badinkajink/hand/src/morphohand/driver/reskin5x/README.md

# reskin5x

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

## Layout

- `firmware/reskin5x_stream/reskin5x_stream.ino`: the port of `external/eFlesh/arduino/5X_eflesh_stream/5X_eflesh_stream.ino`.
  The STEMMA QT connector is the board's `Wire1` (SDA1 GPIO41, SCL1 GPIO40), `Serial` is the TinyUSB CDC port, and the
  register settings are those below; the header comment lists every change.
- `firmware/reskin5x_mux_stream/reskin5x_mux_stream.ino`: several boards behind an I2C mux on the STEMMA QT port, one
  record of 80 bytes a board plus `\r\n` per sweep (section on three boards).
- `host/reskin5x_mux.py`: splits that stream into one 82-byte stream a board, each on a pseudo-terminal linked at
  `/tmp/reskin5x_mux/ch<channel>` that `host/wrench_viewer.py --port` reads, and logs all boards; `host/reskin5x_mux_check.py`
  gives a log's record rate, each chip's noise and the boards' separation, `host/reskin5x_mux_rest.py` each board's rest
  over time (split into a uniform field and the rest of the change), and `host/reskin5x_mux_soak.py` the viewer's frames
  replayed over fingers left at rest.
- `firmware/bench_three_board_sweep/`, `firmware/bench_conversion_period/`: timing sketches behind the numbers in the
  sections on rates and on three boards; they print `STAT`, `CONV` and `NACK` lines. Build and upload one with
  `RESKIN5X_SKETCH=<name> host/flash.sh`, and put `reskin5x_stream` back afterwards.
- `host/flash.sh`: compile and upload.
- `host/reskin5x_check.py`: per-chip field, noise, drift and temperature, the record rate, and the fraction of the range in
  use, from a few seconds of stream; `--out` writes the records as text.
- `host/reskin5x_plot.py`: live plot of each chip's change from a baseline (|ΔB| of all chips, then ΔBx, ΔBy, ΔBz per
  chip, µT, last 10 s); key `b` takes a new baseline.
- `scripts/reskin5x_pad_fit.py`: the magnets' polarities, position and strength fitted to a capture of the board with a
  pad on, and the sensing model's force resolution for the fit.

## Setup

    git submodule update --init external/eFlesh
    git -C external/eFlesh submodule update --init arduino/arduino-MLX90393

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

## Flashing

    src/morphohand/driver/reskin5x/host/flash.sh            # upload to the first /dev/ttyACM*
    src/morphohand/driver/reskin5x/host/flash.sh build      # compile only

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

## Checking the stream

    ~/miniconda3/bin/python src/morphohand/driver/reskin5x/host/reskin5x_check.py --seconds 5

Noise is the standard deviation of each axis inside 0.5 s windows, averaged over the windows; drift is the largest range
of the 0.5 s means. Measured on 2026-10-20 at the workstation, board at rest and no magnet near it: 375 records/s; noise
1.54 to 1.76 µT on x and y and 2.32 to 2.59 µT on z; drift 0.8 to 1.7 µT; |B| 41 to 82 µT, Earth's field plus the chips'
offsets, which changes as the board turns; 28 to 31 °C. The noise model of `scripts/mlx90393_model.py` gives 1.20 and
1.84 µT at this setting, so the measured noise is 1.4 times the model's; a force resolution computed with the model scales
by the same factor (concept b's pad: 0.028 N at the contact point, about 0.039 N with the measured noise). A drift of tens
of µT means the board turned or a magnet moved near it during the capture: one capture taken while the board was handled
gave 40 µT on every chip.

## Sample rate on one board

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

## Three boards on one QT Py

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

    ~/miniconda3/bin/python src/morphohand/driver/reskin5x/host/reskin5x_mux.py &
    ~/miniconda3/bin/python src/morphohand/driver/reskin5x/host/wrench_viewer.py --port /tmp/reskin5x_mux/ch0 --http 8790
    ~/miniconda3/bin/python src/morphohand/driver/reskin5x/host/reskin5x_mux_check.py logs/<date>-three_finger_mux/<start>-mux.bin

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

Since 2026-10-26 one viewer shows every board on the mux, with no splitter: each board gets a row of the page with its
pad and its readout, and its own stream log and calibrations named after it. `--board-gp` adds the GP from the board's
change to the contact point and force, pooled over ID 1's and ID 2's UR5 holds (`scripts/ur5_tip_calibration_board_gp.py`,
3,813 presses and slides of cb1t, cb1r and cb2t; the fit equals `ur5_tip_calibration_predict.GP`'s to 3e-13 on a
300-hold subset). Each panel's menu, and key g for every board, picks the estimate shown. No UR5 hold pressed harder
than 5.1 N, and beyond the holds the GP returns to their mean, a 1.06 N press; on the owner's presses of 2026-10-26 it
read 1.1 to 1.3 N where the physical model read 4 to 25 N. Its estimate is therefore weighted by w, one minus its
posterior variance, against the physical model's: w was 0.8 to 0.98 between 1 and 4 N and 0 to 0.07 above 5 N. The
contact line gives w, and the table gives the force's direction in the tip frame and its angle from the inward normal.

    ~/miniconda3/bin/python src/morphohand/driver/reskin5x/host/wrench_viewer.py --mux /dev/serial/by-id/<board>-if00 \
        --names "ID 1" "ID 2" --calib <ID 1 calib_rest.json> <ID 2 calib_rest.json> --correction <cb1t folder> <cb2t folder> \
        --board-gp docs/experiments/20261022-ur5_tip_calibration/data/20261026-board_gp_id1_id2.npz

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

    RESKIN5X_FQBN=esp32:esp32:sparkfun_esp32c6_thing_plus RESKIN5X_SKETCH=reskin5x_mux_stream \
        src/morphohand/driver/reskin5x/host/flash.sh /dev/serial/by-id/usb-Espressif_USB_JTAG_serial_debug_unit_<MAC>-if00

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

## Pad on the board

    ~/miniconda3/bin/python src/morphohand/driver/reskin5x/host/reskin5x_plot.py
    ~/miniconda3/bin/python src/morphohand/driver/reskin5x/host/reskin5x_check.py --out pad.csv   # pad at rest
    ~/miniconda3/bin/python scripts/reskin5x_pad_fit.py pad.csv

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

## Visualizer

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

## Contact estimation viewer

    ~/miniconda3/bin/python src/morphohand/driver/reskin5x/host/wrench_viewer.py   # then open http://localhost:8790

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

The chips run without their on-chip temperature compensation, and each one's sensitivity falls by 0.65 to 0.70 % per C of
its die temperature: the board warms by about 1 C in the minutes after it is plugged in, which moves the rest reading by
70 uT, about 2 N on the face. The viewer divides every reading by its chip's gain at the chip's temperature (coefficients
in `docs/experiments/20261020-fingertip_contact_estimation/data/20261021-thermal_gain.json`, fitted on a night at rest by
`scripts/fingertip_contact_estimation_study.py thermal`), adds a 2 uT noise floor to the estimator's noise and shows a
contact only above 0.25 N, and takes a new baseline once the reading has been as still as at rest for 3 s, which also
takes in a press held that still. The page has sliders for the threshold and the floor and a switch for the re-zero (key
z); `--floor`, `--min-force`, `--auto-zero 0` and `--no-thermal` set them at the start. When the board is unplugged the
viewer waits for it, opens it again (on its `/dev/serial/by-id` name, which stays the same when the board comes back as
another ttyACM) and calibrates again 2 s later, since the pad may have been changed meanwhile; nothing else needs to run
first.

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

    ~/miniconda3/bin/python src/morphohand/driver/reskin5x/host/pad_shift_check.py <recording>.csv
    ~/miniconda3/bin/python src/morphohand/driver/reskin5x/host/pad_shift_check.py <stream>.bin --t0 120 --t1 180

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

## Calibration session on the UR5

`host/ur5_tip_calibration.py` runs the calibration on the lab's UR5 (CB3, RTDE at 192.168.0.4) against the OptoForce
HEX-E (its Ethernet DAQ at 192.168.0.5, UDP port 49152, polled at 500 Hz): homing on the indenter's key in freedrive, a
gravity sweep, touch-offs on the mount's column and on the pad, a registration fit, pivot presses, then calibration
presses, slides, rolls and twists from a plan written on the workstation
(`scripts/ur5_tip_calibration_plan.py` -> `docs/experiments/20261022-ur5_tip_calibration/plan/20261022-plan_sphere.json`).
The robot's computer runs it from a clone of the repository: the runbook
`docs/experiments/20261022-ur5_tip_calibration/README.md` and its setup check `scripts/ur5_tip_calibration_lab_setup.sh`
(git-lfs files, a venv with numpy, scipy, pyserial and ur_rtde, old copies of magpie_control's F/T reader, the robot,
the DAQ and the board, three simulated stages) cover it. The program stops the DAQ and empties its socket before it
starts, and empties it again before each polled request, so a late answer cannot pass for a newer one.

    python ur5_tip_calibration.py --plan 20261022-plan_sphere.json --stages preflight      # streams, payload
    python ur5_tip_calibration.py --plan 20261022-plan_sphere.json --dry 15                 # the session 15 mm off
    python ur5_tip_calibration.py --plan 20261022-plan_sphere.json --name sphere1           # the session
    ... --resume logs/<date>-tip_calibration/<session>                                      # after an interruption
    .venv/bin/python src/morphohand/driver/reskin5x/host/ur5_tip_calibration.py --plan <plan> --sim   # the simulator

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

## Register settings

GAIN_SEL 1, RES 1 on all three axes, OSR 0, DIG_FILT 5 and HALLCONF 0xC: one count is 1.20 µT on x and y and 1.94 µT on z,
the range is 38.4 mT (the rule of `scripts/v2_tip_fe_checks.py`: 4.8 mT at GAIN_SEL 7 and RES 0, scaled by the count),
and one conversion of T, X, Y and Z takes 7.0 to 7.1 ms. The range covers the five-magnet concept-b pad B00, whose
largest field component at a chip is 27.5 mT (`docs/experiments/20261019-v2_tip_fe_checks/sensing.json`, case b_v2);
concept a's tip, at 11.4 mT, takes GAIN_SEL 2 and RES 0. To change the settings, edit the constants at the top of the
sketch, run `flash.sh`, and pass the new range to the check's `--range-mT`. The firmware converts counts to µT with the
settings it wrote, so the host reads µT at any setting.

## Record format and chip order

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
