badinkajink/hand/docs/handoff/20261029-hom_design_landscapes.md

Status: active, window hand-d3 (not armed); hand-14's part done 09:00 on 10-30, handed back to hand-d3 by the owner at 12:0x on 10-30
Task (owner, 2026-10-29 ~22:30, deputizing hand-14 after hand-d3): HOM-sim and high-throughput morphology sampling. Questions: (1) gradients to guide exploration "a la value gradients for robot design" (arXiv 2606.00702) without RL; (2) MPC in HOM's object-contact action space instead of joint space (cf. arXiv 2601.10930), gradient-based or sampled, on MuJoCo-Warp, and its speed; (3) the Pareto front and neighbourhoods of good layouts per task, how they move as the object's size changes, whether that differs between tasks, high-potential neighbourhoods, and transfer. Owner, 23:0x: "control is really grasp synthesis + in hand manipulation, conditioned on morphology ... we should not be relying on our old keyframe"; synthesize different grasps per morphology; poke in small increments; simple parameters (palm width/height, finger spacing) before t-SNE; build on Yang et al. (IEEE TEVC 2026, memory reference_yang_hand_evolution_2026.md); "scoring hands by sample efficiency is not a bad idea"; "narrow feasible regions ... the whole name of the game"; inspect grasp keyframes from several angles for troublesome results. Owner, 23:2x: "you're using the wrong fingertips"; sphere-pack the new half-ellipsoid tips; remove the cap over the top edge (trimmed). Document in the two 10-29 pages (the design page records how the approach changed); a code-walkthrough subpage linked from the HOM page. Keep the code lean; no meta commentary in pages. Owner, 12:0x on 10-30, to hand-d3: (1) run the 15-min GPU re-anchor test; (2) not ready for a bench test; (3) the queued studies are approved: twelve object-pose draws on the cylinder tasks, the 2 mm local refinement around the 20 best twist layouts, Yang et al.'s EA as a baseline, the MPC at a 2 ms physics step. Standing advice: anchor every debug on visual inspection of the decisive snapshots.
Read first: docs/handoff/20261029-hom_gpu_handover.md; docs/experiments/20261029-foundational_pose_review/20261029-foundational_pose_hand_design.html (sections 6-10); scripts/hom_gpu.py, scripts/fp_sr2_toy.py (V4B block, grasp_set, grid2d, poses), scripts/build_cad_v2_finger.py, scripts/hom_landscape.py; memory project_hom_fp_review_2026_10_29.md.
State (10-31 20:40, hand-d3): every stage of logs/20261030-hom_ff/gpu_queue3.sh done without refusals (D 17:18, C 20:26; no job of this task runs). Trends page docs/experiments/20261029-foundational_pose_review/20261030-hom_layout_trends.html has the size trends (36 of 38 sizes agree on the CPU), the EA's reliability, the finger-clearance cost on the GPU, the re-solved grids with the measured reason for the higher reach (scripts/hom_toy_reach_check.py), the Sobol rerun (rows/sizes_v4bff: interaction 40-43 % of variance, noise <= 8 %, smallest-largest Spearman 0.17-0.33, press -0.03) and the table study (table-clear grids and searches, CPU table checks). Design page Section 9 and the design overview point to it. hom_ea dedupe fixed after D; hom_landscape has --sobol sobol8kff and sobol-rerun. Commits e6310c7a5 .. 94d2a823f and the Sobol commit after 20:40.
Next:
1. Owner's go 10-31 ~21:00 ("sure, run the last study"), done 21:26 (logs/20261030-hom_ff/table_study2.sh): the 25 mm pinch grid with no penetration of the table (grid2dgn) and with the squeezed pose (grid2dgs); no finger touches the table any more, held 12 and 15 of 20 with the table (9 before), 19 and 20 on the post; the remaining drops happen in the turn (4.8 s) and are not explained. Trends page Section 7 and its future work carry it; hom_table_check.py has trace (with the table removed at the lift, as in the check) and film with any grids.
2. Open (needs the owner): why table-clear pin-push grasps still drop in the turn; re-solving the tripod grids with no penetration; publishing both pages on the personal login; the pin-push peak's CPU/GPU disagreement.
Claimed: scripts/hom_ea.py, logs/20261030-hom_ff/, scripts/hom_films.py, scripts/hom_grasp_overlap.py, scripts/hom_top_cpu_check.py, scripts/hom_reanchor_check.py, scripts/fp_sr2_toy.py, scripts/hom_gpu.py, scripts/hom_landscape.py, scripts/build_cad_v2_finger.py, scripts/hom_mpc_gpu.py, scripts/hom_code_page.py, scripts/fp_review_page.py, scripts/fp_review_figures.py, scripts/hom_review_page.py, the two 10-29 page folders, assets/mjcf/experimental/20261030-cad_v2, logs/20261029-hom_sizes/.
Waiting on owner: publishing on the personal login.
Do not: edit src/morphohand/control/hom.py without a test; start multi-hour work beyond Next 1-3 without the owner's go; touch hardware, corvus or the CB1; publish artifacts; run mesh-heavy probes outside resguard or without NUMPY_MADVISE_HUGEPAGE=0 (three watchdog kills on 10-29 23:26-23:35).
