badinkajink/hand/docs/handoff/20261014-tip_codesign.md

Status: done
Task (owner, 2026-10-14 17:45): "super interesting to see how the sphere packed contact model deteriorates across geometry. can you actually explore this? we can use whatever geometry we want, and now you have experience with the real fingertip geometry. maybe you can actually design a good process to optimize a fingertip geometry as well as material (print settings), contact model, and task? ... designing and producing a few candidate fingertip geometries (and material/print settings, updated contact model, evaluations on a dexterous manipulation task), you can churn at now." Owner's interest is utilitarian (throughput and robust control of the SR2 hand); no studies that separate the pads from Newton hydroelastic.
Read first: docs/notes/20261014-tip_codesign_plan.md (the design: deterioration study, co-design loop, run plan; written by step 1); scripts/fingertip_geometry.py (the block: 17.0 x 14.8 x 22.0 mm, box rounded by a sphere of r 2.7 mm, pads E a/h with h 8.5 mm); scripts/reorient_backends.py replace_tips; scripts/tpu_tip_rig.py (bed tasks T1, T2, T5 on TPU tips, Drake compliant block); scripts/hydroelastic_arm_integral.py; scripts/tpu_tip_fem.py, tpu_tip_print_plan.py, eflesh_build.py; scripts/pad_usability_backends.py (D1-D8 replay wrapper, U2); docs/experiments/20261014-pad_usability/agree/findings_U2.json; pages 20261006-fingertip_backends (fingertip co-design for task and simulability) and 20261009-tpu_tip_fem; memory project_tpu_tip_fem_2026_10_10.md, project_tip_deformation_budget_2026_10_13.md.
State (2026-10-15 02:30, autopilot on personal): every ledger step done. Page docs/experiments/20261014-tip_codesign/20261014-sphere_pad_accuracy_and_fingertip_codesign.html, artifact https://claude.ai/artifact/4QPCGbgvaEQoswYCytJ1kJ, INDEX row, linked from the printed-fingertip and contact overviews (both republished). Findings: pads within 2 % of the law's twist onset for fillets >= 1.5 mm, 7-14 % high on sharper; sliding torque grows with spin rate (1.25x the law at 1 rad/s on r 2.7 mm) through MuJoCo's elliptic cone and no builder fix keeps the hand's turns; none of the three finalists beats the as-built tip on fresh placements ((3,6) +0.053, 90 % interval -0.043 to +0.090); builder v2 raises Drake agreement on 3 of 4 stage-3 tips. Waiting on owner: (1) FE of tcd_rs2_re1_p0.2 at 95A 20 % and tcd_rs3_re6_p0.2 at 95A 10 % needs more than this job's 6 GB per process (two runs paged and were stopped at the cap): approve a larger memory budget for one FE run at a time, or accept the scaled recipe estimate on the page; (2) whether builder v2 (local h, per-pad K) becomes the default pad builder for CAD-envelope tips; (3) contact deck 23 may be stale: scripts/contact_overview_page.py lists 8 commits since DECK_CHECKED (one adds this study's sentence); DECK_CHECKED was left unchanged.
Workflow journal: /home/humanoid/.claude/projects/-home-humanoid-Programs-hand/88ae0ebc-1769-4d06-9a8c-bed92903087d/subagents/workflows/wf_38c62930-64f/journal.jsonl
<!-- ap:steps: rendered by ~/.claude/autopilot/ap from its ledger; change it with `ap step`, not by hand -->
Steps, in order (the ledger; `ap step done <job> <id> "result"` marks one, `ap step add <job> "text"` adds one):
- [x] 1. If docs/notes/20261014-tip_codesign_plan.md is missing, write it from the journal (critique:codesign's revise… Done 10-14 19:17: Plan file committed by window 88ae0ebc (bcc3041a); its revised run plan is now ledger steps 12-25 in order; steps 2-6 stay open as umbrellas (direction 26) because only the owner drops them
- [x] 2. Tip geometry and pad builder for any convex tip: scripts/tip_codesign_geometry.py (parametric shape, STL, pad… Done 10-14 20:05: Done by steps 14 (tip_codesign_law.py: Drake field, Winkler, local h, pads; checks 2.554 mm and N45 0.373/0.364/0.393 N) and 15 (tip_codesign_geometry.py, per-pad builder, tests)
- [x] 3. Deterioration sweep on the bed (T1 pull, T2 twist, T5 brake, approach) over the family: pads against the law … Done 10-14 20:43: Done by steps 14 (sweep A, 322 rows, rate-effect mechanism and fix grid) and 16 (sweep B, builder tests, hand check); summaries in deterioration/summary.json, handfix_summary.json, handv2_summary.json
- [x] 4. Co-design screening and finalists: material proxy from print settings, calibrated pads per candidate, the tas… Done 10-15 02:25: Done by steps 17 (stage 1), 18 (stage 2, finalists), 19 (stage 3: no finalist beats the as-built tip), 22 (pinned iCEM) and 27 (builder v2)
- [x] 5. Finalists as printable files: STL and print settings (PrusaSlicer project or print sheet with tpu_tip_print_p… Done 10-15 02:25: Done by step 21: print files (STL, 3MF, print sheet, slice audit) and pad scenes of the four stage-3 tips; recipes from step 20
- [x] 6. Result page: scripts/tip_codesign_page.py and template (newest builder as the base, retro_style, texsvg, film… Done 10-15 02:25: Done by step 25: result page published and linked
- [x] 12. Plan step 1, pre-flight and wrappers: quote resguard status and nvidia-smi; create logs/20261014-tip_codesign… Done 10-14 19:36: Wrappers committed (tip_codesign_bed.py, tip_codesign_rig.py); D7 s0 reproduces U2 (replay 44.8 deg held, HOM 9.3, Drake 47.3); RSS replay 133-138 MB, HOM 160 MB, bed 147 MB, Drake replay 423 MB
- [x] 13. Plan step 2, hand tolerance tau: servo plant kp0.72_kv0_fr0.18_fl0_dp0.0144, tpu2.7 pads; mu {0.8,0.9,0.95,1.… Done 10-14 19:44: Floor: any friction change >= 0.1 % flips 10.1 % of 84 non-bistable runs; tau (floor + 5 points) 3.65 % relative friction (plan's 5 % rule gives 0.04 %, inside the floor); median |dturn| 0.12/0.47/0.73/1.91 deg at 0.1/5/10/20 %; E 5/20 MPa change 17/26 runs (screening variable); mu 0.8 leaves D3 s0-2 and D8 s1 unturned; tolerance/summary.json
- [x] 14. Plan step 3, deterioration sweep A on the flat family tpu<r>, r {0,0.5,1,1.5,2,2.7,3,4,6,7.4} mm, 1 mm pads, … Done 10-14 19:56: Sweep A (322 rows, deterioration/summary.json): onset/law 0.98-1.02 for r>=1.5, 1.07-1.14 for r<=1; spin/law at 1 rad/s 1.73 (r0) 1.25 (r2.7) 1.14 (r6) 0.98 (sphere), Drake 0.97-1.12; N45 pads/Drake(0.5 ms) 0.52-0.64 for r<=3, ~1 for r>=6; mechanism = elliptic-cone slip term (87 % of sliding normal force at 1 rad/s); fix pf0.1:ir1000 cuts the excess (1.09 at r2.7) but fails the hand (HOM 3/24 vs 21/24 within 5 deg of Drake), so no builder fix; MPC swings at 5 rad/s see 1.9x the quasi-static torsion (Drake 1.6x)
- [x] 15. Plan step 4, geometry and builder v2: scripts/tip_codesign_geometry.py (numpy/scipy, trimesh lazy): CAD envel… Done 10-14 20:05: Geometry module, builder v2 (h fixed/local, K median/each), tcd dispatcher for bed/hand/scale, 6 tests pass; as-built tcd_rs3_re3 matches the CAD outer palmar half to 1.2 um p99 (the CAD insert is a shell over the mount, so no volume test); 1172 pads, a 0.50-1.69 mm2
- [x] 16. Plan step 5, deterioration sweep B and builder fixes: members as-built, as-built as-printed at 0.2 mm, r_side… Done 10-14 20:43: Sweep B (5 tcd members) and builder tests in deterioration/summary.json: no builder option moves every member toward the law (1 mm pads -3..+2 % at 1 N on smooth members; local h, per-pad K < 1 %; crowns -6..-7 % at any spacing; n* not reached, error set by lattice phase); hand check on tcd_rs3_re3_p0.2: builder v2 19/24 vs v1 16/24 replays within 3 deg of Drake (D3 s2, s4 turn with v2), 4/40 replays differ (the floor); v1 kept for screening
- [x] 17. Plan steps 6-7, candidate grid and stage 1 screen: r_side {1,2,3,4.5,6,7.4} x r_end {1,3,6,10.5} mm on the as… Done 10-15 00:46: Stage 1 complete with fixed pads (screen/summary_stage1.json, 26 tips, every fidelity row present): J1 at mu 0.7 ranks as-built printed 0.428, (2,6) 0.364, (7.4,6) 0.343, (7.4,10.5) 0.335, (3,6) 0.333, (1,10.5) 0.328, (4.5,1) 0.301, (2,1) 0.288; tpu2.7 0.261 (11th), design surface 0.241; pads' onset/law 0.95-1.06 at 1 N on all 24 printed candidates; printability in step 21
- [x] 18. Plan step 8, stage 2 robustness on the 8: servo plant at mu 1.0/0.7/0.5, kp0.5 and fr0.12 at mu 0.7 (HOM kp_m… Done 10-15 00:46: Stage 2 redo (screen/summary_stage2.json): J2 (1,10.5) 0.206 (Drake 10/24, fails), (3,6) 0.195 (16/24), as-built 0.188 (16/24), (2,6) 0.156 (15/24), tpu2.7 0.154 (16/24), (4.5,1) 0.132 (13/24), (2,1) 0.127 (11/24), (7.4,10.5) 0.124 (18/24, cost 0.48), (7.4,6) 0.088 (12/24); gate needs 14. Finalists: (1) tcd_rs3_re6_p0.2, (2) tcd_rs7.4_re10.5_p0.2 (cost 0.48 of the as-built), (3) tcd_rs2_re1_p0.2 (three-finger share 0.12 at mu 0.5), (4) baseline tcd_rs3_re3_p0.2
- [x] 19. Plan step 9, stage 3 confirmation on fresh seeds: HOM D1-D8 seeds 5-9 and scale cells seeds 3-5 at mu 0.7, 0.… Done 10-15 00:54: Stage 3 (final/summary_stage3.json; cell seeds 3-5, HOM seeds 5-9, 4 conditions): J3 as-built 0.250; (3,6) 0.303, paired dJ3 +0.053 with 90 % interval [-0.043, +0.090] (10,000 resamples within cells and hands), so it does not beat the as-built tip at the 90 % level; (7.4,10.5) 0.169, dJ3 -0.081 [-0.120, -0.033]; (2,1) 0.172, dJ3 -0.078 [-0.122, -0.018]. Three-finger hold at mu 0.5: 33/33 for the as-built tip, (3,6) and (7.4,10.5); 31/33 for (2,1). No flat-family geometry improves on the as-built tip
- [x] 20. Plan step 10, FE alone (taskset -c 4-7, --mem 6G, no other job of this session running): tpu_tip_magnet.run i… Done 10-15 02:19: FE (final/fe.jsonl; whole-tip model, magnet 4.76 mm at 5 mm): (3,6) 95A 20 % E* 15.4 MPa, 11.7 um/N (fails the 12 um/N sensing rule) -> 95A 10 % (scaled estimate about 20 um/N); (7.4,10.5) 95A 20 % E* 19.4 MPa, 12.9 um/N -> 95A 20 %; as-built 95A 20 % 12.18 um/N (2026-10-09 CAD-insert FE) -> 95A 20 %; (2,1) not computed (needs more than 6 GB, ledger 32)
- [x] 21. Plan step 11, print files per finalist under docs/experiments/20261014-tip_codesign/print/<key>/: face-up STL… Done 10-15 02:19: Print files for the four stage-3 tips at 95A 20 % gyroid and (3,6) at 95A 10 % (print/<design>/: face-up STL with the pocket, PrusaSlicer 3MF with the M601 pause, print sheet JSON): all watertight, 21.41 x 14.8 x 17.0 mm, slicer pause at 12.4 mm, one island per layer (two in some layers of (3,6) at 10 %); pad scenes (D6 servo bench, CAD hand) in assets/mjcf/experimental/20261014-tip_codesign/<tip>/; tip_codesign_rig.py rlscene for the RL queue
- [x] 22. Pinned iCEM on cylinder:16:0.625 and cylinder:25:0.125, seed 0, best finalist against the as-built baseline: … Done 10-15 02:19: Pinned iCEM (final/icem/turn.jsonl, seed 0, mu 1.0, servo plant, 6 threads on cores 5-10): as-built tip 43.0 deg on cylinder 16 and 64.6 deg on cylinder 25; tcd_rs3_re6_p0.2 39.3 and 57.4 deg; every run held with three fingers loaded at the end; 0.40-0.41 GB, about 9 min per tip
- [x] 23. Plan step 12, films on the CPU through Mesa EGL (640 x 480 panels, tile_stream crf 20, labels at least 13 px … Done 10-15 02:19: Films (media/): bed spin at 1 N and 1 rad/s on r 1, as-built design, as-built printed, r 6 with pads coloured by f/(K pen) (bed_spin_tile.mp4); HOM on cylinder:16:0.625 seed 3 for the four stage-3 tips (hom_cylinder_16_0.625_s3_tile.mp4); D7 seed 0 replay (replay_D7_s0_tile.mp4); posters read at 828 px, labels 14-15 px
- [x] 24. Plan step 13, verification: scripts/tip_codesign_verify.py recomputes tau, the validity map, the fix deltas, … Done 10-15 02:20: scripts/tip_codesign_verify.py scenes numbers passes (verify.json): every cached pad scene of the study's tcd tips within 5e-8 m of the fixed pad builder; 73/73 headline numbers recomputed from rows by separate code (deterioration ratios, rate, J1 of 26 tips and the top 8, J2 and Drake agreement of 9, J3 of 4, bootstrap bounds within 0.012 with an independent seed); pytest tests/test_tip_codesign.py 6 passed; resguard events 21:18-02:00 all handled (ledger 28, 32); rows committed (LFS)
- [x] 25. Result page: scripts/tip_codesign_page.py and template from the newest builder (retro_style, texsvg, films in… Done 10-15 02:25: Page docs/experiments/20261014-tip_codesign/20261014-sphere_pad_accuracy_and_fingertip_codesign.html (builder scripts/tip_codesign_page.py, 50 formulas, 7 figures and 3 films inlined, figure check: none flagged) published as https://claude.ai/artifact/4QPCGbgvaEQoswYCytJ1kJ; INDEX row; linked from docs/overviews/printed_fingertips.html (overview_fingertip_text.py, republished v2) and docs/overviews/contact_model.html (one sentence and an index row, republished v16; contact_model_assessment is done); pushed c9c94d2b
- [x] 27. Builder v2 (local h, per-pad K) on the finalists: replays D1-D8 seeds 0-4 and HOM seeds 0-2 at mu 1.0 with --… Done 10-15 00:54: Builder v2 (local h, per-pad K) against v1 on the four finalists (final/summary_builders.json): replays within 3 deg of Drake 19 vs 16 (as-built), 18 vs 16 (3,6), 22 vs 18 (7.4,10.5), 11 vs 11 (2,1); HOM held 21/21, 20/19, 22/20, 20/19 of 24; 4-9 of 40 replays move > 3 deg between builders. v2 is the proposed builder for CAD-envelope tips: it raises Drake agreement on 3 of 4 tips and lowers it on none, at the same pad count
- [x] 28. Relaunch the jobs the watchdog killed 21:18-22:27 (stage-1 fidelity of tcd_rs6_re6, rs6_re10.5, rs7.4_re6, rs… Done 10-14 23:53: Relaunched 23:00-23:52: the 4 fidelity sets and 22 Drake replays completed under the chunk fix (c8735228; a fixed law job peaks at 0.34-0.73 GB, the old code 1.56 GB); no watchdog event since 22:27
- [x] 29. Degenerate hull facets (found 23:40): qhull's triangulation of the terraced hulls leaves facets with |cross| … Done 10-15 00:01: Facet fix 0a4850dc: the 125 law rows recomputed (no NaN; approach 44-135 um at 1 N), the 50 T2 rows rerun (MuJoCo pads onset/law 0.95-1.06; drake_tcd_rs6_re6_p0.2 via meps1e-06), quasi-static pads/law at 1 N 0.89-1.04 (approach) and 0.95-1.04 (arm); sweep B law rows reproduce; old rows in screen/fidelity/{law,T2}_superseded.jsonl. The same defect displaced pads (step 31).
- [x] 30. Drake failed 23 of 24 stage-2 replays of tcd_rs6_re6_p0.2 ('Cannot instantiate plane from normal n_F ... magn… Done 10-14 23:53: tcd_rs6_re6_p0.2's 24 Drake replays rerun with --mesh-eps 1e-6 (tag E1e+07_dp1, 3,911 vertices, <= 0.93 um from the full hull): all complete; pads within 3 deg of Drake on 7/24, so it fails the agreement gate (needs 14) and finalist slot (2) stays empty
- [x] 31. Redo the hand runs of the 20 candidates whose pads the degenerate facets displaced (found 23:58): TipShape._c… Done 10-15 00:46: Redo done 00:00-00:46: 20 candidates' stage-1 rows rerun with fixed pads (worker_v3, no kills), stage 2 rerun for the new top 8 + tpu2.7 (99 jobs, Drake replays for new tips with --mesh-eps 1e-6); old rows in *_superseded.jsonl and screen/superseded/ (superseded_pads_20261015.json); verify scenes: every cached pad scene within 5e-8 m of the fixed builder
- [x] 32. FE OOM kill 01:27 (resguard event): the four-tip FE process (tcd_rs3_re6, rs7.4_re10.5, rs2_re1, rs3_re3, w95… Done 10-15 02:19: FE relaunched one tip per process at --mem 6G (chain5): both runs (tcd_rs2_re1 w95_20, tcd_rs3_re6 w95_10) paged at the cap and the watchdog killed them (01:52, 01:58; PSI full 25.7/15.2 at 13.8 GB available). These as-printed models need more than the job's 6 GB. Recipe of (3,6) taken as 95A 10 % from its 95A 20 % travel (11.7 um/N) times the CAD insert's 10/20 % ratio (1.72): about 20 um/N; (2,1) has no FE row. Both runs are a Future-work item on the page (one tip per process with more memory)
Standing directions (for every step):
- Compute shared with hand-20261014-contact_model_assessment (colorado): this job uses cores 4-11 (taskset) and at most 6 GB resident; that job uses cores 12-19 and at most 7 GB; cores 0-3 stay with the desktop. Before any job longer than a minute quote ~/.claude/bin/resguard.sh status and launch through resguard.sh run --mem <measured RSS x1.3>. GPU: one Warp process at a time across both jobs; check nvidia-smi --query-compute-apps=pid,used_memory --format=csv first; every Warp process gets WARP_CACHE_PATH=$(mktemp -d).
- Owner directions: films of every result, checked at displayed size ('make sure to keep the visuals, figures really beautiful'); result pages are HTML built from rows, never markdown results; the 1 mm sphere pads on the TPU block are the default fingertip and the comparison baseline; 'holds' is banned as a container verb; verify each headline number from the rows with a separate script before writing it.
- Window 88ae0ebc may still be running the design workflow when this job starts: if docs/notes/20261014-tip_codesign_plan.md does not exist yet and the journal shows agents still 'started' without a result, work on step 2 (geometry and pad builder) first and return to step 1 when the plan file appears or the journal is complete.
- Window 88ae0ebc, 19:08: step 1's plan file is written and committed (bcc3041a): docs/notes/20261014-tip_codesign_plan.md, the critic's revised run plan first. Finish step 1 by turning that revised run plan into ledger steps (ap step add, in its order) and dropping steps 2-6 they replace; follow the revised plan, not the designer's original.
- Priority finding of the geometry reader (plan file, map geometry_pads_reference): the block's long sliding arm (4.55 against Drake's 3.59 mm at 1 N) is dynamic, not geometric. The same pad lattice integrated quasi-statically gives 3.58 mm; the pads' arm grows with spin rate (3.90, 4.24, 4.55, 7.02 mm at 0.1, 0.3, 1, 3 rad/s) and with the pad time constant (4.40 mm at t_c 0.01 s, 6.79 mm at 0.04 s), not with impratio, and sphere normal forces exceed K times penetration up to 87 times at the ends of the contact line, where the spinning line sweeps over the lattice. Test this first in the deterioration sweep: spin-rate sweep at the rates the planners reach (up to about 5 rad/s, pinch-and-swing peaks of 308 deg/s), solref damping ratio and t_c, sphere-tip control (axisymmetric patch, no sweep), and a builder fix if one exists; state what it means for MPC turns that rely on torsion.
- Autopilot, 19:20: ap refuses to drop steps 2-6 (owner window's steps), so they stay open as umbrellas of the revised plan and are marked done when the steps that cover them are done: 2 when 14 (law module) and 15 (geometry, builder v2) are done; 3 when 14 and 16 are done; 4 when 17, 18, 19 and 22 are done; 5 when 21 is done; 6 when 25 is done. Work 12-25 in id order; do not start the generic text of 2-6 separately.
<!-- /ap:steps -->
Claimed: scripts/tip_codesign_*.py, tests/test_tip_codesign.py, docs/experiments/20261014-tip_codesign/, logs/20261014-tip_codesign/, assets/mjcf/experimental/20261014-tip_codesign/, docs/notes/20261014-tip_codesign_plan.md.
Waiting on owner: none.
Incident (19:51:51): my unguarded femtip trimesh contains() on 670k points exhausted memory; the watchdog killed hand-20261014-contact_model_assessment's icem_pin run (cores 15,16,19). Logged as a step in that job's ledger. Second incident (20:14): an unguarded occupancy test on the as-printed hull (673k points x 4.5k facets, 24 GB) paged the box; the watchdog killed probe/handv2.sh and resguard refused the stage-1 launches, so the workers drained the queue; relaunched at 20:17 (queue rebuilt from row counts). inside() now works in 4096-point chunks. Rule for this job: every probe on more than 1e5 points is size-estimated and runs through resguard.sh run --mem 3G.
Do not: edit files claimed by hand-20261014-contact_model_assessment (the contact overview builder and page, docs/experiments/20261014-pad_usability/, scripts/pad_usability_*.py) or shared harnesses (wrap and import them); run a grid longer than 3 h without the owner; touch the bench; force-push.
