badinkajink/hand/docs/notes/20261014-tip_codesign_plan.md

# Fingertip geometry, material and contact-model co-design: plan (2026-10-14)

Written from window 88ae0ebc's design workflow wf_38c62930-64f (three readers, a designer, a critic). The critic's revised run plan comes first and is the plan to follow; the designer's text and the readers' maps follow as reference. Owner's request (2026-10-14 17:45): explore how the sphere-pad model deteriorates across fingertip geometry, design a process that co-optimises geometry, material (print settings), contact model and task, and produce a few candidate fingertips with print settings, an updated contact model and evaluations on a dexterous manipulation task.

## Revised run plan (critic)

Budget: about 6 h on cores 4-11. Core 4 is kept for interactive work and code. Batches are single-core processes on cores 5-11, at most 6 GB resident in total. Total compute is about 9 core-hours. Rows are fsynced one line per case. There is no Newton anywhere. Every job longer than a minute launches as `~/.claude/bin/resguard.sh run --mem <1.3×RSS> --cpu 100 -- taskset -c <core> ...`, with resguard status quoted at launch.

Interpreters: PY=logs/20261001-hom_contact/venv/bin/python (MuJoCo 3.6.0 and pydrake, no trimesh) for the rig. VENV=.venv/bin/python (MuJoCo and trimesh, no pydrake) for geometry tests. FEM=~/miniconda3/envs/femtip/bin/python (trimesh, manifold3d, sksparse, no MuJoCo) for FE and print files.

1. Pre-flight (0:00-0:15). Quote resguard status (18:55 reading: 18.0 GB available, PSI 0.00/0.00, load 4.66/20, gate open) and `nvidia-smi --query-compute-apps=pid,process_name,used_memory --format=csv`. List the autopilot's processes with `pgrep -af '[p]ad_usability|[h]and_object_scale|[r]l_train'`; it holds cores 12-19 and pad_usability files. Create logs/20261014-tip_codesign/{scenes,meshes,scale} and docs/experiments/20261014-tip_codesign/{tolerance,deterioration,screen,final,print,media}.
   Write scripts/tip_codesign_bed.py, about 40 lines. It imports pad_usability_bed (the x0 patch, :42-52), sets tpu_tip_rig.MESH_DIR to logs/20261014-tip_codesign/meshes, registers tpu_models(radii=...), and sets contact_bed_twist.C_LAW per case so the law onset falls at 1.0 s (restored in a finally block; the 3 s cap is at :162).
   Write scripts/tip_codesign_rig.py `replay` as a first cut. It sets PUB.SCN to logs/20261014-tip_codesign/scenes and wraps PUB.cmd_run, with E passed through functools.partial over RB.replace_tips.
   Check: D7 seed 0, tpu2.7 pads, servo plant reproduces turn_end_deg 44.82 deg and held_end True from agree/servo_mujoco.jsonl.
   Measure RSS with /usr/bin/time -v for one replay (1.46 s), one HOM run (0.96 s), one Drake replay (13.9 s) and one bed case. Batch size n = min(7, floor(6 GB / (1.3 × RSS))).

2. Hand tolerance (launch 0:15 on cores 10-11, about 15 min wall).
   Plant kp0.72_kv0_fr0.18_fl0_dp0.0144, tip tpu2.7 pads. Conditions: μ {0.8, 0.9, 0.95, 1.0, 1.05, 1.1, 1.2} at E 10 MPa, and E {5, 20} MPa at μ 1.0.
   Runs: replays D1-D8 seeds 0-7 (64) and HOM seeds 0-2 with --set kp_model=0.72 (24) per condition. That is 9 × 88 = 792 runs at about 1.3 s, about 17 core-min plus scene builds of 0.9-1.4 s per hand and condition.
   Score: an outcome change against μ 1.0 and E 10 MPa is a held flip or |Δturn| > 3 deg, counted on the 84 non-bistable runs. D3 seeds 0-2 and D8 seed 1 are reported separately.
   Decision: τ is the relative friction change, interpolated, at which 5 % of non-bistable runs change. It gates steps 4, 6 and 7. If D3 and D8 seed 1 turn toward Drake's 40-44 deg at μ 0.8 (0.8 ≈ 3.59/4.55, Drake's sliding arm over the pads'), the U2 misses are attributed to the pads' excess torsion; otherwise they stay open. If E 5 or 20 MPa changes 4 runs or fewer, recipe E* is not a screening variable.

3. Deterioration sweep A, flat family on existing code (launch 0:20 on cores 5-9, about 25 min wall).
   Members: tpu<r> with r ∈ {0, 0.5, 1, 1.5, 2, 2.7, 3, 4, 6, 7.4} mm, 1 mm pads, rs 0.75 mm, E 10 MPa, μ 1. Sphere-tip rows are reused from 20261005-contact_bed and 20261006-fingertip_backends.
   MuJoCo cases: static at 0.5/1/3 N; T2 at 1 and 3 N; spin at 1 N and ω {0.03, 0.3, 1, 3} rad/s (the 0.03 rad/s case is 40 s simulated, about 3 s wall); T5 at 1 ms. About 1 core-min per member.
   Drake cases: static, T2 and spin at 1 rad/s, all at 1 N, plus T5 at 1 and 0.5 ms. T5 at 0.25 ms on r 2.7 and r 6 only, on core 11. One r 3.0 static at a 0.1 mm hull, timed first. About 2-3 core-min per member.
   Law tier: scripts/tip_codesign_law.py promoted from scratch block_law2.py and brake_law.py (fields drake, winkler, local and quasi-static pads; ψ 0-90 deg in 15 deg steps; N {0.5, 1, 3, 5} N; N10/N45/N80). Seconds per member. Check: it reproduces 2.554 mm at ψ 0 and 1 N on r 2.7 and N45 0.373/0.364/0.393 N.
   Rows go to deterioration/{law,static,T2,T5,spin}.jsonl.
   Decision: the validity map, plotted over r/rs and the slip number at 1 rad/s, gives the pads-to-law ratio of static arm, approach and sliding arm per member. Members whose static error exceeds τ need finer pads (step 6, M1) or a flag. If the 0.03 rad/s arm is more than 5 % off the quasi-static pads, part of the sliding error is geometric.

4. Geometry and builder v2 (0:15-2:00, written on core 4 while steps 2-3 run).
   scripts/tip_codesign_geometry.py uses numpy and scipy only, with trimesh imported lazily.
   Shapes: the CAD envelope 17.0 × 14.8 × 21.41 mm with the apex fixed. Parameters are r_side and r_end, with convex creases where they differ, sampled per patch. Members: as-built (r 3.0, spherical corners, square back and mount edges); as_printed(layer), the convex hull of per-layer top outlines sliced at mid-layer; and the smooth crown cap (elliptic paraboloid) for two deterioration members. Each shape has a key, writes its OBJs atomically under logs/20261014-tip_codesign/meshes/<key>/ and provides the insert-frame inside(x, y, z) and surface_x(y, z). 'tpu<r>' keys route to fingertip_geometry.
   Builder: pad_spheres(shape, s, rs, E, h='fixed'|'local', K='median'|'each', curv) with curv off within one spacing of a crease.
   Dispatcher in tip_codesign_rig.py: replace_tips for tcd keys with per-pad d0_i = 1 − 1/(t_c² K_i Λ) and a ValueError below 0.05. It places the shape from the hand's G.CENTRE/G.HALF read at call time and trims the capsule to the shape's top. It replaces HT.scenes (hom_turn3.py:66-70) and points S.SCENES at scale/<key>_mu<μ>/ (the cell cache path at hand_object_scale_sim.py:309 has no tip). It adds `hom`, `scale` and `rlscene` subcommands.
   Tests in tests/test_tip_codesign.py (PYTEST_DISABLE_PLUGIN_AUTOLOAD=1):
   - as-built within 0.05 mm (symmetric Hausdorff) and 0.5 % (volume) of assets/cad_v1/fingertip.stl, in .venv;
   - c_V matches the analytic centroid to 0.01 mm;
   - the tpu2.7 key through the dispatcher reproduces U2 D7 seed 0;
   - every touching pad realises its K_i within 1 % (pad_contact_rig.realised_stiffness, :46);
   - two keys built in parallel never share a mesh path.
   Commit.

5. Deterioration sweep B and the builder fixes (2:00-2:40, cores 5-10).
   Members: as-built, as-built as-printed at 0.2 mm, r_side 5 with r_end 1, crown 15 mm, sphere cap 10.55 mm. Same tasks as step 3, about 15 core-min with Drake.
   Quasi-static fix tests on all 15 members (seconds each):
   - M1, spacing s {0.5, 0.75, 1, 1.5} mm with rs = 0.75 s;
   - M3, local h;
   - M6, per-pad K;
   - C, the curvature factor;
   - M4, strip ripple at 0.5-4.3 N.
   Bed static and T2 with the adopted fixes on as-built, as-printed, r 1 and r 6.
   Decision: adopt a fix if it moves every region toward the law by more than its cost; A and B cost nothing per step, C costs nothing, s changes the pad count. n* is the smallest number of loaded pads per side at which the static error falls below τ. Each candidate takes the largest s with n_patch ≥ n* at 1 N.
   Hand check on the as-built as-printed member: builder v2 against v2 with h fixed, K median and curv off. Replays D1-D8 seeds 0-4 and HOM seeds 0-2 at μ 1.0, plus 24 Drake replays at seeds 0-2 (5.6 core-min). v2 is used from here if it loses at most two placements within 3 deg of Drake. It becomes the proposed default only after step 8.

6. Candidate set (2:40-2:50).
   Grid over the flat family: r_side ∈ {1, 2, 3, 4.5, 6, 7.4} mm × r_end ∈ {1, 3, 6, 10.5} mm, 24 shapes. Every candidate is evaluated on its as-printed surface (face up, 0.2 mm layers). The legacy tpu2.7 and the as-built design surface are added as references, 26 in all.
   Fixed for all: the magnet pocket 5 mm under the apex (tpu_tip_design.pocket) with the pause before layer 62 at 12.4 mm, two 0.45 mm walls, four 0.2 mm skins, gyroid infill. Printability (one island per layer, at least 2 mm of TPU around the pocket) is checked once on the two extremes with eflesh_build.slice_check.

7. Stage 1 screen (2:50-3:30, about 5 core-min per candidate, 130 core-min on six processes).
   Per candidate, servo plant at μ 0.7:
   - (a) fidelity: law and quasi-static pads, MuJoCo static, T2 at 1 N, spin at 1 rad/s and T5; Drake static and T2;
   - (b) scale cells through `scale` with SCALE_HAND=cad_v1: --cells diag --only cylinder:25:0.125 cylinder:16:0.625 cylinder:10:0.75 cylinder:16:-0.375 --what hold,turn --seeds 0 1 2 --set kp_model=0.72 post_off=1, with S.MU 0.7. That is about 100 turns at 0.55 s and 33 holds at 3 s;
   - (c) HOM on D1-D8, seeds 0-2.
   Score J1: per cell, the grasp with the best held turn on seed 0, scored on seeds 1-2. J1 averages this over the four cells together with the mean held turn of the 24 D1-D8 runs, each divided by 90 deg. Reported alongside: three-finger hold fraction, hold-test median load, onset arm, N45 with its pads-to-Drake ratio, pad count, µs per step and the terrace width.
   Falsifier for PC1: J1 monotone in r_side.
   Decision: the 8 highest J1 go to stage 2, always including the as-built tip.

8. Stage 2 robustness (3:30-4:05, about 15 core-min per candidate, 120 core-min).
   Conditions: μ 1.0, 0.7 and 0.5 on the servo plant; at μ 0.7 also kp0.5_kv0_fr0.18_fl0_dp0.0144 and kp0.72_kv0_fr0.12_fl0_dp0.0144, with HOM kp_model 0.72.
   Runs:
   - HOM D1-D8 seeds 0-4 per condition (200 runs);
   - scale-cell HOM seeds 0-2 at the four conditions stage 1 lacks (about 400 runs);
   - the hold test at μ 0.5;
   - replays at μ 1.0, seeds 0-2, paired with 24 Drake replays (gate: at most two placements worse within 3 deg than the as-built tip).
   E* 7 and 14 MPa are added only if step 2 found E sensitive.
   Score J2: the minimum over the five conditions of the stage-1 composite.
   Finalists:
   - (1) the highest J2 that passes the gate;
   - (2) the highest J2 at no more than 0.8 of the as-built µs per step;
   - (3) the highest three-finger hold fraction at μ 0.5;
   - (4) the as-built tip as baseline.
   Where (1)-(3) coincide, take the next candidate at least 1 mm away in r_side or r_end.

9. Stage 3 confirmation on fresh seeds (4:05-4:30, about 10 core-min per tip, 40 core-min).
   Runs: HOM D1-D8 seeds 5-9 and scale cells seeds 3-5, at μ 0.7 and 0.5 and the two servo conditions.
   Decision: a finalist beats the baseline if the paired J2 difference over stage-3 placements only has a bootstrap 90 % interval above zero (10,000 resamples within hands and cells), and its three-finger hold at μ 0.5 is lower by at most two runs. Otherwise the page states that no flat-family geometry improves on the as-built tip, and gives the intervals.

10. FE, alone (4:30-4:50, taskset -c 4-7, --mem 6G, no other job running).
    tpu_tip_magnet.run in femtip, with TD.inside_body and TD.surface_x replaced by each finalist's insert-frame functions. The apex stays at TD.X_FACE 8.5 mm and the contact at TD.Z_C, so tpu_tip_magnet.gaps (:100-110) holds; ψ is 0 only. Recipe w95_20 with magnet d4.76x1.59@5, 232-239 s per tip, three finalists in about 12 min.
    Recipe E* is read from the whole-tip FE rows (95A 20 % 14.6 MPa, 95A 10 % 7.2 MPa, 85A 30 % 6.9 MPa, 85A 50 % 16.5 MPa). The recipe per finalist is chosen by the sensing rule: force noise × magnet travel ≈ 1.2 µm, with noise at most 0.1 N, so travel at least 12 µm/N.

11. Print files (4:30-4:55, femtip, seconds each), under docs/experiments/20261014-tip_codesign/print/<key>/:
    - the face-up STL (bounds 21.41 × 14.8 × 17.0 mm, watertight, pocket as an inner shell);
    - a 3MF from eflesh_build.write_3mf with gyroid part settings (perimeters 2, the recipe's fill density, 4 top and 4 bottom layers) on extruder 2 with the v17 template and the M601 pause at 12.4 mm;
    - eflesh_build.slice_check (flatpak PrusaSlicer 2.9.2), confirming the pause before layer 62, one island per layer, supported share and print time;
    - the tpu_tip_design.print_sheet with recipe and E*;
    - pad scenes under assets/mjcf/experimental/20261014-tip_codesign/<key>/ (the CAD screwdriver scene through build_cad_v1_finger.write_scene with the dispatcher, and the D6 servo bench scene);
    - the `tip_codesign_rig.py rlscene` command for the owner's RL queue.

12. Films (4:55-5:25), CPU through Mesa EGL (`__EGL_VENDOR_LIBRARY_FILENAMES=/usr/share/glvnd/egl_vendor.d/50_mesa.json MUJOCO_GL=egl LP_NUM_THREADS=1`), 640 × 480 panels, tile_stream at crf 20, label text at least 13 px.
    - (a) bed spin at 1 N and 1 rad/s on r 1, as-built, as-built as-printed and r 6, with pads coloured by force over K × penetration;
    - (d) HOM on cylinder:16:0.625 of the CAD hand, finalists and baseline, 2 × 2;
    - (e) D7 seed 0 servo replay, 2 × 2.
    Read every poster at its displayed size.

13. Verification and hand-off (5:25-6:00).
    scripts/tip_codesign_verify.py recomputes τ, the validity map, the fix deltas, J1, J2, the stage-3 intervals and the FE and slice checks from the rows. It rebuilds each row's scene from its key and compares pad count, d0 range, envelope, μ and plant; a mismatch voids the row.
    Run the pytest file. Check ~/.claude/resguard_events.jsonl for kills of this session's jobs and rerun any killed case. Commit code per step and rows (LFS) at milestones.
    Update docs/handoff/20261014-tip_codesign.md and add with ap step add:
    - the result page docs/experiments/20261014-tip_codesign/20261014-sphere_pad_accuracy_and_fingertip_codesign.html, built from the newest builder with retro_style, texsvg and inlined films;
    - its page_figure_check run;
    - the INDEX.md row;
    - publishing on personal;
    - pinned iCEM on two cells for the best finalist against the baseline (four runs of about 262 s on 6 threads).

Cut order if the session falls behind: films (a) and (d) to the autopilot, then stage 3 to μ 0.7 only, then stage 2 to 6 candidates, then the r_end ∈ {6, 10.5} columns of the grid. Steps 2, 3, the step-5 hand check, the step-11 print files and film (e) stay.

Future work:
- Bench twist of the printed as-built tip and the best finalist at 0.1 and 1 rad/s, and a pull test. An arm near 4.6 mm on the print confirms the terrace-and-wall reading; near 3.0 mm refutes it.
- Side-on printing for crowned tips.
- Zero-shot evaluation of the six servo-plant policies on the best finalist (contact_feedback_replay.py with the rlscene scene).
- The wall-band pad fit from the FE pressure maps.

## Critic's verdict

The design will not run as written. It overruns in three places, so I would restructure it rather than patch it. First, the code is the critical path. Steps 3-5 put a patch sampler with curvatures, hull/STL/pocket, as_printed, FE hooks, two law modules, builder v2, a replace_tips dispatcher, bed rig subclasses, a spin driver, BedFilm, a scale wrapper and three test files into 0:20-2:15. Meanwhile the deterioration sweep on flat tips needs none of that code: tpu_tip_rig already builds any tpu<r> (tpu_models(radii=...), scripts/tpu_tip_rig.py:302) and block_law2.py already takes r. Second, the crown branch cannot be built. Face-up 0.2 mm layers flatten every crown into a top terrace 2·sqrt(0.2R) mm wide (2.9 mm at R 10.55, 4.9 mm at R 30). eflesh_build.write_3mf (scripts/eflesh_build.py:153-186) writes only the custom-gcode file and no layer-height ranges, so the 0.1 mm rescue route does not exist. The terraced-pad fallback also has no Drake reference, and about 3/4 of the Sobol points would land in that branch. Third, step 12 runs FE (3.7-5 GB, 4 cores) beside six single-core jobs and a 6-thread, about 3 GB iCEM, all inside cores 4-11 and 6 GB.

The references are computable as described. The Drake field E(1−gauge) about the hull's volume centroid can be integrated for any convex hull. The Winkler and local laws need only surface samples. The scratch brake_law.py reruns in under 1 s and reproduces the stated N45 values (0.373/0.364/0.393 N on r 2.7, 0.806/0.796/0.792 N on r 6, 0.243/0.243/0.222 N on r 0). Two parts of the statistics are flawed: the finalist interval pools the stage-2 placements that were used for selection, and J1 takes the best of about 33 grasps per cell. The τ step has two friction levels, and the four bistable placements (D3 seeds 0-2, D8 seed 1; 4 of 64 replays, 6 %) cross its 5 % threshold on their own.

Printing also matters more than the plan allows. Face up at 0.2 mm, the printed palmar contact is a flat terrace whose first step (0.2 mm) is deeper than the 3 N approach (113 µm). The fillet radius therefore reaches the contact only through the terrace width, sqrt(0.2r − 0.01) mm per side (0.77 mm at r 3.0). The edge is close to the sharp-box regime where the pads deteriorate most (spin ratio 1.71 on r 0, edge set back 311 µm). The revised plan runs the sweep on existing code from 0:15, makes the as-printed convex surface the screened geometry, takes crowns out of the screen, scores finalists on fresh seeds and puts the FE in a slot of its own. Compute falls from about 17 to about 9 core-hours, inside cores 4-11, 6 GB and 6 h (resguard at 18:55: 18.0 GB available, PSI 0.00/0.00, load 4.66 on 20 cores, gate open).

### Problems found in the design

- [critical] Steps 3-5 (0:20-2:15) and the overall schedule: About 1,500 lines of new code across six modules plus three test files are due by 2:15, and every compute step from 6 onward waits on them. The deterioration sweep is the part the owner asked for, and its flat members need no new geometry: tpu_tip_rig builds any 'tpu<r>' through tpu_models(radii=...) (scripts/tpu_tip_rig.py:302-313), and pad_usability_bed.py:42-52 patches the missing x0 on import. Step 3 also asks for a legacy mode that reproduces fingertip_geometry.pad_spheres to 1e-9 m, which means reimplementing its round() cell counts and Fibonacci corners (scripts/fingertip_geometry.py:45-151) just to pass a test. Fix: Launch the flat-member sweep at 0:15 through a 40-line wrapper over tpu_tip_rig and pad_usability_bed. It redirects MESH_DIR (tpu_tip_rig.py:38 otherwise writes into assets/mjcf/experimental/20261006-tpu_tip) and scales contact_bed_twist.C_LAW per shape. Promote block_law2.py, which already takes r, as the law module. Route legacy 'tpu<r>' keys to the original fingertip_geometry instead of reproducing them. Write TipShape only for the as-built, as-printed and unequal-radius members.
- [critical] Steps 3 and 9, crown variables and the 0.1 mm layer route: Two problems. Step 3 builds crowns as 'cylinders through the apex'. Two orthogonal cylinders intersect in a Steinmetz cap with creases along the diagonals, and the ψ 45 deg contact line runs along one of those creases. It is also not the spherical crown that steps 6 and 9 assume. Separately, the plan's own terrace formula 2·sqrt(2R·0.1 mm) flattens every crown face up, including the sphere cap (2.9 mm at R 10.55), to a terrace wider than its 1 N patch. The 0.1 mm rescue needs layer-height ranges in the 3MF, but write_3mf (eflesh_build.py:153-186) writes only Metadata/Prusa_Slicer_custom_gcode_per_print_z.xml. That leaves the terraced-pad path, which has no Drake reference. With 1/R sampled uniformly over [0, 1/15], about three quarters of Sobol points have a crown of 30 mm or more on at least one axis. Fix: Take crowns out of the screen. Keep the sphere cap (10.55 mm) and a 15 mm crown as deterioration members only, built as a smooth elliptic-paraboloid or torus cap, never as intersecting cylinders. Screen the flat family over (r_side, r_end), which prints face up. State in Future work that crowns need side-on printing (palmar face as perimeters, 'layers along' recipe 11.1 MPa at 95A 20 %) and a re-designed vertical pocket.
- [critical] Step 12 resources: In 4:25-5:15 the plan runs FE on cores 4-7 (3.7-5 GB measured, 4.4 GB in tip_runs_surf.jsonl), confirmation on six processes and iCEM with --nthread 6 on cores 5-10 (the planner example uses resguard --mem 3G), all at once. That exceeds the 6 GB cap and oversubscribes cores 5-7. resguard --cpu does not cap cores (memory note project_resguard_cpu_cap_ineffective.md). Fix: Run the FE alone, after the confirmation batch drains, on taskset -c 4-7 with --mem 6G. Move iCEM to the autopilot's queue or to Future work. It is first in the plan's own cut order, and at 262 s on 6 threads per run (scale_turn_cad_v1/planners/turn.jsonl median 297 s) it does not fit beside anything.
- [major] Steps 9-12, print realisation: Face up at 0.2 mm, PrusaSlicer slices at mid-layer, so the top layer covers the region within 0.1 mm of the apex. The next step down is 0.2 mm, deeper than the 113 µm approach at 3 N. The printed contact is therefore a terrace with bead-rounded (about 0.1 mm) edges, and the fillet radius enters only through the terrace half-width increment sqrt(0.2r − 0.01) mm (0.77 at r 3.0, 1.21 at r 7.4). The printed tip then sits near the r 0 regime, where the pads err most (1 rad/s spin ratio 1.71, edge set back 311 µm, no sphere touching a 45 deg plane until 60 µm). The G-code FE arm of 4.50-4.78 mm, against 3.0 mm homogenized (20261013-eflesh_printability/fem.jsonl), fits this. The plan treats print deviation as a correction applied to a few candidates. Fix: Define as_printed(layer) as the convex hull of the per-layer top outlines (slice at mid-layer, placed at the layer top). It is convex, so Drake's Convex path still applies, and pads sample it like any other shape. Add the as-built as-printed member to the deterioration sweep and evaluate every screened candidate on its as-printed surface. The design-surface as-built tip stays as a reference.
- [major] Step 12 decision: The bootstrap interval pools stage-2 placements, and those placements chose the finalists. Selecting on the same noise biases the paired difference upward. The scale-study best-grasp turn range has a 75th percentile of 34-35 deg over three placements (hom_postoff_servo/turn.jsonl). Fix: Compute the interval on stage-3 seeds only (HOM D1-D8 seeds 5-9, scale cells seeds 3-5). Use stage 2 for selection only.
- [major] Step 10, score J1: 'The best grasp's held turn' is a maximum over about 33 grasps per cell. Its mean over three placements carries a winner's-curse bias that grows with how noisy a candidate is, which favours tips with erratic turns. Fix: Per candidate and cell, pick the grasp on seed 0 and score its held turn on seeds 1-2. Alternatively, score the mean of the top three grasps ranked on seed 0.
- [major] Step 2, tolerance τ: Two friction levels (±10 %) cannot give 'the smallest change that alters 5 % of runs'. μ also scales translational friction, so τ measures friction tolerance and not pinch-torsion tolerance. The bistable placements D3 seeds 0-2 and D8 seed 1 flip under almost any change: in U2, pads end at −2.0 deg on D3 seed 0 where Drake turns 43.2 deg (servo_mujoco.jsonl, servo_drake.jsonl). They are 4 of 64 replays (6.3 %), so they cross the 5 % threshold by themselves. Fix: Use μ ∈ {0.8, 0.9, 0.95, 1.05, 1.1, 1.2} plus μ 1.0 at seeds 5-7, where U2 has no rows. Count changes on non-bistable placements and report the four bistable ones separately. The μ 0.8 level also tests the rate hypothesis for free, because 0.8 ≈ 3.59/4.55 is the ratio of Drake's sliding arm to the pads'. If D3 and D8 seed 1 turn at μ 0.8, the pads' excess torsion is enough to explain the U2 misses.
- [major] Step 7 M5, pinch spin rate from traces: No row stores the tool's angular velocity relative to each fingertip about the pinch normal. Replay rows keep trace_coarse (t, turn, z, force, pad count), and the HOM loop writes the same five fields (pad_usability_backends.py:271-273). A --traces flag means copying RB.run_mujoco (reorient_backends.py:373-461) and hom_turn3.rollout. The knob sweep on r 3.0 (relaxation, damping ratio, impratio) repeats probes already run on r 2.7, where tr 0.01/0.02/0.04 s gave 4.40/4.55/6.79 mm and impratio 10-10,000 gave 4.545-4.555 mm. Fix: Cut the knob sweep and the trace instrumentation. Settle the D3/D8 question with the μ 0.8 counterfactual from step 2. Read the hand's spin rate only from the bed-equivalent Π on the validity map.
- [major] Interpreters for steps 1, 3, 5 and 13: No interpreter has everything. logs/20261001-hom_contact/venv has MuJoCo 3.6.0 and pydrake but no trimesh, skimage or sksparse. .venv has MuJoCo 3.6.0 and trimesh but no pydrake. femtip has trimesh, manifold3d and sksparse but no MuJoCo. The geometry module is imported by the rig (hom venv), by the tests (.venv) and by the FE and print scripts (femtip). Fix: Keep tip_codesign_geometry.py to numpy and scipy (scipy.spatial.ConvexHull, as fingertip_geometry.hull_mesh does at :156-161). Import trimesh lazily, only in the STL, pocket and Hausdorff functions. Run the rig in the hom venv, the Hausdorff test in .venv, and the print and FE steps in femtip.
- [major] Steps 11-12, open-loop replays: Stage 2 runs replays at five conditions (200 per candidate) and stage 3 adds seeds 5-9 and j0916 placements. The plan itself says open-loop counts rank nothing, because the plans were exported against the legacy box (reorient_backends.py:9). That is about 47 core-min in stage 2 alone (12 × 160 × 1.46 s). Fix: Keep replays only at μ 1.0, seeds 0-2, paired with the 24 Drake replays for the agreement gate. Drop the replay conditions, the j0916 placements and the 64-placement GPU replays.
- [major] Step 3, unequal radii: The construction is a ball of radius min(r_side, r_end) plus excess fillet cylinders. Where r_side ≠ r_end it leaves convex creases at the corners, so 'corners blend smoothly' is not what it produces, and patch normals and curvatures are discontinuous there. The as-built member (equal 3.0 mm radii) is unaffected: the CAD STL's facet sag is 0.7 µm (adjacent-facet angle 2.50 deg at r 3.0), so the 0.05 mm Hausdorff test against assets/cad_v1/fingertip.stl (4,822 mm³, watertight) is feasible. Fix: State the crease and sample each side of it as its own patch. Turn off the curv factor within one pad spacing of a crease. Keep the Hausdorff and volume tests for the as-built member only.
- [minor] Steps 5 and 13, frame and dispatcher: D1-D8 are real_v1 hands with a 22.0 mm block (G.CENTRE (+2.05, 0, +0.45) mm). The CAD envelope is 21.41 mm. replace_tips trims the distal capsule with G.CENTRE/G.HALF (reorient_backends.py:249-253), and build_cad_v1_finger.cad_tip_geometry and hand_object_scale_sim.cad_tip_block overwrite those globals (build_cad_v1_finger.py:637-646, hand_object_scale_sim.py:158-159). make_pad_morphology_run's CLI cannot install a dispatcher, and HT.scenes hard-codes 'tpu2.7' (hom_turn3.py:66-70), so setting HT.SCENES alone does not change the tip. Fix: The shape module reads no globals. The dispatcher reads the hand's G.CENTRE/G.HALF at call time and places the shape by apex and contact point. It replaces the HT.scenes function, not only HT.SCENES. Add a 'rlscene' subcommand to tip_codesign_rig.py that installs the dispatcher and calls make_pad_morphology_run.build (make_pad_morphology_run.py:47).
- [minor] Step 8, material proxy: The insert fit times the magnet factor overpredicts the whole tip: 97.7 × 0.2^1.193 × 1.15 = 16.5 MPa, against 14.6 MPa from FE for 95A 20 % with the 5 mm magnet (magnet_runs.jsonl). The four-magnet factor does not apply, because the plan uses one magnet. The wall-band fit enters a pad model only after finalists have been evaluated, so it cannot change their ranking. Fix: Take E* directly from the four whole-tip FE recipes (14.6, 7.2, 6.9, 16.5 MPa) and use the proxy only between them. Cut the four-magnet factor and the wall-band fit; the wall-band fit goes to Future work.
- [minor] Step 5, bed twist ramp: C_LAW is a module global used for both the ramp rate and the row's rbar_law_mm (contact_bed_twist.py:47, 141-143). The 3 s cap is a literal at :162. Scaling C_LAW in a process that runs several shapes carries one shape's value into the next shape's rows. Fix: Set and record C_LAW per case inside the wrapper, and restore it in a finally block.
- [minor] Steps 6 and 7, items that decide nothing for control: Several parts are contact science with no hand decision attached: P5 and the T1 creep runs on every member (creep decides nothing, M7 says so), P6 Drake hull convergence on four members, the M2 side result on the legacy sphere pads ('change nothing'), and spin at five rates and three loads. A 0.1 mm hull has about 25 times the facets of the 0.5 mm hull (584 vertices and 1,164 tetrahedra at 0.5 mm), and its Drake cost has never been measured. Fix: Keep spin at 1 N and ω {0.03, 0.3, 1, 3} rad/s, T5 at 1 ms, and Drake T5 at 0.25 ms on r 2.7 and r 6 only. Time one 0.1 mm-hull static run on r 3.0 before scheduling more. Cut T1, P5, P6 beyond r 3.0, and the M2 side note.

### Cuts

- Crown variables in the Sobol screen and the 0.1 mm layer-range route: write_3mf has no layer ranges and face-up layers flatten every crown. Crowns stay as two deterioration members (sphere cap 10.55 mm, crown 15 mm).
- The terraced-height-field pad path with no Drake reference, replaced by the convex hull of the per-layer top outlines.
- Legacy-mode reimplementation of fingertip_geometry.pad_spheres to 1e-9 m: legacy keys route to the original module.
- T1 creep on every member, P5 and M7. Creep decides nothing for control.
- P6 Drake hull convergence on four members: only r 3.0 static at a 0.1 mm hull, timed first, plus T5 at 0.25 ms on r 2.7 and r 6.
- M5 knob sweep on r 3.0 (relaxation, damping ratio, impratio); the r 2.7 probes already measured these.
- Trace instrumentation of replays and HOM for the pinch spin rate, replaced by the μ 0.8 counterfactual in step 2.
- M2 side result on the legacy sphere pads ((R − rs)/R against its square).
- Spin at 0.5 and 3 N, and spin at 5 rad/s.
- Open-loop replays at the friction and servo conditions in stages 2 and 3, the j0916 placements and the 64-placement GPU replays.
- E* 7 and 14 MPa stage-2 conditions, unless step 2 shows E 5 or 20 MPa changing more than 4 runs.
- Pinned iCEM in this session; it goes to the autopilot queue with --hom-rows from the finalist's own HOM rows.
- Wall-band pad fit from FE pressure maps; it goes to Future work.
- Four-magnet E* factor.
- Films (b) brake, (c) finalists turning alone and (f) iCEM.
- Sobol sampling and the step-9 refinement factorial, replaced by a 6 × 4 grid over (r_side, r_end) on the flat family.

## Design (designer)

Plan for the sphere-pad deterioration study and the fingertip co-design (2026-10-14, designer pass)

The session runs for about 6 h on cores 4-11 with at most 6 GB resident, in three parts. Steps 1-7 measure how far the 1 mm sphere pads depart from their references across 21 convex fingertips, from the sharp box through the as-built CAD tip to the 10.55 mm sphere, and choose the pad-builder changes the hand needs. Steps 8-12 screen up to 40 printable tips on closed-loop turns and holds of the CAD hand and the bench hands D1-D8, under friction 0.5-1.0 and two servo limits, and confirm three finalists against the as-built tip. Steps 13-15 write the finalists' print projects, pad scenes and films, check every headline number, and pass the result page to the autopilot.

Three scratch probes run for this plan set the centre of the study. The scripts are in /tmp/claude-1001/-home-humanoid-Programs-hand/88ae0ebc-1769-4d06-9a8c-bed92903087d/scratchpad/: probe/kin_spin_cone.py, probe2/kin_spin_zeta.py and probe2/brake_law.py. On the 2.7 mm block at 1 N, the pads' sliding arm is 3.71 mm at 0.03 rad/s and 4.55 mm at 1 rad/s. The same pads integrated quasi-statically give 3.58 mm, and Drake's field law gives 3.64 mm. Three knobs leave the 1 rad/s excess in place: pad damping ratio 0.5 at the same d0 gives 4.41 mm, impratio 1 gives 4.46 mm and relaxation 0.01 s gives 4.40 mm. A pyramidal cone gives 3.13 mm, but its friction set is anisotropic, and at impratio 100 it puts the pad stiffness 100 times off. On this block the sliding-arm error is therefore a rate effect of MuJoCo's soft contact. It is separate from the static errors (foundation depth, area shares, fillet inset, scallop), which the builder can remove at no cost per step. The quasi-static brake law puts the 45 deg brake force on this block at 0.373 N (Drake field), 0.364 N (Winkler) and 0.393 N (quasi-static pads). The bed gives 0.338 N for the pads and 0.45-0.53 N for Drake, whose value still moves with the step size.

Terms. Approach: the tool's displacement into the tip along the pinch axis at pinch force N, in µm. Contact-line angle ψ: the angle between the tool axis and the tip's width direction (the PIP axis). The bench grasp starts at ψ = 0, and a turn about the pinch axis changes ψ. Onset arm: the torque about the pinch axis at which a pinched tool starts to spin under a ramped torque, divided by 2μN, in mm (bed task T2). Sliding arm: the mean torque that drives the tool to spin at rate ω, divided by 2μN; the quasi-static arm is its limit as ω goes to 0. N45: the pinch force at which a tool released horizontal, CG 15 mm from the pinch, passes 45 deg while the pinch falls from 6 to 0.2 N over 4 s (T5). Creep: steady sliding speed at half the slip force, in µm/s (T1). Law integral: the pressure p = Eδ/h integrated over the overlap of the rigid tool and the tip surface, with δ the local overlap. In the Winkler law, h is fixed at 8.5 mm, as in the current builder. In the local law, h_i = n·(x − c_V), the normal distance from the hull's volume centroid c_V, which equals Drake's field to first order. The drake field is E(1 − gauge) on the hull facets about c_V. Quasi-static pads: the builder's spheres and springs K_i summed over the same overlap, without a simulator. n_patch: loaded pads per side. ρ90: the 90th-percentile distance of the loaded pads from the pinch axis. Slip number Π = ω ρ90 t_c / δ, with t_c the pads' time constant (0.01 s). Scallop: the depth by which the sphere envelope sits below a plane tangent to a fillet between two arc rows, (r − rs)(1 − cos(Δθ/2)); it is 37.5 µm at r 2.7. Held turn: the tool's turn at the end of a run if at least two fingers press it with at least its weight, otherwise 0. Three-finger hold: all three fingers press with at least the tool's weight at the end. E*: the pad modulus that fits the finite-element approach of a printed tip at 0.5, 1 and 3 N. Servo plant: kp0.72_kv0_fr0.18_fl0_dp0.0144. τ: the hand's tolerance from step 2.

1. Pre-flight and the replay wrapper (0:00-0:20). Quote `~/.claude/bin/resguard.sh status` and `nvidia-smi --query-compute-apps=pid,process_name,used_memory --format=csv`, and list the autopilot's processes with `pgrep -af '[p]ad_usability|[h]and_object_scale|[r]l_train'`. Create logs/20261014-tip_codesign/{scenes,scale,fe} and docs/experiments/20261014-tip_codesign/{tolerance,deterioration,screen,final,print,media}.
   - Write the first part of scripts/tip_codesign_rig.py, with subcommands `replay` and `hom`. They import pad_usability_backends (PUB) and hom_turn3 (HT) without editing them.
   - Set PUB.SCN and HT.SCENES to logs/20261014-tip_codesign/scenes; U2's scene folder belongs to the autopilot.
   - Flags: --tip, --E (a functools.partial over reorient_backends.replace_tips, as PUB.build does for pads2), --mu, --plants, --seeds, --jitter, --out, --traces.
   - `hom` copies PUB.cmd_hom's 40-line loop with the requested tip in HT.scenes and in the row, and resumes by (hand, tip, plant, μ, E, seed).
   - Interpreter: PY=logs/20261001-hom_contact/venv/bin/python (MuJoCo 3.6, Drake 1.57).
   - Check: D7 seed 0 on the servo plant with tpu2.7 pads reproduces turn_end_deg and held_end of its row in docs/experiments/20261014-pad_usability/agree/servo_mujoco.jsonl.
   - Measure the RSS of one replay, one HOM run and one Drake replay with /usr/bin/time -v. Batch size is floor(6 GB / (1.3 RSS)), at most seven single-core processes on cores 5-11, with core 4 kept for interactive probes. Commit.

2. Hand tolerance to friction-torque errors (launch 0:20, about 6 min wall on cores 10-11, split by hand). This step sets the accuracy the hand needs, so pad errors are judged against outcomes and not against an arbitrary percentage.
   - Tip tpu2.7 pads, servo plant. Conditions: μ 0.9, 1.0 and 1.1, plus E 5 and 20 MPa at μ 1.0 (twist arm 2.66 against 2.39 mm at 1 N, contact_feedback page).
   - Runs: replays of D1-D8 seeds 0-7 (64) and HOM seeds 0-2 with --set kp_model=0.72 (24), so 5 × 88 = 440 runs at about 1.3 s each.
   - Command, for example: `resguard.sh run --mem <1.3 RSS> --cpu 100 -- taskset -c 10 $PY scripts/tip_codesign_rig.py replay --hands D1 D2 D3 D4 --tip tpu2.7 --model pads --plants kp0.72_kv0_fr0.18_fl0_dp0.0144 --mu 0.9 1.0 1.1 --seeds 0 1 2 3 4 5 6 7 --out docs/experiments/20261014-tip_codesign/tolerance/replay.jsonl`, then --E 5e6 2e7 at μ 1.0; `hom` the same with seeds 0-2.
   - Score: runs whose outcome changes against μ 1.0 and E 10 MPa (a held flip, or |Δturn| > 3 deg).
   - Prediction: μ ±10 % changes 5-12 of 88 runs; E 5 or 20 MPa changes at most 4.
   - Decision: τ is the smallest change of friction torque that alters at least 5 % of runs; 10 % if the prediction holds. A pad error below τ justifies no builder change and no rejection, and τ is the fidelity gate of steps 7, 10 and 11.
   - If E changes more than 4 runs, E* becomes a screening perturbation; step 11 already runs both ends of the recipe band.

3. Fingertip family (0:20-1:05): scripts/tip_codesign_geometry.py.
   - Envelope: the CAD insert, 17.0 mm deep, 14.8 mm wide, 21.41 mm long. The apex is 10.55 mm from the finger axis and the end face 10.55 mm beyond the contact point. Back and mount faces are flat with square edges, as in assets/cad_v1/fingertip.stl.
   - Free parameters: r_side (the two palmar long edges), r_end (the palmar end edge and the side-end edges), and crown radii Rx across and Rz along the palmar face (∞ for flat).
   - Construction: the Minkowski sum of a convex core and a ball of radius min(r_side, r_end), clipped by the back and mount planes. The excess radius is cut into the core as fillet cylinders and the crowns as cylinders through the apex. Corners blend smoothly, and the as-built member has the CAD's spherical 3.0 mm corners.
   - Sampling: the surface is a union of patches of known type (planes, crowns, fillet cylinders, corner pieces). Each patch is sampled in its own parameters at spacing s, with arc rows on curved patches, and each sample has its exact normal, area share and principal curvatures.
   - Other outputs:
     - hull OBJ at 0.5, 0.2 or 0.1 mm, named by a shape key such as tcd_rs3.0_re3.0_cxinf_czinf and written through a temporary file;
     - c_V;
     - insert-frame inside(x, y, z) and surface_x(y, z) for the FE hooks;
     - the face-up STL with the tpu_tip_design.pocket magnet pocket;
     - as_printed(layer), used in step 9.
   - It reads no fingertip_geometry globals, which build_cad_v1_finger and hand_object_scale_sim overwrite at import.
   - Tests in tests/test_tip_codesign.py (`PYTEST_DISABLE_PLUGIN_AUTOLOAD=1 .venv/bin/python -m pytest`):
     - a legacy mode (22.0 mm, every edge at 2.7 mm) reproduces fingertip_geometry.pad_spheres(0.0027, 0.001, 0.00075) to 1e-9 m, 1,059 pads;
     - the as-built member (r_side = r_end = 3.0 mm, flat) lies within 0.05 mm of the CAD STL (symmetric Hausdorff, in build_cad_v1_finger.cad_tip_geometry's frame) and within 0.5 % of its 4,822 mm³;
     - the hull's c_V equals the analytic centroid to 0.01 mm.
   - Cost under 2 s per shape. Commit.

4. Law integrals (1:05-1:30): scripts/tip_codesign_law.py, a repository version of the scratch block_law2.py generalised to TipShape.
   - Fields: winkler, local, drake and pads (quasi-static).
   - Tool: the bed's R 12.5 mm cylinder, turned by ψ about the pinch axis.
   - Outputs per field, at N ∈ {0.5, 1, 3, 5} N and ψ ∈ {0, 15, ..., 90} deg: approach, all-slip arm about the pinch axis, patch area, ρ90 and n_patch.
   - Plane presses on the palmar, side and end faces and on fillets at 30, 45 and 60 deg, for δ 5-120 µm.
   - The quasi-static brake curve N(φ) = m g d cos φ / (2μ arm(N, ψ = φ)), with m 24.5 g, d 15 mm and μ 1, solved as a fixed point for N10, N45 and N80.
   - About 10 s per shape for all fields.
   - Check: within 0.5 % of block_law2 on the legacy block. There the drake-field arm is 2.554 mm at ψ 0 and 1 N, and the ψ 23-69 deg means are 3.58/3.64/3.78 mm (drake field) and 3.51/3.58/3.84 mm (pads) at 0.5/1/3 N. It also matches this plan's N45 values: 0.373/0.364/0.393 N on r 2.7, 0.806/0.796/0.792 N on r 6 and 0.243/0.243/0.222 N on r 0 (drake field/Winkler/pads).

5. Pad builder and plumbing (1:30-2:15).
   - Builder, in tip_codesign_geometry.py: pad_spheres(shape, s, rs, E, h='fixed'|'local', K='median'|'each', curv=False|True, scallop=None|ε, offset=(0, 0)) gives centres inset by rs, normals, areas and K_i = E a_i / h_i.
     - curv multiplies K_i by sqrt((1 − rs κ1)(1 − rs κ2));
     - scallop refines arc rows until the scallop is below ε;
     - offset shifts the face grid.
   - Scene builder, in tip_codesign_rig.py: replace_tips(root, tip, model, MU, out_dir, **builder) for tcd_* keys. It is a copy of reorient_backends.replace_tips that gives each pad its own solimp d0_i = 1 − 1/(t_c² K_i Λ), with Λ the body_invweight0 of tip plus tool and a ValueError below 0.05. It writes the shape's OBJs by key, trims the distal capsule to the shape's top, and returns meshes keyed by palmar sign for DrakeBench. install() points RB.replace_tips at it for tcd_* keys and leaves other keys to the original.
   - Bed: TipMjRig and TipDrakeRig, subclasses of tpu_tip_rig's rigs with x0 = 10.55 mm + R_TOOL.
     - Specs mj:spheres:s1:rs0.75:ir100:tr0.02:tcd=<key> and drake:hydro:E1e7:r1:rt0.01:tcd=<key>, registered in contact_bed_common.MODELS and contact_bed_pull.MODELS.
     - The T2 ramp is scaled per shape through contact_bed_twist.C_LAW so the law's onset falls at 1.0 s. This removes the 3 s cap that left the sharp box with no onset.
     - A spin driver (repository version of kin_spin3.py) takes a list of ω and records the arm, per-sphere force over K × penetration against radius, n_patch and ρ90.
     - A BedFilm subclass draws the shape's hull and pads. hom_contact_rig.FilmRig cannot parse a tpu or tcd spec.
   - Scale-study wrapper: sets SCALE_HAND=cad_v1 before importing hand_object_scale_sim (S); points S.GEN and S.SCENES at logs/20261014-tip_codesign/scale/<key>_mu<μ>_<plant>/, since the cell-scene cache path has no tip in it; sets S.MU; calls S.cmd_run with RB.replace_tips mapped to the candidate whatever tip the caller names. The `replay` and `hom` subcommands accept tcd keys.
   - Tests:
     - the legacy member (h fixed, K median) reproduces the U2 D7 seed 0 row, and the 1 N onset arm of 2.525 mm in tip_T2.jsonl within 1 %;
     - in a per-pad-d0 scene every touching pad realises its K_i within 1 % (method of pad_contact_rig.realised_stiffness);
     - two processes building different keys never read each other's meshes.
   - Commit.

6. Deterioration sweep (launch 2:15, about 20 min wall on cores 5-10, Drake convergence on core 11, about 100 core-min).
   - Family, 21 members, all with 1 mm pads, E 10 MPa and μ 1:
     - flat tips with r_side = r_end = r ∈ {0, 0.5, 0.75, 1.0, 1.5, 2.0, 2.7, 3.0, 4.0, 5.0, 6.0, 7.4} mm, where 7.4 mm is the half-width (a full round across);
     - on r 3.0, spherical crowns with R ∈ {60, 30, 15, 10.55} mm and crowns across only with R ∈ {30, 15} mm;
     - the legacy tpu2.7 block, which ties the sweep to the 10-06 rows;
     - the real_v1 sphere tip (bed models mj_pads1 and drake_hydro, law from hydroelastic_arm_integral.py).
   - MuJoCo bed per member: static at 0.5/1/3/5 N; T2 at 1 and 3 N; spin at ω ∈ {0.03, 0.1, 0.3, 1, 3} rad/s at 1 N and {0.03, 1} at 0.5 and 3 N; T5 at 1 ms; T1 at 1 N. About 1.5 min per member; the 0.03 rad/s spin is 40 s of simulated time.
   - Drake bed per member: static and T2 at 1 N, spin at 0.3 and 1 rad/s, T5 at 1 and 0.5 ms; 1-2 min.
   - Convergence on r 0.5, 3.0, 6.0 and crown 15: Drake T5 at 0.25 ms, and hulls at 0.2 and 0.1 mm for static and plane presses.
   - Rows: docs/experiments/20261014-tip_codesign/deterioration/{law,static,T1,T2,T5,spin,drake_conv}.jsonl, one fsynced line per case.
   - Predictions:
     - P1, static: quasi-static pads stay within 5 % of the Winkler law in approach at 1-5 N, and within 3 % in arm at every ψ, for r ≥ 2 mm. They are 10-30 % off for r ≤ 1 mm, where the side spheres clamp, the edge row doubles and the edge sits 311 µm back. They are up to 15 % off in approach at 0.5 N on flat faces (M4).
     - P2, law choice: Winkler and drake field differ by at most 2 % in onset arm at ψ ≤ 45 deg, and by 3-8 % at ψ ≥ 75 deg, where the line reaches the end face (h 11.0 against 8.5 mm).
     - P3, rate: on every member the 0.03 rad/s arm lies within 5 % of its quasi-static pads (3.6 % measured on r 2.7). The excess over that value collapses onto one curve of Π within ±0.05. Spin arm over the law at 1 rad/s and 1 N in existing rows: 1.01-1.04 (sphere), 1.14 (r 6), 1.25 (r 2.7), 1.71 (r 0).
     - P4, brake: N45 = m g d cos 45° / (2μ arm(N45, ω45)) within 10 %, with ω45 the swing rate at 45 deg read from each T5 trace and the arm taken from the same simulator's spin rows. For Drake this is tested once its N45 changes less than 3 % from 0.5 to 0.25 ms.
     - P5, creep: creep × n_patch is constant within ±25 % over the family (the soft-friction law).
     - P6, Drake against its own field: static arm and plane presses within 3 % of the drake-field integral at 0.1 mm hulls. At 0.5 mm, the 45 deg fillet press on r 2.7 at 60 µm is about 30 % low because of the 13 µm chord sag.
   - Falsifiers and decisions:
     - A member with r ≥ 2 mm outside P1 by more than τ makes the step-7 fixes mandatory before screening.
     - P3 failing (members more than 0.1 apart at equal Π, or a slow-spin arm more than 5 % off) means part of the sliding error is geometric, and the fillet fixes are retested on sliding.
     - P4 failing for Drake while P6 holds means Drake's brake has a step effect its spin test lacks; the brake is then judged on the pads against the law.
   - Output: the validity map. A geometry is usable for control studies with 1 mm pads where its static errors and its predicted sliding excess at the task's pinch spin rate (M5) stay below τ. The map is drawn on r/rs against Π at 1 rad/s, and decides which screening candidates need finer pads or a flag.

7. Mechanism tests, builder fixes and the hand check (2:35-3:00). Quasi-static parts take seconds; bed parts about 30 core-min. Members are r 1.0, 3.0, 6.0 and crown 15 unless stated.
   - M1, sampling against patch size.
     - Test: s ∈ {0.5, 0.75, 1, 1.5, 2} mm with rs = 0.75 s, against the law at 0.5-5 N.
     - Prediction: errors fall below τ above a threshold n* of 6-12 loaded pads per side. The 2 mm pads (about 5 at 1 N on the block) fail, consistent with their 12 of 24 placements on the servo plant.
     - Decision: each candidate takes the largest s with n_patch ≥ n* at 1 N. This means fewer pads on large-patch tips; cost in µs per step comes from the replay rows.
   - M2, inset on curved patches.
     - Test: plane presses on fillets r ∈ {1, 1.5, 2, 2.7, 3, 4, 6} at 30, 45 and 60 deg.
     - Prediction: first contact is delayed by the scallop. Beyond twice the scallop, the pads exceed the local law by sqrt(r/(r − rs)) on fillets (1.18 at r 2.7, 1.41 at r 1.5, 1.07 at r 6) and by r/(r − rs) on spherical corners. The inset centres stand proud of oblique planes by rs(1 − cos θ).
     - Fix C, the curv factor: brings the ratios within ±5 %. For r ≤ 1 mm the factor exceeds 2, so test spheres of radius r/2 on those fillets as well.
     - Fix D, scallop ≤ 10 µm: 8 arc rows instead of 4 at r 2.7, about +12 % pads on the as-built tip.
     - Decision: adopt C if it meets the prediction. Adopt D only where the working contact reaches a curved patch whose scallop exceeds a third of the 1 N approach.
     - Side result: the same derivation gives (R − rs)/R = 0.929 for the real_v1 sphere under a flat. hom_contact_rig.mj_xml uses ((R − rs)/R)² = 0.863, so those legacy sphere pads should be about 7 % soft in approach. Record it; change nothing.
   - M3, foundation depth (fix A, local h_i).
     - Prediction: the plane-press ratios against Drake change from 0.97/1.03 to about 1.0 (palmar), from 0.92/0.96 to 1.06/1.10 (side) and from 1.25/1.37 to 0.97/1.06 (end) at 20/60 µm. This is today's ratios times 8.5/7.4 and 8.5/11.0. The remaining side excess is the fillet inset at the face's edges and falls with C.
     - Decision: adopt A, which costs nothing, if every region moves toward Drake's field.
   - M4, strip patch.
     - Test: tool offset along the finger 0-1 mm in 0.1 mm steps, ψ 0-90 deg in 5 deg steps, at 0.5, 1 and 3 N, with grid offsets 0 and half a spacing.
     - Prediction: the approach varies by at least 20 % at 0.5 N and at most 6 % at 3 N; two or three rows fall inside the 2.3 mm strip at 1 N. The onset arm varies by at most 3 % at ψ 0 and up to 8 % at oblique ψ.
     - Decision: 0.75 mm pads on the palmar face if the arm ripple at the servo plant's 4.3 N per finger exceeds τ.
   - M5, rate effect.
     - Test: the step-6 spin rows, plus on r 3.0 relaxation 0.01/0.02/0.04 s, damping ratio 0.5/1 at equal d0, and impratio 10/100.
     - Prediction, from this plan's probes: no knob removes more than a fifth of the 1 rad/s excess, so no builder fix is adopted.
     - Follow-up: read the pinch spin rate of each hand task from traces, as the relative angular velocity of the tool about each pinch normal. Sources: replays with --traces on D3 seeds 0-2 and D8 seed 1, HOM on D1-D8, and iCEM swings from the 10-14 planner rows. Convert each rate into a predicted excess with the step-6 curve.
     - Decision: if D3's pinch spins at a Π whose excess exceeds τ, the U2 no-turn misses on D3 and D8 are assigned to the rate effect; otherwise they stay open.
   - M6, per-pad K (fix B).
     - Prediction: changes of 1-2 % at r 2.7-3 and up to 6 % at r ≤ 1 and r ≥ 6, where area shares span 0.88-1.42 mm².
     - Decision: adopt; it costs nothing.
   - M7, creep: the P5 check only. Creep decides nothing for control: RL numerics raise it tenfold, and closed-loop policies keep 1,531 of 1,536 rollouts across tip models.
   - Hand check. The passing fixes, expected A, B and C, form builder v2.
     - Runs on the as-built member: U2's set with builder v2 and with the current builder, i.e. replays D1-D8 seeds 0-4 and HOM seeds 0-2 on the servo plant at μ 1.0. Plus 24 Drake replays of the as-built member at seeds 0-2, about 6 core-min of Drake. U2's Drake rows are for tpu2.7.
     - Prediction: within-3 deg agreement with Drake stays at 16 ± 2 of 24, and HOM at 21 ± 2 of 24 within 5 deg. Static fixes do not reach the bistable D3 and D8 placements.
     - Decision: builder v2 is used in steps 9-12 if it loses at most two placements. It is proposed to the owner as the default only after step 12.
   - Commit.

8. Material model (written 2:35-2:55 beside step 7): scripts/tip_codesign_material.py.
   - Screening proxy, from the FE rows for layers across and gyroid 10-40 %: E* = 97.7 MPa × ρ^1.193 × (E_s / 30 MPa)^1.41, with E_s 30 MPa (95A) or 12 MPa (85A). Multiply by 1.15 for one 4.76 × 1.59 mm magnet 5 mm deep, and by 1.12 again for four.
   - The as-printed band is 0.5-1.0 × E*: the 95A 20 % tip solved from its G-code gives 7.3 MPa against 14.6 MPa homogenized.
   - Recipes with the magnet: 95A 20 % 14.6 MPa, 95A 10 % 7.2 MPa, 85A 30 % 6.9 MPa, 85A 50 % 16.5 MPa.
   - FE for finalists: tpu_tip_magnet.run in ~/miniconda3/envs/femtip, with tpu_tip_design.inside_body and surface_x replaced by the shape's insert-frame functions. Recipe w95_20 plus the finalist's recipe, magnet d4.76x1.59@5. Keep per-node pressure, position and area from T.force_controlled for the wall-band fit.
   - FE compute: one model per process (two in one process reached 11 GB). Measure RSS on the first run; expect 3.7-5 GB, so FE runs beside at most one other job. About 235 s per tip on cores 4-7.
   - Predictions:
     - finalists' FE E* within ±25 % of the proxy;
     - on flat members, the FE arm is 7-23 % longer than the local law, because the two 0.45 mm walls under the face edges take 46-66 % of the edge load. On crowned members the top layers' perimeter rings lie inside the contact, and the FE decides the sign;
     - magnet travel 12-30 µm/N, with force noise of about 1.2 µm divided by the travel.
   - Decisions:
     - The recipe is chosen per finalist by sensing (five-chip force noise at most 0.1 N, so travel at least 12 µm/N) and printability. This holds provided step 11 shows that the E* band changes fewer outcomes than τ allows.
     - A wall band w(d) = 1 + a exp(−d/ℓ) on K_i, with d the in-plane distance to the nearest top-layer outline, is fitted to the FE arm and edge share at 1 and 3 N. It enters the finalist's pad model if it moves the arm by more than τ.

9. Design space, print realisation and the candidate set (2:55-3:10).
   - Variables: r_side ∈ [0.75, 7.4] mm, r_end ∈ [0.75, 10.5] mm, and crown curvatures 1/Rx and 1/Rz ∈ [0, 1/15] mm⁻¹.
   - Fixed: the envelope and apex of step 3. The DIP link mount, the CAD finger's tip frame (build_cad_v1_finger checks the bounding box to 1e-5 m) and the deployed plans' grip depth therefore do not change.
   - Magnet: one N52 4.76 × 1.59 mm magnet in a 90 % press-fit pocket 5 mm under the apex at the contact point. The pause of tpu_tip_design.print_sheet stays before layer 62 at 12.4 mm, because the apex stays 17.0 mm above the back face.
   - Print settings: face up on the back face, two 0.45 mm walls, four 0.2 mm skins, gyroid.
   - Every member of this convex family prints as one island per layer without supports, and keeps at least 2 mm of TPU around the pocket. These are checked once, not screened.
   - The binding constraint is the layer grid. PrusaSlicer slices at mid-layer, so the printed top terrace covers the region where the design surface lies within half a layer of the apex. TipShape.as_printed(layer) returns that terraced surface, and the law on it against the design surface gives the print deviation of approach and onset arm at 1 N.
   - Prediction: the as-built tip prints a 10.34 mm top terrace against its 8.8 mm design flat (0.77 mm into each 3.0 mm fillet), and its 1 N onset arm rises by 5-10 %. A crown of radius R prints as a flat terrace 2 sqrt(2R × 0.1 mm) wide: 4.9 mm at R 30, 6.9 mm at R 60. That is wider than the design patch at 1 N (3.6 mm along the tool at R 30), so crowns of 30 mm or more do not survive 0.2 mm layers.
   - Decision: a candidate whose print deviation exceeds τ takes one of two routes. It is printed with 0.1 mm layers on its top 2 mm, as a layer-height range in the 3MF, if that brings the deviation under τ. Otherwise it is evaluated on its as-printed surface, with pads on the terraced height field and no Drake reference, since Drake's convex hull removes the steps.
   - Candidates:
     - 24 Sobol points (scipy.stats.qmc.Sobol, seed 0) over the four variables;
     - 8 anchors: as-built, legacy tpu2.7, r 1.0 flat, r 6.0 flat, full round across (7.4/3.0), sphere cap (Rx = Rz = 10.55 on r 3.0), crown 30/30 on r 3.0, and a narrow long flat (r_side 5.0, r_end 1.0);
     - after stage 1, up to 8 refinements: a two-level factorial, ±25 % in the two most influential variables around the best stage-1 region.
     - At most 40 candidates.

10. Stage-1 screen (3:10-3:45, about 6 core-min per candidate, 240 core-min on seven single-core processes). Per candidate, with builder v2, the M1 spacing, E 10 MPa, the servo plant and μ 0.7:
    - (a) Fidelity, about 2 min. Law and quasi-static pads. MuJoCo bed static, T2 at 1 N, spin at 0.3 and 1 rad/s, T5 at 1 ms. Drake static, T2 and T5.
    - (b) HOM on the CAD hand's four planner cells, through the step-5 wrapper: `--cells diag --only cylinder:25:0.125 cylinder:16:0.625 cylinder:10:0.75 cylinder:16:-0.375 --what hold,turn --seeds 0 1 2 --plant kp0.72_kv0_fr0.18_fl0_dp0.0144 --set kp_model=0.72 post_off=1`. About 100 turns of 0.55 s and 33 hold tests of 3 s.
    - (c) HOM on D1-D8 seeds 0-2, 24 runs of about 1 s.
    - Score J1: the mean of two parts, each divided by 90 deg. The first is the mean over the four cells of the best grasp's held turn (mean over three placements, a drop counting 0). The second is the mean held turn over the 24 D1-D8 runs.
    - Reported alongside: three-finger hold fraction, the hold test's median disturbance load, onset arm, N45 and its pads/Drake ratio, pads per tip, µs per step, and print deviation.
    - Gate: a candidate whose static fidelity misses τ continues only with finer pads (M1) and a flag.
    - Prediction PC1: J1 peaks at an interior r_side of 3-6 mm. At small r, pinch torsion resists the turn about the pinch axis; at large r, it no longer resists the tool's gravity torque. Falsifier: J1 monotone over 0.75-7.4 mm.
    - Prediction PC2: crowns with R ≤ 30 mm lower the three-finger hold fraction by at least 3 of 36 runs against the as-built tip, because their arm falls to about 1 mm. Falsifier: no loss, so torsion is not what keeps the tool at μ 0.7.
    - Decision: the 12 highest J1 among passing candidates go to stage 2, always including the as-built tip.

11. Stage 2, perturbations and fidelity (3:45-4:25, about 22 core-min per candidate, 265 core-min).
    - Conditions:
      - servo plant at μ 1.0, 0.7 and 0.5;
      - at μ 0.7, kp 0.5 (kp0.5_kv0_fr0.18_fl0_dp0.0144) and a 0.12 N m torque limit (kp0.72_kv0_fr0.12_fl0_dp0.0144), with HOM keeping kp_model 0.72;
      - at μ 0.7, E* at 7 and 14 MPa.
    - Runs per candidate:
      - replays and HOM on D1-D8 seeds 0-4 per condition (400);
      - scale-cell HOM, seeds 0-2, at the four conditions stage 1 lacks (400);
      - the hold test at μ 0.5;
      - 24 Drake replays (D1-D8 seeds 0-2) at μ 1.0.
    - Score J2: the minimum of the stage-1 composite over the five friction and servo conditions.
    - Reported: open-loop held count per condition, which ranks nothing because it favours tips like the legacy box the plans were exported against; within-3 deg agreement with Drake (gate: at most two placements worse than the as-built tip); outcome changes between E* 7 and 14 MPa.
    - Prediction PC3: E* 7 against 14 MPa changes at most 2 of 64 HOM outcomes per candidate. Falsifier: more, and the recipe is then chosen on J2.
    - Prediction PC4: only candidates with r ≥ 5 mm reach 0.8 of the as-built tip's µs per replay step.
    - Finalists:
      - (1) the highest J2 that passes the gates;
      - (2) the highest J2 at no more than 0.8 of the as-built step cost;
      - (3) the highest three-finger hold fraction at μ 0.5;
      - (4) the as-built tip as baseline.
      - Where (1)-(3) coincide, take the next distinct candidate: at least 1 mm apart in r_side or r_end, or another crown class.

12. Finalist confirmation (4:25-5:15).
    - Per finalist and baseline:
      - replays and HOM on D1-D8 seeds 5-9 at the five conditions;
      - scale cells, seeds 3-5, at μ 0.7 and 0.5;
      - replays with j0916 placements (sd 4 mm);
      - 24 Drake replays at μ 0.7.
      - About 80 core-min for four tips, 14 min on six processes.
    - FE of the three new finalists: step 8, about 14 min serial on cores 4-7.
    - Pinned iCEM on cylinder:16:0.625 and cylinder:25:0.125, seed 0, nominal plant, for the best finalist and the baseline. Four runs of about 262 s with --nthread 6 on taskset -c 5-10, with --hom-rows taken from each tip's own stage-2 HOM rows; about 18 min.
    - Optional, only when no Warp process runs: 64-placement GPU replays through reorient_backends_gpu.run_batch with the dispatcher installed, 15-33 s per hand.
    - Decision: a finalist beats the baseline where the paired difference of J2 over the pooled stage-2 and stage-3 placements has a bootstrap 90 % interval above zero (10,000 resamples of placements within hands and cells), and its three-finger hold at μ 0.5 is lower by at most two runs. Otherwise the page states that no geometry in the family improves on the as-built tip on these tasks, and gives the intervals.

13. Print files and pad models (4:45-5:10, seconds per finalist): scripts/tip_codesign_print.py in femtip. Per finalist, under docs/experiments/20261014-tip_codesign/print/<key>/:
    - the face-up STL: bounds 21.41 × 14.8 × 17.0 mm, watertight, with the pocket as an inner shell;
    - a PrusaSlicer 3MF from eflesh_build.write_3mf with the owner's v17 template (~/wxie_workspace/fingers/merged_finger_v17.3mf). FLEX on extruder 2; part settings perimeters 2, fill_density per recipe, fill_pattern gyroid, 4 top and 4 bottom layers. It includes the M601 pause, and the 0.1 mm layer range where step 9 asks for it;
    - eflesh_build.slice_check (flatpak PrusaSlicer 2.9.2) confirms the pause before layer 62 at 12.4 mm and one island per layer, and reports supported share and print time;
    - the print sheet from tpu_tip_design.print_sheet, with recipe, E* (proxy and FE) and the pad parameters;
    - pad scenes under assets/mjcf/experimental/20261014-tip_codesign/<key>/: the CAD hand's screwdriver scene (build_cad_v1_finger.write_scene with the dispatcher mapping its tpu2.7 call to the finalist) and the D6 servo bench scene;
    - the make_pad_morphology_run.py command through the dispatcher, for the owner's RL queue.

14. Films (4:50-5:25), rendered on the CPU through Mesa EGL as hand_object_scale_films.py does, so they never wait for the GPU: `__EGL_VENDOR_LIBRARY_FILENAMES=/usr/share/glvnd/egl_vendor.d/50_mesa.json MUJOCO_GL=egl LP_NUM_THREADS=1`. Script: scripts/tip_codesign_film.py. Panels 640 × 480, tiled with reorient_backends_films.tile_stream at crf 20, with label bars as pad_usability_backends.label_bar (type at least 13 px at the displayed tile width). Films:
    - (a) bed spin at 1 N: r 1.0, 3.0, 6.0 and crown 15 at 1 rad/s, and r 3.0 at 0.03 rad/s as a time-lapse. Pads are coloured by force over K × penetration, white at 1 and red at 10 or more; the label gives the arm against the law;
    - (b) brake, pads and Drake on r 3.0 and r 6.0;
    - (c) each finalist and the baseline turning once about the long axis, with pads;
    - (d) HOM on cylinder:16:0.625 of the CAD hand, finalists and baseline, 2 × 2, pads touching the object in red;
    - (e) D7 seed 0 servo replay, 2 × 2;
    - (f) iCEM, best finalist against baseline, if it ran.
    - Read every poster at its displayed size before committing.

15. Verification and hand-off (5:25-6:00).
    - scripts/tip_codesign_verify.py recomputes every headline number from the rows: τ, the deterioration table, the P3 collapse residual, the fixes' error changes, J1, J2 and the intervals, and the FE and slice checks.
    - It also rebuilds each row's scene from its key and compares pad count, d0 range, envelope, μ and plant gains; a mismatch voids the row.
    - Run the pytest file. Check ~/.claude/resguard_events.jsonl for kills of this session's jobs and rerun any killed case.
    - Commit code at the end of each step and rows (LFS) at milestones.
    - Update the State line of docs/handoff/20261014-tip_codesign.md and add, with ap step add: the result page (scripts/tip_codesign_page.py and its template from the newest builder, with retro_style, texsvg for every formula and films inlined) as docs/experiments/20261014-tip_codesign/20261014-sphere_pad_accuracy_and_fingertip_codesign.html, its page_figure_check run, the INDEX.md row and publishing on personal; and whatever was cut from steps 12-14.

Compute rules. Every job longer than a minute is quoted with resguard status and launched as `resguard.sh run --mem <1.3 RSS> --cpu 100 -- taskset -c <core> ...`; --cpu does not cap cores, so taskset does. Use single-core processes, at most seven at a time and 6 GB in total. FE runs beside at most one other job. Rows are fsynced. There is no Newton anywhere. Total compute is about 17 core-hours. If the session falls behind, cut in this order: iCEM, the GPU replays, the j0916 placements and extra seeds of stage 3, the refinements of step 9, the crown-across members, and stage 2 down to 8 candidates. Step 2, the flat members of step 6, the hand check of step 7, the finalists' print files and films (d) and (e) stay.

Left out, because they do not change a decision about the hand:
- a superellipsoid family, since fillet plus crown already spans sphere to box and is what the printer can make;
- non-convex lattice tips, which print soundly only at 8 mm cells and have no Drake reference;
- the shake and rolling bed tasks, since no hand task rolls the object and the hold test covers the torques;
- per-candidate RL training, at hours of GPU per tip; the zero-shot test of the six servo-plant policies on the best finalist goes to Future work;
- creep mechanisms beyond the soft-friction check.

Future work for the owner: a bench twist of the printed finalist at 0.1 and 1 rad/s decides whether the pads' rate effect is an artefact, since the law and the FE are rate-free. A pull test fixes μ, which every task here varies over 0.5-1.0.

For the reply to the owner. The condim-4 reading is right, and on the block the larger problem is the contact-line angle. The pads' arm barely depends on load (2.527 F^0.070 mm). It grows with the angle from 2.55 mm at ψ 10 deg to 3.42 mm at 45 deg and 4.16 mm at 80 deg (law integral, at the brake's loads), and it spans 0.8-4 mm across tips. A fixed 2.8 mm coefficient reached 1 of 24 placements within 3 deg of Drake on the servo plant. In code, tpu<r> is the 17.0 × 14.8 × 22.0 mm block with every edge rounded at r (a box plus a sphere). The printed CAD insert is 21.41 mm long, with r 3.0 on the palmar and side-end edges, spherical corners and square back and mount edges; step 3 makes it the baseline.

## Reader maps

### geometry_pads_reference

The pad builder covers one shape family. scripts/fingertip_geometry.py samples the Minkowski sum of a box (17.0 x 14.8 x 22.0 mm, or 21.41 mm on cad_v1) and a sphere of radius r. It puts 0.75 mm spheres on a 1 mm grid with their centres inset by rs (clamped into the box shrunk by rs), leaves out the back face and the mount side, and gives each sphere K = E a / h with h = 8.5 mm everywhere. reorient_backends.replace_tips then gives every pad of a finger the median K (1,199.8 N/m at r 2.7) through one solimp d0 = 1 - 1/(tc^2 K Lambda).

Drake's reference for the same block is a compliant Convex. A pydrake 1.57 probe shows its volume mesh is a fan of 1,164 tetrahedra from the hull's volume centroid, with pressure E(1 - gauge). That equals E delta/8.5 mm on the palmar face, E delta/7.4 mm on the side faces, E delta/11.0 mm on the end face and about E delta/10.1 mm on 45 deg fillet facets. No repository code integrates this field for the block. A scratch integral (2 s per radius) reproduces Drake's bed onset arms within 3 % and its 1 rad/s spin arms within 8 % at r 0, 2.7 and 6 mm.

Geometry costs the pads accuracy in four measurable ways:
1. The fixed h makes the pads 25-37 % stiffer than Drake on the end face and 4-8 % softer on the side faces.
2. On fillets the sphere envelope is scalloped by (r - rs)(1 - cos(dtheta/2)): 37.5 um at r 2.7 and 20 um at r 6, against approaches of 35-113 um at 0.5-3 N. A plane at 45 deg on the 2.7 mm fillet touches no sphere until 37.5 um.
3. At a sharp edge the clamped side spheres double the edge row (+7.5 % static arm) and set the edge back by 311 um.
4. The median K ignores area shares of 0.94-1.11 mm^2.

None of these explains the bed's sliding-arm excess on the 2.7 mm block (4.55 against Drake's 3.59 mm at 1 N): the same pad lattice, integrated quasi-statically, gives 3.58 mm. A traced spin shows the excess grows with spin rate:
- The pad arm is 3.90, 4.24, 4.55 and 7.02 mm at 0.1, 0.3, 1 and 3 rad/s; Drake gives 3.50, 3.59 and 4.14 mm at 0.3, 1 and 3 rad/s.
- The normal force stays at 1.000 N and the tool neither drifts (at most 0.05 mm) nor tilts.
- Each sphere's normal force exceeds K x penetration by 3x near the spin axis and up to 87x at the ends of the contact line.
- The pad relaxation time changes it (4.40 mm at 0.01 s, 6.79 mm at 0.04 s); impratio from 10 to 10,000 does not.

The brake gap has a different cause. Drake's own 45 deg force is not converged in time step (0.452, 0.497 and 0.527 N at 2, 1 and 0.5 ms), and the pads' value does not change with relaxation time.

Finite elements disagree with every pressure law in a further way: approach errors of 20-28 %, a twist arm 3.5-23 % short and a coupling length of 2.9 mm. The CAD insert has 3.0 mm fillets and spherical corners, not the 2.7 mm of the default model.

A new shape end to end needs:
- a TipShape module (samples with curvature, hull and STL, insert-frame inside and surface functions for FE, volume centroid, a key);
- a pad builder with per-sphere h and K;
- a law integral with a tool-rotation angle;
- a shape key in the tpu_tip_rig specs and in replace_tips;
- an FE geometry hook.
Drake's Convex path works unchanged for any convex hull.

Entry points:

- Block geometry, pad sampler, hull and mesh files (one shape family: box Minkowski-sum sphere of radius r): /home/humanoid/Programs/hand/scripts/fingertip_geometry.py :: surface_samples(r, s, sign=1.0) -> (P, N, A) [l.62]; pad_mask(n, sign) [l.131]; pad_spheres(r, s, rs, sign=1.0, E=1e7) -> (centres, normals, areas, K) [l.138, K = E/FOUNDATION*a at l.150, clamp l.146-149]; hull_mesh(r, sign=1.0, res=0.0005) -> (V, F) [l.154]; mesh_paths(out_dir, r) -> {+1: obj, -1: obj} [l.190] (runtime: < 1 s for all radii on one core (scratch probe pad_counts.py)) Module globals DEPTH/WIDTH/LENGTH/CENTRE/HALF/FOUNDATION (l.34-42) are overwritten in-process by build_cad_v1_finger.cad_tip_geometry (l.629-648) and hand_object_scale_sim.cad_tip_block (l.152). Mesh files are keyed by r only.
- Fingertip replacement in real_v1 scenes (pads or one mesh) with load-time d0 calibration: /home/humanoid/Programs/hand/scripts/reorient_backends.py :: replace_tips(root, tip, model, MU, out_dir, tool=OBJ, s=0.001, rs=0.00075, tr=0.02, E=1e7, region=None, tool_only=False) -> (meshes, meta) [l.215]; build_scene(hand, tip, model, plant, numerics, ir, mu, out_dir, pad_s) [l.143]; DrakeBench(scene, meta, rt=0.01, E=1e7) [l.466, Convex at l.548] (runtime: scene build seconds; MuJoCo hand replay ~106 us per step, Drake ~2,082 us per step (plan note l.195)) tip_r() parses only 'tpu<r>' (l.89). Median K per finger (l.269); one d0 = 1 - 1/(tc^2 K diag) for all of that finger's pads (l.283-297); ValueError if d0 < 0.05. The distal capsule is trimmed to the block top using G.CENTRE/G.HALF (l.249-253).
- RL scene with the TPU tip (pads or mesh), modulus and friction flags: /home/humanoid/Programs/hand/scripts/make_pad_morphology_run.py :: build(src_xml, out_xml, tip, model, spacing, rs, region, mu=None, tool_only=True, E=RB.E_TPU) [l.47]; CLI: --src RUN --out RUN --tip tpu2.7 --model pads --E <Pa> --mu <mu> --region all|front (runtime: seconds) Pins compiled inertials before the tips change (the mass trap). front_region keeps the pads on the palmar half (l.37).
- CAD-faithful finger and hand (1,016 pads per tip): /home/humanoid/Programs/hand/scripts/build_cad_v1_finger.py :: cad_tip_geometry(A) [l.629] sets G to 17.0 x 14.8 x 21.41 mm and checks the CAD bounding box within 1e-5 m; write_scene(A, collision, out_dir, inert) [l.658] calls RB.replace_tips(root, 'tpu2.7', 'pads', PAD_MU, out_dir, tool=RB.OBJ) [l.700] (runtime: ) Hard-codes r 2.7 on a CAD part (assets/cad_v1/fingertip.stl) whose fillets are 3.0 mm. hand_object_scale_sim.cad_tip_block() [l.152] repeats the global override.
- Two-pad bed rig with the TPU block (MuJoCo pads or mesh; Drake compliant convex): /home/humanoid/Programs/hand/scripts/tpu_tip_rig.py :: parse(spec) [l.43]; tpu_xml(sp, d_cg, gravity, kinematic, pad_stiff) [l.77]; TpuMjRig [l.125, d0 l.133-141]; TpuDrakeRig [l.171, Convex l.200]; patch_of(rig) [l.245]; tpu_models(radii=(6.0, 2.7, 0.0)) [l.302]; static(models, Ns, dt_ms, out) [l.316]; bed(models, tasks, Ns, dts, out_dir) [l.352]; CLI: $PY scripts/tpu_tip_rig.py bed --tasks T1 T2 T5 --dt 1 5 (runtime: MuJoCo pads 1-2 s per case (wall_s_tip); Drake 0.4-11 s per case; pads 29-116 us and Drake 196-1,867 us per 1 ms step depending on r) Every rig build writes OBJ files into assets/mjcf/experimental/20261006-tpu_tip (MESH_DIR l.38) through G.mesh_paths. Parallel shape sweeps need separate keys or paths. Spec syntax: mj:spheres:s1:rs0.75:ir100:tr0.02:tpu<r>, drake:hydro:E1e7:r1:rt0.01:tpu<r>.
- Base rig and experiments (spin, brake), sphere-tip pad builder: /home/humanoid/Programs/hand/scripts/hom_contact_rig.py :: exp_torsion(spec, N, omega=1.0, T_spin=1.2) [l.586; torque averaged for t > 0.4 s, l.604]; exp_brake(spec, d_cg, N0, N1, T_hold, T_ramp, T_end) [l.631]; mj_xml [l.193; sphere-pad K with ((R-rs)/R)^2 at l.218]; DrakeRig [l.412]; make_rig [l.572] (runtime: spin case ~1 s (pads), ~1.4 s (Drake) on one core) The bed's 'sliding arm' is this driven spin at 1 rad/s, so the tool line turns 23-69 deg on the block during the averaging window.
- Bed model registry and tasks: /home/humanoid/Programs/hand/scripts/contact_bed_common.py :: MODELS dict [l.32]; new_rig(spec, dt) [l.93]; contact_bed_twist.run_case(name, N, dt, film); contact_bed_brake.run_case(model, dt_ms, film) [contact_bed_brake.py l.75]; contact_bed_pull.run_case(chain_spec, N, dt) (runtime: ) tpu_tip_rig.bed registers the TPU models into MODELS with setdefault.
- Pressure-law integral for the sphere tip (Drake field) on the cylinder and the square bar: /home/humanoid/Programs/hand/scripts/hydroelastic_arm_integral.py :: _forces(P, nrm, D, dA) [l.19]; patch(delta, n=1500) [l.40]; bar_patch(delta, a, n, full) [l.55]; solve(N, fn=patch) [l.81]; bar_law(N) [l.87] (runtime: seconds) Sphere only (p = E(1 - rho/R)). The sliding kinematics (slip velocity projected on each tangent plane, torque about the pinch axis) are the template for a general convex tip.
- Pads' Winkler law on the 2.7 mm block, and production-pad law checks: /home/humanoid/Programs/hand/scripts/pad_contact_rig.py :: continuum(approach, E) -> (N, torque per mu) [l.159]; continuum_approach(F, E) [l.168]; Rig(out, mass_scale, impratio, stale_scale, E) [l.57]; measure(out) [l.203] -> docs/experiments/20261013-contact_feedback/pad_laws.json (runtime: seconds) p = E/8.5 mm x radial overlap with the cylinder on 0.1 mm samples of tpu2.7. Torque is the static all-slip torque about the palmar normal. This is the pads' own law, not Drake's field.
- FE of the CAD insert (CPU, graded hex grid, CHOLMOD face compliance): /home/humanoid/Programs/hand/scripts/tpu_tip_fem_tip.py :: run_recipe(name, recipe, grid_name='coarse', forces=(0.25..4.0), out, data_dir) [l.573]; build(recipe, grid_name) [l.432]; classify(build, h_aux=0.05, stl=TIP_STL) [l.100]; TipModel.face_nodes [l.242]; gap0(model, nodes, indenter) [l.322]; law_force(nodes_A, g0, delta, E, h_f=8.5) [l.567]; resolved_voxels(recipe, h, shift, out, stl) [l.657] (runtime: 217,323 DOF; assembly 2.4-9.2 s, factor 8.9-14.7 s, 377-428 s per recipe for 15 load rows plus 3 tangential cycles (tip_runs_surf.jsonl); 3.7-4.4 GB, 4 cores) Geometry is read from TIP_STL = ~/Downloads/fingertip (3).stl (l.40); the repo copy is assets/cad_v1/fingertip.stl. Gaps assume the face top at X_FACE = 8.5 mm and the cylinder axis along y (psi = 0). Indenters: cyl, plate, sphere<R>.
- FE of the whole printed tip with magnet (analytic geometry hook): /home/humanoid/Programs/hand/scripts/tpu_tip_magnet.py :: run(name, recipe, magnet, depth, forces) [l.151]; build(recipe, magnet, depth) [l.86]; classes(...) [l.50] via tpu_tip_design.occupancy(h) [tpu_tip_design.py l.100] -> inside_body(x,y,z) [l.57]; gaps(model, nodes) via tpu_tip_design.surface_x(y,z) [l.47] (runtime: ~10 min per print (FE page Table 8); one process per run (11 GB seen with two models)) Shortest route for a parametric FE shape: replace TD.inside_body and TD.surface_x with the new shape's insert-frame functions. tpu_tip_design.py l.38 uses R_SIDE 2.7 and R_END 3.0 with square side-end edges.
- Resolved-voxel FE on the GPU and nonlinear check: /home/humanoid/Programs/hand/scripts/tpu_tip_fem_gpu.py :: .venv/bin/python scripts/tpu_tip_fem_gpu.py VOXELS.npz --indenter cyl --delta 0.02 0.05 0.1 --out rows.jsonl [--surface]; GpuTip(occ, origin, h, E, nu) [l.36]; gap0(X, indenter, z_c, y_c) [l.111] (runtime: 138 rows at 0.1 mm: 2.78-14.78 M DOF, solve median 84 s (21-298 s) per approach, 0.54-3.38 GB GPU (gpu_runs.jsonl)) Voxels come from tpu_tip_fem_tip.resolved_voxels(..., stl=) or tpu_tip_design.occupancy. Neo-Hookean in tpu_tip_fem_gpu_nl.py takes 38-48 min per approach.
- FE-to-pad calibration tables and print calibration: /home/humanoid/Programs/hand/scripts/tpu_tip_fem_analysis.py :: law_f(A, g0, delta) [l.37]; law_delta(A, g0, F, E) [l.41]; stiffness_map_law(name) [l.284]; edge_share(name, F) [l.320]; tpu_tip_calibrate.py fit --tip --indent --pull (runtime: seconds) EDGE_Y comment (l.317) says the face is 9.4 mm flat; the STL face is 8.8 mm.
- Scratch prototypes from this session (not in the repo): /tmp/claude-1001/-home-humanoid-Programs-hand/88ae0ebc-1769-4d06-9a8c-bed92903087d/scratchpad/probe/ :: block_law2.py <r_mm...> (Drake field E(1-gauge) on the hull facets about CENTRE, the Winkler h 8.5 law and the discrete pads, psi = 0/23/46/69 deg); drake_field.py and drake_centroid.py (Drake volume mesh and half-space pressures); kin_spin3.py <N> <omega> [spec] (per-sphere force over K x penetration in the driven spin); plane_press.py (region-wise plane indentation); brake_tr.py, brake_drake_dt.py (runtime: 1.8-8.2 s each on one core (taskset -c 4)) MESH_DIR is redirected to the scratchpad, so nothing is written into assets/. block_law2.py is the template for a repository law-integral module.

Facts:

- The modelled block is 17.0 mm deep, 14.8 mm wide and 22.0 mm long (21.41 mm on cad_v1), with its palmar face 10.55 mm from the finger axis, CENTRE (+2.05, 0, +0.45) mm and FOUNDATION = DEPTH/2 = 8.5 mm. It is the Minkowski sum of a box and a sphere of radius r, so every edge, including the back and mount edges, carries the same r. [scripts/fingertip_geometry.py:5-22, 34-42, 62-128]
- The sampler puts face samples at cell centres of round(L/s) cells per axis, places edges on round(pi r/(2s)) arc rows times an axial grid, and fills corners with round(pi r^2/(2s^2)) Fibonacci directions per octant, each sample carrying its true-surface area share. Pads skip samples with sign*n_x <= -0.5 (back) and n_z >= 0.5 (mount side). Centres are p - rs*n clamped into the box shrunk by rs, and K = E/8.5 mm x a for every surface point. [scripts/fingertip_geometry.py:45-151]
- Pad counts at s 1 mm and rs 0.75 mm, length 22.0 mm: 1,333 (r 0), 1,194 (1.5), 1,059 (2.7), 1,122 (3.0), 959 (4.0), 796 (6.0), 690 (7.4). At length 21.41 mm: 1,016 (r 2.7) and 1,077 (r 3.0). Area shares span 0.88-1.42 mm^2 (0.94-1.11 at r 2.7) and median K 1,176-1,230 N/m. The count is not monotone in r because of grid rounding. [scratch probe/pad_counts.py calling fingertip_geometry.pad_spheres]
- Only the median K is realised. replace_tips sets one solimp 'd0 d0 0.001 0.5 2' and solref (tr/2, 1) per finger with d0 = 1 - 1/(tc^2 K Lambda), where Lambda is body_invweight0(tip) + body_invweight0(tool), and raises ValueError below d0 0.05. On the bed rig Lambda = 90.74/kg gives d0 0.9082 at r 2.7 and 0.9063 at r 0 and 6. On the hand thumb Lambda = 77.34/kg gives d0 0.8922, and every touching pad measures 1,199.8 N/m at 0.5-3 N. [scripts/reorient_backends.py:265-297; docs/experiments/20261006-fingertip_backends/tip_static.jsonl (info); docs/experiments/20261013-contact_feedback/pad_laws.json]
- The sphere-tip pad builder scales K by ((R-rs)/R)^2 to account for the centres lying on the inner sphere (126 spheres on a 35 deg cap). The block builder applies no curvature correction on fillets or corners. [scripts/hom_contact_rig.py:208-219; scripts/fingertip_geometry.py:150]
- Drake models the block as a compliant Convex built from the hull of 0.5 mm samples (8 corners at r 0); the resolution hint has no effect for Convex. In pydrake 1.57 the r 2.7 volume mesh has 584 hull vertices plus one interior vertex at (2.05, 0, 0.45) mm and 1,164 tetrahedra. On an asymmetric hull the interior vertex is the volume centroid (6.8, 5.0, 4.375) mm, not the vertex mean (5.33, 5.0, 6.0) or the area-weighted surface centroid (7.57, 5.0, 4.10). The field is p = E(1 - max_k n_k.(x - c_V)/d_k). [scripts/tpu_tip_rig.py:195-200; scripts/reorient_backends.py:527-550; scratch probe/drake_field.py, drake_centroid.py]
- Half-space cuts of Drake's r 2.7 block measured 58,823.5 and 235,294.1 Pa at 50 and 200 um into the palmar face (exactly E delta/8.5 mm), 135,135 Pa at 100 um into a side face (E delta/7.4 mm) and 90,909 Pa into the end face (E delta/11.0 mm). A 45 deg palmar/side fillet cut peaked at 40.8 kPa at 50 um, against E delta/10.1 mm = 49.4 kPa; the hull's 13 um chord sag accounts for the rest. Drake's field is therefore radial depth about the volume centroid, not distance to the boundary over the inradius. [scratch probe/drake_field.py]
- Pressing a plane onto each region, the pads/Drake force ratio at 20/60 um was 0.97/1.03 on the palmar face, 0.92/0.96 on a side face and 1.25/1.37 on the end face. On a 45 deg r 2.7 fillet no sphere touches at 20 um and the ratio is 1.59 at 60 um. On an r 6 fillet it is 2.17/1.07. At a 45 deg sharp edge (r 0) no sphere touches up to 60 um, while Drake gives 0.076 N. [scratch probe/plane_press.py]
- The pad envelope dips between arc rows by (r - rs)(1 - cos(dtheta/2)): 37.5 um at r 2.7, 27.7 um at r 3.0 and 20.0 um at r 6. A sharp edge is set back by rs(sqrt2 - 1) = 311 um. Drake's 0.5 mm hull sags 13 um at r 2.7 and 5 um at r 6. The law-integral approach of the r 2.7 block is 35/55/113 um at 0.5/1/3 N. [derived from scripts/fingertip_geometry.py:97,107 sampling; scratch probe/block_law2.py]
- Three pressure-law integrals exist in code, none for Drake's convex field or a turned tool. hydroelastic_arm_integral is sphere-only (E(1 - rho/R), sliding friction projected on the tangent plane, about the pinch axis). pad_contact_rig.continuum is the pads' Winkler law (E/8.5 mm x radial overlap) on 0.1 mm samples of the r 2.7 block, with static torque about the palmar normal. The FE law_f and law_force apply the Winkler law on FE face nodes with overlap along x. [scripts/hydroelastic_arm_integral.py:19-89; scripts/pad_contact_rig.py:156-173; scripts/tpu_tip_fem_analysis.py:37-49; scripts/tpu_tip_fem_tip.py:567-570]
- The scratch Drake-field integral on r 2.7 gives an arm of 2.554 mm at psi = 0 and 1 N, against Drake's bed onset 2.496 mm, and 2.694 against 2.618 mm at 3 N. Its mean over psi 23/46/69 deg is 3.58/3.64/3.78 mm at 0.5/1/3 N, against Drake's bed spin arm of 3.44/3.59/3.84 mm. At r 6 and 1 N it gives 1.85 against 1.97 mm; at r 0, 5.11 against 5.18 mm. The discrete pads integrated quasi-statically give 3.51/3.58/3.84 mm on r 2.7, against the MuJoCo bed's 5.72/4.55/4.54 mm. [scratch probe/block_law2.py; docs/experiments/20261006-fingertip_backends/tip_T2.jsonl]
- The pads' spin arm on r 2.7 at 1 N is 3.90/4.24/4.55/7.02/6.90 mm at 0.1/0.3/1/3/5 rad/s; Drake's is 3.50/3.59/4.14/5.84 mm at 0.3/1/3/5 rad/s. At 1 rad/s the pad normal force is 1.000 N per side, tool drift is at most 0.05 mm, axis tilt is 0.000 deg and 12.1 pads per side are loaded. Per-sphere normal force over K x penetration is 3.3 (rho < 1 mm), 11.0 (3-4 mm), 30.9 (5-7 mm) and 86.7 (7-12 mm), and falls to 1.02-1.72 at 0.1 rad/s. Relaxation time 0.01/0.02/0.04 s gives 4.40/4.55/6.79 mm; impratio 10/100/10,000 gives 4.545/4.553/4.555 mm. The 10.55 mm sphere gives 0.963 mm with ratios 1.09-1.40, and r 6 gives 2.111 mm. [scratch probe/kin_spin.py, kin_spin2.py, kin_spin3.py, kin_drake.py on tpu_tip_rig specs]
- Drake's brake on r 2.7 reaches 45 deg at 0.452/0.497/0.527 N with steps of 2/1/0.5 ms, while its 10 deg force holds at 0.594-0.599 N. The pads reach 45 deg at 0.336/0.330/0.333 N with tr 0.02/0.01/0.0075 s (10 deg at 0.555/0.604/0.614 N). The recorded 0.338 against 0.500 N compares against an unconverged Drake step. [scratch probe/brake_tr.py, brake_drake_dt.py; docs/experiments/20261006-fingertip_backends/tip_T5.jsonl]
- Bed rows by geometry (pads/Drake at 1 ms). Onset arm at 1 and 3 N: r 6 1.273/1.257 and 1.459/1.519 mm; r 2.7 2.525/2.496 and 2.736/2.618 mm; sphere 0.924/0.987 and 1.193/1.275 mm. Spin arm at 0.5/1/3 N: r 6 1.79/2.11/2.28 against 1.79/1.97/2.30 mm; r 0 9.57/8.76/7.21 against 5.51/5.18/5.04 mm. Patch area at 0.5 N: r 6 15.0/10.6, r 2.7 18.4/18.8, r 0 17.0/23.8 mm^2. Translational creep at 1 N: r 6 14/0.3, r 2.7 10.8/1.2, r 0 8.4/1.7 um/s. Brake end angle: r 6 77.3/83.1, r 2.7 69.1/73.3, r 0 51.3/71.8 deg. [docs/experiments/20261006-fingertip_backends/tip_static.jsonl, tip_T1.jsonl, tip_T2.jsonl, tip_T5.jsonl; page 20261006-fingertip_contact_backends Tables 2-3]
- Bed cost per 1 ms step: pads 29-51 us (r 6), 45-75 us (r 2.7) and 70-116 us (r 0); Drake 914-1,867, 415-741 and 196-286 us. [docs/experiments/20261006-fingertip_backends/tip_T1.jsonl, tip_T2.jsonl, tip_T5.jsonl (us_per_step_median)]
- On the hand, pads and Drake reach the same held outcome on 94 % (r 6) and 92 % (r 2.7) of 72 paired seeds on the working plant, against 42 % for one mesh. On the servo plant the pads come within 3 deg of Drake on 16 of 24 placements. The misses are no-turn outcomes on D3 seeds 0-2 and D8 seed 1 (Drake turns 40-44 deg), overturns of 5.4-7.5 deg on D5 and -3.8 deg on D6 seed 1. [page 20261006-fingertip_contact_backends Table 6; docs/experiments/20261014-pad_usability/agree/findings_U2.json]
- Against FE, the best single pad modulus misses the approach by 20-28 % over 0.5-3 N (FE force exponent 1.06-1.16 against the law's 1.5), and the pads' twist arm is 3.5-23.1 % short. The FE puts 46 % of the load on the face edges against 23 % for the law (20 % gyroid). The g20_across FE arm is 2.89/2.93/3.12 mm at 0.5/1/3 N, with a 2.89 mm surface coupling length. [page 20261009-printed_tpu_fingertip_finite_elements Tables 5-6; docs/experiments/20261009-tpu_tip_fem/summary.json]
- Both CPU FE runs (graded grid, 217,323 DOF) are logged in tip_runs_surf.jsonl: assembly 2.4-9.2 s, CHOLMOD factor 8.9-14.7 s, 377-428 s per recipe. The GPU rows (gpu_runs.jsonl) number 138 at 0.1 mm voxels: 2.78-14.78 M DOF, solve median 84 s (21-298 s) per approach, 0.54-3.38 GB. [docs/experiments/20261009-tpu_tip_fem/tip_runs_surf.jsonl, gpu_runs.jsonl]
- The CAD insert (assets/cad_v1/fingertip.stl, identical to ~/Downloads/fingertip (3).stl; 6,524 faces, 4,822 mm^3) is rounded with r 3.0 mm on the palmar long edges, the palmar end edge and the side-end edges. Its corners are spherical (2,485 vertices at 3.0000 mm from (5.5, 4.4, 18.41) mm), the back and mount edges are square, and the flat palmar face is 8.8 x 18.41 mm. The default tpu2.7 (9.4 mm flat), cad_v1 (hard-coded 'tpu2.7') and tpu_tip_design (R_SIDE 2.7, R_END 3.0, square side-end edges) all differ from it. [scratch trimesh checks; scripts/build_cad_v1_finger.py:700; scripts/tpu_tip_design.py:38]
- The FE geometry hooks are fixed. The insert FE reads TIP_STL from ~/Downloads, and the whole-tip FE takes tpu_tip_design.occupancy/inside_body/surface_x. Both gap functions assume the face top at X_FACE = 8.5 mm and the cylinder axis along y (psi = 0). [scripts/tpu_tip_fem_tip.py:40, 100, 322-339; scripts/tpu_tip_magnet.py:50-112; scripts/tpu_tip_fem_gpu.py:111]
- On the 20 mm square-bar edge, the 1 mm pads give 2.02/1.55/1.04 times the law's force at the law's approach (0.5/1/3 N), against 0.97-0.99 for Drake. Each sphere near the edge takes its full area share. [page 20261007-newton_hydroelastic_friction_reduction_edge (text l.106); scripts/contact_bed_edge.py]
- Production pads against their Winkler law: approach +13.6/-1.4/-4.9/-4.2 % and torque -6.1/-2.5/-0.8/+1.1 % at 0.5/1/2/3 N, with 29-33 touching pads. [docs/experiments/20261013-contact_feedback/pad_laws.json]
- The pinch-and-swing MPC on cad_v1 swings the cylinder at a median peak of 306 deg/s (5.3 rad/s), a rate at which the pads' spin arm on r 2.7 is about 1.9 times their quasi-static arm. [page 20261014-scale_turn_cad_v1 (text l.65); scratch probe/kin_spin3.py]

Gaps:

- No repository code integrates Drake's convex field E(1 - gauge about the volume centroid) for the block, or any law with the tool turned by psi. The bed's 1 rad/s 'sliding arm' mixes the rotating contact line with the pads' rate effect.
- The mechanism of the pads' rate effect is unconfirmed. The probes show sliding spheres carrying 3-87 times K x penetration, independent of impratio and growing with tr; the MuJoCo elliptic-cone soft-contact term is the hypothesis, not checked against MuJoCo's source. Its hand-level consequences are untested: the U2 D3/D8 no-turn misses and pinch-and-swing at 306 deg/s.
- Drake as a reference on fillets: the 0.5 mm hull sags 13 um at r 2.7, a third of the 35 um approach at 0.5 N, and the brake's 45 deg force is not converged at 1 ms. Hull resolution and step convergence were never run on the block.
- The geometry of record is inconsistent. The CAD insert has r 3.0 mm with spherical corners, the default and cad_v1 use r 2.7, and tpu_tip_design uses 2.7/3.0 with square side-end edges. Lengths are 22.0 mm (real_v1) and 21.41 mm (CAD). The printed radius is still unmeasured (backends page Future work).
- The pad builder supports only the uniform-r Minkowski block. It has no per-sphere h (Drake's 7.4/8.5/11 mm by face), no per-sphere K (the median is used), no curvature correction on fillets, and no spacing control against scallop depth. Mesh files are keyed by r, and geometry lives in process-global module constants.
- FE covers only the CAD insert and the print-plan whole tip, at psi = 0 with a flat face top. There is no FE twist with a turned line and no bench measurement of any print (approach, mu, twist).
- The Winkler pads cannot represent the FE's coupled foundation (2.9 mm coupling length, force exponent 1.07 against 1.5). No experiment has measured whether that matters for a hand task.
- Shapes other than the block (crown, sphere cap, superellipsoid, cylinder) have no sampler, no STL writer within the 17.0 x 14.8 x 21.41 mm envelope and no Drake or FE path. Non-convex tips would need a Drake compliant Mesh (.vtk tetrahedra), which nothing builds.

Recommendations: Build the geometry loop as a cheap reference ladder, and run the expensive tiers only on finalists.

1. Fix the geometry of record first. Model the insert as built: r 3.0 mm on the palmar long, palmar end and side-end edges, spherical corners, 21.41 mm long, 1,077 pads. Otherwise confirm the printed radius with a gauge and print what the model says. Keep tpu2.7 only to reproduce old rows.

2. Write scripts/tip_shapes.py with a TipShape that has a key and parameters: per-edge fillet radii, crown radius across and along the face, sphere-cap radius, superellipse exponents, inside the 17.0 x 14.8 x 21.41 mm envelope. Methods: support(n), gauge(x), sdf(x), samples(s) -> (P, N, A, curvatures), hull(res), volume_centroid(), stl(), insert_inside(x, y, z), insert_surface_x(y, z). fingertip_geometry.surface_samples remains the uniform-r special case. Key mesh paths by shape key and write them through a temporary file, as pad_usability_backends does, so parallel builds do not race.

3. Write a second pad builder, pad_spheres(shape, s, rs, E, h='drake'|'fixed', curvature=True, max_scallop=1e-5):
- per-sphere h_i = n_i.(p_i - c_V), which follows Drake's field;
- curvature-corrected areas;
- arc spacing chosen per edge so the scallop stays under 10 um (about 0.5 mm on 2.7-3 mm fillets);
- one solimp d0_i per pad geom in replace_tips.
Report pads per tip and us per step, since cost scales with pads near the tool.

4. Law tier, seconds per design: move scratch/probe/block_law2.py into the repository as law_patch(shape, tool, delta, psi, field) and law_solve(shape, tool, N, psi, field). Record approach, the arm at psi 0 and 45 deg, patch area, and the plane press on the palmar, side and end faces and the 45 deg fillet. Drake's field needs no Drake run.

5. Pad tier, seconds per case: run the quasi-static discrete pads against the law, then MuJoCo bed T1/T2/T5 through tpu_tip_rig with a shape key. Run the spin at 0.1 and 1 rad/s so the geometric arm and the rate effect are reported separately.

6. Drake tier, 5-20 s per case: Convex(shape.hull(res 0.1-0.2 mm)) at 1 and 0.5 ms, on fillet presses and the brake.

7. FE tier, 3-5 finalists per print recipe: build through the tpu_tip_magnet path with the shape's insert functions (about 7 min per print on 4 cores) and one GPU voxel run (about 84 s per approach). Fit E* and record approach error, arm error and edge share.

8. Task tier, 3 finalists: servo-plant D1-D8 replays with pads and Drake paired (pad_usability_agree.py), pinned iCEM on cad_v1, and the D6 RL run via make_pad_morphology_run --E --mu. Score held fraction, turn, pad-Drake agreement and pads x us.

First candidates: r 3.0 (as built), r 4.5 and r 6 (796 pads, 29-51 us, spin arm +7 % over Drake, scallop 20 um, but half the onset arm, so the brake swings at 0.95 N against 0.34 N), a 20-40 mm crown across the face and a 10.55 mm sphere cap. Materials: 95A 20 %, 85A 50 % and 85A 30 % gyroid, with E* 13.0/14.4/6.3 MPa for the insert and 14.6/16.5/6.9 MPa for whole tips with a magnet.

Falsifiable next measurements:
(a) Spin arm at 0.03-3 rad/s with tr 0.0075/0.01/0.02 s on r 2.7, 3.0 and 6. The excess over the law should vanish below 0.1 rad/s; if it stays above 5 % at 0.03 rad/s, a geometric cause remains.
(b) 45 deg plane press with 0.5 mm pads on r 2.7. First contact should fall from 37.5 um to about 11 um.
(c) D3 servo-plant replays (seeds 0-2) with tr 0.01 s. If the no-turn misses take Drake's outcome, the U2 misses are the rate effect.
(d) Drake hull at res 0.1 mm on the fillet press. Force should rise toward the Winkler law scaled by 8.5/10.1.
(e) Drake brake at 0.25 ms. If the 45 deg force passes 0.55 N, report the pads' brake gap against the converged value.

### material_print

Print settings reach the simulation through one number, the pads' modulus E*. The finite-element (FE) scripts model four print choices: the TPU grade as an isotropic solid modulus E_s (30 MPa for 95A, 12 MPa for 85A; 95A datasheets span 26-67 MPa), gyroid density (5-50 %), build direction, and the magnet pocket. Walls (2 x 0.45 mm), skins (4 x 0.2 mm), layer height (0.2 mm) and bead width (0.45 mm) are module constants. The fastest proxy is the FE table: the insert's E* is 6.6, 13.0, 22.9 and 34.8 MPa at 10-40 % 95A gyroid, which fits E* = 98 MPa x infill^1.19, and inside the 0.5-3 N fit window E* scales as E_s^1.4. Full FE costs 4 min per tip on four CPU cores (homogenized core), 1-3 min per approach on the RTX 4070 Ti SUPER (0.1 mm voxels), and 9-20 min per tip solved from its G-code.

E* is a golden-section fit of the Winkler law p = E x overlap / 8.5 mm to the FE approach under the 12.5 mm shaft at 0.5, 1 and 3 N. One modulus misses the approach by 20-28 % because the FE force grows as approach^1.06-1.16 and the law's as approach^1.5; the modulus fitted at each force falls from 25.7 MPa at 0.25 N to 7.7 MPa at 4 N. The walls carry 46-66 % of the load on the face's edges against 23-30 % for the law, which shortens the pads' twist arm by 7-23 %, and the tip's shear compliance (24 and 53 um/N) is absent. The FE is uncertain by a factor of two: from its G-code the 95A 20 % magnet tip has E* 7.3 MPa and a 4.6 mm twist arm at 1 N, homogenized 14.6 MPa and 3.0 mm. An effective depth h adds no freedom, since h enters only as E/h. The stored FE data support two better calibrations, neither coded: a per-pad stiffness map that stiffens pads over the walls, and stiff pads on a normal series spring of the FE contact stiffness (15-45 N/mm). The calibration tools scale E* linearly with the bench E_s; a refit gives E_s^1.4, so a print half as stiff as modelled receives an E* 28 % too high.

The SR2 block prints face up without supports as one island per layer (21 min, 3.2 g); the press-fit pocket pauses before layer 62 at 12.4 mm. eFlesh lattices print soundly only at 8 mm cells on the 0.4 mm nozzle. Five-chip force noise is about 1.2 um over the magnet's travel per newton: a softer tip senses finer and sinks deeper.

Printable output exists for the SR2 block (STL, JSON sheet) and for eFlesh lattices of any closed shape (PrusaSlicer 3MF with the pause, 9-12 s); no tool writes a gyroid project with the pause, and the print/ STLs lie in the FE frame. Friction is unmeasured (scenes use 1.0), the servo is 79-278 times softer than the contact, and TPU damping is not modelled.

Entry points:

- Homogenize one periodic infill cell (gyroid as a slicer prints it, ideal sheet gyroid, eFlesh pattern-0646 cell) to its 6x6 elasticity tensor per unit E_s: /home/humanoid/Programs/hand/scripts/tpu_tip_fem_cells.py:131-188 (constants :33, slicer_cell :70-81); solver /home/humanoid/Programs/hand/scripts/tpu_tip_fem_core.py:208-263 :: ~/miniconda3/envs/femtip/bin/python scripts/tpu_tip_fem_cells.py slicer --rho 0.2 0.3 --h 0.1 --solver amg --out <rows.jsonl> (runtime: 1.4-148 s per cell on CPU, AMG-CG, 18k-873k DOF (docs/experiments/20261009-tpu_tip_fem/cells.jsonl t_* fields); about 1 GB per 200k DOF, 4 cores (FE page Table 8)) Bead 0.45 mm, layer 0.2 mm, line spacing 0.407 mm and DensityAdjust 2.44 are module constants, so wall/skin/nozzle/layer changes need code edits. Needs skimage and pyamg, which only the femtip env has. Default --solver is cholmod (:181); the stored rows used AMG.
- Insert FE with homogenized gyroid core, walls and skins: approach, twist arm, per-force Winkler-law modulus, tangential cycles, nodal pressure maps: /home/humanoid/Programs/hand/scripts/tpu_tip_fem_tip.py:573-634 (RECIPES :637-652, materials :417-429, law_force :567-570, classify :100-142) :: ~/miniconda3/envs/femtip/bin/python scripts/tpu_tip_fem_tip.py run --grid coarse --recipes g20_across s85_50_across --surface --out <rows.jsonl> --data <dir> (runtime: 353-428 s per recipe (217k DOF, CHOLMOD, 15 loads + 3 tangential cycles), 3.7-4.4 GB, 4 cores (tip_runs_surf.jsonl t_total_s; FE page Table 8)) Geometry is ~/Downloads/fingertip (3).stl (TIP_STL :40), outside the repo. WALL 2 x 0.45 mm, 4 skin layers fixed (:44). Writes E_law_fit_MPa per force (:596) and per-node p, X, A, g0, delta to <data>/<recipe>.npz.
- Whole printed tip (no mount slot) with an NdFeB magnet: best single pad modulus E*, magnet travel/rotation under normal and shear load, face shear compliance: /home/humanoid/Programs/hand/scripts/tpu_tip_magnet.py:151-211 (best_modulus :127-148, RECIPES :42-47) :: ~/miniconda3/envs/femtip/bin/python scripts/tpu_tip_magnet.py run --recipes w95_20 --magnets none d4.76x1.59@5 (runtime: 232-239 s per tip on CPU, 358k DOF (factor 19-22 s, compliance 204-208 s; magnet_runs.jsonl)) Docstring (:14) says .venv, which has no sksparse; run in femtip, one model per process (two models in one process reached 11 GB per memory note project_tpu_tip_fem_2026_10_10). Geometry from tpu_tip_design constants only.
- Resolved voxels of a printed tip (walls, skins, slicer gyroid beads) from the insert STL or any closed mesh in the insert frame: /home/humanoid/Programs/hand/scripts/tpu_tip_fem_tip.py:657-710, CLI :713-741 :: ~/miniconda3/envs/femtip/bin/python scripts/tpu_tip_fem_tip.py voxels --stl <closed mesh> --rho 0.2 --build x --h 0.1 --name <n> --outdir <dir> (runtime: not logged) --stl added 2026-10-14; needs skimage (femtip). Downstream contact assumes the palmar face at x = 8.5 mm and contact at z = 10.86 mm.
- Matrix-free GPU contact solve on voxels (hex8 incompatible modes, Jacobi PCG, active set), displacement controlled: /home/humanoid/Programs/hand/scripts/tpu_tip_fem_gpu.py:36-99 (GpuTip), :141-170 (contact), CLI :185-241 :: .venv/bin/python scripts/tpu_tip_fem_gpu.py <voxels.npz> --indenter cyl --delta 0.02 0.04 0.08 0.16 --out <rows.jsonl> (runtime: 61-160 s per approach for 5.9-8.1 M DOF gyroid tips at 1.3-1.7 GB GPU; solid 14.8 M DOF 48-215 s at 3.4 GB (gpu_runs.jsonl), RTX 4070 Ti SUPER) X_FACE, Z_C, R_TOOL constants (:31-33); --surface reads the insert's surface_x_h0.1.npz only (:124).
- As-printed tip from its PrusaSlicer G-code: beads rasterized at 0.025 mm, 0.1 mm voxels, GPU solve, E*, twist arm, magnet travel and field noise: /home/humanoid/Programs/hand/scripts/eflesh_tip_fem.py:119-207 (TIPS :41-51, PART :38, MAG :52, voxels :71-96, surface_gaps :99-106) :: .venv/bin/python scripts/eflesh_tip_fem.py --tips gyroid20 eflesh_top (runtime: 541-1224 s per tip at 4-7 approaches, 100-300 s and 16k-70k CG iterations per approach, 1.0-1.8 GB GPU (docs/experiments/20261013-eflesh_printability/fem.jsonl)) Pattern-agnostic solver, but TIPS paths, the SR2 part box, the analytic SR2 face and the 4.76 mm magnet at 5 mm are hard-coded; the magnet cavity is filled with TPU (bonded). Normal load only.
- Large-deformation (compressible Neo-Hookean) check with contact: /home/humanoid/Programs/hand/scripts/tpu_tip_fem_gpu_nl.py :: .venv/bin/python scripts/tpu_tip_fem_gpu_nl.py tip assets/fem/20261009-tpu_tip/voxels/g05x_s0.npz --indenter cyl --delta 0.1 0.2 0.29 (runtime: 38-48 min per approach, about 6 GB GPU, 5.9 M DOF (FE page Table 8; gpu_nl_runs.jsonl)) Needs --f64 on slender struts; the eFlesh lattice at 1.0 mm did not converge (about 7 GPU hours lost, memory note).
- SR2 whole-tip STL with a press-fit magnet pocket, and the print sheet with the pause layer: /home/humanoid/Programs/hand/scripts/tpu_tip_design.py:141-163 (mesh), :115-138 (print_sheet), :63-87 (recess, pocket), CLI :180-194 :: .venv/bin/python scripts/tpu_tip_design.py stl --magnet d4.76x1.59 --depth 5 --out <file>.stl ; .venv/bin/python scripts/tpu_tip_design.py sheet --magnet d4.76x1.59 --depth 5 (runtime: under 1 s) Geometry constants :36-44 (17 x 14.8 x 21.41 mm, fillets 2.7 side / 3.0 end); STL is in the FE frame (palmar +x, mount face at z = 0), not print orientation. Docstring example at :25 (--magnet 4.76 1.59) fails the argparse choices at :183.
- All plan print files: STLs for 5 geometries + four-magnet tip, JSON sheets with slicer settings and model E*, README: /home/humanoid/Programs/hand/scripts/tpu_tip_print_plan.py:117-206 :: .venv/bin/python scripts/tpu_tip_print_plan.py stl (runtime: seconds) Writes docs/experiments/20261009-tpu_tip_fem/print/; reads magnet_runs.jsonl and 20261013-magnet_layouts/fem.jsonl; slicer settings are text only; POCKET_DATE '20261013' hard-coded (:102).
- eFlesh lattice part from any closed shape to a sliced PrusaSlicer 3MF with magnet pouches and an M601 pause, plus a printability audit: /home/humanoid/Programs/hand/scripts/eflesh_build.py:210-304 (pouch :115-133, write_3mf :153-186, slice_check :189-207) :: ~/miniconda3/envs/femtip/bin/python scripts/eflesh_build.py --shape sr2tip --cell 8 --E 0.0035 --magnet 4.76,1.59,c,c,5 --base 1.6 --name <name> (runtime: 8.6-11.6 s including the stitch tool (5-7 s) and the PrusaSlicer slice (build/*.json)) Input: an STL/OBJ in print orientation or sr2tip; always builds a lattice with perimeters 2, fill 0 % (:285-286). Needs ~/wxie_workspace/eFlesh stitch_cells_cli, the template ~/wxie_workspace/fingers/merged_finger_v17.3mf and flatpak PrusaSlicer 2.9.2. Output names prefixed 20261013- (:288, :303). The four build/ 3MFs predate the press-fit pouch.
- Gyroid tip G-code (one-off shell, no tool): /home/humanoid/Programs/hand/logs/20261013-eflesh_slice/slice_gyroid.sh :: flatpak run --command=prusa-slicer com.prusa3d.PrusaSlicer --load v17.ini --perimeters 2 --fill-density 20% --fill-pattern gyroid --top-solid-layers 4 --bottom-solid-layers 4 --no-support-material --no-wipe-tower --center 180,180 --export-gcode -o <tip>.gcode <face-up>.stl (runtime: seconds) No M601 in the output (grep count 0); input STL must be rotated face up first (tip_gyroid_d5.stl, bounds 21.41 x 14.8 x 17.0 mm, sliced before the press-fit pockets).
- G-code audit: islands, retractions, supported area, islands under half supported, print time: /home/humanoid/Programs/hand/scripts/gcode_audit.py:25-93; /home/humanoid/Programs/hand/scripts/eflesh_printability.py:73-102 :: ~/miniconda3/envs/femtip/bin/python scripts/eflesh_printability.py audit --only tip_gyroid20 (runtime: not logged) FILES list hard-coded (:38-50); geometric support only (no cooling, stringing or bond strength).
- Bench calibration of a print to E_s, E*, friction and twist arm, and the scene command: /home/humanoid/Programs/hand/scripts/tpu_tip_calibrate.py:65-108 :: .venv/bin/python scripts/tpu_tip_calibrate.py fit --tip w95_20 --magnet d4.76x1.59@5 --indent 0.5:<um> 1:<um> 3:<um> --pull <N>:<F> --twist <N>:<Nmm> --save (runtime: under 1 s) E_s from the approach ratio (:84), E* scaled linearly with E_s (:94), mu = F/2N (:97), arm = T/(2 mu N) (:101); only the 4 recipes of magnet_runs.jsonl.
- Pad scene at a fitted modulus and friction: /home/humanoid/Programs/hand/scripts/make_pad_morphology_run.py:85-95; /home/humanoid/Programs/hand/scripts/reorient_backends.py:215-300; /home/humanoid/Programs/hand/scripts/fingertip_geometry.py:138-151 :: uv run --extra rl python scripts/make_pad_morphology_run.py --src results/phase1/real_v1/20261011-sv1_u0308_b050_servo_tip --out results/phase1/real_v1/<run>_tpu2.7pads1_E<x> --model pads --E <Pa> --mu <mu> (runtime: seconds) K_s = E/h A_s with h = 8.5 mm, but one median K per finger and a constant solimp; geometry limited to the rounded block with fixed dims and variable fillet r. No scene in results/phase1/real_v1 uses a fitted E yet.
- Magnet layouts and readout bounds on the five-chip board: /home/humanoid/Programs/hand/scripts/tpu_tip_magnet_layouts.py; /home/humanoid/Programs/hand/scripts/tpu_tip_magnet_sensing.py; /home/humanoid/Programs/hand/scripts/mlx90393_model.py; field model /home/humanoid/Programs/hand/scripts/tpu_tip_print_plan.py:56-80 :: ~/miniconda3/envs/femtip/bin/python scripts/tpu_tip_magnet_layouts.py run --layout four_d4.76x1.59_d5 (runtime: 117-121 s per layout, 259k DOF (docs/experiments/20261013-magnet_layouts/fem.jsonl)) Point dipole + datasheet noise (141 Hz, GAIN_SEL 7); Cramer-Rao bounds with contact position and Earth's field unknown.
- In-page calculator (print plan, field, calibration; STL and sheet download): /home/humanoid/Programs/hand/scripts/tpu_tip_widget.py:84-525 (JS; fitBench :195-211, tipTriangles :245-279), check :603-641 :: ~/miniconda3/envs/femtip/bin/python scripts/tpu_tip_widget.py check (runtime: headless Chrome, under 2 min timeout) Lookup of the 20 magnet_runs rows with depth interpolation and a linear E_s slider (:205-206); downloads work only from the local HTML file.

Facts:

- scripts/tpu_tip_fem.py does not exist; the FE is split over tpu_tip_fem_core.py (element, assembly, homogenization), tpu_tip_fem_cells.py (cells), tpu_tip_fem_tip.py (insert, grids, recipes, voxels), tpu_tip_fem_gpu.py and tpu_tip_fem_gpu_nl.py (GPU linear and Neo-Hookean), tpu_tip_fem_analysis.py (tables). [ls /home/humanoid/Programs/hand/scripts (2026-10-14)]
- Modelled print parameters: TPU grade only as isotropic E_s (30 MPa 95A, 12 MPa 85A NinjaFlex ASTM D638, nu 0.45 assumed); gyroid density via a slicer-style cell (bead 0.45 mm, layer 0.2 mm, line spacing 0.407 mm, DensityAdjust 2.44); build direction x (layers across load) or z (along); walls fixed at 2 x 0.45 mm and skins at 4 x 0.2 mm. Layer height and nozzle are not stiffness parameters; the widget's layer-height selector changes only the pocket and pause. [scripts/tpu_tip_fem_cells.py:33-43; scripts/tpu_tip_fem_tip.py:44, 417-429, 637-652; scripts/tpu_tip_magnet.py:42-47; scripts/tpu_tip_widget.py:542]
- 95A datasheets give 26 (NinjaTek Cheetah), 33.6 (Polymaker PolyFlex) and 67 MPa (UltiMaker), a factor of 2.6; the model takes 30 MPa. The print settings of the owner's current tips are not recorded. [FE page Terms and Limitations, docs/experiments/20261009-tpu_tip_fem/20261009-printed_tpu_fingertip_finite_elements.html]
- Cell-level power laws over 11-42 % solid (0.1 mm voxels): printed gyroid E_x/E_s = 0.43 rho^1.41 in the layer plane, E_z/E_s = 0.60 rho^1.29 along the build direction; ideal sheet gyroid 0.50 rho^1.25. 20 % infill prints 21.3 % solid with E_x 0.039 E_s and E_z 0.076 E_s; printed solid fraction is 4-12 % above the requested density. [docs/experiments/20261009-tpu_tip_fem/cells.jsonl, fit as in scripts/tpu_tip_fem_page.py:316-326; FE page Table 4]
- Insert E* (homogenized core, layers across, surface gaps): 95A 10/20/30/40 % = 6.6/13.0/22.9/34.8 MPa, 95A solid 159.5; 85A 30 % 6.3, 50 % 14.4, solid 47.5; resolved 95A 5 % 3.4. Layers along: 95A 20 % 11.1, 85A 30 % 5.5, 85A 50 % 13.0. Contact stiffness at 1 N 14.7-45.1 N/mm for the gyroid inserts. [docs/experiments/20261009-tpu_tip_fem/tip_runs_surf.jsonl; FE page Tables 5 and 6]
- Derived fit (this report): insert E* = 97.7 MPa x infill^1.193 for 95A layers across at 10-40 %. Between grades at equal infill E* scales as E_s^1.41 (85A/95A at 30 %: 6.3/22.9) and E_s^1.32 for solid (47.5/159.5), because the law modulus fitted at fixed forces scales as E_s^(1.5/n) with n the FE force exponent. Predicted 85A 30 %: 6.4 MPa (FE 6.3); 85A 50 %: 11.9 (FE 14.4, outside the fit range). [fit on tip_runs_surf.jsonl rows and FE page Table 5]
- Whole tips (no mount slot) E*: 95A 20 % 12.7 MPa without magnet, 14.6 with a 4.76 x 1.59 mm magnet 5 mm deep; 85A 50 % 16.5; 85A 30 % 6.9; 95A 10 % 7.2. Magnet at 1.5/3/5 mm raises the 95A 20 % E* by 99/31/15 %. Four 4.76 mm magnets: 18.5 vs 16.5 MPa on the coarser layout grid (+12 %). [docs/experiments/20261009-tpu_tip_fem/magnet_runs.jsonl; docs/experiments/20261013-magnet_layouts/fem.jsonl; readout page Table 5]
- As-printed 95A 20 % tip from its G-code: 63 um at 1 N (33/63/170 um at 0.5/1/3 N), E* 7.34 MPa (approach error 24 %), magnet 27.1 um/N, twist arm 4.50/4.60/4.78 mm at 0.5/1/3 N. The homogenized whole tip with NdFeB magnet: 41.4 um, E* 14.57, 12.2 um/N, arm 3.01/3.04/3.20 mm. The as-printed run fills the magnet cavity with TPU. The as-printed arm appears on no page. [docs/experiments/20261013-eflesh_printability/fem.jsonl (tip gyroid20); magnet_runs.jsonl (w95_20, d4.76x1.59, 5.0); scripts/eflesh_tip_fem.py:84-92]
- Twist arm of the same 95A 20 % tip across FE representations: 2.93 mm at 1 N with STL-surface gaps vs 3.27 mm with grid gaps (insert); 3.62 mm at 1 N on the layout grid; 3.35 mm at 3 N for the resolved whole tip film; 4.60 mm at 1 N from G-code. The stored pressure maps data/<recipe>.npz come from the grid-gap run (approach 41.4 um at 1 N). [tip_runs.jsonl and tip_runs_surf.jsonl (g20_across cyl 1 N); 20261013-magnet_layouts/fem.jsonl (layout none); FE page section 'Twist arm and the load on the walls'; data/g20_across.npz timestamp 2026-10-09 15:19]
- E* fit: golden-section search on ln E over 0.3-300 MPa minimizing the RMS log error of the law's approach against the FE approach at 0.5, 1 and 3 N under the R 12.5 mm cylinder at z_c 10.86 mm; the law p = E x overlap / h_f (h_f 8.5 mm) is integrated on the FE face nodes with tributary areas and analytic-surface gaps. Worst approach error 20-28 % for every print loaded to 3 N. [scripts/tpu_tip_magnet.py:127-148, 186-189; scripts/tpu_tip_fem_tip.py:291-302, 567-570; FE page Table 5]
- FE force exponents 1.06-1.16 against the law's 1.5 under a cylinder; contact width exponents 0.39-0.64 against 1/3. The per-force law modulus of the 95A 20 % insert is 25.7/18.8/13.7/10.2/8.65/7.74 MPa at 0.25/0.5/1/2/3/4 N (about F^-0.43). [tip_runs_surf.jsonl E_law_fit_MPa (written at scripts/tpu_tip_fem_tip.py:596); FE page Table 5]
- Edge loading: 46 % (20 %), 58 % (10 %) and 25 % (solid) of the insert's force lies on the outer 0.9 mm of the flat face and the fillets vs 23 % for the law; on the whole tip 53 % (20 %) and 66 % (5 %) on the outer 1.2 mm vs 30 %. The pads' arm at 3 N is 7-23 % shorter than the FE arm; 85A 50 % is closest (-3.5 % insert, -7 % whole tip). The pads reach the insert's arm only at 2.5 MPa. [FE page sections 'Twist arm and the load on the walls', Tables 1 and 6]
- Pads in scenes: K_s = E/h A_s with h = FOUNDATION = 8.5 mm, so h enters only through E/h; replace_tips gives all pads of a finger the median K and a constant impedance (solimp d0 d0 0.001 0.5 2, solref 0.01 s, dampratio 1); default E_TPU 10 MPa; the rig measures 1,199.8 N/m per pad at every load. [scripts/fingertip_geometry.py:42, 138-151; scripts/reorient_backends.py:74-75, 265-297; 20261013-contact_parameter_sensitivity page Table 1]
- The 1 mm pads follow the continuous law within +13.6 % in approach at 0.5 N and -1.4 to -4.9 % at 1-3 N, and within 6 % in twist limit; this adds to the law-vs-FE error. [20261013-contact_parameter_sensitivity page Table 1]
- Normal compliance of the 95A 20 % whole tip (no magnet) under a Gaussian patch of sigma 0.6 mm is 87-90 um/N at the sampled load points (memory: 87-95 over 15 points), against 38.5 um/N under the shaft at 1 N: load spreads over millimetres of core, which no local per-pad law reproduces for both indenters. [docs/experiments/20261013-magnet_layouts/fem.jsonl (layout none, patches); memory project_tip_deformation_budget_2026_10_13.md]
- Tangential compliance at the contact (1 N contact sticking): 95A 20 % with magnet 23.8 um/N along the finger, 53.3 across; 85A 30 % 48/104 um/N. The pads' fingertip is rigid tangentially. [magnet_runs.jsonl shear_z_face_um_per_N, shear_y_face_um_per_N; FE page Table 3]
- Existing compliance add-ons: the sprung skin mounts pads on a 2 g body with two tangential slides and a hinge about the normal (no normal slide), costs 1.15x CPU and 1.3x GPU per step; a Pasternak lattice prototype (normal slides coupled by tendons) cost 14x per GPU world-step, gave effective mu 0.51 and onset arm 0.29 of the law, and was unstable at a 2 mm coupling length at 1 ms, so it was dropped. [scripts/native_compliance_page.py:320-321, 393-399; 20261012-sprung_skin_presliding page summary; 20261007-native_presliding_compliance page]
- MuJoCo 3.6.0 compiles solimp with dmin > dmax (checked with a one-sphere model), so a penetration-dependent per-pad stiffness is expressible; a per-pad softening law fitted to the cylinder (p ~ u^0.57 to give F ~ approach^1.07) would misfit the flat-plate case, where both FE and law are near linear. [this report's compile check in .venv; derivation from the line-contact Winkler integral]
- Calibration scaling: tpu_tip_calibrate.py estimates E_s = E0 x approach_FE(F)/approach_measured and sets E* = E_best x E_s/E0; the widget does the same. Refitting the law to the FE curve scaled by k = E_s/E0 gives E* = 0.78x the linear value at k = 0.5 and 1.33x at k = 2 (within 2.5 % of k^1.4 E_best); the approach-ratio estimate of k = 0.5 reads 0.52-0.54. [scripts/tpu_tip_calibrate.py:84, 94; scripts/tpu_tip_widget.py:205-206; reimplementation of tpu_tip_magnet.best_modulus on data/g20_across.npz with tip_runs_surf.jsonl approaches]
- FE cost on the workstation (RTX 4070 Ti SUPER, 20 cores): cell 1.5-148 s CPU; insert homogenized 217k DOF about 6-7 min per recipe (15 loads, 3 cycles), 3.7-4.4 GB, 4 cores; whole tip 358k DOF 232-239 s; resolved 0.1 mm voxels 5-8 M DOF 60-160 s per approach, 1.3-1.7 GB GPU; G-code 541-1224 s per tip; Neo-Hookean 38-48 min per approach, 6 GB GPU; a 0.05 mm resolved tip (~18 M elements, ~25 GB) needs a larger GPU. [FE page Table 8; cells.jsonl; tip_runs_surf.jsonl; magnet_runs.jsonl; gpu_runs.jsonl; 20261013-eflesh_printability/fem.jsonl]
- Environments: ~/miniconda3/envs/femtip has sksparse (CHOLMOD), pyamg, skimage, trimesh and manifold3d but no torch or mujoco; .venv has torch, mujoco and trimesh but no sksparse, pyamg, skimage or manifold3d. CPU FE, voxel generation and eflesh_build run in femtip; GPU FE in .venv. [import check of both interpreters, 2026-10-14]
- Model checks: solid insert under a 40 mm sphere 21.90 um vs Hertz 21.50 (+1.9 %); resolved vs homogenized 20 % tip -2.7 %; plate stiffness depends on discretization (680/845 N/mm hex vs 561-574 tetrahedra), so the fit uses the cylinder; Neo-Hookean force -6 % at 200 um and -11 % at 350 um on the 5 % tip; the plan tips stay under 130 um at 3 N. [FE page Table 7 and Limitations]
- Other modelled effects on stiffness: orientation (layers along vs across) softens the 20 % tip by 12-13 %, 7 % at 50 %, 0 % at 10 %; gyroid position under the contact changes the approach 1.7 % at 20 % and 7 % at 5 % (5 % tip arm 2.92-4.03 mm); the 20 % gyroid period is 5.2 mm, 21 mm at 5 %. [FE page Table 6 and text; tpu_tip_fem_cells.slicer_period :41-43]
- Print plan geometry: whole block 17 x 14.8 x 21.41 mm, fillets r 2.7 mm (side) and 3.0 mm (end), back square, printed back face on the bed, palmar face up, 2 walls of 0.45 mm, 4 top and 4 bottom layers, gyroid, no supports. Press-fit pocket for the 4.76 x 1.59 mm N52 magnet at 5 mm: 4.284 mm diameter (90 %), 9 layers from 10.4 to 12.2 mm print height, 0.21 mm of air above the magnet, pause before layer 62 at 12.4 mm; magnet top 5.01 mm deep as printed. [scripts/tpu_tip_design.py:36-44, 63-87, 115-138; output of 'tpu_tip_design.py sheet --magnet d4.76x1.59 --depth 5'; docs/experiments/20261009-tpu_tip_fem/print/README.md]
- The print/ STLs are in the FE frame (bounds x -8.5..8.5, y -7.4..7.4, z 0..21.41 mm: mount face at z = 0); loaded as is they would print layers along the load with the pause height wrong. The G-code solved as printed came from a rotated copy, logs/20261013-eflesh_slice/tip_gyroid_d5.stl (bounds 21.41 x 14.8 x 17.0 mm). [trimesh bounds of docs/experiments/20261009-tpu_tip_fem/print/20261013-sr2_tip_d4p76x1p59_depth5.stl and logs/20261013-eflesh_slice/tip_gyroid_d5.stl]
- Slicer profile behind the as-printed solve: Prusa XL 5T IS 0.4 nozzle, 0.20mm STRUCTURAL, Generic FLEX @XL at 230 C, bed 50 C, extrusion multiplier 1.08, max volumetric speed 2 mm3/s, fan 30 %, filament retraction 2.5 mm, Arachne perimeters with 85 % minimum bead width (0.34 mm), infill overlap 15 %; 3.16 g of filament at 20 %, 2.65 g at 10 %; no M601 in the file. [logs/20261013-eflesh_slice/tip_gyroid20_d5.gcode header; logs/20261013-eflesh_slice/slice_gyroid.sh]
- Printability: the gyroid tip prints 1 island per layer with 2 (20 %) or 3 (10 %) retractions, 80/83 % supported area, 1.2 % of islands under half supported, 21/19 min. The owner's v17 eFlesh finger: 60 islands and 49 retractions per layer, 5.2 %, 3.0 h. eFlesh cube islands under half supported: 3.3/27.5/70.8 % at 8/6/4 mm cells on the 0.4 mm nozzle; 3.2/17.2 % at 6/4 mm with a 0.25 mm nozzle and 0.1 mm layers (2.0-2.1 h per cube vs 45-51 min). TPU through a 0.25 mm nozzle is untested. [eFlesh page Table 2 (docs/experiments/20261013-eflesh_printability/audit.jsonl)]
- Minimum features: Arachne prints 0.34 mm at the least on the 0.4 mm nozzle; eFlesh's notebook calls struts under 0.4 mm unprintable. eFlesh struts at E 0.0035 are 0.125/0.086/0.112/0.150 x cell (1.0/0.68/0.89/1.2 mm at 8 mm cells, 0.34 mm minimum at 4 mm cells). Four 4.76 mm pockets on the 6 mm grid leave 1.7 mm of TPU between pockets, less than two 2-perimeter walls (1.8 mm). [docs/experiments/20261013-eflesh_printability/strut_map.json; eFlesh page Terms; readout page 'One magnet or four']
- The four eFlesh 3MFs in build/ use the earlier clearance cavity (10.36-12.05 mm, radius 2.53 mm) with the pause at 12.2 mm (layer 61), so their lip prints onto the magnet, the failure the owner reported; eflesh_build.py now cuts 90 % press-fit pouches with air above the magnet. [docs/experiments/20261013-eflesh_printability/build/*.json; scripts/eflesh_build.py:115-133; eFlesh page 'One-command build']
- Sensing rule (derived): five-chip force noise x magnet travel is about 1.2 um (gyroid as printed 0.044 N x 27.1 um/N; earlier model 0.098 x 12.2; 95A 10 % 0.057 x 21; open eFlesh 0.005 x 250), about 1.6 um for U1 alone; chips against the back face, magnet 5 mm deep, Earth's field fitted. [readout page Table 3, docs/experiments/20261013-magnet_layouts/20261013-mlx90393_fingertip_readout.html]
- Sensing constraints: sensing spot 0.42 mm under the package top; the v17 plate's 2.5 mm of TPU (gap 2.92 mm) doubles noise (0.044 to 0.090 N); field at U1 4.16 mT with the magnet 5 mm deep vs the 4.8 mT guaranteed at GAIN_SEL 7, so deeper or more magnets need a lower gain without datasheet noise (four magnets: 10.6 mT, GAIN_SEL 3, 0.14-0.16 N over 15 points); gyroid disturbances as printed: drift 0.47 N per 10 C, facing magnet 5.16 N (2.01 N with a gradient fit); eFlesh firmware setting gives one count = 0.13 N on the gyroid tip. [readout page Tables 1-4 and text; memory project_mlx_readout_2026_10_13.md]
- Depth trade on the 95A 20 % tip: magnet at 1.5/3/5 mm gives E* +99/+31/+15 % and force noise 0.23/0.21/0.16 N (one chip 1 mm behind) or 0.14/0.12/0.098 N (five-chip board, earlier model). [FE page Table 2; readout page Table 2]
- Friction: scenes use mu 1.0 on the pads (the pads' contact priority makes the tool's 2.4 unused); replays of 177 bench runs fit friction near 1 better than 2.4 by about 1 degree of joint error; closed-loop policies keep 376/384 rollouts at mu x0.5 against 292/384 replayed open loop; the trainer randomizes friction x0.55-1.15; no pull test of a print exists. [20261013-contact_parameter_sensitivity page; 20261006-servo_refit_hom_turn_pad_cost page (text line 76 of the extract); scripts/tpu_tip_calibrate.py:97]
- Stiffness for control: at kp 0.72 N m/rad the fingertip is a 250 N/m spring along its palmar normal; the pad contact's tangent stiffness at 1 N is 19.7-69.4 kN/m for E 5-20 MPa (79-278x), and the twist arm at 1 N moves from 2.66 to 2.39 mm; open-loop replays on other tip models keep 1,527/1,536 rollouts against 1,531 closed loop. [20261013-contact_parameter_sensitivity page Table 4 and section 'Closed-loop and open-loop transfer']
- Damping: TPU rate dependence is not modelled (FE gap table, closing measurement 'indent at two speeds, hold 10 s'); the pads' damping is MuJoCo's solref time constant 0.01 s with dampratio 1, which with impratio sets the creep (0.075 mm/s at impratio 10, 1 N, half the slip force). [scripts/tpu_tip_print_plan.py:587; scripts/reorient_backends.py:285, 296; 20261013-contact_parameter_sensitivity page Table 2]
- Stale memory values: project_eflesh_printability_2026_10_13.md gives force noise 0.146/0.015/0.017/0.044/0.149 N (before the 2026-10-13 noise correction), the eFlesh page now 0.073/0.008/0.009/0.022/0.075 N; project_tpu_tip_fem_2026_10_10.md gives 0.32/0.38/0.20/0.19 N and a pause at 12.2 mm (layer 61), the FE page now 0.16/0.19/0.10/0.09 N and 12.4 mm (layer 62). [memory files vs eFlesh page Table 3 and FE page Table 1]

Gaps:

- No printed tip has been measured: E_s, friction, rate dependence and damping are datasheet values or guesses, and the owner's filament brand/grade and the print settings of the current tips are not recorded.
- The FE spread is unresolved: E* 7.3 MPa (G-code) vs 14.6 MPa (homogenized) for the 95A 20 % magnet tip, and a twist arm of 2.9-4.8 mm at 1-3 N across surface representations; only the bench indentation and twist tests decide. The G-code arm (4.5-4.8 mm) is on no page.
- Wall count, skin layers, layer height, nozzle size, extrusion multiplier, temperature and infill patterns other than gyroid are not swept in any stiffness model; they are module constants (tpu_tip_fem_cells.py:33, tpu_tip_fem_tip.py:44). Only the G-code route could take another pattern.
- Every FE, print and pad tool assumes the SR2 block: tpu_tip_design.py constants (:36-44), fingertip_geometry.py dims (:34-42), eflesh_tip_fem.py PART/MAG/surface_gaps (:38, :52, :99-106), tpu_tip_fem_gpu.py X_FACE/Z_C/SURFACE (:31-33, :124), tpu_tip_fem_tip.surface_x reading the insert STL (:313). A new geometry needs these generalized; pads for an arbitrary mesh do not exist.
- No tool writes a gyroid-tip PrusaSlicer project or G-code with the M601 pause; eflesh_build.py writes only lattice parts. The print/ STLs are in the FE frame, not print orientation.
- The calibration tools scale E* linearly with E_s (tpu_tip_calibrate.py:94, tpu_tip_widget.py:206); a refit scales as E_s^1.4, a 22-33 % error for a factor-2 change. The approach-ratio E_s estimate is 4-7 % biased.
- No per-pad stiffness map, normal series spring, or operating-force E* selection is implemented; the stored pressure maps (data/<recipe>.npz) are from grid-gap runs whose arm is 0.3 mm longer than the surface-gap runs.
- The as-printed model joins beads as one solid (an upper bound on stiffness), treats the magnet as TPU, and solves normal load only; interlayer bond, top-skin sag over sparse gyroid, stringing and cooling are not modelled; 0.25 mm nozzle TPU printing is untested.
- MLX90393 noise below GAIN_SEL 7 is not in the datasheet; magnets deeper than 5 mm need the layout grid refined below x = 1 mm.
- Large deformation was solved only for the 5 % tip; the eFlesh Neo-Hookean solve did not converge.
- Documentation mismatches: tpu_tip_design.py:25 example fails argparse (:183); tpu_tip_magnet.py:14 names .venv, which lacks sksparse; eflesh_build.py hard-codes the 20261013- prefix (:288, :303) and tpu_tip_print_plan.py POCKET_DATE (:102); two memory notes carry pre-correction noise values and the old pause layer.
- The eFlesh 3MFs in docs/experiments/20261013-eflesh_printability/build/ predate the press-fit pouch and print a lip onto the magnet.

Recommendations: A process for co-optimizing tip geometry, print settings and the pad model, using what exists: (1) Make the shape a parameter. Generalize tpu_tip_design.mesh/print_sheet (constants at scripts/tpu_tip_design.py:36-44) to depth, width, length, fillet radii and face crown; export the STL rotated face up (back face on the bed); write a PrusaSlicer 3MF with walls, skins, gyroid density and the M601 pause by reusing eflesh_build.write_3mf and slice_check (scripts/eflesh_build.py:153-207) with the part's own settings in place of the lattice settings at :285-286; audit islands and support with eflesh_printability.audit. Each candidate then costs about 10 s to slice and check. (2) Screen stiffness with the table fit E* = 98 MPa x infill^1.19 x (E_s / 30 MPa)^1.4 (10-40 %, layers across) and confirm finalists with the G-code solve (scripts/eflesh_tip_fem.py, 9-20 min per tip on the GPU) after generalizing PART, MAG, the contact point and surface_gaps; the homogenized CPU whole-tip run (4 min in femtip) is the cheaper check for a new density or grade. (3) Before trusting either FE, print the 95A 20 % magnet tip and run scripts/tpu_tip_calibrate.py fit with indentation at 0.5/1/3 N, a pull and a twist: an approach near 63 um at 1 N selects the G-code model, near 41 um the homogenized one; an arm near 4.6 mm confirms the wall rails, near 2.5-2.6 mm says the pads need no edge correction; a force exponent near 1.5 would falsify the line-contact result. (4) Fix the calibration scaling at tpu_tip_calibrate.py:84/94 and tpu_tip_widget.py:205-206: estimate E_s from the force ratio at the measured approach and refit E* with tpu_tip_magnet.best_modulus on the FE curve scaled by E_s/E0 (or multiply by (E_s/E0)^(1.5/n)); store A and g0 with the whole-tip rows so the refit is possible. (5) Upgrade the pads in order of cost: take E* at the task's per-pad force from the E_law_fit rows; then set d0 per pad in reorient_backends.replace_tips (:269, :289-297) from a stiffness map with a wall band fitted to the surface-gap FE pressure maps, and test the twist arm on bed task T2 at 1 and 3 N against the FE; add a normal series spring (k_n 15-45 N/mm) only if a task depends on the approach error. (6) For sensing, choose the magnet travel per newton from the force-resolution target (five-chip noise about 1.2 um / travel), keep E* above 1 MPa (the pads fail bed task T1 below it), the magnet top 5 mm deep, the field at the chips under 4.8 mT, and the board against the back face. (7) For control, measure friction first (the closed loop degrades at mu x0.5 and the trainer randomizes only x0.55-1.15), then E_s, then rate dependence by indenting at two speeds with a 10 s hold. Small fixes before printing: rebuild the eFlesh 3MFs with the press-fit pouches, correct the tpu_tip_design.py:25 example, and state the face-up rotation of the print/ STLs in the sheets.

### tasks_eval

Seven CPU harnesses can score a fingertip candidate. Two of them take a tip key today: the bed (scripts/tpu_tip_rig.py) and the open-loop replay of the deployed plans D1-D8 (scripts/pad_usability_backends.py over scripts/reorient_backends.py). Both accept only the single-fillet block 'tpu<r>'. The other harnesses hardcode 'tpu2.7' (hom_turn3.scenes, hand_object_scale_sim.cell_scenes, the hom and film commands of pad_usability_backends) or use the 10.55 mm sphere (hom_hand_brake, hom_chain, contact_bed_roll).

Costs with 1 mm pads on one core, taken from rows:
- a bed case: 0.5-2.1 s (Drake 0.1-10.7 s)
- a 10.28 s plan replay: 1.46 s at 75 µs per step on the servo plant (Drake 13.8 s)
- a HOM turn on D1-D8: 0.96 s
- a HOM turn on a scale-study cell: 0.51-0.57 s
- a hold test with 12 load ramps: 2.9-3.1 s
- a pinned-iCEM run: 207-262 s on six threads, which is 21-26 core-minutes

Scene builds cost 0.9-1.4 s per hand (measured here).

Fingertip geometry has changed outcomes in two harnesses.
- On the bed, the static friction arm at 0.5 N is 0.79, 1.12, 2.42 and 4.00 mm for the sphere, the 6 mm fillet, the 2.7 mm fillet and the sharp box. The brake passes 45° at 1.23, 0.95, 0.34 and 0.20 N. Drake gives onset arms within 6.5 % of the pads.
- In the open-loop replay (kp 0.5 plant, μ 2.4), the sphere keeps the tool in 7 of 72 runs (Drake 12) and the blocks in 56-59 (Drake 56-61). Changing the fillet from 6 to 2.7 mm changes 11 of 72 held outcomes in each simulator, but the two simulators agree on only 7 of the 15 changed pairs, and the turn changes correlate at 0.50. Fine geometry effects in the replay are therefore about as large as the disagreement between contact models.

HOM, the scale-study tasks and iCEM have run only on the 2.7 mm block. RL policies on the servo plant keep the tool in 1,527-1,531 of 1,536 rollouts across box, mesh, pad and skin tips. Halving friction or servo gain drops their open-loop replays to 292 and 198 of 384.

The pads' agreement with Drake gets worse as the fillets get sharper, but only in sliding. The pads/Drake ratio of the sliding (kinetic) friction arm is 0.96-0.98 on the sphere, 0.99-1.07 at 6 mm, 1.18-1.67 at 2.7 mm and 1.43-1.74 on the sharp box. The brake force at 45° follows the same trend: −2 %, −32 % and −41 % against Drake. Two features of the builder fit this:
- every pad of a finger gets the median spring;
- at r 2.7 mm, pads on the fillets are 1.38 times (edges) and 1.92 times (corners) denser per unit of tool area.

A screening suite costs about 15 core-minutes per candidate:
- bed static, twist, pull and brake with pads and Drake;
- 200 replays at nominal settings, μ 0.7 and 0.5, kp 0.5 and a 0.12 N m torque limit;
- Drake replays at seed 0;
- 48 HOM runs on D1-D8;
- HOM and the hold test on the four planner cells.

Pinned iCEM with a friction error in the plant only, the brake at two steps, and 24 Drake replays go to the finalists.

Missing code:
- a parametric tip generator with hash-keyed meshes and a dispatcher
- tip plumbing in hom_turn3 and the scale-study cell scenes
- the bed's x0 and twist-ramp fixes
- block-tip brake and rolling rigs
- CPU hooks for tool mass and for planner-side servo gain

Entry points:

- Bed static signature: patch area and static friction arm per pad at set pinch forces, pads and Drake: scripts/tpu_tip_rig.py (static 316-349; models from tpu_models 302-313) :: PY=logs/20261001-hom_contact/venv/bin/python; taskset -c 4 $PY scripts/tpu_tip_rig.py static --models mj_tpu2p7_pads1 drake_tpu2p7 --N 0.5 1 3 --dt 1 --out <dir>/tip_static.jsonl (runtime: 0.5 s per force with pads, 0.1-1.3 s Drake (docs/experiments/20261006-fingertip_backends/tip_static.jsonl)) Only radii 6, 2.7 and 0 are registered (tpu_models default); a new radius needs tpu_models(radii=...). The default --out writes into the 10-06 rows. TpuMjRig/TpuDrakeRig never set x0, which hom_contact_rig.pad_x (405-406) needs; importing scripts/pad_usability_bed.py patches it (lines 42-52).
- Bed tasks on the block: T1 pull (mu_eff, creep), T2 twist (onset arm, kinetic arm at 1 rad/s, creep), T5 brake (N at 45/80 deg, end angle, slip): scripts/pad_usability_bed.py -> tpu_tip_rig.bed (352-396) -> contact_bed_pull.py, contact_bed_twist.py, contact_bed_brake.py :: taskset -c 4 $PY scripts/pad_usability_bed.py --models mj_tpu2p7_pads1 drake_tpu2p7 --tasks T1 T2 T5 --N 0.5 1 3 --dt 1 5 --ref-dt --out-dir <dir>   (new tips: register mj_<key>_pads1 / drake_<key> in contact_bed_common.MODELS and contact_bed_pull.MODELS as pad_usability_bed.register (61) does, then call tpu_tip_rig.bed) (runtime: pads: T1 1.1-1.9 s, T2 1.4-2.1 s, T5 0.6-1.3 s per case; Drake: T1 0.2-10.7 s, T2 0.4-10.5 s, T5 1.1-8.5 s (tip_T1/T2/T5.jsonl)) Deterministic: one run per (force, step). The brake needs 1 and 5 ms (rf2.7 ends 69.1 vs 77.6 deg). T2 ramps at tau_law(N) for at most 3 s (contact_bed_twist.py:162), so arms above 2.51/2.99/3.93 mm at 0.5/1/3 N never reach onset. tpu_tip_rig.bed sends any task other than T1/T2/T4 to the brake (373-381); T3 rolling is not wired.
- Open-loop replay of the deployed plans D1-D8 (0.8 s grip, the plan, 1.5 s hold, 4 s more): turn, held, pad force: scripts/pad_usability_backends.py run (169-234) over reorient_backends.run_mujoco (373-461) / run_drake (652-678) :: taskset -c 4 $PY scripts/pad_usability_backends.py run --hands D1 D2 D3 D4 D5 D6 D7 D8 --tips tpu2.7 --models pads --plants kp0.72_kv0_fr0.18_fl0_dp0.0144 --mu 1.0 --seeds 0 1 2 3 4 --out <rows>   (Drake: --sim drake --seeds 0) (runtime: pads 1.46 s per run, 75 us per 1 ms step (agree/servo_mujoco.jsonl, 40 rows); Drake 13.8 s, 1,115 us (agree/servo_drake.jsonl)) Seeds are tool placements (RB.jitter j2: sd 2 mm and 2 deg; --jitter j0916: sd 4 mm). The plants, mu and seeds lists are crossed. Plans were exported against the legacy box (reorient_backends.py:9). The file is claimed by the contact-assessment autopilot: call it, do not edit it.
- HOM closed-loop turn (relative contact-velocity control with governor) on D1-D8: scripts/hom_turn3.py (rollout 318-407) via scripts/pad_usability_backends.py hom (239-288) :: taskset -c 4 $PY scripts/pad_usability_backends.py hom --hands D1 D2 D3 D4 D5 D6 D7 D8 --sims mujoco --seeds 0 1 2 --plant kp0.72_kv0_fr0.18_fl0_dp0.0144 --mu 1.0 --set kp_model=0.72 --out <rows> (runtime: 0.96 s per run total, 0.84 s in the control loop (agree/hom_servo.jsonl, 24 rows); Drake 11.1 s) The tip is fixed to tpu2.7 in hom_turn3.scenes (68-69) and in the row (pad_usability_backends.py:271). The controller's Mirror needs the candidate's convex mesh as {f}_tipgeom (hom_turn3.py:104-123). The governor freezes the turn when a pad falls under 0.6 N or the turn lags 6 deg (367-376).
- Scale-study cylinder cells: HOM turn without the post, and the hold test (12 force and torque ramps to 20 N): scripts/hand_object_scale_sim.py run (691-783; hold_rollout 416-511, turn_rollout 558-642) :: SCALE_HAND=cad_v1 taskset -c 4 .venv/bin/python scripts/hand_object_scale_sim.py run --cells diag --only cylinder:25:0.125 cylinder:16:0.625 cylinder:10:0.75 cylinder:16:-0.375 --what hold,turn --seeds 0 1 2 --plant kp0.72_kv0_fr0.18_fl0_dp0.0144 --set kp_model=0.72 post_off=1 --out-dir <dir> (runtime: turn 0.51-0.57 s per run; 90-99 runs and 40-54 s of control loop on the four planner cells; hold test 2.9-3.1 s per grasp (hold.jsonl)) The tip is fixed to tpu2.7 (line 350), and the cell-scene cache path has no tip in it (309), so a new tip silently reuses old scenes. cad_tip_block (152-160) mutates the fingertip_geometry globals at import. MU, MASS and F_GRIP are constants (61-65). The hold test runs seed 0 only. The default --out-dir writes into the study's folder.
- Pinned iCEM (sampling MPC, three-pad cost) and HOM on the four planner cells; friction error in the plant only: scripts/hand_object_scale_planners.py run (136-205) -> hand_object_scale_mpc.mpc_turn (283-371) :: SCALE_HAND=cad_v1 ~/.claude/bin/resguard.sh run --mem 3G --cpu 700 -- taskset -c 4-9 .venv/bin/python scripts/hand_object_scale_planners.py run --configs hom icem_pin --cells cylinder:25:0.125 cylinder:16:0.625 cylinder:10:0.75 cylinder:16:-0.375 --seeds 0 1 --nthread 6 --hom-rows <candidate HOM rows> --out <dir>/turn.jsonl [--variant mu0.7 --plant-set mu=0.7] (runtime: icem_pin median 207 s (real_v1) / 262 s (CAD) per run on 6 threads, i.e. 21-26 core-minutes; 241 s over the 39-cell landscape; icem_gpu 668 s; HOM 0.7-0.8 s) With w_contact > 0 the planner model is recompiled from the XML (sensor_model 93-115), so --plant-set changes only the plant. Only 'mu' is parsed (line 172); other keys are ignored silently. The plant is fixed to SERVO (150). The default --hom-rows picks grasps from the tpu2.7 rows.
- GPU replay batch with 64 placements per hand: scripts/reorient_backends_gpu.py :: WARP_CACHE_PATH=$(mktemp -d) uv run --extra rl --extra gpu python scripts/reorient_backends_gpu.py --hands D1 D2 D3 D4 D5 D6 D7 D8 --tips tpu2.7 --models pads --plants kp0.72_kv0_fr0.18_fl0_dp0.0144 --mu 1.0 --worlds 64 --out <rows> (runtime: 15-33 s per 64-world batch per hand, 17.5-28.4 us per world-step (docs/experiments/20261006-fingertip_backends/reorient_gpu.jsonl)) CPU and GPU agree on 99 % of held outcomes, with a median turn difference of 0.2 deg (10-06 page, Table 6). Defaults: plant 'fast', mu 'scene' (2.4), and --out into the 10-06 rows.
- RL scene with a candidate tip; servo-plant policies evaluated closed loop and open loop under friction, tool mass, servo gain and torque limit: scripts/make_pad_morphology_run.py (--tip 80, --model 81, --E 85, --mu 87); scripts/contact_feedback_replay.py -> scripts/rl_contact_eval.py Evaluator.perturb (327-350) :: uv run --extra rl python scripts/make_pad_morphology_run.py --src <run> --out <run_tip> --tip tpu<r> --model pads --E <Pa> --mu <mu>; MUJOCO_GL=egl WARP_CACHE_PATH=$(mktemp -d) uv run --extra rl --extra gpu python scripts/contact_feedback_replay.py --perturb friction=0.5 friction=0.7 kp=0.36 fr=0.12 mass=2 (runtime: GPU; 64 rollouts of 5 s per condition) contact_feedback_replay's SCENES tuple lists four fixed tip scenes. The mass perturbation scales body_mass and inertia without set_const, so the pad stiffness stays as built.
- Pinch brake on the hand: thumb-index pinch, pad force lowered from 4 to 0.5 N over 4 s: scripts/hom_hand_brake.py (exp_brake 424-501) :: $PY scripts/hom_hand_brake.py brake --spec mj:spheres:s1:rs0.75:tr0.02 --d 15 --rows <rows> (runtime: 0.7-1.2 s with sphere-cap pads, 13-14 s Drake (docs/experiments/20261001-hom_hand_brake/hand_brake.jsonl)) Sphere tip only (mj_scene 207-293, caps 232-254). Its IK targets the sphere centre at R_TOOL + R_TIP - squeeze (184). hom_chain.chain_scene (129) is sphere-only as well.
- Pad-law regression and continuum reference for a tip surface: tests/test_pad_contact_laws.py with scripts/pad_contact_rig.py (FILLET 41, continuum 159-166) :: PYTEST_DISABLE_PLUGIN_AUTOLOAD=1 .venv/bin/python -m pytest tests/test_pad_contact_laws.py -q (runtime: seconds) FILLET is fixed at 2.7 mm. continuum integrates the Winkler law over G.surface_samples, so it applies to any surface a generator returns.
- Print recipe to pad modulus and friction (bench calibration) and the printable block: scripts/tpu_tip_calibrate.py (fit 80, CLI 113-121); scripts/tpu_tip_design.py (R_SIDE, R_END line 38) :: .venv/bin/python scripts/tpu_tip_calibrate.py fit --tip w95_20 --magnet d4.76x1.59@5 --indent 0.5:<um> 1:<um> 3:<um> --pull <N>:<F>; .venv/bin/python scripts/tpu_tip_design.py stl --magnet 4.76 1.59 --depth 3.0 --out <stl> (runtime: seconds (homogenized FE of a new tip: about 10 min per print on 4 cores)) Recipes are the FE tips. The printable block rounds only the palmar long edges (2.7 mm) and the palmar end edge (3.0 mm).

Facts:

- In code, 'tpu<r>' means the 17.0 x 14.8 x 22.0 mm block with every edge rounded at one radius r (Minkowski sum of a box and a sphere). The pads cover every face except the back and the mount top: 1,059 pads per tip at r 2.7 mm, 796 at 6 mm, 1,333 on the sharp box. The printable block (tpu_tip_design.py) rounds only the palmar long edges (2.7 mm) and the palmar end edge (3.0 mm), keeps the other edges square, and is 21.41 mm long. [scripts/fingertip_geometry.py:5-23, 34-42, 131-151; scripts/tpu_tip_design.py:12-14, 38; 20261006 page Table 2]
- The tip key is parsed by RB.tip_r, which reads only the fillet radius (line 89-90). Meshes are written as tpu_tip_r<r>_{pos,neg}.obj, keyed by r alone (G.tag 186-187, mesh_paths 190-196). Every scene build rewrites these files, which is why pad_usability_backends replaced write_obj with an atomic write (64-74). [scripts/reorient_backends.py:89-90, 227-231; scripts/fingertip_geometry.py:186-196; scripts/pad_usability_backends.py:64-74]
- replace_tips gives every pad of a finger the median spring E a_s / h through one d0 per finger (median 1,200 N/m, pads ranging 1,110-1,303). Every pad uses one foundation depth h = DEPTH/2 = 8.5 mm. There is no curvature correction, so at r 2.7 mm pads on fillets are 1.38 times (edges) and 1.92 times (corners) denser per unit of tool area. [scripts/reorient_backends.py:265-297; scripts/fingertip_geometry.py:42, 150; docs/notes/20261014-contact_model_assessment_plan.md:451]
- Pad contacts with static geoms are 8.9-19.7 times too stiff, because d0 is solved for the tip and the tool only. Tool-only pads (padsT) avoid this. In the D1-D8 replays padsT and all-pairs pads give bit-identical trajectories in all 80 runs and cost the same (75.0 vs 74.7 us per step). [docs/notes/20261014-contact_model_assessment_plan.md:224; docs/experiments/20261014-pad_usability/agree/findings_U2.json]
- Bed static arm at 0.5 N, pads / Drake: sphere 0.79/0.82, rf6 1.12/1.12, rf2.7 2.42/2.45, sharp box 4.00/3.70 mm. Patch area at 0.5 N: 8.0/7.1, 15.0/10.6, 18.4/18.8, 17.0/23.8 mm2. Bed step cost with pads: 29 (rf6), 51 (rf2.7) and 91 us (box). [docs/experiments/20261006-fingertip_backends/tip_static.jsonl; 20261006-fingertip_contact_backends.html Table 2]
- Twist-onset arm at 1 N, pads / Drake: sphere 0.924/0.987, rf6 1.273/1.257, rf2.7 2.525/2.496 mm. At 3 N: 1.193/1.275, 1.459/1.519, 2.736/2.618 mm. The pads stay within 6.5 % of Drake on all three shapes. mu_eff is 1.003-1.008 on every tip, so geometry does not move slip onset. [docs/experiments/20261006-fingertip_backends/tip_T2.jsonl, tip_T1.jsonl; docs/experiments/20261005-contact_bed/twist_slip.jsonl]
- Kinetic (sliding at 1 rad/s) arm, pads/Drake ratio: sphere 0.96-0.98, rf6 0.99-1.07, rf2.7 1.18-1.67 (5.72/3.44 mm at 0.5 N, 4.55/3.59 at 1 N), sharp box 1.43-1.74. The sliding-arm error grows as the fillet radius shrinks; the onset arm does not show this. [tip_T2.jsonl rbar_kin_mm (computed here); docs/experiments/20261005-contact_bed/twist_slip.jsonl]
- Brake (bed T5, d 15 mm, pad force 6 -> 0.2 N over 4 s), N at 45 deg, pads / Drake: sphere 1.234/1.204, rf6 0.946/0.968, rf2.7 0.338/0.500, box 0.200/0.338 N, i.e. errors of -2, -32 and -41 % on the blocks. End angle at 1 ms: 88.3/87.3, 77.3/83.1, 69.1/73.3, 51.3/71.8 deg. rf2.7 is step-sensitive: pads end at 69.1 vs 77.6 deg and slide 2.4 vs 8.0 mm at 1 vs 5 ms. [docs/experiments/20261006-fingertip_backends/tip_T5.jsonl; 20261006 page Table 3]
- The rf6 brake stalls at 77-83 deg because the contact line turns from across the 2.8 mm flat to along the 10 mm flat as the tool swings, which lengthens the arm. The friction arm therefore depends on the angle of the contact line. [20261006-fingertip_contact_backends.html, section 'The printed TPU fingertip']
- Pre-slip creep at 1 N, pads / Drake: sphere 31/0.20, rf6 14/0.25, rf2.7 10.8/1.2, box 8.4/1.7 um/s (155, 56, 9 and 5 times). At impratio 10 (RL numerics) the pad creep rises 9.9 times and the onset arm rises 7.1 % (1 N) and 4.5 % (3 N). [tip_T1.jsonl; 20261006 page Table 3; findings_U2.json]
- The twist task ramps the torque at tau_law(N) = 2 mu N c N^0.25 for at most 3 s, so the largest measurable arm is 2.51, 2.99 and 3.93 mm at 0.5, 1 and 3 N. rf2.7 at 0.5 N and the sharp box at every force have spun=False and no onset. [scripts/contact_bed_twist.py:47, 60-61, 162; tip_T2.jsonl]
- tpu_tip_rig's rigs never set x0, which hom_contact_rig.pad_x uses; pad_usability_bed.py patches it before construction. tool_touch gives x0 = R_PAD + R_TOOL with R_PAD 10.55 mm, which is correct only because the block's palmar face is 10.55 mm from the tip origin. [scripts/tpu_tip_rig.py:125-158, 171-242; scripts/hom_contact_rig.py:65, 109-112, 405-406; scripts/pad_usability_bed.py:42-52]
- Replay of the deployed plans on the kp 0.5 plant at mu 2.4: the sphere keeps the tool in 7/72 runs in MuJoCo (single geom) and 12/72 in Drake. rf6 pads keep it in 59/72 (Drake 61); rf2.7 pads in 56/72 (Drake 56). D7 holds 9/9 with rf6 and 3/9 with rf2.7 in both simulators. On D1 the turn is +21 vs +36 deg with pads and +19 vs +37 deg in Drake. [docs/experiments/20261006-fingertip_backends/reorient_mujoco.jsonl, reorient_drake_*.jsonl; 20261006 page Table 4]
- Changing the fillet from 6 to 2.7 mm changes 11 of 72 (hand, seed) held outcomes with MuJoCo pads and 11 in Drake; the two agree on 7 of the 15 changed pairs. On the 49 pairs held in all four conditions, the turn changes correlate at 0.50 (median |change| 3.9 deg pads, 3.3 deg Drake). With single-mesh point contact the fillet effect agrees with Drake on 0 of 28 changes. [computed here from reorient_mujoco.jsonl and reorient_drake_D1D2D3/D4D5D6/D7D8.jsonl (plant fast, mu scene, impratio 100)]
- Lowering mu from 2.4 to 1.0 drops rf6 pads from 59 to 36 of 72 held. On the servo plant (kp 0.72 N m/rad, 0.18 N m) at mu 1.0, the 1 mm pads keep the tool in 40/40 runs and end within 3 deg of Drake on 16/24 placements. 2 mm pads reach 12/24, condim 4 at 2.8 mm 1/24, point contact 1/24 and multiccd 1/24. Single-contact models drop the tool in 11-26 of 40 runs. [reorient_mujoco.jsonl; docs/experiments/20261014-pad_usability/agree/findings_U2.json]
- With pads on the servo plant, the per-hand turn sd over seeds 0-4 is 0.7-4.9 deg (median 2.0). With 2 mm pads it reaches 52 deg (D6) and 13.9-14.6 deg (D1, D2), and with condim 4 up to 41 deg. D3 (seeds 0-2) and D8 seed 1 are turn-or-no-turn placements: the pads end within 4 deg of the grip where Drake turns 40-44 deg, and 3 of these 4 still stall at 0.5 ms. [computed here from docs/experiments/20261014-pad_usability/agree/servo_mujoco.jsonl; findings_U2.json]
- HOM on D1-D8 (servo plant, pads) agrees with Drake within 5 deg and in the kept outcome on 21 of 24 runs. Held turns end at 9-40 deg because the governor freezes at 13-48 deg. The turn spread over 3 seeds is under 2 deg on D1, D5 and D7, with held flips on D2 and D4. [docs/experiments/20261014-pad_usability/agree/hom_servo.jsonl; findings_U2.json]
- Scale-study HOM without the post, at each cell's best grasp: the turn range over 3 placements has a median of 10.1 deg (real_v1) and 4.5 deg (CAD hand), and a 75th percentile of 34-35 deg. Over all grasps, 21-27 % have a range above 20 deg. On the 4 planner cells HOM runs 90-99 times (all grasps x 3 placements) for 40-54 s of control loop. [computed here from docs/experiments/20261013-scale_turn_controllers/hom_postoff_servo/turn.jsonl, docs/experiments/20261014-scale_turn_cad_v1/hom_postoff_servo/turn.jsonl, docs/experiments/20261011-bench_plan/servo_plant/turn.jsonl]
- The hold test barely registers the contact model. On the 1 N m plant, pads and block point contact agree on 110 of 110 held outcomes, and their disturbance loads differ by a median ratio of 0.96-1.08 across the 12 force and torque ramps. The paired HOM turns agree on 280 of 330 held outcomes, with a median turn difference of 1.3 deg. [computed here from docs/experiments/20261008-hand_object_scale/hold.jsonl and turn.jsonl]
- Pinned iCEM on the four planner cells: median held turn 65 deg on real_v1 and 45 deg on the CAD hand, 8/8 runs ending on three pads. Placements 0 and 1 differ by 3, 5, 17 and 0 deg per cell (real_v1) and 4, 0, 12 and 0 deg (CAD). Wall time per run is 207 s and 262 s on 6 threads; GPU iCEM takes 668 s per run. The change of finger model (real_v1 to CAD) moved the median from 65 to 45 deg. [docs/experiments/20261013-scale_turn_controllers/planners/turn.jsonl; docs/experiments/20261014-scale_turn_cad_v1/planners/turn.jsonl; 20261014-scale_turn_cad_v1 page Tables 4, 5, 7]
- The planners' --plant-set parses only 'mu' (line 172) and ignores other keys without warning. The plant spec is fixed to SERVO (line 150). With the three-pad cost the planner model is recompiled from the scene XML (sensor_model), so it keeps mu 1.0 while the plant is perturbed. The mu 0.7 variant listed as future work has never been run. [scripts/hand_object_scale_planners.py:142, 150, 170-173, 186-187; scripts/hand_object_scale_mpc.py:93-115, 128-131; planners/turn.jsonl variants]
- RL policies on the servo plant, evaluated on box, TPU mesh, 1 mm pads and sprung skin tips: closed loop keeps the tool in 1,531 of 1,536 rollouts and open-loop replay in 1,527, with held cosine within 0.054. With friction x0.5: 376 vs 292 of 384 (closed vs open loop). At half servo gain: 352 vs 198. At a 0.12 N m torque limit: 369 vs 220. Friction x1.3 and tool mass x0.8/1.2/2 leave at least 383 of 384 in both modes. [docs/experiments/20261013-contact_feedback/20261013-contact_parameter_sensitivity.html (summary and results paragraphs)]
- On the servo plant the fingertip is a ~250 N/m spring, 79-278 times softer than the pad contact. Between pad moduli of 5 and 20 MPa the twist arm at 1 N on rf2.7 changes only from 2.66 to 2.39 mm. [20261013-contact_parameter_sensitivity.html (modulus section, Table 4)]
- Print recipes map to pad moduli of 6.9-16.5 MPa (magnet tips) and 12.7 MPa (95A 20 % without magnet). Fitted to the FE, the pads miss the approach by 20-28 % and the 3 N twist arm by -3.5 % (85A 50 %) to -19.1 % (95A 10 %), because the walls carry 26-61 % of the edge load. The pads fail the T1 pull at 1 MPa; the bed covers 2.5-77 MPa. Homogenized FE of one tip takes about 10 min on 4 cores. [docs/experiments/20261009-tpu_tip_fem/20261009-printed_tpu_fingertip_finite_elements.html Tables 1, 6, 8]
- Measured here on one core (taskset -c 4, scratchpad output): G.pad_spheres takes 0.002-0.003 s and the convex hull 0.12-0.23 s. RB.build_scene for D7 takes 1.40 s (rf2.7 pads, including the plant subprocess) and 0.86 s (rf6 pads), with a further 0.95 s and 0.56 s to compile 3,193 and 2,404 geoms. The point-contact scene builds in 0.11-0.27 s. [/tmp/claude-1001/-home-humanoid-Programs-hand/88ae0ebc-1769-4d06-9a8c-bed92903087d/scratchpad/time_build.py]
- CPU cost of a 1 ms step in the replay: pads 75, pads2 24, multiccd 29, point contact 11 and condim 4 5.3 us (servo plant); Drake 1,115 us. In the scale-study grip: pads 105-147 us (85 contacts, 255 rows) against point contact 13-16 us. One 64-plan replanning takes 0.48 s on 12 threads with pads and 0.05 s with point contact. [findings_U2.json; docs/experiments/20261014-pad_usability/cost/report_U1.json; 20261013-scale_turn_hom_mpc page Table 7]
- The scale-study grasp candidates come from closed-form kinematics with a 10.55 mm sphere pad (K.R). grip_poses then moves each touching pose along the normal until the tip mesh {f}_tipgeom just touches the object (mj_geomDistance), so the grip is corrected per tip only along the normal. [scripts/hand_object_scale_kin.py:55; scripts/hand_object_scale_sim.py:263-296]
- Tool mass has no CPU perturbation hook: the bench-scene tool is 24.5 g, and the scale study fixes MASS = 0.025 kg. Pads built for one tool mass and used with another are off by -61/+65 % in stiffness, because d0 is solved from body_invweight0 of the tip and the tool. Editing body_mass at run time without set_const keeps the built stiffness, as rl_contact_eval.perturb does. [scripts/hand_object_scale_sim.py:61-65; scripts/rl_contact_eval.py:327-350; 20261013-contact_parameter_sensitivity.html; scripts/pad_contact_rig.py:5-12]
- Placement jitter: RB.jitter 'j2' gives no shift at seed 0, then sd 2 mm in x/y and 2 deg in yaw from default_rng(1000 + seed); 'j0916' gives sd 4 mm in x/y and no yaw. HOM, the scale study and the planners all call RB.jitter(seed) in its default mode. The hold test runs seed 0 only, with no jitter. [scripts/reorient_backends.py:76, 322-335; scripts/hom_turn3.py:164-172; scripts/hand_object_scale_sim.py:732, 436]
- Servo gain, torque limit, damping and joint friction enter the replay, HOM and scale harnesses through the plant spec 'kp<v>_kv<v>_fr<v>_fl<v>_dp<v>'. A new scene is generated per spec by apply_measured_plant.py and cached under <out_dir>/plants. hand_object_scale_sim fixes friction at MU = 1.0, with no CLI flag. [scripts/reorient_backends.py:108-140; scripts/apply_measured_plant.py:73-83; scripts/hand_object_scale_sim.py:61, 176-186]
- Rolling is the bed's task 3 and runs only on the sphere rig: MjRollRig wraps hom_contact_rig.mj_xml, and tpu_tip_rig does not wire T3. No hand-level task rolls the object, and the hold test's torques about the cylinder axis do not respond to the contact model. [scripts/contact_bed_roll.py:1-45, 152-171; scripts/tpu_tip_rig.py:373-381]
- DrakeBench registers the tip as a compliant Convex built from the 'pt' scene's mesh, at E 10 MPa and relaxation 0.01 s, so the Drake reference covers only convex tips. Its pressure field rises from the hull surface to the centroid, while the pads use one h = 8.5 mm everywhere. [scripts/reorient_backends.py:466-593 (Convex 547-549, E 472, props 527-536); scripts/fingertip_geometry.py:17-23, 42]
- The contact-assessment autopilot claims scripts/pad_usability_*.py and docs/experiments/20261014-pad_usability/. The hand-off assigns this window's fingertip co-design study cores 4-11 and at most 6 GB, and the autopilot cores 12-19. [docs/handoff/20261014-contact_model_assessment.md (Claimed line, standing directions)]

Gaps:

- No harness except the bed and the open-loop replay has run with any tip other than the 2.7 mm block: HOM on D1-D8, the scale-study HOM and hold test, pinned iCEM, and RL training. Their sensitivity to tip geometry is unmeasured.
- The fillet effects available (6 vs 2.7 mm, sphere, sharp box) come from the kp 0.5 / mu 2.4 replay plant of 10-06, not the servo plant of U2. No servo-plant replay exists for rf6 or any other tip.
- Which model the printed tip follows in sliding is unknown: the FE gives onset arms only at 3 N and no kinetic arm, and no printed tip has been measured on the bench (mu, twist, brake).
- The cause of the pads' growing kinetic-arm excess on flat faces with small fillets (1.18-1.74 times Drake) is not isolated. Candidates are uniform median springs plus denser fillet pads, against Drake's centroid-based field. Only the bed rows document it.
- The deployed plans were exported against the legacy box. How much a tip that moves the palmar face (reach, crown) changes the replay through the plan mismatch, rather than through contact, is untested.
- I did not run tpu_tip_rig static/bed with the current hom_contact_rig (READ-ONLY), so I have not confirmed whether static() works without the x0 patch. pad_usability_bed.py's docstring says the bed tasks fail without it.
- Cost of building scale-study cell scenes per new tip (pads + pt per cell, 0.7 MB each) and of grip_poses per candidate is not in any row; only bench-scene builds were timed here (0.9-1.4 s plus 0.6-1.0 s compile).
- That pinch torsion (mu N rbar) resists HOM's pivot about the pinch axis, and so sets the governor freeze, is inferred from the controller and the brake; no run varies rbar under HOM.
- The pinned-iCEM landscape covers placement 0 only on 39 cells, and no planner run has a friction or servo mismatch, so iCEM's robustness spread per tip is unknown.
- There are no T4 shake rows for any block tip. A thin-object pick (coin, card, washer) was proposed on the 10-06 page but never built.

Recommendations: Screen each candidate in one-core processes on cores 4-11 (at most 6 GB in total; measure RSS once with /usr/bin/time -v before batching). The suite below costs about 15 core-minutes per candidate.

(1) Build and representability, about 1.5 core-min.
- Record pad count, median spring and per-finger d0 (replace_tips raises below 0.05).
- Record the density factor r/(r-rs) on curved regions.
- Run pad_contact_rig.continuum against the pads' approach and twist limit at 0.5/1/3 N, with the tolerances of tests/test_pad_contact_laws.py.
- Run bed static (0.5/1/3 N), T1 (1/3 N), T2 (0.5/1/3 N, with the ramp length scaled to the static arm) and T5 (1 and 5 ms), with pads and Drake.
- Score: onset arm, static arm, patch area, N at 45 deg and end angle.
- Representability penalty: the pads/Drake ratios of kinetic arm and brake force. This is the measure of how the pads deteriorate across geometry. It is a property of the model, not a design goal.

(2) Hand replay, about 7 core-min.
- D1-D8, seeds 0-4, on the servo plant at mu 1.0, 0.7 and 0.5; at kp 0.5; and at torque limit 0.12 N m (200 runs, issued as separate commands because the CLI crosses its lists).
- Drake at seed 0 on the 8 hands.
- Use held count and per-hand turn. Report D3 and D8 seed 1 separately (bistable).
- Treat fine geometry effects here as noise-limited (model agreement 0.50).

(3) Closed loop, about 4 core-min.
- HOM on D1-D8, seeds 0-2, at mu 1.0 and 0.7 (48 runs).
- HOM plus the hold test on the four planner cells of the CAD hand (SCALE_HAND=cad_v1, post_off=1, kp_model=0.72; about 100 + 33 runs).

Ranking: use the worst case over the friction and servo conditions of held fraction and three-pad turn, minus the representability penalty and a cost term (pad count, which sets us per step). Leave creep and the shake out of the score: creep is a MuJoCo soft-friction effect at 5-155 times Drake.

Do not screen with 2 mm pads or condim 4. On the servo plant they reach 12/24 and 1/24 placements within 3 deg of Drake, and the 2 mm pads show per-hand sd up to 52 deg.

Confirm 3-4 finalists with:
- Pinned iCEM on the four planner cells, seeds 0-1, nominal and mu 0.7 in the plant only. That is 16 runs x 262 s on 6 threads, about 70 min wall per finalist and 4-5 h in all, so ask the owner first. Pass --hom-rows from the finalist's own HOM rows.
- The bed brake at 1 and 5 ms, plus a sweep of the station distance.
- 24 Drake replays.
- A robustness grid: mu 0.5/0.6/0.7, kp 0.5/0.94, torque limit 0.12/0.24, j0916 placements, tool mass x0.8/1.2/2 (needs a new hook).
- 64-seed GPU replays (reorient_backends_gpu.py).
- An RL policy check with contact_feedback_replay.py --perturb on make_pad_morphology_run.py scenes.
- Homogenized FE per print (about 10 min on 4 cores) to fix E* and the arm error.
- Bench twist and pull tests through tpu_tip_calibrate.py.

Write first, in new files that wrap and do not edit the files the autopilot claims:
- (a) A tip-family generator: separate side and end fillets (the printed tip is 2.7/3.0 mm with square back edges; the sim rounds every edge), flat width and length, crown radius across and along, optional nail. It returns surface samples with areas and normals, per-pad depth h and a convex hull, with a spec hash in the mesh file names. It must not depend on the fingertip_geometry globals that cad_tip_block mutates.
- (b) A dispatcher wrapping RB.tip_r / replace_tips for spec keys, with per-pad stiffness from each pad's own area as an option.
- (c) A tip argument in hom_turn3.scenes and hand_object_scale_sim.cell_scenes, with the tip added to the cache path.
- (d) Bed fixes: x0 = reach + R_TOOL, and the twist ramp's t_max taken from the static arm.
- (e) CPU hooks for tool mass (body_mass and inertia without set_const), for plant-only kp/fr in the planners, and a planner that rejects unknown --plant-set keys.
- (f) A block-tip roll rig built from contact_bed_roll and tpu_xml. Face curvature should matter most in rolling, and no harness measures it.
- (g) A parametrized FILLET in pad_contact_rig, with the pad-law tests run on every family member.

Material: treat print settings as (E*, mu). E moves the twist arm about 10 % over 5-20 MPa, and pads represent E down to about 2.5 MPa. Choose the recipe for magnet sensing and for agreement between pads and FE (85A 50 %: arm error -3.5 %), and randomize mu over 0.5-1.0 in the loop.

Design lever (an inference from the bed and the controllers): the friction torque about the pinch axis is mu N rbar, and N is servo-limited. The arm rbar and its dependence on contact-line angle are therefore the geometric levers. A flat that is narrow across and long along brakes the swing as the tool nears vertical, as the rf6 stall at 77-83 deg shows.
