badinkajink/hand/docs/experiments/20261018-dip_link_board_mount/spec.md

# DIP link with a clamped five-chip magnetometer board: design specification

2026-10-18. Generated by `scripts/dip_link_spec.py` from `spec.json` (every number with its source). Model values unless marked as measured; nothing here is designed or printed yet.

The new DIP link puts the five chips' package tops on the printed tip's back face, removing the 3.0 mm plate between them; the readout model then resolves 0.173 N at the contact point with four magnets and 0.062 N with five (85A, 30 % gyroid), against 0.354 and 0.143 N now. One micrometre of board motion toward the magnets reads as 0.160 N, so the board is clamped by screw preload and located by rigid features, independent of the tip. At this placement J1 overlaps the MCP link by 1.45 mm within the PIP range and only a tab of 4.9 mm or less keeps 0.5 mm clearance, so the tab is cut and the cable soldered, or the board is flipped. The board's four holes lie 0.6 mm inside the tip's side planes, which shapes every clamp.

## Terms and frames

- F: finger frame of the index finger at zero joint angles (scripts/build_cad_v1_finger.py), mm: x along the yaw axis toward the dorsal side, y along the PIP axis, z up; the straight finger hangs along -z.
- PIP angle: q in degrees, positive in flexion (the tip moves toward -x); range -18 to 92° (model).
- Touch placement: the board with its chips' package tops on the tip's back face.
- Gap: distance from the tip's back face to the chips' sensing plane, 0.42 mm under the package top, mm; negative inside the tip.
- Force resolution: Cramér-Rao bound (one standard deviation, N) of the normal force at the contact point from one 141 Hz sample of the five chips, with the contact position and a uniform background field unknown (scripts/tpu_tip_magnet_sensing.py).
- False force: normal force or shear (N) that the readout's estimator (normal and shear force, contact position and background field unknown) reads when the board moves 1 µm relative to the magnets, along x (toward them), y or z.
- Keep-out: the volume that the MCP link and the PIP servo sweep in the DIP link's frame over the PIP range.
- Clearance: least signed distance (mm) from the swept parts' surface to a part fixed to the DIP link; negative values overlap, by that depth.
- Design loads: 10 N normal and 5 N tangential at the contact point, and a 1 N pull on the cable.
- Board frame: (u, v) of the ReSkin 5X files, U1 at the origin; on the finger u = y_F, v = -(z_F + 78.16), U1 over the contact point, U2 toward the tip's end, the tab toward the PIP joint; at the touch placement the FR-4's component face is at x_F 7.35.
- Placements: plate (now), touch, recessed and flipped, defined under the force-resolution table.

## Requirements

| ID | Topic | Requirement | Threshold |
|---|---|---|---|
| R1 | Board distance | The chips' package tops lie against the printed tip's back face with no rigid layer between the TPU and the five chips (the touch placement: sensing plane 0.42 ± 0.10 mm behind the back face). | sensing plane at most 0.52 mm behind the back face |
| R2 | Tip support | The tip's back face rests on a rigid flat surface over its area outside the component windows, and its mount face on a rigid face, as the finite elements assumed (back and mount faces fixed). Around the chips a rigid shim at the chip-top height (0.80-1.00 mm, nominal 0.90) or the FR-4 itself (recessed placement) supports the back face; windows clear each part by 0.2 mm. | back face supported everywhere but the windows (55 mm², 17 % of the block's 317 mm²); support flat to 0.05 mm |
| R3 | Board retention | The board is clamped normal to its plane between rigid parts by screw preload and located in its plane by rigid features (pins in two of its 2.40 mm holes, or pocket walls) with at most 0.05 mm clearance. Its position depends on neither the tip nor TPU friction. No clamp force bears on U1-U5, C1-C5, R1-R2 or J1. | play and slip of the board relative to the DIP link below 1 µm under the design loads (elastic motion is calibrated with the tip); 1 µm of board motion toward the magnets reads as 0.160 N of normal force and 1 µm across as 0.041 N of shear (four-magnet 30 % block, touch placement; 0.271 and 0.070 N at 50 %) |
| R4 | Tip retention | The tip is retained in all three axes by rigid features of the DIP link, keeps its back face against the chips or shim, and comes off without unclamping the board. No retention feature or fastener comes within 2.0 mm of a magnet pocket or through the palmar half of the tip. | tip-to-board position repeatable to 0.1 mm across remounts (the zero-load field is re-read after each mount); no slip under the design loads |
| R5 | Contact geometry | The outer surface of each printed tip is unchanged (block, capsule r 8.5 mm, half-ellipsoids 7.4 x 8.5 x 16/32 and 11/22 mm): all share the flat back face at x_F 6.45 and the mount face at z_F -67.30. Over the tip's length nothing protrudes beyond the tip's outer surface palmar of its back plane (retention features may enter pockets or grooves of the tip, R4), and nothing is wider than the board (|y_F| ≤ 10.0 mm) except a rim that covers the board's edge, at most 0.5 mm per side. | assembly width over the tip's length at most 21.0 mm; the board's FR-4 edge not exposed |
| R6 | Joint interface | The clevis arms of fingertip_mount_DIP_link.stl are kept as they are: the horn-side arm (y_F -23.25..-17.05: the 2.0 mm slot for the 1.6 mm horn, the 6.4 mm hub recess, the 2.3 mm centre hole, the four 1.6 mm horn-arm holes at z_F -58.05, -61.05, -63.55, -66.05) and the slotted arm (y_F 13.40..17.40, the 5.2 mm slotted bore on the PIP axis). Everything between them is redesigned. | arms identical to the STL within 0.01 mm |
| R7 | Clearance over the joint range | Over PIP -18 to 92° every new part (bridge, board, tab or cable exit, clamp, fasteners, strain relief) stays clear of the MCP link and the PIP servo; the yaw link, MCP servo and carriage stay 24 mm or more away (readiness sweep). | 0.5 mm for rigid parts, 1.0 mm for the cable, by dip_link_geometry.points_clearance_exact |
| R8 | Connector and cable | At the touch placement J1 (2.9 mm tall on the component side) overlaps the MCP link by 1.45 mm within the PIP range and the whole 9 mm tab by 0.80 mm; a tab of 4.9 mm keeps 0.5 mm. So the tab is cut to that length and four wires (VDD, GND, SDA, SCL) are soldered to it, or the board is flipped. The cable is anchored to the DIP link next to the board so no cable force reaches the board, crosses the PIP joint where its length change over the range is small or taken up by a loop, and ends in an inline connector on the MCP link side, so the board comes off with its pigtail. | tab at most 4.9 mm at the touch placement; cable length change over the range within its loop: r x 1.92 rad at a crossing r mm from the PIP axis (9.6 mm at r 5) |
| R9 | Assembly and replacement | The tip and the board are each replaceable with hand tools without removing the DIP link from the finger; the board's location survives a tip exchange; the thumb uses the same part (the same finger turned 180° about the vertical). | tip exchange without touching the board's screws |
| R10 | Magnetics | No ferromagnetic fastener within 15 mm of a chip: brass, nylon or titanium screws, brass inserts; austenitic stainless (A2/A4) can be weakly magnetic after cold forming. A magnetized or magnetizable part next to the chips adds a field that depends on the magnets' field and on its own history; the readout model has only the tip's magnets and a uniform background field. The board comes no closer to the PIP servo than now. | no ferromagnetic part within 15 mm of a chip; board to PIP servo at least 6.3 mm over the range |
| R11 | Printability | Rigid parts in PLA or PETG on the Prusa XL with 0.4 mm nozzles; walls 0.9 mm or more; the board seat and clamp faces flat without supports; solid infill in the clamp. TPU 85A features may be co-printed. | board seat flat to 0.05 mm |
| R12 | Mass | The new DIP link with clamp and fasteners weighs at most 2 g more than the current DIP link (4.92 g) with the board (0.64 g). | at most 7.6 g without the tip |

## Board distance and force resolution

Force resolution at the contact point (N) by magnet count and gyroid infill, and the static field at U1 (mT), per placement; magnet motions from the readiness study's finite elements of the 85A block.

| Placement | Gap (mm) | Four, 30 % | Five, 30 % | Four, 50 % | Five, 50 % | Field at U1, four / five 30 % (mT) | GAIN_SEL, four / five 30 % |
|---|---|---|---|---|---|---|---|
| Plate | 3.42 | 0.354 | 0.143 | 0.601 | 0.294 | 3.2 / 4.3 | 7 / 7 |
| Touch | 0.42 | 0.173 | 0.062 | 0.287 | 0.123 | 5.5 / 7.7 | 6 / 5 |
| Recessed | -0.48 | 0.134 | 0.048 | 0.223 | 0.094 | 6.5 / 9.3 | 5 / 4 |
| Flipped | 1.08 | 0.205 | 0.075 | 0.341 | 0.149 | 4.9 / 6.7 | 6 / 5 |

- Plate: the readiness scenes: the board on the dorsal face of the DIP link's 3.0 mm plate, chips toward the plate.
- Touch: chip tops against the tip's back face, the FR-4 behind them.
- Recessed: the FR-4's component face on the tip's back face, the chips and capacitors in 1.0 mm pockets of the TPU.
- Flipped: the FR-4's bare face on the tip's back face, the chips and J1 facing away from the tip.

Below GAIN_SEL 7 the datasheet gives no noise, so those resolutions are lower bounds. The readout's estimator (normal and shear force, contact position and background field unknown) reads one micrometre of rigid board motion relative to the magnets as 0.160 N of normal force along x (toward the magnets), 0.041 N of shear along y and 0.130 N of shear along z (four magnets, 30 %, touch); the magnets move 13.2 µm per newton of normal load.

## Clearance over the PIP range

Least clearance (mm) of boxes fixed to the DIP link from the MCP link and the PIP servo, PIP -18 to 92°, negative where they overlap; exact to 0.2 mm. The readiness sweep gave the plate board 6.33 mm and the 9, 6 and 3 mm tabs -0.79, 0.63 and 3.48 mm; this method gives 6.33, -0.80, 0.63 and 3.48.

| Part | Plate | Touch | Recessed | Flipped |
|---|---|---|---|---|
| Board with its parts | +6.27 (MCP link, PIP -18°) | +7.20 (MCP link, PIP -18°) | +7.47 (PIP servo, PIP -18°) | +7.16 (PIP servo, PIP -18°) |
| Tab 3 mm | +3.42 (PIP servo, PIP -18°) | +2.23 (MCP link, PIP 25.5°) | +1.87 (MCP link, PIP 15°) | +2.27 (MCP link, PIP 72°) |
| Tab 4.9 mm (J1's signal pads kept) | - | +0.53 (MCP link, PIP 29°) | +0.13 (MCP link, PIP 6°) | +0.58 (MCP link, PIP 7.5°) |
| Tab 6 mm | +0.56 (PIP servo, PIP -18°) | -0.31 (MCP link, PIP 15°) | -0.64 (MCP link, PIP 82.5°) | -0.27 (MCP link, PIP 8°) |
| Tab 9 mm (whole) | -0.80 (PIP servo, PIP -16.5°) | -0.80 (MCP link, PIP 19°) | -0.80 (MCP link, PIP 71°) | -0.80 (MCP link, PIP 68°) |
| J1, 2.9 mm tall | - | -1.45 (MCP link, PIP 35°) | -1.45 (MCP link, PIP 25°) | -1.17 (MCP link, PIP 82°) |

A dorsal backing plate behind the FR-4 at the touch placement (x_F from 7.95 mm, |y| ≤ 10.5 mm, over the board's length): 2 mm thick +6.58 (MCP link, PIP -18°), 3 mm thick +6.27 (MCP link, PIP -18°), 4 mm thick +5.96 (MCP link, PIP -18°), 6 mm thick +5.34 (MCP link, PIP -18°), 8 mm thick +4.72 (MCP link, PIP -18°). The same plate 2 mm thick extended toward the PIP joint: to z -66 mm +3.79 (MCP link, PIP 34°), to z -64 mm +2.07 (MCP link, PIP 11°), to z -62 mm +0.43 (MCP link, PIP 74°), to z -60 mm -0.86 (PIP servo, PIP -18°), to z -58 mm -1.00 (MCP link, PIP 28°).

The swept volume is stored in `docs/experiments/20261018-dip_link_board_mount/keepout_pip.npz` (0.25 mm cells); `dip_link_geometry.keepout().query(points)` gives a candidate's signed distance to it within 0.3 mm and `points_clearance_exact` the exact value. The parent parts span y_F -24.05..17.4 mm (MCP link) and -19.05..9.4 mm (PIP servo), so a cable outside the slotted arm (y_F > 17.4 mm) crosses the joint clear of them.

Side view of the keep-out

Figure 1: the side view at y = 0 with the volume the MCP link and the PIP servo sweep over PIP -18 to 92° within |y| ≤ 10.5 mm (light grey) and the same parts at PIP 0° (dark grey), the printed block tip, the current DIP link's section, the four magnets, the board at the touch placement with its 9 mm tab and J1, and the board on the current plate.

## The board

ReSkin 5X from `https://github.com/raunaqbhirangi/reskin_sensor/tree/main/circuits` (5X_ReSkin.Zip, read as data; copy in `logs/20261018-dip_link/reskin_download`, untracked). FR-4 0.6 mm; outline u -10.00..10.00 mm, v -10.10..10.05 mm, tab u -5.00..5.00 mm, v -19.10..-10.10 mm. Four plated 2.40 mm holes at (u, v) (-8.00, -8.10), (+8.00, -8.10), (+8.00, +7.90), (-8.00, +7.90) mm. U1 at the origin, U2-U5 7.00 mm away in a plus (U5 at v +0.05); every part on the component side: the five MLX90393 (3 x 3 mm, 0.80-1.00 mm tall, sensing spot 0.42 ± 0.10 mm under the top), C1-C5 0402 (0.5 mm), R1-R2 0402 at v -11.40 (0.35 mm), C6-C9 unpopulated pads at u -3.56, v -8.7..-12.0, and J1, a JST SH side-entry header (body u -2.95..3.05, v -18.09..-13.14 mm, about 2.9 mm tall, signal pads at v -13.70, mating face toward the tab's end). The bare side is flat. The holes' inner edges reach |u| 6.80 mm, inside the tip's 7.40 mm half-width; U3 and U5 reach |u| 8.50 mm, beyond it.

The board with the tip's back face

Figure 2: the board's component side in its own frame (u = y_F, v toward the tip's end) with the tip's back face (tan), the four magnets (green circles), the chips (blue), the capacitors and resistors (grey; C6-C9 unpopulated, outlined), J1 (orange) and an M2 head of 3.8 mm at each hole (orange, dashed).

## The printed tips and magnets

| Tip | Magnets, top under the apex | Magnet x_F (mm) | TPU behind the magnets (mm) | Back-face area (mm²) | Field at U1, touch (mT) | Mass with magnets (g) |
|---|---|---|---|---|---|---|
| Block | 4 x 3 x 2 mm, 5 mm | -5.55..-3.55 | 10.00 | 317 | 5.5 | 3.73 |
| Block | 5 x 3 x 2 mm, 5 mm | -5.55..-3.55 | 10.00 | 317 | 7.7 | 3.88 |
| Capsule r 8.5 mm | 4 x 3 x 2 mm, 5 mm | -5.55..-3.55 | 10.00 | 298 | 5.5 | 3.41 |
| Half-ellipsoid 7.4 x 8.5 x 16/32 mm | 4 x 3 x 2 mm, 5.5 mm | -5.05..-3.05 | 9.50 | 301 | 6.1 | 3.41 |
| Half-ellipsoid 7.4 x 8.5 x 11/22 mm | 4 x 3 x 2 mm, 7 mm | -3.55..-1.55 | 8.00 | 280 | 8.0 | 3.18 |

Four magnets sit at y_F ±3.0 mm and z_F -74.66 and -81.66 mm, the fifth at the contact point (z_F -78.16). Every tip is printed whole: no tongue pocket, lip groove or screw hole, so its attachment is part of this design. The current DIP link's tongue (x_F -7.35..-4.75, to z_F -72.1) would run into the proximal magnet pockets (z_F -73.16 and below).

## Joint ranges, loads, fasteners and printer

- PIP range: model -18..92°; driver calibration finger 0 -18..86.72°; finger 1 -2.93..92°; finger 2 -16.11..77.05°.
- Design loads: 10 N normal and 5 N tangential at the contact point, 1 N on the cable. HOM cells on the CAD hand reach 0.18 N m at a joint (summary.json cells, peak_tau_Nm), 6.8 N at the 26.61 mm from the PIP axis to the contact point; the D6 policies grip the screwdriver with 11.6-18.2 N in total (summary.json policies, grip_N).
- Fastener holes in the CAD: 1.60 mm, the four horn-arm screw holes of the DIP link (y -20.15, z -58.05..-66.05); 1.80 mm, servo-tab pilot holes, M2 thread-forming (carriage, yaw link, MCP link); 2.30 mm, the horn's centre screw (DIP link, y -22.45); 2.40 mm, M2 clearance (carriage rail block); 3.30 mm, M3 clearance: the DIP plate's screw into the CAD insert; 5.20 mm, the slotted bore for the 5 mm shaft. The board's holes take M2 (0.20 mm radial clearance) or M1.6 (0.40 mm); R10 sets the materials. Catalogue sizes: M2 cheese head 3.8 x 1.3 mm, M1.6 cheese head 3.0 x 1.0 mm, M2 nut 4.0 mm across flats x 1.6 mm, M2 x 3 brass insert 3.6 mm outside in a 3.2 mm hole.
- Printer: Original Prusa XL 5T (five toolheads, 0.4 mm nozzles, 360 x 360 x 360 mm); PLA or PETG for rigid parts; TPU 85A and PLA or PETG can share one print (five tools); links as built: PLA at 15 % infill (owner, 2026-10-13).
- Mass: DIP link 4.92 g, board 0.64 g.

## Candidate clamps

- Sandwich through the board's holes, screws from the component side: Dorsal backing plate (part of the DIP link) with brass inserts; the board on it located by two printed pins; a 0.9 mm shim frame over the component side with windows; M1.6 or low-head M2 screws through the shim and the board's holes into the inserts. The heads (3.0-3.8 mm) sit at |y| 6.1-9.9 mm and overlap the tip's 14.8 mm width by 0.9-1.3 mm: the tip needs four notches at its back edges, or narrower heads. For: preload on all four corners; board and shim stay when the tip comes off. Against: tip notches; screw heads beside the tip.
- Sandwich with screws from the dorsal side into the frame: Screws through the backing plate and the board into bosses of a component-side frame beside the tip; the bosses (3.2-5.6 mm) overlap the tip's width by 1.0-2.2 mm. For: heads on the dorsal side. Against: bosses beside the tip widen the contact footprint or need tip notches.
- Edge clamp without the holes: The board slides into a pocket of the backing plate; lips over its outer 1.4 mm (|u| 8.6-10.0 mm, clear of U3 and U5, which reach |u| 8.5 mm) and a screwed bar across the proximal margin preload it. For: no screws near the chips. Against: lips add 0.8-1.0 mm per side; preload depends on the lip's stiffness.
- Rigid frame co-printed with the tip: A PLA or PETG frame printed with the 85A tip at its back edges and mount face; the board is sandwiched between this frame and the DIP link's backing plate, located there by pins. For: one set of screws locates tip and board. Against: the board's clamp opens at each tip exchange; TPU-PLA interface strength unmeasured.

## Owner decisions

- Tab: cut the connector tab and solder four wires to it, or keep J1 and flip the board (chips away from the tip: sensing plane 1.08 mm, four-magnet 30 % resolution 0.205 N against 0.173 N at the touch placement).
- Recessed chips: pockets in the TPU's back face for the chips and capacitors put the sensing plane 0.48 mm inside the back face (four-magnet 30 % resolution 0.134 N; static field at U1 6.53 mT, GAIN_SEL 5); the tip's outer surface stays, its back face changes.
- Tip notches: whether the tip's back edges may be notched for screw heads or bosses beside the board's holes.
- Thinner TPU behind the magnets (moving the board into the tip's volume) changes the tip's stiffness and needs new finite elements; this specification keeps the tips' 17.0 mm depth.
- Fasteners: the screws, inserts and nuts in stock (M1.6, M2; brass, nylon or titanium).

## Pending measurements

- Board thickness and part heights on the owner's board (FR-4 0.6 mm nominal; chips 0.80-1.00 mm; J1 about 2.9 mm).
- Flatness of a printed 85A tip's back face (printed on the bed) and its mount face.
- The cable: wire gauge and outer diameter, and where it leaves the MCP link.
- The PIP servo's own cable route (not in the CAD).
- The field of the PIP servo's motor at the chips over the PIP range (bench: five chips read with the tip unloaded while the PIP joint moves through its range).
- Retention and creep of the board clamp: zero-load field before and after 50 presses at 3 N and after 1 h at 5 N.
