badinkajink/hand/docs/experiments/20261104-cad_v3_hand/analysis/current/spec.md

# Current simulator hand model and the specification of the simplified cad_v3 model

Task "current" of the cad_v3 workflow, 2026-11-04. Analysis only: files were written in this folder and nowhere else.
The scratch scripts and their outputs sit beside this file:

- `probe_scenes.py` compiles the current scenes and writes `probe_scenes.json`;
- `yaw_centres.py` computes the CAD fingers' joint axes from `parts.json` and writes `yaw_centres.json`;
- `bbox_views.py` plots the CAD parts' bounding boxes in `bbox_views.png`.

A mesh render was not made: the resource gate stayed closed on swap (15.5 GB in use against its 15 GB limit).
`render_A.py` renders the hand's meshes in four views and is ready to run under `resguard.sh run --mem 3G`.

## Summary

A drop-in cad_v3 keeps the cad_v2 scene's 21 bodies, 25 joints, 15 actuators and 31-entry qpos vector as they are.
The shared generator indexes that vector by position. About 40 active scripts match names on a finger prefix, and five
of the HOM and clearance scripts assign a geom to a finger that way. Every new part therefore goes on `palm_pose` as
static geometry, named without a finger prefix.

The CAD fixes two numbers that the current models guessed. The yaw-centre plane, the origin of the palm frame P, lies
103.9 mm below the UR5 flange face; the UR5e arm scene used 100 mm. The lowest gantry surface near the palm centre is
24.4 mm above that plane; cad_v2's `palm_plate` underside is at 23.5 mm. The plate's 170 x 180 mm footprint covers 29 %
of the 337 x 312 mm footprint of the real gantries and plates.

The flange-to-palm transform needs one parameter that no current model has: the clocking k of the UR5 adaptor, one of
four positions 90 deg apart. The arm scene fixed it by assumption.

## Terms and frames

- **A**: the frame of the owner's assembly "hand v3 (anthro config)", mm. z_A points up toward the robot. The base
  plate occupies z_A 0..3, the robot mount 3..28, the gantries -54..0.
- **P**: the palm frame of the simulator and of the hand driver ({P} in `manta_hand/kinematics.py` and `plan.py`).
  The origin lies on the plane of the three yaw-axis centres, x_P points from the thumb to the pair, y_P from the
  middle finger to the index, z_P up; the fingers hang along -z_P.
- **E (tool0)**: the UR5 tool flange frame, origin on the flange face, z_E out of the flange toward the tool. In the
  lab's URDF (`~/Programs/rh56_controller/magpie_force_control/src/ur_description/ur5.urdf`), tool0 equals
  `wrist_3_link`: the chain wrist_3 -> flange -> tool0 composes to the identity (computed here from its rpy values).
- **qpos**: MuJoCo's generalised position vector; **nq** its length. A free joint takes 7 entries (position, wxyz
  quaternion), a slide or hinge one.
- **Morph slides**: the passive slide joints `<f>_x` and `<f>_y` that place finger f's mount in P.
- **Bridge**: the moving cross-beam of a finger's gantry. It spans the gantry along y_A and rides on the frame's x-axis
  leadscrew. The y-axis stepper, leadscrew and rail are mounted on it, and the finger's carriage rides along it.
- **Static geom**: a geom on `palm_pose` itself, which moves only with the palm.

## The current model and how it is built

The model in use is `assets/mjcf/experimental/20261030-cad_v2/scene_screwdriver_medium.xml`
(`scripts/build_cad_v2_finger.py`). It is cad_v1's scene (`scripts/build_cad_v1_finger.py`, `write_scene`) with the
v4b fingertip's DIP link, cassette and trimmed cap in `<f>_pip_frame`. cad_v1's scene is real_v1's
(`assets/mjcf/real_v1/scenes/scene_screwdriver_medium.xml`, `scripts/build_real_v1_scenes.py`) with the finger bodies
replaced. The palm, the object, the floor, the actuators and the keyframes come unchanged from real_v1. The tips have
no geoms in the file; `reorient_backends.replace_tips(..., "tcd_ell7.4x8.5x11x22", ...)` adds the pads at use.

Measured on the compiled models (`probe_scenes.json`):

| model | nq | nv | nu | nbody | ngeom | contact excludes | keyframes |
|---|---|---|---|---|---|---|---|
| `real_v1/real_hand.xml` (hand only) | 18 | 18 | 9 | 20 | 14 | 21 | open |
| `real_v1/scenes/scene_screwdriver_medium.xml` | 31 | 30 | 15 | 21 | 15 | 21 | open_ik, open |
| `20261030-cad_v2/scene_screwdriver_medium.xml` | 31 | 30 | 15 | 21 | 1371 | 39 | open |

The CAD hand v3's fingers have cad_v2's kinematics. From the 10.2 mm bearing bores in `parts.json`, the yaw-to-MCP
distance is 20.750 mm and the MCP-to-PIP distance 30.800 mm on all three fingers. cad_v1's `assembly.json` gives the
same two values. The yaw bore axes are tilted 0.93 deg out of the horizontal (z-component 0.0162). The same 0.925 deg
rotation was measured in cad_v1's carriage STL and removed there as an export artefact.

## Names and qpos layout that other code reads

Bodies: `palm_pose` (a direct child of the world body), `<f>_mount`, `<f>_yaw_frame`, `<f>_mcp_frame`,
`<f>_len_frame`, `<f>_pip_frame`, `<f>_tip` for f in thumb, index, middle; the object body `screwdriver_medium`
(`reorient_backends.OBJ`; every replaced object keeps this name); `post` in HOM scenes.

Joints: `palm_px`, `palm_py`, `palm_pz` (slides), `palm_rx`, `palm_ry`, `palm_rz` (hinges); per finger `<f>_x`, `<f>_y`,
`<f>_yaw`, `<f>_mcp`, `<f>_len`, `<f>_pip`. The `<f>_len` slide is a zero-travel shim: its range "0 0" compiles as
unlimited (`jnt_limited` false), and it exists only for the generator's index layout.

Actuators: `a_palm_px` .. `a_palm_rz` (class `pose`: kp 4000, kv 100) and `a_<f>_yaw`, `a_<f>_mcp`, `a_<f>_pip` (class
`ctrl`). `scripts/apply_measured_plant.py` rewrites the plant through the `ctrl` default class.

Geoms: `palm_plate`, which must stay the first geom child of `palm_pose` (`real_v1_d1_continuation.palm_plate` asserts
this); `floor`; `<f>_tipgeom` and `<f>_pad<i>` (added by `replace_tips`); the CAD spheres `<f>_<part>_s<i>` and visuals
`<f>_<part>_visual`.

Sites: `workspace_thumb`, `workspace_index`, `workspace_middle` (visual); the RL builder adds `palm_pose_site`, the arm
scene `palm_site`. Default classes: `pose`, `morph`, `ctrl`, `cad_visual` (group 2), `cad_collision` (group 3),
`cad_pad` (group 4). Keyframes: `open` and `open_ik` (the grasp, written per design). The generator copies the `open`
key's first 13 values and its finger angles into every baked design. Without an `open` key of at least 31 values it
writes the baseline hand's default angles.

Name conventions read by code:

- A geom belongs to finger f when its body name, or an ancestor's, starts with f. `hom_tasks.Plant`, `hom_gpu`,
  `hand_object_scale_sim.hold_rollout`, `hand_object_scale_kin.cmd_verify` and `real_v1_trajectory_clearance.finger_geoms`
  use this. A grep of `scripts/` and `src/` finds about 40 active files that call `startswith` on a finger name.
- `hom_gpu` treats a geom whose name contains `_pad` as a fingertip pad, and a geom matching
  `_(dip_link|cassette|cap)_s\d+$` with radius under 2 mm as a fine tip sphere.

The qpos layout of the scene with morph slides (nq 31):

| qpos | entries |
|---|---|
| 0-6 | object free joint (position 0-2, quaternion 3-6) |
| 7-12 | palm_px, palm_py, palm_pz, palm_rx, palm_ry, palm_rz |
| 13-18 | thumb_x, thumb_y, thumb_yaw, thumb_mcp, thumb_len, thumb_pip |
| 19-24 | index_x, index_y, index_yaw, index_mcp, index_len, index_pip |
| 25-30 | middle_x, middle_y, middle_yaw, middle_mcp, middle_len, middle_pip |

The generator (`morphohand.tools.morphology_xml`) bakes a design by adding (x, y) to `<f>_mount`'s pos and len to
`<f>_len_frame`'s pos. It then removes the nine morph joints and keeps qpos indices 2, 3, 5, 8, 9, 11, 14, 15, 17 of the
18-entry finger block. A rigid scene has nq 22 (13 + 9); `rl/reference_trajectory.py` slices it as 0:7, 7:13, 13:22.
A hand-only file has nq 18. The scene test is the presence of a joint named `palm_px`. Any added joint shifts these
indices or leaves keyframes the wrong length, and MuJoCo then refuses to load the generated file.

## The palm body and the palm plate

`palm_pose` sits at (0, 0, 62.5) mm in the world with gravcomp 1. Its only geom, `palm_plate`, is a 170 x 180 x 3 mm box
(x_P by y_P) centred at z_P +25 mm. Its underside is at 23.5 mm and its top at 26.5 mm. Its mass, 0.0918 kg, comes from
the default density of 1000 kg/m^3. The palm subtree weighs 0.354 kg in cad_v2 and 0.222 kg in real_v1. The `open`
key of cad_v2 adds 20.05 mm to palm_pz: 10 mm from real_v1's key and the 10.05 mm `palm_raise_m` for the longer CAD
finger. At that key the palm origin is 82.55 mm above the floor.

The plate is used in the following places:

1. It stands for the palm underside in contact with the object and the floor. The floor plane collides with it, so a
   lowered or tilted palm meets the table there.
2. `hand_object_scale_kin.PLATE_BOTTOM` = 23.5 mm is the analytic plate. A grasp is feasible only with at least 1 mm
   of object-to-plate clearance; `workspace` keeps the object's top below it; `verify` checks the analytic clearance
   against `mj_geomDistance` to the geom named `palm_plate`.
3. The RL bracing reward reads the contact sensor `palm_cube_contact`, which matches every geom on `palm_pose`
   (`rl/env_build.py`). `rl_contact_eval.py` counts palm contacts the same way.
4. `real_v1_d1_continuation.py` and `real_v1_diffmjx_gate.py` switch the first palm geom's collisions off, since MJX 3.6
   has no cylinder-box test, and assert that the held state has no plate contacts.
5. The workspace sites are drawn on its top face (z_P 28 mm).

Contact excludes: `palm_pose` is excluded against `<f>_yaw_frame`, `<f>_mcp_frame`, `<f>_len_frame`, `<f>_pip_frame`
and `<f>_tip` (15 pairs from real_v1) and against `<f>_mount` (3 pairs added by cad_v1). Every geom placed on
`palm_pose` is therefore invisible to the fingers. The CAD carriage stands inside the gantry by construction: its
collision spheres in cad_v2 reach z_P 68.2 mm, and the v3 carriage part reaches 65.0 mm.

## The morph slides and the driver's {P}

The sim's mount positions, converted from metres to millimetres, are {P} coordinates: thumb (-50, 0), index (50, 55),
middle (50, -55). `tests/test_manta_frame_map.py` pins `REAL_V1_MOUNTS` equal to `kinematics.FINGER_GEOMETRY`. Each
slide's zero is the centre of that finger's travel.

| sim joint | range (mm) | driver local axis | firmware axis | mechanism in the CAD |
|---|---|---|---|---|
| `<f>_x` | +-30, all three | q_Fx | J1, J3, J5 (firmware "y") | carriage along the bridge, along y_A |
| `<f>_y` | +-55 thumb, +-30 pair | q_Fy | J0, J2, J4 (firmware "x") | bridge along the frame, along x_A |

Firmware positions follow `_TRANSFORM`. For the thumb, J0 = 55 + local y and J1 = 30 + local x. For the index,
J2 = 30 - local y and J3 = 30 - local x. For the middle finger, J4 = 30 + local y and J5 = 30 - local x. Each axis
travels its nominal range from its homed hard stop: 110 mm on J0, 60 mm on J1-J5.

The CAD is consistent with this assignment. The thumb's frame is 160 mm long along x_A, its leadscrew 150 mm, and its
110 mm axis is J0. Each finger's yaw centre lies on its bridge's y-leadscrew axis in x_A, within 0.1 mm (bounding-box centres).

## P in the CAD frame A

Measured from `parts.json`:

- The three yaw centres lie at z_A = -75.9 mm, so z_P = z_A + 75.9 mm.
- The yaw axes run along y_A; the sim's yaw axis is x_P. The thumb (finger v3 <3>, mirrored yaw axis) sits at
  y_A 159.6 mm, the pair at 80.1 and 83.1 mm. Hence x_P = -y_A.
- The design is symmetric about x_A = -111.0 mm. The thumb frame's centre lies there, as does the midpoint of the pair
  frames (-55 and -167), the centres of the base plate and robot mount, and the adaptor's bolt circle. If the travel
  centres share that symmetry, y_P = 0 at x_A = -111.0.

Inferred: with both frames right-handed and z up, y_P = +x_A. P is then A turned by -90 deg about z_A, and the index is
the finger on gantry <1> (x_A -110..0, finger v3 <2>). This needs the owner's confirmation; see the open questions.

Not yet known: the x_P origin, which is the travel centre of the carriages along y_A. The CAD's anthro configuration is
a compact layout (thumb to pair 78 mm, index to middle 77 mm), so its finger positions are not the travel centres. The
frames meet at y_A = 120.2 mm, and the robot mount is centred at y_A 121.4 mm.

The gantry levels in P, from the bridges' downward planar faces and the part bounding boxes:

| surface | z_A (mm) | z_P (mm) |
|---|---|---|
| y-stepper and bridge end, outer end of each bridge | -54.0 | 21.9 |
| bridge bosses at both ends of the y-leadscrew, 86.8 mm apart; the inner ones 8.7-8.8 mm from y_A 120.2 | -51.5 | 24.4 |
| y-leadscrew underside | -46.8 | 29.1 |
| bridge main underside | -28.5 | 47.4 |
| gantry frame underside | -22.0 | 53.9 |
| base plate underside (frame top) | 0.0 | 75.9 |
| robot mount top, adaptor flange face | 28.0 | 103.9 |

The flange axis passes through (-111.0, 116.0) mm in A. That is 4.2 mm from the frames' meeting line and 5.45 mm from
the plates' centre, toward the pair.

## Code that breaks when the palm body gains geoms or bodies

- `morphohand.tools.morphology_xml` and `scripts/generate_morphology_xml.py`: any new joint breaks the 13 + 18 layout.
  A new body that must follow a design is not moved; only `<f>_mount` and `<f>_len_frame` are.
- `hom_gpu.mocap_model`: `palm_pose` must stay a direct child of the world body, or it raises. Per-world layouts write
  `body_pos` of `<f>_mount` alone, so geometry outside `<f>_mount` does not follow the layout.
- `hand_object_scale_sim.cad_fingers` copies only the `<f>_mount` subtrees from the CAD scene into a palm built by
  `build_real_v1_scenes`. New `palm_pose` geoms would be dropped from every HOM scene unless it copies them.
- `hand_object_scale_kin`: `PLATE_BOTTOM` is a constant, and `cmd_verify` measures to the geom named `palm_plate`. A new
  palm geom that hangs below the plate is missing from the analytic feasibility test.
- `real_v1_trajectory_clearance.finger_geoms` walks up to a body whose name starts with a finger name. Gantry frames
  placed in `<f>_mount` would enter its 5 mm finger-to-finger gate: the two pair frames stand 2 mm apart at the nominal
  mounts.
- `hom_tasks`, `hom_gpu`, `hand_object_scale_sim`: geoms under `<f>_` bodies count as finger links in the
  object-clearance checks and in the finger force sums.
- `rl/env_build.py`, `rl_contact_eval.py`, `real_v1_turn_probe.py`: every geom on `palm_pose` counts as palm or plate
  contact, and the bracing reward changes meaning with it.
- `real_v1_d1_continuation.py`, `real_v1_diffmjx_gate.py`: only the first palm geom is switched off for MJX. A new box
  would meet the cylinder tool in a cylinder-box pair that MJX 3.6 lacks.
- `hom_chain.py` (gravity feed-forward) and `real_v1_bench_study.py` (payload) read the palm subtree mass. Mass added to
  `palm_pose` changes both. The pose actuators (kp 4000 N/m, kv 100 N s/m, armature 0.01 kg) move the palm subtree,
  0.354 kg in cad_v2. Their damping ratio is 1.31 there and falls to 0.68 with 1 kg more.
- Six tests `HAND == "cad_v2"` (in `hand_object_scale_kin`, `hand_object_scale_sim`, `hom_tasks`, `hom_gpu`,
  `fp_sr2_toy`) select the v4b tip and its scene paths. Two tests `HAND in ("cad_v1", "cad_v2")` select the CAD finger.
  A new value `cad_v3` misses all eight, and the value check of `hand_object_scale_kin` rejects it.
  `fingertip_shape_rerun_rig.py` (active hand-off) stops unless `SCALE_HAND=cad_v2` and stays as it is.
- `hand_object_scale_kin.morph_vector` hard-codes the nominal mounts (0.100 m thumb-to-pair, 0.055 m half-spacing).

Unaffected: code that reads only the pose of `palm_pose` (`fit_real_v1_pose.py`, `reorient_backends._palm_and_start`,
the RL observation and reward terms), as long as the palm frame stays where it is.
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
