badinkajink/hand/src/morphohand/driver/manta/docs/pinout.md

# Manta M8P V2.0 pin mapping used by this firmware

This project uses **TMC5160 drivers over a shared bit-banged SPI bus**.

STEP/DIR/EN pin assignments below are unchanged from BTT's official V2.0
pin mapping / Klipper config for this board (cross-checked via
`bigtreetech/Manta-M8P` GitHub docs and DeepWiki pin reference) -- only the
per-axis chip-select pin and the shared SPI bus are this project's own
addition. Verify against your own board silkscreen/schematic if anything
here seems off.

## Motor driver slots (M1-M8 -> joint index 0-7)
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
