badinkajink/hand/webpaper/src/assets/reorient_comparison.png

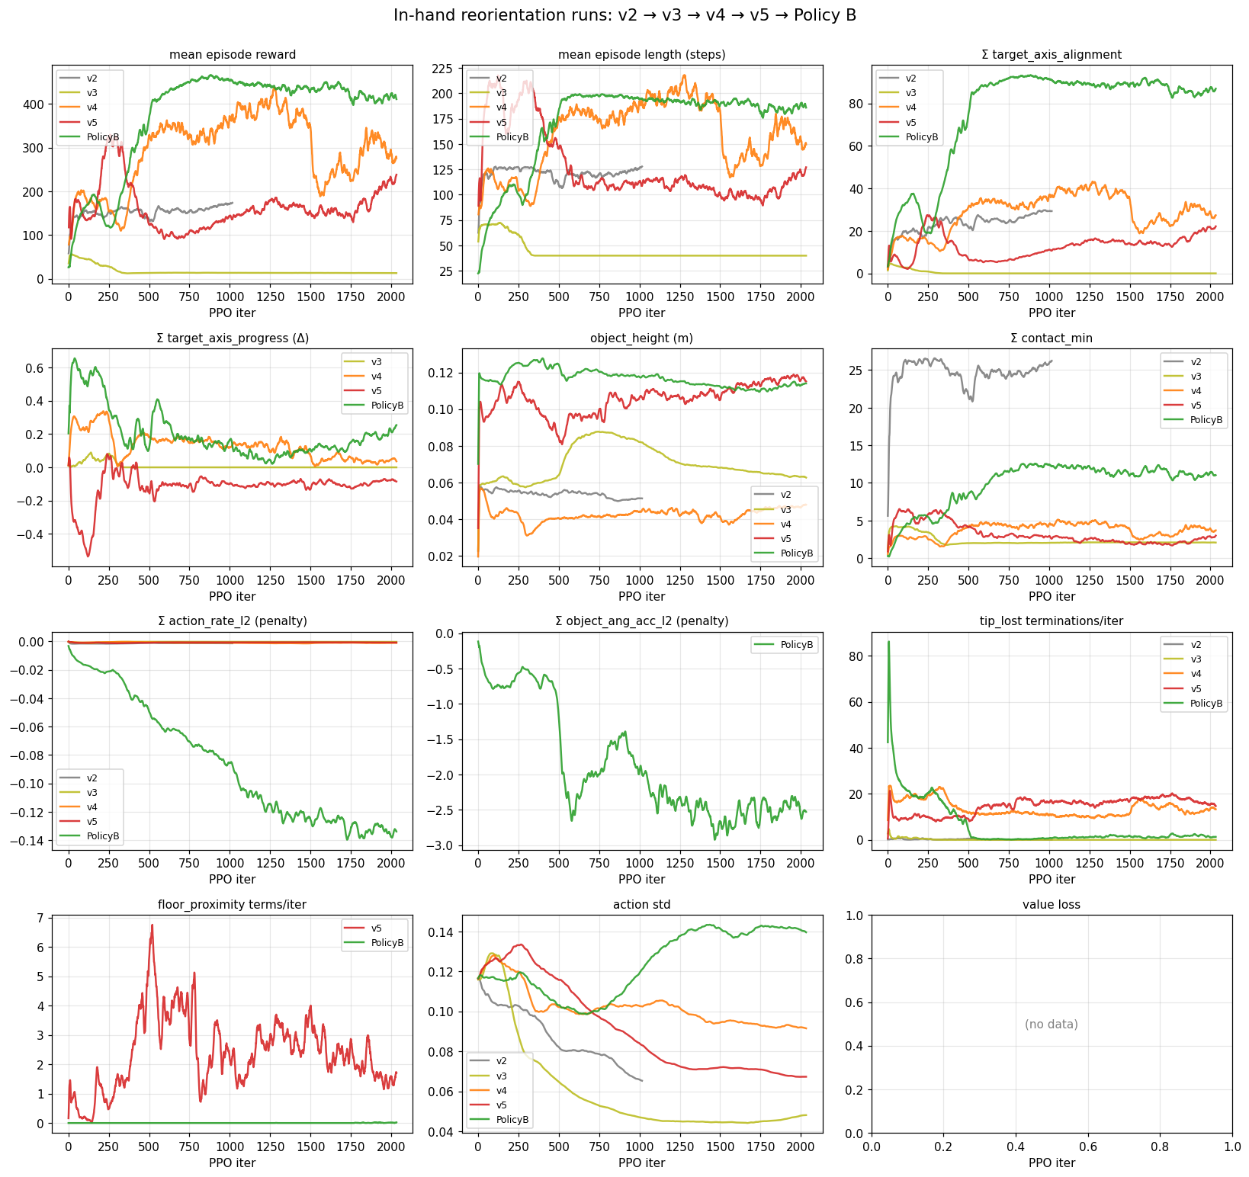
webpaper/src/assets/reorient_comparison.png
