badinkajink/hand/webpaper/src/assets/reorient_comparison_v2.png

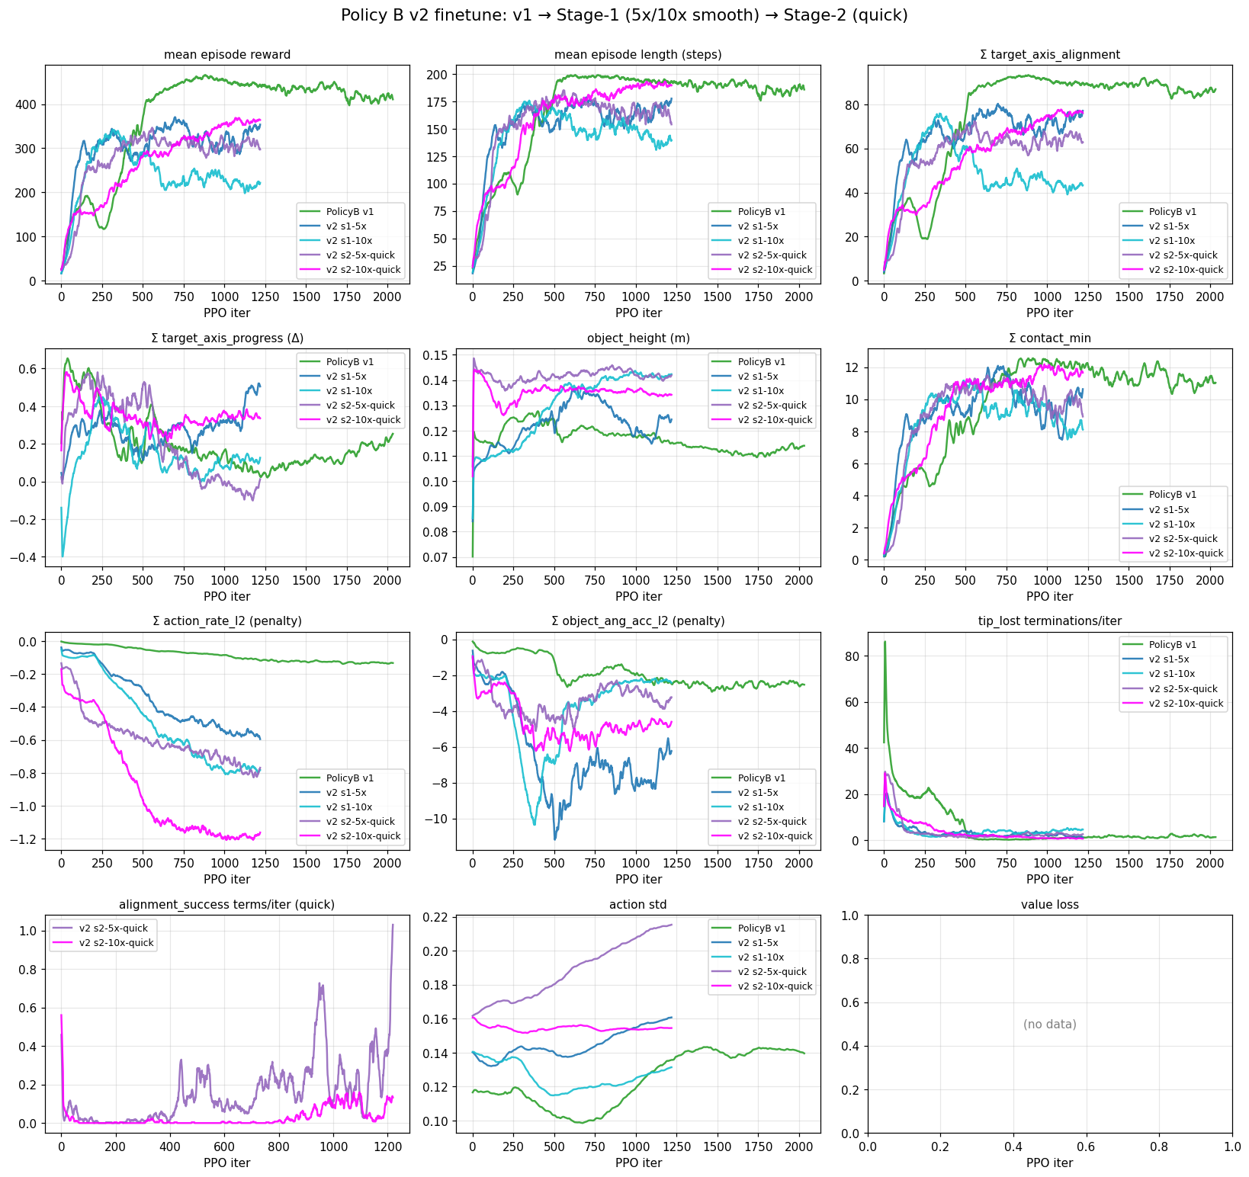
webpaper/src/assets/reorient_comparison_v2.png
