badinkajink/hand/webpaper/src/assets/scores.png

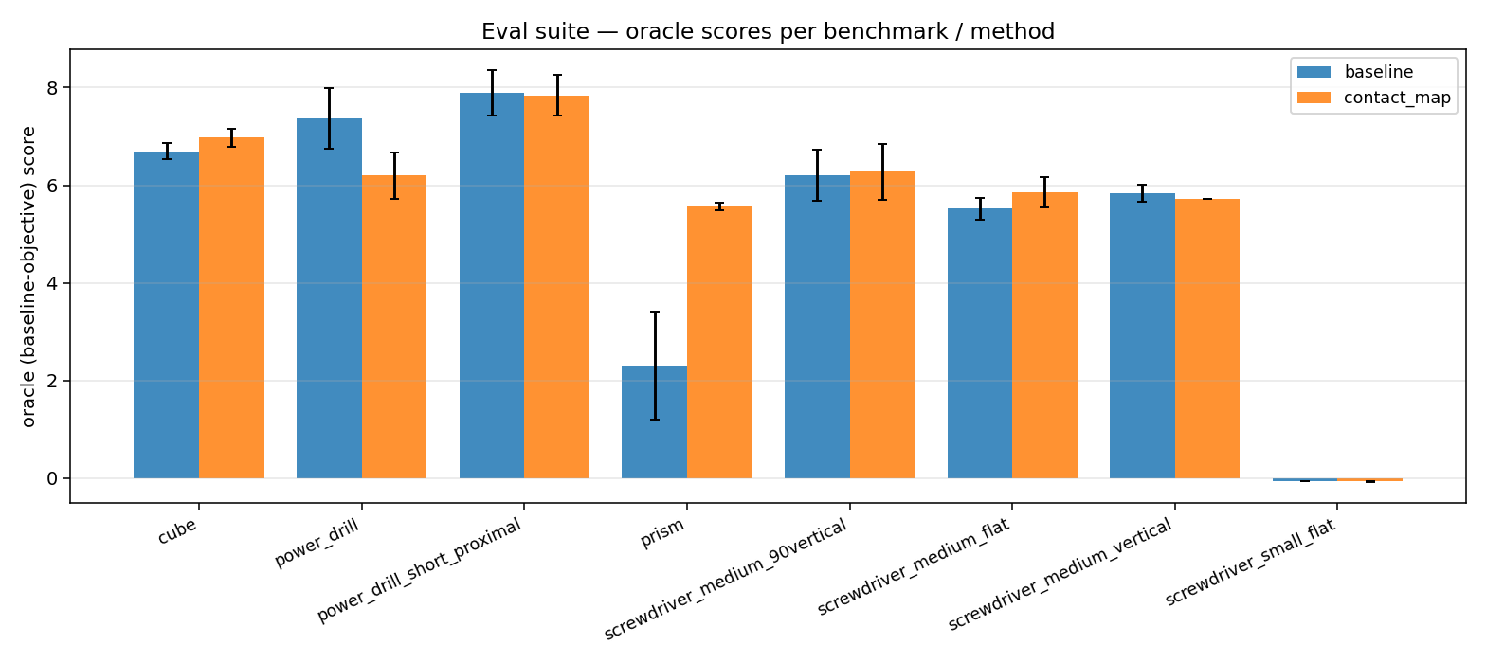
webpaper/src/assets/scores.png
