badinkajink/hand/webpaper/src/assets/variance_reduction_bands.png

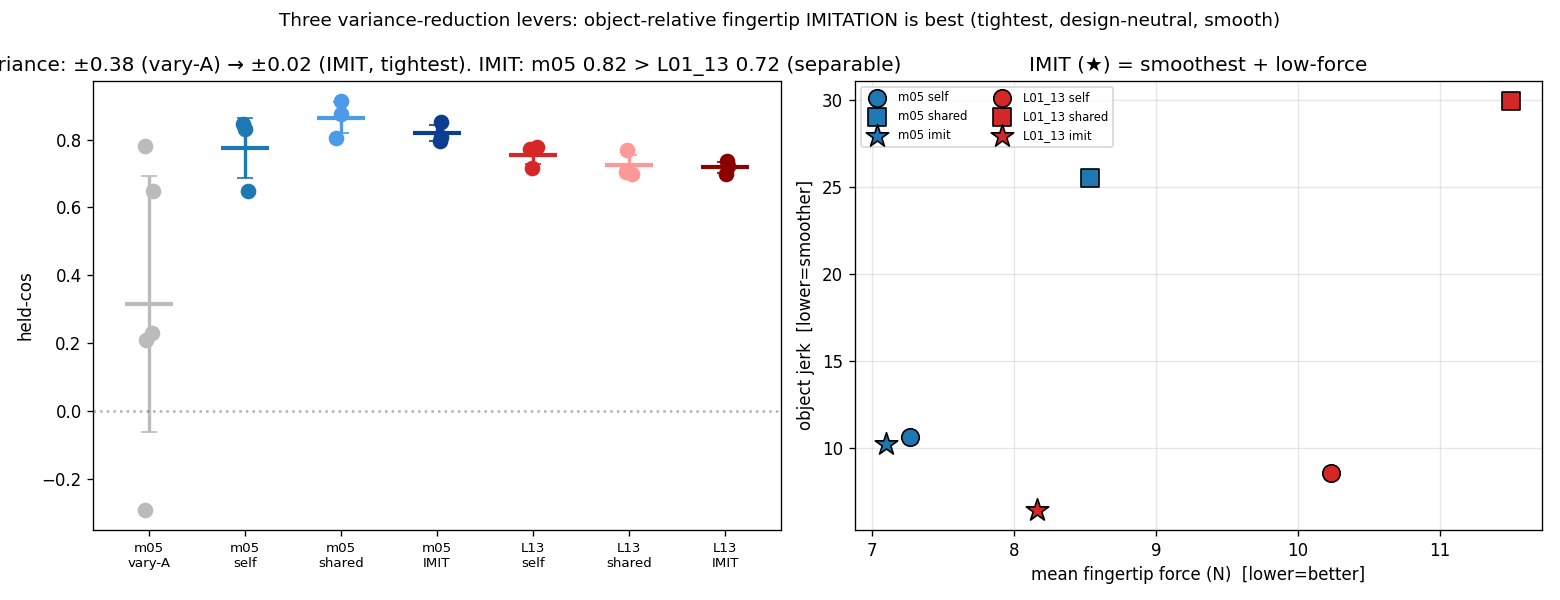
webpaper/src/assets/variance_reduction_bands.png
