badinkajink/hand/assets/mjcf/experimental/20261014-tip_codesign/tcd_rs2_re1_p0.2/cad_v1/meshes/tcd_rs2_re1_p0.2/tcd_rs2_re1_p0.2_neg.obj

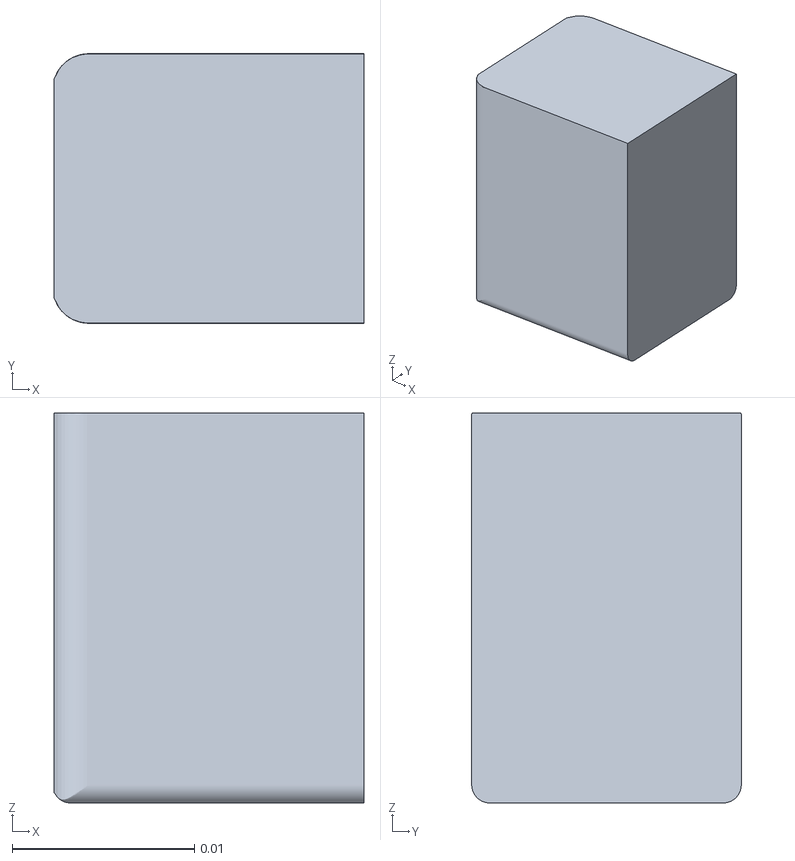
[picture p5: CAD file, 2026-10-15]
assets/mjcf/experimental/20261014-tip_codesign/tcd_rs2_re1_p0.2/cad_v1/meshes/tcd_rs2_re1_p0.2/tcd_rs2_re1_p0.2_neg.obj
0.017 x 0.0148 x 0.0214
