badinkajink/hand/assets/mjcf/experimental/20261014-tip_codesign/tcd_rs3_re6_p0.2/cad_v1/meshes/mcp_link.stl

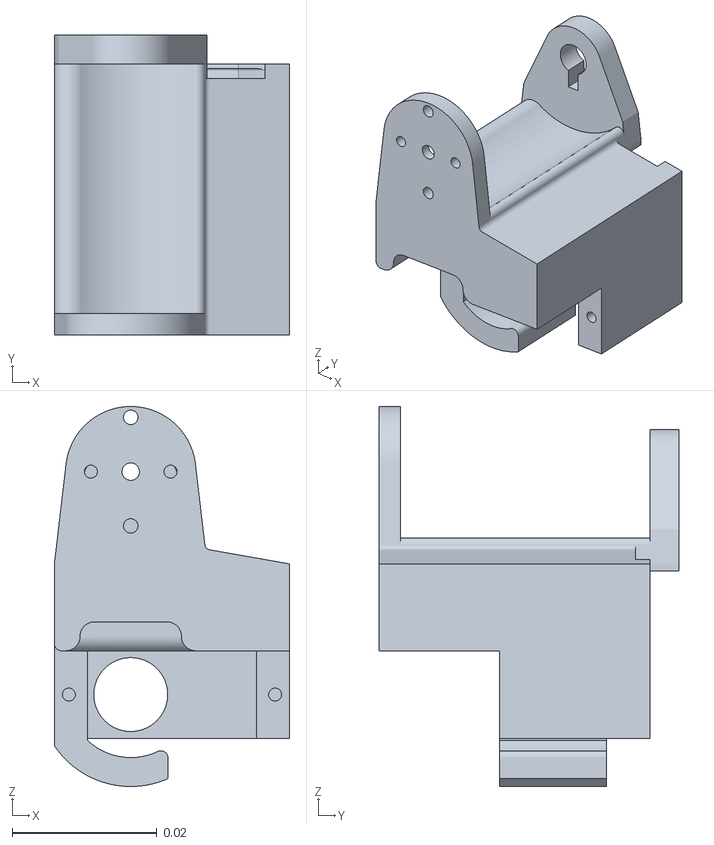
[picture p6: CAD file, 2026-10-15]
assets/mjcf/experimental/20261014-tip_codesign/tcd_rs3_re6_p0.2/cad_v1/meshes/mcp_link.stl
0.0325 x 0.0415 x 0.0525
