badinkajink/hand/assets/mjcf/experimental/20261014-tip_codesign/tcd_rs7.4_re10.5_p0.2/cad_v1/meshes/servo_yaw.stl

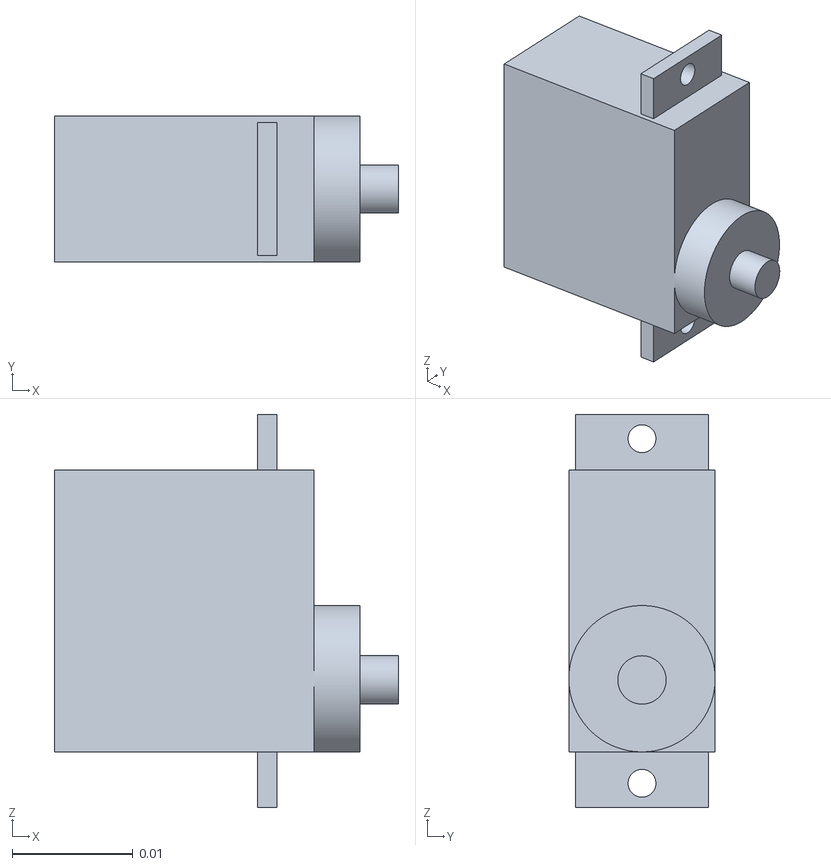
[picture p8: CAD file, 2026-10-15]
assets/mjcf/experimental/20261014-tip_codesign/tcd_rs7.4_re10.5_p0.2/cad_v1/meshes/servo_yaw.stl
0.0284 x 0.0121 x 0.0325
