badinkajink/hand/assets/mjcf/experimental/20261016-sim2real_fingertip_readiness/block4_g30/cad_v1/meshes/dip_link.stl

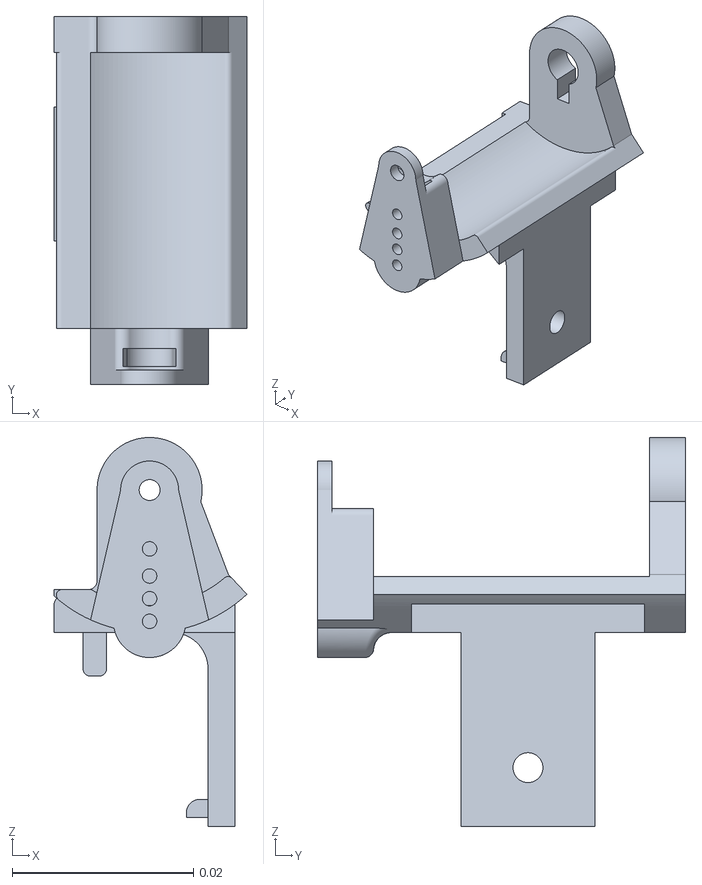
[picture p10: CAD file, 2026-10-17]
assets/mjcf/experimental/20261016-sim2real_fingertip_readiness/block4_g30/cad_v1/meshes/dip_link.stl
0.0213 x 0.0406 x 0.043
