badinkajink/hand/assets/mjcf/experimental/20261016-sim2real_fingertip_readiness/block5_g30/cad_v1/meshes/carriage.stl

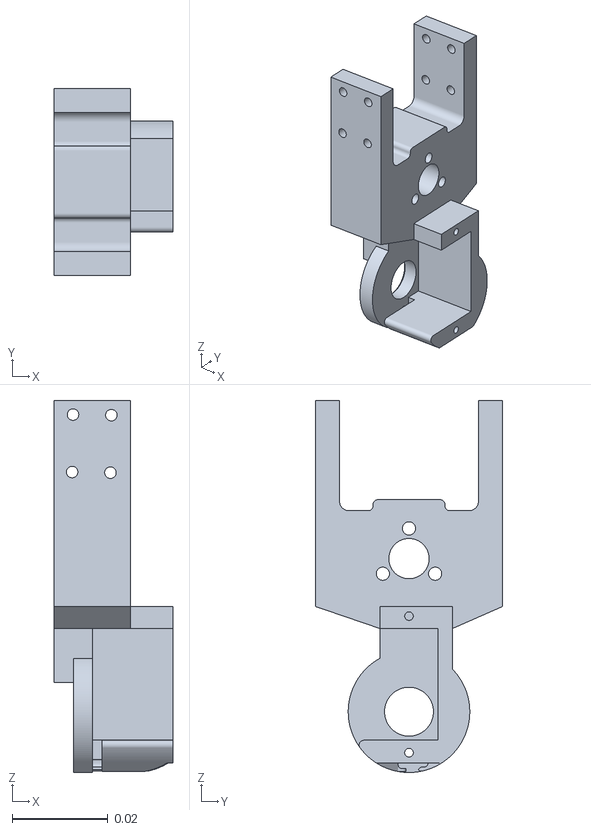
[picture p11: CAD file, 2026-10-17]
assets/mjcf/experimental/20261016-sim2real_fingertip_readiness/block5_g30/cad_v1/meshes/carriage.stl
0.0248 x 0.039 x 0.0776
