badinkajink/hand/assets/mjcf/experimental/20261016-sim2real_fingertip_readiness/block_e10/cad_v1/meshes/yaw_link.stl

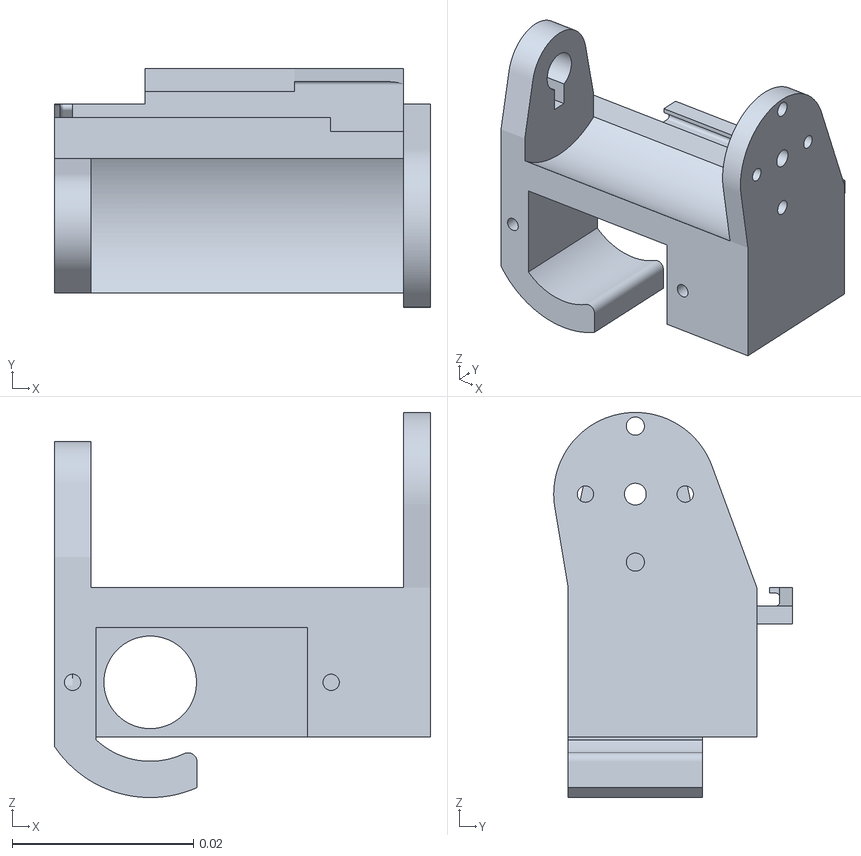
[picture p12: CAD file, 2026-10-17]
assets/mjcf/experimental/20261016-sim2real_fingertip_readiness/block_e10/cad_v1/meshes/yaw_link.stl
0.0414 x 0.0263 x 0.0424
