badinkajink/hand/assets/mjcf/experimental/20261016-sim2real_fingertip_readiness/ell11_g30/cad_v1/meshes/tcd_ell7.4x8.5x11x22_u0.1/tcd_ell7.4x8.5x11x22_u0.1_r0.25_pos.obj

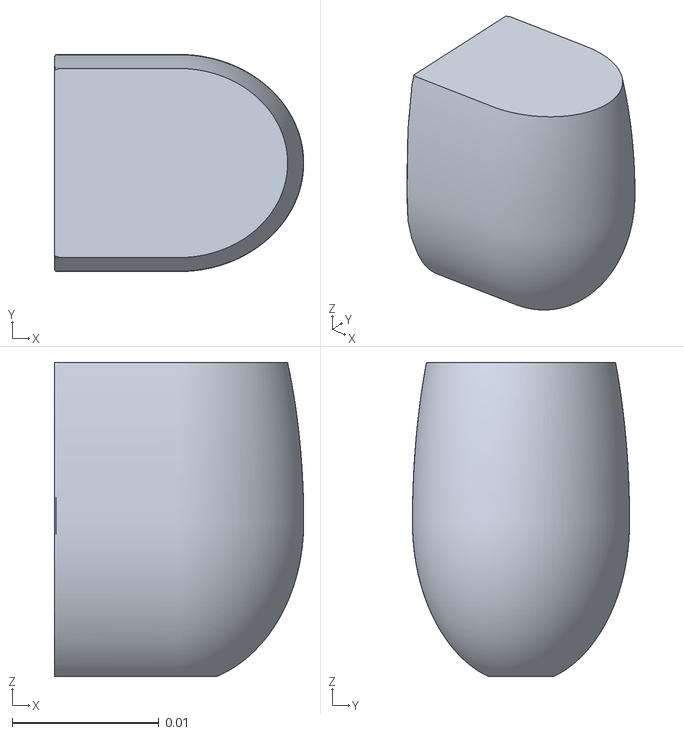
[picture p13: CAD file, 2026-10-17]
assets/mjcf/experimental/20261016-sim2real_fingertip_readiness/ell11_g30/cad_v1/meshes/tcd_ell7.4x8.5x11x22_u0.1/tcd_ell7.4x8.5x11x22_u0.1_r0.25_pos.obj
0.017 x 0.0148 x 0.0214
