badinkajink/hand/assets/mjcf/experimental/20261019-v2_finger/block5_g30_v2a/cad_v1/meshes/dip_link.stl

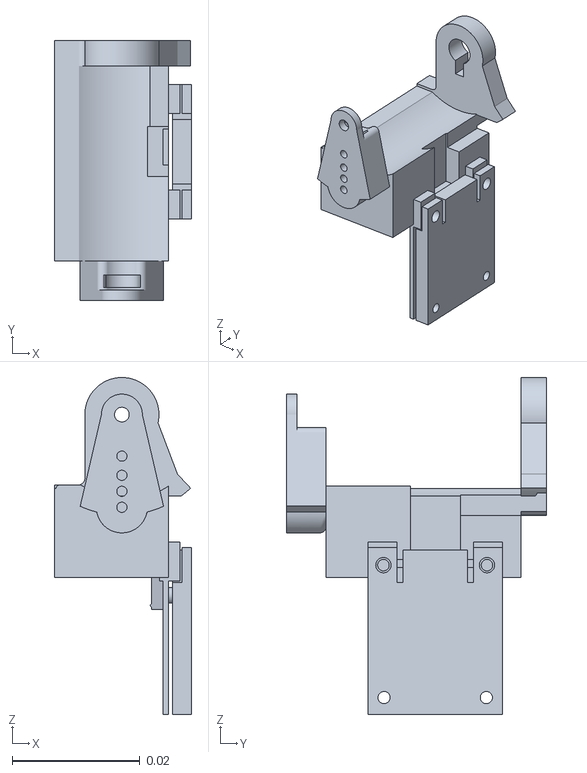
[picture p14: CAD file, 2026-10-20]
assets/mjcf/experimental/20261019-v2_finger/block5_g30_v2a/cad_v1/meshes/dip_link.stl
0.0214 x 0.0406 x 0.0527
