badinkajink/hand/assets/mjcf/experimental/20261019-v2_finger/ell11_g30_v2a/cad_v1/meshes/tip.stl

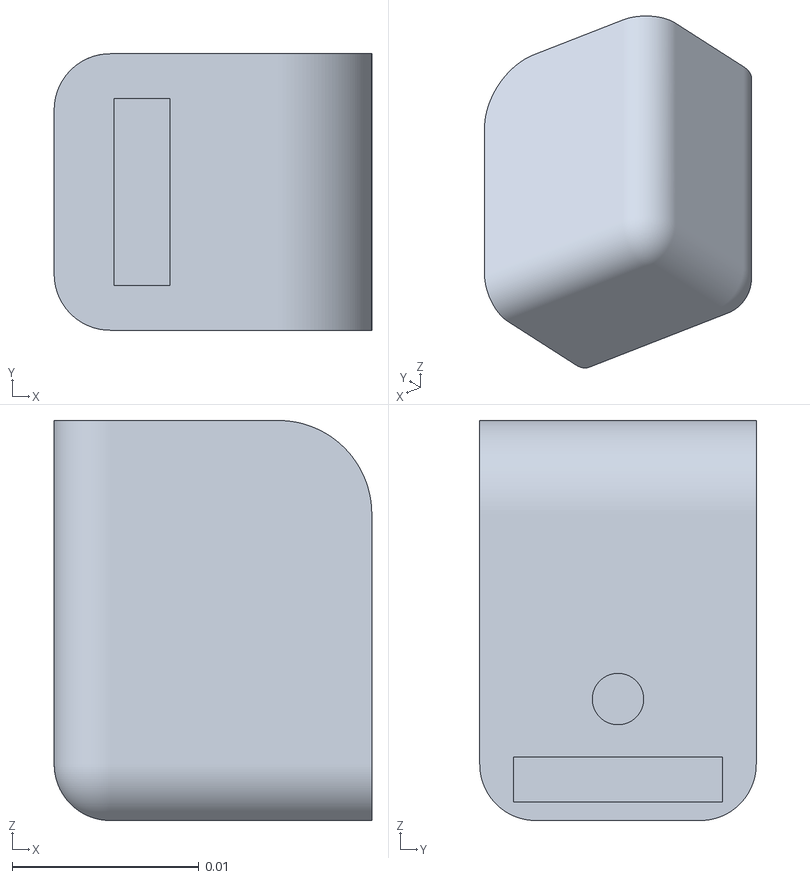
[picture p15: CAD file, 2026-10-20]
assets/mjcf/experimental/20261019-v2_finger/ell11_g30_v2a/cad_v1/meshes/tip.stl
0.017 x 0.0148 x 0.0214
