badinkajink/hand/assets/mjcf/experimental/20261030-cad_v2/meshes/v4b_cap.stl

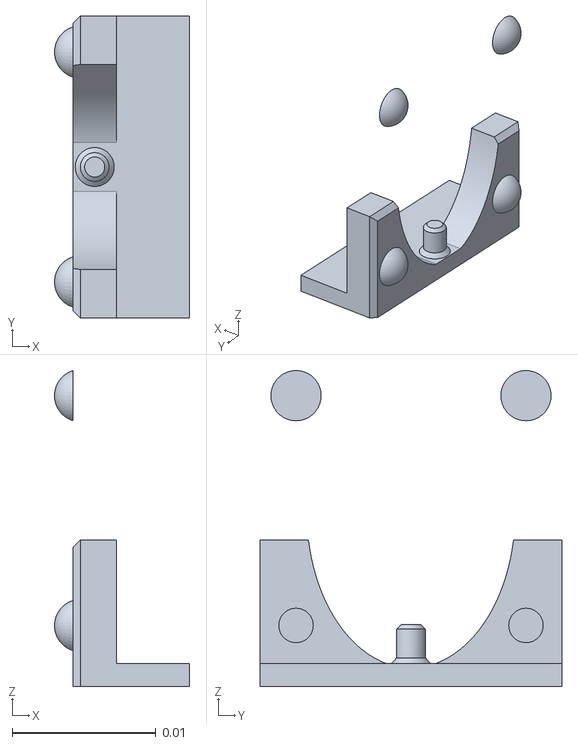
[picture p16: CAD file, 2026-10-30]
assets/mjcf/experimental/20261030-cad_v2/meshes/v4b_cap.stl
0.0094 x 0.021 x 0.022
