badinkajink/hand/docs/experiments/20261019-dip_link_fit_prints/stl/C30_board_carrier_chip30.stl

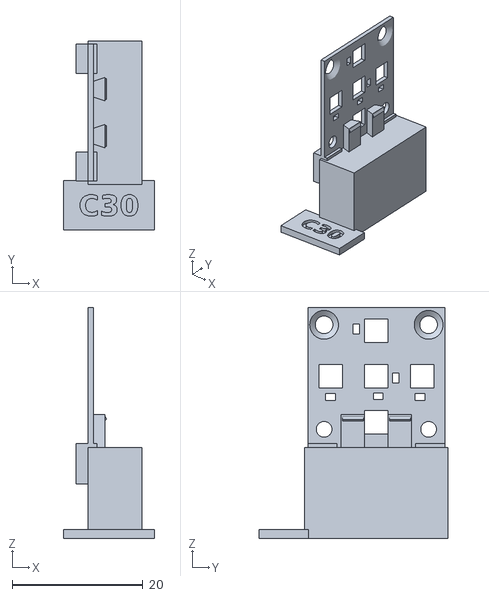
[picture p17: CAD file, 2026-10-19]
docs/experiments/20261019-dip_link_fit_prints/stl/C30_board_carrier_chip30.stl
14.0 x 29.0 x 35.4
