badinkajink/hand/docs/experiments/20261019-dip_link_fit_prints_b/stl/S55_seat_pocket55.stl

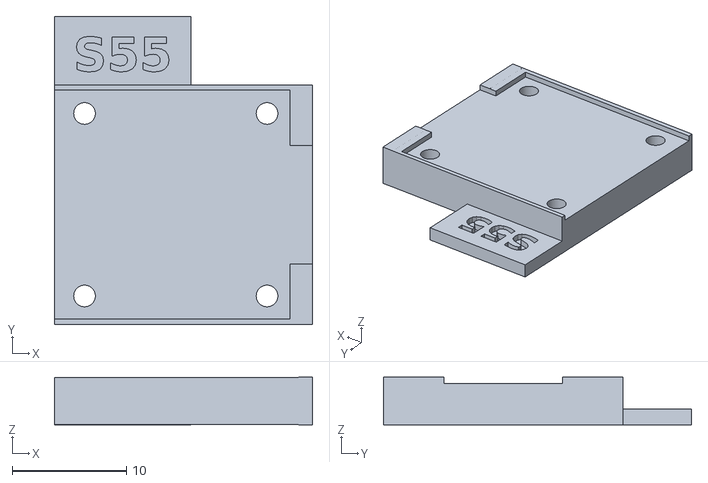
[picture p18: CAD file, 2026-10-20]
docs/experiments/20261019-dip_link_fit_prints_b/stl/S55_seat_pocket55.stl
22.7 x 27.0 x 4.17
