badinkajink/hand/docs/experiments/20261020-ur5_calibration_mount_v2/print/U1_ur5_adapter_v2.stl.stl

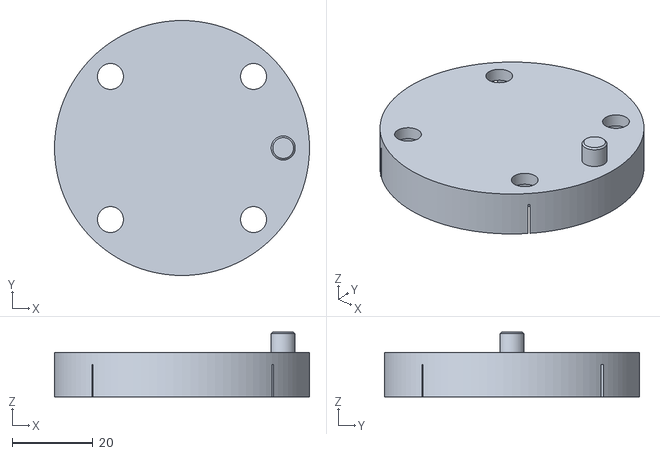
[picture p19: CAD file, 2026-10-22]
docs/experiments/20261020-ur5_calibration_mount_v2/print/U1_ur5_adapter_v2.stl.stl
63.0 x 63.0 x 16.0
