badinkajink/hand/assets/mjcf/experimental/20261030-cad_v2/meshes/v4b_cassette.stl

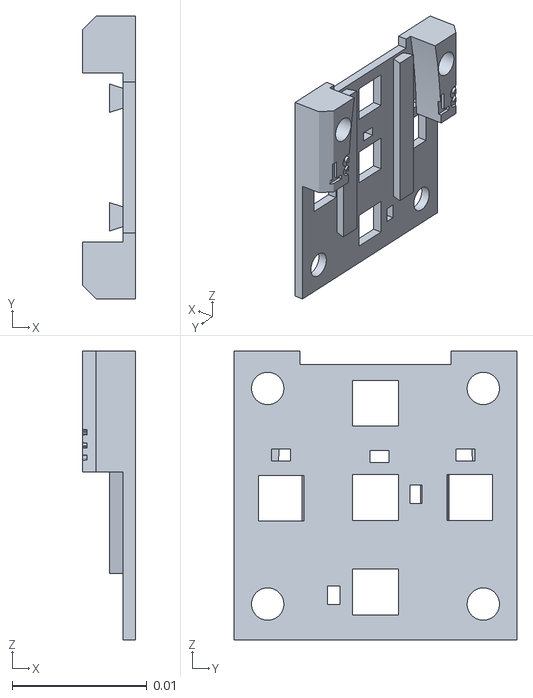
[picture p20: CAD file, 2026-10-30]
assets/mjcf/experimental/20261030-cad_v2/meshes/v4b_cassette.stl
0.0039 x 0.021 x 0.0214
