badinkajink/hand/docs/experiments/20261019-dip_link_fit_prints_b/stl/N_neck_carrier.stl

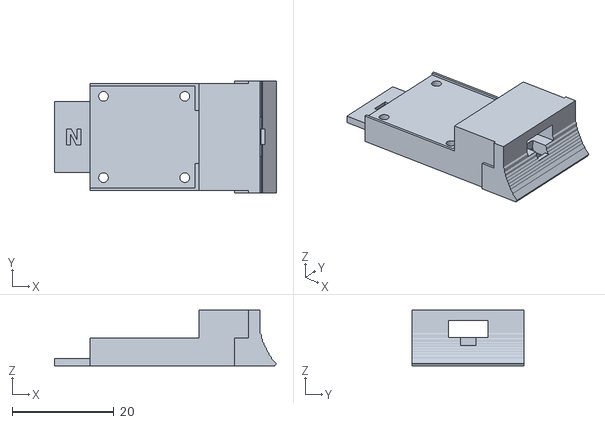
[picture p21: CAD file, 2026-10-20]
docs/experiments/20261019-dip_link_fit_prints_b/stl/N_neck_carrier.stl
43.7 x 22.0 x 10.9
