badinkajink/hand/docs/experiments/20261020-ur5_calibration_mount_v2/print/U3_ur5_clamp_plate.stl.stl

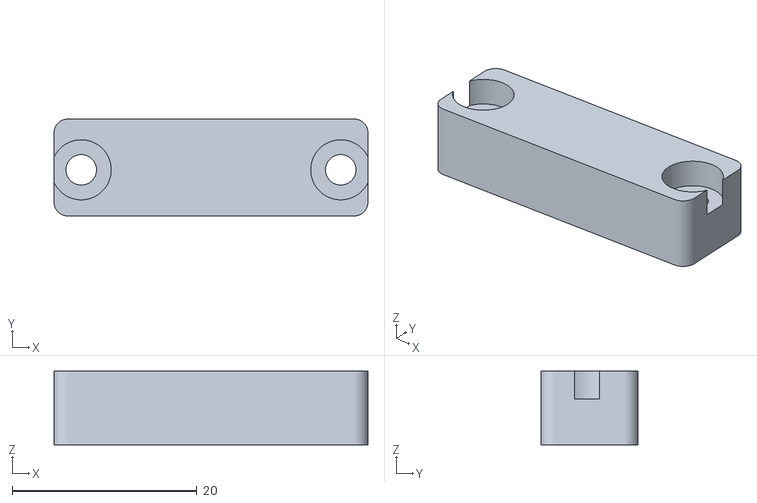
[picture p22: CAD file, 2026-10-22]
docs/experiments/20261020-ur5_calibration_mount_v2/print/U3_ur5_clamp_plate.stl.stl
34.0 x 10.5 x 8.00
