badinkajink/hand/docs/experiments/20261019-dip_link_fit_prints_b/stl/S35_seat_pocket35.stl

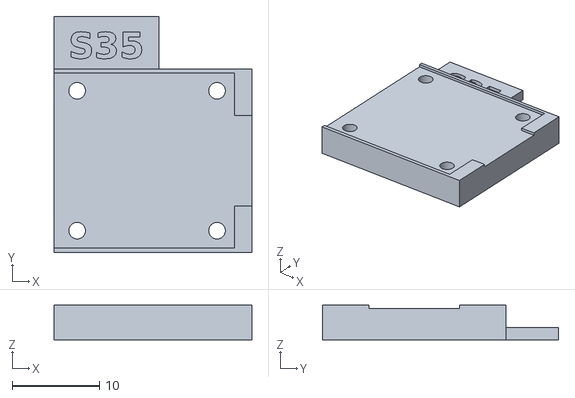
[picture p23: CAD file, 2026-10-20]
docs/experiments/20261019-dip_link_fit_prints_b/stl/S35_seat_pocket35.stl
22.7 x 27.0 x 3.97
