badinkajink/hand/docs/experiments/20261019-dip_link_fit_prints/stl/F05_channel_flank05_85a.stl

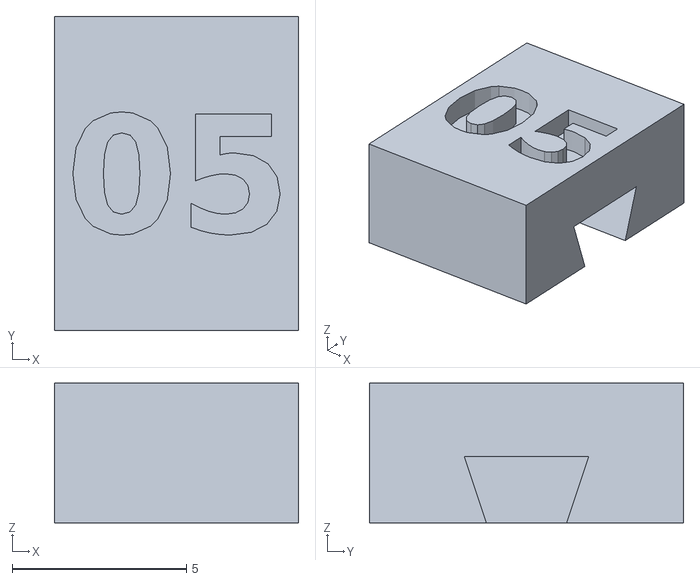
[picture p24: CAD file, 2026-10-19]
docs/experiments/20261019-dip_link_fit_prints/stl/F05_channel_flank05_85a.stl
7.00 x 9.00 x 4.00
