badinkajink/hand/docs/experiments/20261019-dip_link_fit_prints_b/stl/S45_seat_pocket45.stl

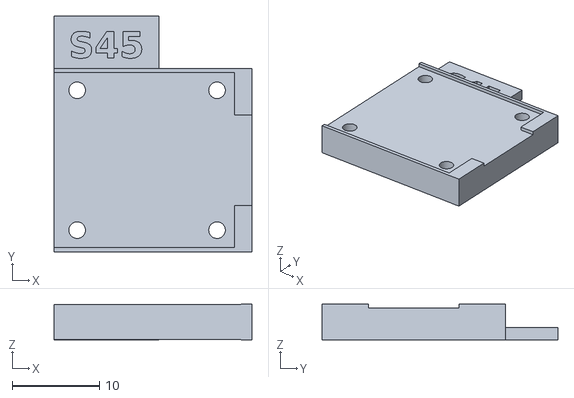
[picture p25: CAD file, 2026-10-20]
docs/experiments/20261019-dip_link_fit_prints_b/stl/S45_seat_pocket45.stl
22.7 x 27.0 x 4.07
