badinkajink/hand/docs/experiments/20261019-dip_link_fit_prints_b/stl/W_cable_grooves_28_30_34.stl

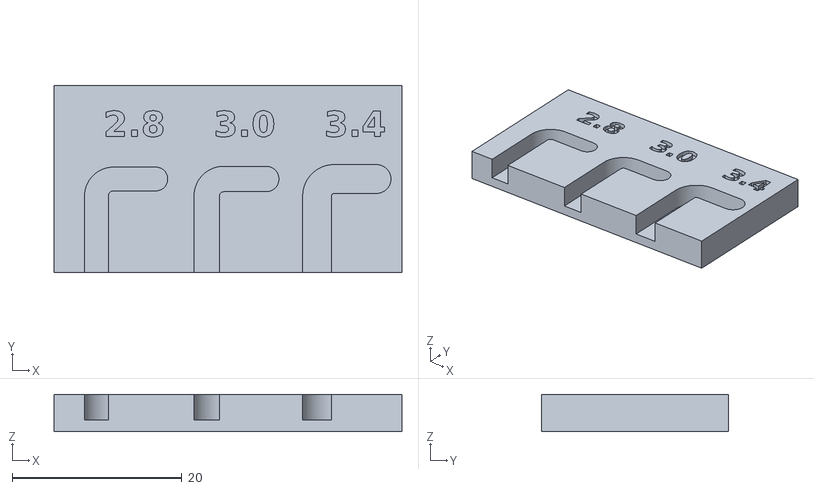
[picture p26: CAD file, 2026-10-19]
docs/experiments/20261019-dip_link_fit_prints_b/stl/W_cable_grooves_28_30_34.stl
41.0 x 22.0 x 4.40
