badinkajink/hand/docs/experiments/20261019-dip_link_fit_prints_b/stl/G20_groove_flank20_85a.stl

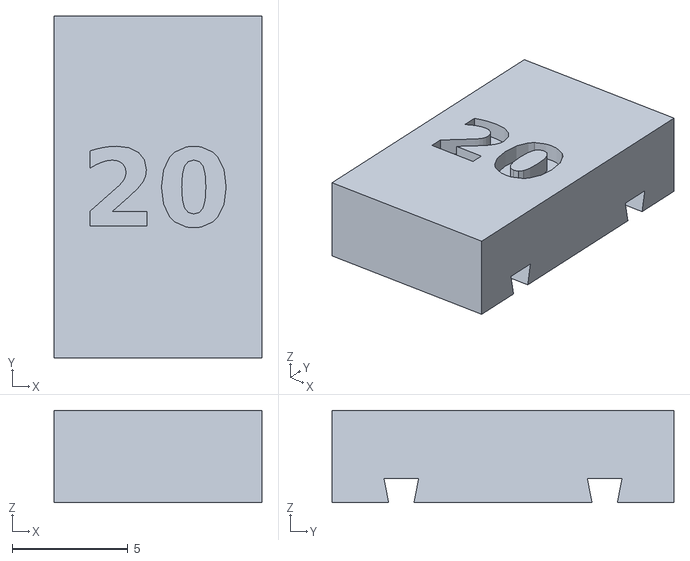
[picture p27: CAD file, 2026-10-19]
docs/experiments/20261019-dip_link_fit_prints_b/stl/G20_groove_flank20_85a.stl
9.00 x 14.8 x 4.00
