badinkajink/hand/docs/experiments/20261019-dip_link_fit_prints_b/stl/R_rail_strip.stl

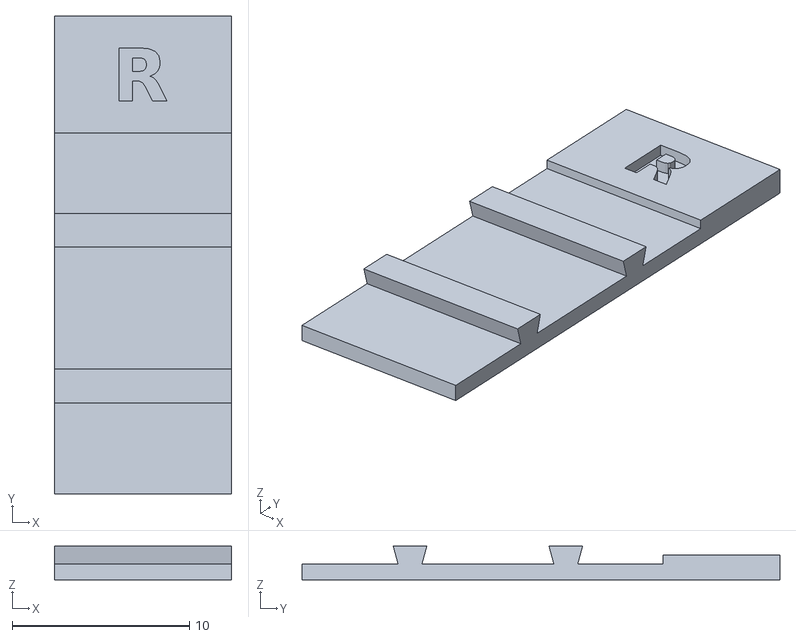
[picture p28: CAD file, 2026-10-19]
docs/experiments/20261019-dip_link_fit_prints_b/stl/R_rail_strip.stl
10.0 x 27.0 x 1.90
