badinkajink/hand/docs/experiments/20261019-dip_link_fit_prints/stl/K45_key_detent45.stl

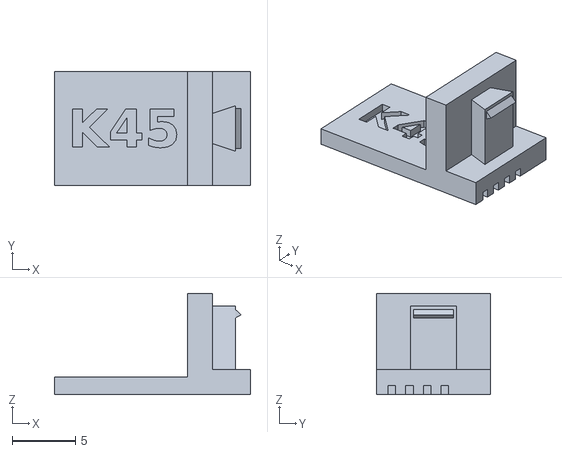
[picture p29: CAD file, 2026-10-19]
docs/experiments/20261019-dip_link_fit_prints/stl/K45_key_detent45.stl
15.5 x 9.00 x 8.00
