badinkajink/hand/docs/experiments/20261019-dip_link_fit_prints_b/stl/V_cover.stl

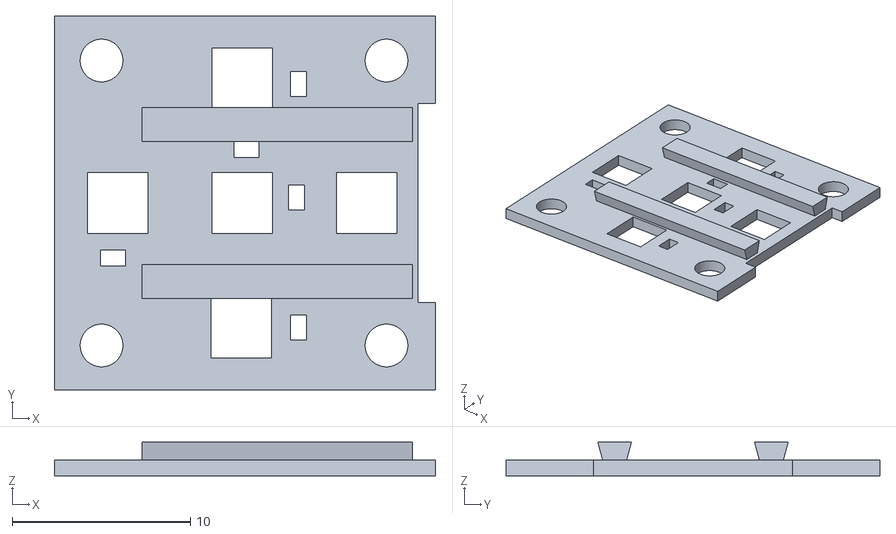
[picture p30: CAD file, 2026-10-19]
docs/experiments/20261019-dip_link_fit_prints_b/stl/V_cover.stl
21.4 x 21.0 x 1.90
