badinkajink/hand/docs/experiments/20261019-dip_link_fit_prints/stl/P_pin_coupon_225_240.stl

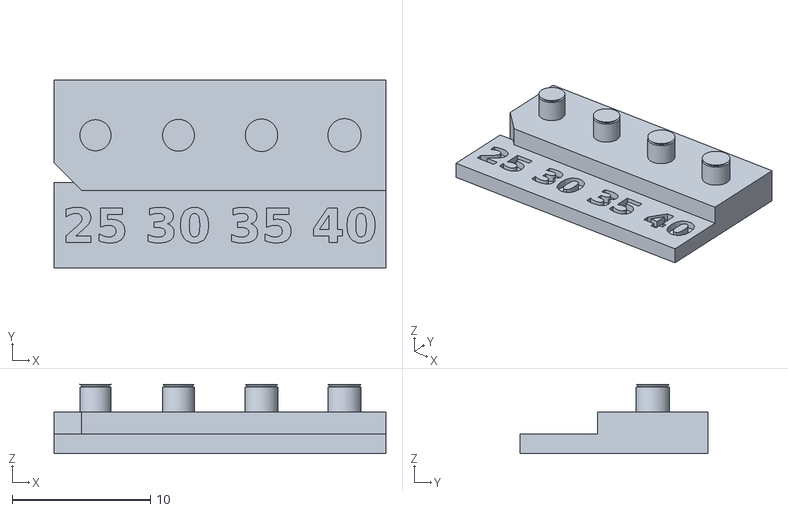
[picture p31: CAD file, 2026-10-19]
docs/experiments/20261019-dip_link_fit_prints/stl/P_pin_coupon_225_240.stl
24.0 x 13.6 x 5.00
