badinkajink/hand/docs/experiments/20261019-dip_link_fit_prints/stl/CP_clamp_plate.stl

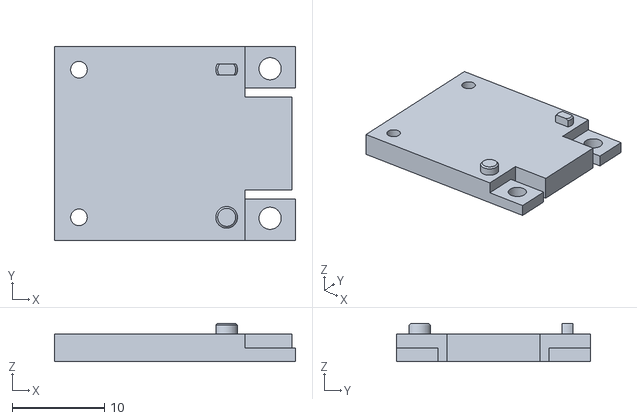
[picture p32: CAD file, 2026-10-19]
docs/experiments/20261019-dip_link_fit_prints/stl/CP_clamp_plate.stl
26.1 x 21.0 x 4.15
