badinkajink/hand/(list of files, cad)

Other CAD files:
assets/cad_v3/step/robot_mount.step
assets/mjcf/experimental/20261013-cad_v1/meshes/tpu_tip_r2p7_pos.obj
assets/mjcf/experimental/20261016-sim2real_fingertip_readiness/block4w1_g30/cad_v1/meshes/servo_pip.stl
assets/mjcf/experimental/20261016-sim2real_fingertip_readiness/block4w1_g30/cad_v1/meshes/tcd_rs3_re3_p0.2/tcd_rs3_re3_p0.2_neg.obj
assets/mjcf/experimental/20261016-sim2real_fingertip_readiness/block4w1_g50/cad_v1/meshes/servo_mcp.stl
assets/mjcf/experimental/20261016-sim2real_fingertip_readiness/block5_g30/cad_v1/meshes/tcd_rs3_re3_p0.2/tcd_rs3_re3_p0.2_pos.obj
assets/mjcf/experimental/20261016-sim2real_fingertip_readiness/cap_g30/cad_v1/meshes/tcd_cap8.5_u0.1/tcd_cap8.5_u0.1_r0.25_neg.obj
assets/mjcf/experimental/20261016-sim2real_fingertip_readiness/ell11_g50/cad_v1/meshes/tcd_ell7.4x8.5x11x22_u0.1/tcd_ell7.4x8.5x11x22_u0.1_r0.25_neg.obj
assets/mjcf/experimental/20261016-sim2real_fingertip_readiness/ell16_g30/cad_v1/meshes/tcd_ell7.4x8.5x16x32_u0.1/tcd_ell7.4x8.5x16x32_u0.1_r0.25_neg.obj
assets/mjcf/experimental/20261016-sim2real_fingertip_readiness/ell16_g50/cad_v1/meshes/tcd_ell7.4x8.5x16x32_u0.1/tcd_ell7.4x8.5x16x32_u0.1_r0.25_pos.obj
assets/mjcf/experimental/20261104-cad_v3/meshes/d435i/d435i_4.obj
assets/mjcf/experimental/20261104-cad_v3/meshes/tcd_ell7.4x8.5x11x22/tcd_ell7.4x8.5x11x22_r0.25_neg.obj
assets/mjcf/experimental/20261104-cad_v3/meshes/ur5/visual/wrist3_1.obj
assets/mjcf/experimental/20261104-cad_v3/meshes/v3_tag.obj
docs/experiments/20261019-dip_link_fit_prints/siraya/siraya_tpu85a_hf_p1s_0p4_20260728.3mf
assets/cad_v3/step/gantry_v3.step
assets/mjcf/experimental/20261013-cad_v1/meshes/servo_mcp.stl
assets/mjcf/experimental/20261014-tip_codesign/tcd_rs2_re1_p0.2/cad_v1/meshes/tcd_rs2_re1_p0.2/tcd_rs2_re1_p0.2_pos.obj
assets/mjcf/experimental/20261014-tip_codesign/tcd_rs3_re6_p0.2/cad_v1/meshes/tcd_rs3_re6_p0.2/tcd_rs3_re6_p0.2_pos.obj
assets/mjcf/experimental/20261014-tip_codesign/tcd_rs7.4_re10.5_p0.2/cad_v1/meshes/tcd_rs7.4_re10.5_p0.2/tcd_rs7.4_re10.5_p0.2_neg.obj
assets/mjcf/experimental/20261016-sim2real_fingertip_readiness/cap_g30/cad_v1/meshes/tcd_cap8.5_u0.1/tcd_cap8.5_u0.1_r0.25_pos.obj
assets/mjcf/experimental/20261104-cad_v3/meshes/d435i/d435i_8.obj
assets/mjcf/experimental/20261104-cad_v3/meshes/tcd_ell7.4x8.5x11x22/tcd_ell7.4x8.5x11x22_r0.25_pos.obj
assets/mjcf/experimental/20261104-cad_v3/meshes/ur5/visual/wrist2_1.obj
assets/mjcf/experimental/20261104-cad_v3/meshes/v3_mount_index_brass.stl
docs/experiments/20261019-dip_link_fit_prints/siraya/siraya_tpu85a_hf_a1mini_0p4_20250724.3mf
docs/experiments/20261019-dip_link_fit_prints/stl/C15_board_carrier_chip15.stl
assets/cad_v3/step/base_plate.step
assets/mjcf/experimental/20261013-cad_v1/meshes/mcp_link.stl
assets/mjcf/experimental/20261104-cad_v3/meshes/ur5/visual/upperarm_1.obj
assets/mjcf/experimental/20261104-cad_v3/meshes/v3_bridge_middle_alu.stl
docs/experiments/20261019-dip_link_fit_prints/stl/C20_board_carrier_chip20.stl
assets/cad_v3/step/gantry_v3_thumb.step
assets/mjcf/experimental/20261013-cad_v1/meshes/servo_pip.stl
assets/mjcf/experimental/20261104-cad_v3/meshes/ur5/visual/wrist1_2.obj
assets/mjcf/experimental/20261104-cad_v3/meshes/v3_bridge_middle_steel.stl
assets/cad_v3/step/hand_v3_anthro_config.step
assets/mjcf/experimental/20261013-cad_v1/meshes/tip.stl
assets/mjcf/experimental/20261104-cad_v3/meshes/ur5/visual/shoulder_2.obj
assets/mjcf/experimental/20261104-cad_v3/meshes/v3_mount_thumb_brass.stl
assets/cad_v3/step/ur5_adaptor.step
assets/mjcf/experimental/20261013-cad_v1/meshes/carriage.stl
assets/mjcf/experimental/20261104-cad_v3/meshes/ur5/visual/wrist3_0.obj
assets/mjcf/experimental/20261104-cad_v3/meshes/v3_palm_adaptor.stl
docs/experiments/20261019-dip_link_fit_prints/stl/F30_channel_flank30_85a.stl
assets/mjcf/experimental/20261013-cad_v1/meshes/servo_yaw.stl
assets/mjcf/experimental/20261104-cad_v3/meshes/ur5/visual/forearm_2.obj
assets/mjcf/experimental/20261104-cad_v3/meshes/v3_palm_plate.stl
docs/experiments/20261019-dip_link_fit_prints/stl/F00_channel_flank00_85a.stl
assets/mjcf/experimental/20261013-cad_v1/meshes/dip_link.stl
assets/mjcf/experimental/20261104-cad_v3/meshes/ur5/visual/wrist2_0.obj
assets/mjcf/experimental/20261104-cad_v3/meshes/v3_palm_steel.stl
docs/experiments/20261019-dip_link_fit_prints_b/stl/G00_groove_flank00_85a.stl
assets/mjcf/experimental/20261013-cad_v1/meshes/tpu_tip_r2p7_neg.obj
assets/mjcf/experimental/20261104-cad_v3/meshes/ur5/visual/shoulder_0.obj
assets/mjcf/experimental/20261104-cad_v3/meshes/v3_bridge_middle_stepper.stl
docs/experiments/20261019-dip_link_fit_prints/stl/K35_key_detent35.stl
docs/experiments/20261019-dip_link_fit_prints_b/stl/G05_groove_flank05_85a.stl
assets/mjcf/experimental/20261013-cad_v1/meshes/yaw_link.stl
assets/mjcf/experimental/20261104-cad_v3/meshes/ur5/visual/upperarm_2.obj
assets/mjcf/experimental/20261104-cad_v3/meshes/v3_bridge_index_print.stl
docs/experiments/20261019-dip_link_fit_prints/stl/K15_key_detent15.stl
assets/mjcf/experimental/20261104-cad_v3/meshes/ur5/visual/wrist1_1.obj
assets/mjcf/experimental/20261104-cad_v3/meshes/v3_mount_middle_brass.stl
docs/experiments/20261019-dip_link_fit_prints/stl/K25_key_detent25.stl
docs/experiments/20261019-dip_link_fit_prints_b/stl/G10_groove_flank10_85a.stl
assets/mjcf/experimental/20261104-cad_v3/meshes/ur5/visual/wrist1_0.obj
assets/mjcf/experimental/20261104-cad_v3/meshes/v3_bridge_index_stepper.stl
docs/experiments/20261019-dip_link_fit_prints_b/stl/G15_groove_flank15_85a.stl
assets/mjcf/experimental/20261104-cad_v3/meshes/ur5/visual/base_1.obj
assets/mjcf/experimental/20261104-cad_v3/meshes/v3_bridge_index_brass.stl
docs/experiments/20261019-dip_link_fit_prints/stl/F10_channel_flank10_85a.stl
assets/mjcf/experimental/20261104-cad_v3/meshes/ur5/visual/upperarm_3.obj
assets/mjcf/experimental/20261104-cad_v3/meshes/v3_bridge_middle_brass.stl
docs/experiments/20261019-dip_link_fit_prints/stl/F20_channel_flank20_85a.stl
assets/mjcf/experimental/20261104-cad_v3/meshes/ur5/visual/forearm_1.obj
assets/mjcf/experimental/20261104-cad_v3/meshes/v3_mount_middle_steel.stl
assets/mjcf/experimental/20261104-cad_v3/meshes/ur5/visual/wrist2_2.obj
assets/mjcf/experimental/20261104-cad_v3/meshes/v3_bridge_middle_print.stl
docs/experiments/20261019-dip_link_fit_prints/stl/W_cable_grooves_22_24_26.stl
assets/mjcf/experimental/20261104-cad_v3/meshes/ur5/visual/forearm_0.obj
assets/mjcf/experimental/20261104-cad_v3/meshes/v3_bridge_thumb_stepper.stl
docs/experiments/20261019-dip_link_fit_prints/stl/F15_channel_flank15_85a.stl
assets/mjcf/experimental/20261104-cad_v3/meshes/ur5/visual/upperarm_0.obj
assets/mjcf/experimental/20261104-cad_v3/meshes/v3_mount_index_steel.stl
docs/experiments/20261019-dip_link_fit_prints/stl/F40_channel_flank40_85a.stl
assets/mjcf/experimental/20261104-cad_v3/meshes/ur5/visual/base_0.obj
assets/mjcf/experimental/20261104-cad_v3/meshes/v3_bridge_thumb_print.stl
assets/mjcf/experimental/20261104-cad_v3/meshes/ur5/visual/shoulder_1.obj
assets/mjcf/experimental/20261104-cad_v3/meshes/v3_palm_stepper.stl
assets/mjcf/experimental/20261104-cad_v3/meshes/v3_bridge_index_alu.stl
assets/mjcf/experimental/20261104-cad_v3/meshes/v3_palm_alu.stl
assets/mjcf/experimental/20261104-cad_v3/meshes/v3_bridge_thumb_brass.stl
assets/mjcf/experimental/20261104-cad_v3/meshes/v3_palm_print.stl
assets/mjcf/experimental/20261104-cad_v3/meshes/v3_bridge_thumb_steel.stl
assets/mjcf/experimental/20261104-cad_v3/meshes/v3_palm_sensor.stl
assets/mjcf/experimental/20261104-cad_v3/meshes/v3_bridge_index_steel.stl
assets/mjcf/experimental/20261104-cad_v3/meshes/v3_mount_thumb_steel.stl
assets/mjcf/experimental/20261104-cad_v3/meshes/v3_bridge_thumb_alu.stl
assets/mjcf/experimental/20261104-cad_v3/meshes/v3_palm_mount.stl
assets/cad_v1/carriage.stl
assets/cad_v1/feetech scs0009.stl
assets/cad_v1/fingertip_and_DIP_link.stl
assets/cad_v1/mcp_mount_YAW-link.stl
assets/cad_v1/pip_mount_MCP_link.stl
assets/cad_v2/ati_mini40_45/hook_cross.step
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
