badinkajink/hand/docs/handoff/20261018-print_procedure.md

Status: done
Task (owner, 2026-10-18 09:15): "on the william colorado seat or the personal, we can work on setting up instructions for the physical print, which we can tweak as needed as we find out more"; "please push everything. you can also publish pages as needed". The owner comes to the office in a few hours to test the press fits ("hopefully everything else is ready to print. i still want to try the quarter ellipsoid / capsule prints").
Read first: docs/experiments/20261016-sim2real_fingertip_readiness/print/README.md, its template_changes.json and the per-project sheets (*.json); scripts/sim2real_fingertip_prints.py; docs/experiments/20261016-metric_magnet_prints/print/README.md (the 95A set); docs/experiments/20261016-sim2real_fingertip_readiness/20261016-cad_hand_fingertip_deployment_readiness.html (bench procedure, sensing, seat sizes); docs/experiments/20261015-curved_tips/20261015-capsule_and_ellipsoid_fingertips.html; docs/experiments/INDEX.md; CLAUDE.md "Result pages" and "Films"; ~/.claude/CLAUDE.md Writing; memory project_metric_magnet_prints_2026_10_16.md, reference_prusaslicer_arcs_flatpak.md, project_mlx_readout_2026_10_13.md.
State (2026-10-18 09:58, autopilot personal): steps 1-3 done. Curved-tips page: https://claude.ai/artifact/BtW5dLwyChxGWv6z867yvT (INDEX row; fingertip and contact overviews republished with the link). Print procedure: docs/experiments/20261018-fingertip_print_procedure/20261018-siraya85a_fingertip_print_procedure.html at https://claude.ai/artifact/Y4BcrFQBhkG4tpzgDcuAw8 (INDEX row 2026-10-18), builder scripts/fingertip_print_procedure_page.py (+ .template.html), renders and seat-wall check scripts/fingertip_print_procedure_figures.py (cut|walls|render). The owner fills records/seat_coupon.csv and records/prints.csv; rebuilding the page shows them. Seat-wall check (seat_walls.json): every tip passes the 1.8 mm rule at 2.8 mm; at 2.9 mm the five-magnet block (1.71 mm between pockets) and the 11/22 half-ellipsoid (1.76 mm to the surface) fail, and sim2real_fingertip_prints.py build stops at them. Not done (outside this job's claim): docs/index.html and docs/pages.html still list the curved-tips page as unpublished and do not list the procedure page (the window's builder); the fingertip overview's PAGES (scripts/overview_fingertip_text.py) does not list the procedure page.
State (2026-10-18 09:25, armed by window 88ae0ebc on personal): all 85A projects are sliced and checked (print/README.md); the seat coupons take about 8 min each. The window runs a separate workflow in this repository (Drake and pad calibration to the finite elements, a DIP-link redesign for the magnetometer board, a file-explorer layout for docs/pages.html); it writes only its own folders and scripts/docs_home_page.py.
<!-- ap:steps: rendered by ~/.claude/autopilot/ap from its ledger; change it with `ap step`, not by hand -->
Steps, in order (the ledger; `ap step done <job> <id> "result"` marks one, `ap step add <job> "text"` adds one):
- [x] 1. Publish docs/experiments/20261015-curved_tips/20261015-capsule_and_ellipsoid_fingertips.html as a new claude.… Done 10-18 09:32: Curved-tips page published from personal at https://claude.ai/artifact/BtW5dLwyChxGWv6z867yvT (live copy = local file verbatim; 8 figures, 2 films decode, no errors); URL in artifact_url.txt and INDEX row 25; fingertip overview (XMCDZm1LyCpdrZuLufM37T, v4) and contact overview (4w96Kt4J3tunu1xuz4XbdN, v19) rebuilt with the link only and republished
- [x] 2. Write the physical print procedure as a dated HTML page, docs/experiments/20261018-fingertip_print_procedure/… Done 10-18 09:50: Page docs/experiments/20261018-fingertip_print_procedure/20261018-siraya85a_fingertip_print_procedure.html (1.07 MB, 34 figures, 14 prints in the owner's order) built by scripts/fingertip_print_procedure_page.py + .template.html from the 85A sheets, README, template_changes.json and bench/procedure.json; renders by scripts/fingertip_print_procedure_figures.py; record CSVs in records/; seat-wall check: every tip passes the 1.8 mm rule at 2.8 mm, the five-magnet block (1.71 mm) and the 11/22 half-ellipsoid (1.76 mm) fail at 2.9 mm
- [x] 3. Publish the procedure page as a new artifact from this login, add its INDEX row (2026-10-18, local path, URL)… Done 10-18 09:52: Published docs/experiments/20261018-fingertip_print_procedure/20261018-siraya85a_fingertip_print_procedure.html at https://claude.ai/artifact/Y4BcrFQBhkG4tpzgDcuAw8 (live copy = local file); artifact_url.txt and INDEX row 2026-10-18; commits b1bc7d36..eddcac6a pushed
Standing directions (for every step):
- Compute: this job uses cores 2-3 (taskset -c 2,3) and at most 2 GB per process through ~/.claude/bin/resguard.sh run; the window's workflow runs beside it on cores 4-18. Check resguard.sh status before each render and ~/.claude/resguard_events.jsonl at each step.
<!-- /ap:steps -->
Claimed: docs/experiments/20261015-curved_tips/artifact_url.txt; the artifact column of INDEX row 25 and the new procedure row in docs/experiments/INDEX.md; docs/experiments/20261018-fingertip_print_procedure/; scripts/fingertip_print_procedure_page.py and its template; the fingertip and contact overview rebuilds of step 1 (the curved-tips link only).
Waiting on owner: none. The seat-test result comes from the owner later; the page says where to record it.
Do not: change the print projects, sheets or STLs (a rebuild needs the owner's seat result); start a printer; touch the workflow's paths (docs/experiments/20261018-fe_contact_calibration/, docs/experiments/20261018-dip_link_board_mount/, scripts/docs_home_page.py, docs/pages.html, docs/index.html); pull, rebase or stash in this shared working tree (commit with explicit paths; `git push origin main`); force-push.
