badinkajink/hand/docs/handoff/20261016-metric_magnet_prints.md

Status: done
Task (owner, 2026-10-16 13:06): "we already have 3x2 magnets. can you add to the queue generation jobs for fingertips to print for that profile? we can add more magnets too, maybe 5 (matching the 5 magnetometers?). if we can reduce the number of walls around the press-fit pocket we can try that too ... move up that job ... send some prints off as soon as possible."
Read first: docs/experiments/20261009-tpu_tip_fem/print/README.md and scripts/tpu_tip_print_plan.py (block print recipe and pocket pause); scripts/tpu_tip_design.py (block geometry and print_sheet); scripts/curved_tips_print.py and docs/experiments/20261015-curved_tips/20261015-capsule_and_ellipsoid_fingertips.html (curved finalists and upright prints); scripts/tpu_tip_magnet_layouts.py and docs/experiments/20261013-magnet_layouts/20261013-mlx90393_fingertip_readout.html (3 x 2 mm four-magnet model); scripts/mlx90393_model.py (five chip positions); CLAUDE.md and ~/.claude/CLAUDE.md (compute safety).
State (2026-10-16 14:05, autopilot 2973225c on colorado): READY TO SEND (commit 1255852d), all in docs/experiments/20261016-metric_magnet_prints/print/ with README.md (pauses, magnet orientation, risks):
  20261016-pocket_fit_coupon_d3x2_seats2p7_2p8_2p9_w95_20.3mf (12 min, print first: 2.7/2.8/2.9 mm seats)
  20261016-block_four_d3x2_depth5_seat2p7_w95_20.3mf (22.6 min, pause 12.4 mm)
  20261016-tcd_ell7p4x8p5x16x32_four_d3x2_depth5p5_seat2p7_w95_20.3mf, 20261016-tcd_cap8p5_four_d3x2_depth5_seat2p7_w95_20.3mf, 20261016-tcd_ell7p4x8p5x11x22_four_d3x2_depth7_seat2p7_w95_20.3mf (about 37 min, pauses 9.3 and 16.3 mm)
  Depth = shallowest 0.5 mm step leaving 1.8 mm TPU around every complete pocket (at 5 mm the ellipsoids' distal slot tops leave 1.72/1.13 mm). Slice checks pass (pockets empty, solid floors, bridge after each pause, one island per layer). Builder: scripts/metric_magnet_prints.py build|coupon|readme|fe|sense.
State (2026-10-16 14:30, final): all four steps done. Step 3: five-magnet block print/20261016-block_five_d3x2_depth5_seat2p7_w95_20.3mf (1.91 mm between pockets, 7.7 mT, GAIN_SEL 5, one pause, 23.1 min); FE + Cramer-Rao (fem.jsonl, sensing.json): 0.097 N at the contact point vs 0.33 N for four, E* 17.9 vs 16.7 MPa; no curved five-magnet print (0.99 mm between slots, three pauses; checks/). Step 4: one-wall block print/20261016-block_four_d3x2_depth5_seat2p7_pocketwalls1_w95_20.3mf (perimeters-1 modifier on the pocket layers; one loop per pocket, two at the outer surface; E* 16.40 vs 16.70 MPa) and a one-wall seat coupon. README sections for both. Commits 1255852d, d4d66f0b, 3e537716 and the closing commit. Waiting on owner: printing; the coupon decides the seat (rerun build --seat 2.8/2.9 if needed).
State (2026-10-16 13:06): the owner has 3 x 2 mm magnets. The existing four-pocket STL uses 4.76 x 1.59 mm discs, so it cannot be sent for these magnets. The modeled 3 x 2 mm array has pocket centres 6 mm across and 7 mm along the 14.8 mm-wide block; a 90 % press-fit pocket is 2.7 mm across, leaving 3.3 mm between adjacent pockets. The previous study's predicted median force noise over 15 positions is 0.34 N for 3 x 2 mm against 0.15 N for four 4.76 x 1.59 mm magnets; these are model results for the block. The five sensor chips are at the centre and 7 mm on the two axes; a 3 mm magnet centred 7 mm across exceeds the fingertip's 7.4 mm half-width, so exact chip-aligned magnet pockets cannot fit. Four-magnet print files come first.
<!-- ap:steps: rendered by ~/.claude/autopilot/ap from its ledger; change it with `ap step`, not by hand -->
Steps, in order (the ledger; `ap step done <job> <id> "result"` marks one, `ap step add <job> "text"` adds one):
- [x] 1. Generate four-pocket variants for the as-built block and the three 2026-10-15 curved finalists (tcd_ell7.4x8.… Done 10-16 13:45: Four-pocket 3 x 2 mm prints for the block and the three curved finalists (print/20261016-*_four_d3x2_*); depth = shallowest 0.5 mm step leaving 1.8 mm TPU around every complete pocket: block 5, capsule 5, ell 16/32 5.5, ell 11/22 7 mm (at 5 mm the ellipsoids' distal slot tops leave 1.72/1.13 mm); watertight, 1 outer + 4 void shells; commit 1255852d
- [x] 2. Slice the four-pocket files in PrusaSlicer and inspect the G-code: watertight body and four internal voids, s… Done 10-16 13:45: Sliced in PrusaSlicer 2.9.2 and checked per pocket with an arc-aware parser: pockets empty, solid floors, bridge-only first layer right after each M601, one island per layer, 87-93 % supported; block 22.6 min (pause 12.4 mm), curved 36.8-37.3 min (pauses 9.3, 16.3 mm); seat coupon 2.7/2.8/2.9 mm (12 min); README with material, layers, orientation, pauses, risks; ready-to-send paths in State
- [x] 3. Make a five-magnet candidate with the four 3 x 2 mm corner positions plus one at the centre, or another layou… Done 10-16 13:56: Five-magnet block print/20261016-block_five_d3x2_depth5_seat2p7* (centres (+-3, 7.36), (0, 10.86), (+-3, 14.36) mm; 1.91 mm between pockets, 3.05 mm wall, 7.7 mT on a chip, GAIN_SEL 5; one pause 12.4 mm, 23.1 min). FE + Cramer-Rao (fem.jsonl, sensing.json): E* 17.9 vs 16.7 MPa, noise at the contact point 0.097 vs 0.33 N, median over 15 points 0.17 vs 0.34 N. Upright curved tips: 0.99 mm between slots, three pauses, no print (checks/). Commit 3e537716
- [x] 4. Produce a one-wall pocket variant for the four-magnet print while keeping the outer-tip wall count from the r… Done 10-16 13:56: One-wall block print/20261016-block_four_d3x2_depth5_seat2p7_pocketwalls1* via a perimeters-1 modifier (section inset 0.407 mm on the 11 pocket layers): G-code shows one loop per pocket, two at the outer surface (0.20/0.63 mm vs 0.23/0.63), bridges and pause unchanged, 22.0 min; FE E* 16.40 vs 16.70 MPa, noise 0.30 vs 0.33 N; one-wall seat coupon for the retention test; two-wall print kept
<!-- /ap:steps -->
Claimed: scripts/metric_magnet_prints.py (new, or a similarly named dedicated builder), docs/experiments/20261016-metric_magnet_prints/, and this note's State outside the ap:steps block. Leave the older print assets and their published result pages unchanged.
Waiting on owner: none. Print files are for the owner to send; no bench measurement is required before producing them.
Do not: send jobs to a printer, order magnets, publish an artifact, overwrite old STL or result pages, launch an uncapped mesh or voxel probe, or run a multi-hour grid. Use resguard.sh status and resguard.sh run for every mesh operation and long slice or solve, with measured memory and CPU limits.
