badinkajink/hand/docs/experiments/20261022-ur5_tip_calibration/plan/20261023-plan_rod_lab_build.txt

reachable surface points: 72 of 812 (face 49/104, edge 23/197, flank 0/427, tip 0/80)
only got 1256/1275 samples!
only got 1248/1275 samples!
joint-6 travel by stage, deg (plan order -> by joint 6): gravity 1163 -> 576, pad 802 -> 91, pivot 0 -> 0, grid 549 -> 269, shear 6 -> 6, roll 6 -> 6, final 0 -> 0, final_gravity 449 -> 331
105 actions ({'gravity': 11, 'mount': 0, 'pad': 22, 'pivot': 5, 'grid': 57, 'shear': 3, 'roll': 2, 'twist': 0, 'final': 1, 'final_gravity': 4}), 36 dropped, 0 travel paths short of clearance -> docs/experiments/20261022-ur5_tip_calibration/plan/20261023-plan_rod_lab.json (0.4 MB, 48 s)
  dropped {'id': 'grav-08', 'twist': 0.0, 'why': {'reason': 'joint 5 outside the wrist window', 'q_deg': [45.3, -81.1, 105.4, -151.5, -62.6, 0.9], 'pose': 0}}
  dropped {'id': 'grav-10', 'twist': 0.0, 'why': {'reason': 'joint 5 outside the wrist window', 'q_deg': [54.1, -66.8, 67.8, -91.0, -90.0, 180.3], 'pose': 0}}
  dropped {'id': 'grav-11', 'twist': 0.0, 'why': {'reason': 'no IK', 'pose': 0}}
  dropped {'id': 'mount-0', 'twist': 0.0, 'why': {'clear': {'robot': 30.4, 'mount': -6.18, 'finger': 25.94, 'pad': 32.31, 'hex_e': -4.58}, 'self': {'hex_e': 34.8, 'port': 48.6, 'tool': 69.8}, 'q_deg': [45.2, -66.2, 104.2, -38.0, 49.2, 2.2], 'pose': 0}}
  dropped {'id': 'mount-1', 'twist': -30.0, 'why': {'clear': {'robot': 27.39, 'mount': -7.17, 'finger': 23.26, 'pad': 29.58, 'hex_e': -5.57}, 'self': {'hex_e': 34.8, 'port': 48.6, 'tool': 69.8}, 'q_deg': [55.3, -67.5, 106.2, -38.7, 89.4, 2.1], 'pose': 0}}
  dropped {'id': 'mount-2', 'twist': -30.0, 'why': {'clear': {'robot': 35.36, 'mount': -6.98, 'finger': 22.5, 'pad': 25.53, 'hex_e': 0.89}, 'self': {'hex_e': 34.8, 'port': 48.6, 'tool': 69.8}, 'q_deg': [55.3, -68.4, 107.5, -39.2, 89.4, 2.1], 'pose': 0}}
  dropped {'id': 'mount-3', 'twist': 0.0, 'why': {'clear': {'robot': 40.74, 'mount': 1.39, 'finger': 23.09, 'pad': 25.6, 'hex_e': 5.94}, 'self': {'hex_e': 34.8, 'port': 48.6, 'tool': 69.8}, 'q_deg': [42.4, -66.0, 103.8, -37.9, 46.5, 2.2], 'pose': 0}}
  dropped {'id': 'mount-4', 'twist': 0.0, 'why': {'clear': {'robot': 46.7, 'mount': 1.39, 'finger': 22.54, 'pad': 22.72, 'hex_e': 11.68}, 'self': {'hex_e': 34.8, 'port': 48.6, 'tool': 69.8}, 'q_deg': [41.9, -66.5, 104.7, -38.2, 46.0, 2.2], 'pose': 0}}
  dropped {'id': 'mount-5', 'twist': 0.0, 'why': {'clear': {'robot': 46.41, 'mount': -4.99, 'finger': 22.61, 'pad': 22.72, 'hex_e': 11.42}, 'self': {'hex_e': 34.8, 'port': 48.6, 'tool': 69.8}, 'q_deg': [43.0, -67.2, 105.8, -38.6, 47.0, 2.2], 'pose': 0}}
  dropped {'id': 'pivot-5', 'twist': 15.0, 'why': {'reason': 'wrist within 30 deg of its singularity', 'q_deg': [36.5, -68.5, 100.6, -33.3, 25.5, -1.3], 'pose': 0}}
  dropped {'id': 'pivot-6', 'twist': 30.0, 'why': {'reason': 'wrist within 30 deg of its singularity', 'q_deg': [34.7, -63.2, 92.6, -32.7, 8.7, 1.0], 'pose': 0}}
  dropped {'id': 'pivot-7', 'twist': 45.0, 'why': {'reason': 'wrist within 30 deg of its singularity', 'q_deg': [34.5, -55.0, 79.4, -19.8, -6.4, -6.8], 'pose': 0}}
47.76 s wall, 149320 kB
