badinkajink/hand/docs/experiments/20260916-tip_gait/deploy/rv05_manual_a110_build.txt

design         rv05_manual
object         medium
scene          /home/humanoid/Programs/hand/assets/mjcf/experimental/20260829-deploy_envelope/scene_tp0d0110p0d0000p0d0000_in0d0150n0d0300p0d0000_mn0d0015p0d0200p0d0000__medium__bench100py-35__flat15w21T.xml

FINGER MOUNTS (palm frame, mm) -- set the three gantry blocks to these
  finger          x        y
  thumb       -39.0      0.0
  index        35.0     25.0
  middle       48.5    -35.0

GRASP the plan assumes
  straddle (each pair pad, from the tool's mid-length)    32.0 mm
  thumb slid along the tool                               20.0 mm
  grip depth below the mounting plane                     66.5 mm
  squeeze (pads driven inside the surface)                10.0 mm

TURN
  pivot height   axis_k 0.050  (that many x the half-straddle above the pads)
  commanded turn -110 deg about the pinch axis
  over           1.1 s
  re-squeeze     0.0 mm at the top
  palm           FIXED; tool starts at 100 mm on a support at y -35 mm
