badinkajink/hand/docs/experiments/20260829-real_v1_deploy/deploy/sv1_w0116_b100_build.txt

design         sv1_w0116
object         medium
scene          /home/humanoid/Programs/hand/assets/mjcf/experimental/20260829-deploy_envelope/scene_tp0d0114p0d0098p0d0000_in0d0132p0d0068p0d0000_mn0d0108n0d0025p0d0000__medium__bench100py-35__flat15w21T.xml

FINGER MOUNTS (palm frame, mm) -- set the three gantry blocks to these
  finger          x        y
  thumb       -38.6      9.8
  index        36.8     61.8
  middle       39.2    -57.5

GRASP the plan assumes
  straddle (each pair pad, from the tool's mid-length)    40.0 mm
  thumb slid along the tool                               10.0 mm
  grip depth below the mounting plane                     64.5 mm
  squeeze (pads driven inside the surface)                10.0 mm

TURN
  pivot height   axis_k 0.550  (that many x the half-straddle above the pads)
  commanded turn -70 deg about the pinch axis
  over           1.1 s
  re-squeeze     0.0 mm at the top
  palm           FIXED; tool starts at 100 mm on a support at y -35 mm
