badinkajink/hand/docs/experiments/20260829-real_v1_deploy/deploy/sv1_u0100_b100_build.txt

design         sv1_u0100
object         medium
scene          /home/humanoid/Programs/hand/assets/mjcf/experimental/20260829-deploy_envelope/scene_tp0d0096p0d0458p0d0000_in0d0129n0d0234p0d0000_mn0d0131p0d0264p0d0000__medium__bench100py-35__flat15w21T.xml

FINGER MOUNTS (palm frame, mm) -- set the three gantry blocks to these
  finger          x        y
  thumb       -40.4     45.8
  index        37.1     31.6
  middle       36.9    -28.6

GRASP the plan assumes
  straddle (each pair pad, from the tool's mid-length)    40.0 mm
  thumb slid along the tool                               10.0 mm
  grip depth below the mounting plane                     63.0 mm
  squeeze (pads driven inside the surface)                10.0 mm

TURN
  pivot height   axis_k 0.150  (that many x the half-straddle above the pads)
  commanded turn -60 deg about the pinch axis
  over           1.1 s
  re-squeeze     0.0 mm at the top
  palm           FIXED; tool starts at 100 mm on a support at y -35 mm
