badinkajink/hand/docs/experiments/20260902-residual-bench/deploy/rv05_manual_b85_poses.txt

The trajectory is four set-points and three ramps; the CSV is only that, sampled.

  joint         open/grip  end of turn  re-squeeze
  thumb_yaw          5.77         1.01         nan
  thumb_mcp         30.01        27.78         nan
  thumb_pip          0.00         0.01         nan
  index_yaw         10.02        -6.47         nan
  index_mcp         22.92        14.28         nan
  index_pip          0.02         0.01         nan
  middle_yaw        -7.20        32.68         nan
  middle_mcp        35.85        22.49         nan
  middle_pip         0.00        48.70         nan

  ramp 1  close to the grip pose            0.5 s
  ramp 2  settle, palm held still         0.8 s
  ramp 3  grip pose -> end of turn         1.1 s
  ramp 4  end of turn -> re-squeeze        0.0 s
