badinkajink/hand/docs/experiments/20261022-ur5_tip_calibration/lab/20261104-rod13_ft_tail/printout-131223-tipcal-pts16.txt

resumed logs/20261103-tip_calibration/214753-rod13_seed: 278 actions done, 20 touches
speed slider 0.30 (the plan's 0.30)
== preflight
preflight: HEX-E 100 Hz (asked 100 Hz, filter 3), board 138 records/s, robot 124 Hz
  held boards on /dev/serial/by-id/usb-Adafruit_QT_Py_ESP32-S3__4MB_Flash_2MB_PSRAM__b4:3a:45:b0:d9:94-if00: mux channel 0 138 records/s, mux channel 2 138 records/s, mux channel 3 138 records/s
  HEX-E noise (1 sigma) N, N m: [0.0412 0.0491 0.2386 0.0027 0.0042 0.0011]
  HEX-E reads: 0 timed out, 0 late datagrams dropped (0 and 0 on a clean link)
  payload set: 0.403 kg at [0.0, -0.5, 34.3] mm from the flange
== grid
  probe-ref-t00 (1/6): to 3.00 N
  probe-flank-581-r0 (2/6): to 2.00 N
  probe-flank-486-r0 (3/6): to 2.00 N
  probe-tip-513-r90 (4/6): to 2.00 N
  probe-flank-499-r0 (5/6): to 2.00 N
  probe-ref-tfinal (6/6): to 3.00 N
HEX-E: 26567 samples, 0 timed out, 0 late datagrams dropped, 2 gaps over 0.5 s; 0.6 s, Fz -0.1 N; 0.7 s, Fz +0.4 N
session in logs/20261103-tip_calibration/214753-rod13_seed
exit 0 at 13:16:53
