badinkajink/hand/docs/experiments/20261022-ur5_tip_calibration/lab/20261103-202017-rod32/printout-052835-tipcal-rod38.txt

resumed logs/20261103-tip_calibration/202017-rod32_seed: 98 actions done, 20 touches
speed slider 0.30 (the plan's 0.30)
== preflight
preflight: HEX-E 100 Hz (asked 100 Hz, filter 3), board 138 records/s, robot 124 Hz
  held boards on /dev/serial/by-id/usb-Adafruit_QT_Py_ESP32-S3__4MB_Flash_2MB_PSRAM__b4:3a:45:b0:d9:94-if00: mux channel 0 138 records/s, mux channel 2 138 records/s, mux channel 3 138 records/s
  HEX-E noise (1 sigma) N, N m: [0.0351 0.0209 0.2133 0.0031 0.0038 0.0011]
  HEX-E reads: 0 timed out, 0 late datagrams dropped (0 and 0 on a clean link)
  payload set: 0.403 kg at [0.0, -0.5, 34.3] mm from the flange
== grid
  probe-ref-x0 (1/105): to 3.00 N
  probe-face-776-r90-roll-1.5N (3/105): to 1.50 N
  probe-face-731-r90-roll-1.5N (5/105): to 1.50 N
  probe-face-785-r90-roll-1.5N (7/105): to 1.50 N
  probe-face-756-r90-roll-1.5N (9/105): to 1.50 N
  probe-flank-563-o35-a0-r90 (10/105): to 2.00 N
  probe-edge-675-o20-a0-r90 (11/105): to 3.00 N
  probe-edge-675-o20-a180-r90 (12/105): to 3.00 N
  probe-edge-675-o35-a0-r90 (13/105): to 3.00 N
  probe-edge-675-o35-a180-r90 (14/105): to 3.00 N
  probe-face-756-o20-a0-r90 (15/105): to 3.00 N
  probe-face-756-o20-a180-r90 (16/105): to 3.00 N
  probe-face-756-o35-a0-r90 (17/105): to 3.00 N
  probe-face-756-o35-a180-r90 (18/105): to 3.00 N
  probe-flank-563-o20-a0-r90 (19/105): to 2.00 N
  probe-edge-615-o20-a0-r90 (20/105): to 3.00 N
  probe-edge-615-o20-a180-r90 (21/105): to 3.00 N
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
  probe-face-731-o35-a270-r90 (104/105): to 3.00 N
  probe-ref-x1 (105/105): to 3.00 N
HEX-E: 314725 samples, 0 timed out, 0 late datagrams dropped, 2 gaps over 0.5 s; 0.7 s, Fz -0.2 N; 0.7 s, Fz -0.1 N
session in logs/20261103-tip_calibration/202017-rod32_seed
exit 0 at 06:21:09
