badinkajink/hand/docs/experiments/20261022-ur5_tip_calibration/lab/20261103-172647-rod21/printout-180110-tipcal-rod21.txt

resumed logs/20261103-tip_calibration/172647-rod21_seed: 25 actions done, 20 touches
speed slider 0.30 (the plan's 0.30)
== preflight
preflight: HEX-E 100 Hz (asked 100 Hz, filter 3), board 138 records/s, robot 124 Hz
  held boards on /dev/serial/by-id/usb-Adafruit_QT_Py_ESP32-S3__4MB_Flash_2MB_PSRAM__b4:3a:45:b0:d9:94-if00: mux channel 0 138 records/s, mux channel 2 138 records/s, mux channel 3 138 records/s
  HEX-E noise (1 sigma) N, N m: [0.0482 0.0255 0.2213 0.0031 0.0037 0.0011]
  HEX-E reads: 0 timed out, 0 late datagrams dropped (0 and 0 on a clean link)
  payload set: 0.403 kg at [0.0, -0.5, 34.3] mm from the flange
== grid
  sweep-edge-638-r0: ABORT no HEX-E sample for 100 ms
  sweep-edge-569-r0: ABORT no HEX-E sample for 100 ms
  sweep-edge-630-r0: ABORT no HEX-E sample for 100 ms
HEX-E: 1746 samples, 13 timed out, 0 late datagrams dropped, 2 gaps over 0.5 s; 0.7 s, Fz +0.3 N; 0.7 s, Fz +0.1 N
session in logs/20261103-tip_calibration/172647-rod21_seed
three aborts in a row: stopping the session (--resume continues it)
exit 1 at 18:01:33
