badinkajink/hand/docs/experiments/20261022-ur5_tip_calibration/lab/20261103-172647-rod21/printout-185212-tipcal-rod21r2.txt

resumed logs/20261103-tip_calibration/172647-rod21_seed: 25 actions done, 20 touches
speed slider 0.30 (the plan's 0.30)
== preflight
preflight: HEX-E 100 Hz (asked 100 Hz, filter 3), board 138 records/s, robot 124 Hz
  held boards on /dev/serial/by-id/usb-Adafruit_QT_Py_ESP32-S3__4MB_Flash_2MB_PSRAM__b4:3a:45:b0:d9:94-if00: mux channel 0 138 records/s, mux channel 2 138 records/s, mux channel 3 138 records/s
  HEX-E noise (1 sigma) N, N m: [0.0339 0.0247 0.2384 0.0029 0.0038 0.0009]
  HEX-E reads: 0 timed out, 0 late datagrams dropped (0 and 0 on a clean link)
  payload set: 0.403 kg at [0.0, -0.5, 34.3] mm from the flange
== grid
  sweep-edge-638-r0: 0.5 N's offsets stop at r 0.06 az 90: the push across the pad 0.57 N at 0.02 N along its normal, over 1.2 x the push along + 0.5 N
  sweep-edge-638-r0 (4/85): to 8.00 N
  sweep-edge-569-r0 (5/85): to 8.00 N
  sweep-edge-630-r0: 2 N's slides stop at az 270: the push across the pad 1.49 N at 0.80 N along its normal, over 1.2 x the push along + 0.5 N
  sweep-edge-630-r0 (6/85): to 8.00 N
  sweep-face-713-r0 (7/85): to 8.00 N
  sweep-edge-618-r0 (8/85): to 8.00 N

interrupted: stopping the robot
HEX-E: 128089 samples, 0 timed out, 0 late datagrams dropped, 2 gaps over 0.5 s; 1.1 s, Fz +0.2 N; 0.7 s, Fz +0.6 N
session in logs/20261103-tip_calibration/172647-rod21_seed
exit 0 at 19:13:38
