badinkajink/hand/docs/experiments/20261022-ur5_tip_calibration/lab/20261103-172647-rod21/printout-191501-tipcal-rod21.txt

resumed logs/20261103-tip_calibration/172647-rod21_seed: 30 actions done, 20 touches
speed slider 0.30 (the plan's 0.30)
== preflight
preflight: HEX-E 100 Hz (asked 100 Hz, filter 3), board 138 records/s, robot 124 Hz
  held boards on /dev/serial/by-id/usb-Adafruit_QT_Py_ESP32-S3__4MB_Flash_2MB_PSRAM__b4:3a:45:b0:d9:94-if00: mux channel 0 138 records/s, mux channel 2 138 records/s, mux channel 3 138 records/s
  HEX-E noise (1 sigma) N, N m: [0.0341 0.0071 0.2239 0.0028 0.0036 0.001 ]
  HEX-E reads: 0 timed out, 0 late datagrams dropped (0 and 0 on a clean link)
  payload set: 0.403 kg at [0.0, -0.5, 34.3] mm from the flange
== grid
  sweep-face-697-r0 (6/32): to 8.00 N
  sweep-edge-666-r90 (7/32): to 8.00 N
  sweep-edge-675-r90 (8/32): to 8.00 N
  sweep-edge-729-r0 (9/32): to 8.00 N
  sweep-face-692-r90 (10/32): to 8.00 N
  sweep-face-768-r90 (11/32): to 8.00 N
  sweep-face-717-r0 (12/32): to 8.00 N
  sweep-edge-615-r90 (13/32): to 8.00 N
  sweep-face-790-r0: 0.5 N's offsets stop at r 0.06 az 90: the push across the pad 0.82 N at 0.13 N along its normal, over 1.2 x the push along + 0.5 N
  sweep-face-790-r0 (14/32): to 8.00 N
  sweep-face-781-r0 (15/32): to 8.00 N
  sweep-face-690-r0 (16/32): to 8.00 N
  sweep-edge-610-r0 (17/32): to 8.00 N
  sweep-face-759-r0 (18/32): to 8.00 N
  sweep-edge-615-r0 (19/32): to 8.00 N
  sweep-edge-675-r0 (20/32): to 8.00 N
  sweep-edge-668-r90: 0.5 N's offsets stop at r 0.06 az 180: the push across the pad 0.51 N at -0.01 N along its normal, over 1.2 x the push along + 0.5 N
  sweep-edge-668-r90: 1 N's offsets stop at r 0.084 az 180: the push across the pad 1.07 N at 0.41 N along its normal, over 1.2 x the push along + 0.5 N
  sweep-edge-668-r90 (21/32): to 8.00 N
  sweep-face-690-r90 (22/32): to 8.00 N
  sweep-edge-630-r90: 0.5 N's offsets stop at r 0.06 az 0: the push across the pad 0.65 N at 0.11 N along its normal, over 1.2 x the push along + 0.5 N
  sweep-edge-630-r90 (23/32): to 8.00 N
  sweep-face-776-r90 (24/32): to 8.00 N
  sweep-face-717-r90 (25/32): to 8.00 N
  sweep-edge-634-r90: 0.5 N's offsets stop at r 0.06 az 90: the push across the pad 0.73 N at 0.16 N along its normal, over 1.2 x the push along + 0.5 N
  sweep-edge-634-r90 (26/32): to 8.00 N
  sweep-face-721-r90 (27/32): to 8.00 N
  sweep-edge-639-r90 (28/32): to 8.00 N
  sweep-edge-638-r90 (29/32): to 8.00 N
  sweep-edge-729-r90 (30/32): to 8.00 N
  sweep-edge-573-r90: 0.5 N's offsets stop at r 0.06 az 180: the push across the pad 0.69 N at 0.15 N along its normal, over 1.2 x the push along + 0.5 N
  sweep-edge-573-r90: 4 N's slides stop at az 0: the push across the pad 1.90 N at 0.92 N along its normal, over 1.2 x the push along + 0.5 N
  sweep-edge-573-r90 (31/32): to 2.00 N
  probe-ref-a1 (32/32): to 3.00 N
HEX-E: 390162 samples, 0 timed out, 0 late datagrams dropped, 2 gaps over 0.5 s; 1.1 s, Fz +0.5 N; 0.7 s, Fz +0.0 N
session in logs/20261103-tip_calibration/172647-rod21_seed
exit 0 at 20:20:11
