badinkajink/hand/docs/experiments/20261022-ur5_tip_calibration/lab/20261103-214753-rod13/printout-214753-tipcal-rod13.txt

resumed logs/20261103-tip_calibration/214753-rod13_seed: 1 actions done, 0 touches
speed slider 0.30 (the plan's 0.30)
== preflight
preflight: HEX-E 100 Hz (asked 100 Hz, filter 3), board 138 records/s, robot 124 Hz
  held boards on /dev/serial/by-id/usb-Adafruit_QT_Py_ESP32-S3__4MB_Flash_2MB_PSRAM__b4:3a:45:b0:d9:94-if00: mux channel 0 138 records/s, mux channel 2 138 records/s, mux channel 3 138 records/s
  HEX-E noise (1 sigma) N, N m: [0.0394 0.0477 0.2236 0.003  0.0038 0.001 ]
  HEX-E reads: 0 timed out, 0 late datagrams dropped (0 and 0 on a clean link)
  payload set: 0.403 kg at [0.0, -0.5, 34.3] mm from the flange
== pad
  pad-ref-00: onset +0.810 mm from the expected (power 1.75, fit 229.4 mN)
  pad-edge-666-r90: onset +1.339 mm from the expected (power 1.00, fit 223.7 mN)
  pad-face-692-r90: onset +1.121 mm from the expected (power 1.00, fit 235.6 mN)
  pad-face-756-r90: onset +1.023 mm from the expected (power 2.00, fit 236.0 mN)
  pad-face-708-r90: onset +1.035 mm from the expected (power 1.00, fit 229.5 mN)
  pad-edge-610-r90: onset +1.212 mm from the expected (power 2.00, fit 234.3 mN)
  pad-edge-628-r90: onset +1.201 mm from the expected (power 1.00, fit 231.8 mN)
  pad-face-759-r90: onset +1.099 mm from the expected (power 1.25, fit 221.8 mN)
  pad-edge-630-r90: onset +0.996 mm from the expected (power 1.00, fit 188.8 mN)
  pad-face-776-r90: onset +0.959 mm from the expected (power 1.50, fit 234.0 mN)
  pad-face-717-r90: onset +0.783 mm from the expected (power 1.50, fit 236.9 mN)
  pad-edge-634-r90: onset +0.869 mm from the expected (power 1.25, fit 194.1 mN)
  pad-edge-638-r90: onset +0.473 mm from the expected (power 1.75, fit 251.5 mN)
  pad-face-731-r90: onset +0.130 mm from the expected (power 1.25, fit 226.8 mN)
  pad-face-721-r90: onset +0.491 mm from the expected (power 1.75, fit 227.2 mN)
  pad-edge-642-r90: onset +0.051 mm from the expected (power 1.25, fit 234.8 mN)
  pad-edge-639-r90: onset +0.045 mm from the expected (power 1.25, fit 211.2 mN)
  pad-face-733-r90: onset +0.156 mm from the expected (power 1.00, fit 209.9 mN)
  pad-edge-729-r90: onset +0.156 mm from the expected (power 2.00, fit 236.3 mN)
  pad-ref-final: onset +0.803 mm from the expected (power 2.00, fit 228.4 mN)
== register
register (probe, rod): pad touches 0.056 mm rms (20); the pad 0.992 mm, 1.318 deg from the seed; the rod's axis moved 1.119 mm across itself, c_M at [ -0.884   0.    106.815] in M (sd [0.111 0.    0.138] mm), turned -2.90 deg about z_M and -0.25 deg across (sd [3.63 1.84])
== grid
  probe-ref-00 (1/34): to 3.00 N
  sweep-edge-634-r0 (2/34): to 8.00 N
  sweep-edge-573-r0: 0.5 N's offsets stop at r 0.06 az 90: the push across the pad 0.69 N at -0.01 N along its normal, over 1.2 x the push along + 0.5 N
  sweep-edge-573-r0 (3/34): to 8.00 N
  sweep-edge-638-r0 (4/34): to 8.00 N
  sweep-edge-630-r0 (5/34): to 8.00 N
  sweep-edge-668-r0 (6/34): to 8.00 N
  sweep-edge-615-r90: 0.5 N's offsets stop at r 0.06 az 0: the push across the pad 0.57 N at -0.08 N along its normal, over 1.2 x the push along + 0.5 N
  sweep-edge-615-r90 (7/34): to 8.00 N
  sweep-edge-675-r90 (8/34): to 8.00 N
  sweep-face-692-r90 (9/34): to 8.00 N
  sweep-face-756-r90 (10/34): to 8.00 N
  sweep-edge-729-r0: 0.5 N's offsets stop at r 0.06 az 90: the push across the pad 0.71 N at 0.10 N along its normal, over 1.2 x the push along + 0.5 N
  sweep-edge-729-r0 (11/34): to 8.00 N
  sweep-face-708-r90 (12/34): to 8.00 N
  sweep-edge-610-r90 (13/34): to 8.00 N
  sweep-face-735-r0: 0.5 N's offsets stop at r 0.06 az 0: the push across the pad 1.04 N at 0.37 N along its normal, over 1.2 x the push along + 0.5 N
  sweep-face-735-r0 (14/34): to 8.00 N
  sweep-edge-618-r90 (15/34): to 4.00 N
  sweep-face-790-r0: 0.5 N's offsets stop at r 0.06 az 90: the push across the pad 0.53 N at -0.11 N along its normal, over 1.2 x the push along + 0.5 N
  sweep-face-790-r0 (16/34): to 8.00 N
  sweep-face-733-r0: 0.5 N's offsets stop at r 0.06 az 90: the push across the pad 0.85 N at 0.03 N along its normal, over 1.2 x the push along + 0.5 N
  sweep-face-733-r0 (17/34): to 8.00 N
  sweep-face-731-r0 (18/34): to 8.00 N
  sweep-edge-628-r90 (19/34): to 8.00 N
  sweep-face-759-r0 (20/34): to 8.00 N
  sweep-edge-675-r0 (21/34): to 8.00 N
  sweep-edge-610-r0 (22/34): to 8.00 N
  sweep-edge-615-r0 (23/34): to 8.00 N
  sweep-face-697-r90: 0.5 N's offsets stop at r 0.06 az 90: the push across the pad 0.59 N at 0.02 N along its normal, over 1.2 x the push along + 0.5 N
  sweep-face-697-r90 (24/34): to 8.00 N
  sweep-face-781-r90 (25/34): to 8.00 N
  sweep-flank-563-r0 (26/34): to 8.00 N
  sweep-face-713-r90 (27/34): to 8.00 N
  sweep-face-785-r90 (28/34): to 8.00 N
  sweep-face-731-r90 (29/34): to 8.00 N
  sweep-face-721-r90 (30/34): to 8.00 N
  sweep-edge-639-r90 (31/34): to 8.00 N
  sweep-edge-729-r90 (32/34): to 8.00 N
  sweep-edge-642-r0 (33/34): to 8.00 N
  probe-ref-a1 (34/34): to 3.00 N
HEX-E: 606523 samples, 0 timed out, 0 late datagrams dropped, 2 gaps over 0.5 s; 0.8 s, Fz -0.4 N; 0.7 s, Fz +0.1 N
session in logs/20261103-tip_calibration/214753-rod13_seed
exit 0 at 23:29:10
