badinkajink/hand/docs/experiments/20261022-ur5_tip_calibration/lab/20261103-144808-s2sph2/printout.txt

speed slider 0.30 (the plan's 0.30)
== preflight
preflight: HEX-E 100 Hz (asked 100 Hz, filter 3), board 138 records/s, robot 124 Hz
  held boards on /dev/serial/by-id/usb-Adafruit_QT_Py_ESP32-S3__4MB_Flash_2MB_PSRAM__b4:3a:45:b0:d9:94-if00: mux channel 0 138 records/s, mux channel 2 138 records/s, mux channel 3 138 records/s
  HEX-E noise (1 sigma) N, N m: [0.041  0.0465 0.2438 0.0029 0.0039 0.001 ]
  HEX-E reads: 0 timed out, 0 late datagrams dropped (0 and 0 on a clean link)
  payload set: 0.403 kg at [0.0, -0.5, 34.3] mm from the flange
== homing
homing: from the recorded seating docs/experiments/20261022-ur5_tip_calibration/lab/poses.jsonl:strip_key1_seated_4 (no freedrive, nothing moves)
homing: the fixture's frame from docs/experiments/20261030-inverted_rig_seat_block/data/20261102-strip_frame_pads.json, 4.15 mm and 4.49 deg from the seating's own
homing: 1 seatings within 0.000 mm, 0.000 deg of their mean
  indenter at (-201.4, -419.8, 36.6) mm, yaw -92.2 deg, tilt 0.00 deg; the plan has (-201, -420, 37) mm, yaw -92 deg
== pad
  pad-ref-00: onset -0.543 mm from the expected (power 1.75, fit 243.2 mN)
  pad-tip-454: onset -0.336 mm from the expected (power 1.50, fit 143.2 mN)
  pad-flank-433: onset -0.063 mm from the expected (power 2.00, fit 160.7 mN)
  pad-flank-387-o35-a90: onset +0.207 mm from the expected (power 1.25, fit 40.7 mN)
  pad-flank-549-o20-a0: onset -0.372 mm from the expected (power 1.25, fit 144.4 mN)
  pad-flank-563-o35-a180: onset -0.447 mm from the expected (power 1.00, fit 123.3 mN)
  pad-edge-576: onset -0.300 mm from the expected (power 1.00, fit 148.0 mN)
  pad-edge-628: onset -0.536 mm from the expected (power 2.00, fit 229.2 mN)
  pad-edge-639-o35-a0: onset -0.352 mm from the expected (power 1.00, fit 189.0 mN)
  pad-edge-639-o35-a90: onset -0.475 mm from the expected (power 1.50, fit 250.4 mN)
  pad-edge-666: onset -0.684 mm from the expected (power 1.75, fit 183.9 mN)
  pad-face-731-o35-a270: onset -0.593 mm from the expected (power 1.00, fit 121.6 mN)
  pad-face-756-o35-a90: onset -0.931 mm from the expected (power 2.00, fit 143.8 mN)
  pad-flank-535-o20-a270: onset -0.088 mm from the expected (power 2.00, fit 75.0 mN)
  pad-flank-535: onset -0.050 mm from the expected (power 1.00, fit 160.5 mN)
  pad-flank-535-o20-a90: onset -0.035 mm from the expected (power 1.00, fit 212.9 mN)
  pad-flank-535-o20-a0: onset -0.121 mm from the expected (power 1.75, fit 146.8 mN)
  pad-tip-460-o35-a270: onset -0.208 mm from the expected (power 1.25, fit 35.6 mN)
  pad-tip-344: onset +0.378 mm from the expected (power 1.00, fit 128.3 mN)
== register
register (probe): pad touches 0.053 mm rms (19); the seat's pad stands 1.497 mm, 1.378 deg from its CAD (the turn about z_P -0.553 deg, sd 0.478); the sphere's centre 1.124 mm, at [ -0.454  -0.442 117.072] in M (sd [0.114 0.095 0.055] mm)
== grid
  probe-ref-00 (1/269): to 3.00 N
  probe-tip-454 (2/269): to 2.00 N
  probe-tip-342 (3/269): to 2.00 N
  probe-tip-342-o20-a0 (4/269): to 2.00 N
  probe-tip-342-o20-a180 (5/269): to 2.00 N
  probe-tip-342-o20-a90 (6/269): to 2.00 N
  probe-tip-342-o35-a180 (7/269): to 2.00 N
  probe-tip-342-o35-a0 (8/269): to 2.00 N
  probe-tip-342-o35-a90 (9/269): to 2.00 N
  probe-flank-430-o20-a0 (10/269): to 2.00 N
  probe-flank-445 (11/269): to 2.00 N
  probe-flank-430 (12/269): to 2.00 N
  probe-flank-430-o20-a270 (13/269): to 2.00 N
  probe-flank-430-o35-a270 (14/269): to 2.00 N
  probe-flank-430-o20-a90 (15/269): to 2.00 N
  probe-flank-430-o20-a180 (16/269): to 2.00 N
  probe-flank-430-o35-a0 (17/269): to 2.00 N
  probe-flank-430-o35-a180 (18/269): to 2.00 N
  probe-flank-430-o35-a90 (19/269): to 2.00 N
  probe-flank-544 (20/269): to 2.00 N
  probe-flank-387 (21/269): to 2.00 N
  probe-flank-387-o20-a0 (22/269): to 2.00 N
  probe-flank-387-o20-a270 (23/269): to 2.00 N
  probe-flank-387-o35-a270 (24/269): to 2.00 N
  probe-flank-387-o20-a90 (25/269): to 2.00 N
  probe-flank-387-o20-a180 (26/269): to 2.00 N
  probe-ref-01 (27/269): to 3.00 N
  probe-flank-387-o35-a180 (28/269): to 2.00 N
  probe-flank-387-o35-a0 (29/269): to 2.00 N
  probe-flank-433 (30/269): to 2.00 N
  probe-flank-436 (31/269): to 2.00 N
  probe-flank-438 (32/269): to 2.00 N
  probe-flank-438-o20-a270 (33/269): to 2.00 N
  probe-flank-440 (34/269): to 2.00 N
  probe-flank-387-o35-a90 (35/269): to 2.00 N
  probe-flank-438-o20-a0 (36/269): to 2.00 N
  probe-flank-438-o20-a90 (37/269): to 2.00 N
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
  probe-tip-458 (268/269): to 2.00 N
  probe-ref-final (269/269): to 3.00 N
HEX-E: 497626 samples, 0 timed out, 0 late datagrams dropped, 2 gaps over 0.5 s; 0.8 s, Fz +0.5 N; 0.7 s, Fz +0.3 N
session in /home/will/workspace/hand/logs/20261103-tip_calibration/144808-s2sph2
exit 0 at 16:11:13
