badinkajink/hand/docs/experiments/20261022-ur5_tip_calibration/lab/20261103-122020-s1sph2b/printout.txt

speed slider 0.30 (the plan's 0.30)
== preflight
preflight: HEX-E 100 Hz (asked 100 Hz, filter 3), board 136 records/s, robot 124 Hz
  held boards on /dev/serial/by-id/usb-Adafruit_QT_Py_ESP32-S3__4MB_Flash_2MB_PSRAM__b4:3a:45:b0:d9:94-if00: mux channel 0 136 records/s, mux channel 2 136 records/s, mux channel 3 136 records/s
  HEX-E noise (1 sigma) N, N m: [0.045  0.0196 0.2426 0.0029 0.0039 0.0011]
  HEX-E reads: 0 timed out, 0 late datagrams dropped (0 and 0 on a clean link)
  payload set: 0.403 kg at [0.0, -0.5, 34.3] mm from the flange
== homing
homing: from the recorded seating docs/experiments/20261022-ur5_tip_calibration/lab/poses.jsonl:strip_key1_seated_4 (no freedrive, nothing moves)
homing: the fixture's frame from docs/experiments/20261030-inverted_rig_seat_block/data/20261102-strip_frame_pads.json, 4.15 mm and 4.49 deg from the seating's own
homing: 1 seatings within 0.000 mm, 0.000 deg of their mean
  indenter at (-201.4, -419.8, 36.6) mm, yaw -92.2 deg, tilt 0.00 deg; the plan has (-201, -420, 37) mm, yaw -92 deg
== pad
  pad-ref-00: onset -0.588 mm from the expected (power 1.25, fit 242.8 mN)
  pad-flank-430-o35-a270: onset -0.412 mm from the expected (power 1.75, fit 242.8 mN)
  pad-flank-387-o20-a270: onset +0.162 mm from the expected (power 1.25, fit 216.7 mN)
  pad-flank-549-o35-a0: onset -0.682 mm from the expected (power 1.00, fit 111.2 mN)
  pad-flank-563-o35-a180: onset -0.724 mm from the expected (power 1.00, fit 125.9 mN)
  pad-edge-628: onset -0.824 mm from the expected (power 1.25, fit 211.6 mN)
  pad-edge-639-o35-a0: onset -0.870 mm from the expected (power 2.00, fit 191.0 mN)
  pad-edge-639-o35-a90: onset -0.915 mm from the expected (power 1.75, fit 232.2 mN)
  pad-edge-651: onset -0.279 mm from the expected (power 1.25, fit 177.0 mN)
  pad-edge-666: onset -0.656 mm from the expected (power 1.00, fit 181.0 mN)
  pad-face-717-o35-a90: onset -0.860 mm from the expected (power 1.00, fit 187.6 mN)
  pad-face-731-o35-a180: onset -0.830 mm from the expected (power 1.75, fit 183.2 mN)
  pad-face-731-o35-a270: onset -0.720 mm from the expected (power 1.25, fit 119.3 mN)
  pad-flank-535: onset +0.008 mm from the expected (power 2.00, fit 164.2 mN)
  pad-flank-535-o20-a90: onset +0.081 mm from the expected (power 1.25, fit 211.8 mN)
  pad-flank-535-o20-a180: onset +0.103 mm from the expected (power 1.00, fit 150.5 mN)
  pad-tip-460-o35-a0: onset -0.113 mm from the expected (power 1.25, fit 44.8 mN)
  pad-tip-460-o35-a270: onset -0.109 mm from the expected (power 1.25, fit 46.0 mN)
  pad-tip-458: onset -0.247 mm from the expected (power 1.25, fit 139.2 mN)
== register
register (probe): pad touches 0.060 mm rms (19); the seat's pad stands 1.806 mm, 1.960 deg from its CAD (the turn about z_P -0.122 deg, sd 0.480); the sphere's centre 0.801 mm, at [-1.50000e-01  3.40000e-02  1.17214e+02] in M (sd [0.168 0.193 0.101] mm)
== grid
  probe-ref-00 (1/260): to 3.00 N
  probe-tip-454 (2/260): to 2.00 N
  probe-flank-445 (3/260): to 2.00 N
  probe-flank-430 (4/260): to 2.00 N
  probe-flank-430-o20-a270 (5/260): to 2.00 N
  probe-flank-430-o35-a270 (6/260): to 2.00 N
  probe-flank-430-o20-a0 (7/260): to 2.00 N
  probe-flank-430-o20-a90 (8/260): to 2.00 N
  probe-flank-430-o20-a180 (9/260): to 2.00 N
  probe-flank-430-o35-a0 (10/260): to 1.00 N
  probe-flank-430-o35-a180 (11/260): to 2.00 N
  probe-flank-430-o35-a90 (12/260): to 2.00 N
  probe-flank-544 (13/260): to 2.00 N
  probe-flank-387-o20-a270 (14/260): to 2.00 N
  probe-flank-387 (15/260): to 2.00 N
  probe-flank-387-o20-a0 (16/260): to 2.00 N
  probe-flank-387-o20-a180 (17/260): to 2.00 N
  probe-flank-387-o35-a270 (18/260): to 2.00 N
  probe-flank-387-o20-a90 (19/260): to 2.00 N
  probe-flank-387-o35-a0 (20/260): to 2.00 N
  probe-flank-387-o35-a180 (21/260): to 1.00 N
  probe-flank-436 (22/260): to 2.00 N
  probe-flank-438 (23/260): to 2.00 N
  probe-flank-438-o20-a270 (24/260): to 2.00 N
  probe-flank-440 (25/260): to 2.00 N
  probe-flank-387-o35-a90 (26/260): to 1.00 N
  probe-ref-01 (27/260): to 3.00 N
  probe-flank-433 (28/260): to 2.00 N
  probe-flank-438-o20-a0 (29/260): to 2.00 N
  probe-flank-438-o20-a90 (30/260): to 2.00 N
  probe-flank-438-o20-a180 (31/260): to 2.00 N
  probe-flank-438-o35-a270 (32/260): to 1.00 N
  probe-flank-449 (33/260): to 2.00 N
  probe-flank-449-o20-a180 (34/260): to 2.00 N
  probe-flank-449-o20-a270 (35/260): to 2.00 N
  probe-flank-438-o35-a0 (36/260): to 1.00 N
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
  probe-tip-458 (259/260): to 2.00 N
  probe-ref-final (260/260): to 3.00 N
HEX-E: 884840 samples, 0 timed out, 0 late datagrams dropped, 2 gaps over 0.5 s; 1.0 s, Fz -0.5 N; 0.7 s, Fz -0.5 N
session in /home/will/workspace/hand/logs/20261103-tip_calibration/122020-s1sph2b
exit 0 at 14:48:02
