badinkajink/hand/docs/experiments/20261022-ur5_tip_calibration/lab/20261102-182710-s2v5/printout_fast2_1007_stopped.txt

resumed /home/will/workspace/hand/logs/20261102-tip_calibration/182710-s2v5: 595 actions done, 20 touches
speed slider 0.30 (the plan's 0.30)
== preflight
preflight: HEX-E 100 Hz (asked 100 Hz, filter 3), board 138 records/s, robot 124 Hz
  held boards on /dev/serial/by-id/usb-Adafruit_QT_Py_ESP32-S3__4MB_Flash_2MB_PSRAM__b4:3a:45:b0:d9:94-if00: mux channel 0 138 records/s, mux channel 2 138 records/s, mux channel 3 138 records/s
  HEX-E noise (1 sigma) N, N m: [0.0401 0.0255 0.2456 0.0028 0.004  0.0011]
  HEX-E reads: 0 timed out, 0 late datagrams dropped (0 and 0 on a clean link)
  payload set: 0.403 kg at [0.0, -0.5, 34.3] mm from the flange
== grid
  probe-ref-00-v060 (1/264): to 3.00 N
  probe-flank-476-v060 (2/264): to 2.00 N
  probe-flank-426-v060 (4/264): to 2.00 N
  probe-flank-430-o20-a0-v060 (6/264): to 2.00 N
  probe-flank-430-o20-a90-v060 (7/264): to 2.00 N
  probe-flank-430-o20-a180-v060 (8/264): to 2.00 N
  probe-flank-430-o20-a270-v060 (9/264): to 2.00 N
  probe-flank-430-o35-a0-v060 (10/264): to 2.00 N
  probe-flank-430-o35-a90-v060 (11/264): to 2.00 N
  probe-flank-430-o35-a180-v060 (12/264): to 2.00 N
  probe-flank-430-o35-a270-v060 (13/264): to 2.00 N
  probe-flank-433-v060 (14/264): to 2.00 N
  probe-flank-436-v060 (15/264): to 2.00 N
  probe-flank-438-v060 (16/264): to 2.00 N
  probe-flank-438-o20-a0-v060 (17/264): to 2.00 N
  probe-flank-438-o20-a90-v060 (18/264): to 2.00 N
  probe-flank-438-o20-a180-v060 (19/264): to 2.00 N
  probe-flank-438-o20-a270-v060 (20/264): to 2.00 N
  probe-flank-438-o35-a0-v060 (21/264): to 2.00 N
  probe-flank-438-o35-a90-v060 (22/264): to 2.00 N
  probe-flank-438-o35-a180-v060 (23/264): to 2.00 N
  probe-flank-438-o35-a270-v060 (24/264): to 2.00 N
  probe-flank-440-v060 (25/264): to 2.00 N

interrupted: stopping the robot
HEX-E: 52036 samples, 0 timed out, 0 late datagrams dropped, 2 gaps over 0.5 s; 1.2 s, Fz +0.6 N; 0.7 s, Fz +0.0 N
session in /home/will/workspace/hand/logs/20261102-tip_calibration/182710-s2v5
exit 0 at 10:16:43
