badinkajink/hand/docs/experiments/20261022-ur5_tip_calibration/lab/20261102-220337-s3v4/printout_fast3_0831.txt

resumed /home/will/workspace/hand/logs/20261102-tip_calibration/220337-s3v4: 597 actions done, 20 touches
speed slider 0.30 (the plan's 0.30)
== preflight
preflight: HEX-E 100 Hz (asked 100 Hz, filter 3), board 138 records/s, robot 124 Hz
  held boards on /dev/serial/by-id/usb-Adafruit_QT_Py_ESP32-S3__4MB_Flash_2MB_PSRAM__b4:3a:45:b0:d9:94-if00: mux channel 0 138 records/s, mux channel 2 138 records/s, mux channel 3 138 records/s
  HEX-E noise (1 sigma) N, N m: [0.0421 0.0122 0.2483 0.003  0.004  0.0011]
  HEX-E reads: 0 timed out, 0 late datagrams dropped (0 and 0 on a clean link)
  payload set: 0.403 kg at [0.0, -0.5, 34.3] mm from the flange
== grid
  probe-ref-00-v060 (1/263): to 3.00 N
  probe-flank-426-v060 (3/263): to 2.00 N
  probe-flank-430-o20-a0-v060 (5/263): to 2.00 N
  probe-flank-430-o20-a90-v060 (6/263): to 2.00 N
  probe-flank-430-o20-a180-v060 (7/263): to 2.00 N
  probe-flank-430-o20-a270-v060 (8/263): to 2.00 N
  probe-flank-430-o35-a0-v060 (9/263): to 2.00 N
  probe-flank-430-o35-a90-v060 (10/263): to 2.00 N
  probe-flank-430-o35-a180-v060 (11/263): to 2.00 N
  probe-flank-430-o35-a270-v060 (12/263): to 2.00 N
  probe-flank-433-v060 (13/263): to 2.00 N
  probe-flank-436-v060 (14/263): to 2.00 N
  probe-flank-438-v060 (15/263): to 2.00 N
  probe-flank-438-o20-a0-v060 (16/263): to 2.00 N
  probe-flank-438-o20-a90-v060 (17/263): to 2.00 N
  probe-flank-438-o20-a180-v060 (18/263): to 2.00 N
  probe-flank-438-o20-a270-v060 (19/263): to 2.00 N
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
  probe-face-756-o35-a0-v060 (233/263): to 3.00 N
  probe-face-756-o35-a90-v060 (234/263): to 3.00 N
  probe-face-756-o35-a180-v060 (235/263): to 3.00 N
  probe-face-756-o35-a270-v060 (236/263): to 3.00 N
  probe-face-768-v060 (238/263): to 3.00 N
  probe-face-776-v060 (239/263): to 3.00 N
  probe-face-776-o20-a0-v060 (240/263): to 3.00 N
  probe-face-776-o20-a90-v060 (241/263): to 3.00 N
  probe-face-776-o20-a180-v060 (242/263): to 3.00 N
  probe-face-776-o20-a270-v060 (243/263): to 3.00 N
  probe-face-776-o35-a0-v060 (244/263): to 3.00 N
  probe-face-776-o35-a90-v060 (245/263): to 3.00 N
  probe-face-776-o35-a180-v060 (246/263): to 3.00 N
  probe-ref-10-v060 (247/263): to 3.00 N
  probe-face-776-o35-a270-v060 (248/263): to 3.00 N
  probe-face-781-v060 (249/263): to 3.00 N
  probe-face-785-v060 (250/263): to 3.00 N
  probe-face-790-o20-a0-v060 (252/263): to 3.00 N
  probe-face-790-o20-a90-v060 (253/263): to 3.00 N
  probe-face-790-o20-a180-v060 (254/263): to 3.00 N
  probe-face-790-o20-a270-v060 (255/263): to 3.00 N
  probe-face-790-o35-a0-v060 (256/263): to 3.00 N
  probe-face-790-o35-a90-v060 (257/263): to 3.00 N
  probe-face-790-o35-a180-v060 (258/263): to 3.00 N
  probe-face-790-o35-a270-v060 (259/263): to 3.00 N
  probe-flank-593-o20-a180-v060 (260/263): to 2.00 N
  probe-flank-593-o35-a0-v060 (261/263): to 1.00 N
  probe-ref-final-v060 (263/263): to 3.00 N
HEX-E: 579399 samples, 0 timed out, 0 late datagrams dropped, 2 gaps over 0.5 s; 1.1 s, Fz +0.4 N; 0.7 s, Fz -0.1 N
session in /home/will/workspace/hand/logs/20261102-tip_calibration/220337-s3v4
exit 0 at 10:07:55
