badinkajink/hand/docs/experiments/20261022-ur5_tip_calibration/lab/20261102-182710-s2v5/printout_night2_0441.txt

resumed /home/will/workspace/hand/logs/20261102-tip_calibration/182710-s2v5: 364 actions done, 20 touches
speed slider 0.30 (the plan's 0.30)
== preflight
preflight: HEX-E 100 Hz (asked 100 Hz, filter 3), board 138 records/s, robot 124 Hz
  held boards on /dev/serial/by-id/usb-Adafruit_QT_Py_ESP32-S3__4MB_Flash_2MB_PSRAM__b4:3a:45:b0:d9:94-if00: mux channel 0 138 records/s, mux channel 2 138 records/s, mux channel 3 138 records/s
  HEX-E noise (1 sigma) N, N m: [0.0353 0.03   0.2334 0.0028 0.0036 0.0011]
  HEX-E reads: 0 timed out, 0 late datagrams dropped (0 and 0 on a clean link)
  payload set: 0.403 kg at [0.0, -0.5, 34.3] mm from the flange
== grid
  probe-ref-00-n (1/231): to 3.00 N
  probe-flank-476-o30-a225-n (2/231): to 2.00 N
  probe-flank-476-o10-a45-n (3/231): to 2.00 N
  probe-flank-476-o30-a45-n (4/231): to 2.00 N
  probe-flank-413-o10-a45-n (5/231): to 2.00 N
  probe-flank-413-o10-a225-n (6/231): to 2.00 N
  probe-flank-413-o20-a45-n (7/231): to 2.00 N
  probe-flank-413-o20-a225-n (8/231): to 2.00 N
  probe-flank-413-o30-a45-n (9/231): to 1.00 N
  probe-flank-413-o30-a225-n (10/231): to 2.00 N
  probe-flank-426-o10-a90-n (11/231): to 2.00 N
  probe-flank-426-o10-a270-n (12/231): to 2.00 N
  probe-flank-426-o20-a90-n (13/231): to 2.00 N
  probe-flank-426-o20-a270-n (14/231): to 2.00 N
  probe-flank-426-o30-a90-n (15/231): to 1.00 N
  probe-flank-426-o30-a270-n (16/231): to 2.00 N
  probe-flank-430-o10-a135-n (17/231): to 2.00 N
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
  probe-flank-595-o20-a225-n (226/231): to 2.00 N
  probe-flank-593-o20-a180-n (227/231): to 2.00 N
  probe-flank-476-o20-a225-n (228/231): to 2.00 N
  probe-flank-593-o30-a0-n (229/231): to 2.00 N
  probe-flank-478-o10-a90-n (230/231): to 2.00 N
  probe-ref-final-n (231/231): to 3.00 N
HEX-E: 687390 samples, 0 timed out, 0 late datagrams dropped, 2 gaps over 0.5 s; 0.8 s, Fz -0.3 N; 0.7 s, Fz +0.1 N
session in /home/will/workspace/hand/logs/20261102-tip_calibration/182710-s2v5
exit 0 at 06:36:22
