badinkajink/hand/docs/experiments/20261022-ur5_tip_calibration/lab/20261102-145010-s1v6b/printout_speed1_0226.txt

resumed logs/20261102-tip_calibration/145010-s1v6b: 316 actions done, 20 touches
speed slider 0.30 (the plan's 0.30)
== preflight
preflight: HEX-E 100 Hz (asked 100 Hz, filter 3), board 138 records/s, robot 124 Hz
  held boards on /dev/serial/by-id/usb-Adafruit_QT_Py_ESP32-S3__4MB_Flash_2MB_PSRAM__b4:3a:45:b0:d9:94-if00: mux channel 0 138 records/s, mux channel 2 138 records/s, mux channel 3 138 records/s
  HEX-E noise (1 sigma) N, N m: [0.0355 0.0256 0.2517 0.0031 0.0039 0.001 ]
  HEX-E reads: 0 timed out, 0 late datagrams dropped (0 and 0 on a clean link)
  payload set: 0.403 kg at [0.0, -0.5, 34.3] mm from the flange
== grid
  probe-ref-v005 (1/48): to 3.00 N
  probe-ref-v015 (2/48): to 3.00 N
  probe-ref-v060 (3/48): to 3.00 N
  probe-ref-v120 (4/48): to 3.00 N
  probe-face-690-v015 (5/48): to 3.00 N
  probe-face-690-v060 (6/48): to 3.00 N
  probe-face-690-v120 (7/48): to 3.00 N
  probe-face-690-v005 (8/48): to 3.00 N
  probe-face-717-v060 (9/48): to 3.00 N
  probe-face-717-v120 (10/48): to 3.00 N
  probe-face-717-v005 (11/48): to 3.00 N
  probe-face-717-v015 (12/48): to 3.00 N
  probe-face-759-v120 (13/48): to 3.00 N
  probe-face-759-v005 (14/48): to 3.00 N
  probe-face-759-v015 (15/48): to 3.00 N
  probe-face-759-v060 (16/48): to 3.00 N
  probe-face-790-v005 (17/48): to 3.00 N
  probe-face-790-v015 (18/48): to 3.00 N
  probe-face-790-v060 (19/48): to 3.00 N
  probe-face-790-v120 (20/48): to 3.00 N
  probe-flank-413-v015 (21/48): to 2.00 N
  probe-flank-413-v060 (22/48): to 2.00 N
  probe-flank-413-v120 (23/48): to 2.00 N
  probe-flank-413-v005 (24/48): to 2.00 N
  probe-flank-595-v060 (25/48): to 2.00 N
  probe-flank-595-v120 (26/48): to 2.00 N
  probe-flank-595-v005 (27/48): to 2.00 N
  probe-flank-595-v015 (28/48): to 2.00 N
  probe-flank-430-v120 (29/48): to 2.00 N
  probe-flank-430-v005 (30/48): to 2.00 N
  probe-flank-430-v015 (31/48): to 2.00 N
  probe-flank-430-v060 (32/48): to 2.00 N
  probe-flank-563-v005 (33/48): to 2.00 N
  probe-flank-563-v015 (34/48): to 2.00 N
  probe-flank-563-v060 (35/48): to 2.00 N
  probe-flank-563-v120 (36/48): to 2.00 N
  probe-edge-565-v015 (37/48): to 3.00 N
  probe-edge-565-v060 (38/48): to 3.00 N
  probe-edge-565-v120 (39/48): to 3.00 N
  probe-edge-565-v005 (40/48): to 3.00 N
  probe-edge-634-v060 (41/48): to 3.00 N
  probe-edge-634-v120 (42/48): to 3.00 N
  probe-edge-634-v005 (43/48): to 3.00 N
  probe-edge-634-v015 (44/48): to 3.00 N
  probe-edge-729-v120 (45/48): to 3.00 N
  probe-edge-729-v005 (46/48): to 3.00 N
  probe-edge-729-v015 (47/48): to 3.00 N
  probe-edge-729-v060 (48/48): to 3.00 N
HEX-E: 125868 samples, 0 timed out, 0 late datagrams dropped, 2 gaps over 0.5 s; 0.6 s, Fz +0.9 N; 0.7 s, Fz -0.6 N
session in logs/20261102-tip_calibration/145010-s1v6b
exit 0 at 02:47:50
