badinkajink/hand/docs/experiments/20261022-ur5_tip_calibration/lab/20261102-182710-s2v5/printout.txt

speed slider 0.30 (the plan's 0.30)
== preflight
preflight: HEX-E 100 Hz (asked 100 Hz, filter 3), board 138 records/s, robot 124 Hz
  held boards on /dev/serial/by-id/usb-Adafruit_QT_Py_ESP32-S3__4MB_Flash_2MB_PSRAM__b4:3a:45:b0:d9:94-if00: mux channel 0 138 records/s, mux channel 2 138 records/s, mux channel 3 138 records/s
  HEX-E noise (1 sigma) N, N m: [0.0352 0.046  0.2323 0.0029 0.0042 0.001 ]
  HEX-E reads: 0 timed out, 0 late datagrams dropped (0 and 0 on a clean link)
  payload set: 0.403 kg at [0.0, -0.5, 34.3] mm from the flange
== homing
homing: from the recorded seating docs/experiments/20261022-ur5_tip_calibration/lab/poses.jsonl:strip_key1_seated_4 (no freedrive, nothing moves)
homing: the fixture's frame from docs/experiments/20261022-ur5_tip_calibration/lab/20261102-strip_frame_two_keys.json, 3.94 mm and 3.67 deg from the seating's own
homing: 1 seatings within 0.000 mm, 0.000 deg of their mean
  indenter at (-201.4, -417.3, 40.3) mm, yaw -92.2 deg, tilt 0.00 deg; the plan has (-201, -417, 40) mm, yaw -92 deg
== pad
  pad-ref-00: onset -0.959 mm from the expected (power 2.00, fit 240.6 mN)
  pad-flank-445: onset +0.118 mm from the expected (power 1.25, fit 93.3 mN)
  pad-flank-449-o35-a180: onset -0.355 mm from the expected (power 1.00, fit 92.2 mN)
  pad-flank-449-o35-a270: onset -0.362 mm from the expected (power 1.00, fit 207.1 mN)
  pad-tip-454: onset +0.145 mm from the expected (power 1.25, fit 103.2 mN)
  pad-tip-458: onset +0.022 mm from the expected (power 1.00, fit 123.3 mN)
  pad-tip-460-o35-a180: onset -0.062 mm from the expected (power 1.00, fit 162.9 mN)
  pad-flank-462: onset -0.206 mm from the expected (power 1.00, fit 106.1 mN)
  pad-flank-549-o35-a180: onset -0.410 mm from the expected (power 2.00, fit 124.7 mN)
  pad-edge-628: onset -1.134 mm from the expected (power 1.00, fit 214.6 mN)
  pad-edge-639-o35-a0: onset -1.522 mm from the expected (power 1.25, fit 197.5 mN)
  pad-edge-639-o35-a90: onset -1.686 mm from the expected (power 1.75, fit 253.4 mN)
  pad-edge-666: onset -0.486 mm from the expected (power 1.50, fit 185.2 mN)
  pad-face-717-o35-a90: onset -1.764 mm from the expected (power 1.75, fit 202.3 mN)
  pad-edge-729: onset -0.796 mm from the expected (power 2.00, fit 207.0 mN)
  pad-face-731-o20-a270: onset -0.918 mm from the expected (power 1.25, fit 176.1 mN)
  pad-face-731-o35-a180: onset -0.959 mm from the expected (power 1.00, fit 182.7 mN)
  pad-face-731-o35-a270: onset -0.977 mm from the expected (power 1.00, fit 120.5 mN)
  pad-face-756-o35-a90: onset -0.784 mm from the expected (power 1.75, fit 144.6 mN)
  pad-face-776-o35-a90: onset -0.996 mm from the expected (power 1.25, fit 187.8 mN)
== register
register (probe): pad touches 0.051 mm rms (20); the seat's pad stands 1.211 mm, 3.496 deg from its CAD (the turn about z_P -0.738 deg, sd 0.466); the sphere's centre 0.412 mm, at [8.300e-02 5.100e-02 1.154e+02] in M (sd [0.255 0.255 0.257] mm)
== grid
  probe-ref-00 (1/294): to 3.00 N
  probe-flank-476 (2/294): to 2.00 N
  probe-flank-413 (3/294): to 2.00 N
  probe-flank-426 (4/294): to 2.00 N
  probe-flank-430 (5/294): to 2.00 N
  probe-flank-430-o20-a0 (6/294): to 2.00 N
  probe-flank-430-o20-a90 (7/294): to 2.00 N
  probe-flank-430-o20-a180 (8/294): to 2.00 N
  probe-flank-430-o20-a270 (9/294): to 2.00 N
  probe-flank-430-o35-a0 (10/294): to 2.00 N
  probe-flank-430-o35-a90 (11/294): to 2.00 N
  probe-flank-430-o35-a180 (12/294): to 2.00 N
  probe-flank-430-o35-a270 (13/294): to 2.00 N
  probe-flank-433 (14/294): to 2.00 N
  probe-flank-436 (15/294): to 2.00 N
  probe-flank-438 (16/294): to 2.00 N
  probe-flank-438-o20-a0 (17/294): to 2.00 N
  probe-flank-438-o20-a90 (18/294): to 2.00 N
  probe-flank-438-o20-a180 (19/294): to 2.00 N
  probe-flank-438-o20-a270 (20/294): to 2.00 N
  probe-flank-438-o35-a0 (21/294): to 2.00 N
  probe-flank-438-o35-a90 (22/294): to 2.00 N
  probe-flank-438-o35-a180 (23/294): to 2.00 N
  probe-flank-438-o35-a270 (24/294): to 2.00 N
  probe-flank-440 (25/294): to 2.00 N
  probe-flank-445 (26/294): to 2.00 N
  probe-ref-01 (27/294): to 3.00 N
  probe-flank-449 (28/294): to 2.00 N
  probe-flank-449-o20-a0 (29/294): to 2.00 N
  probe-flank-449-o20-a90 (30/294): to 2.00 N
  probe-flank-449-o20-a180 (31/294): to 2.00 N
  probe-flank-449-o20-a270 (32/294): to 2.00 N
  probe-flank-449-o35-a0 (33/294): to 2.00 N
  probe-flank-449-o35-a90 (34/294): to 2.00 N
  probe-flank-449-o35-a180 (35/294): to 2.00 N
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
  probe-face-776-o35-a270 (269/294): to 3.00 N
  probe-face-781 (270/294): to 3.00 N
  probe-face-785 (271/294): to 3.00 N
  probe-face-785-t-15 (272/294): to 3.00 N
  probe-face-785-t-15-1N (273/294): to 1.00 N
  probe-face-785-t+15 (274/294): to 3.00 N
  probe-face-785-t+15-1N (275/294): to 1.00 N
  probe-ref-10 (276/294): to 3.00 N
  probe-face-790 (277/294): to 3.00 N
  probe-face-790-o20-a0 (278/294): to 3.00 N
  probe-face-790-o20-a90 (279/294): to 3.00 N
  probe-face-790-o20-a180 (280/294): to 3.00 N
  probe-face-790-o20-a270 (281/294): to 3.00 N
  probe-face-790-o35-a0 (282/294): to 3.00 N
  probe-face-790-o35-a90 (283/294): to 3.00 N
  probe-face-790-o35-a180 (284/294): to 3.00 N
  probe-face-790-o35-a270 (285/294): to 3.00 N
  probe-flank-593 (286/294): to 2.00 N
  probe-flank-593-o20-a90 (287/294): to 2.00 N
  probe-flank-593-o35-a90 (288/294): to 1.00 N
  probe-flank-595 (289/294): to 2.00 N
  probe-flank-593-o20-a180 (290/294): to 2.00 N
  probe-flank-593-o35-a0 (291/294): to 2.00 N
  probe-flank-593-o35-a270 (292/294): to 2.00 N
  probe-flank-593-o20-a270 (293/294): to 2.00 N
  probe-ref-final (294/294): to 3.00 N
HEX-E: 1296427 samples, 0 timed out, 0 late datagrams dropped, 2 gaps over 0.5 s; 0.9 s, Fz +0.3 N; 0.6 s, Fz +0.3 N
session in /home/will/workspace/hand/logs/20261102-tip_calibration/182710-s2v5
exit 0 at 22:03:30
