badinkajink/hand/docs/experiments/20261022-ur5_tip_calibration/lab/20261102-145010-s1v6b/printout.txt

speed slider 0.30 (the plan's 0.30)
== preflight
preflight: HEX-E 100 Hz (asked 100 Hz, filter 3), board 138 records/s, robot 124 Hz
  held boards on /dev/serial/by-id/usb-Adafruit_QT_Py_ESP32-S3__4MB_Flash_2MB_PSRAM__b4:3a:45:b0:d9:94-if00: mux channel 0 138 records/s, mux channel 2 138 records/s, mux channel 3 138 records/s
  HEX-E noise (1 sigma) N, N m: [0.0471 0.0452 0.2336 0.0024 0.0038 0.001 ]
  HEX-E reads: 0 timed out, 0 late datagrams dropped (0 and 0 on a clean link)
  payload set: 0.403 kg at [0.0, -0.5, 34.3] mm from the flange
== homing
homing: from the recorded seating docs/experiments/20261022-ur5_tip_calibration/lab/poses.jsonl:strip_key1_seated_4 (no freedrive, nothing moves)
homing: the fixture's frame from docs/experiments/20261022-ur5_tip_calibration/lab/20261102-strip_frame_two_keys.json, 3.94 mm and 3.67 deg from the seating's own
homing: 1 seatings within 0.000 mm, 0.000 deg of their mean
  indenter at (-201.4, -417.3, 40.3) mm, yaw -92.2 deg, tilt 0.00 deg; the plan has (-201, -417, 40) mm, yaw -92 deg
== pad
  pad-ref-00: onset -1.379 mm from the expected (power 1.00, fit 235.0 mN)
  pad-flank-445: onset -0.135 mm from the expected (power 1.00, fit 99.8 mN)
  pad-flank-449-o35-a180: onset -0.646 mm from the expected (power 1.25, fit 80.6 mN)
  pad-flank-449-o35-a270: onset -0.688 mm from the expected (power 1.00, fit 205.8 mN)
  pad-tip-454: onset -0.121 mm from the expected (power 1.00, fit 113.9 mN)
  pad-tip-458: onset -0.209 mm from the expected (power 1.00, fit 131.7 mN)
  pad-tip-460-o35-a180: onset -0.208 mm from the expected (power 1.00, fit 170.5 mN)
  pad-flank-462: onset -0.255 mm from the expected (power 1.50, fit 99.4 mN)
  pad-flank-549-o35-a180: onset -0.705 mm from the expected (power 1.00, fit 118.1 mN)
  pad-edge-628: onset -1.684 mm from the expected (power 1.00, fit 210.4 mN)
  pad-edge-639-o35-a0: onset -2.196 mm from the expected (power 1.25, fit 185.5 mN)
  pad-edge-639-o35-a90: onset -2.279 mm from the expected (power 1.25, fit 214.2 mN)
  pad-edge-666: onset -0.887 mm from the expected (power 1.25, fit 189.5 mN)
  pad-face-717-o35-a90: onset -2.481 mm from the expected (power 1.00, fit 227.9 mN)
  pad-edge-729: onset -1.236 mm from the expected (power 1.50, fit 219.4 mN)
  pad-face-731-o20-a270: onset -1.466 mm from the expected (power 1.75, fit 165.7 mN)
  pad-face-731-o35-a180: onset -1.574 mm from the expected (power 1.00, fit 175.9 mN)
  pad-face-731-o35-a270: onset -1.600 mm from the expected (power 1.75, fit 114.7 mN)
  pad-face-756-o35-a90: onset -1.440 mm from the expected (power 2.00, fit 137.1 mN)
  pad-face-776-o35-a90: onset -1.664 mm from the expected (power 1.75, fit 182.0 mN)
== register
register (probe): pad touches 0.055 mm rms (20); the seat's pad stands 1.678 mm, 4.119 deg from its CAD (the turn about z_P -0.261 deg, sd 0.473); the sphere's centre 0.579 mm, at [-1.40000e-02 -1.30000e-02  1.15579e+02] in M (sd [0.256 0.255 0.257] mm)
== grid
  probe-ref-00 (1/294): to 3.00 N
  probe-flank-593-o35-a90 (2/294): to 1.00 N
  probe-flank-413 (3/294): to 2.00 N
  probe-flank-426 (4/294): to 2.00 N
  probe-flank-430 (5/294): to 2.00 N
  probe-flank-430-o20-a0 (6/294): to 2.00 N
  probe-flank-430-o20-a90 (7/294): to 2.00 N
  probe-flank-430-o20-a180 (8/294): to 2.00 N
  probe-flank-430-o20-a270 (9/294): to 2.00 N
  probe-flank-430-o35-a0 (10/294): to 2.00 N
  probe-flank-430-o35-a90 (11/294): to 2.00 N
  probe-flank-430-o35-a180 (12/294): to 2.00 N
  probe-flank-430-o35-a270 (13/294): to 2.00 N
  probe-flank-433 (14/294): to 2.00 N
  probe-flank-436 (15/294): to 2.00 N
  probe-flank-438 (16/294): to 2.00 N
  probe-flank-438-o20-a0 (17/294): to 2.00 N
  probe-flank-438-o20-a90 (18/294): to 2.00 N
  probe-flank-438-o20-a180 (19/294): to 2.00 N
  probe-flank-438-o20-a270 (20/294): to 2.00 N
  probe-flank-438-o35-a0 (21/294): to 2.00 N
  probe-flank-438-o35-a90 (22/294): to 2.00 N
  probe-flank-438-o35-a180 (23/294): to 2.00 N
  probe-flank-438-o35-a270 (24/294): to 2.00 N
  probe-flank-440 (25/294): to 2.00 N
  probe-flank-445 (26/294): to 2.00 N
  probe-ref-01 (27/294): to 3.00 N
  probe-flank-449 (28/294): to 2.00 N
  probe-flank-449-o20-a0 (29/294): to 2.00 N
  probe-flank-449-o20-a90 (30/294): to 2.00 N
  probe-flank-449-o20-a180 (31/294): to 2.00 N
  probe-flank-449-o20-a270 (32/294): to 2.00 N
  probe-flank-449-o35-a0 (33/294): to 2.00 N
  probe-flank-449-o35-a90 (34/294): to 2.00 N
  probe-flank-449-o35-a180 (35/294): to 2.00 N
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
  probe-face-776-o35-a0 (268/294): to 2.00 N
  probe-face-776-o35-a90 (269/294): to 3.00 N
  probe-face-776-o35-a180 (270/294): to 3.00 N
  probe-face-776-o35-a270 (271/294): to 3.00 N
  probe-face-781 (272/294): to 3.00 N
  probe-face-785 (273/294): to 3.00 N
  probe-ref-10 (274/294): to 3.00 N
  probe-face-785-t-15 (275/294): to 3.00 N
  probe-face-785-t-15-1N (276/294): to 1.00 N
  probe-face-785-t+15 (277/294): to 3.00 N
  probe-face-785-t+15-1N (278/294): to 1.00 N
  probe-face-790 (279/294): to 3.00 N
  probe-face-790-o20-a0 (280/294): to 3.00 N
  probe-face-790-o20-a90 (281/294): to 3.00 N
  probe-face-790-o20-a180 (282/294): to 3.00 N
  probe-face-790-o20-a270 (283/294): to 3.00 N
  probe-face-790-o35-a0 (284/294): to 3.00 N
  probe-face-790-o35-a90 (285/294): to 3.00 N
  probe-face-790-o35-a180 (286/294): to 3.00 N
  probe-face-790-o35-a270 (287/294): to 3.00 N
  probe-flank-476 (288/294): to 2.00 N
  probe-flank-593-o20-a90 (289/294): to 2.00 N
  probe-flank-593-o20-a270 (290/294): to 2.00 N
  probe-flank-593 (291/294): to 2.00 N
  probe-flank-593-o35-a180 (292/294): to 1.00 N
  probe-flank-593-o20-a0 (293/294): to 2.00 N
  probe-ref-final (294/294): to 3.00 N
HEX-E: 1300309 samples, 0 timed out, 0 late datagrams dropped, 2 gaps over 0.5 s; 0.6 s, Fz -0.3 N; 0.6 s, Fz +0.1 N
session in /home/will/workspace/hand/logs/20261102-tip_calibration/145010-s1v6b
exit 0 at 18:27:09
