badinkajink/hand/docs/experiments/20261022-ur5_tip_calibration/lab/20261029-230820-rodv3id3/printout.txt

resumed logs/20261029-tip_calibration/230820-rodv3id3: 0 actions done, 0 touches
speed slider 0.30 (the plan's 0.30)
== preflight
preflight: HEX-E 100 Hz (asked 100 Hz, filter 3), board 336 records/s, robot 124 Hz
  HEX-E noise (1 sigma) N, N m: [0.0453 0.0487 0.2261 0.0029 0.0038 0.0011]
  HEX-E reads: 0 timed out, 0 late datagrams dropped (0 and 0 on a clean link)
  payload set: 0.403 kg at [0.0, -0.5, 34.3] mm from the flange
== pad
  pad-edge-05: onset +0.767 mm from the expected (power 2.00, fit 75.2 mN)
  pad-edge-03: onset +0.674 mm from the expected (power 2.00, fit 108.0 mN)
  pad-edge-07: onset +0.762 mm from the expected (power 2.00, fit 77.1 mN)
  pad-face-02: onset +0.735 mm from the expected (power 2.00, fit 53.7 mN)
  pad-edge-00: onset +0.658 mm from the expected (power 2.00, fit 49.1 mN)
  pad-face-07: onset +0.786 mm from the expected (power 1.00, fit 82.1 mN)
  pad-face-09: onset +0.692 mm from the expected (power 1.00, fit 50.0 mN)
  pad-face-11: onset +0.649 mm from the expected (power 2.00, fit 48.4 mN)
  pad-face-01: onset +0.700 mm from the expected (power 1.75, fit 97.3 mN)
  pad-face-05: onset +0.613 mm from the expected (power 1.25, fit 44.7 mN)
  pad-face-06: onset +0.702 mm from the expected (power 1.50, fit 58.3 mN)
  pad-face-00: onset +0.648 mm from the expected (power 1.50, fit 29.5 mN)
  pad-edge-02: onset +0.695 mm from the expected (power 1.00, fit 95.1 mN)
  pad-edge-08: onset +0.622 mm from the expected (power 2.00, fit 67.9 mN)
  pad-edge-09: onset +0.618 mm from the expected (power 1.00, fit 82.2 mN)
  pad-face-08: onset +0.596 mm from the expected (power 2.00, fit 56.6 mN)
  pad-face-10: onset +0.599 mm from the expected (power 1.25, fit 29.6 mN)
  pad-face-03: onset +0.634 mm from the expected (power 1.00, fit 30.1 mN)
  pad-edge-04: onset +0.700 mm from the expected (power 1.25, fit 55.9 mN)
  pad-face-04: onset +0.597 mm from the expected (power 1.00, fit 40.3 mN)
  pad-edge-06: onset +0.576 mm from the expected (power 1.50, fit 30.1 mN)
== pivot
== register
register: pad touches 0.037 mm rms (21), face nan mm (0); TCP moved 0.199 mm, 0.571 deg; sphere centre moved 0.590 mm
  TCP of the pad frame on the flange (for the pendant): 0.00035, -0.00310, 0.11816, -0.04477, -0.02309, -1.59667  (m, rotation vector)
HEX-E: 139361 samples, 0 timed out, 0 late datagrams dropped, 2 gaps over 0.5 s; 0.8 s, Fz +0.0 N; 0.7 s, Fz -0.2 N
session in logs/20261029-tip_calibration/230820-rodv3id3
exit 0 at 23:31:41
resumed logs/20261029-tip_calibration/230820-rodv3id3: 27 actions done, 21 touches
speed slider 0.30 (the plan's 0.30)
== preflight
preflight: HEX-E 100 Hz (asked 100 Hz, filter 3), board 339 records/s, robot 124 Hz
  HEX-E noise (1 sigma) N, N m: [0.0433 0.0271 0.2235 0.0028 0.0034 0.0011]
  HEX-E reads: 0 timed out, 0 late datagrams dropped (0 and 0 on a clean link)
  payload set: 0.403 kg at [0.0, -0.5, 34.3] mm from the flange
== grid
  rod-ref-a (1/69): to 2.00 N
  rod-grid-044 (2/69): to 6.00 N
  rod-grid-047 (3/69): to 6.00 N
  rod-grid-045 (4/69): to 6.00 N
  rod-grid-046 (5/69): to 6.00 N
  rod-grid-043 (6/69): to 6.00 N
  rod-grid-051 (7/69): to 6.00 N
  rod-grid-042 (8/69): to 6.00 N
  rod-grid-041 (9/69): to 6.00 N
  rod-grid-036 (10/69): to 6.00 N
  rod-grid-037 (11/69): to 6.00 N
  rod-grid-033 (12/69): to 6.00 N
  rod-grid-038 (13/69): to 6.00 N
  rod-grid-034 (14/69): to 6.00 N
  rod-grid-032 (15/69): to 6.00 N
  rod-grid-031 (16/69): to 6.00 N
  rod-grid-030 (17/69): to 4.50 N
  rod-more-630 (18/69): to 3.00 N
  rod-more-637 (19/69): to 3.00 N
  rod-more-626 (20/69): to 3.00 N
  rod-more-743 (21/69): to 4.50 N
  rod-more-632 (22/69): to 2.00 N
  rod-more-636 (23/69): to 3.00 N
  rod-more-672 (24/69): to 2.00 N
  rod-grid-021 (25/69): to 8.00 N
  rod-grid-019 (26/69): to 8.00 N
  rod-grid-018 (27/69): to 8.00 N
  rod-grid-022 (28/69): to 8.00 N
  rod-grid-020 (29/69): to 8.00 N
  rod-grid-016 (30/69): to 8.00 N
  rod-grid-023 (31/69): to 6.50 N
  rod-grid-017 (32/69): to 8.00 N
  rod-grid-015 (33/69): to 8.00 N
  rod-grid-014 (34/69): to 8.00 N
  rod-grid-027 (35/69): to 8.00 N
  rod-grid-026 (36/69): to 8.00 N
  rod-grid-028 (37/69): to 8.00 N
  rod-grid-013 (38/69): to 8.00 N
  rod-grid-000 (39/69): to 8.00 N
  rod-grid-001 (40/69): to 8.00 N
  rod-grid-002 (41/69): to 8.00 N
  rod-grid-012 (42/69): to 8.00 N
  rod-grid-003 (43/69): to 8.00 N
  rod-grid-011 (44/69): to 8.00 N
  rod-grid-007 (45/69): to 8.00 N
  rod-grid-004 (46/69): to 8.00 N
  rod-grid-008 (47/69): to 6.50 N
  rod-grid-010 (48/69): to 8.00 N
  rod-grid-009 (49/69): to 6.50 N
  rod-grid-006 (50/69): to 5.00 N
  rod-grid-029 (51/69): to 3.50 N
  rod-more-761 (52/69): to 2.00 N
  rod-more-809 (53/69): to 5.00 N
  rod-more-811 (54/69): to 3.50 N
  rod-more-686 (55/69): to 2.00 N
  rod-more-780 (56/69): to 2.00 N
  rod-more-758 (57/69): to 3.50 N
  rod-more-803 (58/69): to 2.00 N
  rod-more-760 (59/69): to 2.00 N
  rod-more-792 (60/69): to 3.50 N
  rod-more-779 (61/69): to 8.00 N
  rod-ref-b (62/69): to 2.00 N
  rod-ref-c (63/69): to 2.00 N
  rod-grid-039 (64/69): to 6.00 N
  rod-more-634 (65/69): to 2.00 N
  rod-grid-049 (66/69): to 6.00 N
  rod-grid-048 (67/69): to 6.00 N
  rod-grid-035 (68/69): to 6.00 N
  rod-more-606 (69/69): to 4.50 N
== shear
  rod-slide-027-1N (1/24): to 1.00 N
  rod-slide-027-2N (2/24): to 2.00 N
  rod-slide-027-4N (3/24): to 4.00 N
  rod-slide-003-1N (4/24): to 1.00 N
  rod-slide-003-2N (5/24): to 2.00 N
  rod-slide-003-4N (6/24): to 4.00 N
  rod-slide-015-1N (7/24): to 1.00 N
  rod-slide-015-2N (8/24): to 2.00 N
  rod-slide-015-4N (9/24): to 4.00 N
  rod-slide-029-1N (10/24): to 1.00 N
  rod-slide-029-2N (11/24): to 2.00 N
  rod-slide-029-4N (12/24): to 4.00 N
  rod-slide-006-1N (13/24): to 1.00 N
  rod-slide-006-2N (14/24): to 2.00 N
  rod-slide-006-4N (15/24): to 4.00 N
  rod-slide-018-1N (16/24): to 1.00 N
  rod-slide-018-2N (17/24): to 2.00 N
  rod-slide-018-4N (18/24): to 4.00 N
  rod-slide-011-1N (19/24): to 1.00 N
  rod-slide-011-2N (20/24): to 2.00 N
  rod-slide-011-4N (21/24): to 4.00 N
  rod-slide-023-1N (22/24): to 1.00 N
  rod-slide-023-2N (23/24): to 2.00 N
  rod-slide-023-4N (24/24): to 4.00 N
== roll
  rod-roll-0-1.5N (1/4): to 1.50 N
  rod-roll-0-4N (2/4): to 4.00 N
  rod-roll-3-1.5N (3/4): to 1.50 N
  rod-roll-3-4N (4/4): to 4.00 N
== twist
  rod-twist-019-2.5N (1/2): to 2.50 N
  rod-twist-019-5N (2/2): to 5.00 N
== final
  rod-final-ref (1/1): to 2.00 N
HEX-E: 529491 samples, 0 timed out, 0 late datagrams dropped, 1 gaps over 0.5 s; 0.7 s, Fz +0.3 N
session in logs/20261029-tip_calibration/230820-rodv3id3
exit 0 at 14:49:02
