badinkajink/hand/docs/experiments/20261022-ur5_tip_calibration/lab/20261029-153034-tallv3id3/printout.txt

speed slider 0.30 (the plan's 0.30)
== preflight
preflight: HEX-E 100 Hz (asked 100 Hz, filter 3), board 340 records/s, robot 124 Hz
  HEX-E noise (1 sigma) N, N m: [0.0383 0.0171 0.2377 0.0029 0.0039 0.0009]
  HEX-E reads: 0 timed out, 0 late datagrams dropped (0 and 0 on a clean link)
  payload set: 0.403 kg at [0.0, -0.5, 34.3] mm from the flange
== homing
homing: from the recorded seating docs/experiments/20261022-ur5_tip_calibration/lab/poses.jsonl:tall_indenter_seated (no freedrive, nothing moves)
homing: 1 seatings within 0.000 mm, 0.000 deg of their mean
  indenter at (-33.3, -699.2, 72.4) mm, yaw -93.4 deg, tilt 1.83 deg; the plan has (-35, -699, 73) mm, yaw -94 deg
== pad
  pad-flank-04: onset +0.285 mm from the expected (power 1.00, fit 52.6 mN)
  pad-flank-00: onset +0.144 mm from the expected (power 1.75, fit 40.4 mN)
  pad-edge-09: onset +0.045 mm from the expected (power 2.00, fit 61.0 mN)
  pad-edge-03: onset +0.244 mm from the expected (power 1.00, fit 47.8 mN)
  pad-edge-05: onset -0.253 mm from the expected (power 2.00, fit 118.8 mN)
  pad-edge-08: onset +0.170 mm from the expected (power 1.25, fit 46.2 mN)
  pad-edge-00: onset +0.314 mm from the expected (power 1.75, fit 36.3 mN)
  pad-face-11: onset +0.341 mm from the expected (power 1.50, fit 33.3 mN)
  pad-face-06: onset +0.425 mm from the expected (power 1.50, fit 53.3 mN)
  pad-face-03: onset +0.217 mm from the expected (power 1.75, fit 45.3 mN)
  pad-face-05: onset +0.574 mm from the expected (power 1.00, fit 58.5 mN)
  pad-face-08: onset +0.494 mm from the expected (power 1.25, fit 32.4 mN)
  pad-face-00: onset +0.721 mm from the expected (power 1.00, fit 49.2 mN)
  pad-edge-06: onset +0.651 mm from the expected (power 2.00, fit 108.5 mN)
  pad-face-02: onset +0.580 mm from the expected (power 1.75, fit 92.2 mN)
  pad-face-10: onset +0.806 mm from the expected (power 1.25, fit 52.7 mN)
  pad-face-09: onset +0.738 mm from the expected (power 1.00, fit 59.7 mN)
  pad-face-07: onset +1.144 mm from the expected (power 1.25, fit 28.9 mN)
  pad-edge-02: onset +1.288 mm from the expected (power 1.00, fit 128.9 mN)
== register
register: pad touches 0.055 mm rms (19), face nan mm (0); TCP moved 1.531 mm, 2.911 deg; sphere centre moved 1.142 mm
  TCP of the pad frame on the flange (for the pendant): 0.00064, -0.00296, 0.11850, -0.05042, -0.02039, -1.59390  (m, rotation vector)
HEX-E: 103927 samples, 0 timed out, 0 late datagrams dropped, 2 gaps over 0.5 s; 0.8 s, Fz +0.2 N; 0.7 s, Fz +0.1 N
session in /home/will/workspace/hand/logs/20261029-tip_calibration/153034-tallv3id3
exit 0 at 15:48:00
resumed logs/20261029-tip_calibration/153034-tallv3id3: 21 actions done, 19 touches
speed slider 0.30 (the plan's 0.30)
== preflight
preflight: HEX-E 100 Hz (asked 100 Hz, filter 3), board 340 records/s, robot 124 Hz
  HEX-E noise (1 sigma) N, N m: [0.048  0.0468 0.2236 0.0031 0.0038 0.0011]
  HEX-E reads: 0 timed out, 0 late datagrams dropped (0 and 0 on a clean link)
  payload set: 0.403 kg at [0.0, -0.5, 34.3] mm from the flange
== grid
  tall-ref-a (1/56): to 2.00 N
  tall-shared-728 (2/56): to 5.00 N
  tall-shared-730 (3/56): to 5.00 N
  tall-shared-719 (4/56): to 5.00 N
  tall-shared-581 (5/56): to 3.00 N
  tall-shared-576 (6/56): to 3.00 N
  tall-shared-640 (7/56): to 3.00 N
  tall-flank-482 (8/56): to 2.00 N
  tall-flank-525 (9/56): to 2.00 N
  tall-flank-526 (10/56): to 2.00 N
  tall-flank-543 (11/56): to 2.00 N
  tall-flank-590 (12/56): to 2.00 N
  tall-flank-589 (13/56): to 2.00 N
  tall-flank-591 (14/56): to 2.00 N
  tall-flank-531 (15/56): to 2.00 N
  tall-flank-580 (16/56): to 2.00 N
  tall-flank-532 (17/56): to 2.00 N
  tall-flank-582 (18/56): to 2.00 N
  tall-flank-583 (19/56): to 2.00 N
  tall-flank-585 (20/56): to 2.00 N
  tall-edge-754 (21/56): to 3.00 N
  tall-edge-643 (22/56): to 3.00 N
  tall-edge-644 (23/56): to 3.00 N
  tall-edge-637 (24/56): to 3.00 N
  tall-edge-645 (25/56): to 3.00 N
  tall-face-732 (26/56): to 5.00 N
  tall-edge-647 (27/56): to 3.00 N
  tall-face-738 (28/56): to 5.00 N
  tall-edge-740 (29/56): to 3.00 N
  tall-edge-718 (30/56): to 3.00 N
  tall-face-725 (31/56): to 5.00 N
  tall-face-792 (32/56): to 5.00 N
  tall-face-785 (33/56): to 5.00 N
  tall-face-716 (34/56): to 5.00 N
  tall-face-774 (35/56): to 5.00 N
  tall-face-772 (36/56): to 5.00 N
  tall-face-708 (37/56): to 5.00 N
  tall-face-766 (38/56): to 5.00 N
  tall-face-764 (39/56): to 5.00 N
  tall-face-710 (40/56): to 5.00 N
  tall-face-770 (41/56): to 5.00 N
  tall-edge-696 (42/56): to 3.00 N
  tall-face-702 (43/56): to 5.00 N
  tall-face-690 (44/56): to 5.00 N
  tall-edge-627 (45/56): to 3.00 N
  tall-edge-694 (46/56): to 3.00 N
  tall-edge-626: ABORT no HEX-E sample for 100 ms
  tall-edge-668: ABORT no HEX-E sample for 100 ms
  tall-edge-670: ABORT no HEX-E sample for 100 ms
HEX-E: 206752 samples, 158 timed out, 0 late datagrams dropped, 2 gaps over 0.5 s; 0.7 s, Fz +0.2 N; 0.7 s, Fz +0.4 N
session in logs/20261029-tip_calibration/153034-tallv3id3
three aborts in a row: stopping the session (--resume continues it)
exit 1 at 00:08:00
resumed logs/20261029-tip_calibration/153034-tallv3id3: 67 actions done, 19 touches
speed slider 0.30 (the plan's 0.30)
== preflight
preflight: HEX-E 100 Hz (asked 100 Hz, filter 3), board 338 records/s, robot 124 Hz
  HEX-E noise (1 sigma) N, N m: [0.0313 0.038  0.2596 0.0032 0.0039 0.001 ]
  HEX-E reads: 0 timed out, 0 late datagrams dropped (0 and 0 on a clean link)
  payload set: 0.403 kg at [0.0, -0.5, 34.3] mm from the flange
== grid
  tall-edge-626: ABORT no HEX-E sample for 100 ms
  tall-edge-668: ABORT no HEX-E sample for 100 ms
  tall-edge-670: ABORT no HEX-E sample for 100 ms
HEX-E: 4116 samples, 115 timed out, 0 late datagrams dropped, 2 gaps over 0.5 s; 0.7 s, Fz +0.2 N; 1.8 s, Fz +0.3 N
session in logs/20261029-tip_calibration/153034-tallv3id3
three aborts in a row: stopping the session (--resume continues it)
exit 1 at 11:03:04
resumed logs/20261029-tip_calibration/153034-tallv3id3: 67 actions done, 19 touches
speed slider 0.30 (the plan's 0.30)
== preflight
preflight: HEX-E 100 Hz (asked 100 Hz, filter 3), board 339 records/s, robot 124 Hz
  HEX-E noise (1 sigma) N, N m: [0.0374 0.0342 0.2554 0.0032 0.0039 0.001 ]
  HEX-E reads: 0 timed out, 0 late datagrams dropped (0 and 0 on a clean link)
  payload set: 0.403 kg at [0.0, -0.5, 34.3] mm from the flange
== grid
  tall-edge-625 (47/56): to 3.00 N
  tall-edge-622 (48/56): to 3.00 N
  tall-edge-610 (49/56): to 3.00 N
  tall-edge-604 (50/56): to 3.00 N
  tall-edge-626 (51/56): to 3.00 N
  tall-edge-668 (52/56): to 3.00 N
  tall-edge-670 (53/56): to 3.00 N
  tall-edge-666 (54/56): to 3.00 N
  tall-ref-b (55/56): to 2.00 N
  tall-ref-c (56/56): to 2.00 N
== shear
  tall-slide-flank-580-1N (1/40): to 1.00 N
  tall-slide-flank-589-1N (2/40): to 1.00 N
  tall-slide-flank-591-1N (3/40): to 1.00 N
  tall-slide-flank-531-1N (4/40): to 1.00 N
  tall-slide-flank-532-1N (5/40): to 1.00 N
  tall-slide-flank-583-1N (6/40): to 1.00 N
  tall-slide-flank-582-1N (7/40): to 1.00 N
  tall-slide-edge-644-1N (8/40): to 1.00 N
  tall-slide-edge-645-1N (9/40): to 1.00 N
  tall-slide-edge-647-1N (10/40): to 1.00 N
  tall-slide-edge-643-1N (11/40): to 1.00 N
  tall-slide-edge-754-1N (12/40): to 1.00 N
  tall-slide-face-732-1N (13/40): to 1.00 N
  tall-slide-edge-718-1N (14/40): to 1.00 N
  tall-slide-edge-637-1N (15/40): to 1.00 N
  tall-slide-face-785-1N (16/40): to 1.00 N
  tall-slide-face-792-1N (17/40): to 1.00 N
  tall-slide-face-738-1N (18/40): to 1.00 N
  tall-slide-edge-740-1N (19/40): to 1.00 N
  tall-slide-face-725-1N (20/40): to 1.00 N
  tall-slide-face-716-1N (21/40): to 1.00 N
  tall-slide-face-708-1N (22/40): to 1.00 N
  tall-slide-face-710-1N (23/40): to 1.00 N
  tall-slide-face-766-1N (24/40): to 1.00 N
  tall-slide-face-764-1N (25/40): to 1.00 N
  tall-slide-face-774-1N (26/40): to 1.00 N
  tall-slide-face-772-1N (27/40): to 1.00 N
  tall-slide-edge-696-1N (28/40): to 1.00 N
  tall-slide-edge-627-1N (29/40): to 1.00 N
  tall-slide-edge-626-1N (30/40): to 1.00 N
  tall-slide-edge-668-1N (31/40): to 1.00 N
  tall-slide-face-770-1N (32/40): to 1.00 N
  tall-slide-face-690-1N (33/40): to 1.00 N
  tall-slide-face-702-1N (34/40): to 1.00 N
  tall-slide-edge-694-1N (35/40): to 1.00 N
  tall-slide-edge-622-1N (36/40): to 1.00 N
  tall-slide-edge-625-1N (37/40): to 1.00 N
  tall-slide-edge-610-1N (38/40): to 1.00 N
  tall-slide-edge-666-1N (39/40): to 1.00 N
  tall-slide-edge-670-1N (40/40): to 1.00 N
== twist
  tall-twist-face-684-2.5N-20deg (1/4): to 2.50 N
  tall-twist-face-690-2.5N-20deg (2/4): to 2.50 N
  tall-twist-edge-610-2.5N-20deg (3/4): to 2.50 N
  tall-twist-edge-605-2.5N-20deg (4/4): to 2.50 N
== final
  tall-final-ref (1/1): to 2.00 N
HEX-E: 745632 samples, 0 timed out, 0 late datagrams dropped, 1 gaps over 0.5 s; 0.7 s, Fz -0.2 N
session in logs/20261029-tip_calibration/153034-tallv3id3
exit 0 at 13:19:51
