badinkajink/hand/docs/experiments/20261022-ur5_tip_calibration/lab/20261028-102701-rodv3id1/printout_morning6_1347.txt

resumed logs/20261028-tip_calibration/102701-rodv3id1: 122 actions done, 21 touches
speed slider 0.30 (the plan's 0.30)
== preflight
preflight: HEX-E 100 Hz (asked 100 Hz, filter 3), board 340 records/s, robot 124 Hz
  HEX-E noise (1 sigma) N, N m: [0.0367 0.0474 0.2364 0.003  0.0038 0.001 ]
  HEX-E reads: 0 timed out, 0 late datagrams dropped (0 and 0 on a clean link)
  payload set: 0.403 kg at [0.0, -0.5, 34.3] mm from the flange
== grid
  rod-grid-039 (1/6): to 6.00 N
  rod-more-634 (2/6): to 2.00 N
  rod-grid-049 (3/6): to 6.00 N
  rod-grid-048 (4/6): to 6.00 N
  rod-grid-035 (5/6): to 6.00 N
  rod-more-606 (6/6): to 4.50 N
HEX-E: 33138 samples, 0 timed out, 0 late datagrams dropped, 1 gaps over 0.5 s; 0.7 s, Fz +0.2 N
session in logs/20261028-tip_calibration/102701-rodv3id1
exit 0 at 13:52:47
