badinkajink/hand/docs/experiments/20261022-ur5_tip_calibration/lab/20261028-114908-tallv3id1/printout.txt

speed slider 0.30 (the plan's 0.30)
== preflight
preflight: HEX-E 100 Hz (asked 100 Hz, filter 3), board 340 records/s, robot 124 Hz
  HEX-E noise (1 sigma) N, N m: [0.0465 0.0271 0.223  0.0028 0.0041 0.0011]
  HEX-E reads: 0 timed out, 0 late datagrams dropped (0 and 0 on a clean link)
  payload set: 0.403 kg at [0.0, -0.5, 34.3] mm from the flange
== homing
homing: from the recorded seating docs/experiments/20261022-ur5_tip_calibration/lab/poses.jsonl:tall_indenter_seated (no freedrive, nothing moves)
homing: 1 seatings within 0.000 mm, 0.000 deg of their mean
  indenter at (-33.3, -699.2, 72.4) mm, yaw -93.4 deg, tilt 1.83 deg; the plan has (-35, -699, 73) mm, yaw -94 deg
== pad
  pad-flank-04: onset +0.015 mm from the expected (power 1.50, fit 50.4 mN)
  pad-flank-00: onset -0.083 mm from the expected (power 1.50, fit 42.5 mN)
  pad-edge-09: onset -0.232 mm from the expected (power 2.00, fit 57.3 mN)
  pad-edge-03: onset -0.053 mm from the expected (power 1.25, fit 49.0 mN)
  pad-edge-05: onset -0.405 mm from the expected (power 1.25, fit 116.2 mN)
  pad-edge-08: onset -0.148 mm from the expected (power 1.00, fit 37.3 mN)
  pad-edge-00: onset +0.010 mm from the expected (power 1.25, fit 32.9 mN)
  pad-face-11: onset +0.055 mm from the expected (power 1.00, fit 30.9 mN)
  pad-face-06: onset +0.098 mm from the expected (power 1.50, fit 50.0 mN)
  pad-face-03: onset -0.079 mm from the expected (power 1.50, fit 56.3 mN)
  pad-face-05: onset +0.323 mm from the expected (power 1.00, fit 72.9 mN)
  pad-face-08: onset +0.146 mm from the expected (power 1.00, fit 51.6 mN)
  pad-face-00: onset +0.371 mm from the expected (power 1.00, fit 26.3 mN)
  pad-edge-06: onset +0.348 mm from the expected (power 1.00, fit 110.9 mN)
  pad-face-02: onset +0.263 mm from the expected (power 1.00, fit 92.6 mN)
  pad-face-10: onset +0.534 mm from the expected (power 1.00, fit 46.6 mN)
  pad-face-09: onset +0.338 mm from the expected (power 1.00, fit 61.4 mN)
  pad-face-07: onset +0.783 mm from the expected (power 1.50, fit 37.3 mN)
  pad-edge-02: onset +0.964 mm from the expected (power 1.25, fit 124.5 mN)
== register
register: pad touches 0.045 mm rms (19), face nan mm (0); TCP moved 1.461 mm, 3.070 deg; sphere centre moved 0.908 mm
  TCP of the pad frame on the flange (for the pendant): 0.00056, -0.00301, 0.11840, -0.05059, -0.02350, -1.58892  (m, rotation vector)
HEX-E: 194294 samples, 0 timed out, 0 late datagrams dropped, 1 gaps over 0.5 s; 0.7 s, Fz +0.2 N
session in /home/will/workspace/hand/logs/20261028-tip_calibration/114908-tallv3id1
exit 0 at 12:21:39
