badinkajink/hand/docs/experiments/20261022-ur5_tip_calibration/lab/20261027-225213-spherev3id1/printout.txt

speed slider 0.30 (the plan's 0.30)
== preflight
preflight: HEX-E 100 Hz (asked 100 Hz, filter 3), board 340 records/s, robot 124 Hz
  HEX-E noise (1 sigma) N, N m: [0.0484 0.0458 0.1944 0.0032 0.0036 0.001 ]
  HEX-E reads: 0 timed out, 0 late datagrams dropped (0 and 0 on a clean link)
  payload set: 0.403 kg at [0.0, -0.5, 34.3] mm from the flange
== homing
homing: from the recorded seating docs/experiments/20261022-ur5_tip_calibration/lab/poses.jsonl:left_indenter_seated (no freedrive, nothing moves)
homing: 1 seatings within 0.000 mm, 0.000 deg of their mean
  indenter at (-139.0, -595.6, 71.1) mm, yaw -92.3 deg, tilt 0.71 deg; the plan has (-138, -596, 71) mm, yaw -92 deg
== pad
  pad-flank-05: onset -0.180 mm from the expected (power 1.50, fit 82.6 mN)
  pad-edge-06: onset -0.224 mm from the expected (power 1.75, fit 67.0 mN)
  pad-edge-03: onset -0.560 mm from the expected (power 2.00, fit 135.7 mN)
  pad-edge-09: onset -0.274 mm from the expected (power 1.00, fit 79.9 mN)
  pad-edge-00: onset -0.127 mm from the expected (power 1.25, fit 48.2 mN)
  pad-face-03: onset -0.221 mm from the expected (power 2.00, fit 59.4 mN)
  pad-face-09: onset -0.098 mm from the expected (power 1.25, fit 46.8 mN)
  pad-face-07: onset -0.177 mm from the expected (power 1.75, fit 48.4 mN)
  pad-face-08: onset -0.303 mm from the expected (power 1.75, fit 83.2 mN)
  pad-edge-05: onset -0.047 mm from the expected (power 1.00, fit 112.1 mN)
  pad-face-01: onset -0.078 mm from the expected (power 1.25, fit 92.7 mN)
  pad-face-00: onset +0.009 mm from the expected (power 1.75, fit 27.1 mN)
  pad-face-06: onset +0.048 mm from the expected (power 2.00, fit 55.3 mN)
  pad-face-11: onset +0.230 mm from the expected (power 1.00, fit 31.5 mN)
  pad-face-10: onset +0.321 mm from the expected (power 1.25, fit 45.7 mN)
  pad-edge-04: onset +0.436 mm from the expected (power 1.50, fit 48.6 mN)
  pad-edge-08: onset +0.759 mm from the expected (power 1.00, fit 72.0 mN)
  pad-flank-07: onset +0.819 mm from the expected (power 1.00, fit 77.0 mN)
== register
register: pad touches 0.049 mm rms (18), face nan mm (0); TCP moved 1.425 mm, 1.181 deg; sphere centre moved 0.958 mm
  TCP of the pad frame on the flange (for the pendant): 0.00034, -0.00309, 0.11838, -0.02292, 0.00002, -1.60652  (m, rotation vector)
HEX-E: 118970 samples, 0 timed out, 0 late datagrams dropped, 1 gaps over 0.5 s; 0.7 s, Fz -0.4 N
session in /home/will/workspace/hand/logs/20261027-tip_calibration/225213-spherev3id1
exit 0 at 23:12:09
