badinkajink/hand/docs/experiments/20261022-ur5_tip_calibration/lab/20261027-212131-holdmapv3id1/printout_resume_2224.txt

resumed logs/20261027-tip_calibration/212131-holdmapv3id1: 96 actions done, 5 touches
speed slider 0.30 (the plan's 0.30)
== preflight
preflight: HEX-E 100 Hz (asked 100 Hz, filter 3), board 341 records/s, robot 124 Hz
  held boards on /dev/serial/by-id/usb-Adafruit_QT_Py_ESP32-S3__4MB_Flash_2MB_PSRAM__b4:3a:45:b0:d9:94-if00: mux channel 0 206 records/s, mux channel 3 206 records/s
  HEX-E noise (1 sigma) N, N m: [0.0343 0.0492 0.241  0.003  0.0037 0.001 ]
  HEX-E reads: 0 timed out, 0 late datagrams dropped (0 and 0 on a clean link)
  payload set: 0.403 kg at [0.0, -0.5, 34.3] mm from the flange
== hover
  hov-fm-W10-x+3 (66/90): held 2 s, |F| at most 0.38 N
HEX-E: 3939 samples, 0 timed out, 0 late datagrams dropped, 2 gaps over 0.5 s; 1.0 s, Fz -0.2 N; 0.7 s, Fz -0.1 N
session in logs/20261027-tip_calibration/212131-holdmapv3id1
exit 0 at 22:25:17
