badinkajink/hand/docs/experiments/20261022-ur5_tip_calibration/lab/20261027-212131-holdmapv3id1/printout.txt

resumed logs/20261027-tip_calibration/212131-holdmapv3id1: 0 actions done, 0 touches
speed slider 0.30 (the plan's 0.30)
== preflight
preflight: HEX-E 100 Hz (asked 100 Hz, filter 3), board 340 records/s, robot 124 Hz
  held boards on /dev/serial/by-id/usb-Adafruit_QT_Py_ESP32-S3__4MB_Flash_2MB_PSRAM__b4:3a:45:b0:d9:94-if00: mux channel 0 206 records/s, mux channel 3 206 records/s
  HEX-E noise (1 sigma) N, N m: [0.0347 0.0479 0.2396 0.0029 0.0041 0.0011]
  HEX-E reads: 0 timed out, 0 late datagrams dropped (0 and 0 on a clean link)
  payload set: 0.403 kg at [0.0, -0.5, 34.3] mm from the flange
== homing
homing: from the recorded seating docs/experiments/20261022-ur5_tip_calibration/lab/poses.jsonl:holder_seated_5 (no freedrive, nothing moves)
homing: 1 seatings within 0.000 mm, 0.000 deg of their mean
== pad
  hold-touch-a: onset +0.215 mm from the expected (power 1.25, fit 32.9 mN)
  hold-touch-b-x+0-y+3: onset +0.465 mm from the expected (power 1.25, fit 30.3 mN)
  hold-touch-c-x+0-y-3: onset +0.615 mm from the expected (power 1.50, fit 31.9 mN)
  hold-touch-d-x+3-y+0: onset +0.391 mm from the expected (power 1.00, fit 29.8 mN)
  hold-touch-e-x-3-y+0: onset +0.153 mm from the expected (power 1.00, fit 29.0 mN)
== hover
  hov-f-W1-x+3 (1/4): held 2 s, |F| at most 0.24 N
  hov-f-W0.5-t+10 (2/4): held 2 s, |F| at most 0.31 N
  hov-f-W0.5-t-20 (3/4): held 2 s, |F| at most 0.33 N
  hov-fm-W15-t+10 (4/4): held 6 s, |F| at most 0.30 N
HEX-E: 54579 samples, 0 timed out, 0 late datagrams dropped, 2 gaps over 0.5 s; 0.7 s, Fz +0.5 N; 0.7 s, Fz +0.0 N
session in logs/20261027-tip_calibration/212131-holdmapv3id1
exit 0 at 21:30:43
