badinkajink/hand/docs/experiments/20261022-ur5_tip_calibration/lab/20261027-200536-holdv3id1/printout.txt

resumed logs/20261027-tip_calibration/200536-holdv3id1: 0 actions done, 0 touches
speed slider 0.30 (the plan's 0.30)
== preflight
preflight: HEX-E 100 Hz (asked 100 Hz, filter 3), board 342 records/s, robot 124 Hz
  held boards on /dev/serial/by-id/usb-Adafruit_QT_Py_ESP32-S3__4MB_Flash_2MB_PSRAM__b4:3a:45:b0:d9:94-if00: mux channel 0 206 records/s, mux channel 3 206 records/s
  HEX-E noise (1 sigma) N, N m: [0.0478 0.0469 0.2335 0.0028 0.0038 0.001 ]
  HEX-E reads: 0 timed out, 0 late datagrams dropped (0 and 0 on a clean link)
  payload set: 0.403 kg at [0.0, -0.5, 34.3] mm from the flange
== homing
homing: from the recorded seating docs/experiments/20261022-ur5_tip_calibration/lab/poses.jsonl:holder_seated_5 (no freedrive, nothing moves)
homing: 1 seatings within 0.000 mm, 0.000 deg of their mean
== pad
  hold-touch-a: ABORT no contact onset in the approach
  hold-touch-b: ABORT no contact onset in the approach
  hold-touch-c: ABORT no contact onset in the approach
HEX-E: 26269 samples, 0 timed out, 0 late datagrams dropped, 2 gaps over 0.5 s; 1.1 s, Fz -0.5 N; 0.7 s, Fz +0.3 N
session in logs/20261027-tip_calibration/200536-holdv3id1
three aborts in a row: stopping the session (--resume continues it)
exit 1 at 20:10:05
