badinkajink/hand/docs/experiments/20261022-ur5_tip_calibration/lab/20261026-192158-v2id1/printout_resume_0923.txt

resumed logs/20261026-tip_calibration/192158-v2id1: 354 actions done, 34 touches
speed slider 0.30 (the plan's 0.30)
== preflight
preflight: HEX-E 100 Hz (asked 100 Hz, filter 3), board 340 records/s, robot 124 Hz
  HEX-E noise (1 sigma) N, N m: [0.046  0.0498 0.2349 0.0026 0.0036 0.0011]
  HEX-E reads: 0 timed out, 0 late datagrams dropped (0 and 0 on a clean link)
  payload set: 0.403 kg at [0.0, -0.5, 34.3] mm from the flange
== grid
  dense-613-t+10 (1/19): to 3.00 N
  dense-614-t+10 (2/19): to 3.00 N
  dense-615-t+10 (3/19): to 3.00 N
  grid-048 (4/19): to 3.00 N
  fast-grid-048 (5/19): to 3.00 N
  grid-044 (6/19): to 3.00 N
  fast-grid-044 (7/19): to 3.00 N
  grid-057 (8/19): to 2.00 N
  fast-grid-057 (9/19): to 2.00 N
  fast-grid-058 (10/19): to 2.00 N
  grid-058 (11/19): to 2.00 N
  fast-grid-046 (12/19): to 3.00 N
  grid-046 (13/19): to 3.00 N
  fast-grid-045 (14/19): to 3.00 N
  grid-045 (15/19): to 3.00 N
  dense-554-t+15 (16/19): to 2.00 N
  fast-grid-059 (17/19): to 2.00 N
  grid-059 (18/19): to 2.00 N
  dense-555-t+15 (19/19): to 2.00 N
== shear
  slide-dense-611-t+5-1N (1/6): to 1.00 N
  slide-dense-613-t+10-1N (2/6): to 1.00 N
  slide-dense-614-t+10-1N (3/6): to 1.00 N
  slide-dense-615-t+10-1N (4/6): to 1.00 N
  slide-dense-554-t+15-1N (5/6): to 1.00 N
  slide-dense-555-t+15-1N (6/6): to 1.00 N
HEX-E: 170603 samples, 0 timed out, 0 late datagrams dropped, 1 gaps over 0.5 s; 0.7 s, Fz -0.1 N
session in logs/20261026-tip_calibration/192158-v2id1
exit 0 at 09:51:40
