badinkajink/hand/docs/experiments/20261022-ur5_tip_calibration/lab/20261027-095303-rodv2id1/printout_resume_1036.txt

resumed logs/20261027-tip_calibration/095303-rodv2id1: 28 actions done, 21 touches
speed slider 0.30 (the plan's 0.30)
== preflight
preflight: HEX-E 100 Hz (asked 100 Hz, filter 3), board 338 records/s, robot 124 Hz
  HEX-E noise (1 sigma) N, N m: [0.0354 0.0158 0.2322 0.0031 0.0037 0.001 ]
  HEX-E reads: 0 timed out, 0 late datagrams dropped (0 and 0 on a clean link)
  payload set: 0.403 kg at [0.0, -0.5, 34.3] mm from the flange
== grid
  rod-ref-a (1/93): to 2.00 N
  rod-grid-049 (2/93): to 6.00 N
  rod-grid-048 (3/93): to 6.00 N
  rod-grid-044 (4/93): to 6.00 N
  rod-grid-047 (5/93): to 6.00 N
  rod-grid-045 (6/93): to 6.00 N
  rod-grid-046 (7/93): to 6.00 N
  rod-grid-043 (8/93): to 6.00 N
  rod-grid-051 (9/93): to 6.00 N
  rod-grid-042 (10/93): to 6.00 N
  rod-grid-041 (11/93): to 6.00 N
  rod-grid-036 (12/93): to 6.00 N
  rod-grid-037 (13/93): to 6.00 N
  rod-grid-035 (14/93): to 6.00 N
  rod-grid-033 (15/93): to 6.00 N
  rod-grid-038 (16/93): to 6.00 N
  rod-grid-034 (17/93): to 6.00 N
  rod-grid-032 (18/93): to 6.00 N
  rod-grid-031 (19/93): to 6.00 N
  rod-grid-030 (20/93): to 4.50 N
  rod-grid-039 (21/93): to 6.00 N
  rod-more-634 (22/93): to 2.00 N
  rod-more-606 (23/93): to 4.50 N
  rod-more-630 (24/93): to 3.00 N
  rod-more-637 (25/93): to 3.00 N
  rod-more-626 (26/93): to 3.00 N
  rod-more-743 (27/93): to 4.50 N
  rod-more-632 (28/93): to 2.00 N
  rod-more-636 (29/93): to 3.00 N
  rod-more-672 (30/93): to 2.00 N
  rod-grid-021 (31/93): to 8.00 N
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
  rod-twist-019-5N-tv400 (3/3): to 5.00 N
== final
  rod-final-ref (1/1): to 2.00 N
HEX-E: 564108 samples, 0 timed out, 0 late datagrams dropped, 2 gaps over 0.5 s; 0.8 s, Fz +0.0 N; 0.7 s, Fz +0.7 N
session in logs/20261027-tip_calibration/095303-rodv2id1
exit 0 at 12:10:46
