badinkajink/hand/docs/experiments/20261022-ur5_tip_calibration/lab/20261026-192158-v2id1/printout_resume_0245.txt

resumed logs/20261026-tip_calibration/192158-v2id1: 304 actions done, 31 touches
speed slider 0.30 (the plan's 0.30)
== preflight
preflight: HEX-E 100 Hz (asked 100 Hz, filter 3), board 340 records/s, robot 124 Hz
  HEX-E noise (1 sigma) N, N m: [0.0378 0.0493 0.2374 0.003  0.0039 0.001 ]
  HEX-E reads: 0 timed out, 0 late datagrams dropped (0 and 0 on a clean link)
  payload set: 0.403 kg at [0.0, -0.5, 34.3] mm from the flange
== grid
  hard-ref-a (1/3): to 2.00 N
  hard-ramp-020 (2/3): to 8.00 N
  hard-ref-b (3/3): to 2.00 N
HEX-E: 13381 samples, 0 timed out, 0 late datagrams dropped, 1 gaps over 0.5 s; 0.7 s, Fz +0.2 N
session in logs/20261026-tip_calibration/192158-v2id1
exit 0 at 02:47:26
