badinkajink/hand/docs/experiments/20261022-ur5_tip_calibration/lab/20261026-180938-rod3t/printout.txt

speed slider 0.30 (the plan's 0.30)
== preflight
preflight: HEX-E 100 Hz (asked 100 Hz, filter 3), board 339 records/s, robot 124 Hz
  HEX-E noise (1 sigma) N, N m: [0.0475 0.0156 0.2393 0.0033 0.0039 0.0011]
  HEX-E reads: 0 timed out, 0 late datagrams dropped (0 and 0 on a clean link)
  payload set: 0.403 kg at [0.0, -0.5, 34.3] mm from the flange
== homing
homing: from the recorded seating docs/experiments/20261022-ur5_tip_calibration/lab/poses.jsonl:right_indenter_seated (no freedrive, nothing moves)
homing: 1 seatings within 0.000 mm, 0.000 deg of their mean
  indenter at (-289.0, -584.6, 69.0) mm, yaw -94.1 deg, tilt 1.43 deg; the plan has (-290, -586, 70) mm, yaw -94 deg
== pad
  contact before the slow approach (0.30 N): back to the rest pose, the approach at its slow speed
  pad-edge-05: onset -1.933 mm from the expected (power 2.00, fit 68.6 mN)
  contact before the slow approach (0.33 N): back to the rest pose, the approach at its slow speed
  pad-edge-03: onset -1.952 mm from the expected (power 2.00, fit 101.2 mN)
  contact before the slow approach (0.32 N): back to the rest pose, the approach at its slow speed
  pad-edge-07: onset -1.823 mm from the expected (power 2.00, fit 66.1 mN)
  contact before the slow approach (0.32 N): back to the rest pose, the approach at its slow speed
  pad-face-02: onset -1.761 mm from the expected (power 1.25, fit 49.4 mN)
  contact before the slow approach (0.33 N): back to the rest pose, the approach at its slow speed
  pad-edge-00: onset -1.876 mm from the expected (power 2.00, fit 39.4 mN)
  contact before the slow approach (0.30 N): back to the rest pose, the approach at its slow speed
  pad-face-07: onset -1.663 mm from the expected (power 1.25, fit 78.9 mN)
  contact before the slow approach (0.30 N): back to the rest pose, the approach at its slow speed
  pad-face-09: onset -1.787 mm from the expected (power 2.00, fit 50.1 mN)
  contact before the slow approach (0.37 N): back to the rest pose, the approach at its slow speed
  pad-face-11: onset -1.860 mm from the expected (power 2.00, fit 47.6 mN)
  pad-face-01: onset -1.438 mm from the expected (power 1.25, fit 93.2 mN)
  contact before the slow approach (0.38 N): back to the rest pose, the approach at its slow speed
  pad-face-05: onset -1.814 mm from the expected (power 2.00, fit 47.2 mN)
  pad-face-06: onset -1.479 mm from the expected (power 2.00, fit 54.6 mN)
  pad-face-00: onset -1.504 mm from the expected (power 1.00, fit 48.3 mN)
  pad-edge-02: onset -1.276 mm from the expected (power 2.00, fit 93.0 mN)
  pad-edge-08: onset -1.265 mm from the expected (power 2.00, fit 62.1 mN)
  pad-edge-09: onset -1.093 mm from the expected (power 2.00, fit 74.9 mN)
  pad-face-08: onset -1.201 mm from the expected (power 2.00, fit 44.8 mN)
  pad-face-10: onset -1.389 mm from the expected (power 1.50, fit 44.4 mN)
  pad-face-03: onset -1.336 mm from the expected (power 1.00, fit 45.7 mN)
  pad-edge-04: onset -0.996 mm from the expected (power 1.75, fit 47.9 mN)
  pad-face-04: onset -1.131 mm from the expected (power 1.50, fit 29.8 mN)
  pad-edge-06: onset -0.971 mm from the expected (power 1.25, fit 22.8 mN)
== pivot
== register
register: pad touches 0.051 mm rms (21), face nan mm (0); TCP moved 1.098 mm, 2.750 deg; sphere centre moved 1.460 mm
  TCP of the pad frame on the flange (for the pendant): 0.00088, -0.00251, 0.11779, -0.00961, -0.02043, -1.65184  (m, rotation vector)
HEX-E: 106641 samples, 0 timed out, 0 late datagrams dropped, 1 gaps over 0.5 s; 0.7 s, Fz -0.2 N
session in /home/will/workspace/hand/logs/20261026-tip_calibration/180938-rod3t
exit 0 at 18:27:30
