badinkajink/hand/docs/experiments/20261022-ur5_tip_calibration/lab/20261025-152920-cb2t/printout.txt

== preflight
preflight: HEX-E 100 Hz (asked 100 Hz, filter 3), board 357 records/s, robot 124 Hz
  HEX-E noise (1 sigma) N, N m: [0.0473 0.0436 0.2356 0.0031 0.0037 0.0011]
  HEX-E reads: 0 timed out, 0 late datagrams dropped (0 and 0 on a clean link)
  payload set: 0.403 kg at [0.0, -0.5, 34.3] mm from the flange
== homing
homing: from the recorded seating docs/experiments/20261022-ur5_tip_calibration/lab/poses.jsonl:left_indenter_seated (no freedrive, nothing moves)
homing: 1 seatings within 0.000 mm, 0.000 deg of their mean
  indenter at (-139.0, -595.6, 71.1) mm, yaw -92.3 deg, tilt 0.71 deg; the plan has (-138, -596, 71) mm, yaw -92 deg
== pad
  pad-flank-05: onset -0.391 mm from the expected (power 1.75, fit 82.0 mN)
  pad-edge-06: onset -0.535 mm from the expected (power 2.00, fit 71.2 mN)
  pad-edge-03: onset -0.766 mm from the expected (power 1.00, fit 135.7 mN)
  pad-edge-09: onset -0.571 mm from the expected (power 2.00, fit 83.1 mN)
  pad-edge-00: onset -0.431 mm from the expected (power 1.00, fit 40.2 mN)
  pad-face-03: onset -0.541 mm from the expected (power 1.00, fit 51.2 mN)
  pad-face-09: onset -0.383 mm from the expected (power 1.75, fit 33.1 mN)
  pad-face-07: onset -0.486 mm from the expected (power 1.25, fit 32.8 mN)
  pad-face-08: onset -0.501 mm from the expected (power 1.75, fit 82.9 mN)
  pad-edge-05: onset -0.467 mm from the expected (power 1.00, fit 107.8 mN)
  pad-face-01: onset -0.420 mm from the expected (power 1.00, fit 97.6 mN)
  pad-face-00: onset -0.371 mm from the expected (power 1.25, fit 30.6 mN)
  pad-face-06: onset -0.366 mm from the expected (power 1.25, fit 51.3 mN)
  pad-face-11: onset -0.275 mm from the expected (power 1.75, fit 36.4 mN)
  pad-face-10: onset -0.061 mm from the expected (power 1.25, fit 45.5 mN)
  pad-edge-04: onset +0.052 mm from the expected (power 1.25, fit 46.4 mN)
  pad-edge-08: onset +0.414 mm from the expected (power 2.00, fit 72.8 mN)
  pad-flank-07: onset +0.417 mm from the expected (power 2.00, fit 74.6 mN)
  pad-edge-07: onset +0.487 mm from the expected (power 2.00, fit 43.3 mN)
== register
register: pad touches 0.051 mm rms (19), face nan mm (0); TCP moved 1.428 mm, 1.931 deg; sphere centre moved 0.668 mm
  TCP of the pad frame on the flange (for the pendant): 0.00017, -0.00323, 0.11826, -0.03383, -0.00035, -1.62306  (m, rotation vector)
HEX-E: 113303 samples, 0 timed out, 0 late datagrams dropped, 0 gaps over 0.5 s
session in /home/will/workspace/hand/logs/20261025-tip_calibration/152920-cb2t
exit 0 at 15:48:19
