badinkajink/hand/docs/experiments/20261022-ur5_tip_calibration/lab/20261023-203938-cb1t/printout.txt

== preflight
preflight: HEX-E 100 Hz (asked 100 Hz, filter 3), board 360 records/s, robot 124 Hz
  HEX-E noise (1 sigma) N, N m: [0.0429 0.0071 0.2278 0.003  0.0036 0.0012]
  HEX-E reads: 0 timed out, 0 late datagrams dropped (0 and 0 on a clean link)
  payload set: 0.384 kg at [0.0, -0.5, 32.5] mm from the flange
== homing
homing: from the recorded seating docs/experiments/20261022-ur5_tip_calibration/lab/poses.jsonl:left_indenter_seated (no freedrive, nothing moves)
homing: 1 seatings within 0.000 mm, 0.000 deg of their mean
  indenter at (-139.0, -595.6, 71.1) mm, yaw -92.3 deg, tilt 0.71 deg; the plan has (-138, -596, 71) mm, yaw -92 deg
== pad
  pad-flank-05: onset -0.366 mm from the expected (power 2.00, fit 82.3 mN)
  pad-edge-06: onset -0.411 mm from the expected (power 1.50, fit 66.8 mN)
HEX-E: 28306 samples, 0 timed out, 0 late datagrams dropped, 1 gaps over 0.5 s; 0.6 s, Fz -0.1 N
session in /home/will/workspace/hand/logs/20261023-tip_calibration/203938-cb1t
exit 0 at 20:44:25
