badinkajink/hand/docs/experiments/20261022-ur5_tip_calibration/lab/20261023-203938-cb1t/printout_resume.txt

resumed logs/20261023-tip_calibration/203938-cb1t: 4 actions done, 2 touches
== preflight
preflight: HEX-E 100 Hz (asked 100 Hz, filter 3), board 362 records/s, robot 124 Hz
  HEX-E noise (1 sigma) N, N m: [0.0464 0.0071 0.2282 0.0029 0.0039 0.001 ]
  HEX-E reads: 0 timed out, 0 late datagrams dropped (0 and 0 on a clean link)
  payload set: 0.384 kg at [0.0, -0.5, 32.5] mm from the flange
== homing
== pad
  pad-edge-03: onset -0.723 mm from the expected (power 1.00, fit 128.9 mN)
  pad-edge-09: onset -0.753 mm from the expected (power 1.50, fit 84.1 mN)
  pad-edge-00: onset -0.556 mm from the expected (power 1.25, fit 45.3 mN)
  pad-face-03: onset -0.724 mm from the expected (power 1.75, fit 57.9 mN)
  pad-face-09: onset -0.574 mm from the expected (power 1.25, fit 48.7 mN)
  pad-face-07: onset -0.647 mm from the expected (power 1.75, fit 49.0 mN)
  pad-face-08: onset -0.758 mm from the expected (power 1.75, fit 79.1 mN)
  pad-edge-05: onset -0.493 mm from the expected (power 1.25, fit 108.4 mN)
  pad-face-01: onset -0.572 mm from the expected (power 1.75, fit 94.2 mN)
  pad-face-00: onset -0.563 mm from the expected (power 1.50, fit 46.1 mN)
  pad-face-06: onset -0.471 mm from the expected (power 1.25, fit 53.0 mN)
  pad-face-11: onset -0.405 mm from the expected (power 1.75, fit 29.7 mN)
  pad-face-10: onset -0.293 mm from the expected (power 2.00, fit 47.2 mN)
  pad-edge-04: onset -0.034 mm from the expected (power 1.00, fit 49.2 mN)
  pad-edge-08: onset +0.369 mm from the expected (power 2.00, fit 72.2 mN)
  pad-flank-07: onset +0.475 mm from the expected (power 2.00, fit 74.0 mN)
  pad-edge-07: onset +0.397 mm from the expected (power 2.00, fit 39.1 mN)
== register
register: pad touches 0.052 mm rms (19), face nan mm (0); TCP moved 1.568 mm, 1.318 deg; sphere centre moved 0.951 mm
  TCP of the pad frame on the flange (for the pendant): 0.00008, -0.00350, 0.11808, -0.01930, 0.01184, -1.61918  (m, rotation vector)
HEX-E: 239951 samples, 0 timed out, 0 late datagrams dropped, 1 gaps over 0.5 s; 1.0 s, Fz -0.5 N
session in logs/20261023-tip_calibration/203938-cb1t
exit 0 at 21:26:56
