badinkajink/hand/docs/experiments/20261022-ur5_tip_calibration/lab/20261023-104526-rod1/printout.txt

== preflight
preflight: HEX-E 100 Hz (asked 100 Hz, filter 3), board 356 records/s, robot 124 Hz
  HEX-E noise (1 sigma) N, N m: [0.04   0.0336 0.2287 0.0029 0.0037 0.001 ]
  HEX-E reads: 0 timed out, 0 late datagrams dropped (0 and 0 on a clean link)
  payload set: 0.384 kg at [0.0, -0.5, 32.5] mm from the flange
== homing
homing: from the recorded seating docs/experiments/20261022-ur5_tip_calibration/lab/poses.jsonl:right_indenter_seated (no freedrive, nothing moves)
homing: 1 seatings within 0.000 mm, 0.000 deg of their mean
  indenter at (-289.0, -584.6, 69.0) mm, yaw -94.1 deg, tilt 1.43 deg; the plan has (-290, -586, 70) mm, yaw -94 deg
== pad
  pad-edge-05: onset -1.491 mm from the expected (power 1.00, fit 77.9 mN)
  pad-edge-03: onset -2.008 mm from the expected (power 1.00, fit 105.1 mN)
  pad-edge-07: onset -1.979 mm from the expected (power 1.00, fit 71.4 mN)
  pad-face-02: onset -1.749 mm from the expected (power 1.00, fit 65.0 mN)
  pad-edge-00: onset -1.504 mm from the expected (power 1.00, fit 57.1 mN)
  pad-face-07: onset -1.526 mm from the expected (power 1.00, fit 89.8 mN)
  pad-face-09: onset -1.491 mm from the expected (power 1.00, fit 51.3 mN)
  pad-face-11: onset -1.512 mm from the expected (power 1.00, fit 48.9 mN)
  pad-face-01: onset -2.015 mm from the expected (power 1.00, fit 102.4 mN)
  pad-face-05: onset -1.537 mm from the expected (power 1.00, fit 57.0 mN)
  pad-face-06: onset -1.510 mm from the expected (power 1.00, fit 61.4 mN)
  pad-face-00: onset -1.516 mm from the expected (power 1.00, fit 56.6 mN)
  pad-edge-02: onset -1.559 mm from the expected (power 1.00, fit 106.9 mN)
  pad-edge-08: onset -1.520 mm from the expected (power 1.00, fit 62.6 mN)
  pad-edge-09: onset -1.390 mm from the expected (power 1.00, fit 73.1 mN)
  pad-face-08: onset -1.511 mm from the expected (power 1.00, fit 49.1 mN)
  pad-face-10: onset -1.533 mm from the expected (power 1.00, fit 59.0 mN)
  pad-face-03: onset -1.514 mm from the expected (power 1.00, fit 56.7 mN)
  pad-edge-04: onset -1.426 mm from the expected (power 2.00, fit 50.9 mN)
  pad-face-04: onset -1.536 mm from the expected (power 2.00, fit 41.0 mN)
  pad-edge-06: onset -1.339 mm from the expected (power 1.25, fit 35.4 mN)
  pad-edge-01: onset -1.086 mm from the expected (power 1.25, fit 41.2 mN)
== register
register: pad touches 0.122 mm rms (22), face nan mm (0); TCP moved 1.737 mm, 3.880 deg; sphere centre moved 1.217 mm
  TCP of the pad frame on the flange (for the pendant): -0.00019, -0.00340, 0.11858, -0.03241, 0.00452, -1.66937  (m, rotation vector)
HEX-E: 60509 samples, 0 timed out, 0 late datagrams dropped, 0 gaps over 0.5 s
session in /home/will/workspace/hand/logs/20261023-tip_calibration/104526-rod1
exit 0 at 10:55:37
