badinkajink/hand/docs/experiments/20261022-ur5_tip_calibration/lab/20261022-210852-sphere2/printout.txt

== preflight
preflight: HEX-E 100 Hz (asked 100 Hz, filter 3), board 360 records/s, robot 124 Hz
  HEX-E noise (1 sigma) N, N m: [0.0346 0.0255 0.2405 0.0029 0.0042 0.0011]
  HEX-E reads: 0 timed out, 0 late datagrams dropped (0 and 0 on a clean link)
  payload set: 0.384 kg at [0.0, -0.5, 32.5] mm from the flange
== homing
homing: from the recorded seating docs/experiments/20261022-ur5_tip_calibration/lab/poses.jsonl:left_indenter_seated (no freedrive, nothing moves)
homing: 1 seatings within 0.000 mm, 0.000 deg of their mean
  indenter at (-139.0, -595.6, 71.1) mm, yaw -92.3 deg, tilt 0.71 deg; the plan has (-138, -596, 71) mm, yaw -92 deg
== pad
  pad-flank-01: onset -1.031 mm from the expected (power 2.00, fit 113.2 mN)
  pad-flank-05: onset -0.814 mm from the expected (power 2.00, fit 84.5 mN)
  pad-edge-06: onset -0.938 mm from the expected (power 2.00, fit 70.9 mN)
  pad-edge-03: onset -1.186 mm from the expected (power 1.00, fit 127.7 mN)
  pad-edge-09: onset -0.985 mm from the expected (power 1.50, fit 84.8 mN)
  pad-edge-00: onset -0.907 mm from the expected (power 2.00, fit 47.0 mN)
  pad-face-03: onset -1.065 mm from the expected (power 1.50, fit 57.1 mN)
  pad-face-09: onset -0.818 mm from the expected (power 1.25, fit 41.9 mN)
  pad-face-07: ABORT no HEX-E sample for 100 ms
  pad-face-08: onset -1.029 mm from the expected (power 2.00, fit 84.3 mN)
  pad-face-02: onset -0.839 mm from the expected (power 1.25, fit 36.2 mN)
  pad-edge-05: ABORT no HEX-E sample for 100 ms
  pad-face-01: ABORT no HEX-E sample for 100 ms
  pad-face-00: onset -0.677 mm from the expected (power 2.00, fit 46.8 mN)
  pad-face-06: onset -0.641 mm from the expected (power 1.50, fit 47.3 mN)
  pad-face-11: onset -0.439 mm from the expected (power 1.25, fit 30.0 mN)
  pad-face-04: ABORT no HEX-E sample for 100 ms
  pad-face-10: onset -0.283 mm from the expected (power 1.50, fit 44.7 mN)
  pad-edge-02: onset +0.168 mm from the expected (power 2.00, fit 124.2 mN)
  pad-face-05: onset -0.129 mm from the expected (power 1.75, fit 30.4 mN)
  pad-edge-04: onset -0.097 mm from the expected (power 2.00, fit 48.0 mN)
  pad-flank-02: ABORT no HEX-E sample for 100 ms
  pad-edge-08: onset +0.429 mm from the expected (power 1.25, fit 74.4 mN)
  pad-flank-07: onset +0.510 mm from the expected (power 2.00, fit 73.2 mN)
  pad-edge-07: onset +0.498 mm from the expected (power 2.00, fit 40.6 mN)
  pad-edge-01: ABORT no HEX-E sample for 100 ms
  pad-flank-03: ABORT no HEX-E sample for 100 ms
  pad-flank-00: ABORT no HEX-E sample for 100 ms
HEX-E: 130107 samples, 0 timed out, 0 late datagrams dropped, 0 gaps over 0.5 s
session in /home/will/workspace/hand/logs/20261022-tip_calibration/210852-sphere2
three aborts in a row: stopping the session (--resume continues it)
exit 1 at 21:30:42
