badinkajink/hand/docs/experiments/20261022-ur5_tip_calibration/lab/20261022-205059-tcp2/printout.txt

== preflight
preflight: HEX-E 100 Hz (asked 100 Hz, filter 3), board 361 records/s, robot 124 Hz
  HEX-E noise (1 sigma) N, N m: [0.0369 0.047  0.2211 0.003  0.0035 0.0011]
  HEX-E reads: 0 timed out, 0 late datagrams dropped (0 and 0 on a clean link)
  payload set: 0.384 kg at [0.0, -0.5, 32.5] mm from the flange
== homing
homing: from the recorded seating docs/experiments/20261022-ur5_tip_calibration/lab/poses.jsonl:left_indenter_seated (no freedrive, nothing moves)
homing: 1 seatings within 0.000 mm, 0.000 deg of their mean
  indenter at (-139.0, -595.6, 71.1) mm, yaw -92.3 deg, tilt 0.71 deg; the plan has (-138, -596, 71) mm, yaw -92 deg
== grid
  ref-00 (1/3): to 2.00 N
  grid-052 (2/3): to 2.00 N
  grid-053 (3/3): to 2.00 N
== twist
  twist-0-1.0N: ABORT load 10.0 N, 0.38 N m past the limits

interrupted: stopping the robot
HEX-E: 45465 samples, 0 timed out, 0 late datagrams dropped, 0 gaps over 0.5 s
session in /home/will/workspace/hand/logs/20261022-tip_calibration/205059-tcp2
exit 0 at 20:58:37
