badinkajink/hand/docs/experiments/20261022-ur5_tip_calibration/lab/20261022-192715-first/printout.txt

== preflight
preflight: HEX-E 100 Hz (asked 100 Hz, filter 3), board 360 records/s, robot 124 Hz
  HEX-E noise (1 sigma) N, N m: [0.0442 0.0156 0.2301 0.0029 0.0038 0.0011]
  HEX-E reads: 0 timed out, 0 late datagrams dropped (0 and 0 on a clean link)
  payload set: 0.384 kg at [0.0, -0.5, 32.5] mm from the flange
== homing
homing: from the recorded seating docs/experiments/20261022-ur5_tip_calibration/lab/poses.jsonl:left_indenter_seated (no freedrive, nothing moves)
homing: 1 seatings within 0.000 mm, 0.000 deg of their mean
  indenter at (-139.0, -595.6, 71.1) mm, yaw -92.3 deg, tilt 0.71 deg; the plan has (-138, -596, 71) mm, yaw -92 deg
== gravity
  grav-04: ABORT no HEX-E sample for 100 ms
  grav-05: ABORT no HEX-E sample for 100 ms
  grav-06: ABORT no HEX-E sample for 100 ms
HEX-E: 6085 samples, 1240 timed out, 0 late datagrams dropped
session in /home/will/workspace/hand/logs/20261022-tip_calibration/192715-first
three aborts in a row: stopping the session (--resume continues it)
exit 1 at 19:29:21
