badinkajink/hand/docs/experiments/20261106-sr2_servo_sysid/20261106-sysid_plan_steps.tsv

block | step | family | finger | joint | dir | cmd_deg | dwell_s | speed | clear_home_pose_mm | box_mm_middle_80_-85 | box_mm_middle_25_-37.5 | box_mm_middle_80_-37.5 | box_mm_middle_25_-85
a1 | 0 | a1_thumb_mcp_start | thumb | mcp | start | 5.0 | 1.0 | 80 | 119.7 | 118.3 | 71.5 | 70.9 | 74.3
a1 | 1 | a1_thumb_mcp_up | thumb | mcp | up | 5.0 | 0.45 | 80 | 119.7 | 118.3 | 71.5 | 70.9 | 74.3
a1 | 2 | a1_thumb_mcp_up | thumb | mcp | up | 9.0 | 0.45 | 80 | 119.7 | 118.3 | 71.5 | 70.9 | 72.5
a1 | 3 | a1_thumb_mcp_up | thumb | mcp | up | 13.0 | 0.45 | 80 | 119.7 | 118.3 | 68.7 | 70.9 | 70.4
a1 | 4 | a1_thumb_mcp_up | thumb | mcp | up | 17.0 | 0.45 | 80 | 119.7 | 118.3 | 66.3 | 70.9 | 68.2
a1 | 5 | a1_thumb_mcp_up | thumb | mcp | up | 21.0 | 0.45 | 80 | 119.7 | 118.3 | 64.0 | 70.9 | 66.2
a1 | 6 | a1_thumb_mcp_up | thumb | mcp | up | 25.0 | 0.45 | 80 | 119.7 | 115.0 | 61.8 | 70.9 | 63.3
a1 | 7 | a1_thumb_mcp_up | thumb | mcp | up | 29.0 | 0.45 | 80 | 114.7 | 109.9 | 57.0 | 70.9 | 58.4
a1 | 8 | a1_thumb_mcp_up | thumb | mcp | up | 33.0 | 0.45 | 80 | 109.7 | 104.9 | 51.9 | 70.9 | 53.8
a1 | 9 | a1_thumb_mcp_up | thumb | mcp | up | 37.0 | 0.45 | 80 | 104.7 | 100.1 | 46.7 | 70.9 | 48.8
a1 | 10 | a1_thumb_mcp_up | thumb | mcp | up | 41.0 | 0.45 | 80 | 100.0 | 95.5 | 41.8 | 70.9 | 43.8
a1 | 11 | a1_thumb_mcp_up | thumb | mcp | up | 45.0 | 0.45 | 80 | 95.4 | 90.9 | 37.0 | 70.9 | 38.9
a1 | 12 | a1_thumb_mcp_up | thumb | mcp | up | 49.0 | 0.45 | 80 | 90.9 | 86.6 | 32.2 | 70.9 | 34.3
a1 | 13 | a1_thumb_mcp_up | thumb | mcp | up | 53.0 | 0.45 | 80 | 86.7 | 82.6 | 27.8 | 70.9 | 29.6
a1 | 14 | a1_thumb_mcp_up | thumb | mcp | up | 57.0 | 0.45 | 80 | 83.0 | 79.2 | 23.9 | 70.9 | 25.5
a1 | 15 | a1_thumb_mcp_up | thumb | mcp | up | 61.0 | 0.45 | 80 | 79.7 | 76.2 | 20.6 | 70.9 | 22.0
a1 | 16 | a1_thumb_mcp_down | thumb | mcp | down | 61.0 | 0.45 | 80 | 79.7 | 76.2 | 20.6 | 70.9 | 22.0
a1 | 17 | a1_thumb_mcp_down | thumb | mcp | down | 57.0 | 0.45 | 80 | 83.0 | 75.9 | 20.2 | 70.9 | 21.7
a1 | 18 | a1_thumb_mcp_down | thumb | mcp | down | 53.0 | 0.45 | 80 | 86.7 | 78.8 | 23.5 | 70.9 | 25.0
a1 | 19 | a1_thumb_mcp_down | thumb | mcp | down | 49.0 | 0.45 | 80 | 90.9 | 82.2 | 27.2 | 70.9 | 29.1
a1 | 20 | a1_thumb_mcp_down | thumb | mcp | down | 45.0 | 0.45 | 80 | 95.4 | 86.0 | 31.6 | 70.9 | 33.7
a1 | 21 | a1_thumb_mcp_down | thumb | mcp | down | 41.0 | 0.45 | 80 | 100.0 | 90.3 | 36.4 | 70.9 | 38.4
a1 | 22 | a1_thumb_mcp_down | thumb | mcp | down | 37.0 | 0.45 | 80 | 104.7 | 94.9 | 41.2 | 70.9 | 43.2
a1 | 23 | a1_thumb_mcp_down | thumb | mcp | down | 33.0 | 0.45 | 80 | 109.7 | 99.5 | 46.1 | 70.9 | 48.2
a1 | 24 | a1_thumb_mcp_down | thumb | mcp | down | 29.0 | 0.45 | 80 | 114.7 | 104.3 | 51.2 | 70.9 | 53.1
a1 | 25 | a1_thumb_mcp_down | thumb | mcp | down | 25.0 | 0.45 | 80 | 119.7 | 109.3 | 56.4 | 70.9 | 57.8
a1 | 26 | a1_thumb_mcp_down | thumb | mcp | down | 21.0 | 0.45 | 80 | 119.7 | 114.3 | 61.5 | 70.9 | 62.6
a1 | 27 | a1_thumb_mcp_down | thumb | mcp | down | 17.0 | 0.45 | 80 | 119.7 | 118.3 | 63.7 | 70.9 | 65.9
a1 | 28 | a1_thumb_mcp_down | thumb | mcp | down | 13.0 | 0.45 | 80 | 119.7 | 118.3 | 66.0 | 70.9 | 68.0
a1 | 29 | a1_thumb_mcp_down | thumb | mcp | down | 9.0 | 0.45 | 80 | 119.7 | 118.3 | 68.4 | 70.9 | 70.1
a1 | 30 | a1_thumb_mcp_down | thumb | mcp | down | 5.0 | 0.45 | 80 | 119.7 | 118.3 | 71.5 | 70.9 | 72.2
a1 | 31 | a1_thumb_mcp_park | thumb | mcp | park | 0.0 | 1.0 | 80 | 119.7 | 118.3 | 71.5 | 70.9 | 74.5
a1 | 32 | a1_thumb_pip_start | thumb | pip | start | 5.0 | 1.0 | 80 | 119.7 | 118.3 | 71.5 | 70.9 | 76.0
a1 | 33 | a1_thumb_pip_up | thumb | pip | up | 5.0 | 0.45 | 80 | 119.7 | 118.3 | 71.5 | 70.9 | 76.0
a1 | 34 | a1_thumb_pip_up | thumb | pip | up | 9.0 | 0.45 | 80 | 119.7 | 118.3 | 71.5 | 70.9 | 76.0
a1 | 35 | a1_thumb_pip_up | thumb | pip | up | 13.0 | 0.45 | 80 | 119.7 | 118.3 | 71.5 | 70.9 | 76.0
a1 | 36 | a1_thumb_pip_up | thumb | pip | up | 17.0 | 0.45 | 80 | 119.7 | 118.3 | 71.5 | 70.9 | 76.0
a1 | 37 | a1_thumb_pip_up | thumb | pip | up | 21.0 | 0.45 | 80 | 119.7 | 118.3 | 71.5 | 70.9 | 76.0
a1 | 38 | a1_thumb_pip_up | thumb | pip | up | 25.0 | 0.45 | 80 | 119.7 | 118.3 | 71.5 | 70.9 | 76.0
a1 | 39 | a1_thumb_pip_up | thumb | pip | up | 29.0 | 0.45 | 80 | 119.7 | 118.3 | 71.5 | 70.9 | 73.5
a1 | 40 | a1_thumb_pip_up | thumb | pip | up | 33.0 | 0.45 | 80 | 119.7 | 118.3 | 71.5 | 70.9 | 70.7
a1 | 41 | a1_thumb_pip_up | thumb | pip | up | 37.0 | 0.45 | 80 | 119.7 | 118.3 | 66.2 | 70.9 | 67.9
a1 | 42 | a1_thumb_pip_up | thumb | pip | up | 41.0 | 0.45 | 80 | 119.7 | 116.7 | 63.3 | 70.9 | 65.1
a1 | 43 | a1_thumb_pip_up | thumb | pip | up | 45.0 | 0.45 | 80 | 118.5 | 113.9 | 60.5 | 70.9 | 62.4
a1 | 44 | a1_thumb_pip_up | thumb | pip | up | 49.0 | 0.45 | 80 | 115.7 | 111.2 | 57.6 | 70.9 | 59.7
a1 | 45 | a1_thumb_pip_up | thumb | pip | up | 53.0 | 0.45 | 80 | 113.0 | 108.6 | 54.8 | 70.9 | 56.8
a1 | 46 | a1_thumb_pip_up | thumb | pip | up | 57.0 | 0.45 | 80 | 110.6 | 106.3 | 52.2 | 70.9 | 54.1
a1 | 47 | a1_thumb_pip_up | thumb | pip | up | 61.0 | 0.45 | 80 | 108.3 | 104.1 | 49.7 | 70.9 | 51.6
a1 | 48 | a1_thumb_pip_down | thumb | pip | down | 61.0 | 0.45 | 80 | 108.3 | 104.1 | 49.7 | 70.9 | 51.6
a1 | 49 | a1_thumb_pip_down | thumb | pip | down | 57.0 | 0.45 | 80 | 110.6 | 103.9 | 49.5 | 70.9 | 51.3
a1 | 50 | a1_thumb_pip_down | thumb | pip | down | 53.0 | 0.45 | 80 | 113.0 | 106.0 | 51.9 | 70.9 | 53.8
a1 | 51 | a1_thumb_pip_down | thumb | pip | down | 49.0 | 0.45 | 80 | 115.7 | 108.3 | 54.5 | 70.9 | 56.5
a1 | 52 | a1_thumb_pip_down | thumb | pip | down | 45.0 | 0.45 | 80 | 118.5 | 110.8 | 57.3 | 70.9 | 59.3
a1 | 53 | a1_thumb_pip_down | thumb | pip | down | 41.0 | 0.45 | 80 | 119.7 | 113.5 | 60.2 | 70.9 | 62.1
a1 | 54 | a1_thumb_pip_down | thumb | pip | down | 37.0 | 0.45 | 80 | 119.7 | 116.3 | 63.0 | 70.9 | 64.8
a1 | 55 | a1_thumb_pip_down | thumb | pip | down | 33.0 | 0.45 | 80 | 119.7 | 118.3 | 65.9 | 70.9 | 67.6
a1 | 56 | a1_thumb_pip_down | thumb | pip | down | 29.0 | 0.45 | 80 | 119.7 | 118.3 | 71.5 | 70.9 | 70.3
a1 | 57 | a1_thumb_pip_down | thumb | pip | down | 25.0 | 0.45 | 80 | 119.7 | 118.3 | 71.5 | 70.9 | 73.1
a1 | 58 | a1_thumb_pip_down | thumb | pip | down | 21.0 | 0.45 | 80 | 119.7 | 118.3 | 71.5 | 70.9 | 76.0
a1 | 59 | a1_thumb_pip_down | thumb | pip | down | 17.0 | 0.45 | 80 | 119.7 | 118.3 | 71.5 | 70.9 | 76.0
a1 | 60 | a1_thumb_pip_down | thumb | pip | down | 13.0 | 0.45 | 80 | 119.7 | 118.3 | 71.5 | 70.9 | 76.0
a1 | 61 | a1_thumb_pip_down | thumb | pip | down | 9.0 | 0.45 | 80 | 119.7 | 118.3 | 71.5 | 70.9 | 76.0
a1 | 62 | a1_thumb_pip_down | thumb | pip | down | 5.0 | 0.45 | 80 | 119.7 | 118.3 | 71.5 | 70.9 | 76.0
a1 | 63 | a1_thumb_pip_park | thumb | pip | park | 0.0 | 1.0 | 80 | 119.7 | 118.3 | 71.5 | 70.9 | 76.0
a1 | 64 | a1_index_mcp_start | index | mcp | start | 5.0 | 1.0 | 80 | 119.7 | 118.3 | 71.5 | 70.9 | 76.0
a1 | 65 | a1_index_mcp_up | index | mcp | up | 5.0 | 0.45 | 80 | 119.7 | 118.4 | 71.5 | 71.0 | 76.0
a1 | 66 | a1_index_mcp_up | index | mcp | up | 9.0 | 0.45 | 80 | 119.7 | 118.4 | 71.5 | 71.0 | 76.0
a1 | 67 | a1_index_mcp_up | index | mcp | up | 13.0 | 0.45 | 80 | 119.7 | 118.4 | 71.5 | 71.0 | 76.0
a1 | 68 | a1_index_mcp_up | index | mcp | up | 17.0 | 0.45 | 80 | 119.7 | 118.5 | 71.5 | 71.1 | 76.0
a1 | 69 | a1_index_mcp_up | index | mcp | up | 21.0 | 0.45 | 80 | 119.7 | 118.5 | 71.5 | 71.2 | 76.0
a1 | 70 | a1_index_mcp_up | index | mcp | up | 25.0 | 0.45 | 80 | 119.7 | 118.6 | 71.5 | 71.2 | 76.0
a1 | 71 | a1_index_mcp_up | index | mcp | up | 29.0 | 0.45 | 80 | 119.7 | 118.7 | 71.5 | 71.2 | 76.0
a1 | 72 | a1_index_mcp_up | index | mcp | up | 33.0 | 0.45 | 80 | 119.7 | 118.7 | 71.5 | 71.2 | 76.0
a1 | 73 | a1_index_mcp_up | index | mcp | up | 37.0 | 0.45 | 80 | 119.7 | 118.7 | 71.5 | 71.2 | 76.0
a1 | 74 | a1_index_mcp_up | index | mcp | up | 41.0 | 0.45 | 80 | 119.7 | 118.7 | 71.5 | 71.2 | 76.0
a1 | 75 | a1_index_mcp_up | index | mcp | up | 45.0 | 0.45 | 80 | 119.7 | 118.7 | 71.5 | 71.2 | 76.0
a1 | 76 | a1_index_mcp_up | index | mcp | up | 49.0 | 0.45 | 80 | 119.7 | 118.7 | 71.5 | 71.2 | 76.0
a1 | 77 | a1_index_mcp_down | index | mcp | down | 49.0 | 0.45 | 80 | 119.7 | 118.7 | 71.5 | 71.2 | 76.0
a1 | 78 | a1_index_mcp_down | index | mcp | down | 45.0 | 0.45 | 80 | 119.7 | 118.7 | 71.5 | 71.2 | 76.0
a1 | 79 | a1_index_mcp_down | index | mcp | down | 41.0 | 0.45 | 80 | 119.7 | 118.7 | 71.5 | 71.2 | 76.0
a1 | 80 | a1_index_mcp_down | index | mcp | down | 37.0 | 0.45 | 80 | 119.7 | 118.7 | 71.5 | 71.2 | 76.0
a1 | 81 | a1_index_mcp_down | index | mcp | down | 33.0 | 0.45 | 80 | 119.7 | 118.7 | 71.5 | 71.2 | 76.0
a1 | 82 | a1_index_mcp_down | index | mcp | down | 29.0 | 0.45 | 80 | 119.7 | 118.7 | 71.5 | 71.2 | 76.0
a1 | 83 | a1_index_mcp_down | index | mcp | down | 25.0 | 0.45 | 80 | 119.7 | 118.7 | 71.5 | 71.2 | 76.0
a1 | 84 | a1_index_mcp_down | index | mcp | down | 21.0 | 0.45 | 80 | 119.7 | 118.6 | 71.5 | 71.2 | 76.0
a1 | 85 | a1_index_mcp_down | index | mcp | down | 17.0 | 0.45 | 80 | 119.7 | 118.5 | 71.5 | 71.2 | 76.0
a1 | 86 | a1_index_mcp_down | index | mcp | down | 13.0 | 0.45 | 80 | 119.7 | 118.5 | 71.5 | 71.1 | 76.0
a1 | 87 | a1_index_mcp_down | index | mcp | down | 9.0 | 0.45 | 80 | 119.7 | 118.4 | 71.5 | 71.0 | 76.0
a1 | 88 | a1_index_mcp_down | index | mcp | down | 5.0 | 0.45 | 80 | 119.7 | 118.4 | 71.5 | 71.0 | 76.0
a1 | 89 | a1_index_mcp_park | index | mcp | park | 0.0 | 1.0 | 80 | 119.7 | 118.3 | 71.5 | 70.9 | 76.0
a1 | 90 | a1_index_pip_start | index | pip | start | 5.0 | 1.0 | 80 | 119.7 | 118.3 | 71.5 | 70.9 | 76.0
a1 | 91 | a1_index_pip_up | index | pip | up | 5.0 | 0.45 | 80 | 119.7 | 118.3 | 71.5 | 70.9 | 76.0
a1 | 92 | a1_index_pip_up | index | pip | up | 9.0 | 0.45 | 80 | 119.7 | 118.3 | 71.5 | 70.9 | 76.0
a1 | 93 | a1_index_pip_up | index | pip | up | 13.0 | 0.45 | 80 | 119.7 | 118.3 | 71.5 | 70.9 | 76.0
a1 | 94 | a1_index_pip_up | index | pip | up | 17.0 | 0.45 | 80 | 119.7 | 118.3 | 71.5 | 70.9 | 76.0
a1 | 95 | a1_index_pip_up | index | pip | up | 21.0 | 0.45 | 80 | 119.7 | 118.3 | 71.5 | 70.9 | 76.0
a1 | 96 | a1_index_pip_up | index | pip | up | 25.0 | 0.45 | 80 | 119.7 | 118.3 | 71.5 | 70.9 | 76.0
a1 | 97 | a1_index_pip_up | index | pip | up | 29.0 | 0.45 | 80 | 119.7 | 118.3 | 71.5 | 70.9 | 76.0
a1 | 98 | a1_index_pip_up | index | pip | up | 33.0 | 0.45 | 80 | 119.7 | 118.3 | 71.5 | 70.9 | 76.0
a1 | 99 | a1_index_pip_up | index | pip | up | 37.0 | 0.45 | 80 | 119.7 | 118.3 | 71.5 | 70.9 | 76.0
a1 | 100 | a1_index_pip_up | index | pip | up | 41.0 | 0.45 | 80 | 119.7 | 118.3 | 71.5 | 70.9 | 76.0
a1 | 101 | a1_index_pip_up | index | pip | up | 45.0 | 0.45 | 80 | 119.7 | 118.3 | 71.5 | 70.9 | 76.0
a1 | 102 | a1_index_pip_up | index | pip | up | 49.0 | 0.45 | 80 | 119.7 | 118.3 | 71.5 | 70.9 | 76.0
a1 | 103 | a1_index_pip_up | index | pip | up | 53.0 | 0.45 | 80 | 119.7 | 118.3 | 71.5 | 70.9 | 76.0
a1 | 104 | a1_index_pip_up | index | pip | up | 57.0 | 0.45 | 80 | 119.7 | 118.3 | 71.5 | 70.9 | 76.0
a1 | 105 | a1_index_pip_up | index | pip | up | 61.0 | 0.45 | 80 | 119.7 | 118.3 | 71.5 | 70.9 | 76.0
a1 | 106 | a1_index_pip_down | index | pip | down | 61.0 | 0.45 | 80 | 119.7 | 118.3 | 71.5 | 70.9 | 76.0
a1 | 107 | a1_index_pip_down | index | pip | down | 57.0 | 0.45 | 80 | 119.7 | 118.3 | 71.5 | 70.9 | 76.0
a1 | 108 | a1_index_pip_down | index | pip | down | 53.0 | 0.45 | 80 | 119.7 | 118.3 | 71.5 | 70.9 | 76.0
a1 | 109 | a1_index_pip_down | index | pip | down | 49.0 | 0.45 | 80 | 119.7 | 118.3 | 71.5 | 70.9 | 76.0
a1 | 110 | a1_index_pip_down | index | pip | down | 45.0 | 0.45 | 80 | 119.7 | 118.3 | 71.5 | 70.9 | 76.0
a1 | 111 | a1_index_pip_down | index | pip | down | 41.0 | 0.45 | 80 | 119.7 | 118.3 | 71.5 | 70.9 | 76.0
a1 | 112 | a1_index_pip_down | index | pip | down | 37.0 | 0.45 | 80 | 119.7 | 118.3 | 71.5 | 70.9 | 76.0
a1 | 113 | a1_index_pip_down | index | pip | down | 33.0 | 0.45 | 80 | 119.7 | 118.3 | 71.5 | 70.9 | 76.0
a1 | 114 | a1_index_pip_down | index | pip | down | 29.0 | 0.45 | 80 | 119.7 | 118.3 | 71.5 | 70.9 | 76.0
a1 | 115 | a1_index_pip_down | index | pip | down | 25.0 | 0.45 | 80 | 119.7 | 118.3 | 71.5 | 70.9 | 76.0
a1 | 116 | a1_index_pip_down | index | pip | down | 21.0 | 0.45 | 80 | 119.7 | 118.3 | 71.5 | 70.9 | 76.0
a1 | 117 | a1_index_pip_down | index | pip | down | 17.0 | 0.45 | 80 | 119.7 | 118.3 | 71.5 | 70.9 | 76.0
a1 | 118 | a1_index_pip_down | index | pip | down | 13.0 | 0.45 | 80 | 119.7 | 118.3 | 71.5 | 70.9 | 76.0
a1 | 119 | a1_index_pip_down | index | pip | down | 9.0 | 0.45 | 80 | 119.7 | 118.3 | 71.5 | 70.9 | 76.0
a1 | 120 | a1_index_pip_down | index | pip | down | 5.0 | 0.45 | 80 | 119.7 | 118.3 | 71.5 | 70.9 | 76.0
a1 | 121 | a1_index_pip_park | index | pip | park | 0.0 | 1.0 | 80 | 119.7 | 118.3 | 71.5 | 70.9 | 76.0
a1 | 122 | a1_middle_mcp_start | middle | mcp | start | 5.0 | 1.0 | 80 | 119.7 | 118.3 | 71.5 | 70.8 | 74.3
a1 | 123 | a1_middle_mcp_up | middle | mcp | up | 5.0 | 0.45 | 80 | 119.7 | 118.3 | 71.5 | 70.8 | 74.3
a1 | 124 | a1_middle_mcp_up | middle | mcp | up | 9.0 | 0.45 | 80 | 119.7 | 118.2 | 71.5 | 70.8 | 72.5
a1 | 125 | a1_middle_mcp_up | middle | mcp | up | 13.0 | 0.45 | 80 | 119.7 | 118.2 | 68.7 | 70.8 | 70.4
a1 | 126 | a1_middle_mcp_up | middle | mcp | up | 17.0 | 0.45 | 80 | 119.7 | 118.2 | 66.3 | 70.8 | 68.2
a1 | 127 | a1_middle_mcp_up | middle | mcp | up | 21.0 | 0.45 | 80 | 119.7 | 118.2 | 64.0 | 70.8 | 66.2
a1 | 128 | a1_middle_mcp_up | middle | mcp | up | 25.0 | 0.45 | 80 | 119.7 | 115.0 | 61.8 | 70.7 | 63.3
a1 | 129 | a1_middle_mcp_up | middle | mcp | up | 29.0 | 0.45 | 80 | 114.7 | 109.9 | 57.0 | 70.7 | 58.4
a1 | 130 | a1_middle_mcp_up | middle | mcp | up | 33.0 | 0.45 | 80 | 109.7 | 104.9 | 51.9 | 70.7 | 53.8
a1 | 131 | a1_middle_mcp_up | middle | mcp | up | 37.0 | 0.45 | 80 | 104.7 | 100.1 | 46.7 | 70.7 | 48.8
a1 | 132 | a1_middle_mcp_up | middle | mcp | up | 41.0 | 0.45 | 80 | 100.0 | 95.5 | 41.8 | 70.7 | 43.8
a1 | 133 | a1_middle_mcp_up | middle | mcp | up | 45.0 | 0.45 | 80 | 95.4 | 90.9 | 37.0 | 70.7 | 38.9
a1 | 134 | a1_middle_mcp_up | middle | mcp | up | 49.0 | 0.45 | 80 | 90.9 | 86.6 | 32.2 | 70.7 | 34.3
a1 | 135 | a1_middle_mcp_up | middle | mcp | up | 53.0 | 0.45 | 80 | 86.7 | 82.6 | 27.8 | 70.6 | 29.6
a1 | 136 | a1_middle_mcp_up | middle | mcp | up | 57.0 | 0.45 | 80 | 83.0 | 79.2 | 23.9 | 70.6 | 25.5
a1 | 137 | a1_middle_mcp_up | middle | mcp | up | 61.0 | 0.45 | 80 | 79.7 | 76.2 | 20.6 | 70.6 | 22.0
a1 | 138 | a1_middle_mcp_down | middle | mcp | down | 61.0 | 0.45 | 80 | 79.7 | 76.2 | 20.6 | 70.6 | 22.0
a1 | 139 | a1_middle_mcp_down | middle | mcp | down | 57.0 | 0.45 | 80 | 83.0 | 75.9 | 20.2 | 70.6 | 21.7
a1 | 140 | a1_middle_mcp_down | middle | mcp | down | 53.0 | 0.45 | 80 | 86.7 | 78.8 | 23.5 | 70.6 | 25.0
a1 | 141 | a1_middle_mcp_down | middle | mcp | down | 49.0 | 0.45 | 80 | 90.9 | 82.2 | 27.2 | 70.6 | 29.1
a1 | 142 | a1_middle_mcp_down | middle | mcp | down | 45.0 | 0.45 | 80 | 95.4 | 86.0 | 31.6 | 70.7 | 33.7
a1 | 143 | a1_middle_mcp_down | middle | mcp | down | 41.0 | 0.45 | 80 | 100.0 | 90.3 | 36.4 | 70.7 | 38.4
a1 | 144 | a1_middle_mcp_down | middle | mcp | down | 37.0 | 0.45 | 80 | 104.7 | 94.9 | 41.2 | 70.7 | 43.2
a1 | 145 | a1_middle_mcp_down | middle | mcp | down | 33.0 | 0.45 | 80 | 109.7 | 99.5 | 46.1 | 70.7 | 48.2
a1 | 146 | a1_middle_mcp_down | middle | mcp | down | 29.0 | 0.45 | 80 | 114.7 | 104.3 | 51.2 | 70.7 | 53.1
a1 | 147 | a1_middle_mcp_down | middle | mcp | down | 25.0 | 0.45 | 80 | 119.7 | 109.3 | 56.4 | 70.7 | 57.8
a1 | 148 | a1_middle_mcp_down | middle | mcp | down | 21.0 | 0.45 | 80 | 119.7 | 114.3 | 61.5 | 70.7 | 62.6
a1 | 149 | a1_middle_mcp_down | middle | mcp | down | 17.0 | 0.45 | 80 | 119.7 | 118.2 | 63.7 | 70.8 | 65.9
a1 | 150 | a1_middle_mcp_down | middle | mcp | down | 13.0 | 0.45 | 80 | 119.7 | 118.2 | 66.0 | 70.8 | 68.0
a1 | 151 | a1_middle_mcp_down | middle | mcp | down | 9.0 | 0.45 | 80 | 119.7 | 118.2 | 68.4 | 70.8 | 70.1
a1 | 152 | a1_middle_mcp_down | middle | mcp | down | 5.0 | 0.45 | 80 | 119.7 | 118.2 | 71.5 | 70.8 | 72.2
a1 | 153 | a1_middle_mcp_park | middle | mcp | park | 0.0 | 1.0 | 80 | 119.7 | 118.3 | 71.5 | 70.8 | 74.5
a1 | 154 | a1_middle_pip_start | middle | pip | start | 5.0 | 1.0 | 80 | 119.7 | 118.3 | 71.5 | 70.9 | 76.0
a1 | 155 | a1_middle_pip_up | middle | pip | up | 5.0 | 0.45 | 80 | 119.7 | 118.3 | 71.5 | 70.9 | 76.0
a1 | 156 | a1_middle_pip_up | middle | pip | up | 9.0 | 0.45 | 80 | 119.7 | 118.3 | 71.5 | 70.9 | 76.0
a1 | 157 | a1_middle_pip_up | middle | pip | up | 13.0 | 0.45 | 80 | 119.7 | 118.3 | 71.5 | 70.9 | 76.0
a1 | 158 | a1_middle_pip_up | middle | pip | up | 17.0 | 0.45 | 80 | 119.7 | 118.3 | 71.5 | 70.9 | 76.0
a1 | 159 | a1_middle_pip_up | middle | pip | up | 21.0 | 0.45 | 80 | 119.7 | 118.3 | 71.5 | 70.9 | 76.0
a1 | 160 | a1_middle_pip_up | middle | pip | up | 25.0 | 0.45 | 80 | 119.7 | 118.3 | 71.5 | 70.9 | 76.0
a1 | 161 | a1_middle_pip_up | middle | pip | up | 29.0 | 0.45 | 80 | 119.7 | 118.3 | 71.5 | 70.9 | 73.5
a1 | 162 | a1_middle_pip_up | middle | pip | up | 33.0 | 0.45 | 80 | 119.7 | 118.3 | 71.5 | 70.9 | 70.7
a1 | 163 | a1_middle_pip_up | middle | pip | up | 37.0 | 0.45 | 80 | 119.7 | 118.3 | 66.2 | 70.9 | 67.9
a1 | 164 | a1_middle_pip_up | middle | pip | up | 41.0 | 0.45 | 80 | 119.7 | 116.7 | 63.3 | 70.9 | 65.1
a1 | 165 | a1_middle_pip_up | middle | pip | up | 45.0 | 0.45 | 80 | 118.5 | 113.9 | 60.5 | 70.9 | 62.4
a1 | 166 | a1_middle_pip_up | middle | pip | up | 49.0 | 0.45 | 80 | 115.7 | 111.2 | 57.6 | 70.9 | 59.7
a1 | 167 | a1_middle_pip_up | middle | pip | up | 53.0 | 0.45 | 80 | 113.0 | 108.6 | 54.8 | 70.9 | 56.8
a1 | 168 | a1_middle_pip_up | middle | pip | up | 57.0 | 0.45 | 80 | 110.6 | 106.3 | 52.2 | 70.9 | 54.1
a1 | 169 | a1_middle_pip_up | middle | pip | up | 61.0 | 0.45 | 80 | 108.3 | 104.1 | 49.7 | 70.9 | 51.6
a1 | 170 | a1_middle_pip_down | middle | pip | down | 61.0 | 0.45 | 80 | 108.3 | 104.1 | 49.7 | 70.9 | 51.6
a1 | 171 | a1_middle_pip_down | middle | pip | down | 57.0 | 0.45 | 80 | 110.6 | 103.9 | 49.5 | 70.9 | 51.3
a1 | 172 | a1_middle_pip_down | middle | pip | down | 53.0 | 0.45 | 80 | 113.0 | 106.0 | 51.9 | 70.9 | 53.8
a1 | 173 | a1_middle_pip_down | middle | pip | down | 49.0 | 0.45 | 80 | 115.7 | 108.3 | 54.5 | 70.9 | 56.5
a1 | 174 | a1_middle_pip_down | middle | pip | down | 45.0 | 0.45 | 80 | 118.5 | 110.8 | 57.3 | 70.9 | 59.3
a1 | 175 | a1_middle_pip_down | middle | pip | down | 41.0 | 0.45 | 80 | 119.7 | 113.5 | 60.2 | 70.9 | 62.1
a1 | 176 | a1_middle_pip_down | middle | pip | down | 37.0 | 0.45 | 80 | 119.7 | 116.3 | 63.0 | 70.9 | 64.8
a1 | 177 | a1_middle_pip_down | middle | pip | down | 33.0 | 0.45 | 80 | 119.7 | 118.3 | 65.9 | 70.9 | 67.6
a1 | 178 | a1_middle_pip_down | middle | pip | down | 29.0 | 0.45 | 80 | 119.7 | 118.3 | 71.5 | 70.9 | 70.3
a1 | 179 | a1_middle_pip_down | middle | pip | down | 25.0 | 0.45 | 80 | 119.7 | 118.3 | 71.5 | 70.9 | 73.1
a1 | 180 | a1_middle_pip_down | middle | pip | down | 21.0 | 0.45 | 80 | 119.7 | 118.3 | 71.5 | 70.9 | 76.0
a1 | 181 | a1_middle_pip_down | middle | pip | down | 17.0 | 0.45 | 80 | 119.7 | 118.3 | 71.5 | 70.9 | 76.0
a1 | 182 | a1_middle_pip_down | middle | pip | down | 13.0 | 0.45 | 80 | 119.7 | 118.3 | 71.5 | 70.9 | 76.0
a1 | 183 | a1_middle_pip_down | middle | pip | down | 9.0 | 0.45 | 80 | 119.7 | 118.3 | 71.5 | 70.9 | 76.0
a1 | 184 | a1_middle_pip_down | middle | pip | down | 5.0 | 0.45 | 80 | 119.7 | 118.3 | 71.5 | 70.9 | 76.0
a1 | 185 | a1_middle_pip_park | middle | pip | park | 0.0 | 1.0 | 80 | 119.7 | 118.3 | 71.5 | 70.9 | 76.0
b1 | 0 | b1_thumb_yaw_start | thumb | yaw | start | -36.0 | 1.0 | 80 | 119.7 | 118.3 | 71.5 | 70.9 | 75.0
b1 | 1 | b1_thumb_yaw_up | thumb | yaw | up | -36.0 | 0.45 | 80 | 119.7 | 118.3 | 71.6 | 70.9 | 75.0
b1 | 2 | b1_thumb_yaw_up | thumb | yaw | up | -32.0 | 0.45 | 80 | 119.7 | 118.3 | 71.6 | 70.9 | 75.0
b1 | 3 | b1_thumb_yaw_up | thumb | yaw | up | -28.0 | 0.45 | 80 | 119.7 | 118.3 | 71.6 | 70.9 | 75.0
b1 | 4 | b1_thumb_yaw_up | thumb | yaw | up | -24.0 | 0.45 | 80 | 119.7 | 118.3 | 71.5 | 70.9 | 75.0
b1 | 5 | b1_thumb_yaw_up | thumb | yaw | up | -20.0 | 0.45 | 80 | 119.7 | 118.3 | 71.5 | 70.9 | 75.0
b1 | 6 | b1_thumb_yaw_up | thumb | yaw | up | -16.0 | 0.45 | 80 | 119.7 | 118.3 | 71.5 | 70.9 | 75.0
b1 | 7 | b1_thumb_yaw_up | thumb | yaw | up | -12.0 | 0.45 | 80 | 119.7 | 118.3 | 71.5 | 70.9 | 75.0
b1 | 8 | b1_thumb_yaw_up | thumb | yaw | up | -8.0 | 0.45 | 80 | 119.7 | 118.3 | 71.5 | 70.9 | 75.0
b1 | 9 | b1_thumb_yaw_up | thumb | yaw | up | -4.0 | 0.45 | 80 | 119.7 | 118.3 | 71.5 | 70.9 | 75.2
b1 | 10 | b1_thumb_yaw_up | thumb | yaw | up | 0.0 | 0.45 | 80 | 119.7 | 118.3 | 71.5 | 70.9 | 75.4
b1 | 11 | b1_thumb_yaw_up | thumb | yaw | up | 4.0 | 0.45 | 80 | 119.7 | 118.3 | 71.4 | 70.9 | 75.7
b1 | 12 | b1_thumb_yaw_up | thumb | yaw | up | 8.0 | 0.45 | 80 | 119.7 | 118.3 | 71.4 | 70.9 | 76.1
b1 | 13 | b1_thumb_yaw_up | thumb | yaw | up | 12.0 | 0.45 | 80 | 119.7 | 118.3 | 71.4 | 70.9 | 76.6
b1 | 14 | b1_thumb_yaw_up | thumb | yaw | up | 16.0 | 0.45 | 80 | 119.7 | 118.3 | 71.4 | 70.9 | 77.2
b1 | 15 | b1_thumb_yaw_up | thumb | yaw | up | 20.0 | 0.45 | 80 | 119.7 | 118.3 | 71.4 | 70.9 | 77.7
b1 | 16 | b1_thumb_yaw_up | thumb | yaw | up | 24.0 | 0.45 | 80 | 119.7 | 118.3 | 71.4 | 70.9 | 77.7
b1 | 17 | b1_thumb_yaw_up | thumb | yaw | up | 28.0 | 0.45 | 80 | 119.7 | 118.3 | 71.4 | 70.9 | 77.7
b1 | 18 | b1_thumb_yaw_up | thumb | yaw | up | 32.0 | 0.45 | 80 | 119.7 | 118.3 | 71.4 | 70.9 | 77.6
b1 | 19 | b1_thumb_yaw_up | thumb | yaw | up | 36.0 | 0.45 | 80 | 119.7 | 118.3 | 71.4 | 70.9 | 77.6
b1 | 20 | b1_thumb_yaw_down | thumb | yaw | down | 36.0 | 0.45 | 80 | 119.7 | 118.3 | 71.5 | 70.9 | 77.6
b1 | 21 | b1_thumb_yaw_down | thumb | yaw | down | 32.0 | 0.45 | 80 | 119.7 | 118.3 | 71.5 | 70.9 | 77.6
b1 | 22 | b1_thumb_yaw_down | thumb | yaw | down | 28.0 | 0.45 | 80 | 119.7 | 118.3 | 71.4 | 70.9 | 77.6
b1 | 23 | b1_thumb_yaw_down | thumb | yaw | down | 24.0 | 0.45 | 80 | 119.7 | 118.3 | 71.4 | 70.9 | 77.7
b1 | 24 | b1_thumb_yaw_down | thumb | yaw | down | 20.0 | 0.45 | 80 | 119.7 | 118.3 | 71.4 | 70.9 | 77.7
b1 | 25 | b1_thumb_yaw_down | thumb | yaw | down | 16.0 | 0.45 | 80 | 119.7 | 118.3 | 71.4 | 70.9 | 77.7
b1 | 26 | b1_thumb_yaw_down | thumb | yaw | down | 12.0 | 0.45 | 80 | 119.7 | 118.3 | 71.4 | 70.9 | 77.7
b1 | 27 | b1_thumb_yaw_down | thumb | yaw | down | 8.0 | 0.45 | 80 | 119.7 | 118.3 | 71.4 | 70.9 | 77.0
b1 | 28 | b1_thumb_yaw_down | thumb | yaw | down | 4.0 | 0.45 | 80 | 119.7 | 118.3 | 71.4 | 70.9 | 76.5
b1 | 29 | b1_thumb_yaw_down | thumb | yaw | down | 0.0 | 0.45 | 80 | 119.7 | 118.3 | 71.4 | 70.9 | 76.0
b1 | 30 | b1_thumb_yaw_down | thumb | yaw | down | -4.0 | 0.45 | 80 | 119.7 | 118.3 | 71.4 | 70.9 | 75.6
b1 | 31 | b1_thumb_yaw_down | thumb | yaw | down | -8.0 | 0.45 | 80 | 119.7 | 118.3 | 71.5 | 70.9 | 75.3
b1 | 32 | b1_thumb_yaw_down | thumb | yaw | down | -12.0 | 0.45 | 80 | 119.7 | 118.3 | 71.5 | 70.9 | 75.1
b1 | 33 | b1_thumb_yaw_down | thumb | yaw | down | -16.0 | 0.45 | 80 | 119.7 | 118.3 | 71.5 | 70.9 | 75.0
b1 | 34 | b1_thumb_yaw_down | thumb | yaw | down | -20.0 | 0.45 | 80 | 119.7 | 118.3 | 71.5 | 70.9 | 75.0
b1 | 35 | b1_thumb_yaw_down | thumb | yaw | down | -24.0 | 0.45 | 80 | 119.7 | 118.3 | 71.5 | 70.9 | 75.0
b1 | 36 | b1_thumb_yaw_down | thumb | yaw | down | -28.0 | 0.45 | 80 | 119.7 | 118.3 | 71.5 | 70.9 | 75.0
b1 | 37 | b1_thumb_yaw_down | thumb | yaw | down | -32.0 | 0.45 | 80 | 119.7 | 118.3 | 71.5 | 70.9 | 75.0
b1 | 38 | b1_thumb_yaw_down | thumb | yaw | down | -36.0 | 0.45 | 80 | 119.7 | 118.3 | 71.6 | 70.9 | 75.0
b1 | 39 | b1_thumb_yaw_park | thumb | yaw | park | 0.0 | 1.0 | 80 | 119.7 | 118.3 | 71.5 | 70.9 | 75.0
b1 | 40 | b1_index_yaw_start | index | yaw | start | -36.0 | 1.0 | 80 | 86.1 | 78.6 | 49.3 | 31.5 | 76.0
b1 | 41 | b1_index_yaw_up | index | yaw | up | -36.0 | 0.45 | 80 | 86.1 | 78.6 | 49.3 | 31.5 | 76.0
b1 | 42 | b1_index_yaw_up | index | yaw | up | -32.0 | 0.45 | 80 | 92.0 | 74.8 | 45.6 | 27.4 | 76.0
b1 | 43 | b1_index_yaw_up | index | yaw | up | -28.0 | 0.45 | 80 | 98.2 | 80.0 | 50.6 | 33.0 | 76.0
b1 | 44 | b1_index_yaw_up | index | yaw | up | -24.0 | 0.45 | 80 | 104.0 | 85.7 | 56.0 | 39.2 | 76.0
b1 | 45 | b1_index_yaw_up | index | yaw | up | -20.0 | 0.45 | 80 | 107.7 | 91.8 | 59.4 | 45.8 | 76.0
b1 | 46 | b1_index_yaw_up | index | yaw | up | -16.0 | 0.45 | 80 | 111.8 | 98.3 | 62.0 | 51.7 | 76.0
b1 | 47 | b1_index_yaw_up | index | yaw | up | -12.0 | 0.45 | 80 | 116.0 | 102.7 | 65.0 | 55.2 | 76.0
b1 | 48 | b1_index_yaw_up | index | yaw | up | -8.0 | 0.45 | 80 | 117.6 | 106.5 | 68.4 | 59.0 | 76.0
b1 | 49 | b1_index_yaw_up | index | yaw | up | -4.0 | 0.45 | 80 | 119.3 | 110.5 | 71.5 | 63.0 | 76.0
b1 | 50 | b1_index_yaw_up | index | yaw | up | 0.0 | 0.45 | 80 | 119.7 | 114.8 | 71.5 | 67.3 | 76.0
b1 | 51 | b1_index_yaw_up | index | yaw | up | 4.0 | 0.45 | 80 | 119.7 | 117.0 | 71.5 | 69.6 | 76.0
b1 | 52 | b1_index_yaw_up | index | yaw | up | 8.0 | 0.45 | 80 | 119.7 | 118.7 | 71.5 | 71.3 | 76.0
b1 | 53 | b1_index_yaw_up | index | yaw | up | 12.0 | 0.45 | 80 | 119.7 | 119.7 | 71.5 | 72.5 | 76.0
b1 | 54 | b1_index_yaw_up | index | yaw | up | 16.0 | 0.45 | 80 | 119.7 | 119.7 | 71.5 | 72.5 | 76.0
b1 | 55 | b1_index_yaw_up | index | yaw | up | 20.0 | 0.45 | 80 | 119.7 | 119.7 | 71.5 | 72.5 | 76.0
b1 | 56 | b1_index_yaw_up | index | yaw | up | 24.0 | 0.45 | 80 | 119.7 | 119.7 | 71.5 | 72.5 | 76.0
b1 | 57 | b1_index_yaw_up | index | yaw | up | 28.0 | 0.45 | 80 | 119.7 | 119.7 | 71.5 | 72.5 | 76.0
b1 | 58 | b1_index_yaw_up | index | yaw | up | 32.0 | 0.45 | 80 | 119.7 | 119.7 | 71.5 | 72.5 | 76.0
b1 | 59 | b1_index_yaw_up | index | yaw | up | 36.0 | 0.45 | 80 | 119.7 | 119.7 | 71.5 | 72.5 | 76.0
b1 | 60 | b1_index_yaw_down | index | yaw | down | 36.0 | 0.45 | 80 | 119.7 | 119.7 | 71.5 | 72.5 | 76.0
b1 | 61 | b1_index_yaw_down | index | yaw | down | 32.0 | 0.45 | 80 | 119.7 | 119.7 | 71.5 | 72.5 | 76.0
b1 | 62 | b1_index_yaw_down | index | yaw | down | 28.0 | 0.45 | 80 | 119.7 | 119.7 | 71.5 | 72.5 | 76.0
b1 | 63 | b1_index_yaw_down | index | yaw | down | 24.0 | 0.45 | 80 | 119.7 | 119.7 | 71.5 | 72.5 | 76.0
b1 | 64 | b1_index_yaw_down | index | yaw | down | 20.0 | 0.45 | 80 | 119.7 | 119.7 | 71.5 | 72.5 | 76.0
b1 | 65 | b1_index_yaw_down | index | yaw | down | 16.0 | 0.45 | 80 | 119.7 | 119.7 | 71.5 | 72.5 | 76.0
b1 | 66 | b1_index_yaw_down | index | yaw | down | 12.0 | 0.45 | 80 | 119.7 | 119.7 | 71.5 | 72.5 | 76.0
b1 | 67 | b1_index_yaw_down | index | yaw | down | 8.0 | 0.45 | 80 | 119.7 | 119.7 | 71.5 | 72.5 | 76.0
b1 | 68 | b1_index_yaw_down | index | yaw | down | 4.0 | 0.45 | 80 | 119.7 | 119.7 | 71.5 | 72.5 | 76.0
b1 | 69 | b1_index_yaw_down | index | yaw | down | 0.0 | 0.45 | 80 | 119.7 | 118.3 | 71.5 | 70.9 | 76.0
b1 | 70 | b1_index_yaw_down | index | yaw | down | -4.0 | 0.45 | 80 | 119.3 | 116.6 | 71.5 | 69.3 | 76.0
b1 | 71 | b1_index_yaw_down | index | yaw | down | -8.0 | 0.45 | 80 | 117.6 | 113.7 | 71.5 | 66.2 | 76.0
b1 | 72 | b1_index_yaw_down | index | yaw | down | -12.0 | 0.45 | 80 | 116.0 | 109.5 | 71.1 | 62.0 | 76.0
b1 | 73 | b1_index_yaw_down | index | yaw | down | -16.0 | 0.45 | 80 | 111.8 | 105.5 | 67.5 | 58.1 | 76.0
b1 | 74 | b1_index_yaw_down | index | yaw | down | -20.0 | 0.45 | 80 | 107.7 | 101.8 | 64.2 | 54.3 | 76.0
b1 | 75 | b1_index_yaw_down | index | yaw | down | -24.0 | 0.45 | 80 | 104.0 | 96.6 | 61.3 | 50.9 | 76.0
b1 | 76 | b1_index_yaw_down | index | yaw | down | -28.0 | 0.45 | 80 | 98.2 | 90.3 | 58.8 | 44.1 | 76.0
b1 | 77 | b1_index_yaw_down | index | yaw | down | -32.0 | 0.45 | 80 | 92.0 | 84.2 | 54.6 | 37.6 | 76.0
b1 | 78 | b1_index_yaw_down | index | yaw | down | -36.0 | 0.45 | 80 | 86.1 | 78.6 | 49.3 | 31.5 | 76.0
b1 | 79 | b1_index_yaw_park | index | yaw | park | 0.0 | 1.0 | 80 | 119.7 | 82.8 | 53.2 | 36.0 | 76.0
b1 | 80 | b1_middle_yaw_start | middle | yaw | start | -36.0 | 1.0 | 80 | 119.7 | 119.7 | 71.4 | 72.3 | 76.4
b1 | 81 | b1_middle_yaw_up | middle | yaw | up | -36.0 | 0.45 | 80 | 119.7 | 119.7 | 71.5 | 72.5 | 77.6
b1 | 82 | b1_middle_yaw_up | middle | yaw | up | -32.0 | 0.45 | 80 | 119.7 | 119.7 | 71.5 | 72.5 | 77.6
b1 | 83 | b1_middle_yaw_up | middle | yaw | up | -28.0 | 0.45 | 80 | 119.7 | 119.7 | 71.4 | 72.5 | 77.6
b1 | 84 | b1_middle_yaw_up | middle | yaw | up | -24.0 | 0.45 | 80 | 119.7 | 119.7 | 71.4 | 72.5 | 77.7
b1 | 85 | b1_middle_yaw_up | middle | yaw | up | -20.0 | 0.45 | 80 | 119.7 | 119.7 | 71.4 | 72.5 | 77.7
b1 | 86 | b1_middle_yaw_up | middle | yaw | up | -16.0 | 0.45 | 80 | 119.7 | 119.7 | 71.4 | 72.5 | 77.7
b1 | 87 | b1_middle_yaw_up | middle | yaw | up | -12.0 | 0.45 | 80 | 119.7 | 119.7 | 71.4 | 72.5 | 77.7
b1 | 88 | b1_middle_yaw_up | middle | yaw | up | -8.0 | 0.45 | 80 | 119.7 | 119.7 | 71.4 | 72.5 | 77.0
b1 | 89 | b1_middle_yaw_up | middle | yaw | up | -4.0 | 0.45 | 80 | 119.7 | 119.7 | 71.4 | 72.5 | 76.5
b1 | 90 | b1_middle_yaw_up | middle | yaw | up | 0.0 | 0.45 | 80 | 119.7 | 118.3 | 71.4 | 70.9 | 76.0
b1 | 91 | b1_middle_yaw_up | middle | yaw | up | 4.0 | 0.45 | 80 | 119.2 | 116.2 | 71.4 | 68.8 | 75.6
b1 | 92 | b1_middle_yaw_up | middle | yaw | up | 8.0 | 0.45 | 80 | 117.1 | 113.8 | 71.5 | 66.3 | 75.3
b1 | 93 | b1_middle_yaw_up | middle | yaw | up | 12.0 | 0.45 | 80 | 114.7 | 109.7 | 71.5 | 62.3 | 75.1
b1 | 94 | b1_middle_yaw_up | middle | yaw | up | 16.0 | 0.45 | 80 | 110.2 | 104.2 | 68.5 | 58.4 | 75.0
b1 | 95 | b1_middle_yaw_up | middle | yaw | up | 20.0 | 0.45 | 80 | 105.9 | 97.6 | 65.2 | 51.7 | 75.0
b1 | 96 | b1_middle_yaw_up | middle | yaw | up | 24.0 | 0.45 | 80 | 99.3 | 91.0 | 60.1 | 45.0 | 75.0
b1 | 97 | b1_middle_yaw_up | middle | yaw | up | 28.0 | 0.45 | 80 | 92.8 | 84.7 | 55.0 | 38.5 | 75.0
b1 | 98 | b1_middle_yaw_up | middle | yaw | up | 32.0 | 0.45 | 80 | 86.6 | 78.7 | 50.3 | 31.9 | 75.0
b1 | 99 | b1_middle_yaw_up | middle | yaw | up | 36.0 | 0.45 | 80 | 80.8 | 73.1 | 46.2 | 25.8 | 75.0
b1 | 100 | b1_middle_yaw_down | middle | yaw | down | 36.0 | 0.45 | 80 | 80.8 | 73.1 | 46.2 | 25.8 | 75.0
b1 | 101 | b1_middle_yaw_down | middle | yaw | down | 32.0 | 0.45 | 80 | 86.6 | 69.2 | 43.8 | 21.8 | 75.0
b1 | 102 | b1_middle_yaw_down | middle | yaw | down | 28.0 | 0.45 | 80 | 92.8 | 74.4 | 47.2 | 27.3 | 75.0
b1 | 103 | b1_middle_yaw_down | middle | yaw | down | 24.0 | 0.45 | 80 | 99.3 | 80.1 | 51.4 | 33.5 | 75.0
b1 | 104 | b1_middle_yaw_down | middle | yaw | down | 20.0 | 0.45 | 80 | 105.9 | 86.2 | 56.2 | 40.1 | 75.0
b1 | 105 | b1_middle_yaw_down | middle | yaw | down | 16.0 | 0.45 | 80 | 110.2 | 92.7 | 61.4 | 46.7 | 75.0
b1 | 106 | b1_middle_yaw_down | middle | yaw | down | 12.0 | 0.45 | 80 | 114.7 | 99.2 | 66.0 | 53.4 | 75.0
b1 | 107 | b1_middle_yaw_down | middle | yaw | down | 8.0 | 0.45 | 80 | 117.1 | 105.9 | 69.3 | 59.3 | 75.0
b1 | 108 | b1_middle_yaw_down | middle | yaw | down | 4.0 | 0.45 | 80 | 119.2 | 110.7 | 71.5 | 63.3 | 75.2
b1 | 109 | b1_middle_yaw_down | middle | yaw | down | 0.0 | 0.45 | 80 | 119.7 | 114.8 | 71.5 | 67.3 | 75.4
b1 | 110 | b1_middle_yaw_down | middle | yaw | down | -4.0 | 0.45 | 80 | 119.7 | 116.8 | 71.4 | 69.3 | 75.7
b1 | 111 | b1_middle_yaw_down | middle | yaw | down | -8.0 | 0.45 | 80 | 119.7 | 118.8 | 71.4 | 71.4 | 76.1
b1 | 112 | b1_middle_yaw_down | middle | yaw | down | -12.0 | 0.45 | 80 | 119.7 | 119.7 | 71.4 | 72.5 | 76.6
b1 | 113 | b1_middle_yaw_down | middle | yaw | down | -16.0 | 0.45 | 80 | 119.7 | 119.7 | 71.4 | 72.5 | 77.2
b1 | 114 | b1_middle_yaw_down | middle | yaw | down | -20.0 | 0.45 | 80 | 119.7 | 119.7 | 71.4 | 72.5 | 77.7
b1 | 115 | b1_middle_yaw_down | middle | yaw | down | -24.0 | 0.45 | 80 | 119.7 | 119.7 | 71.4 | 72.5 | 77.7
b1 | 116 | b1_middle_yaw_down | middle | yaw | down | -28.0 | 0.45 | 80 | 119.7 | 119.7 | 71.4 | 72.5 | 77.7
b1 | 117 | b1_middle_yaw_down | middle | yaw | down | -32.0 | 0.45 | 80 | 119.7 | 119.7 | 71.4 | 72.5 | 77.6
b1 | 118 | b1_middle_yaw_down | middle | yaw | down | -36.0 | 0.45 | 80 | 119.7 | 119.7 | 71.4 | 72.5 | 77.6
b1 | 119 | b1_middle_yaw_park | middle | yaw | park | 0.0 | 1.0 | 80 | 119.7 | 118.3 | 71.4 | 70.9 | 76.0
a2 | 0 | a2_thumb_mcp_start | thumb | mcp | start | 5.0 | 1.0 | 80 | 119.7 | 118.3 | 71.5 | 70.9 | 74.3
a2 | 1 | a2_thumb_mcp_up | thumb | mcp | up | 5.0 | 2.0 | 80 | 119.7 | 118.3 | 71.5 | 70.9 | 74.3
a2 | 2 | a2_thumb_mcp_up | thumb | mcp | up | 9.0 | 2.0 | 80 | 119.7 | 118.3 | 71.5 | 70.9 | 72.5
a2 | 3 | a2_thumb_mcp_up | thumb | mcp | up | 13.0 | 2.0 | 80 | 119.7 | 118.3 | 68.7 | 70.9 | 70.4
a2 | 4 | a2_thumb_mcp_up | thumb | mcp | up | 17.0 | 2.0 | 80 | 119.7 | 118.3 | 66.3 | 70.9 | 68.2
a2 | 5 | a2_thumb_mcp_up | thumb | mcp | up | 21.0 | 2.0 | 80 | 119.7 | 118.3 | 64.0 | 70.9 | 66.2
a2 | 6 | a2_thumb_mcp_up | thumb | mcp | up | 25.0 | 2.0 | 80 | 119.7 | 115.0 | 61.8 | 70.9 | 63.3
a2 | 7 | a2_thumb_mcp_up | thumb | mcp | up | 29.0 | 2.0 | 80 | 114.7 | 109.9 | 57.0 | 70.9 | 58.4
a2 | 8 | a2_thumb_mcp_up | thumb | mcp | up | 33.0 | 2.0 | 80 | 109.7 | 104.9 | 51.9 | 70.9 | 53.8
a2 | 9 | a2_thumb_mcp_up | thumb | mcp | up | 37.0 | 2.0 | 80 | 104.7 | 100.1 | 46.7 | 70.9 | 48.8
a2 | 10 | a2_thumb_mcp_up | thumb | mcp | up | 41.0 | 2.0 | 80 | 100.0 | 95.5 | 41.8 | 70.9 | 43.8
a2 | 11 | a2_thumb_mcp_up | thumb | mcp | up | 45.0 | 2.0 | 80 | 95.4 | 90.9 | 37.0 | 70.9 | 38.9
a2 | 12 | a2_thumb_mcp_up | thumb | mcp | up | 49.0 | 2.0 | 80 | 90.9 | 86.6 | 32.2 | 70.9 | 34.3
a2 | 13 | a2_thumb_mcp_up | thumb | mcp | up | 53.0 | 2.0 | 80 | 86.7 | 82.6 | 27.8 | 70.9 | 29.6
a2 | 14 | a2_thumb_mcp_up | thumb | mcp | up | 57.0 | 2.0 | 80 | 83.0 | 79.2 | 23.9 | 70.9 | 25.5
a2 | 15 | a2_thumb_mcp_up | thumb | mcp | up | 61.0 | 2.0 | 80 | 79.7 | 76.2 | 20.6 | 70.9 | 22.0
a2 | 16 | a2_thumb_mcp_down | thumb | mcp | down | 61.0 | 2.0 | 80 | 79.7 | 76.2 | 20.6 | 70.9 | 22.0
a2 | 17 | a2_thumb_mcp_down | thumb | mcp | down | 57.0 | 2.0 | 80 | 83.0 | 75.9 | 20.2 | 70.9 | 21.7
a2 | 18 | a2_thumb_mcp_down | thumb | mcp | down | 53.0 | 2.0 | 80 | 86.7 | 78.8 | 23.5 | 70.9 | 25.0
a2 | 19 | a2_thumb_mcp_down | thumb | mcp | down | 49.0 | 2.0 | 80 | 90.9 | 82.2 | 27.2 | 70.9 | 29.1
a2 | 20 | a2_thumb_mcp_down | thumb | mcp | down | 45.0 | 2.0 | 80 | 95.4 | 86.0 | 31.6 | 70.9 | 33.7
a2 | 21 | a2_thumb_mcp_down | thumb | mcp | down | 41.0 | 2.0 | 80 | 100.0 | 90.3 | 36.4 | 70.9 | 38.4
a2 | 22 | a2_thumb_mcp_down | thumb | mcp | down | 37.0 | 2.0 | 80 | 104.7 | 94.9 | 41.2 | 70.9 | 43.2
a2 | 23 | a2_thumb_mcp_down | thumb | mcp | down | 33.0 | 2.0 | 80 | 109.7 | 99.5 | 46.1 | 70.9 | 48.2
a2 | 24 | a2_thumb_mcp_down | thumb | mcp | down | 29.0 | 2.0 | 80 | 114.7 | 104.3 | 51.2 | 70.9 | 53.1
a2 | 25 | a2_thumb_mcp_down | thumb | mcp | down | 25.0 | 2.0 | 80 | 119.7 | 109.3 | 56.4 | 70.9 | 57.8
a2 | 26 | a2_thumb_mcp_down | thumb | mcp | down | 21.0 | 2.0 | 80 | 119.7 | 114.3 | 61.5 | 70.9 | 62.6
a2 | 27 | a2_thumb_mcp_down | thumb | mcp | down | 17.0 | 2.0 | 80 | 119.7 | 118.3 | 63.7 | 70.9 | 65.9
a2 | 28 | a2_thumb_mcp_down | thumb | mcp | down | 13.0 | 2.0 | 80 | 119.7 | 118.3 | 66.0 | 70.9 | 68.0
a2 | 29 | a2_thumb_mcp_down | thumb | mcp | down | 9.0 | 2.0 | 80 | 119.7 | 118.3 | 68.4 | 70.9 | 70.1
a2 | 30 | a2_thumb_mcp_down | thumb | mcp | down | 5.0 | 2.0 | 80 | 119.7 | 118.3 | 71.5 | 70.9 | 72.2
a2 | 31 | a2_thumb_mcp_park | thumb | mcp | park | 0.0 | 1.0 | 80 | 119.7 | 118.3 | 71.5 | 70.9 | 74.5
a2 | 32 | a2_thumb_pip_start | thumb | pip | start | 5.0 | 1.0 | 80 | 119.7 | 118.3 | 71.5 | 70.9 | 76.0
a2 | 33 | a2_thumb_pip_up | thumb | pip | up | 5.0 | 2.0 | 80 | 119.7 | 118.3 | 71.5 | 70.9 | 76.0
a2 | 34 | a2_thumb_pip_up | thumb | pip | up | 9.0 | 2.0 | 80 | 119.7 | 118.3 | 71.5 | 70.9 | 76.0
a2 | 35 | a2_thumb_pip_up | thumb | pip | up | 13.0 | 2.0 | 80 | 119.7 | 118.3 | 71.5 | 70.9 | 76.0
a2 | 36 | a2_thumb_pip_up | thumb | pip | up | 17.0 | 2.0 | 80 | 119.7 | 118.3 | 71.5 | 70.9 | 76.0
a2 | 37 | a2_thumb_pip_up | thumb | pip | up | 21.0 | 2.0 | 80 | 119.7 | 118.3 | 71.5 | 70.9 | 76.0
a2 | 38 | a2_thumb_pip_up | thumb | pip | up | 25.0 | 2.0 | 80 | 119.7 | 118.3 | 71.5 | 70.9 | 76.0
a2 | 39 | a2_thumb_pip_up | thumb | pip | up | 29.0 | 2.0 | 80 | 119.7 | 118.3 | 71.5 | 70.9 | 73.5
a2 | 40 | a2_thumb_pip_up | thumb | pip | up | 33.0 | 2.0 | 80 | 119.7 | 118.3 | 71.5 | 70.9 | 70.7
a2 | 41 | a2_thumb_pip_up | thumb | pip | up | 37.0 | 2.0 | 80 | 119.7 | 118.3 | 66.2 | 70.9 | 67.9
a2 | 42 | a2_thumb_pip_up | thumb | pip | up | 41.0 | 2.0 | 80 | 119.7 | 116.7 | 63.3 | 70.9 | 65.1
a2 | 43 | a2_thumb_pip_up | thumb | pip | up | 45.0 | 2.0 | 80 | 118.5 | 113.9 | 60.5 | 70.9 | 62.4
a2 | 44 | a2_thumb_pip_up | thumb | pip | up | 49.0 | 2.0 | 80 | 115.7 | 111.2 | 57.6 | 70.9 | 59.7
a2 | 45 | a2_thumb_pip_up | thumb | pip | up | 53.0 | 2.0 | 80 | 113.0 | 108.6 | 54.8 | 70.9 | 56.8
a2 | 46 | a2_thumb_pip_up | thumb | pip | up | 57.0 | 2.0 | 80 | 110.6 | 106.3 | 52.2 | 70.9 | 54.1
a2 | 47 | a2_thumb_pip_up | thumb | pip | up | 61.0 | 2.0 | 80 | 108.3 | 104.1 | 49.7 | 70.9 | 51.6
a2 | 48 | a2_thumb_pip_down | thumb | pip | down | 61.0 | 2.0 | 80 | 108.3 | 104.1 | 49.7 | 70.9 | 51.6
a2 | 49 | a2_thumb_pip_down | thumb | pip | down | 57.0 | 2.0 | 80 | 110.6 | 103.9 | 49.5 | 70.9 | 51.3
a2 | 50 | a2_thumb_pip_down | thumb | pip | down | 53.0 | 2.0 | 80 | 113.0 | 106.0 | 51.9 | 70.9 | 53.8
a2 | 51 | a2_thumb_pip_down | thumb | pip | down | 49.0 | 2.0 | 80 | 115.7 | 108.3 | 54.5 | 70.9 | 56.5
a2 | 52 | a2_thumb_pip_down | thumb | pip | down | 45.0 | 2.0 | 80 | 118.5 | 110.8 | 57.3 | 70.9 | 59.3
a2 | 53 | a2_thumb_pip_down | thumb | pip | down | 41.0 | 2.0 | 80 | 119.7 | 113.5 | 60.2 | 70.9 | 62.1
a2 | 54 | a2_thumb_pip_down | thumb | pip | down | 37.0 | 2.0 | 80 | 119.7 | 116.3 | 63.0 | 70.9 | 64.8
a2 | 55 | a2_thumb_pip_down | thumb | pip | down | 33.0 | 2.0 | 80 | 119.7 | 118.3 | 65.9 | 70.9 | 67.6
a2 | 56 | a2_thumb_pip_down | thumb | pip | down | 29.0 | 2.0 | 80 | 119.7 | 118.3 | 71.5 | 70.9 | 70.3
a2 | 57 | a2_thumb_pip_down | thumb | pip | down | 25.0 | 2.0 | 80 | 119.7 | 118.3 | 71.5 | 70.9 | 73.1
a2 | 58 | a2_thumb_pip_down | thumb | pip | down | 21.0 | 2.0 | 80 | 119.7 | 118.3 | 71.5 | 70.9 | 76.0
a2 | 59 | a2_thumb_pip_down | thumb | pip | down | 17.0 | 2.0 | 80 | 119.7 | 118.3 | 71.5 | 70.9 | 76.0
a2 | 60 | a2_thumb_pip_down | thumb | pip | down | 13.0 | 2.0 | 80 | 119.7 | 118.3 | 71.5 | 70.9 | 76.0
a2 | 61 | a2_thumb_pip_down | thumb | pip | down | 9.0 | 2.0 | 80 | 119.7 | 118.3 | 71.5 | 70.9 | 76.0
a2 | 62 | a2_thumb_pip_down | thumb | pip | down | 5.0 | 2.0 | 80 | 119.7 | 118.3 | 71.5 | 70.9 | 76.0
a2 | 63 | a2_thumb_pip_park | thumb | pip | park | 0.0 | 1.0 | 80 | 119.7 | 118.3 | 71.5 | 70.9 | 76.0
a2 | 64 | a2_index_mcp_start | index | mcp | start | 5.0 | 1.0 | 80 | 119.7 | 118.3 | 71.5 | 70.9 | 76.0
a2 | 65 | a2_index_mcp_up | index | mcp | up | 5.0 | 2.0 | 80 | 119.7 | 118.4 | 71.5 | 71.0 | 76.0
a2 | 66 | a2_index_mcp_up | index | mcp | up | 9.0 | 2.0 | 80 | 119.7 | 118.4 | 71.5 | 71.0 | 76.0
a2 | 67 | a2_index_mcp_up | index | mcp | up | 13.0 | 2.0 | 80 | 119.7 | 118.4 | 71.5 | 71.0 | 76.0
a2 | 68 | a2_index_mcp_up | index | mcp | up | 17.0 | 2.0 | 80 | 119.7 | 118.5 | 71.5 | 71.1 | 76.0
a2 | 69 | a2_index_mcp_up | index | mcp | up | 21.0 | 2.0 | 80 | 119.7 | 118.5 | 71.5 | 71.2 | 76.0
a2 | 70 | a2_index_mcp_up | index | mcp | up | 25.0 | 2.0 | 80 | 119.7 | 118.6 | 71.5 | 71.2 | 76.0
a2 | 71 | a2_index_mcp_up | index | mcp | up | 29.0 | 2.0 | 80 | 119.7 | 118.7 | 71.5 | 71.2 | 76.0
a2 | 72 | a2_index_mcp_up | index | mcp | up | 33.0 | 2.0 | 80 | 119.7 | 118.7 | 71.5 | 71.2 | 76.0
a2 | 73 | a2_index_mcp_up | index | mcp | up | 37.0 | 2.0 | 80 | 119.7 | 118.7 | 71.5 | 71.2 | 76.0
a2 | 74 | a2_index_mcp_up | index | mcp | up | 41.0 | 2.0 | 80 | 119.7 | 118.7 | 71.5 | 71.2 | 76.0
a2 | 75 | a2_index_mcp_up | index | mcp | up | 45.0 | 2.0 | 80 | 119.7 | 118.7 | 71.5 | 71.2 | 76.0
a2 | 76 | a2_index_mcp_up | index | mcp | up | 49.0 | 2.0 | 80 | 119.7 | 118.7 | 71.5 | 71.2 | 76.0
a2 | 77 | a2_index_mcp_down | index | mcp | down | 49.0 | 2.0 | 80 | 119.7 | 118.7 | 71.5 | 71.2 | 76.0
a2 | 78 | a2_index_mcp_down | index | mcp | down | 45.0 | 2.0 | 80 | 119.7 | 118.7 | 71.5 | 71.2 | 76.0
a2 | 79 | a2_index_mcp_down | index | mcp | down | 41.0 | 2.0 | 80 | 119.7 | 118.7 | 71.5 | 71.2 | 76.0
a2 | 80 | a2_index_mcp_down | index | mcp | down | 37.0 | 2.0 | 80 | 119.7 | 118.7 | 71.5 | 71.2 | 76.0
a2 | 81 | a2_index_mcp_down | index | mcp | down | 33.0 | 2.0 | 80 | 119.7 | 118.7 | 71.5 | 71.2 | 76.0
a2 | 82 | a2_index_mcp_down | index | mcp | down | 29.0 | 2.0 | 80 | 119.7 | 118.7 | 71.5 | 71.2 | 76.0
a2 | 83 | a2_index_mcp_down | index | mcp | down | 25.0 | 2.0 | 80 | 119.7 | 118.7 | 71.5 | 71.2 | 76.0
a2 | 84 | a2_index_mcp_down | index | mcp | down | 21.0 | 2.0 | 80 | 119.7 | 118.6 | 71.5 | 71.2 | 76.0
a2 | 85 | a2_index_mcp_down | index | mcp | down | 17.0 | 2.0 | 80 | 119.7 | 118.5 | 71.5 | 71.2 | 76.0
a2 | 86 | a2_index_mcp_down | index | mcp | down | 13.0 | 2.0 | 80 | 119.7 | 118.5 | 71.5 | 71.1 | 76.0
a2 | 87 | a2_index_mcp_down | index | mcp | down | 9.0 | 2.0 | 80 | 119.7 | 118.4 | 71.5 | 71.0 | 76.0
a2 | 88 | a2_index_mcp_down | index | mcp | down | 5.0 | 2.0 | 80 | 119.7 | 118.4 | 71.5 | 71.0 | 76.0
a2 | 89 | a2_index_mcp_park | index | mcp | park | 0.0 | 1.0 | 80 | 119.7 | 118.3 | 71.5 | 70.9 | 76.0
a2 | 90 | a2_index_pip_start | index | pip | start | 5.0 | 1.0 | 80 | 119.7 | 118.3 | 71.5 | 70.9 | 76.0
a2 | 91 | a2_index_pip_up | index | pip | up | 5.0 | 2.0 | 80 | 119.7 | 118.3 | 71.5 | 70.9 | 76.0
a2 | 92 | a2_index_pip_up | index | pip | up | 9.0 | 2.0 | 80 | 119.7 | 118.3 | 71.5 | 70.9 | 76.0
a2 | 93 | a2_index_pip_up | index | pip | up | 13.0 | 2.0 | 80 | 119.7 | 118.3 | 71.5 | 70.9 | 76.0
a2 | 94 | a2_index_pip_up | index | pip | up | 17.0 | 2.0 | 80 | 119.7 | 118.3 | 71.5 | 70.9 | 76.0
a2 | 95 | a2_index_pip_up | index | pip | up | 21.0 | 2.0 | 80 | 119.7 | 118.3 | 71.5 | 70.9 | 76.0
a2 | 96 | a2_index_pip_up | index | pip | up | 25.0 | 2.0 | 80 | 119.7 | 118.3 | 71.5 | 70.9 | 76.0
a2 | 97 | a2_index_pip_up | index | pip | up | 29.0 | 2.0 | 80 | 119.7 | 118.3 | 71.5 | 70.9 | 76.0
a2 | 98 | a2_index_pip_up | index | pip | up | 33.0 | 2.0 | 80 | 119.7 | 118.3 | 71.5 | 70.9 | 76.0
a2 | 99 | a2_index_pip_up | index | pip | up | 37.0 | 2.0 | 80 | 119.7 | 118.3 | 71.5 | 70.9 | 76.0
a2 | 100 | a2_index_pip_up | index | pip | up | 41.0 | 2.0 | 80 | 119.7 | 118.3 | 71.5 | 70.9 | 76.0
a2 | 101 | a2_index_pip_up | index | pip | up | 45.0 | 2.0 | 80 | 119.7 | 118.3 | 71.5 | 70.9 | 76.0
a2 | 102 | a2_index_pip_up | index | pip | up | 49.0 | 2.0 | 80 | 119.7 | 118.3 | 71.5 | 70.9 | 76.0
a2 | 103 | a2_index_pip_up | index | pip | up | 53.0 | 2.0 | 80 | 119.7 | 118.3 | 71.5 | 70.9 | 76.0
a2 | 104 | a2_index_pip_up | index | pip | up | 57.0 | 2.0 | 80 | 119.7 | 118.3 | 71.5 | 70.9 | 76.0
a2 | 105 | a2_index_pip_up | index | pip | up | 61.0 | 2.0 | 80 | 119.7 | 118.3 | 71.5 | 70.9 | 76.0
a2 | 106 | a2_index_pip_down | index | pip | down | 61.0 | 2.0 | 80 | 119.7 | 118.3 | 71.5 | 70.9 | 76.0
a2 | 107 | a2_index_pip_down | index | pip | down | 57.0 | 2.0 | 80 | 119.7 | 118.3 | 71.5 | 70.9 | 76.0
a2 | 108 | a2_index_pip_down | index | pip | down | 53.0 | 2.0 | 80 | 119.7 | 118.3 | 71.5 | 70.9 | 76.0
a2 | 109 | a2_index_pip_down | index | pip | down | 49.0 | 2.0 | 80 | 119.7 | 118.3 | 71.5 | 70.9 | 76.0
a2 | 110 | a2_index_pip_down | index | pip | down | 45.0 | 2.0 | 80 | 119.7 | 118.3 | 71.5 | 70.9 | 76.0
a2 | 111 | a2_index_pip_down | index | pip | down | 41.0 | 2.0 | 80 | 119.7 | 118.3 | 71.5 | 70.9 | 76.0
a2 | 112 | a2_index_pip_down | index | pip | down | 37.0 | 2.0 | 80 | 119.7 | 118.3 | 71.5 | 70.9 | 76.0
a2 | 113 | a2_index_pip_down | index | pip | down | 33.0 | 2.0 | 80 | 119.7 | 118.3 | 71.5 | 70.9 | 76.0
a2 | 114 | a2_index_pip_down | index | pip | down | 29.0 | 2.0 | 80 | 119.7 | 118.3 | 71.5 | 70.9 | 76.0
a2 | 115 | a2_index_pip_down | index | pip | down | 25.0 | 2.0 | 80 | 119.7 | 118.3 | 71.5 | 70.9 | 76.0
a2 | 116 | a2_index_pip_down | index | pip | down | 21.0 | 2.0 | 80 | 119.7 | 118.3 | 71.5 | 70.9 | 76.0
a2 | 117 | a2_index_pip_down | index | pip | down | 17.0 | 2.0 | 80 | 119.7 | 118.3 | 71.5 | 70.9 | 76.0
a2 | 118 | a2_index_pip_down | index | pip | down | 13.0 | 2.0 | 80 | 119.7 | 118.3 | 71.5 | 70.9 | 76.0
a2 | 119 | a2_index_pip_down | index | pip | down | 9.0 | 2.0 | 80 | 119.7 | 118.3 | 71.5 | 70.9 | 76.0
a2 | 120 | a2_index_pip_down | index | pip | down | 5.0 | 2.0 | 80 | 119.7 | 118.3 | 71.5 | 70.9 | 76.0
a2 | 121 | a2_index_pip_park | index | pip | park | 0.0 | 1.0 | 80 | 119.7 | 118.3 | 71.5 | 70.9 | 76.0
a2 | 122 | a2_middle_mcp_start | middle | mcp | start | 5.0 | 1.0 | 80 | 119.7 | 118.3 | 71.5 | 70.8 | 74.3
a2 | 123 | a2_middle_mcp_up | middle | mcp | up | 5.0 | 2.0 | 80 | 119.7 | 118.3 | 71.5 | 70.8 | 74.3
a2 | 124 | a2_middle_mcp_up | middle | mcp | up | 9.0 | 2.0 | 80 | 119.7 | 118.2 | 71.5 | 70.8 | 72.5
a2 | 125 | a2_middle_mcp_up | middle | mcp | up | 13.0 | 2.0 | 80 | 119.7 | 118.2 | 68.7 | 70.8 | 70.4
a2 | 126 | a2_middle_mcp_up | middle | mcp | up | 17.0 | 2.0 | 80 | 119.7 | 118.2 | 66.3 | 70.8 | 68.2
a2 | 127 | a2_middle_mcp_up | middle | mcp | up | 21.0 | 2.0 | 80 | 119.7 | 118.2 | 64.0 | 70.8 | 66.2
a2 | 128 | a2_middle_mcp_up | middle | mcp | up | 25.0 | 2.0 | 80 | 119.7 | 115.0 | 61.8 | 70.7 | 63.3
a2 | 129 | a2_middle_mcp_up | middle | mcp | up | 29.0 | 2.0 | 80 | 114.7 | 109.9 | 57.0 | 70.7 | 58.4
a2 | 130 | a2_middle_mcp_up | middle | mcp | up | 33.0 | 2.0 | 80 | 109.7 | 104.9 | 51.9 | 70.7 | 53.8
a2 | 131 | a2_middle_mcp_up | middle | mcp | up | 37.0 | 2.0 | 80 | 104.7 | 100.1 | 46.7 | 70.7 | 48.8
a2 | 132 | a2_middle_mcp_up | middle | mcp | up | 41.0 | 2.0 | 80 | 100.0 | 95.5 | 41.8 | 70.7 | 43.8
a2 | 133 | a2_middle_mcp_up | middle | mcp | up | 45.0 | 2.0 | 80 | 95.4 | 90.9 | 37.0 | 70.7 | 38.9
a2 | 134 | a2_middle_mcp_up | middle | mcp | up | 49.0 | 2.0 | 80 | 90.9 | 86.6 | 32.2 | 70.7 | 34.3
a2 | 135 | a2_middle_mcp_up | middle | mcp | up | 53.0 | 2.0 | 80 | 86.7 | 82.6 | 27.8 | 70.6 | 29.6
a2 | 136 | a2_middle_mcp_up | middle | mcp | up | 57.0 | 2.0 | 80 | 83.0 | 79.2 | 23.9 | 70.6 | 25.5
a2 | 137 | a2_middle_mcp_up | middle | mcp | up | 61.0 | 2.0 | 80 | 79.7 | 76.2 | 20.6 | 70.6 | 22.0
a2 | 138 | a2_middle_mcp_down | middle | mcp | down | 61.0 | 2.0 | 80 | 79.7 | 76.2 | 20.6 | 70.6 | 22.0
a2 | 139 | a2_middle_mcp_down | middle | mcp | down | 57.0 | 2.0 | 80 | 83.0 | 75.9 | 20.2 | 70.6 | 21.7
a2 | 140 | a2_middle_mcp_down | middle | mcp | down | 53.0 | 2.0 | 80 | 86.7 | 78.8 | 23.5 | 70.6 | 25.0
a2 | 141 | a2_middle_mcp_down | middle | mcp | down | 49.0 | 2.0 | 80 | 90.9 | 82.2 | 27.2 | 70.6 | 29.1
a2 | 142 | a2_middle_mcp_down | middle | mcp | down | 45.0 | 2.0 | 80 | 95.4 | 86.0 | 31.6 | 70.7 | 33.7
a2 | 143 | a2_middle_mcp_down | middle | mcp | down | 41.0 | 2.0 | 80 | 100.0 | 90.3 | 36.4 | 70.7 | 38.4
a2 | 144 | a2_middle_mcp_down | middle | mcp | down | 37.0 | 2.0 | 80 | 104.7 | 94.9 | 41.2 | 70.7 | 43.2
a2 | 145 | a2_middle_mcp_down | middle | mcp | down | 33.0 | 2.0 | 80 | 109.7 | 99.5 | 46.1 | 70.7 | 48.2
a2 | 146 | a2_middle_mcp_down | middle | mcp | down | 29.0 | 2.0 | 80 | 114.7 | 104.3 | 51.2 | 70.7 | 53.1
a2 | 147 | a2_middle_mcp_down | middle | mcp | down | 25.0 | 2.0 | 80 | 119.7 | 109.3 | 56.4 | 70.7 | 57.8
a2 | 148 | a2_middle_mcp_down | middle | mcp | down | 21.0 | 2.0 | 80 | 119.7 | 114.3 | 61.5 | 70.7 | 62.6
a2 | 149 | a2_middle_mcp_down | middle | mcp | down | 17.0 | 2.0 | 80 | 119.7 | 118.2 | 63.7 | 70.8 | 65.9
a2 | 150 | a2_middle_mcp_down | middle | mcp | down | 13.0 | 2.0 | 80 | 119.7 | 118.2 | 66.0 | 70.8 | 68.0
a2 | 151 | a2_middle_mcp_down | middle | mcp | down | 9.0 | 2.0 | 80 | 119.7 | 118.2 | 68.4 | 70.8 | 70.1
a2 | 152 | a2_middle_mcp_down | middle | mcp | down | 5.0 | 2.0 | 80 | 119.7 | 118.2 | 71.5 | 70.8 | 72.2
a2 | 153 | a2_middle_mcp_park | middle | mcp | park | 0.0 | 1.0 | 80 | 119.7 | 118.3 | 71.5 | 70.8 | 74.5
a2 | 154 | a2_middle_pip_start | middle | pip | start | 5.0 | 1.0 | 80 | 119.7 | 118.3 | 71.5 | 70.9 | 76.0
a2 | 155 | a2_middle_pip_up | middle | pip | up | 5.0 | 2.0 | 80 | 119.7 | 118.3 | 71.5 | 70.9 | 76.0
a2 | 156 | a2_middle_pip_up | middle | pip | up | 9.0 | 2.0 | 80 | 119.7 | 118.3 | 71.5 | 70.9 | 76.0
a2 | 157 | a2_middle_pip_up | middle | pip | up | 13.0 | 2.0 | 80 | 119.7 | 118.3 | 71.5 | 70.9 | 76.0
a2 | 158 | a2_middle_pip_up | middle | pip | up | 17.0 | 2.0 | 80 | 119.7 | 118.3 | 71.5 | 70.9 | 76.0
a2 | 159 | a2_middle_pip_up | middle | pip | up | 21.0 | 2.0 | 80 | 119.7 | 118.3 | 71.5 | 70.9 | 76.0
a2 | 160 | a2_middle_pip_up | middle | pip | up | 25.0 | 2.0 | 80 | 119.7 | 118.3 | 71.5 | 70.9 | 76.0
a2 | 161 | a2_middle_pip_up | middle | pip | up | 29.0 | 2.0 | 80 | 119.7 | 118.3 | 71.5 | 70.9 | 73.5
a2 | 162 | a2_middle_pip_up | middle | pip | up | 33.0 | 2.0 | 80 | 119.7 | 118.3 | 71.5 | 70.9 | 70.7
a2 | 163 | a2_middle_pip_up | middle | pip | up | 37.0 | 2.0 | 80 | 119.7 | 118.3 | 66.2 | 70.9 | 67.9
a2 | 164 | a2_middle_pip_up | middle | pip | up | 41.0 | 2.0 | 80 | 119.7 | 116.7 | 63.3 | 70.9 | 65.1
a2 | 165 | a2_middle_pip_up | middle | pip | up | 45.0 | 2.0 | 80 | 118.5 | 113.9 | 60.5 | 70.9 | 62.4
a2 | 166 | a2_middle_pip_up | middle | pip | up | 49.0 | 2.0 | 80 | 115.7 | 111.2 | 57.6 | 70.9 | 59.7
a2 | 167 | a2_middle_pip_up | middle | pip | up | 53.0 | 2.0 | 80 | 113.0 | 108.6 | 54.8 | 70.9 | 56.8
a2 | 168 | a2_middle_pip_up | middle | pip | up | 57.0 | 2.0 | 80 | 110.6 | 106.3 | 52.2 | 70.9 | 54.1
a2 | 169 | a2_middle_pip_up | middle | pip | up | 61.0 | 2.0 | 80 | 108.3 | 104.1 | 49.7 | 70.9 | 51.6
a2 | 170 | a2_middle_pip_down | middle | pip | down | 61.0 | 2.0 | 80 | 108.3 | 104.1 | 49.7 | 70.9 | 51.6
a2 | 171 | a2_middle_pip_down | middle | pip | down | 57.0 | 2.0 | 80 | 110.6 | 103.9 | 49.5 | 70.9 | 51.3
a2 | 172 | a2_middle_pip_down | middle | pip | down | 53.0 | 2.0 | 80 | 113.0 | 106.0 | 51.9 | 70.9 | 53.8
a2 | 173 | a2_middle_pip_down | middle | pip | down | 49.0 | 2.0 | 80 | 115.7 | 108.3 | 54.5 | 70.9 | 56.5
a2 | 174 | a2_middle_pip_down | middle | pip | down | 45.0 | 2.0 | 80 | 118.5 | 110.8 | 57.3 | 70.9 | 59.3
a2 | 175 | a2_middle_pip_down | middle | pip | down | 41.0 | 2.0 | 80 | 119.7 | 113.5 | 60.2 | 70.9 | 62.1
a2 | 176 | a2_middle_pip_down | middle | pip | down | 37.0 | 2.0 | 80 | 119.7 | 116.3 | 63.0 | 70.9 | 64.8
a2 | 177 | a2_middle_pip_down | middle | pip | down | 33.0 | 2.0 | 80 | 119.7 | 118.3 | 65.9 | 70.9 | 67.6
a2 | 178 | a2_middle_pip_down | middle | pip | down | 29.0 | 2.0 | 80 | 119.7 | 118.3 | 71.5 | 70.9 | 70.3
a2 | 179 | a2_middle_pip_down | middle | pip | down | 25.0 | 2.0 | 80 | 119.7 | 118.3 | 71.5 | 70.9 | 73.1
a2 | 180 | a2_middle_pip_down | middle | pip | down | 21.0 | 2.0 | 80 | 119.7 | 118.3 | 71.5 | 70.9 | 76.0
a2 | 181 | a2_middle_pip_down | middle | pip | down | 17.0 | 2.0 | 80 | 119.7 | 118.3 | 71.5 | 70.9 | 76.0
a2 | 182 | a2_middle_pip_down | middle | pip | down | 13.0 | 2.0 | 80 | 119.7 | 118.3 | 71.5 | 70.9 | 76.0
a2 | 183 | a2_middle_pip_down | middle | pip | down | 9.0 | 2.0 | 80 | 119.7 | 118.3 | 71.5 | 70.9 | 76.0
a2 | 184 | a2_middle_pip_down | middle | pip | down | 5.0 | 2.0 | 80 | 119.7 | 118.3 | 71.5 | 70.9 | 76.0
a2 | 185 | a2_middle_pip_park | middle | pip | park | 0.0 | 1.0 | 80 | 119.7 | 118.3 | 71.5 | 70.9 | 76.0
b2 | 0 | b2_thumb_yaw_start | thumb | yaw | start | -36.0 | 1.0 | 80 | 119.7 | 118.3 | 71.5 | 70.9 | 75.0
b2 | 1 | b2_thumb_yaw_up | thumb | yaw | up | -36.0 | 2.0 | 80 | 119.7 | 118.3 | 71.6 | 70.9 | 75.0
b2 | 2 | b2_thumb_yaw_up | thumb | yaw | up | -32.0 | 2.0 | 80 | 119.7 | 118.3 | 71.6 | 70.9 | 75.0
b2 | 3 | b2_thumb_yaw_up | thumb | yaw | up | -28.0 | 2.0 | 80 | 119.7 | 118.3 | 71.6 | 70.9 | 75.0
b2 | 4 | b2_thumb_yaw_up | thumb | yaw | up | -24.0 | 2.0 | 80 | 119.7 | 118.3 | 71.5 | 70.9 | 75.0
b2 | 5 | b2_thumb_yaw_up | thumb | yaw | up | -20.0 | 2.0 | 80 | 119.7 | 118.3 | 71.5 | 70.9 | 75.0
b2 | 6 | b2_thumb_yaw_up | thumb | yaw | up | -16.0 | 2.0 | 80 | 119.7 | 118.3 | 71.5 | 70.9 | 75.0
b2 | 7 | b2_thumb_yaw_up | thumb | yaw | up | -12.0 | 2.0 | 80 | 119.7 | 118.3 | 71.5 | 70.9 | 75.0
b2 | 8 | b2_thumb_yaw_up | thumb | yaw | up | -8.0 | 2.0 | 80 | 119.7 | 118.3 | 71.5 | 70.9 | 75.0
b2 | 9 | b2_thumb_yaw_up | thumb | yaw | up | -4.0 | 2.0 | 80 | 119.7 | 118.3 | 71.5 | 70.9 | 75.2
b2 | 10 | b2_thumb_yaw_up | thumb | yaw | up | 0.0 | 2.0 | 80 | 119.7 | 118.3 | 71.5 | 70.9 | 75.4
b2 | 11 | b2_thumb_yaw_up | thumb | yaw | up | 4.0 | 2.0 | 80 | 119.7 | 118.3 | 71.4 | 70.9 | 75.7
b2 | 12 | b2_thumb_yaw_up | thumb | yaw | up | 8.0 | 2.0 | 80 | 119.7 | 118.3 | 71.4 | 70.9 | 76.1
b2 | 13 | b2_thumb_yaw_up | thumb | yaw | up | 12.0 | 2.0 | 80 | 119.7 | 118.3 | 71.4 | 70.9 | 76.6
b2 | 14 | b2_thumb_yaw_up | thumb | yaw | up | 16.0 | 2.0 | 80 | 119.7 | 118.3 | 71.4 | 70.9 | 77.2
b2 | 15 | b2_thumb_yaw_up | thumb | yaw | up | 20.0 | 2.0 | 80 | 119.7 | 118.3 | 71.4 | 70.9 | 77.7
b2 | 16 | b2_thumb_yaw_up | thumb | yaw | up | 24.0 | 2.0 | 80 | 119.7 | 118.3 | 71.4 | 70.9 | 77.7
b2 | 17 | b2_thumb_yaw_up | thumb | yaw | up | 28.0 | 2.0 | 80 | 119.7 | 118.3 | 71.4 | 70.9 | 77.7
b2 | 18 | b2_thumb_yaw_up | thumb | yaw | up | 32.0 | 2.0 | 80 | 119.7 | 118.3 | 71.4 | 70.9 | 77.6
b2 | 19 | b2_thumb_yaw_up | thumb | yaw | up | 36.0 | 2.0 | 80 | 119.7 | 118.3 | 71.4 | 70.9 | 77.6
b2 | 20 | b2_thumb_yaw_down | thumb | yaw | down | 36.0 | 2.0 | 80 | 119.7 | 118.3 | 71.5 | 70.9 | 77.6
b2 | 21 | b2_thumb_yaw_down | thumb | yaw | down | 32.0 | 2.0 | 80 | 119.7 | 118.3 | 71.5 | 70.9 | 77.6
b2 | 22 | b2_thumb_yaw_down | thumb | yaw | down | 28.0 | 2.0 | 80 | 119.7 | 118.3 | 71.4 | 70.9 | 77.6
b2 | 23 | b2_thumb_yaw_down | thumb | yaw | down | 24.0 | 2.0 | 80 | 119.7 | 118.3 | 71.4 | 70.9 | 77.7
b2 | 24 | b2_thumb_yaw_down | thumb | yaw | down | 20.0 | 2.0 | 80 | 119.7 | 118.3 | 71.4 | 70.9 | 77.7
b2 | 25 | b2_thumb_yaw_down | thumb | yaw | down | 16.0 | 2.0 | 80 | 119.7 | 118.3 | 71.4 | 70.9 | 77.7
b2 | 26 | b2_thumb_yaw_down | thumb | yaw | down | 12.0 | 2.0 | 80 | 119.7 | 118.3 | 71.4 | 70.9 | 77.7
b2 | 27 | b2_thumb_yaw_down | thumb | yaw | down | 8.0 | 2.0 | 80 | 119.7 | 118.3 | 71.4 | 70.9 | 77.0
b2 | 28 | b2_thumb_yaw_down | thumb | yaw | down | 4.0 | 2.0 | 80 | 119.7 | 118.3 | 71.4 | 70.9 | 76.5
b2 | 29 | b2_thumb_yaw_down | thumb | yaw | down | 0.0 | 2.0 | 80 | 119.7 | 118.3 | 71.4 | 70.9 | 76.0
b2 | 30 | b2_thumb_yaw_down | thumb | yaw | down | -4.0 | 2.0 | 80 | 119.7 | 118.3 | 71.4 | 70.9 | 75.6
b2 | 31 | b2_thumb_yaw_down | thumb | yaw | down | -8.0 | 2.0 | 80 | 119.7 | 118.3 | 71.5 | 70.9 | 75.3
b2 | 32 | b2_thumb_yaw_down | thumb | yaw | down | -12.0 | 2.0 | 80 | 119.7 | 118.3 | 71.5 | 70.9 | 75.1
b2 | 33 | b2_thumb_yaw_down | thumb | yaw | down | -16.0 | 2.0 | 80 | 119.7 | 118.3 | 71.5 | 70.9 | 75.0
b2 | 34 | b2_thumb_yaw_down | thumb | yaw | down | -20.0 | 2.0 | 80 | 119.7 | 118.3 | 71.5 | 70.9 | 75.0
b2 | 35 | b2_thumb_yaw_down | thumb | yaw | down | -24.0 | 2.0 | 80 | 119.7 | 118.3 | 71.5 | 70.9 | 75.0
b2 | 36 | b2_thumb_yaw_down | thumb | yaw | down | -28.0 | 2.0 | 80 | 119.7 | 118.3 | 71.5 | 70.9 | 75.0
b2 | 37 | b2_thumb_yaw_down | thumb | yaw | down | -32.0 | 2.0 | 80 | 119.7 | 118.3 | 71.5 | 70.9 | 75.0
b2 | 38 | b2_thumb_yaw_down | thumb | yaw | down | -36.0 | 2.0 | 80 | 119.7 | 118.3 | 71.6 | 70.9 | 75.0
b2 | 39 | b2_thumb_yaw_park | thumb | yaw | park | 0.0 | 1.0 | 80 | 119.7 | 118.3 | 71.5 | 70.9 | 75.0
b2 | 40 | b2_index_yaw_start | index | yaw | start | -36.0 | 1.0 | 80 | 86.1 | 78.6 | 49.3 | 31.5 | 76.0
b2 | 41 | b2_index_yaw_up | index | yaw | up | -36.0 | 2.0 | 80 | 86.1 | 78.6 | 49.3 | 31.5 | 76.0
b2 | 42 | b2_index_yaw_up | index | yaw | up | -32.0 | 2.0 | 80 | 92.0 | 74.8 | 45.6 | 27.4 | 76.0
b2 | 43 | b2_index_yaw_up | index | yaw | up | -28.0 | 2.0 | 80 | 98.2 | 80.0 | 50.6 | 33.0 | 76.0
b2 | 44 | b2_index_yaw_up | index | yaw | up | -24.0 | 2.0 | 80 | 104.0 | 85.7 | 56.0 | 39.2 | 76.0
b2 | 45 | b2_index_yaw_up | index | yaw | up | -20.0 | 2.0 | 80 | 107.7 | 91.8 | 59.4 | 45.8 | 76.0
b2 | 46 | b2_index_yaw_up | index | yaw | up | -16.0 | 2.0 | 80 | 111.8 | 98.3 | 62.0 | 51.7 | 76.0
b2 | 47 | b2_index_yaw_up | index | yaw | up | -12.0 | 2.0 | 80 | 116.0 | 102.7 | 65.0 | 55.2 | 76.0
b2 | 48 | b2_index_yaw_up | index | yaw | up | -8.0 | 2.0 | 80 | 117.6 | 106.5 | 68.4 | 59.0 | 76.0
b2 | 49 | b2_index_yaw_up | index | yaw | up | -4.0 | 2.0 | 80 | 119.3 | 110.5 | 71.5 | 63.0 | 76.0
b2 | 50 | b2_index_yaw_up | index | yaw | up | 0.0 | 2.0 | 80 | 119.7 | 114.8 | 71.5 | 67.3 | 76.0
b2 | 51 | b2_index_yaw_up | index | yaw | up | 4.0 | 2.0 | 80 | 119.7 | 117.0 | 71.5 | 69.6 | 76.0
b2 | 52 | b2_index_yaw_up | index | yaw | up | 8.0 | 2.0 | 80 | 119.7 | 118.7 | 71.5 | 71.3 | 76.0
b2 | 53 | b2_index_yaw_up | index | yaw | up | 12.0 | 2.0 | 80 | 119.7 | 119.7 | 71.5 | 72.5 | 76.0
b2 | 54 | b2_index_yaw_up | index | yaw | up | 16.0 | 2.0 | 80 | 119.7 | 119.7 | 71.5 | 72.5 | 76.0
b2 | 55 | b2_index_yaw_up | index | yaw | up | 20.0 | 2.0 | 80 | 119.7 | 119.7 | 71.5 | 72.5 | 76.0
b2 | 56 | b2_index_yaw_up | index | yaw | up | 24.0 | 2.0 | 80 | 119.7 | 119.7 | 71.5 | 72.5 | 76.0
b2 | 57 | b2_index_yaw_up | index | yaw | up | 28.0 | 2.0 | 80 | 119.7 | 119.7 | 71.5 | 72.5 | 76.0
b2 | 58 | b2_index_yaw_up | index | yaw | up | 32.0 | 2.0 | 80 | 119.7 | 119.7 | 71.5 | 72.5 | 76.0
b2 | 59 | b2_index_yaw_up | index | yaw | up | 36.0 | 2.0 | 80 | 119.7 | 119.7 | 71.5 | 72.5 | 76.0
b2 | 60 | b2_index_yaw_down | index | yaw | down | 36.0 | 2.0 | 80 | 119.7 | 119.7 | 71.5 | 72.5 | 76.0
b2 | 61 | b2_index_yaw_down | index | yaw | down | 32.0 | 2.0 | 80 | 119.7 | 119.7 | 71.5 | 72.5 | 76.0
b2 | 62 | b2_index_yaw_down | index | yaw | down | 28.0 | 2.0 | 80 | 119.7 | 119.7 | 71.5 | 72.5 | 76.0
b2 | 63 | b2_index_yaw_down | index | yaw | down | 24.0 | 2.0 | 80 | 119.7 | 119.7 | 71.5 | 72.5 | 76.0
b2 | 64 | b2_index_yaw_down | index | yaw | down | 20.0 | 2.0 | 80 | 119.7 | 119.7 | 71.5 | 72.5 | 76.0
b2 | 65 | b2_index_yaw_down | index | yaw | down | 16.0 | 2.0 | 80 | 119.7 | 119.7 | 71.5 | 72.5 | 76.0
b2 | 66 | b2_index_yaw_down | index | yaw | down | 12.0 | 2.0 | 80 | 119.7 | 119.7 | 71.5 | 72.5 | 76.0
b2 | 67 | b2_index_yaw_down | index | yaw | down | 8.0 | 2.0 | 80 | 119.7 | 119.7 | 71.5 | 72.5 | 76.0
b2 | 68 | b2_index_yaw_down | index | yaw | down | 4.0 | 2.0 | 80 | 119.7 | 119.7 | 71.5 | 72.5 | 76.0
b2 | 69 | b2_index_yaw_down | index | yaw | down | 0.0 | 2.0 | 80 | 119.7 | 118.3 | 71.5 | 70.9 | 76.0
b2 | 70 | b2_index_yaw_down | index | yaw | down | -4.0 | 2.0 | 80 | 119.3 | 116.6 | 71.5 | 69.3 | 76.0
b2 | 71 | b2_index_yaw_down | index | yaw | down | -8.0 | 2.0 | 80 | 117.6 | 113.7 | 71.5 | 66.2 | 76.0
b2 | 72 | b2_index_yaw_down | index | yaw | down | -12.0 | 2.0 | 80 | 116.0 | 109.5 | 71.1 | 62.0 | 76.0
b2 | 73 | b2_index_yaw_down | index | yaw | down | -16.0 | 2.0 | 80 | 111.8 | 105.5 | 67.5 | 58.1 | 76.0
b2 | 74 | b2_index_yaw_down | index | yaw | down | -20.0 | 2.0 | 80 | 107.7 | 101.8 | 64.2 | 54.3 | 76.0
b2 | 75 | b2_index_yaw_down | index | yaw | down | -24.0 | 2.0 | 80 | 104.0 | 96.6 | 61.3 | 50.9 | 76.0
b2 | 76 | b2_index_yaw_down | index | yaw | down | -28.0 | 2.0 | 80 | 98.2 | 90.3 | 58.8 | 44.1 | 76.0
b2 | 77 | b2_index_yaw_down | index | yaw | down | -32.0 | 2.0 | 80 | 92.0 | 84.2 | 54.6 | 37.6 | 76.0
b2 | 78 | b2_index_yaw_down | index | yaw | down | -36.0 | 2.0 | 80 | 86.1 | 78.6 | 49.3 | 31.5 | 76.0
b2 | 79 | b2_index_yaw_park | index | yaw | park | 0.0 | 1.0 | 80 | 119.7 | 82.8 | 53.2 | 36.0 | 76.0
b2 | 80 | b2_middle_yaw_start | middle | yaw | start | -36.0 | 1.0 | 80 | 119.7 | 119.7 | 71.4 | 72.3 | 76.4
b2 | 81 | b2_middle_yaw_up | middle | yaw | up | -36.0 | 2.0 | 80 | 119.7 | 119.7 | 71.5 | 72.5 | 77.6
b2 | 82 | b2_middle_yaw_up | middle | yaw | up | -32.0 | 2.0 | 80 | 119.7 | 119.7 | 71.5 | 72.5 | 77.6
b2 | 83 | b2_middle_yaw_up | middle | yaw | up | -28.0 | 2.0 | 80 | 119.7 | 119.7 | 71.4 | 72.5 | 77.6
b2 | 84 | b2_middle_yaw_up | middle | yaw | up | -24.0 | 2.0 | 80 | 119.7 | 119.7 | 71.4 | 72.5 | 77.7
b2 | 85 | b2_middle_yaw_up | middle | yaw | up | -20.0 | 2.0 | 80 | 119.7 | 119.7 | 71.4 | 72.5 | 77.7
b2 | 86 | b2_middle_yaw_up | middle | yaw | up | -16.0 | 2.0 | 80 | 119.7 | 119.7 | 71.4 | 72.5 | 77.7
b2 | 87 | b2_middle_yaw_up | middle | yaw | up | -12.0 | 2.0 | 80 | 119.7 | 119.7 | 71.4 | 72.5 | 77.7
b2 | 88 | b2_middle_yaw_up | middle | yaw | up | -8.0 | 2.0 | 80 | 119.7 | 119.7 | 71.4 | 72.5 | 77.0
b2 | 89 | b2_middle_yaw_up | middle | yaw | up | -4.0 | 2.0 | 80 | 119.7 | 119.7 | 71.4 | 72.5 | 76.5
b2 | 90 | b2_middle_yaw_up | middle | yaw | up | 0.0 | 2.0 | 80 | 119.7 | 118.3 | 71.4 | 70.9 | 76.0
b2 | 91 | b2_middle_yaw_up | middle | yaw | up | 4.0 | 2.0 | 80 | 119.2 | 116.2 | 71.4 | 68.8 | 75.6
b2 | 92 | b2_middle_yaw_up | middle | yaw | up | 8.0 | 2.0 | 80 | 117.1 | 113.8 | 71.5 | 66.3 | 75.3
b2 | 93 | b2_middle_yaw_up | middle | yaw | up | 12.0 | 2.0 | 80 | 114.7 | 109.7 | 71.5 | 62.3 | 75.1
b2 | 94 | b2_middle_yaw_up | middle | yaw | up | 16.0 | 2.0 | 80 | 110.2 | 104.2 | 68.5 | 58.4 | 75.0
b2 | 95 | b2_middle_yaw_up | middle | yaw | up | 20.0 | 2.0 | 80 | 105.9 | 97.6 | 65.2 | 51.7 | 75.0
b2 | 96 | b2_middle_yaw_up | middle | yaw | up | 24.0 | 2.0 | 80 | 99.3 | 91.0 | 60.1 | 45.0 | 75.0
b2 | 97 | b2_middle_yaw_up | middle | yaw | up | 28.0 | 2.0 | 80 | 92.8 | 84.7 | 55.0 | 38.5 | 75.0
b2 | 98 | b2_middle_yaw_up | middle | yaw | up | 32.0 | 2.0 | 80 | 86.6 | 78.7 | 50.3 | 31.9 | 75.0
b2 | 99 | b2_middle_yaw_up | middle | yaw | up | 36.0 | 2.0 | 80 | 80.8 | 73.1 | 46.2 | 25.8 | 75.0
b2 | 100 | b2_middle_yaw_down | middle | yaw | down | 36.0 | 2.0 | 80 | 80.8 | 73.1 | 46.2 | 25.8 | 75.0
b2 | 101 | b2_middle_yaw_down | middle | yaw | down | 32.0 | 2.0 | 80 | 86.6 | 69.2 | 43.8 | 21.8 | 75.0
b2 | 102 | b2_middle_yaw_down | middle | yaw | down | 28.0 | 2.0 | 80 | 92.8 | 74.4 | 47.2 | 27.3 | 75.0
b2 | 103 | b2_middle_yaw_down | middle | yaw | down | 24.0 | 2.0 | 80 | 99.3 | 80.1 | 51.4 | 33.5 | 75.0
b2 | 104 | b2_middle_yaw_down | middle | yaw | down | 20.0 | 2.0 | 80 | 105.9 | 86.2 | 56.2 | 40.1 | 75.0
b2 | 105 | b2_middle_yaw_down | middle | yaw | down | 16.0 | 2.0 | 80 | 110.2 | 92.7 | 61.4 | 46.7 | 75.0
b2 | 106 | b2_middle_yaw_down | middle | yaw | down | 12.0 | 2.0 | 80 | 114.7 | 99.2 | 66.0 | 53.4 | 75.0
b2 | 107 | b2_middle_yaw_down | middle | yaw | down | 8.0 | 2.0 | 80 | 117.1 | 105.9 | 69.3 | 59.3 | 75.0
b2 | 108 | b2_middle_yaw_down | middle | yaw | down | 4.0 | 2.0 | 80 | 119.2 | 110.7 | 71.5 | 63.3 | 75.2
b2 | 109 | b2_middle_yaw_down | middle | yaw | down | 0.0 | 2.0 | 80 | 119.7 | 114.8 | 71.5 | 67.3 | 75.4
b2 | 110 | b2_middle_yaw_down | middle | yaw | down | -4.0 | 2.0 | 80 | 119.7 | 116.8 | 71.4 | 69.3 | 75.7
b2 | 111 | b2_middle_yaw_down | middle | yaw | down | -8.0 | 2.0 | 80 | 119.7 | 118.8 | 71.4 | 71.4 | 76.1
b2 | 112 | b2_middle_yaw_down | middle | yaw | down | -12.0 | 2.0 | 80 | 119.7 | 119.7 | 71.4 | 72.5 | 76.6
b2 | 113 | b2_middle_yaw_down | middle | yaw | down | -16.0 | 2.0 | 80 | 119.7 | 119.7 | 71.4 | 72.5 | 77.2
b2 | 114 | b2_middle_yaw_down | middle | yaw | down | -20.0 | 2.0 | 80 | 119.7 | 119.7 | 71.4 | 72.5 | 77.7
b2 | 115 | b2_middle_yaw_down | middle | yaw | down | -24.0 | 2.0 | 80 | 119.7 | 119.7 | 71.4 | 72.5 | 77.7
b2 | 116 | b2_middle_yaw_down | middle | yaw | down | -28.0 | 2.0 | 80 | 119.7 | 119.7 | 71.4 | 72.5 | 77.7
b2 | 117 | b2_middle_yaw_down | middle | yaw | down | -32.0 | 2.0 | 80 | 119.7 | 119.7 | 71.4 | 72.5 | 77.6
b2 | 118 | b2_middle_yaw_down | middle | yaw | down | -36.0 | 2.0 | 80 | 119.7 | 119.7 | 71.4 | 72.5 | 77.6
b2 | 119 | b2_middle_yaw_park | middle | yaw | park | 0.0 | 1.0 | 80 | 119.7 | 118.3 | 71.4 | 70.9 | 76.0
c | 0 | c_thumb_yaw_out | thumb | yaw | out | 20.0 | 10.0 | 80 | 119.7 | 118.3 | 71.4 | 70.9 | 76.4
c | 1 | c_thumb_yaw_in | thumb | yaw | in | 0.0 | 10.0 | 80 | 119.7 | 118.3 | 71.4 | 70.9 | 76.0
c | 2 | c_thumb_yaw_out | thumb | yaw | out | -20.0 | 10.0 | 80 | 119.7 | 118.3 | 71.5 | 70.9 | 75.0
c | 3 | c_thumb_yaw_in | thumb | yaw | in | 0.0 | 10.0 | 80 | 119.7 | 118.3 | 71.5 | 70.9 | 75.0
c | 4 | c_thumb_yaw_out | thumb | yaw | out | 30.0 | 10.0 | 80 | 119.7 | 118.3 | 71.4 | 70.9 | 76.4
c | 5 | c_thumb_yaw_in | thumb | yaw | in | 0.0 | 10.0 | 80 | 119.7 | 118.3 | 71.4 | 70.9 | 76.0
c | 6 | c_thumb_yaw_out | thumb | yaw | out | -30.0 | 10.0 | 80 | 119.7 | 118.3 | 71.5 | 70.9 | 75.0
c | 7 | c_thumb_yaw_in | thumb | yaw | in | 0.0 | 10.0 | 80 | 119.7 | 118.3 | 71.5 | 70.9 | 75.0
c | 8 | c_thumb_yaw_out | thumb | yaw | out | 40.0 | 10.0 | 80 | 119.7 | 118.3 | 71.4 | 70.9 | 77.6
c | 9 | c_thumb_yaw_in | thumb | yaw | in | 0.0 | 10.0 | 80 | 119.7 | 118.3 | 71.4 | 70.9 | 76.0
c | 10 | c_thumb_yaw_out | thumb | yaw | out | -40.0 | 10.0 | 80 | 119.7 | 118.3 | 71.5 | 70.9 | 75.0
c | 11 | c_thumb_yaw_in | thumb | yaw | in | 0.0 | 10.0 | 80 | 119.7 | 118.3 | 71.5 | 70.9 | 75.0
c | 12 | c_index_yaw_out | index | yaw | out | 20.0 | 10.0 | 80 | 119.7 | 119.7 | 71.5 | 72.2 | 76.0
c | 13 | c_index_yaw_in | index | yaw | in | 0.0 | 10.0 | 80 | 119.7 | 118.3 | 71.5 | 70.9 | 76.0
c | 14 | c_index_yaw_out | index | yaw | out | -20.0 | 10.0 | 80 | 107.7 | 101.8 | 64.2 | 54.3 | 76.0
c | 15 | c_index_yaw_in | index | yaw | in | 0.0 | 10.0 | 80 | 119.7 | 104.5 | 66.6 | 57.1 | 76.0
c | 16 | c_index_yaw_out | index | yaw | out | 30.0 | 10.0 | 80 | 119.7 | 119.7 | 71.5 | 72.2 | 76.0
c | 17 | c_index_yaw_in | index | yaw | in | 0.0 | 10.0 | 80 | 119.7 | 118.3 | 71.5 | 70.9 | 76.0
c | 18 | c_index_yaw_out | index | yaw | out | -30.0 | 10.0 | 80 | 95.1 | 87.2 | 57.4 | 40.8 | 76.0
c | 19 | c_index_yaw_in | index | yaw | in | 0.0 | 10.0 | 80 | 119.7 | 91.8 | 59.4 | 45.8 | 76.0
c | 20 | c_index_yaw_out | index | yaw | out | 40.0 | 10.0 | 80 | 119.7 | 119.7 | 71.5 | 72.2 | 76.0
c | 21 | c_index_yaw_in | index | yaw | in | 0.0 | 10.0 | 80 | 119.7 | 118.3 | 71.5 | 70.9 | 76.0
c | 22 | c_index_yaw_out | index | yaw | out | -40.0 | 10.0 | 80 | 80.7 | 73.6 | 44.4 | 26.1 | 76.0
c | 23 | c_index_yaw_in | index | yaw | in | 0.0 | 10.0 | 80 | 119.7 | 77.3 | 48.0 | 30.1 | 76.0
c | 24 | c_middle_yaw_out | middle | yaw | out | 20.0 | 10.0 | 80 | 105.9 | 97.6 | 65.2 | 51.7 | 75.0
c | 25 | c_middle_yaw_in | middle | yaw | in | 0.0 | 10.0 | 80 | 119.7 | 102.5 | 67.6 | 56.8 | 75.0
c | 26 | c_middle_yaw_out | middle | yaw | out | -20.0 | 10.0 | 80 | 119.7 | 119.7 | 71.4 | 72.3 | 76.4
c | 27 | c_middle_yaw_in | middle | yaw | in | 0.0 | 10.0 | 80 | 119.7 | 118.3 | 71.4 | 70.9 | 76.0
c | 28 | c_middle_yaw_out | middle | yaw | out | 30.0 | 10.0 | 80 | 89.7 | 81.6 | 52.6 | 35.2 | 75.0
c | 29 | c_middle_yaw_in | middle | yaw | in | 0.0 | 10.0 | 80 | 119.7 | 86.2 | 56.2 | 40.1 | 75.0
c | 30 | c_middle_yaw_out | middle | yaw | out | -30.0 | 10.0 | 80 | 119.7 | 119.7 | 71.4 | 72.3 | 76.4
c | 31 | c_middle_yaw_in | middle | yaw | in | 0.0 | 10.0 | 80 | 119.7 | 118.3 | 71.4 | 70.9 | 76.0
c | 32 | c_middle_yaw_out | middle | yaw | out | 40.0 | 10.0 | 80 | 75.3 | 68.0 | 43.1 | 20.5 | 75.0
c | 33 | c_middle_yaw_in | middle | yaw | in | 0.0 | 10.0 | 80 | 119.7 | 71.7 | 45.4 | 24.4 | 75.0
c | 34 | c_middle_yaw_out | middle | yaw | out | -40.0 | 10.0 | 80 | 119.7 | 119.7 | 71.4 | 72.3 | 77.6
c | 35 | c_middle_yaw_in | middle | yaw | in | 0.0 | 10.0 | 80 | 119.7 | 118.3 | 71.4 | 70.9 | 76.0
c40 | 0 | c40_thumb_mcp_on | thumb | mcp | on | 40.0 | 3.0 | 80 | 101.2 | 96.6 | 43.0 | 70.9 | 45.1
c40 | 1 | c40_thumb_yaw_out | thumb | yaw | out | 20.0 | 10.0 | 80 | 106.9 | 97.3 | 42.1 | 70.9 | 45.8
c40 | 2 | c40_thumb_yaw_in | thumb | yaw | in | 0.0 | 10.0 | 80 | 101.2 | 96.6 | 42.5 | 70.9 | 45.1
c40 | 3 | c40_thumb_yaw_out | thumb | yaw | out | -20.0 | 10.0 | 80 | 98.2 | 94.2 | 43.3 | 70.9 | 40.4
c40 | 4 | c40_thumb_yaw_in | thumb | yaw | in | 0.0 | 10.0 | 80 | 101.2 | 94.3 | 43.0 | 70.9 | 40.9
c40 | 5 | c40_thumb_yaw_out | thumb | yaw | out | 30.0 | 10.0 | 80 | 111.1 | 97.3 | 42.1 | 70.9 | 45.8
c40 | 6 | c40_thumb_yaw_in | thumb | yaw | in | 0.0 | 10.0 | 80 | 101.2 | 96.6 | 42.4 | 70.9 | 45.1
c40 | 7 | c40_thumb_yaw_out | thumb | yaw | out | -30.0 | 10.0 | 80 | 97.8 | 94.0 | 43.3 | 70.9 | 40.0
c40 | 8 | c40_thumb_yaw_in | thumb | yaw | in | 0.0 | 10.0 | 80 | 101.2 | 94.1 | 43.0 | 70.9 | 40.2
c40 | 9 | c40_thumb_yaw_out | thumb | yaw | out | 40.0 | 10.0 | 80 | 115.4 | 97.3 | 42.1 | 70.9 | 45.8
c40 | 10 | c40_thumb_yaw_in | thumb | yaw | in | 0.0 | 10.0 | 80 | 101.2 | 96.6 | 42.3 | 70.9 | 45.1
c40 | 11 | c40_thumb_yaw_out | thumb | yaw | out | -40.0 | 10.0 | 80 | 97.9 | 94.0 | 43.3 | 70.9 | 40.0
c40 | 12 | c40_thumb_yaw_in | thumb | yaw | in | 0.0 | 10.0 | 80 | 101.2 | 94.0 | 43.0 | 70.9 | 40.2
c40 | 13 | c40_thumb_mcp_off | thumb | mcp | off | 0.0 | 3.0 | 80 | 119.7 | 98.4 | 44.9 | 70.9 | 47.0
c40 | 14 | c40_index_mcp_on | index | mcp | on | 40.0 | 3.0 | 80 | 119.7 | 118.3 | 71.5 | 70.9 | 76.0
c40 | 15 | c40_index_yaw_out | index | yaw | out | 20.0 | 10.0 | 80 | 119.7 | 119.7 | 71.5 | 72.2 | 76.0
c40 | 16 | c40_index_yaw_in | index | yaw | in | 0.0 | 10.0 | 80 | 119.7 | 118.7 | 71.5 | 71.2 | 76.0
c40 | 17 | c40_index_yaw_out | index | yaw | out | -20.0 | 10.0 | 80 | 109.6 | 101.8 | 59.7 | 54.3 | 76.0
c40 | 18 | c40_index_yaw_in | index | yaw | in | 0.0 | 10.0 | 80 | 119.7 | 108.1 | 63.2 | 60.7 | 76.0
c40 | 19 | c40_index_yaw_out | index | yaw | out | 30.0 | 10.0 | 80 | 119.7 | 119.7 | 71.5 | 72.2 | 76.0
c40 | 20 | c40_index_yaw_in | index | yaw | in | 0.0 | 10.0 | 80 | 119.7 | 118.7 | 71.5 | 71.2 | 76.0
c40 | 21 | c40_index_yaw_out | index | yaw | out | -30.0 | 10.0 | 80 | 103.4 | 87.2 | 45.8 | 40.9 | 76.0
c40 | 22 | c40_index_yaw_in | index | yaw | in | 0.0 | 10.0 | 80 | 119.7 | 101.8 | 50.4 | 54.4 | 76.0
c40 | 23 | c40_index_yaw_out | index | yaw | out | 40.0 | 10.0 | 80 | 119.7 | 119.7 | 71.5 | 72.2 | 76.0
c40 | 24 | c40_index_yaw_in | index | yaw | in | 0.0 | 10.0 | 80 | 119.7 | 118.7 | 71.5 | 71.2 | 76.0
c40 | 25 | c40_index_yaw_out | index | yaw | out | -40.0 | 10.0 | 80 | 97.3 | 73.6 | 34.0 | 26.1 | 76.0
c40 | 26 | c40_index_yaw_in | index | yaw | in | 0.0 | 10.0 | 80 | 119.7 | 93.1 | 38.5 | 49.2 | 76.0
c40 | 27 | c40_index_mcp_off | index | mcp | off | 0.0 | 3.0 | 80 | 119.7 | 118.3 | 71.5 | 70.9 | 76.0
c40 | 28 | c40_middle_mcp_on | middle | mcp | on | 40.0 | 3.0 | 80 | 101.2 | 96.6 | 43.0 | 70.7 | 45.1
c40 | 29 | c40_middle_yaw_out | middle | yaw | out | 20.0 | 10.0 | 80 | 98.2 | 94.2 | 43.3 | 51.7 | 40.4
c40 | 30 | c40_middle_yaw_in | middle | yaw | in | 0.0 | 10.0 | 80 | 101.2 | 94.3 | 43.0 | 60.7 | 40.9
c40 | 31 | c40_middle_yaw_out | middle | yaw | out | -20.0 | 10.0 | 80 | 106.9 | 97.3 | 42.1 | 72.1 | 45.8
c40 | 32 | c40_middle_yaw_in | middle | yaw | in | 0.0 | 10.0 | 80 | 101.2 | 96.6 | 42.5 | 70.8 | 45.1
c40 | 33 | c40_middle_yaw_out | middle | yaw | out | 30.0 | 10.0 | 80 | 97.8 | 81.6 | 43.3 | 35.1 | 40.0
c40 | 34 | c40_middle_yaw_in | middle | yaw | in | 0.0 | 10.0 | 80 | 101.2 | 94.1 | 43.0 | 51.2 | 40.2
c40 | 35 | c40_middle_yaw_out | middle | yaw | out | -30.0 | 10.0 | 80 | 111.1 | 97.3 | 42.1 | 72.1 | 45.8
c40 | 36 | c40_middle_yaw_in | middle | yaw | in | 0.0 | 10.0 | 80 | 101.2 | 96.6 | 42.4 | 70.8 | 45.1
c40 | 37 | c40_middle_yaw_out | middle | yaw | out | 40.0 | 10.0 | 80 | 90.9 | 68.0 | 43.3 | 20.4 | 40.0
c40 | 38 | c40_middle_yaw_in | middle | yaw | in | 0.0 | 10.0 | 80 | 101.2 | 87.3 | 43.0 | 42.8 | 40.2
c40 | 39 | c40_middle_yaw_out | middle | yaw | out | -40.0 | 10.0 | 80 | 116.0 | 97.3 | 42.1 | 72.1 | 45.8
c40 | 40 | c40_middle_yaw_in | middle | yaw | in | 0.0 | 10.0 | 80 | 101.2 | 96.6 | 42.3 | 70.8 | 45.1
c40 | 41 | c40_middle_mcp_off | middle | mcp | off | 0.0 | 3.0 | 80 | 119.7 | 98.4 | 44.9 | 70.7 | 47.0
