badinkajink/hand/docs/experiments/20261022-ur5_tip_calibration/lab/20261029-134508-spherev3id3/printout_stage2_1634.txt

resumed logs/20261029-tip_calibration/134508-spherev3id3: 45 actions done, 18 touches
speed slider 0.30 (the plan's 0.30)
== preflight
preflight: HEX-E 100 Hz (asked 100 Hz, filter 3), board 338 records/s, robot 124 Hz
  HEX-E noise (1 sigma) N, N m: [0.0499 0.0122 0.2245 0.0029 0.0038 0.0011]
  HEX-E reads: 0 timed out, 0 late datagrams dropped (0 and 0 on a clean link)
  payload set: 0.403 kg at [0.0, -0.5, 34.3] mm from the flange
== grid
  ref-00 (1/116): to 2.00 N
  grid-032 (2/116): to 3.00 N
  grid-051 (3/116): to 3.00 N
  grid-034 (4/116): to 3.00 N
  grid-031 (5/116): to 3.00 N
  grid-035 (6/116): to 3.00 N
  grid-036 (7/116): to 3.00 N
  grid-030 (8/116): to 3.00 N
  grid-029 (9/116): to 5.00 N
  grid-009 (10/116): to 5.00 N
  grid-013 (11/116): to 5.00 N
  ref-01 (12/116): to 2.00 N
  grid-012 (13/116): to 5.00 N
  grid-008 (14/116): to 5.00 N
  grid-011 (15/116): to 5.00 N
  grid-006 (16/116): to 5.00 N
  grid-010 (17/116): to 5.00 N
  grid-014 (18/116): to 5.00 N
  grid-015 (19/116): to 5.00 N
  grid-026 (20/116): to 5.00 N
  grid-037 (21/116): to 3.00 N
  grid-005 (22/116): to 5.00 N
  grid-020 (23/116): to 5.00 N
  grid-038 (24/116): to 3.00 N
  grid-000 (25/116): to 5.00 N
  grid-004 (26/116): to 5.00 N
  ref-02 (27/116): to 2.00 N
  grid-016 (28/116): to 5.00 N
  grid-019 (29/116): to 5.00 N
  grid-001 (30/116): to 5.00 N
  grid-018 (31/116): to 5.00 N
  grid-003 (32/116): to 5.00 N
  grid-017 (33/116): to 5.00 N
  grid-040 (34/116): to 3.00 N
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
  slide-twin-041-t+5-1N (35/77): to 1.00 N
  slide-twin-041-t+5-2N (36/77): to 2.00 N
  slide-twin-043-t+15-1N (37/77): to 1.00 N
  slide-twin-043-t+15-2N (38/77): to 2.00 N
  slide-twin-047-t+10-1N (39/77): to 1.00 N
  slide-twin-047-t+10-2N (40/77): to 2.00 N
  slide-twin-051-t-20-2N (41/77): to 2.00 N
  slide-twin-063-t+15-1N (42/77): to 1.00 N
  slide-twin-063-t+15-2N (43/77): to 2.00 N
  slide-twin-064-t+15-1N (44/77): to 1.00 N
  slide-twin-064-t+15-2N (45/77): to 2.00 N
  slide-dense-656-t+15-1N (46/77): to 1.00 N
  slide-dense-596-t+15-1N (47/77): to 1.00 N
  slide-dense-699-t+10-1N (48/77): to 1.00 N
  slide-dense-780-t+10-1N (49/77): to 1.00 N
  slide-dense-804-t+10-1N (50/77): to 1.00 N
  slide-dense-664-t+15-1N (51/77): to 1.00 N
  slide-dense-678-t+15-1N (52/77): to 1.00 N
  slide-dense-748-t+10-1N (53/77): to 1.00 N
  slide-dense-750-t+10-1N (54/77): to 1.00 N
  slide-dense-594-t+15-1N (55/77): to 1.00 N
  slide-dense-527-t+15-1N (56/77): to 1.00 N
  slide-dense-633-t+0-1N (57/77): to 1.00 N
  slide-dense-658-t+15-1N (58/77): to 1.00 N
  slide-dense-782-t+15-1N (59/77): to 1.00 N
  slide-dense-721-t+10-1N (60/77): to 1.00 N
  slide-dense-735-t+10-1N (61/77): to 1.00 N
  slide-dense-665-t+15-1N (62/77): to 1.00 N
  slide-dense-793-t+10-1N (63/77): to 1.00 N
  slide-dense-749-t+10-1N (64/77): to 1.00 N
  slide-dense-751-t+15-1N (65/77): to 1.00 N
  slide-dense-736-t+10-1N (66/77): to 1.00 N
  slide-dense-657-t+15-1N (67/77): to 1.00 N
  slide-dense-781-t+10-1N (68/77): to 1.00 N
  slide-dense-655-t+15-1N (69/77): to 1.00 N
  slide-dense-595-t+15-1N (70/77): to 1.00 N
  hard-shear-3-4N (71/77): to 4.00 N
  hard-slide-twin-008-t+10-4N (72/77): to 4.00 N
  hard-slide-twin-014-t+5-4N (73/77): to 4.00 N
  hard-slide-twin-028-t+10-4N (74/77): to 4.00 N
  hard-slide-twin-024-t+5-4N (75/77): to 4.00 N
  hard-slide-twin-006-t+10-4N (76/77): to 4.00 N
  hard-slide-015-4N (77/77): to 4.00 N
== roll
  roll-0 (1/2): to 1.50 N
  roll-3 (2/2): to 1.50 N
== twist
  twist-0-1.0N (1/12): to 1.00 N
  twist-0-2.5N (2/12): to 2.50 N
  twist-2-1.0N (3/12): to 1.00 N
  twist-2-2.5N (4/12): to 2.50 N
  twist-3-1.0N (5/12): to 1.00 N
  twist-3-2.5N (6/12): to 2.50 N
  twist-0-5.0N (7/12): to 5.00 N
  twist-2-5.0N (8/12): to 5.00 N
  twist-3-5.0N (9/12): to 5.00 N
  twist-3-2.5N-20deg (10/12): to 2.50 N
  twist-3-5.0N-20deg (11/12): to 5.00 N
  hard-twist-3-6N-20deg (12/12): to 6.00 N
== final
  final-ref (1/4): to 2.00 N
  final-ref-p3 (2/4): to 2.00 N
  final-ref-p6 (3/4): to 2.00 N
  hard-final-ref (4/4): to 2.00 N
HEX-E: 2354570 samples, 0 timed out, 0 late datagrams dropped, 1 gaps over 0.5 s; 0.7 s, Fz -0.1 N
session in logs/20261029-tip_calibration/134508-spherev3id3
exit 0 at 23:07:05
