badinkajink/hand/docs/experiments/20261022-ur5_tip_calibration/lab/20261028-200508-tallv3id2/printout_stage2_0358.txt

resumed logs/20261028-tip_calibration/200508-tallv3id2: 21 actions done, 19 touches
speed slider 0.30 (the plan's 0.30)
== preflight
preflight: HEX-E 100 Hz (asked 100 Hz, filter 3), board 340 records/s, robot 124 Hz
  HEX-E noise (1 sigma) N, N m: [0.0387 0.0362 0.222  0.0031 0.0036 0.0011]
  HEX-E reads: 0 timed out, 0 late datagrams dropped (0 and 0 on a clean link)
  payload set: 0.403 kg at [0.0, -0.5, 34.3] mm from the flange
== grid
  tall-ref-a (1/56): to 2.00 N
  tall-shared-728 (2/56): to 5.00 N
  tall-shared-730 (3/56): to 5.00 N
  tall-shared-719 (4/56): to 5.00 N
  tall-shared-581 (5/56): to 3.00 N
  tall-shared-576 (6/56): to 3.00 N
  tall-shared-640 (7/56): to 3.00 N
  tall-flank-482 (8/56): to 2.00 N
  tall-flank-525 (9/56): to 2.00 N
  tall-flank-526 (10/56): to 2.00 N
  tall-flank-543 (11/56): to 2.00 N
  tall-flank-590 (12/56): to 2.00 N
  tall-flank-589 (13/56): to 2.00 N
  tall-flank-591 (14/56): to 2.00 N
  tall-flank-531 (15/56): to 2.00 N
  tall-flank-580 (16/56): to 2.00 N
  tall-flank-532 (17/56): to 2.00 N
  tall-flank-582 (18/56): to 2.00 N
  tall-flank-583 (19/56): to 2.00 N
  tall-flank-585 (20/56): to 2.00 N
  tall-edge-754 (21/56): to 3.00 N
  tall-edge-643 (22/56): to 3.00 N
  tall-edge-644 (23/56): to 3.00 N
  tall-edge-637 (24/56): to 3.00 N
  tall-edge-645 (25/56): to 3.00 N
  tall-face-732 (26/56): to 5.00 N
  tall-edge-647 (27/56): to 3.00 N
  tall-face-738 (28/56): to 5.00 N
  tall-edge-740 (29/56): to 3.00 N
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
  tall-twist-edge-610-2.5N-20deg (4/4): to 2.50 N
== final
  tall-final-ref (1/1): to 2.00 N
HEX-E: 995507 samples, 0 timed out, 0 late datagrams dropped, 2 gaps over 0.5 s; 1.2 s, Fz +0.0 N; 0.7 s, Fz +0.1 N
session in logs/20261028-tip_calibration/200508-tallv3id2
exit 0 at 06:44:53
