badinkajink/hand/docs/experiments/20261022-ur5_tip_calibration/lab/20261027-225213-spherev3id1/printout_resume_2314.txt

resumed logs/20261027-tip_calibration/225213-spherev3id1: 20 actions done, 18 touches
speed slider 0.30 (the plan's 0.30)
== preflight
preflight: HEX-E 100 Hz (asked 100 Hz, filter 3), board 340 records/s, robot 124 Hz
  HEX-E noise (1 sigma) N, N m: [0.0384 0.046  0.229  0.003  0.0041 0.001 ]
  HEX-E reads: 0 timed out, 0 late datagrams dropped (0 and 0 on a clean link)
  payload set: 0.403 kg at [0.0, -0.5, 34.3] mm from the flange
== grid
  ref-00 (1/161): to 2.00 N
  grid-032 (2/161): to 3.00 N
  grid-051 (3/161): to 3.00 N
  grid-034 (4/161): to 3.00 N
  grid-031 (5/161): to 3.00 N
  grid-035 (6/161): to 3.00 N
  grid-036 (7/161): to 3.00 N
  grid-030 (8/161): to 3.00 N
  grid-029 (9/161): to 5.00 N
  grid-009 (10/161): to 5.00 N
  grid-013 (11/161): to 5.00 N
  ref-01 (12/161): to 2.00 N
  grid-012 (13/161): to 5.00 N
  grid-008 (14/161): to 5.00 N
  grid-011 (15/161): to 5.00 N
  grid-006 (16/161): to 5.00 N
  grid-010 (17/161): to 5.00 N
  grid-014 (18/161): to 5.00 N
  grid-015 (19/161): to 5.00 N
  grid-026 (20/161): to 5.00 N
  grid-037 (21/161): to 3.00 N
  grid-005 (22/161): to 5.00 N
  grid-020 (23/161): to 5.00 N
  grid-038 (24/161): to 3.00 N
  grid-000 (25/161): to 5.00 N
  grid-004 (26/161): to 5.00 N
  ref-02 (27/161): to 2.00 N
  grid-016 (28/161): to 5.00 N
  grid-019 (29/161): to 5.00 N
  grid-001 (30/161): to 5.00 N
  grid-018 (31/161): to 5.00 N
  grid-003 (32/161): to 5.00 N
  grid-017 (33/161): to 5.00 N
  grid-040 (34/161): to 3.00 N
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
  dense-736-t+10 (132/161): to 3.50 N
  dense-657-t+15 (133/161): to 3.00 N

interrupted: stopping the robot
HEX-E: 484795 samples, 0 timed out, 0 late datagrams dropped, 1 gaps over 0.5 s; 0.7 s, Fz +0.0 N
session in logs/20261027-tip_calibration/225213-spherev3id1
exit 0 at 00:35:24
