badinkajink/hand/docs/experiments/20261022-ur5_tip_calibration/lab/20261026-192158-v2id1/printout_resume_0047.txt

resumed logs/20261026-tip_calibration/192158-v2id1: 242 actions done, 31 touches
speed slider 0.30 (the plan's 0.30)
== preflight
preflight: HEX-E 100 Hz (asked 100 Hz, filter 3), board 340 records/s, robot 124 Hz
  HEX-E noise (1 sigma) N, N m: [0.0353 0.0325 0.2303 0.0032 0.0036 0.001 ]
  HEX-E reads: 0 timed out, 0 late datagrams dropped (0 and 0 on a clean link)
  payload set: 0.403 kg at [0.0, -0.5, 34.3] mm from the flange
== grid
  dense-795-t+15 (1/32): to 3.50 N
  dense-656-t+15 (2/32): to 3.00 N
  dense-419-t+15 (3/32): to 2.00 N
  dense-596-t+15 (4/32): to 2.00 N
  dense-699-t+10 (5/32): to 3.50 N
  dense-780-t+10 (6/32): to 3.50 N
  dense-804-t+10 (7/32): to 3.50 N
  dense-611-t+5 (8/32): to 3.00 N
  dense-664-t+15 (9/32): to 2.00 N
  dense-542-t+15 (10/32): to 2.00 N
  dense-464-t-5 (11/32): to 2.00 N
  dense-678-t+15 (12/32): to 3.00 N
  dense-748-t+10 (13/32): to 3.00 N
  dense-750-t+10 (14/32): to 3.00 N
  dense-594-t+15 (15/32): to 2.00 N
  dense-527-t+15 (16/32): to 2.00 N
  dense-633-t+0 (17/32): to 3.00 N
  dense-658-t+15 (18/32): to 3.00 N
  dense-782-t+15 (19/32): to 3.50 N
  dense-721-t+10 (20/32): to 3.50 N
  dense-735-t+10 (21/32): to 3.50 N
  dense-665-t+15 (22/32): to 2.00 N
  dense-793-t+10 (23/32): to 3.50 N
  dense-749-t+10 (24/32): to 3.00 N
  dense-597-t+10 (25/32): to 2.00 N
  dense-751-t+15 (26/32): to 3.00 N
  dense-736-t+10 (27/32): to 3.50 N
  dense-657-t+15 (28/32): to 3.00 N
  dense-700-t+10 (29/32): to 3.50 N
  dense-781-t+10 (30/32): to 3.50 N
  dense-655-t+15 (31/32): to 3.00 N
  dense-595-t+15 (32/32): to 2.00 N
== shear
  slide-dense-795-t+15-1N (1/27): to 1.00 N
  slide-dense-656-t+15-1N (2/27): to 1.00 N
  slide-dense-596-t+15-1N (3/27): to 1.00 N
  slide-dense-699-t+10-1N (4/27): to 1.00 N
  slide-dense-780-t+10-1N (5/27): to 1.00 N
  slide-dense-804-t+10-1N (6/27): to 1.00 N
  slide-dense-664-t+15-1N (7/27): to 1.00 N
  slide-dense-678-t+15-1N (8/27): to 1.00 N
  slide-dense-748-t+10-1N (9/27): to 1.00 N
  slide-dense-750-t+10-1N (10/27): to 1.00 N
  slide-dense-594-t+15-1N (11/27): to 1.00 N
  slide-dense-527-t+15-1N (12/27): to 1.00 N
  slide-dense-633-t+0-1N (13/27): to 1.00 N
  slide-dense-658-t+15-1N (14/27): to 1.00 N
  slide-dense-782-t+15-1N (15/27): to 1.00 N
  slide-dense-721-t+10-1N (16/27): to 1.00 N
  slide-dense-735-t+10-1N (17/27): to 1.00 N
  slide-dense-665-t+15-1N (18/27): to 1.00 N
  slide-dense-793-t+10-1N (19/27): to 1.00 N
  slide-dense-749-t+10-1N (20/27): to 1.00 N
  slide-dense-751-t+15-1N (21/27): to 1.00 N
  slide-dense-736-t+10-1N (22/27): to 1.00 N
  slide-dense-657-t+15-1N (23/27): to 1.00 N
  slide-dense-700-t+10-1N (24/27): to 1.00 N
  slide-dense-781-t+10-1N (25/27): to 1.00 N
  slide-dense-655-t+15-1N (26/27): to 1.00 N
  slide-dense-595-t+15-1N (27/27): to 1.00 N
== twist
  twist-3-2.5N-20deg (1/2): to 2.50 N
  twist-3-5.0N-20deg (2/2): to 5.00 N
== final
  final-ref-p6 (1/1): to 2.00 N
HEX-E: 699846 samples, 0 timed out, 0 late datagrams dropped, 1 gaps over 0.5 s; 0.7 s, Fz +0.0 N
session in logs/20261026-tip_calibration/192158-v2id1
exit 0 at 02:44:22
