badinkajink/hand/docs/experiments/20261022-ur5_tip_calibration/lab/20261025-152920-cb2t/printout_resume_1840.txt

resumed logs/20261025-tip_calibration/152920-cb2t: 155 actions done, 31 touches
speed slider 0.30 (the plan's 0.30)
== preflight
preflight: HEX-E 100 Hz (asked 100 Hz, filter 3), board 338 records/s, robot 124 Hz
  HEX-E noise (1 sigma) N, N m: [0.0316 0.0171 0.2225 0.0028 0.0036 0.001 ]
  HEX-E reads: 0 timed out, 0 late datagrams dropped (0 and 0 on a clean link)
  payload set: 0.403 kg at [0.0, -0.5, 34.3] mm from the flange
== grid
  fast-grid-053 (1/52): to 2.00 N
  fast-grid-033 (2/52): to 3.00 N
  fast-grid-032 (3/52): to 3.00 N
  fast-grid-051 (4/52): to 3.00 N
  fast-grid-034 (5/52): to 3.00 N
  fast-grid-031 (6/52): to 3.00 N
  fast-grid-035 (7/52): to 3.00 N
  fast-grid-036 (8/52): to 3.00 N
  fast-grid-030 (9/52): to 3.00 N
  fast-grid-029 (10/52): to 5.00 N
  fast-grid-009 (11/52): to 5.00 N
  fast-grid-013 (12/52): to 5.00 N
  fast-grid-012 (13/52): to 5.00 N
  fast-grid-008 (14/52): to 5.00 N
  fast-grid-011 (15/52): to 5.00 N
  fast-grid-006 (16/52): to 5.00 N
  fast-grid-010 (17/52): to 5.00 N
  fast-grid-014 (18/52): to 5.00 N
  fast-grid-015 (19/52): to 5.00 N
  fast-grid-026 (20/52): to 5.00 N
  fast-grid-037 (21/52): to 3.00 N
  fast-grid-005 (22/52): to 5.00 N
  fast-grid-020 (23/52): to 5.00 N
  fast-grid-038 (24/52): to 3.00 N
  fast-grid-000 (25/52): to 5.00 N
  fast-grid-004 (26/52): to 5.00 N
  fast-grid-016 (27/52): to 5.00 N
  fast-grid-019 (28/52): to 5.00 N
  fast-grid-001 (29/52): to 5.00 N
  fast-grid-018 (30/52): to 5.00 N
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
  slide-twin-066-t+10-2N (48/48): to 2.00 N
== final
  final-ref-p5 (1/1): to 2.00 N
HEX-E: 936524 samples, 0 timed out, 0 late datagrams dropped, 1 gaps over 0.5 s; 0.7 s, Fz +0.1 N
session in logs/20261025-tip_calibration/152920-cb2t
exit 0 at 21:16:54
