badinkajink/hand/src/morphohand/driver/manta/host/examples/servo_manual_range.csv

timestamp | servo_id | position_deg
1788018359.480983 | 0 | -41.3086
1788018359.57711 | 0 | -41.3086
1788018359.6730828 | 0 | -41.3086
1788018359.784951 | 0 | -41.3086
1788018359.881216 | 0 | -41.6016
1788018359.9770691 | 0 | -41.3086
1788018360.0730891 | 0 | -41.3086
1788018360.185081 | 0 | -41.3086
1788018360.280975 | 0 | -41.3086
1788018360.3769338 | 0 | -41.3086
1788018360.472975 | 0 | -41.3086
1788018360.584943 | 0 | -41.3086
1788018360.680906 | 0 | -41.3086
1788018360.7769659 | 0 | -41.3086
1788018360.873048 | 0 | -41.3086
1788018360.9850109 | 0 | -41.3086
1788018361.080981 | 0 | -41.3086
1788018361.1768608 | 0 | -41.3086
1788018361.27295 | 0 | -41.3086
1788018361.368814 | 0 | -41.3086
1788018361.480941 | 0 | -41.3086
1788018361.576975 | 0 | -41.3086
1788018361.67279 | 0 | -41.3086
1788018361.784796 | 0 | -41.3086
1788018361.880969 | 0 | -41.3086
1788018361.976982 | 0 | -41.3086
1788018362.0728781 | 0 | -41.3086
1788018362.184788 | 0 | -41.3086
1788018362.2808619 | 0 | -41.3086
1788018362.3769999 | 0 | -41.3086
1788018362.472927 | 0 | -41.3086
1788018362.5688372 | 0 | -41.6016
1788018362.680765 | 0 | -41.8945
1788018362.776741 | 0 | -42.1875
1788018362.873324 | 0 | -42.1875
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
