badinkajink/hand/docs/experiments/20260906-screen_vs_chain/README.md

# Screened plans in the chained task

Page: `20260906-screen_vs_chain.html` (builder `scripts/design/real_v1_screen_chain_page.py`).
Artifact: https://claude.ai/code/artifact/28a84ea8-a8b2-405e-aea6-e6a626baa3b0

Data is in `../20260906-rv05_band/`; see its README for the command behind each file.
