badinkajink/hand/docs/experiments/20260919-hands_tranche/README.md

# Hands tranche 2026-09-19/20 — runbook

Serial, gate-aware queue of reorientation-policy finetunes across the deployed hands on the calibrated
plant. Results prose lives in the page (`20260919-reorient_policies_across_hands.html`, built by
`scripts/rl/hands_tranche_page.py`), never here.

## Run / resume

    nohup setsid python3 scripts/rl/hands_tranche_queue.py --queue docs/experiments/20260919-hands_tranche/queue.json \
        >> logs/20260919-hands_tranche.log 2>&1 &

The driver re-reads `queue.json` before each job (edit flags/status of *pending* jobs while it runs),
waits for `~/.claude/bin/resguard.sh status` to open the gate, trains through `resguard.sh run`, then
evaluates, renders, filmstrips, runs the CPU scene-variant probe and the chain probe, and appends an
fsynced row to `tranche_results.json`. Jobs left "running" by a dead driver go back to pending at
start. After the last job it runs the GPU transfer probes (`<id>_transfer.json`) and exits.

## Files

| file | what |
|---|---|
| `queue.json` | jobs, common flags, notes (design decisions with times) |
| `tranche_results.json` | one row per finished/failed job: eval summary + plausibility numbers |
| `<id>_eval.json`, `<id>_eval.png` | `policy_eval_suite.py`, 64 rollouts, run timing + action clip, plausibility block |
| `<id>_strip.png`, `<id>_trace.csv` | filmstrip and per-step trace of one 960x720 deterministic rollout (video in `videos/`, gitignored) |
| `<id>_transfer_cpu.json` | `policy_transfer_probe.py --cpu`: base, tipmesh, plate0, mu0.6, mu1.5, mass1.3, kp0.25 × 6 jittered CPU rollouts |
| `<id>_chain_pl25.json`, `<id>_chain_pl0.json` | `real_v1_chain_policy.py`: the policy driving the fingers inside the UR5e chain for 5 s, plate at 25 / 0 mm |
| `chain/`, `cpu_check/` | the D6 reference checkpoints under the same probes (2026-09-19 evening) |
| `20260919-tranche_curves.png` | tensorboard curves of every job with a run directory |

Per-job logs: `logs/20260919-hands_tranche-<id>.log` (train), `-<id>_eval.log`, `-<id>_render.log`.

## Decision log

- 19:56 queue armed; gate closed (swap 5.3 GB > 4 GB, idle VS Code pages; the user's own job running).
- 20:15 D6 grip finetune probed in the chain: turns to 0.91, drops at 3.2 s; the 17 N 60M checkpoint holds 3/4.
- 20:30 warm start changed to the 60M (+0.25) checkpoint, grip penalty -2 above 6 N.
- 21:38 all arms blind (user: the 66-dim obs will not transfer); swap gate raised to 8 GB by the user; first job started.
- 21:45 user: the tag pose can be used; blind warm start had not recovered in 22 iterations; both blind starts aborted, all arms sighted; first sighted job 21:52.
- Wake-ups: 00:53, 05:53, 10:53 on 2026-09-20 (session crons 6ccb78cf, b0efd918, 7249e298).

### 2026-09-20 00:53–02:00 (wake-up 1)
- 6 of 16 jobs done (d6_clip, d6_clipsep, d3, d4, d5, d7 clip). No queue edit: the clip-2.0 arm holds 64/64 on
  every hand but D6 (56/64; its CPU replay drops 6/6 at the same friction, a knife-edge draw, and d6_clip_s1/s2 at
  the queue's end measure the band); the separation arm turned (0.92); no hand's clip job dropped in the benchmark,
  so every clipsep job runs (D4 at −3.6 mm and D7 at 1.1 mm of clearance need it).
- Chain probe rebuilt on the user's correction that the UR5e does not sag: the 4.9 mm at the seam was the menagerie
  servo settling (slow pole kp/kv = 5 rad/s), not load; `arm_kp_scale` 10 (0.004 mm), `finger_gravcomp` 0 (the
  finger servos carry the links as in training), the policy shadowed from sim step 0 (`actions` slot). First active
  observation now matches the benchmark within 1° / 1.3 mm / 0.015 (D6). Remaining scene difference: the tip mesh.
- `contact_variant` matched only the template's μ 2.4, so every cal-plant friction row before 02:00 was a copy of
  the base; fixed (pad and tool geoms by role), stale caches deleted, the μ rows of the six done jobs re-run.
- All chain probes and the D6 references (`chain/*_final.json`) re-run under the final configuration.
- Page published: https://claude.ai/artifact/JfKA6nQBPuf13hGKjnU22n (same URL from now on).
- The Read tool's hook timed out for the whole wake-up (host unreachable), so the filmstrips were not looked at
  by eye; the per-step traces (cos, z, three pad forces) were read instead. Look at the strips at wake-up 2.

### 2026-09-20 08:50–09:20 (the two scheduled wake-ups did not fire; done by hand when the user returned)
- Queue finished 08:37 (16/16 trained, GPU perturbation pass done, driver exited). All 16 strips viewed:
  every job lifts and turns the tool in the air; D2 (both arms), D4 clipsep and D7 clipsep end 35–50° from
  vertical and hold there; no dropped-standing artefact anywhere.
- GPU perturbation pass: friction is the sharp axis (μ 0.6 drops D1/D2 64/64 both arms, D6 clip s0 52/64;
  μ 1.5 drops D7 64/64); kp 0.25 removes D7 and D1-clip; the tipmesh scene does not compile under mjlab
  (`mesh geom must have valid meshid`) → CPU-only column.
- GPU vs CPU disagree on 6 of 16 policies (D1 both arms 64/64 vs 0/6; D6 clip s1 64/64 vs 1/6; D5 clipsep
  64/64 vs 2/6; D7 clip 64/64 vs 0/6; D7 clipsep 64/64 vs 3/6). D1's divergence is at step 0: its IK
  "open" keyframe has the pips at 54°/69° with the pads on the tool (GPU 2.7 N, CPU 8.9 N) and the CPU
  replay loses the tool between steps 40 and 58 with the residual not yet active. Their chain column is
  not evidence either way.
- Page republished (version 2, same URL); strips inlined as 1600 px JPEGs (the 25 MB page exceeded the
  16 MB artifact limit).
