badinkajink/hand/docs/experiments/20260920-robust_tranche/README.md

# Robust continuation tranche (2026-09-20)

Driver: `nohup setsid python3 scripts/rl/hands_tranche_queue.py --queue docs/experiments/20260920-robust_tranche/queue.json >> logs/20260920-robust_tranche.log 2>&1 &`
(started 09:23 MDT; 11 jobs, ~38 min each). Same per-job outputs as `20260919-hands_tranche/` plus
`<id>_eval_j3dr.json` (64 rollouts at ±3 mm / ±10° spawn jitter with friction DR).

## What changed against the 2026-09-19 tranche

| item | 2026-09-19 | here | why |
|---|---|---|---|
| tool spawn | one nominal pose | ±3 mm x/y, ±10° yaw | the 09-19 policies hold 44-64/64 under that jitter on the plant they trained on; the 09-20 figures (D7 0/64, D6 clip s1 8/64, D5 26/64, D1 20/64) were measured with the tool on the scene's contact class (re-evaluated 2026-10-11, see the page) |
| tool | 25 mm cylinder | + screw-tip mesh (+1 g) | the chain's and the real tool have it; `make_tipmesh_morphology_run.py` |
| floor | mjlab plane (μ 1, solref 0.02) | the scene's floor (μ 1.8, solref 0.006), `--scene-floor` | the tool lies on it through closure and lift |
| tool contact | MuJoCo defaults (solref 0.02, solimp 0.9–0.95) | the scene's (0.006, 0.97–0.995) | `env_build.make_object_spec_from_frozen` had dropped them since the first mjlab run |
| warm start | D6 60 M checkpoint | each hand/arm's own 09-19 checkpoint | 20 M steps of continuation on the matched plant |

## Decision log
- 09:23 launched; order: D6 clipsep, D3, D5, D1, D6 (clip s2), D4, D7, D2 clip, then D3/D5/D1 clipsep.
- 11:40 page builder `scripts/rl/robust_tranche_page.py` (+ template) written; page published
  https://claude.ai/artifact/NZLr9wdDAWjZC1HM6ed6ed (same URL from now on; videos in web/ as supporting files).
  A watcher (`logs/20260920-robust_page_watch.log`) rebuilds the local page every 10 min while the driver lives
  and once after it exits; republishing the artifact needs a session (Artifact tool, same file path).
- After 3 of 11: D5 jittered 23->57 of 64 and holds the chain (parent dropped); D6 clipsep 60->51, D3 51->50;
  every continued policy ends 30-45 deg short of vertical (cos 0.82-0.83 vs parents 0.92-0.96) -- see the page's
  next-steps item 2 (60 M continuation of one job decides converged-vs-jitter-cost).

- 12:31 r_d4_clip aborted at iteration 9: NaN in the actor observation (tip_lost 29.6/episode before it) on the g12
  tip-mesh scene; `r_d4_clip_s1` appended at the queue's end as a second draw (`--seed` is a dead flag: rl_train_cube.py
  parses it and never applies it; every run is an unseeded draw).
- 12:45 page v2: the training-pipeline section (stages, episode timeline, obs/action, reward, terminations, PPO, lineage,
  decision register measured-vs-inherited, evaluation stack) built from the first finished run's config.yaml.
- 12:55 page v3/v4: the chain's post-turn seams per policy and plate; the D6 clip plate-0 chain film. Finger commands and
  angles recorded through that run (`r_d6_clip_chain_pl0_ctrl_qpos.json`): the gait's commands move 5-27 deg, the fingers
  0.3-9 deg (index pip 59 deg behind), -0.002 turns; `ok` tests stance/grip/cycles, not turns. Plate 0 = the chain
  scenes' original geometry; plate 25 (`plate_variant`, only the plate geom moves) = the built hand = the training scenes.
- 14:20 7 of 12 done. Plate-25 chain films for D6 clip, D5 clip, D6 clipsep (the three that hold the turn): each stages at
  14-27 deg off vertical, the tip (50 mm lever) lands 12-23 mm from the aimed centre against a 6 mm capture radius and
  misses the hole; D6 clip then tips off at the handover grip, D5/D6 sep lean on the post at 47-55 deg. At plate 0 D6 clip
  staged at 8 deg (7 mm) and entered. Next measurement: a staging gate (cos >= 0.99 before the descent). Page v5.
- D7 continued: nominal 37/64 (parent 64), jittered 1->35; its strip shows the tool sliding out during the lift and
  standing on the floor at step 58. D2: nominal 64 at cos 0.65, turns 40-50 deg and holds, as its parent.
- 14:55 The staging gate is not needed: the chain commands the tool pose and derives the palm's, so the set-down is
  written for the tip instead (`probe_real_v1_chain.chain(seat_aim="tip")`, `real_v1_chain_policy.py --seat-aim tip`):
  `_stage` aims the measured apex at the socket, `_descend` takes one aim on the apex, a `seated` phase stands the tool up
  about the seated tip (the `_upright(about_foot)` move). The driver's rows keep `centre`. On the three plate-25 policies
  that hold the turn: apex within 1.5 mm of the socket at 12.9-30.5 deg of lean, seated to 1.5-7.0 deg, all three hold
  through the relay handover and 8 gait cycles (D5 0.4 deg, D6 clip 6.3 deg / 17.4 N, D6 sep 2.9 deg / 16.7 N); `ok`
  at plate 25 for the first time. Turns still 0.00 (the achieved-angle loop is next). Outputs in `seat_aim/`, films
  `seat_aim/videos/*_pl25_tip.mp4` -> `web/*_chain_pl25_tip.mp4`. Page v6.
- 15:50 The achieved-angle loop (09-16's named measurement) is FALSIFIED as specified: `--angle-gain k` (probe regulator
  arm, armed from the press) finds the servos already on the ceiling at the press (D6 thumb 76 deg short, sat 1; the
  policy's frozen residual is 70-79 deg past achieved at `turned` on every hand) and every downstream grip is
  command-referenced (0.3 mm regrip, relay pins, gait-table rebase), so the trim clips at 26 deg, sat 2-3, sp_err
  70-100 deg, +0.02 turns. Re-seeding from the ACHIEVED angles (`_squeeze_cmd(from_achieved=True)`):
  `--regrip-ref achieved --carry-squeeze 10` right after the turn takes D6 clip off the ceiling (5 N), stages at 3.2
  deg, seats at 0.3, and with gain 2 turns +0.071 rev in 8 cycles (2-6 deg/cycle, tilt 0.8) -- the first non-zero
  turn on the calibrated plant -- but the 3-4 N grip loses D5/D6 sep during the levelling. `--press-regrip 10` (at the
  press, seat carrying) keeps all three and the handover then saturates the INDEX 45-102 deg short on every run: the
  relay's ring is 17-27 mm beyond reach (`ring_ik_grip_mm`; the 09-06 'solved' D6 chain carried 20 mm on kp 30).
  `--reindex slide` (the reachable-ring mode) moves the palm 49 mm / 45 deg and pulls the tool out of the seat.
  New flags on real_v1_chain_policy.py: --angle-gain/--angle-rate/--angle-from/--reg-band, --regrip-ref,
  --carry-squeeze, --press-regrip, --reindex, --track-frac; seams carry sp_err_deg/trim_deg beside q_err_deg/sat;
  per_cycle rows in the output. Next: a per-hand reachable ring at the seated palm pose (ring_ik_grip < 2 mm), or a
  gait on the press's own contact set with achieved-referenced commands. Page v6; outputs seat_aim/*.json.
- 21:32 The driver had waited since 15:00 behind the swap gate (8.3 > 8 GB, cold VS Code pages; RAM 15 GB free, PSI 0)
  with r_d5_clipsep trained and unevaluated. Restarted with `RESGUARD_MAX_SWAP_GB=9` (user-authorised) after adding
  resume-at-evaluation to `hands_tranche_queue.py` (a job whose training log ends in `[rl_train_cube] DONE` is not
  retrained). Remaining: r_d5_clipsep eval/chain, r_d1_clipsep, r_d4_clip_s1, then the transfer probes; the page
  watcher (pid 976538) rebuilds every 10 min and commits when the driver exits. The artifact republish (v7) is a
  session action, pending.
- 22:45 Queue finished (driver exited after the transfer probes; watcher committed cae41136). 10 of 12 trained:
  r_d5_clipsep nominal 61/64 held at cos 0.81, jittered 56/64; r_d1_clipsep nominal 64/64 at cos 0.958 +- 0.006 with
  64/64 aligned (the tranche's best turn), jittered 54/64 at 0.81 +- 0.35, chain plate 25 turned cos 0.75 on 3 pads
  (D1 clip lost it); r_d4_clip_s1 NaN in the actor observation at iteration 63 (first draw: iteration 9): two draws,
  same failure on the g12 tip-mesh scene, so it is the D4 pads on the mesh tool, not a stochastic event. Page v7.
