badinkajink/hand/docs/changelog.html

SR² Hand documentation · last page change 2026-11-13

# Revisions of the SR² Hand documentation pages

The 144 pages under docs/ have 1999 revisions in git. 13 pages have one, and the 15 most revised are listed below. Each revision links to its commit and to the page as that commit left it on GitHub. A result page is a Git LFS file, so GitHub shows it as a blob page with a “View raw” link. In a clone, git show COMMIT:PATH | git lfs smudge > /tmp/page.html writes an older version to open in a browser. History before the repository’s rewrite of 2026-10-09 keeps its old commit hashes in hand-archive (https://github.com/badinkajink/hand-archive).

## Recent changes

The 30 newest commits that changed a page, with the pages they changed.

1. 2026-11-13 · Tag-tracking throughput on corvus and the controller link: live two-camera tracker, UDP pose and state/target messages, and their page (lab session on corvus, … · 583f85b0f (https://github.com/badinkajink/hand/commit/583f85b0f9f5bd442d0eac22573106f19c2583ba) Throughput of the two-camera tag tracker on corvus and the controller link, SR2 Hand documentation, Hand, plant and bench, Index of result pages
2. 2026-11-13 · Fingertip overview: the sampling MPC page's sections on measured state and on the pose filter linked by anchor · ce8fd3003 (https://github.com/badinkajink/hand/commit/ce8fd3003e8e761ada2586bbe065d4a0fcd822ff) Printed fingertips and force sensing
3. 2026-11-13 · Calibration page v5: camera 836612071918 moved at about 16:00 and its pose re-solved against the fixed camera (lab session on corvus, 2026-11-13) · 8837c5d37 (https://github.com/badinkajink/hand/commit/8837c5d37801440517d9383a10195b86f71e9769) Lens and arm calibration of the two D435 tracking cameras on the UR5, SR2 Hand documentation, Hand, plant and bench, Index of result pages
4. 2026-11-13 · Objects' Bambu projects: each object's filament written on the object, black on filament 1 and white on 2 (owner, 2026-11-13: "please have the blocks use the … · 4940a1be4 (https://github.com/badinkajink/hand/commit/4940a1be4aafaab45180a37e2a86da8c3807c84f) Tracked objects, tag blocks and calibration board for the SR2 hand on the UR5, Index of result pages
5. 2026-11-13 · Hex block map from both D435s: pose.bundle_adjust_multi, 35 views of the 11-07 test block, and section 6 of the calibration page (lab session on corvus, … · a1e231000 (https://github.com/badinkajink/hand/commit/a1e231000ebbbae6e013d2121c3516ada653fd90) Lens and arm calibration of the two D435 tracking cameras on the UR5, Tracked objects, tag blocks and calibration board for the SR2 hand on the UR5, SR2 Hand documentation, Hand, plant and bench and 1 more
6. 2026-11-13 · Calibration page revised after the owner's notes (lab session on corvus, 2026-11-13 about 14:5x) · 0953ff43f (https://github.com/badinkajink/hand/commit/0953ff43f90d7f791f9283168c02fe0f241b4f31) Lens and arm calibration of the two D435 tracking cameras on the UR5, Index of result pages
7. 2026-11-13 · Tracked cylinder printed without end tags (owner, 2026-11-13: "i sent the print with no cylinder end tag") · 18062efdc (https://github.com/badinkajink/hand/commit/18062efdc0578ca90b8b40f02fd4b84f7551a152) Tracked objects, tag blocks and calibration board for the SR2 hand on the UR5, Index of result pages
8. 2026-11-13 · Tracking plan and tracking-prints page: pointer to the lens and arm calibration of 2026-11-13 · 9adcbdc2e (https://github.com/badinkajink/hand/commit/9adcbdc2e2153f3e8c20d128473c686a9d721254) Tracked objects, tag blocks and calibration board for the SR2 hand on the UR5, SR2 Hand documentation, Index of result pages
9. 2026-11-13 · Lens and arm calibration of the two D435 tracking cameras on the UR5: page, data, film and lab scripts of 2026-11-13 (built on corvus by the lab session, owner … · 90d753ca3 (https://github.com/badinkajink/hand/commit/90d753ca37bce004f1ced2e8b67ec2f710f740db) Lens and arm calibration of the two D435 tracking cameras on the UR5, SR2 Hand documentation, Hand, plant and bench, Index of result pages
10. 2026-11-13 · Fingertip overview: the fingertips as the HOM controller's contact sensor in simulation. With the errors measured on the UR5 in its fingertip model, HOM … · 55493180a (https://github.com/badinkajink/hand/commit/55493180a3bc31ea4eb8fadfdfbfdbab64cda1b3) Printed fingertips and force sensing
11. 2026-11-13 · Tracked cylinder with end tag 23 only and without end tags, as alternatives (owner, 2026-11-13: the end tags "cause a lot of pla usage") · ab5073f0c (https://github.com/badinkajink/hand/commit/ab5073f0c46faa2da6df9d7f0ea49a964421a955) Tracked objects, tag blocks and calibration board for the SR2 hand on the UR5, SR2 Hand documentation, Index of result pages
12. 2026-11-13 · HOM's measured pose through a complementary filter (hom_gpu.POSE_FILTER: prediction from the commanded angular velocity, delayed tracker frames corrected by … · bb8b61b24 (https://github.com/badinkajink/hand/commit/bb8b61b24290b05a6e2443066c21e3a148ba766b) Sampling MPC and HOM on the SR2 sphere twist, SR2 Hand documentation, Morphology and design search, Index of result pages
13. 2026-11-13 · Sampling MPC page: HOM under the sensing variants (tag tracker, fingertip model, calibration errors), HOM's commanded pad force (2 N: J 0.415 against 0.388 at … · 0de23f89b (https://github.com/badinkajink/hand/commit/0de23f89bf23e2997026e333c39690d2a20ecfa3) Sampling MPC and HOM on the SR2 sphere twist, SR2 Hand documentation, Morphology and design search, Index of result pages
14. 2026-11-13 · Docs index: the artifact of the sampling MPC page (https://claude.ai/artifact/3m4bcPKugwFCtX5ZZLtd7f) · c35fc5d84 (https://github.com/badinkajink/hand/commit/c35fc5d8484a103ab0c94e2eb8334dcbc81b02fb) Morphology and design search, Index of result pages
15. 2026-11-13 · Sampling MPC and HOM on the SR2 sphere twist, on the SCS0009 plant: page with HOM, real-time predictive sampling, DIAL annealing, the point-contact planner, … · ef59860cb (https://github.com/badinkajink/hand/commit/ef59860cb53bf8f661a12b16399344487926d526) Sampling MPC and HOM on the SR2 sphere twist, SR2 Hand documentation, Morphology and design search, Index of result pages
16. 2026-11-13 · Paper calibration boards for the owner's 140 x 130 mm back (ChArUco 7 x 7 of 15 mm and checkerboard 9 x 8 of 12 mm, Letter PDF at actual size, 36 of 36 corners … · 9a6322eb6 (https://github.com/badinkajink/hand/commit/9a6322eb65d9feaf4c753287cc64f847d9e07b73) Tracked objects, tag blocks and calibration board for the SR2 hand on the UR5, SR2 Hand documentation, Hand, plant and bench, Index of result pages
17. 2026-11-13 · Page of the tracking prints and the calibration board: renders, joint sections, two MuJoCo viewers and links to every STL and Bambu project; on the mount's … · 5013467be (https://github.com/badinkajink/hand/commit/5013467bec283030c3b1fd3ba636eb4137a69cb8) Tracked objects, tag blocks and calibration board for the SR2 hand on the UR5, SR2 Hand documentation, Hand, plant and bench, Index of result pages
18. 2026-11-12 · Search methods page, Section 12: MAP-Elites, CMA-ME, CMA-ES and Bayesian optimization replayed on the talk's four tracking-score grids (owner, 2026-11-12) · eb98da82e (https://github.com/badinkajink/hand/commit/eb98da82e17f14c4be92c02a7cabe35a383fc74c) Layout search methods for the SR2 hand under HOM control, SR2 Hand documentation, Morphology and design search, Index of result pages
19. 2026-11-12 · Talk v2 full set of 11-11 (16:37, 30 steps rc 0): the size study's rows under the tracking score, the CEM rows of the grasp and HOM together, the shared HOM … · 72a794f90 (https://github.com/badinkajink/hand/commit/72a794f9077f3ee2b0484c5a9eac8813ded9af17) The co-design problem of the SR2 hand talk as one nested formula
20. 2026-11-11 · Fingertip overview: with each tip's own holds in training the MLP ensemble's error is 0.42-0.46 mm on v3 IDs 1-3 and 0.63-0.68 mm on IDs 4-6, the GP's … · 093b2e62a (https://github.com/badinkajink/hand/commit/093b2e62a987b12b202f739a3f787b4da680dda6) Printed fingertips and force sensing
21. 2026-11-11 · Calibration page: the board GP against the MLP ensemble of 64 units on the splits of the two data curves (talk window's ae9366be, owner 11-11) in Section 16, … · 39bcf811b (https://github.com/badinkajink/hand/commit/39bcf811b92a01b90df475bebff0e8a9dd21714c) Calibration of the magnetic fingertip on the UR5 against a six-axis force sensor, Index of result pages
22. 2026-11-11 · Fingertip overview: the sphere-pad implementation page in the section on the fingertip in the simulations (the v4b tip's 1,018 spheres at 122 to 449 N/m at 2.5 … · f8404981c (https://github.com/badinkajink/hand/commit/f8404981c87b108c7f6fa5da2e7476be837b1251) Printed fingertips and force sensing
23. 2026-11-11 · Contact overview: link to the sphere-pad implementation page from the section on sphere pads; rebuilt (script paths now in the topic folders, no number … · c7599611d (https://github.com/badinkajink/hand/commit/c7599611d13beca302243c04661b5cd7785446db) Sphere-packed fingertip contact
24. 2026-11-11 · Sphere-pad implementation page (owner, 11-11): how the spheres of a convex fingertip surface are built, with Algorithm 1, the v4b tip's numbers, the flat press … · 12efa7226 (https://github.com/badinkajink/hand/commit/12efa72265235ec606665f8ec782adcd830ae1c1) Implementation of the sphere-pad contact model on a convex fingertip surface, SR2 Hand documentation, Index of result pages
25. 2026-11-11 · Talk figures in the HOM paper's terms (owner, 11-11): CEM-refined grasp and HOM, Eq. (2) weights, contact forces · 136239972 (https://github.com/badinkajink/hand/commit/1362399725b154bd9ef9570e9fab8a6b46a4b98c) The co-design problem of the SR2 hand talk as one nested formula, SR2 Hand documentation, Morphology and design search, Index of result pages
26. 2026-11-11 · Talk v2: the tuning chart under the tracking score, with HOM tuning alone (owner, 11-11) · b5a8d0025 (https://github.com/badinkajink/hand/commit/b5a8d002554e72ebdfa3eeaf807bcc3e293af081) The co-design problem of the SR2 hand talk as one nested formula, Index of result pages
27. 2026-11-11 · Talk v2: the 16 grasps of hand A and the search panels under the tracking score, the formulation page's v2 section, filmed hands' scores to four decimals · 0d87fb90e (https://github.com/badinkajink/hand/commit/0d87fb90e294fd3e52bdec6849f202e988e45317) The co-design problem of the SR2 hand talk as one nested formula, Index of result pages
28. 2026-11-11 · Talk v2 under way (owner, 11-11 ~01:35: refresh the slides' results on the latest settings): the tracking-score versions of the morphology figures, the … · ff6dc6dcd (https://github.com/badinkajink/hand/commit/ff6dc6dcd939685beed0d6a49d347d96d4370b46) The co-design problem of the SR2 hand talk as one nested formula, Index of result pages
29. 2026-11-11 · Talk media of 11-11: HOM on the abstract SR2 hand of the drawings, and the fidelity slide as two plain charts (owner) · 2d960dc4f (https://github.com/badinkajink/hand/commit/2d960dc4f92dc0eee7417e2cfb608db869ae6541) The co-design problem of the SR2 hand talk as one nested formula, Index of result pages
30. 2026-11-11 · Talk chart of the time per landscape: Newton's SDF hydroelastic contact on one GPU, an estimated 31 minutes (owner, 11-11) · b924a7283 (https://github.com/badinkajink/hand/commit/b924a7283f16151074beecab52c75f99f8a2014c) The co-design problem of the SR2 hand talk as one nested formula, Index of result pages

## Most revised pages

Page | Revisions | First | Last
Index of result pages | 356 | 2026-10-14 | 2026-11-13
Status of the printed-fingertip, contact-model and DIP-link work | 170 | 2026-10-18 | 2026-11-05
SR2 Hand documentation | 162 | 2026-10-09 | 2026-11-13
Printed fingertips and force sensing | 122 | 2026-10-14 | 2026-11-13
Calibration of the magnetic fingertip on the UR5 against a six-axis force sensor | 53 | 2026-10-26 | 2026-11-11
Morphology and design search | 45 | 2026-10-09 | 2026-11-13
Sphere-packed fingertip contact | 45 | 2026-10-09 | 2026-11-11
Magnetic crosstalk between neighbouring fingertips and its removal by the fingers' pose | 26 | 2026-10-27 | 2026-11-05
Foundational-pose hand design, the project's layout sampling, and a Pareto front for the SR2 hand | 24 | 2026-10-29 | 2026-11-10
Performance, consistency and transfer of reorientation policies trained with four fingertip contact models | 23 | 2026-10-08 | 2026-10-22
Program record behind the SR2 Hand workshop paper | 22 | 2026-09-21 | 2026-10-22
Hand, plant and bench | 21 | 2026-10-09 | 2026-11-13
Servo plant refit, hand-object control of the three-finger turn, and the cost of sphere-pad fingertips in RL training | 20 | 2026-10-06 | 2026-11-06
Reorientation policies continued on the plant the chain and the bench use | 19 | 2026-09-20 | 2026-10-22
Stiffness, sphere-pad calibration and embedded magnet of the printed TPU fingertip | 19 | 2026-10-09 | 2026-10-23

## Home page and indices

### SR2 Hand documentation

docs/index.html · 162 revisions, 2026-10-09 to 2026-11-13
Latest: 2026-11-13 · Tag-tracking throughput on corvus and the controller link: live two-camera tracker, UDP pose and state/target messages, and their page (lab session on corvus, …

Revisions, newest first

1. 2026-11-13 · Tag-tracking throughput on corvus and the controller link: live two-camera tracker, UDP pose and state/target messages, and their page (lab session on corvus, … · 583f85b0f (https://github.com/badinkajink/hand/commit/583f85b0f9f5bd442d0eac22573106f19c2583ba) page (https://github.com/badinkajink/hand/blob/583f85b0f9f5bd442d0eac22573106f19c2583ba/docs/index.html)
2. 2026-11-13 · Calibration page v5: camera 836612071918 moved at about 16:00 and its pose re-solved against the fixed camera (lab session on corvus, 2026-11-13) · 8837c5d37 (https://github.com/badinkajink/hand/commit/8837c5d37801440517d9383a10195b86f71e9769) page (https://github.com/badinkajink/hand/blob/8837c5d37801440517d9383a10195b86f71e9769/docs/index.html)
3. 2026-11-13 · Hex block map from both D435s: pose.bundle_adjust_multi, 35 views of the 11-07 test block, and section 6 of the calibration page (lab session on corvus, … · a1e231000 (https://github.com/badinkajink/hand/commit/a1e231000ebbbae6e013d2121c3516ada653fd90) page (https://github.com/badinkajink/hand/blob/a1e231000ebbbae6e013d2121c3516ada653fd90/docs/index.html)
4. 2026-11-13 · Tracking plan and tracking-prints page: pointer to the lens and arm calibration of 2026-11-13 · 9adcbdc2e (https://github.com/badinkajink/hand/commit/9adcbdc2e2153f3e8c20d128473c686a9d721254) page (https://github.com/badinkajink/hand/blob/9adcbdc2e2153f3e8c20d128473c686a9d721254/docs/index.html)
5. 2026-11-13 · Lens and arm calibration of the two D435 tracking cameras on the UR5: page, data, film and lab scripts of 2026-11-13 (built on corvus by the lab session, owner … · 90d753ca3 (https://github.com/badinkajink/hand/commit/90d753ca37bce004f1ced2e8b67ec2f710f740db) page (https://github.com/badinkajink/hand/blob/90d753ca37bce004f1ced2e8b67ec2f710f740db/docs/index.html)
6. 2026-11-13 · Tracked cylinder with end tag 23 only and without end tags, as alternatives (owner, 2026-11-13: the end tags "cause a lot of pla usage") · ab5073f0c (https://github.com/badinkajink/hand/commit/ab5073f0c46faa2da6df9d7f0ea49a964421a955) page (https://github.com/badinkajink/hand/blob/ab5073f0c46faa2da6df9d7f0ea49a964421a955/docs/index.html)
7. 2026-11-13 · HOM's measured pose through a complementary filter (hom_gpu.POSE_FILTER: prediction from the commanded angular velocity, delayed tracker frames corrected by … · bb8b61b24 (https://github.com/badinkajink/hand/commit/bb8b61b24290b05a6e2443066c21e3a148ba766b) page (https://github.com/badinkajink/hand/blob/bb8b61b24290b05a6e2443066c21e3a148ba766b/docs/index.html)
8. 2026-11-13 · Sampling MPC page: HOM under the sensing variants (tag tracker, fingertip model, calibration errors), HOM's commanded pad force (2 N: J 0.415 against 0.388 at … · 0de23f89b (https://github.com/badinkajink/hand/commit/0de23f89bf23e2997026e333c39690d2a20ecfa3) page (https://github.com/badinkajink/hand/blob/0de23f89bf23e2997026e333c39690d2a20ecfa3/docs/index.html)
9. 2026-11-13 · Sampling MPC and HOM on the SR2 sphere twist, on the SCS0009 plant: page with HOM, real-time predictive sampling, DIAL annealing, the point-contact planner, … · ef59860cb (https://github.com/badinkajink/hand/commit/ef59860cb53bf8f661a12b16399344487926d526) page (https://github.com/badinkajink/hand/blob/ef59860cb53bf8f661a12b16399344487926d526/docs/index.html)
10. 2026-11-13 · Paper calibration boards for the owner's 140 x 130 mm back (ChArUco 7 x 7 of 15 mm and checkerboard 9 x 8 of 12 mm, Letter PDF at actual size, 36 of 36 corners … · 9a6322eb6 (https://github.com/badinkajink/hand/commit/9a6322eb65d9feaf4c753287cc64f847d9e07b73) page (https://github.com/badinkajink/hand/blob/9a6322eb65d9feaf4c753287cc64f847d9e07b73/docs/index.html)
11. 2026-11-13 · Page of the tracking prints and the calibration board: renders, joint sections, two MuJoCo viewers and links to every STL and Bambu project; on the mount's … · 5013467be (https://github.com/badinkajink/hand/commit/5013467bec283030c3b1fd3ba636eb4137a69cb8) page (https://github.com/badinkajink/hand/blob/5013467bec283030c3b1fd3ba636eb4137a69cb8/docs/index.html)
12. 2026-11-12 · Search methods page, Section 12: MAP-Elites, CMA-ME, CMA-ES and Bayesian optimization replayed on the talk's four tracking-score grids (owner, 2026-11-12) · eb98da82e (https://github.com/badinkajink/hand/commit/eb98da82e17f14c4be92c02a7cabe35a383fc74c) page (https://github.com/badinkajink/hand/blob/eb98da82e17f14c4be92c02a7cabe35a383fc74c/docs/index.html)
13. 2026-11-11 · Sphere-pad implementation page (owner, 11-11): how the spheres of a convex fingertip surface are built, with Algorithm 1, the v4b tip's numbers, the flat press … · 12efa7226 (https://github.com/badinkajink/hand/commit/12efa72265235ec606665f8ec782adcd830ae1c1) page (https://github.com/badinkajink/hand/blob/12efa72265235ec606665f8ec782adcd830ae1c1/docs/index.html)
14. 2026-11-11 · Talk figures in the HOM paper's terms (owner, 11-11): CEM-refined grasp and HOM, Eq. (2) weights, contact forces · 136239972 (https://github.com/badinkajink/hand/commit/1362399725b154bd9ef9570e9fab8a6b46a4b98c) page (https://github.com/badinkajink/hand/blob/1362399725b154bd9ef9570e9fab8a6b46a4b98c/docs/index.html)
15. 2026-11-10 · Tracking-score page, Section 7: the four default landscapes of the hand-design talk under the tracking score (owner, 11-10 night: "sure, let's rerun the … · f03d7dccc (https://github.com/badinkajink/hand/commit/f03d7dccc09c73265b5a6def37d6c17e71d26c7d) page (https://github.com/badinkajink/hand/blob/f03d7dccc09c73265b5a6def37d6c17e71d26c7d/docs/index.html)
16. 2026-11-10 · Talk formulas: the metric step follows the dynamics, and metrics join the outermost loop (owner, 11-10 evening) · cca3b006d (https://github.com/badinkajink/hand/commit/cca3b006dec189e9b5cf9937ab97d742ddf47cd9) page (https://github.com/badinkajink/hand/blob/cca3b006dec189e9b5cf9937ab97d742ddf47cd9/docs/index.html)
17. 2026-11-10 · Talk formulas: the innermost level of the co-design problem is the dynamics (owner, 11-10 evening) · 18d7c5330 (https://github.com/badinkajink/hand/commit/18d7c533058a77374838dc878245b05519da9d08) page (https://github.com/badinkajink/hand/blob/18d7c533058a77374838dc878245b05519da9d08/docs/index.html)
18. 2026-11-10 · Talk formulas: the co-design build introduces the 6 mount coordinates and the 9 joint commands right after the bi-level step, then the object sizes and the … · f98907013 (https://github.com/badinkajink/hand/commit/f98907013d782f6835b10fe081f67f74b552bd3e) page (https://github.com/badinkajink/hand/blob/f98907013d782f6835b10fe081f67f74b552bd3e/docs/index.html)
19. 2026-11-10 · Search methods page: the EA and the 16-particle swarm live at four object sizes without a stored grid (post-reset step 5) · ff95124f7 (https://github.com/badinkajink/hand/commit/ff95124f7e0785b35fb45a825f6dc26d64525c09) page (https://github.com/badinkajink/hand/blob/ff95124f7e0785b35fb45a825f6dc26d64525c09/docs/index.html)
20. 2026-11-10 · Fingertip viewer page: the viewer replayed on a UR5 rod roll of v3 ID 5, with an FE and field film of the roll · bfaf35e1e (https://github.com/badinkajink/hand/commit/bfaf35e1e11d517a7a4d152448bfc2307e11696b) page (https://github.com/badinkajink/hand/blob/bfaf35e1e11d517a7a4d152448bfc2307e11696b/docs/index.html)
21. 2026-11-10 · Search methods page: the six methods live on the six-coordinate Sobol layouts (post-reset step 4) · 5d8477f06 (https://github.com/badinkajink/hand/commit/5d8477f0630ac5c20066c10635da7a2bacea0447) page (https://github.com/badinkajink/hand/blob/5d8477f0630ac5c20066c10635da7a2bacea0447/docs/index.html)
22. 2026-11-10 · Search methods page builder: a section for the live searches on the six-coordinate Sobol layouts (post-reset step 4), filled from rows/search6d_sv25 when they … · 078d7a99f (https://github.com/badinkajink/hand/commit/078d7a99fd56c59e83c39a29d585243d10974d90) page (https://github.com/badinkajink/hand/blob/078d7a99fd56c59e83c39a29d585243d10974d90/docs/index.html)
23. 2026-11-10 · Stiffness page: the size study's live EA on the measured servo and MuJoCo 4.0 keeps the press's 1.09 mm/mm and the roll's 0.49 against 0.56; the twist's falls … · f933beb09 (https://github.com/badinkajink/hand/commit/f933beb092d85bad7e7e96e7b600611c181e0ffe) page (https://github.com/badinkajink/hand/blob/f933beb092d85bad7e7e96e7b600611c181e0ffe/docs/index.html)
24. 2026-11-10 · HOM landscapes on the measured SCS0009 servo: 0.55 N m/rad and the 0.59 deg dead band reorder the layouts (tracking rho 0.72-0.91 against 0.72 N m/rad, rerun … · 2eb2bfe31 (https://github.com/badinkajink/hand/commit/2eb2bfe3169f5c1a0f6d24d9041a2965876ab972) page (https://github.com/badinkajink/hand/blob/2eb2bfe3169f5c1a0f6d24d9041a2965876ab972/docs/index.html)
25. 2026-11-10 · The SR2 pin-push with an unsensed pusher: contact point within 0.22 mm, force within 0.25 N of 0.45 N (post-reset step 14) · e0c123fe0 (https://github.com/badinkajink/hand/commit/e0c123fe00160b67f6b91a7bb1d7d6e3384aed54) page (https://github.com/badinkajink/hand/blob/e0c123fe00160b67f6b91a7bb1d7d6e3384aed54/docs/index.html)
26. 2026-11-10 · Inverse-dynamics torque control of the SR2 fingers under HOM against the SCS0009 position servos (post-reset step 9) · 6175313c1 (https://github.com/badinkajink/hand/commit/6175313c118935876e1dc2b81028c44c2312a8ac) page (https://github.com/badinkajink/hand/blob/6175313c118935876e1dc2b81028c44c2312a8ac/docs/index.html)
27. 2026-11-10 · Talk formulas as atomic LaTeX images: one idea per image, one canvas per series, a manifest shared by the page and the deck · d3dcdd914 (https://github.com/badinkajink/hand/commit/d3dcdd914b023114e6f9b8f0e64a2e9192188149) page (https://github.com/badinkajink/hand/blob/d3dcdd914b023114e6f9b8f0e64a2e9192188149/docs/index.html)
28. 2026-11-10 · Co-design formulation of the hand-design talk: one nested formula built up over the owner's slides 21-31, and its levels · f81cd63c3 (https://github.com/badinkajink/hand/commit/f81cd63c3f7182ac7a750beb48c2b8a60e212eef) page (https://github.com/badinkajink/hand/blob/f81cd63c3f7182ac7a750beb48c2b8a60e212eef/docs/index.html)
29. 2026-11-09 · Roll films with all three pads on the sphere, filmed from below; ties go to the larger three-pad share (owner, 11-09) · e4837be04 (https://github.com/badinkajink/hand/commit/e4837be04e0b03c6fc5ae30bd2e2516d6c09f1d5) page (https://github.com/badinkajink/hand/blob/e4837be04e0b03c6fc5ae30bd2e2516d6c09f1d5/docs/index.html)
30. 2026-11-09 · Tracking score for the HOM tasks, checked against the owner's verdicts, and films of re-picked layouts (owner, 11-09) · 68bdab8ba (https://github.com/badinkajink/hand/commit/68bdab8bac51b9c360cbadf12ccff670af6b759c) page (https://github.com/badinkajink/hand/blob/68bdab8bac51b9c360cbadf12ccff670af6b759c/docs/index.html)
31. 2026-11-09 · Layout search methods page: the EA of Yang et al., particle swarms, Sobol and the FP paper's RRT on the stored grids; CEM, Pareto fronts and t-SNE from first … · 5f9f3309d (https://github.com/badinkajink/hand/commit/5f9f3309dd8fb5e6f819d777f1079e37af9b0b82) page (https://github.com/badinkajink/hand/blob/5f9f3309dd8fb5e6f819d777f1079e37af9b0b82/docs/index.html)
32. 2026-11-08 · MuJoCo 4.0 against 3.6 for the sphere pads and the simulation components; hom_gpu's staticmethods restored · b3b1afc16 (https://github.com/badinkajink/hand/commit/b3b1afc16c8cfeda27c7885aeff3fbf80ffd897d) page (https://github.com/badinkajink/hand/blob/b3b1afc16c8cfeda27c7885aeff3fbf80ffd897d/docs/index.html)
33. 2026-11-06 · SR2 servo identification page (R36): dead band 0.59 deg, 0.55 N m/rad at the datasheet scale and 5.1 V, yaw friction +-23 to +-27 mN m · 9639ade26 (https://github.com/badinkajink/hand/commit/9639ade263e5d8aba9307b0f38872edd506e4260) page (https://github.com/badinkajink/hand/blob/9639ade263e5d8aba9307b0f38872edd506e4260/docs/index.html)
34. 2026-11-06 · HOM review page: Eq. (1) and the adjoint drawn, the contact filter explained and run on UR5 rolls · 283c6b482 (https://github.com/badinkajink/hand/commit/283c6b48254fda2d76d2e068547a485085afa079) page (https://github.com/badinkajink/hand/blob/283c6b48254fda2d76d2e068547a485085afa079/docs/index.html)
35. 2026-11-05 · SR2 crosstalk page with the HOM layouts: 11 layouts, 2,044 steps; the own-angle GP holds on layouts left out of its fit · 3f300b0a5 (https://github.com/badinkajink/hand/commit/3f300b0a59394aa9a452d79242916a99a63bb138) page (https://github.com/badinkajink/hand/blob/3f300b0a59394aa9a452d79242916a99a63bb138/docs/index.html)
36. 2026-11-05 · Object seating and tracking, steps 1 to 3 in simulation with the owner's changes of 11-05: a flat seat and a 40 mm arm lift keep the HOM cylinder scores, the … · 72fb9da6a (https://github.com/badinkajink/hand/commit/72fb9da6af31a32e95962a396e5a27832cc47f4d) page (https://github.com/badinkajink/hand/blob/72fb9da6af31a32e95962a396e5a27832cc47f4d/docs/index.html)
37. 2026-11-05 · Spearman fix on the plant-transfer rows and three pages, 01:0x on 11-05 (6aa06d6b2) · f15190386 (https://github.com/badinkajink/hand/commit/f15190386c4fe82c77eaca9c8587d87a70f60ade) page (https://github.com/badinkajink/hand/blob/f15190386c4fe82c77eaca9c8587d87a70f60ade/docs/index.html)
38. 2026-11-04 · cad_v3, 22:3x on 11-04: result page, film and clocking. The hand as built is at k = 1; a reading by eye had given k = 2. · 22cecc645 (https://github.com/badinkajink/hand/commit/22cecc6454114d1a59048de40e6694d94ad0d45c) page (https://github.com/badinkajink/hand/blob/22cecc6454114d1a59048de40e6694d94ad0d45c/docs/index.html)
39. 2026-11-04 · Fingertip-shape rerun, 21:2x on 11-04: the result page with the index refresh · 2dae56bc1 (https://github.com/badinkajink/hand/commit/2dae56bc15fe934fabe33d94ff38b89e0806ae75) page (https://github.com/badinkajink/hand/blob/2dae56bc15fe934fabe33d94ff38b89e0806ae75/docs/index.html)
40. 2026-11-04 · Fingertip crosstalk page: Section 4 on the SR2 hand from the coordinator's analysis of the sweep of 11-04 (scripts/sr2_crosstalk_night.py, 9a0e05a5). At the … · 7c47bc89e (https://github.com/badinkajink/hand/commit/7c47bc89ef16d23bff02aebf762f3068750cd566) page (https://github.com/badinkajink/hand/blob/7c47bc89ef16d23bff02aebf762f3068750cd566/docs/index.html)
41. 2026-11-04 · HOM grasp-genome EA, 16:3x on 11-04: Section 8 of the score refine page, the EA over layout and grasp · 6c0d155a3 (https://github.com/badinkajink/hand/commit/6c0d155a33a9007f40465386511e217ba1eace0c) page (https://github.com/badinkajink/hand/blob/6c0d155a33a9007f40465386511e217ba1eace0c/docs/index.html)
42. 2026-11-04 · HOM shared controller, 12:3x on 11-04: Section 7 of the score refine page, one set of forces and modes for all layouts · a7993fbfc (https://github.com/badinkajink/hand/commit/a7993fbfc15090d8e6594d7ee217dba08d4083ee) page (https://github.com/badinkajink/hand/blob/a7993fbfc15090d8e6594d7ee217dba08d4083ee/docs/index.html)
43. 2026-11-04 · HOM worst-case score, 09:3x on 11-04: Section 6 of the score refine page · 351ba39e3 (https://github.com/badinkajink/hand/commit/351ba39e33e9b4221e327aa3f784837968dc1332) page (https://github.com/badinkajink/hand/blob/351ba39e33e9b4221e327aa3f784837968dc1332/docs/index.html)
44. 2026-11-04 · HOM task conflict page, 03:4x on 11-04: one finger layout or several for the four HOM tasks, on performance alone · 85845f03e (https://github.com/badinkajink/hand/commit/85845f03e039ed8cd5d47cb6e50678618e635ea4) page (https://github.com/badinkajink/hand/blob/85845f03e039ed8cd5d47cb6e50678618e635ea4/docs/index.html)
45. 2026-11-04 · HOM score levels page, 02:3x on 11-04: refined grasps, forces and contact modes against the best of 16 grasps · 05f1ca731 (https://github.com/badinkajink/hand/commit/05f1ca7312d48c5f6bcb107fbfa381928c7c6326) page (https://github.com/badinkajink/hand/blob/05f1ca7312d48c5f6bcb107fbfa381928c7c6326/docs/index.html)
46. 2026-11-03 · SR² Hand in place of MorphoHand in the page headers, the home page and CLAUDE.md · cdf91ad3f (https://github.com/badinkajink/hand/commit/cdf91ad3f113923b90cf16fd38c5ca6b1f568477) page (https://github.com/badinkajink/hand/blob/cdf91ad3f113923b90cf16fd38c5ca6b1f568477/docs/index.html)
47. 2026-11-03 · HOM plant and modulus page: SR2 layouts across finger servos, pad moduli and scene friction · f84e2cd1c (https://github.com/badinkajink/hand/commit/f84e2cd1c27e0b635568ac216d31a0b2a46bc105) page (https://github.com/badinkajink/hand/blob/f84e2cd1c27e0b635568ac216d31a0b2a46bc105/docs/index.html)
48. 2026-11-02 · Revisions page of the documentation: every page's commits with links to its older versions on GitHub · 484cc151a (https://github.com/badinkajink/hand/commit/484cc151ad3c941b238a58a96b96fe00445eb97d) page (https://github.com/badinkajink/hand/blob/484cc151ad3c941b238a58a96b96fe00445eb97d/docs/index.html)
49. 2026-10-31 · HOM layouts clear of a table across object sizes: the constraint lowers the twist on spheres under 40 mm and the pin-push at every size, not the roll · 814eefedc (https://github.com/badinkajink/hand/commit/814eefedcc7106885e85639d4cd933f751dec9ed) page (https://github.com/badinkajink/hand/blob/814eefedcc7106885e85639d4cd933f751dec9ed/docs/index.html)
50. 2026-10-31 · HOM layouts from a table: grasps kept clear of the table keep the twist's and the roll's scores; the pin-push drops the cylinder where a finger presses on the … · ef7f91c5a (https://github.com/badinkajink/hand/commit/ef7f91c5adf870cf2002ee27290813cf06a8ef22) page (https://github.com/badinkajink/hand/blob/ef7f91c5adf870cf2002ee27290813cf06a8ef22/docs/index.html)
51. 2026-10-31 · HOM layouts across 19 object sizes: the trends page opens with the size trends, and the CPU checks and films use each search's own best layout · e6310c7a5 (https://github.com/badinkajink/hand/commit/e6310c7a5099c1d68ee6c49396c3006fd9c7d078) page (https://github.com/badinkajink/hand/blob/e6310c7a5099c1d68ee6c49396c3006fd9c7d078/docs/index.html)
52. 2026-10-31 · Contact pages read for a newcomer: the v3 page says why a softer pad needs a longer time constant, what the regulariser is, and which centroid the scenes' … · bbae93013 (https://github.com/badinkajink/hand/commit/bbae93013a5acb1c63aca212ff2c9dc60a4fb690) page (https://github.com/badinkajink/hand/blob/bbae93013a5acb1c63aca212ff2c9dc60a4fb690/docs/index.html)
53. 2026-10-30 · Inverted rig: exact check of the tool against the tip body; deepest presses keep 0.1 mm more on the tool's end · bbe38fc93 (https://github.com/badinkajink/hand/commit/bbe38fc93c26f76d96a65d9c43f2e2dbbb6d5e8a) page (https://github.com/badinkajink/hand/blob/bbe38fc93c26f76d96a65d9c43f2e2dbbb6d5e8a/docs/index.html)
54. 2026-10-30 · Inverted rig: pass 1 checked as the lab's converter writes it, and touch-offs on the tips' side walls (lab, 15:03 on 10-30) · d37468c18 (https://github.com/badinkajink/hand/commit/d37468c18a80289d8d7e5aa1305cf6200940f3b6) page (https://github.com/badinkajink/hand/blob/d37468c18a80289d8d7e5aa1305cf6200940f3b6/docs/index.html)
55. 2026-10-30 · Inverted rig: each probe action's deepest cleared press (deep_clear_mm), the lift labelled, the homing lift checked every 5 mm · 1912b4796 (https://github.com/badinkajink/hand/commit/1912b479669e63a8814e3aeca63bc76121fc4b5c) page (https://github.com/badinkajink/hand/blob/1912b479669e63a8814e3aeca63bc76121fc4b5c/docs/index.html)
56. 2026-10-30 · HOM design study: a third of the v4b sphere grasps overlap the index's and middle's caps at the touch pose, which the GPU evaluator's collision filter hides … · c821a6a07 (https://github.com/badinkajink/hand/commit/c821a6a0789ddbf8e9c75285eb855f0b2425438a) page (https://github.com/badinkajink/hand/blob/c821a6a0789ddbf8e9c75285eb855f0b2425438a/docs/index.html)
57. 2026-10-30 · Inverted rig: the seats on a low strip on one 2x4, the pads 40 mm over it, and the plate at 189 g · ac021c3dd (https://github.com/badinkajink/hand/commit/ac021c3ddeb289ba1ecc543d77894a58fdb67962) page (https://github.com/badinkajink/hand/blob/ac021c3ddeb289ba1ecc543d77894a58fdb67962/docs/index.html)
58. 2026-10-30 · Local refinement, EA baseline and a 2 ms MPC planner on the HOM evaluator. Around each of the 20 best twist layouts, the best of 64 layouts within 2 mm (picked … · 87032eb49 (https://github.com/badinkajink/hand/commit/87032eb493dd523f1136a5d2c06b7d5883004d03) page (https://github.com/badinkajink/hand/blob/87032eb493dd523f1136a5d2c06b7d5883004d03/docs/index.html)
59. 2026-10-30 · Inverted rig: seat block at v2e's place with every wood screw 35 mm or more from the columns, and tools seated on the boss's taper over captive M3 nuts · bb8f63ae9 (https://github.com/badinkajink/hand/commit/bb8f63ae9a5eceee9b1e319fc0bd92a8191207a9) page (https://github.com/badinkajink/hand/blob/bb8f63ae9a5eceee9b1e319fc0bd92a8191207a9/docs/index.html)
60. 2026-10-30 · HOM GPU controller captured as a CUDA graph in hom_gpu.Batch (capture_control, control_period: float masks, closed-form 3x3 solves, six phi-Newton steps, … · 5b82ab1cd (https://github.com/badinkajink/hand/commit/5b82ab1cd654488a26493a0240f8d1b7bed0a17b) page (https://github.com/badinkajink/hand/blob/5b82ab1cd654488a26493a0240f8d1b7bed0a17b/docs/index.html)
61. 2026-10-30 · Design page: the grid's best grasps on fresh seeds 3-5 and moved between layouts. Spheres keep the gain (twist +0.20 vs +0.21 on the picked seeds, roll +0.06 … · 92dd22b06 (https://github.com/badinkajink/hand/commit/92dd22b06d70abb97957310f44c5498c2e1d08bd) page (https://github.com/badinkajink/hand/blob/92dd22b06d70abb97957310f44c5498c2e1d08bd/docs/index.html)
62. 2026-10-30 · Design page: lede and summary on the night's results (grasp per layout and task, object size, narrow peaks) · 186276294 (https://github.com/badinkajink/hand/commit/186276294845008021edc19af5f636b828761215) page (https://github.com/badinkajink/hand/blob/186276294845008021edc19af5f636b828761215/docs/index.html)
63. 2026-10-30 · Design page: layouts across object sizes, spheres (twist and roll on 30-63 mm, 8,192 Sobol layouts, v4b tip) · de8f66057 (https://github.com/badinkajink/hand/commit/de8f66057b52982cbf4ec179d953c5d2799425ea) page (https://github.com/badinkajink/hand/blob/de8f66057b52982cbf4ec179d953c5d2799425ea/docs/index.html)
64. 2026-10-30 · HOM review page: model-predictive control over HOM's commands (first run and its cost) · 31709e69f (https://github.com/badinkajink/hand/commit/31709e69fefc156a5eb3b8894193968b69e4a93a) page (https://github.com/badinkajink/hand/blob/31709e69fefc156a5eb3b8894193968b69e4a93a/docs/index.html)
65. 2026-10-30 · Design page (foundational-pose review): the calibrated v4b fingertip, grasp sets per layout on the 2-D grid, related design studies, and the record of method … · f4463635f (https://github.com/badinkajink/hand/commit/f4463635fe59d299be3fa3aa0f7e5c9c1d051511) page (https://github.com/badinkajink/hand/blob/f4463635fe59d299be3fa3aa0f7e5c9c1d051511/docs/index.html)
66. 2026-10-30 · HOM controller code walkthrough (subpage of the HOM review page): eleven substeps of a 10 ms period on the v4b hand, with a twist and a pin-push · bdd55c247 (https://github.com/badinkajink/hand/commit/bdd55c247dc9958b7f2d72df3422027addcda1d0) page (https://github.com/badinkajink/hand/blob/bdd55c247dc9958b7f2d72df3422027addcda1d0/docs/index.html)
67. 2026-10-29 · Design page: four HOM tasks and sensing errors across 4,680 Sobol layouts on the GPU · c39d07868 (https://github.com/badinkajink/hand/commit/c39d07868ecebf08d0cbb98f0f7afd4bc8b17d17) page (https://github.com/badinkajink/hand/blob/c39d07868ecebf08d0cbb98f0f7afd4bc8b17d17/docs/index.html)
68. 2026-10-29 · Inverted calibration rig ready to print (owner, 10-29 15:2x): tips held pad up, three seats replayed, P1S projects · 84ea1b72d (https://github.com/badinkajink/hand/commit/84ea1b72db0f415bf405f0f3cc74b35e64b967b1) page (https://github.com/badinkajink/hand/blob/84ea1b72db0f415bf405f0f3cc74b35e64b967b1/docs/index.html)
69. 2026-10-29 · HOM on the GPU: batched controller on MuJoCo-Warp, validated against the CPU, and the dynamic landscapes of SR2 layouts · 879c66044 (https://github.com/badinkajink/hand/commit/879c66044ba08bfdf64068f8fe661342ef28d074) page (https://github.com/badinkajink/hand/blob/879c66044ba08bfdf64068f8fe661342ef28d074/docs/index.html)
70. 2026-10-29 · Review pages of the HOM and foundational-pose papers, with fingertip-sensing and layout-sampling toys · 66330a72c (https://github.com/badinkajink/hand/commit/66330a72c9f4a608ac9f6a78e09793b1c8365c97) page (https://github.com/badinkajink/hand/blob/66330a72c9f4a608ac9f6a78e09793b1c8365c97/docs/index.html)
71. 2026-10-29 · Inverted rig: probe on the HEX-E reaches 444 of 808 pad points on a held tip against 286 for the finger on the robot (owner, 13:0x on 10-29) · 33cfe6f3d (https://github.com/badinkajink/hand/commit/33cfe6f3dc662fadadd8df155c6114603fa29f4f) page (https://github.com/badinkajink/hand/blob/33cfe6f3dc662fadadd8df155c6114603fa29f4f/docs/index.html)
72. 2026-10-29 · Inverted rig page (first build): probe and plate v2e STLs, reach on six seat orientations, QUEUE R31 at 14:2x · ef453c6c8 (https://github.com/badinkajink/hand/commit/ef453c6c8dcb5d45a9efddafbf9d2d439c58d230) page (https://github.com/badinkajink/hand/blob/ef453c6c8dcb5d45a9efddafbf9d2d439c58d230/docs/index.html)
73. 2026-10-29 · Physical-model page with v3 ID 2: the model on the three N52 tips' shared sphere actions, and the signal per newton by region · 100ec8dba (https://github.com/badinkajink/hand/commit/100ec8dba6ac11b1b392a6f4fe9cab85a7c47893) page (https://github.com/badinkajink/hand/blob/100ec8dba6ac11b1b392a6f4fe9cab85a7c47893/docs/index.html)
74. 2026-10-29 · Calibration page: what each calibration motion adds on the four-magnet tips (feed line of 10-29 12:45, 9da437e0) · f3980846b (https://github.com/badinkajink/hand/commit/f3980846bd02bb0a626e752f4843214d86e58749) page (https://github.com/badinkajink/hand/blob/f3980846bd02bb0a626e752f4843214d86e58749/docs/index.html)
75. 2026-10-29 · Calibration motions page for the four-magnet tips: what each motion adds on v3 ID 1 and ID 2 (owner, 11:37 on 10-29: plate v2d waits "until we have 100% … · 9da437e01 (https://github.com/badinkajink/hand/commit/9da437e019a2d923ceba43eb82d58cba34c59565) page (https://github.com/badinkajink/hand/blob/9da437e019a2d923ceba43eb82d58cba34c59565/docs/index.html)
76. 2026-10-29 · Calibration page: four magnets against five on the tall indenter and on v3 ID 2 (feed lines of 10-29 10:28 and 10:29): Section 11's tall paragraph and Table 12 … · b37d77273 (https://github.com/badinkajink/hand/commit/b37d772738c0901e847ca5d15d6a7470da618bf5) page (https://github.com/badinkajink/hand/blob/b37d772738c0901e847ca5d15d6a7470da618bf5/docs/index.html)
77. 2026-10-29 · Calibration page: Section 12, v3 ID 2 against v3 ID 1 on the presses both ran (feed lines of 10-29 09:46 and 10:00): Table 14 on the sphere's 116, the rod's 75 … · f0cc0052f (https://github.com/badinkajink/hand/commit/f0cc0052f2f40f7845b196f7eb68647eaf2f72b8) page (https://github.com/badinkajink/hand/blob/f0cc0052f2f40f7845b196f7eb68647eaf2f72b8/docs/index.html)
78. 2026-10-28 · Calibration page: four magnets against five on the rod (feed line of 15:14) · 9c64f6f44 (https://github.com/badinkajink/hand/commit/9c64f6f44abc3446d78f3051ba17ff3e31cc7714) page (https://github.com/badinkajink/hand/blob/9c64f6f44abc3446d78f3051ba17ff3e31cc7714/docs/index.html)
79. 2026-10-28 · Calibration page: torsion on v3 ID 1's 12 twists against v2 ID 1's (feed line of 12:25) · 91bcfc2ed (https://github.com/badinkajink/hand/commit/91bcfc2ed4af383f8e589a8d7162c8d3c22ddc14) page (https://github.com/badinkajink/hand/blob/91bcfc2ed4af383f8e589a8d7162c8d3c22ddc14/docs/index.html)
80. 2026-10-28 · Physical-model page with four magnets (owner, 2026-10-28: "i think we will stick with the 4 magnet config"; the five-magnet figures stay in blocks under "View … · dc0a559a7 (https://github.com/badinkajink/hand/commit/dc0a559a7c457fc993617c7c11d01ab83115cf2e) page (https://github.com/badinkajink/hand/blob/dc0a559a7c457fc993617c7c11d01ab83115cf2e/docs/index.html)
81. 2026-10-28 · Indenter plate page: the full replay of v2d (every sample, travel included): 84 side hovers, 162 tall and 318 of 337 sphere actions clear; no flag names … · b37050ee3 (https://github.com/badinkajink/hand/commit/b37050ee38ebd2097d684f90d59476b1fa63105f) page (https://github.com/badinkajink/hand/blob/b37050ee38ebd2097d684f90d59476b1fa63105f/docs/index.html)
82. 2026-10-28 · Indenter plate layout: the lab's plans replayed on the printed plate and on a proposed layout (page, tool, STL) · 7661b2042 (https://github.com/badinkajink/hand/commit/7661b204280e2dbd8d04774e2edf6e7f3a69af04) page (https://github.com/badinkajink/hand/blob/7661b204280e2dbd8d04774e2edf6e7f3a69af04/docs/index.html)
83. 2026-10-28 · Fingertip crosstalk page: the neighbour's change as a face force against the gap (feed line of 01:28; owner, 01:2x: "at what distances do the effects resolve, … · 45f73937f (https://github.com/badinkajink/hand/commit/45f73937f4b54b4b277b790c3ca92f3992044486) page (https://github.com/badinkajink/hand/blob/45f73937f4b54b4b277b790c3ca92f3992044486/docs/index.html)
84. 2026-10-28 · Calibration page: v2 ID 1 and v3 ID 1 (owner, 10-28: "are the calibration plots and data/results ... up to date for our results from 10-27 and just now with … · 126a2c40c (https://github.com/badinkajink/hand/commit/126a2c40c3e9837d0f25d9691aad320b29688680) page (https://github.com/badinkajink/hand/blob/126a2c40c3e9837d0f25d9691aad320b29688680/docs/index.html)
85. 2026-10-28 · Fingertip crosstalk page: the press signal per newton from stage 2's whole grid (feed line of 00:59) · cacda5fe8 (https://github.com/badinkajink/hand/commit/cacda5fe8ad164725b7140206d197144c918763b) page (https://github.com/badinkajink/hand/blob/cacda5fe8ad164725b7140206d197144c918763b/docs/index.html)
86. 2026-10-28 · Fingertip crosstalk page: v3 ID 1's press signal per newton beside the measured crosstalk (feed line of 00:18) · c4eed5a34 (https://github.com/badinkajink/hand/commit/c4eed5a34ffa1bfc624c26650b37020c8d617ce3) page (https://github.com/badinkajink/hand/blob/c4eed5a34ffa1bfc624c26650b37020c8d617ce3/docs/index.html)
87. 2026-10-27 · Fingertip crosstalk page: the close hovers over the -y held tip join the holder map · dc8b64789 (https://github.com/badinkajink/hand/commit/dc8b647892413a4cca2a2326dbbc24e811ad7ab2) page (https://github.com/badinkajink/hand/blob/dc8b647892413a4cca2a2326dbbc24e811ad7ab2/docs/index.html)
88. 2026-10-27 · Fingertip crosstalk page: the holder map's 89 hovers against the net moments fitted on the touch-offs · 80fcc035b (https://github.com/badinkajink/hand/commit/80fcc035ba7199f63586b90835cefc5671a18299) page (https://github.com/badinkajink/hand/blob/80fcc035ba7199f63586b90835cefc5671a18299/docs/index.html)
89. 2026-10-27 · Status page: the v3 holder map, the crosstalk's net moments and tonight's suite; the owner's morning decisions · 9222c62fd (https://github.com/badinkajink/hand/commit/9222c62fd91291e59bde316ff486b7ebccc4fec2) page (https://github.com/badinkajink/hand/blob/9222c62fd91291e59bde316ff486b7ebccc4fec2/docs/index.html)
90. 2026-10-27 · Calibration page, Figure 1: the UR5 cell rendered in MuJoCo (owner, 10-27), the pad at a face and a flank touch-off · 8a45a8d8f (https://github.com/badinkajink/hand/commit/8a45a8d8f2fc3dc6f8fdfe33291e09f8d1f3d66c) page (https://github.com/badinkajink/hand/blob/8a45a8d8f2fc3dc6f8fdfe33291e09f8d1f3d66c/docs/index.html)
91. 2026-10-27 · Physical-model page with the N52 tip v2 ID 1, and the crosstalk page's future work as in the v3 plan · 89954a114 (https://github.com/badinkajink/hand/commit/89954a114103e865b422ac3a778acda8f51f57e0) page (https://github.com/badinkajink/hand/blob/89954a114103e865b422ac3a778acda8f51f57e0/docs/index.html)
92. 2026-10-27 · Fingertip overview and calibration page with the first-order numbers of 10-27 and the crosstalk (hand-off 20261027, step 5) · fe7c24b46 (https://github.com/badinkajink/hand/commit/fe7c24b461be2b472ff7ee54274e000f1ca9f7b6) page (https://github.com/badinkajink/hand/blob/fe7c24b461be2b472ff7ee54274e000f1ca9f7b6/docs/index.html)
93. 2026-10-27 · Page on magnetic crosstalk between neighbouring fingertips (hand-off 20261027, step 4) · 8e301f80f (https://github.com/badinkajink/hand/commit/8e301f80f8e7e14d990765f4c6c6a1f99d493d3b) page (https://github.com/badinkajink/hand/blob/8e301f80f8e7e14d990765f4c6c6a1f99d493d3b/docs/index.html)
94. 2026-10-27 · Impratio 10 to 300 and noslip under the trainer's numerics, and what the divergence is (hand-off 20261027, steps 1-2) · cb1638a7a (https://github.com/badinkajink/hand/commit/cb1638a7a8918d095bd6bff3a142545008ff3dbc) page (https://github.com/badinkajink/hand/blob/cb1638a7a8918d095bd6bff3a142545008ff3dbc/docs/index.html)
95. 2026-10-27 · Calibration page, Figure 2: the pad's section faces down onto the sphere (owner, 2026-10-27: "the pad seems to be facing up, not down ... the flat back … · 0bc691046 (https://github.com/badinkajink/hand/commit/0bc691046b628fed49e40fc715e5f01a9143029f) page (https://github.com/badinkajink/hand/blob/0bc691046b628fed49e40fc715e5f01a9143029f/docs/index.html)
96. 2026-10-27 · Page on the three v1 fingertips' night at rest: prose from the final numbers of 19:35-04:00 (readout passes, no contact at 2 uT and one frame at 1 uT, the … · a076be822 (https://github.com/badinkajink/hand/commit/a076be8225333ede681d8615eadd19f7b42affbe) page (https://github.com/badinkajink/hand/blob/a076be8225333ede681d8615eadd19f7b42affbe/docs/index.html)
97. 2026-10-26 · Shear page and contact overview at the friction coefficient from the shear's magnitude (hand-off 20261026-shear_friction_impratio, step 5). The skin replays of … · 8d99dd5f3 (https://github.com/badinkajink/hand/commit/8d99dd5f383eb0ed6d2b9e045194ba196817ff59) page (https://github.com/badinkajink/hand/blob/8d99dd5f383eb0ed6d2b9e045194ba196817ff59/docs/index.html)
98. 2026-10-26 · Result page: shear, friction coefficient and impratio of the printed fingertip against the UR5 slides (hand-off 20261026-shear_friction_impratio, step 5, … · 119af3a3a (https://github.com/badinkajink/hand/commit/119af3a3a56cdc7dcddb8010b4aed6f837195df6) page (https://github.com/badinkajink/hand/blob/119af3a3a56cdc7dcddb8010b4aed6f837195df6/docs/index.html)
99. 2026-10-26 · Fingertip calibration page (owner, 2026-10-26: the calibration's motions, geometry, desired sensing result, the protocol formalized, the learning architecture … · 3a982fad1 (https://github.com/badinkajink/hand/commit/3a982fad17a6d26b50fc0f5426f4ecc01e982145) page (https://github.com/badinkajink/hand/blob/3a982fad17a6d26b50fc0f5426f4ecc01e982145/docs/index.html)
100. 2026-10-26 · Fingertip physical model page (owner, 2026-10-26: understand the FEA, the printed tip and the magnetic sensing that make the physical model). One page explains … · 8e425c2b6 (https://github.com/badinkajink/hand/commit/8e425c2b6f8d5f4655a8b0ea15916f24d2150242) page (https://github.com/badinkajink/hand/blob/8e425c2b6f8d5f4655a8b0ea15916f24d2150242/docs/index.html)
101. 2026-10-25 · UR5 calibration: cb1t follows the plan (owner, 10-25: poles named from the board's side) and its magnets are sphere2's; R24 for v1 ID 2 on mount v6 · 88f961d97 (https://github.com/badinkajink/hand/commit/88f961d97865874fab81155b987d20aa20e3c337) page (https://github.com/badinkajink/hand/blob/88f961d97865874fab81155b987d20aa20e3c337/docs/index.html)
102. 2026-10-24 · UR5 calibration (R22): cb1t's poles stated for both readings of the plan, the overview, the status page and QUEUE.md · e6497529a (https://github.com/badinkajink/hand/commit/e6497529a42b4e5c91f845585e22e917c55a039c) page (https://github.com/badinkajink/hand/blob/e6497529a42b4e5c91f845585e22e917c55a039c/docs/index.html)
103. 2026-10-24 · UR5 calibration (R22): cb1t analysed, the first checkerboard fingertip. Of the 32 pole patterns, (+1, -1, -1, -1, +1) fits the field at rest at 0.24 mT: the … · 7f9c3186f (https://github.com/badinkajink/hand/commit/7f9c3186f390239e773e3ffd2e158cbc704f08f0) page (https://github.com/badinkajink/hand/blob/7f9c3186f390239e773e3ffd2e158cbc704f08f0/docs/index.html)
104. 2026-10-23 · ATI calibration (17:52): a base and top for the Mini40 from ATI's drawings, its robot plan and its simulated sessions; the stack script takes --sensor · d3aa72265 (https://github.com/badinkajink/hand/commit/d3aa72265b665e60abdb5bbaf196675254b96bc4) page (https://github.com/badinkajink/hand/blob/d3aa72265b665e60abdb5bbaf196675254b96bc4/docs/index.html)
105. 2026-10-23 · Contact estimator: a test against fields from outside the pad rejects steel touched to the fingertip (viewer toggle, key f) · a710bd23a (https://github.com/badinkajink/hand/commit/a710bd23a40d062c2e47beefb778834f03619b9c) page (https://github.com/badinkajink/hand/blob/a710bd23a40d062c2e47beefb778834f03619b9c/docs/index.html)
106. 2026-10-23 · UR5 calibration (R21 done): last night's predictors hold a day later; results page Section 9 · 0a353b20c (https://github.com/badinkajink/hand/commit/0a353b20cbf360e0d3173b822217c0789114b4f9) page (https://github.com/badinkajink/hand/blob/0a353b20cbf360e0d3173b822217c0789114b4f9/docs/index.html)
107. 2026-10-23 · UR5 calibration (R19): rod run analysed with a joint registration of three sessions; the extra travel splits into at most 0.10 mm/N in series and the rest at … · 84ddf7556 (https://github.com/badinkajink/hand/commit/84ddf7556aec9df722a8ac7c8ecf8a67edaed61f) page (https://github.com/badinkajink/hand/blob/84ddf7556aec9df722a8ac7c8ecf8a67edaed61f/docs/index.html)
108. 2026-10-23 · ATI calibration (13:13): a printed holder for the lab's 100 g weight, and the calibration's error against the hung mass · 555db445a (https://github.com/badinkajink/hand/commit/555db445a188add0e2f33149ad05f187fe2ef195) page (https://github.com/badinkajink/hand/blob/555db445a188add0e2f33149ad05f187fe2ef195/docs/index.html)
109. 2026-10-23 · Second fingertip page (owner, 10-23: "make sure this transfer is documented well"): the UR5 fingertip's calibration applied to the desk's fingertip, whose two … · 30f1d2811 (https://github.com/badinkajink/hand/commit/30f1d2811c5339ac651915846346f8e639b40f22) page (https://github.com/badinkajink/hand/blob/30f1d2811c5339ac651915846346f8e639b40f22/docs/index.html)
110. 2026-10-23 · ATI calibration (owner, 11:05 on 10-23: "design a mount for the ATI for the HEX-E and build up a calibration plan ... the Z-axis is the noisiest axis ... maybe … · 6e1e77025 (https://github.com/badinkajink/hand/commit/6e1e77025f2c5c07a57a5d79d00f089c839cd5f2) page (https://github.com/badinkajink/hand/blob/6e1e77025f2c5c07a57a5d79d00f089c839cd5f2/docs/index.html)
111. 2026-10-23 · UR5 calibration mount v5 (owner, after v4's fork went to the P1S: the lab has the heat-set inserts but no brass set screws or nuts; "a constraining v5 that … · 260d93fc4 (https://github.com/badinkajink/hand/commit/260d93fc433de48a782a86017ee8649ea1dd495e) page (https://github.com/badinkajink/hand/blob/260d93fc433de48a782a86017ee8649ea1dd495e/docs/index.html)
112. 2026-10-23 · ATI Mini45 calibration plan (owner, 10-23: replace the HEX-E with a calibrated ATI; a printed mount on the HEX-E with the current indenter setup): presses … · ba8f47e4a (https://github.com/badinkajink/hand/commit/ba8f47e4ac9a827461e71db2be893d84bade8ae7) page (https://github.com/badinkajink/hand/blob/ba8f47e4ac9a827461e71db2be893d84bade8ae7/docs/index.html)
113. 2026-10-23 · Docs index: the UR5 board drift page under 23 October (d0f7348e), its artifact kept · f850b8db7 (https://github.com/badinkajink/hand/commit/f850b8db761a2fdccbe6493be6904b1917b86b78) page (https://github.com/badinkajink/hand/blob/f850b8db761a2fdccbe6493be6904b1917b86b78/docs/index.html)
114. 2026-10-23 · Docs index with the UR5 board drift page (c521db5a) and its artifact (claude.ai/artifact/JjpJFq6Ez2TNfyjDmMtd3A) in its own INDEX.md row · 84df9b10b (https://github.com/badinkajink/hand/commit/84df9b10b7071bb3aa9c2d4f33ea9f0646f258e4) page (https://github.com/badinkajink/hand/blob/84df9b10b7071bb3aa9c2d4f33ea9f0646f258e4/docs/index.html)
115. 2026-10-23 · UR5 calibration mount v4 (R18, the owner's request through the lab: the DIP link moves in v3's fork): v3 with a stop plate behind the tongue and three brass M3 … · 0c2ea7865 (https://github.com/badinkajink/hand/commit/0c2ea7865ec66d942018676b1a0e295c77f58e92) page (https://github.com/badinkajink/hand/blob/0c2ea7865ec66d942018676b1a0e295c77f58e92/docs/index.html)
116. 2026-10-22 · Docs index with the UR5 lab page (97caa02a), run on the workstation for the lab's clone; the results page now links the lab page · 60481f5bc (https://github.com/badinkajink/hand/commit/60481f5bcec93ce7d3df2051c21191ab490089c8) page (https://github.com/badinkajink/hand/blob/60481f5bcec93ce7d3df2051c21191ab490089c8/docs/index.html)
117. 2026-10-22 · UR5 calibration: grid-061, -065, -066 and -067 left out of the ground truth (0.3 to 0.4 N on the HEX-E off the pad, the lab's finding), results rerun: … · 672642800 (https://github.com/badinkajink/hand/commit/672642800f42b498d532ef80403179f90ed27b9f) page (https://github.com/badinkajink/hand/blob/672642800f42b498d532ef80403179f90ed27b9f/docs/index.html)
118. 2026-10-22 · UR5 calibration results on the whole sphere2 session (451 holds): FE force 5.1 times the measured at the registered positions while the board reads 0.78-0.96 … · d42db5bf1 (https://github.com/badinkajink/hand/commit/d42db5bf1975f5772dff3d5a3e6d3f240a653812) page (https://github.com/badinkajink/hand/blob/d42db5bf1975f5772dff3d5a3e6d3f240a653812/docs/index.html)
119. 2026-10-22 · UR5 calibration results page (scripts/ur5_tip_calibration_results_page.py): pad compliance against the FE model, the board against the HEX-E, the pivot check, … · b34784f64 (https://github.com/badinkajink/hand/commit/b34784f64508c9d0e4bf76947e83a3095f661967) page (https://github.com/badinkajink/hand/blob/b34784f64508c9d0e4bf76947e83a3095f661967/docs/index.html)
120. 2026-10-22 · Plain-language pass of the real_v1 design search page, in its source report_search.src.html and rebuilt (2026-10-22): mean 19.2 to 18.3 words a sentence, over … · 7c0b8c94c (https://github.com/badinkajink/hand/commit/7c0b8c94c62d7f607880bbfa9e066fc35aa1af2a) page (https://github.com/badinkajink/hand/blob/7c0b8c94c62d7f607880bbfa9e066fc35aa1af2a/docs/index.html)
121. 2026-10-22 · Plain-language pass of the control diagnosis and HOM tasks across object sizes pages (2026-10-22): means 22.6 to 20.6 and 26.7 to 25.1 words a sentence; judge … · 8bcc85589 (https://github.com/badinkajink/hand/commit/8bcc855894f867b5144995d421b54c2ea4ba505f) page (https://github.com/badinkajink/hand/blob/8bcc855894f867b5144995d421b54c2ea4ba505f/docs/index.html)
122. 2026-10-22 · Plain-language pass of the DIP link board mount and fit-print (run b) pages (2026-10-22): means 27.8 to 26.5 and 31.2 to 27.1 words a sentence; judge 11 of 14 … · de59c7814 (https://github.com/badinkajink/hand/commit/de59c78144c273f802f74612d50e0b282d400bf5) page (https://github.com/badinkajink/hand/blob/de59c78144c273f802f74612d50e0b282d400bf5/docs/index.html)
123. 2026-10-22 · Documentation home page in plain prose: mean 24.2 to 18.1 words a sentence, over 30 words 29.0 to 9.3 % (plain-language pass of 2026-10-22; gate PASS, judge 9 … · a510f7712 (https://github.com/badinkajink/hand/commit/a510f77125de0430fd9d1f42ee6a86d6cd5da282) page (https://github.com/badinkajink/hand/blob/a510f77125de0430fd9d1f42ee6a86d6cd5da282/docs/index.html)
124. 2026-10-22 · Snug sets 3S and 2S: the 11:30 interference taken out on the B05R pads (owner, 2026-10-22 16:37: 'let's setup a print for both the 2t and 3t settings that … · b7b8327f0 (https://github.com/badinkajink/hand/commit/b7b8327f09099e913d661679c7677fccf6a628e7) page (https://github.com/badinkajink/hand/blob/b7b8327f09099e913d661679c7677fccf6a628e7/docs/index.html)
125. 2026-10-22 · Cover 2T and cap TW15H2: the sweep's 2 mm pair with 3T's tighter rails (owner, 2026-10-22 16:17: 'can you also prepare cassettes + top covers at the lowest … · d6b8577f9 (https://github.com/badinkajink/hand/commit/d6b8577f9b52acd3e71999939bff3a3b62efd75b) page (https://github.com/badinkajink/hand/blob/d6b8577f9b52acd3e71999939bff3a3b62efd75b/docs/index.html)
126. 2026-10-22 · Calibration protocol of the fingertip on the UR5 (CB3) and the OptoForce HEX-E, with a program, a simulator and a simulated session (owner, 2026-10-22: "we're … · a82f79b55 (https://github.com/badinkajink/hand/commit/a82f79b55cb8b5389d7c4e3f41eed840d6cb2cd7) page (https://github.com/badinkajink/hand/blob/a82f79b55cb8b5389d7c4e3f41eed840d6cb2cd7/docs/index.html)
127. 2026-10-22 · Pole pattern of the fingertip's five magnets: all one way against the checkerboard and two others, for sensing and for a neighbouring fingertip's field · f45427bd7 (https://github.com/badinkajink/hand/commit/f45427bd70ace21360df724a2e5d2e1cf4392316) page (https://github.com/badinkajink/hand/blob/f45427bd70ace21360df724a2e5d2e1cf4392316/docs/index.html)
128. 2026-10-22 · UR5e mount v3: brass heat-set inserts for the foot's M3 screws in the adapter (owner, 2026-10-22 12:22: 'let's not go for self-threaded m3 holes there and just … · 48530e4dd (https://github.com/badinkajink/hand/commit/48530e4ddd37a1b84c12148ea5efbbeaf8b7dfd0) page (https://github.com/badinkajink/hand/blob/48530e4ddd37a1b84c12148ea5efbbeaf8b7dfd0/docs/index.html)
129. 2026-10-22 · Chosen 3 mm cover and cap with tighter rails and a smaller pin hole (owner, 2026-10-22 11:30: 'for the new fingers with the hole in the top, we should really … · 2a88d1ad3 (https://github.com/badinkajink/hand/commit/2a88d1ad39a5246e087e2d99d087bd7b1111bc55) page (https://github.com/badinkajink/hand/blob/2a88d1ad39a5246e087e2d99d087bd7b1111bc55/docs/index.html)
130. 2026-10-22 · HOM results page: MPC baseline and pin-push drive force and lever sections, lede and future work · 863fd6a09 (https://github.com/badinkajink/hand/commit/863fd6a096b112ce49a0013a13bebbd075f2c918) page (https://github.com/badinkajink/hand/blob/863fd6a096b112ce49a0013a13bebbd075f2c918/docs/index.html)
131. 2026-10-22 · HOM pages and rows for the demonstrated tasks: friction pin-pusher, press, roll along the thumb, twist · 580b61868 (https://github.com/badinkajink/hand/commit/580b618684302901882c84dda164b69169f38900) page (https://github.com/badinkajink/hand/blob/580b618684302901882c84dda164b69169f38900/docs/index.html)
132. 2026-10-21 · HOM pages: wording (container verbs, an inflated qualifier) · 338fe9b10 (https://github.com/badinkajink/hand/commit/338fe9b10d3f368e114131ed4ecad6f4db9522c3) page (https://github.com/badinkajink/hand/blob/338fe9b10d3f368e114131ed4ecad6f4db9522c3/docs/index.html)
133. 2026-10-21 · HOM pages: the filter's input in object-twist tasks and k_max against the control period; estimator section on the results page (appears with … · 1f4e3ed9f (https://github.com/badinkajink/hand/commit/1f4e3ed9f71d1259ad096f887d48e28e78a31eb4) page (https://github.com/badinkajink/hand/blob/1f4e3ed9f71d1259ad096f887d48e28e78a31eb4/docs/index.html)
134. 2026-10-21 · HOM pages: the length scale of Eq. 2 in the tasks (ell 100 mm and SI lose every cylinder pick), deployment variants table; filter-sweep subcommand · ac45eec46 (https://github.com/badinkajink/hand/commit/ac45eec46b7ca01b54b096c49c954d888252c23a) page (https://github.com/badinkajink/hand/blob/ac45eec46b7ca01b54b096c49c954d888252c23a/docs/index.html)
135. 2026-10-21 · Method page: Exp. A on the library and the units of Eq. 2 (Table 4, film); weights row and future work updated · ccee432c9 (https://github.com/badinkajink/hand/commit/ccee432c939c15d302b8e52456fca19313aa32a2) page (https://github.com/badinkajink/hand/blob/ccee432c939c15d302b8e52456fca19313aa32a2/docs/index.html)
136. 2026-10-21 · Pages: the HOM controller's method and MuJoCo implementation, and four tasks across object sizes (first build) · f43194929 (https://github.com/badinkajink/hand/commit/f43194929a46fc0128385e0868bbbba02cdacbea) page (https://github.com/badinkajink/hand/blob/f43194929a46fc0128385e0868bbbba02cdacbea/docs/index.html)
137. 2026-10-21 · UR5e calibration mount v3 for M6 x 20 screws tightened from above (owner, 2026-10-21 17:54: 'i only have 20mm long m6 screws. so we need to pop everything up a … · 38559592c (https://github.com/badinkajink/hand/commit/38559592ca8808e2055b8ed4b174ca59d9f405fe) page (https://github.com/badinkajink/hand/blob/38559592ca8808e2055b8ed4b174ca59d9f405fe/docs/index.html)
138. 2026-10-21 · DIP link b v4 and a sweep of retaining-wall heights (owner, 2026-10-21 16:20: 'the 0.15mm inset is still perfectly fine ... lower the heights on both the top … · 3d321adfd (https://github.com/badinkajink/hand/commit/3d321adfd7c7d2de9b442ca4214c4967811688f9) page (https://github.com/badinkajink/hand/blob/3d321adfd7c7d2de9b442ca4214c4967811688f9/docs/index.html)
139. 2026-10-21 · Solid-wall covers, raised proximal screws and stronger tip caps for b v3 (owner, 2026-10-21 14:25: the pad still snaps out of cover W00 and a wall's 'bottom … · 66a002acd (https://github.com/badinkajink/hand/commit/66a002acd45e86570aeb027c882697b9e824abb6) page (https://github.com/badinkajink/hand/blob/66a002acd45e86570aeb027c882697b9e824abb6/docs/index.html)
140. 2026-10-21 · Page on spherical and disc N52 magnets in the B00 fingertip pad: a 3 mm sphere resolves 0.0285 N against the disc's 0.0304 N; spheres of 4 mm and more exceed … · 09a42008e (https://github.com/badinkajink/hand/commit/09a42008ecc4cd25a6c7a16fa7e275a16585771e) page (https://github.com/badinkajink/hand/blob/09a42008ecc4cd25a6c7a16fa7e275a16585771e/docs/index.html)
141. 2026-10-21 · Drift of the fingertip board's rest reading: the contact viewer corrects each chip for its temperature, adds a 2 uT noise floor and re-zeros at rest; the … · e010edda3 (https://github.com/badinkajink/hand/commit/e010edda33b5edf1ec4ac478dad1938dc1084c0f) page (https://github.com/badinkajink/hand/blob/e010edda33b5edf1ec4ac478dad1938dc1084c0f/docs/index.html)
142. 2026-10-20 · Tip caps TP and TW for b v3 (owner, 20:36: 'sure we can go with your recommendation'): scripts/dip_b_tip_cap.py builds, on concept b's kernels, an end plate … · 83c38348c (https://github.com/badinkajink/hand/commit/83c38348c8cff1e4dbd2d2b29cd953605dcc5d97) page (https://github.com/badinkajink/hand/blob/83c38348c8cff1e4dbd2d2b29cd953605dcc5d97/docs/index.html)
143. 2026-10-20 · Result pages describe themselves, and every index follows them · 8b0a9a22c (https://github.com/badinkajink/hand/commit/8b0a9a22cd3a6f7e809ef87577a4f23b4baa1f1a) page (https://github.com/badinkajink/hand/blob/8b0a9a22cd3a6f7e809ef87577a4f23b4baa1f1a/docs/index.html)
144. 2026-10-20 · DIP link b v3 and UR5e mount v2 after the first prints: owner chose b; cover walls 3.0 mm along the pad's flanks (approach -0.35 % at 6 N, force resolution … · fa55ce04b (https://github.com/badinkajink/hand/commit/fa55ce04b48b92a22efc94cbed4487b64f41fb4e) page (https://github.com/badinkajink/hand/blob/fa55ce04b48b92a22efc94cbed4487b64f41fb4e/docs/index.html)
145. 2026-10-19 · DIP-link fit tests of 2026-10-19 on one plate per printer, every piece with a printed ID · 16974bfd4 (https://github.com/badinkajink/hand/commit/16974bfd4645d827633d81061eb008c6e66afe36) page (https://github.com/badinkajink/hand/blob/16974bfd4645d827633d81061eb008c6e66afe36/docs/index.html)
146. 2026-10-18 · INDEX rows for the calibration and DIP pages (artifacts pending); home page and page index rebuilt; the fingertip overview links the DIP, calibration, … · 0e6c03add (https://github.com/badinkajink/hand/commit/0e6c03add46db53941f1e9514f764f63879ca128) page (https://github.com/badinkajink/hand/blob/0e6c03add46db53941f1e9514f764f63879ca128/docs/index.html)
147. 2026-10-16 · Fingertip readiness page, INDEX row, overview links and the 13 CAD-hand variant scenes · 3b16e1ca7 (https://github.com/badinkajink/hand/commit/3b16e1ca74b7068f920297298bcf37aa4b55309f) page (https://github.com/badinkajink/hand/blob/3b16e1ca74b7068f920297298bcf37aa4b55309f/docs/index.html)
148. 2026-10-14 · Docs index published as an artifact; design overview and index list the CAD-hand page · a824ccb6a (https://github.com/badinkajink/hand/commit/a824ccb6afd42608f2915e7748a64e81d9edf1b7) page (https://github.com/badinkajink/hand/blob/a824ccb6afd42608f2915e7748a64e81d9edf1b7/docs/index.html)
149. 2026-10-14 · Docs: index of all result pages, printed-fingertip topic overview, overviews rebuilt with the missing pages; FE films of the whole tip queued · da06ee8f7 (https://github.com/badinkajink/hand/commit/da06ee8f7e41a6ed48a82de0fd0e1a73772df0fc) page (https://github.com/badinkajink/hand/blob/da06ee8f7e41a6ed48a82de0fd0e1a73772df0fc/docs/index.html)
150. 2026-10-11 · mkdocs site folded into the HTML docs: docs/overviews/code_and_methods.html (code map, the path of one real_v1 hand from a Sobol sample to a bench plan, grasp … · 5521d1f58 (https://github.com/badinkajink/hand/commit/5521d1f58ee7e0c4ff2c3c724338c37d7e75bb0d) page (https://github.com/badinkajink/hand/blob/5521d1f58ee7e0c4ff2c3c724338c37d7e75bb0d/docs/index.html)
151. 2026-10-10 · Codex contact films (step 13): the 138 films that the four Codex pages reference (articulated transfer 3, contact videos 68, controller timestep 42, task … · 7e61a4cbe (https://github.com/badinkajink/hand/commit/7e61a4cbe2f9a303cfea2e40030204c1d8fb1623) page (https://github.com/badinkajink/hand/blob/7e61a4cbe2f9a303cfea2e40030204c1d8fb1623/docs/index.html)
152. 2026-10-10 · Four page titles set to their INDEX subjects (turn mechanism: 'Reorientation mechanism on the shipped, calibrated and bench plants', subject rewritten without … · c6519db37 (https://github.com/badinkajink/hand/commit/c6519db37b658269581f94e55405a9349e219a68) page (https://github.com/badinkajink/hand/blob/c6519db37b658269581f94e55405a9349e219a68/docs/index.html)
153. 2026-10-09 · Contact overview at its stable name docs/overviews/contact_model.html (owner, 2026-10-09): contact_overview_page.py writes there, its eyebrow links the home … · 42e41ba9f (https://github.com/badinkajink/hand/commit/42e41ba9f7d7a455bcc4ede2ccc3906ece81fa52) page (https://github.com/badinkajink/hand/blob/42e41ba9f7d7a455bcc4ede2ccc3906ece81fa52/docs/index.html)
154. 2026-10-09 · Topic overview docs/overviews/morphology_design.html: the search funnel and bench ranking (8,198 -> 227 -> 8 built, 48 of 77 held, rho_s 0.50), what predicts a … · 86d8fdd3b (https://github.com/badinkajink/hand/commit/86d8fdd3bd2427bbcb3a40d91ed73fbff197b51a) page (https://github.com/badinkajink/hand/blob/86d8fdd3bd2427bbcb3a40d91ed73fbff197b51a/docs/index.html)
155. 2026-10-09 · Topic overview docs/overviews/hand_plant_bench.html: the hand, the servo as a spring with a cutoff, the three simulated servo models and what the bench … · fa882344f (https://github.com/badinkajink/hand/commit/fa882344fd78fd6b9e24962cabe1d59e60a5af93) page (https://github.com/badinkajink/hand/blob/fa882344fd78fd6b9e24962cabe1d59e60a5af93/docs/index.html)
156. 2026-10-09 · Topic overview docs/overviews/grasp_to_gait_chain.html: bench transfer of the open-loop turn (48 of 77, rho_s 0.50), the chain in simulation on a UR5e, the … · f03394351 (https://github.com/badinkajink/hand/commit/f0339435130885d90f6f2e0fd82a854af607cc80) page (https://github.com/badinkajink/hand/blob/f0339435130885d90f6f2e0fd82a854af607cc80/docs/index.html)
157. 2026-10-09 · Topic overview docs/overviews/rl_policies.html: policy structure and training cost, the three servo plants, seed draws and evaluation under jitter, fingertip … · 7e4728fe9 (https://github.com/badinkajink/hand/commit/7e4728fe970e5e726730816b32ad3ed3af4dfac8) page (https://github.com/badinkajink/hand/blob/7e4728fe970e5e726730816b32ad3ed3af4dfac8/docs/index.html)
158. 2026-10-09 · Figure check measures charts in the page's own layout (grids of small charts included); retro_style stacks two-up chart grids (.duo, .pair, .two, .grid2, … · 817d46977 (https://github.com/badinkajink/hand/commit/817d469776605f843011a852683d6dce30451fd8) page (https://github.com/badinkajink/hand/blob/817d469776605f843011a852683d6dce30451fd8/docs/index.html)
159. 2026-10-09 · retro_style: identifier chips (.m), kbd and samp in plain monospace with no background; the template's chip colour rendered them as black boxes in the plain … · 4bce80097 (https://github.com/badinkajink/hand/commit/4bce800970e454f2d3a80bd570d519b1900fa4da) page (https://github.com/badinkajink/hand/blob/4bce800970e454f2d3a80bd570d519b1900fa4da/docs/index.html)
160. 2026-10-09 · Topic overview docs/overviews/reorientation.html (scripts/topic_overview_page.py + overview_mechanisms_text.py): the fixed-contact turn and its extension cost, … · 926d2d7d3 (https://github.com/badinkajink/hand/commit/926d2d7d3d01502899100410a20e84251a106b48) page (https://github.com/badinkajink/hand/blob/926d2d7d3d01502899100410a20e84251a106b48/docs/index.html)
161. 2026-10-09 · retro_style: keep the chart series colours distinct (amber, blue, green, the house template's light values) instead of mapping --s1 and --s2 to link blue, … · e045d91be (https://github.com/badinkajink/hand/commit/e045d91be665495b5242405e01c15b9cf29375a6) page (https://github.com/badinkajink/hand/blob/e045d91be665495b5242405e01c15b9cf29375a6/docs/index.html)
162. 2026-10-09 · Docs home page docs/index.html (scripts/docs_home_page.py): the hand in two sentences, the six topics with their state and key pages, how to fetch the LFS … · 59e7e4fe5 (https://github.com/badinkajink/hand/commit/59e7e4fe532c2ef893ae661c54a1271fe45661a0) page (https://github.com/badinkajink/hand/blob/59e7e4fe532c2ef893ae661c54a1271fe45661a0/docs/index.html)

### Index of result pages

docs/pages.html · 356 revisions, 2026-10-14 to 2026-11-13
Latest: 2026-11-13 · Tag-tracking throughput on corvus and the controller link: live two-camera tracker, UDP pose and state/target messages, and their page (lab session on corvus, …

Revisions, newest first

1. 2026-11-13 · Tag-tracking throughput on corvus and the controller link: live two-camera tracker, UDP pose and state/target messages, and their page (lab session on corvus, … · 583f85b0f (https://github.com/badinkajink/hand/commit/583f85b0f9f5bd442d0eac22573106f19c2583ba) page (https://github.com/badinkajink/hand/blob/583f85b0f9f5bd442d0eac22573106f19c2583ba/docs/pages.html)
2. 2026-11-13 · Calibration page v5: camera 836612071918 moved at about 16:00 and its pose re-solved against the fixed camera (lab session on corvus, 2026-11-13) · 8837c5d37 (https://github.com/badinkajink/hand/commit/8837c5d37801440517d9383a10195b86f71e9769) page (https://github.com/badinkajink/hand/blob/8837c5d37801440517d9383a10195b86f71e9769/docs/pages.html)
3. 2026-11-13 · Objects' Bambu projects: each object's filament written on the object, black on filament 1 and white on 2 (owner, 2026-11-13: "please have the blocks use the … · 4940a1be4 (https://github.com/badinkajink/hand/commit/4940a1be4aafaab45180a37e2a86da8c3807c84f) page (https://github.com/badinkajink/hand/blob/4940a1be4aafaab45180a37e2a86da8c3807c84f/docs/pages.html)
4. 2026-11-13 · Hex block map from both D435s: pose.bundle_adjust_multi, 35 views of the 11-07 test block, and section 6 of the calibration page (lab session on corvus, … · a1e231000 (https://github.com/badinkajink/hand/commit/a1e231000ebbbae6e013d2121c3516ada653fd90) page (https://github.com/badinkajink/hand/blob/a1e231000ebbbae6e013d2121c3516ada653fd90/docs/pages.html)
5. 2026-11-13 · Calibration page revised after the owner's notes (lab session on corvus, 2026-11-13 about 14:5x) · 0953ff43f (https://github.com/badinkajink/hand/commit/0953ff43f90d7f791f9283168c02fe0f241b4f31) page (https://github.com/badinkajink/hand/blob/0953ff43f90d7f791f9283168c02fe0f241b4f31/docs/pages.html)
6. 2026-11-13 · Tracked cylinder printed without end tags (owner, 2026-11-13: "i sent the print with no cylinder end tag") · 18062efdc (https://github.com/badinkajink/hand/commit/18062efdc0578ca90b8b40f02fd4b84f7551a152) page (https://github.com/badinkajink/hand/blob/18062efdc0578ca90b8b40f02fd4b84f7551a152/docs/pages.html)
7. 2026-11-13 · Tracking plan and tracking-prints page: pointer to the lens and arm calibration of 2026-11-13 · 9adcbdc2e (https://github.com/badinkajink/hand/commit/9adcbdc2e2153f3e8c20d128473c686a9d721254) page (https://github.com/badinkajink/hand/blob/9adcbdc2e2153f3e8c20d128473c686a9d721254/docs/pages.html)
8. 2026-11-13 · Lens and arm calibration of the two D435 tracking cameras on the UR5: page, data, film and lab scripts of 2026-11-13 (built on corvus by the lab session, owner … · 90d753ca3 (https://github.com/badinkajink/hand/commit/90d753ca37bce004f1ced2e8b67ec2f710f740db) page (https://github.com/badinkajink/hand/blob/90d753ca37bce004f1ced2e8b67ec2f710f740db/docs/pages.html)
9. 2026-11-13 · Tracked cylinder with end tag 23 only and without end tags, as alternatives (owner, 2026-11-13: the end tags "cause a lot of pla usage") · ab5073f0c (https://github.com/badinkajink/hand/commit/ab5073f0c46faa2da6df9d7f0ea49a964421a955) page (https://github.com/badinkajink/hand/blob/ab5073f0c46faa2da6df9d7f0ea49a964421a955/docs/pages.html)
10. 2026-11-13 · HOM's measured pose through a complementary filter (hom_gpu.POSE_FILTER: prediction from the commanded angular velocity, delayed tracker frames corrected by … · bb8b61b24 (https://github.com/badinkajink/hand/commit/bb8b61b24290b05a6e2443066c21e3a148ba766b) page (https://github.com/badinkajink/hand/blob/bb8b61b24290b05a6e2443066c21e3a148ba766b/docs/pages.html)
11. 2026-11-13 · Sampling MPC page: HOM under the sensing variants (tag tracker, fingertip model, calibration errors), HOM's commanded pad force (2 N: J 0.415 against 0.388 at … · 0de23f89b (https://github.com/badinkajink/hand/commit/0de23f89bf23e2997026e333c39690d2a20ecfa3) page (https://github.com/badinkajink/hand/blob/0de23f89bf23e2997026e333c39690d2a20ecfa3/docs/pages.html)
12. 2026-11-13 · Docs index: the artifact of the sampling MPC page (https://claude.ai/artifact/3m4bcPKugwFCtX5ZZLtd7f) · c35fc5d84 (https://github.com/badinkajink/hand/commit/c35fc5d8484a103ab0c94e2eb8334dcbc81b02fb) page (https://github.com/badinkajink/hand/blob/c35fc5d8484a103ab0c94e2eb8334dcbc81b02fb/docs/pages.html)
13. 2026-11-13 · Sampling MPC and HOM on the SR2 sphere twist, on the SCS0009 plant: page with HOM, real-time predictive sampling, DIAL annealing, the point-contact planner, … · ef59860cb (https://github.com/badinkajink/hand/commit/ef59860cb53bf8f661a12b16399344487926d526) page (https://github.com/badinkajink/hand/blob/ef59860cb53bf8f661a12b16399344487926d526/docs/pages.html)
14. 2026-11-13 · Paper calibration boards for the owner's 140 x 130 mm back (ChArUco 7 x 7 of 15 mm and checkerboard 9 x 8 of 12 mm, Letter PDF at actual size, 36 of 36 corners … · 9a6322eb6 (https://github.com/badinkajink/hand/commit/9a6322eb65d9feaf4c753287cc64f847d9e07b73) page (https://github.com/badinkajink/hand/blob/9a6322eb65d9feaf4c753287cc64f847d9e07b73/docs/pages.html)
15. 2026-11-13 · Page of the tracking prints and the calibration board: renders, joint sections, two MuJoCo viewers and links to every STL and Bambu project; on the mount's … · 5013467be (https://github.com/badinkajink/hand/commit/5013467bec283030c3b1fd3ba636eb4137a69cb8) page (https://github.com/badinkajink/hand/blob/5013467bec283030c3b1fd3ba636eb4137a69cb8/docs/pages.html)
16. 2026-11-12 · Search methods page, Section 12: MAP-Elites, CMA-ME, CMA-ES and Bayesian optimization replayed on the talk's four tracking-score grids (owner, 2026-11-12) · eb98da82e (https://github.com/badinkajink/hand/commit/eb98da82e17f14c4be92c02a7cabe35a383fc74c) page (https://github.com/badinkajink/hand/blob/eb98da82e17f14c4be92c02a7cabe35a383fc74c/docs/pages.html)
17. 2026-11-11 · Calibration page: the board GP against the MLP ensemble of 64 units on the splits of the two data curves (talk window's ae9366be, owner 11-11) in Section 16, … · 39bcf811b (https://github.com/badinkajink/hand/commit/39bcf811b92a01b90df475bebff0e8a9dd21714c) page (https://github.com/badinkajink/hand/blob/39bcf811b92a01b90df475bebff0e8a9dd21714c/docs/pages.html)
18. 2026-11-11 · Sphere-pad implementation page (owner, 11-11): how the spheres of a convex fingertip surface are built, with Algorithm 1, the v4b tip's numbers, the flat press … · 12efa7226 (https://github.com/badinkajink/hand/commit/12efa72265235ec606665f8ec782adcd830ae1c1) page (https://github.com/badinkajink/hand/blob/12efa72265235ec606665f8ec782adcd830ae1c1/docs/pages.html)
19. 2026-11-11 · Talk figures in the HOM paper's terms (owner, 11-11): CEM-refined grasp and HOM, Eq. (2) weights, contact forces · 136239972 (https://github.com/badinkajink/hand/commit/1362399725b154bd9ef9570e9fab8a6b46a4b98c) page (https://github.com/badinkajink/hand/blob/1362399725b154bd9ef9570e9fab8a6b46a4b98c/docs/pages.html)
20. 2026-11-11 · Talk v2: the tuning chart under the tracking score, with HOM tuning alone (owner, 11-11) · b5a8d0025 (https://github.com/badinkajink/hand/commit/b5a8d002554e72ebdfa3eeaf807bcc3e293af081) page (https://github.com/badinkajink/hand/blob/b5a8d002554e72ebdfa3eeaf807bcc3e293af081/docs/pages.html)
21. 2026-11-11 · Talk v2: the 16 grasps of hand A and the search panels under the tracking score, the formulation page's v2 section, filmed hands' scores to four decimals · 0d87fb90e (https://github.com/badinkajink/hand/commit/0d87fb90e294fd3e52bdec6849f202e988e45317) page (https://github.com/badinkajink/hand/blob/0d87fb90e294fd3e52bdec6849f202e988e45317/docs/pages.html)
22. 2026-11-11 · Talk v2 under way (owner, 11-11 ~01:35: refresh the slides' results on the latest settings): the tracking-score versions of the morphology figures, the … · ff6dc6dcd (https://github.com/badinkajink/hand/commit/ff6dc6dcd939685beed0d6a49d347d96d4370b46) page (https://github.com/badinkajink/hand/blob/ff6dc6dcd939685beed0d6a49d347d96d4370b46/docs/pages.html)
23. 2026-11-11 · Talk media of 11-11: HOM on the abstract SR2 hand of the drawings, and the fidelity slide as two plain charts (owner) · 2d960dc4f (https://github.com/badinkajink/hand/commit/2d960dc4f92dc0eee7417e2cfb608db869ae6541) page (https://github.com/badinkajink/hand/blob/2d960dc4f92dc0eee7417e2cfb608db869ae6541/docs/pages.html)
24. 2026-11-11 · Talk chart of the time per landscape: Newton's SDF hydroelastic contact on one GPU, an estimated 31 minutes (owner, 11-11) · b924a7283 (https://github.com/badinkajink/hand/commit/b924a7283f16151074beecab52c75f99f8a2014c) page (https://github.com/badinkajink/hand/blob/b924a7283f16151074beecab52c75f99f8a2014c/docs/pages.html)
25. 2026-11-10 · Tracking-score page, Section 7: the four default landscapes of the hand-design talk under the tracking score (owner, 11-10 night: "sure, let's rerun the … · f03d7dccc (https://github.com/badinkajink/hand/commit/f03d7dccc09c73265b5a6def37d6c17e71d26c7d) page (https://github.com/badinkajink/hand/blob/f03d7dccc09c73265b5a6def37d6c17e71d26c7d/docs/pages.html)
26. 2026-11-10 · Talk landscape figure: the letter A sits on the star's top point, and the key says A, B and C are the three hands of the grasp film (owner, 11-10 night, asked … · 4ee77f874 (https://github.com/badinkajink/hand/commit/4ee77f874f4da1216c7535e6d02b4234407e26e3) page (https://github.com/badinkajink/hand/blob/4ee77f874f4da1216c7535e6d02b4234407e26e3/docs/pages.html)
27. 2026-11-10 · Talk media for three owner comments of 11-10 night: grasps before the search, the sphere pads as the dynamics segue, and opener films · 5c414bd03 (https://github.com/badinkajink/hand/commit/5c414bd030ddb92b9d67301caa57d956be42f97e) page (https://github.com/badinkajink/hand/blob/5c414bd030ddb92b9d67301caa57d956be42f97e/docs/pages.html)
28. 2026-11-10 · Formulation page: the thesis of slides 24-25 before the build (Borras and Dollar's rule as a schematic, and the question for executed manipulation) · 7b46f428a (https://github.com/badinkajink/hand/commit/7b46f428a95986106a02b8d960212e191b418730) page (https://github.com/badinkajink/hand/blob/7b46f428a95986106a02b8d960212e191b418730/docs/pages.html)
29. 2026-11-10 · Talk figures for the morphology section, one question per slide (owner, 11-10 evening: the level sections with the co-design section's clarity and … · e89e72b91 (https://github.com/badinkajink/hand/commit/e89e72b91765b909b902137555d0accb49f86047) page (https://github.com/badinkajink/hand/blob/e89e72b91765b909b902137555d0accb49f86047/docs/pages.html)
30. 2026-11-10 · Talk formulas: the metric step follows the dynamics, and metrics join the outermost loop (owner, 11-10 evening) · cca3b006d (https://github.com/badinkajink/hand/commit/cca3b006dec189e9b5cf9937ab97d742ddf47cd9) page (https://github.com/badinkajink/hand/blob/cca3b006dec189e9b5cf9937ab97d742ddf47cd9/docs/pages.html)
31. 2026-11-10 · Talk formulas: the innermost level of the co-design problem is the dynamics (owner, 11-10 evening) · 18d7c5330 (https://github.com/badinkajink/hand/commit/18d7c533058a77374838dc878245b05519da9d08) page (https://github.com/badinkajink/hand/blob/18d7c533058a77374838dc878245b05519da9d08/docs/pages.html)
32. 2026-11-10 · Talk figures beside steps 3 and 4 of the co-design build: one line drawing of the hand of the films (layout 70, 110 mm) with the six mount coordinates in … · 94cf9f9c9 (https://github.com/badinkajink/hand/commit/94cf9f9c9285f7e3055e456b3684c01f18c7b7c2) page (https://github.com/badinkajink/hand/blob/94cf9f9c9285f7e3055e456b3684c01f18c7b7c2/docs/pages.html)
33. 2026-11-10 · Talk formulas: the co-design build introduces the 6 mount coordinates and the 9 joint commands right after the bi-level step, then the object sizes and the … · f98907013 (https://github.com/badinkajink/hand/commit/f98907013d782f6835b10fe081f67f74b552bd3e) page (https://github.com/badinkajink/hand/blob/f98907013d782f6835b10fe081f67f74b552bd3e/docs/pages.html)
34. 2026-11-10 · Search methods page: the EA and the 16-particle swarm live at four object sizes without a stored grid (post-reset step 5) · ff95124f7 (https://github.com/badinkajink/hand/commit/ff95124f7e0785b35fb45a825f6dc26d64525c09) page (https://github.com/badinkajink/hand/blob/ff95124f7e0785b35fb45a825f6dc26d64525c09/docs/pages.html)
35. 2026-11-10 · Search methods page: the five layouts of best tracking score per task on the six-coordinate layouts, rerun at seeds 20-24 (post-reset step 18) · 0a7e932bc (https://github.com/badinkajink/hand/commit/0a7e932bce00617081c3a696993f68bac1fa99af) page (https://github.com/badinkajink/hand/blob/0a7e932bce00617081c3a696993f68bac1fa99af/docs/pages.html)
36. 2026-11-10 · Fingertip viewer page: the UR5's record of the roll replayed in the cell, the films' panels as synced films, and the real time-lapse of the same rod and tip · ed86777f0 (https://github.com/badinkajink/hand/commit/ed86777f0a230d2f1579a8cd24eb61299dc72853) page (https://github.com/badinkajink/hand/blob/ed86777f0a230d2f1579a8cd24eb61299dc72853/docs/pages.html)
37. 2026-11-10 · Fingertip viewer page: both roll films start at the press's level hold · 5c0661906 (https://github.com/badinkajink/hand/commit/5c06619062023f45df7ca9739a9d868b953ad9cc) page (https://github.com/badinkajink/hand/blob/5c06619062023f45df7ca9739a9d868b953ad9cc/docs/pages.html)
38. 2026-11-10 · Fingertip viewer page: the viewer replayed on a UR5 rod roll of v3 ID 5, with an FE and field film of the roll · bfaf35e1e (https://github.com/badinkajink/hand/commit/bfaf35e1e11d517a7a4d152448bfc2307e11696b) page (https://github.com/badinkajink/hand/blob/bfaf35e1e11d517a7a4d152448bfc2307e11696b/docs/pages.html)
39. 2026-11-10 · Refinement page: a particle swarm in place of CEM at level full fails the rule on the press (post-reset step 3) · ad2fa44bb (https://github.com/badinkajink/hand/commit/ad2fa44bb8dcdb61e6e285be6a10832761aa0ea3) page (https://github.com/badinkajink/hand/blob/ad2fa44bb8dcdb61e6e285be6a10832761aa0ea3/docs/pages.html)
40. 2026-11-10 · Search methods page: the six methods live on the six-coordinate Sobol layouts (post-reset step 4) · 5d8477f06 (https://github.com/badinkajink/hand/commit/5d8477f0630ac5c20066c10635da7a2bacea0447) page (https://github.com/badinkajink/hand/blob/5d8477f0630ac5c20066c10635da7a2bacea0447/docs/pages.html)
41. 2026-11-10 · HOM review page: films of Figure 5's three commands on the planar finger and of the six-component relative twist on the SR2 thumb · e8b2ca7da (https://github.com/badinkajink/hand/commit/e8b2ca7da938a706578bdcbe0f21dc7d70ae5290) page (https://github.com/badinkajink/hand/blob/e8b2ca7da938a706578bdcbe0f21dc7d70ae5290/docs/pages.html)
42. 2026-11-10 · Search methods page builder: a section for the live searches on the six-coordinate Sobol layouts (post-reset step 4), filled from rows/search6d_sv25 when they … · 078d7a99f (https://github.com/badinkajink/hand/commit/078d7a99fd56c59e83c39a29d585243d10974d90) page (https://github.com/badinkajink/hand/blob/078d7a99fd56c59e83c39a29d585243d10974d90/docs/pages.html)
43. 2026-11-10 · Stiffness page: the size study's live EA on the measured servo and MuJoCo 4.0 keeps the press's 1.09 mm/mm and the roll's 0.49 against 0.56; the twist's falls … · f933beb09 (https://github.com/badinkajink/hand/commit/f933beb092d85bad7e7e96e7b600611c181e0ffe) page (https://github.com/badinkajink/hand/blob/f933beb092d85bad7e7e96e7b600611c181e0ffe/docs/pages.html)
44. 2026-11-10 · HOM landscapes on the measured SCS0009 servo: 0.55 N m/rad and the 0.59 deg dead band reorder the layouts (tracking rho 0.72-0.91 against 0.72 N m/rad, rerun … · 2eb2bfe31 (https://github.com/badinkajink/hand/commit/2eb2bfe3169f5c1a0f6d24d9041a2965876ab972) page (https://github.com/badinkajink/hand/blob/2eb2bfe3169f5c1a0f6d24d9041a2965876ab972/docs/pages.html)
45. 2026-11-10 · The SR2 pin-push with an unsensed pusher: contact point within 0.22 mm, force within 0.25 N of 0.45 N (post-reset step 14) · e0c123fe0 (https://github.com/badinkajink/hand/commit/e0c123fe00160b67f6b91a7bb1d7d6e3384aed54) page (https://github.com/badinkajink/hand/blob/e0c123fe00160b67f6b91a7bb1d7d6e3384aed54/docs/pages.html)
46. 2026-11-10 · Torque control page: films of the position servos and the torque plant on a twist, a roll and a press (step 9) · 2b0f8de21 (https://github.com/badinkajink/hand/commit/2b0f8de21e8c93da3820c3656ab9dbe7ec6c81f7) page (https://github.com/badinkajink/hand/blob/2b0f8de21e8c93da3820c3656ab9dbe7ec6c81f7/docs/pages.html)
47. 2026-11-10 · Torque control of the SR2 fingers at the STS3032's 0.515 N m limit: the 63 rad/s loop still loses pad contact (step 9) · 5ef4c5b3e (https://github.com/badinkajink/hand/commit/5ef4c5b3e7eea453db183f6356efeb7a374196c8) page (https://github.com/badinkajink/hand/blob/5ef4c5b3e7eea453db183f6356efeb7a374196c8/docs/pages.html)
48. 2026-11-10 · Inverse-dynamics torque control of the SR2 fingers under HOM against the SCS0009 position servos (post-reset step 9) · 6175313c1 (https://github.com/badinkajink/hand/commit/6175313c118935876e1dc2b81028c44c2312a8ac) page (https://github.com/badinkajink/hand/blob/6175313c118935876e1dc2b81028c44c2312a8ac/docs/pages.html)
49. 2026-11-10 · Design page lede: the peak slopes with clear grasps beside those with every grasp (post-reset step 6) · 74bac6e77 (https://github.com/badinkajink/hand/commit/74bac6e77d3d445b430983fb7a2d77ba0d01c2f0) page (https://github.com/badinkajink/hand/blob/74bac6e77d3d445b430983fb7a2d77ba0d01c2f0/docs/pages.html)
50. 2026-11-10 · Talk formulas as atomic LaTeX images: one idea per image, one canvas per series, a manifest shared by the page and the deck · d3dcdd914 (https://github.com/badinkajink/hand/commit/d3dcdd914b023114e6f9b8f0e64a2e9192188149) page (https://github.com/badinkajink/hand/blob/d3dcdd914b023114e6f9b8f0e64a2e9192188149/docs/pages.html)
51. 2026-11-10 · Talk visuals for the co-design formulation: LaTeX formula build, nested-box hierarchy, HOM contact modes, EA anatomy, hand renders · 10f51ead0 (https://github.com/badinkajink/hand/commit/10f51ead0a5c4544e791f54bb1f08bf79552b4ef) page (https://github.com/badinkajink/hand/blob/10f51ead0a5c4544e791f54bb1f08bf79552b4ef/docs/pages.html)
52. 2026-11-10 · Co-design formulation: the nested-problem diagram tightened; the talk deck has its ten slides (contact 74d58c3, local); hand-off state for post-reset step 15 · 065ab3f06 (https://github.com/badinkajink/hand/commit/065ab3f06888ee8b3f9143de1a65f543e7e1d8ad) page (https://github.com/badinkajink/hand/blob/065ab3f06888ee8b3f9143de1a65f543e7e1d8ad/docs/pages.html)
53. 2026-11-10 · Co-design formulation of the hand-design talk: one nested formula built up over the owner's slides 21-31, and its levels · f81cd63c3 (https://github.com/badinkajink/hand/commit/f81cd63c3f7182ac7a750beb48c2b8a60e212eef) page (https://github.com/badinkajink/hand/blob/f81cd63c3f7182ac7a750beb48c2b8a60e212eef/docs/pages.html)
54. 2026-11-09 · The film's roll layouts under a 40 deg roll command (owner, 11-09: "can we see what it looks like for a larger roll command") · d58fb319d (https://github.com/badinkajink/hand/commit/d58fb319d49ef8e9f069c4873697883c660ecf64) page (https://github.com/badinkajink/hand/blob/d58fb319d49ef8e9f069c4873697883c660ecf64/docs/pages.html)
55. 2026-11-09 · Roll films with all three pads on the sphere, filmed from below; ties go to the larger three-pad share (owner, 11-09) · e4837be04 (https://github.com/badinkajink/hand/commit/e4837be04e0b03c6fc5ae30bd2e2516d6c09f1d5) page (https://github.com/badinkajink/hand/blob/e4837be04e0b03c6fc5ae30bd2e2516d6c09f1d5/docs/pages.html)
56. 2026-11-09 · Tracking score for the HOM tasks, checked against the owner's verdicts, and films of re-picked layouts (owner, 11-09) · 68bdab8ba (https://github.com/badinkajink/hand/commit/68bdab8bac51b9c360cbadf12ccff670af6b759c) page (https://github.com/badinkajink/hand/blob/68bdab8bac51b9c360cbadf12ccff670af6b759c/docs/pages.html)
57. 2026-11-09 · Fingertip calibration page: lede cut from 728 to 158 words, byline from 127 to 68 (owner, 11-09: "thrown off by the incredibly long eyebrow") · a3aeaaa43 (https://github.com/badinkajink/hand/commit/a3aeaaa43aa9c8648b87d37bd21df17b21356a56) page (https://github.com/badinkajink/hand/blob/a3aeaaa43aa9c8648b87d37bd21df17b21356a56/docs/pages.html)
58. 2026-11-09 · Layout search methods page: the EA of Yang et al., particle swarms, Sobol and the FP paper's RRT on the stored grids; CEM, Pareto fronts and t-SNE from first … · 5f9f3309d (https://github.com/badinkajink/hand/commit/5f9f3309dd8fb5e6f819d777f1079e37af9b0b82) page (https://github.com/badinkajink/hand/blob/5f9f3309dd8fb5e6f819d777f1079e37af9b0b82/docs/pages.html)
59. 2026-11-08 · MuJoCo 4.0 against 3.6 for the sphere pads and the simulation components; hom_gpu's staticmethods restored · b3b1afc16 (https://github.com/badinkajink/hand/commit/b3b1afc16c8cfeda27c7885aeff3fbf80ffd897d) page (https://github.com/badinkajink/hand/blob/b3b1afc16c8cfeda27c7885aeff3fbf80ffd897d/docs/pages.html)
60. 2026-11-08 · HOM layout trends page: the size slopes beside the earlier measurements and Borras and Dollar's rule (owner, 11-08: "lets include these older results too") · 0f51b2839 (https://github.com/badinkajink/hand/commit/0f51b28390fa117974dcbc9f7dc3ebb68340ed4e) page (https://github.com/badinkajink/hand/blob/0f51b28390fa117974dcbc9f7dc3ebb68340ed4e/docs/pages.html)
61. 2026-11-07 · HOM review page: K for the shape operator throughout (S stays the paper's selection matrix), with the sphere, cylinder, plane and v4b apex as examples · 034d6d731 (https://github.com/badinkajink/hand/commit/034d6d73137283a3fa73ae4f9d3784dd9e868083) page (https://github.com/badinkajink/hand/blob/034d6d73137283a3fa73ae4f9d3784dd9e868083/docs/pages.html)
62. 2026-11-06 · HOM review page: Eq. (1) and the adjoint drawn, the contact filter explained and run on UR5 rolls · 283c6b482 (https://github.com/badinkajink/hand/commit/283c6b48254fda2d76d2e068547a485085afa079) page (https://github.com/badinkajink/hand/blob/283c6b48254fda2d76d2e068547a485085afa079/docs/pages.html)
63. 2026-11-05 · Fingertip crosstalk page: the SR2 analysis at 11 layouts with the HOM layouts (3f300b0a5) · 57783d550 (https://github.com/badinkajink/hand/commit/57783d5507cc483fd0b22f99ea3d457f714fbf04) page (https://github.com/badinkajink/hand/blob/57783d5507cc483fd0b22f99ea3d457f714fbf04/docs/pages.html)
64. 2026-11-05 · Fingertip crosstalk page: false contacts and the own-angle GP at six layouts of the SR2 hand, from the analysis of 525931521 · a69166649 (https://github.com/badinkajink/hand/commit/a69166649842078cf35d5ca8605e61cf6be7f3ef) page (https://github.com/badinkajink/hand/blob/a69166649842078cf35d5ca8605e61cf6be7f3ef/docs/pages.html)
65. 2026-11-05 · Object seating and tracking, steps 1 to 3 in simulation with the owner's changes of 11-05: a flat seat and a 40 mm arm lift keep the HOM cylinder scores, the … · 72fb9da6a (https://github.com/badinkajink/hand/commit/72fb9da6af31a32e95962a396e5a27832cc47f4d) page (https://github.com/badinkajink/hand/blob/72fb9da6af31a32e95962a396e5a27832cc47f4d/docs/pages.html)
66. 2026-11-05 · Fingertip crosstalk page: the layout sweep ended at 17:31 on 11-05, the plan at the HOM layouts runs with the measured-pose gate · 529f36058 (https://github.com/badinkajink/hand/commit/529f36058f15b11f612727f4d5a462c6fcf34983) page (https://github.com/badinkajink/hand/blob/529f36058f15b11f612727f4d5a462c6fcf34983/docs/pages.html)
67. 2026-11-05 · Fingertip crosstalk page: the coordinator's tolerance check of the remaining layouts at the yaw limit of 10 deg · d5ed7e234 (https://github.com/badinkajink/hand/commit/d5ed7e234bbd281ae660d13621df327caa195337) page (https://github.com/badinkajink/hand/blob/d5ed7e234bbd281ae660d13621df327caa195337/docs/pages.html)
68. 2026-11-05 · Fingertip crosstalk page: the chain's stop at rv04_mid, 15:50 on 11-05, and the limit of 10 deg for the yaw joints · a62a6446b (https://github.com/badinkajink/hand/commit/a62a6446b55f9a4bd28d31b5a2e1f55ddb2ba831) page (https://github.com/badinkajink/hand/blob/a62a6446b55f9a4bd28d31b5a2e1f55ddb2ba831/docs/pages.html)
69. 2026-11-05 · Fingertip crosstalk page: the layout sweep's item names the second plan at the HOM study's layouts, ready and not run (commits c23ffccb, 4aa06a09) · 2284b0100 (https://github.com/badinkajink/hand/commit/2284b01008271483be50e74d65919150186f227c) page (https://github.com/badinkajink/hand/blob/2284b01008271483be50e74d65919150186f227c/docs/pages.html)
70. 2026-11-05 · Fingertip crosstalk page: the layout sweep's item follows the lab's afternoon (commits 655c0e9d, 4a9ec4fa, aa30e8c3): a second start stopped when the middle's … · 2a6422284 (https://github.com/badinkajink/hand/commit/2a642228404735ebdbd21f68e7c04a349db76317) page (https://github.com/badinkajink/hand/blob/2a642228404735ebdbd21f68e7c04a349db76317/docs/pages.html)
71. 2026-11-05 · Fingertip crosstalk page: the layout sweep's stop follows the lab's correction (commit e5f02c6d): the owner swept the middle's yaw and found nothing … · 0e740e3c1 (https://github.com/badinkajink/hand/commit/0e740e3c1829944ddb57b1bab7b1c4cadf0beba3) page (https://github.com/badinkajink/hand/blob/0e740e3c1829944ddb57b1bab7b1c4cadf0beba3/docs/pages.html)
72. 2026-11-05 · Fingertip crosstalk page: the layout sweep's item follows the lab's runs of 11-05 (commits 7fe124ec and 3f706038): the attended pass of 35 steps ran clean, the … · bbe5c7516 (https://github.com/badinkajink/hand/commit/bbe5c7516494ec587b297da6716cc7653a745532) page (https://github.com/badinkajink/hand/blob/bbe5c7516494ec587b297da6716cc7653a745532/docs/pages.html)
73. 2026-11-05 · Calibration page: Figure 19's axis label of panel c was clipped at the image's edge; it is now right-aligned to the panel · c28848c39 (https://github.com/badinkajink/hand/commit/c28848c39a33b2ca5b095a05b1bc084e10ad0fcb) page (https://github.com/badinkajink/hand/blob/c28848c39a33b2ca5b095a05b1bc084e10ad0fcb/docs/pages.html)
74. 2026-11-05 · Calibration page: Section 16, the board GP shared by the six v3 tips. The viewer's model of 11-05 moves there from Section 15 (Table 30). QUEUE R34: other … · 9e006d523 (https://github.com/badinkajink/hand/commit/9e006d523c3b456be3fd2244b51d6c5f8ec2e5aa) page (https://github.com/badinkajink/hand/blob/9e006d523c3b456be3fd2244b51d6c5f8ec2e5aa/docs/pages.html)
75. 2026-11-05 · DIP link b v4 with 1.8 mm self-forming M2 holes in the tongue, and a P1S plate of three · 003dd8e2e (https://github.com/badinkajink/hand/commit/003dd8e2ee6463a64d8652ab31f86f581a08eb46) page (https://github.com/badinkajink/hand/blob/003dd8e2ee6463a64d8652ab31f86f581a08eb46/docs/pages.html)
76. 2026-11-05 · Calibration page: the contact viewer's board GP refitted with the rig's holds (commit d8ffcf6d, QUEUE R33, the owner's decision of 00:4x on 11-05). Section … · f57a69c1c (https://github.com/badinkajink/hand/commit/f57a69c1c7542ce1bfc768b0e7f3ba8e5f76bc44) page (https://github.com/badinkajink/hand/blob/f57a69c1c7542ce1bfc768b0e7f3ba8e5f76bc44/docs/pages.html)
77. 2026-11-05 · Spearman fix on the plant-transfer rows and three pages, 01:0x on 11-05 (6aa06d6b2) · f15190386 (https://github.com/badinkajink/hand/commit/f15190386c4fe82c77eaca9c8587d87a70f60ade) page (https://github.com/badinkajink/hand/blob/f15190386c4fe82c77eaca9c8587d87a70f60ade/docs/pages.html)
78. 2026-11-05 · Calibration page: the inverted rig's presses at the pad's mount end, from the coordinator's answer to the owner's question of 23:1x on 11-04 (feed line 57, … · f029ad87e (https://github.com/badinkajink/hand/commit/f029ad87e2227afe76790c41fa6bbfd80a1660ab) page (https://github.com/badinkajink/hand/blob/f029ad87e2227afe76790c41fa6bbfd80a1660ab/docs/pages.html)
79. 2026-11-04 · cad_v3, 22:4x on 11-04: the page's artifact link in the indices and the hand-off's state · 1876dc01c (https://github.com/badinkajink/hand/commit/1876dc01cbb223798b9809e5913d8875ff4e949e) page (https://github.com/badinkajink/hand/blob/1876dc01cbb223798b9809e5913d8875ff4e949e/docs/pages.html)
80. 2026-11-04 · cad_v3, 22:3x on 11-04: result page, film and clocking. The hand as built is at k = 1; a reading by eye had given k = 2. · 22cecc645 (https://github.com/badinkajink/hand/commit/22cecc6454114d1a59048de40e6694d94ad0d45c) page (https://github.com/badinkajink/hand/blob/22cecc6454114d1a59048de40e6694d94ad0d45c/docs/pages.html)
81. 2026-11-04 · Status page, 21:3x on 11-04: the row of the owner's fingertip-shape rerun request of 11-03 · ebcfdd406 (https://github.com/badinkajink/hand/commit/ebcfdd4065ac54d9836add9b78a4daf46c4722cc) page (https://github.com/badinkajink/hand/blob/ebcfdd4065ac54d9836add9b78a4daf46c4722cc/docs/pages.html)
82. 2026-11-04 · Fingertip-shape rerun, 21:2x on 11-04: the result page with the index refresh · 2dae56bc1 (https://github.com/badinkajink/hand/commit/2dae56bc15fe934fabe33d94ff38b89e0806ae75) page (https://github.com/badinkajink/hand/blob/2dae56bc15fe934fabe33d94ff38b89e0806ae75/docs/pages.html)
83. 2026-11-04 · Fingertip crosstalk page: Section 4 on the SR2 hand from the coordinator's analysis of the sweep of 11-04 (scripts/sr2_crosstalk_night.py, 9a0e05a5). At the … · 7c47bc89e (https://github.com/badinkajink/hand/commit/7c47bc89ef16d23bff02aebf762f3068750cd566) page (https://github.com/badinkajink/hand/blob/7c47bc89ef16d23bff02aebf762f3068750cd566/docs/pages.html)
84. 2026-11-04 · Calibration page: the seat block's stripped M2 holes as the rig's likely cause, and the end of the calibration (Section 15, lede, summary, future work) · 053c85215 (https://github.com/badinkajink/hand/commit/053c852158ea1d6650aef0c5ee41f52650733189) page (https://github.com/badinkajink/hand/blob/053c852158ea1d6650aef0c5ee41f52650733189/docs/pages.html)
85. 2026-11-04 · Calibration page: Section 15 says how a seat fixes the board, and the future-work item names the DIP link · 7f5d4b092 (https://github.com/badinkajink/hand/commit/7f5d4b092915925951a46a2abc33b3d571b32898) page (https://github.com/badinkajink/hand/blob/7f5d4b092915925951a46a2abc33b3d571b32898/docs/pages.html)
86. 2026-11-04 · Calibration page: v3 ID 3 on seat 1 against the tip on the robot (Section 15, Tables 26 and 27, Figures 15 and 16, Table 4's row, lede and summary) · 4c28063d7 (https://github.com/badinkajink/hand/commit/4c28063d7e9e214e350fcac095ddfafb5e4c2a80) page (https://github.com/badinkajink/hand/blob/4c28063d7e9e214e350fcac095ddfafb5e4c2a80/docs/pages.html)
87. 2026-11-04 · HOM grasp-genome EA, 16:3x on 11-04: Section 8 of the score refine page, the EA over layout and grasp · 6c0d155a3 (https://github.com/badinkajink/hand/commit/6c0d155a33a9007f40465386511e217ba1eace0c) page (https://github.com/badinkajink/hand/blob/6c0d155a33a9007f40465386511e217ba1eace0c/docs/pages.html)
88. 2026-11-04 · Calibration page: v3 IDs 1 to 6 by load tilt and tool, Tables 24 and 25, Figure 14 (commit 15c09673) · 88a5205d7 (https://github.com/badinkajink/hand/commit/88a5205d76f3d8d6178b5075ba4ffca51f9fe558) page (https://github.com/badinkajink/hand/blob/88a5205d76f3d8d6178b5075ba4ffca51f9fe558/docs/pages.html)
89. 2026-11-04 · Calibration page: the denser rod presses on v3 IDs 4 to 6, Tables 22 and 23, Figure 13 (commit c13136a8) · ec401baeb (https://github.com/badinkajink/hand/commit/ec401baeb5b7f06d0b307ed681ad692d7d699143) page (https://github.com/badinkajink/hand/blob/ec401baeb5b7f06d0b307ed681ad692d7d699143/docs/pages.html)
90. 2026-11-04 · Calibration page: seat 1's denser rod presses on v3 ID 6, Table 22 (0.746 mm against 0.780 mm, commit 5916bdad) · 9ff9eb086 (https://github.com/badinkajink/hand/commit/9ff9eb0864248e7308de0eccb2bab575af0e0d85) page (https://github.com/badinkajink/hand/blob/9ff9eb0864248e7308de0eccb2bab575af0e0d85/docs/pages.html)
91. 2026-11-04 · HOM shared controller, 12:3x on 11-04: Section 7 of the score refine page, one set of forces and modes for all layouts · a7993fbfc (https://github.com/badinkajink/hand/commit/a7993fbfc15090d8e6594d7ee217dba08d4083ee) page (https://github.com/badinkajink/hand/blob/a7993fbfc15090d8e6594d7ee217dba08d4083ee/docs/pages.html)
92. 2026-11-04 · Calibration page: the rig's point spacing, the load's tilt and the denser rod presses (feed line 53) · 92e7423ba (https://github.com/badinkajink/hand/commit/92e7423ba6728b19e2ac1f4dcaadf7d3bc80cec8) page (https://github.com/badinkajink/hand/blob/92e7423ba6728b19e2ac1f4dcaadf7d3bc80cec8/docs/pages.html)
93. 2026-11-04 · Calibration page: v3 IDs 4 to 6 on the inverted rig (Section 15, Tables 19 and 20, Figure 12) · e90b73a4f (https://github.com/badinkajink/hand/commit/e90b73a4ff8ffe12115b8dd3f311fdbb60257c23) page (https://github.com/badinkajink/hand/blob/e90b73a4ff8ffe12115b8dd3f311fdbb60257c23/docs/pages.html)
94. 2026-11-04 · HOM worst-case score, 09:4x on 11-04: runbook and outcome in the score refine README · cb9a51482 (https://github.com/badinkajink/hand/commit/cb9a51482555ed3d0f92ba3653839e06ab0b5331) page (https://github.com/badinkajink/hand/blob/cb9a51482555ed3d0f92ba3653839e06ab0b5331/docs/pages.html)
95. 2026-11-04 · HOM worst-case score, 09:3x on 11-04: Section 6 of the score refine page · 351ba39e3 (https://github.com/badinkajink/hand/commit/351ba39e33e9b4221e327aa3f784837968dc1332) page (https://github.com/badinkajink/hand/blob/351ba39e33e9b4221e327aa3f784837968dc1332/docs/pages.html)
96. 2026-11-04 · HOM task conflict runbook and page, 03:5x on 11-04: the outcome in README.md, exact single-layout levels in the plant table · 922a300bc (https://github.com/badinkajink/hand/commit/922a300bc875e8b6d5233e8c90a64093bbd2519e) page (https://github.com/badinkajink/hand/blob/922a300bc875e8b6d5233e8c90a64093bbd2519e/docs/pages.html)
97. 2026-11-04 · HOM task conflict page, 03:4x on 11-04: one finger layout or several for the four HOM tasks, on performance alone · 85845f03e (https://github.com/badinkajink/hand/commit/85845f03e039ed8cd5d47cb6e50678618e635ea4) page (https://github.com/badinkajink/hand/blob/85845f03e039ed8cd5d47cb6e50678618e635ea4/docs/pages.html)
98. 2026-11-04 · Calibration page: the joint rod fit and the extras' 274 oblique presses · a5131dac1 (https://github.com/badinkajink/hand/commit/a5131dac18ed639a759aaf13a42c32f697f01ec9) page (https://github.com/badinkajink/hand/blob/a5131dac18ed639a759aaf13a42c32f697f01ec9/docs/pages.html)
99. 2026-11-04 · HOM score levels page, 02:3x on 11-04: refined grasps, forces and contact modes against the best of 16 grasps · 05f1ca731 (https://github.com/badinkajink/hand/commit/05f1ca7312d48c5f6bcb107fbfa381928c7c6326) page (https://github.com/badinkajink/hand/blob/05f1ca7312d48c5f6bcb107fbfa381928c7c6326/docs/pages.html)
100. 2026-11-03 · Calibration page: the rod's plan counts after the turn envelope of 21:43 · 27f24d5be (https://github.com/badinkajink/hand/commit/27f24d5be807202221ba09566b1872dbe334b81b) page (https://github.com/badinkajink/hand/blob/27f24d5be807202221ba09566b1872dbe334b81b/docs/pages.html)
101. 2026-11-03 · Calibration page: the cone item's opening sentence split, 37 words to 23 · 132803faf (https://github.com/badinkajink/hand/commit/132803fafb5025059ee86dce5e0fb8bfd771841e) page (https://github.com/badinkajink/hand/blob/132803fafb5025059ee86dce5e0fb8bfd771841e/docs/pages.html)
102. 2026-11-03 · Calibration page: the rod's night in halves and lighter sweeps (feed line 52) · f9d42b24f (https://github.com/badinkajink/hand/commit/f9d42b24f931efb8f22865ef096e328ce7bbdb70) page (https://github.com/badinkajink/hand/blob/f9d42b24f931efb8f22865ef096e328ce7bbdb70/docs/pages.html)
103. 2026-11-03 · Calibration page: feed line 51 (11-03 17:38): the rod's first start stopped before the grid at 17:15 (the tool seated a quarter turn off on its square boss); … · f1217549f (https://github.com/badinkajink/hand/commit/f1217549f919fc215f2c6c0fe1e7f9305583b558) page (https://github.com/badinkajink/hand/blob/f1217549f919fc215f2c6c0fe1e7f9305583b558/docs/pages.html)
104. 2026-11-03 · Calibration page: feed line 50 (11-03 16:59) and what ran before it (lab/NOTES.md, QUEUE R31 and R32): seat 2's 2 mm grid ran 14:48 to 16:11 at 0.6 mm/s, 269 … · 889579d39 (https://github.com/badinkajink/hand/commit/889579d39819349fec4598e98ade7ae6bd954c06) page (https://github.com/badinkajink/hand/blob/889579d39819349fec4598e98ade7ae6bd954c06/docs/pages.html)
105. 2026-11-03 · Calibration page: feed lines 46 and 47 (11-03 13:15 and 13:33): the rig item takes the speed sets' summary (holds 0.24, 0.85 and 1.73 N over the level at 0.15, … · 25acc521b (https://github.com/badinkajink/hand/commit/25acc521bc29f4ce9c8f783c92704ca1e3f64a94) page (https://github.com/badinkajink/hand/blob/25acc521bc29f4ce9c8f783c92704ca1e3f64a94/docs/pages.html)
106. 2026-11-03 · Calibration page: the rig item takes feed lines 43 to 45 (11-03 12:01 to 12:25): fast3 pressed 252 of seat 3's 263 at 0.6 mm/s (the other 11 are in its speed … · 5a3ab0383 (https://github.com/badinkajink/hand/commit/5a3ab038340236adcf612db61692a7965205ebde) page (https://github.com/badinkajink/hand/blob/5a3ab038340236adcf612db61692a7965205ebde/docs/pages.html)
107. 2026-11-03 · Physical-model page: where v3 ID 3's holds come from (Section 9): made on 10-30 for the v3 contact-model page from copies of the lab computer's session … · a27c49fad (https://github.com/badinkajink/hand/commit/a27c49fadf2621039d85138abdc2a269a2e92cf2) page (https://github.com/badinkajink/hand/blob/a27c49fadf2621039d85138abdc2a269a2e92cf2/docs/pages.html)
108. 2026-11-03 · Calibration page: the board GP's held-out error against training holds on v3 IDs 1 to 3 (Section 14, Table 18, Figure 11), v3 ID 3's sessions in Table 4, and … · 36d73cb42 (https://github.com/badinkajink/hand/commit/36d73cb420b6ae51c9690859dccc08b009db8133) page (https://github.com/badinkajink/hand/blob/36d73cb420b6ae51c9690859dccc08b009db8133/docs/pages.html)
109. 2026-11-03 · Fresh-seed check of the HOM one-design picks, on the plant and modulus page · b13d0672f (https://github.com/badinkajink/hand/commit/b13d0672fe91eeb8021c2fae8eac6ebf73f3e453) page (https://github.com/badinkajink/hand/blob/b13d0672fe91eeb8021c2fae8eac6ebf73f3e453/docs/pages.html)
110. 2026-11-03 · HOM layout trends page: its plant and modulus limitation links the plant and modulus page · 14f9e776d (https://github.com/badinkajink/hand/commit/14f9e776d07766fd12c9066af02de204ccc803df) page (https://github.com/badinkajink/hand/blob/14f9e776d07766fd12c9066af02de204ccc803df/docs/pages.html)
111. 2026-11-03 · HOM plant and modulus page: SR2 layouts across finger servos, pad moduli and scene friction · f84e2cd1c (https://github.com/badinkajink/hand/commit/f84e2cd1c27e0b635568ac216d31a0b2a46bc105) page (https://github.com/badinkajink/hand/blob/f84e2cd1c27e0b635568ac216d31a0b2a46bc105/docs/pages.html)
112. 2026-11-02 · Revisions page of the documentation: every page's commits with links to its older versions on GitHub · 484cc151a (https://github.com/badinkajink/hand/commit/484cc151ad3c941b238a58a96b96fe00445eb97d) page (https://github.com/badinkajink/hand/blob/484cc151ad3c941b238a58a96b96fe00445eb97d/docs/pages.html)
113. 2026-10-31 · Pin-push from a table: with no penetration of the table no finger touches it, and the cylinder is held in 12 and 15 of 20 runs against 9 · 1fc64cc7e (https://github.com/badinkajink/hand/commit/1fc64cc7ecf3c794a216acd41ec7736c733d67fc) page (https://github.com/badinkajink/hand/blob/1fc64cc7ecf3c794a216acd41ec7736c733d67fc/docs/pages.html)
114. 2026-10-31 · Sobol layouts re-run with the finger clearance: the layout-by-size interaction stays at 40 to 43 % of the score variance · ac0727c9f (https://github.com/badinkajink/hand/commit/ac0727c9f010fe45c2c01cd54843eeae928d2738) page (https://github.com/badinkajink/hand/blob/ac0727c9f010fe45c2c01cd54843eeae928d2738/docs/pages.html)
115. 2026-10-31 · Trends page: the size table in eight columns that fit the page (the near-set ranges are the figures' bars); numbers keep their units on one line · 94d2a823f (https://github.com/badinkajink/hand/commit/94d2a823f033e551b225069bdad3b27df9eaf5ac) page (https://github.com/badinkajink/hand/blob/94d2a823f033e551b225069bdad3b27df9eaf5ac/docs/pages.html)
116. 2026-10-31 · Pose toy reach: the clearance inside the program, not the skeleton's width, is why more layouts reach the tripod · 57d9d2565 (https://github.com/badinkajink/hand/commit/57d9d2565c6d7d38d73664b1eca917fd0008b963) page (https://github.com/badinkajink/hand/blob/57d9d2565c6d7d38d73664b1eca917fd0008b963/docs/pages.html)
117. 2026-10-31 · HOM layouts clear of a table across object sizes: the constraint lowers the twist on spheres under 40 mm and the pin-push at every size, not the roll · 814eefedc (https://github.com/badinkajink/hand/commit/814eefedcc7106885e85639d4cd933f751dec9ed) page (https://github.com/badinkajink/hand/blob/814eefedcc7106885e85639d4cd933f751dec9ed/docs/pages.html)
118. 2026-10-31 · HOM layouts from a table: grasps kept clear of the table keep the twist's and the roll's scores; the pin-push drops the cylinder where a finger presses on the … · ef7f91c5a (https://github.com/badinkajink/hand/commit/ef7f91c5adf870cf2002ee27290813cf06a8ef22) page (https://github.com/badinkajink/hand/blob/ef7f91c5adf870cf2002ee27290813cf06a8ef22/docs/pages.html)
119. 2026-10-31 · Design overview: the HOM size trends beside the workspace rule, and the two HOM layout pages in its index; dead names removed · 82794604f (https://github.com/badinkajink/hand/commit/82794604fd71fcc8fe4a33556eb32e868aecbc64) page (https://github.com/badinkajink/hand/blob/82794604fd71fcc8fe4a33556eb32e868aecbc64/docs/pages.html)
120. 2026-10-31 · HOM layouts across 19 object sizes: the trends page opens with the size trends, and the CPU checks and films use each search's own best layout · e6310c7a5 (https://github.com/badinkajink/hand/commit/e6310c7a5099c1d68ee6c49396c3006fd9c7d078) page (https://github.com/badinkajink/hand/blob/e6310c7a5099c1d68ee6c49396c3006fd9c7d078/docs/pages.html)
121. 2026-10-31 · Contact pages read for a newcomer: the v3 page says why a softer pad needs a longer time constant, what the regulariser is, and which centroid the scenes' … · bbae93013 (https://github.com/badinkajink/hand/commit/bbae93013a5acb1c63aca212ff2c9dc60a4fb690) page (https://github.com/badinkajink/hand/blob/bbae93013a5acb1c63aca212ff2c9dc60a4fb690/docs/pages.html)
122. 2026-10-30 · Physical-model page: v3 ID 3 beside v3 ID 1, ID 2 and v2 ID 1 (the coordinator's analysis of 10-30, logs/20261030-spherev3id3) · 1bb751383 (https://github.com/badinkajink/hand/commit/1bb75138368bf596ef988f8597ec02bde30d7493) page (https://github.com/badinkajink/hand/blob/1bb75138368bf596ef988f8597ec02bde30d7493/docs/pages.html)
123. 2026-10-30 · Calibration page: the inverted rig's dry run checked, none of 960 actions flagged on the three seats' plans and the sphere 7.8 mm or more from its held tip … · 6ba1b8e65 (https://github.com/badinkajink/hand/commit/6ba1b8e6575ffbf4c4038adebf47808144f946b8) page (https://github.com/badinkajink/hand/blob/6ba1b8e6575ffbf4c4038adebf47808144f946b8/docs/pages.html)
124. 2026-10-30 · Status page: the probe-mode note itself (b616235b only rebuilt the page): the probe mode written and simulated (lab 28c2892c, 349ec386), pass 1 and the tip … · 1735839b4 (https://github.com/badinkajink/hand/commit/1735839b4da0986e0c329ef0d4b721d453e11a01) page (https://github.com/badinkajink/hand/blob/1735839b4da0986e0c329ef0d4b721d453e11a01/docs/pages.html)
125. 2026-10-30 · Status page: the probe mode written and simulated (lab 28c2892c, 349ec386), pass 1 and the tip body checked (bbe38fc9). · b616235be (https://github.com/badinkajink/hand/commit/b616235be2827ad0d661437c744625251acb3f21) page (https://github.com/badinkajink/hand/blob/b616235be2827ad0d661437c744625251acb3f21/docs/pages.html)
126. 2026-10-30 · Inverted rig: exact check of the tool against the tip body; deepest presses keep 0.1 mm more on the tool's end · bbe38fc93 (https://github.com/badinkajink/hand/commit/bbe38fc93c26f76d96a65d9c43f2e2dbbb6d5e8a) page (https://github.com/badinkajink/hand/blob/bbe38fc93c26f76d96a65d9c43f2e2dbbb6d5e8a/docs/pages.html)
127. 2026-10-30 · Contact models of the four-magnet v3 fingertips fitted to the UR5 presses (owner, 10-30: one modulus, forces before indentation, contact area and pose). Over … · 45a0590fb (https://github.com/badinkajink/hand/commit/45a0590fbed9bc7d6b65af7855152b02d682038a) page (https://github.com/badinkajink/hand/blob/45a0590fbed9bc7d6b65af7855152b02d682038a/docs/pages.html)
128. 2026-10-30 · Inverted rig: pass 1 checked as the lab's converter writes it, and touch-offs on the tips' side walls (lab, 15:03 on 10-30) · d37468c18 (https://github.com/badinkajink/hand/commit/d37468c18a80289d8d7e5aa1305cf6200940f3b6) page (https://github.com/badinkajink/hand/blob/d37468c18a80289d8d7e5aa1305cf6200940f3b6/docs/pages.html)
129. 2026-10-30 · UR5 calibration, 14:5x on 10-30: v3 ID 3's suite complete (block 6, 100 of 100, no HEX-E time-out); the probe mode installed in simulation; the seated pose's … · e879c69af (https://github.com/badinkajink/hand/commit/e879c69af2a418837a96d61e00b48a063f448bf8) page (https://github.com/badinkajink/hand/blob/e879c69af2a418837a96d61e00b48a063f448bf8/docs/pages.html)
130. 2026-10-30 · Inverted rig: the homing check includes the seated pose (lab, 14:55 on 10-30): seated on a key the arm's last link stands 4.0 mm over the 2x4s' model, under … · d52b1998b (https://github.com/badinkajink/hand/commit/d52b1998b60eeaa04cbb6756979104844bee61be) page (https://github.com/badinkajink/hand/blob/d52b1998b60eeaa04cbb6756979104844bee61be/docs/pages.html)
131. 2026-10-30 · Seat strip runbook: the tips' seats and mux channels (owner, 14:3x on 10-30): seat 1 v3 ID 1 on channel 3, seat 2 v3 ID 3 on channel 1, seat 3 v3 ID 2 on … · 49388fb41 (https://github.com/badinkajink/hand/commit/49388fb4130c7c95cc7447bcf42c2ab19564d9f5) page (https://github.com/badinkajink/hand/blob/49388fb4130c7c95cc7447bcf42c2ab19564d9f5/docs/pages.html)
132. 2026-10-30 · Inverted rig: each probe action's deepest cleared press (deep_clear_mm), the lift labelled, the homing lift checked every 5 mm · 1912b4796 (https://github.com/badinkajink/hand/commit/1912b479669e63a8814e3aeca63bc76121fc4b5c) page (https://github.com/badinkajink/hand/blob/1912b479669e63a8814e3aeca63bc76121fc4b5c/docs/pages.html)
133. 2026-10-30 · HOM design study: a third of the v4b sphere grasps overlap the index's and middle's caps at the touch pose, which the GPU evaluator's collision filter hides … · c821a6a07 (https://github.com/badinkajink/hand/commit/c821a6a0789ddbf8e9c75285eb855f0b2425438a) page (https://github.com/badinkajink/hand/blob/c821a6a0789ddbf8e9c75285eb855f0b2425438a/docs/pages.html)
134. 2026-10-30 · UR5 calibration, 13:3x on 10-30: the owner's go for the inverted rig's probe mode, relayed to the lab (write and simulate after block 6; no robot motion before … · fb1aa02cd (https://github.com/badinkajink/hand/commit/fb1aa02cdd2a33d348457826b67a34f842fb1d18) page (https://github.com/badinkajink/hand/blob/fb1aa02cdd2a33d348457826b67a34f842fb1d18/docs/pages.html)
135. 2026-10-30 · UR5 calibration, 13:2x on 10-30: v3 ID 3's block 4 done (101 of 101, no HEX-E loss at the loss pose since the reseat), block 6 running to about 14:45; … · a502f2c2f (https://github.com/badinkajink/hand/commit/a502f2c2f7e51d51767f50ddbcaa611441d9a563) page (https://github.com/badinkajink/hand/blob/a502f2c2f7e51d51767f50ddbcaa611441d9a563/docs/pages.html)
136. 2026-10-30 · UR5 calibration, 12:5x on 10-30: the owner runs no calibration tonight and waits for the inverted rig; block 4 at 91 of 101 with no HEX-E loss since the 11:09 … · 3ce83b744 (https://github.com/badinkajink/hand/commit/3ce83b7443079f1dd5716a9916ab89a9e43ed0e0) page (https://github.com/badinkajink/hand/blob/3ce83b7443079f1dd5716a9916ab89a9e43ed0e0/docs/pages.html)
137. 2026-10-30 · Inverted rig: the seats on a low strip on one 2x4, the pads 40 mm over it, and the plate at 189 g · ac021c3dd (https://github.com/badinkajink/hand/commit/ac021c3ddeb289ba1ecc543d77894a58fdb67962) page (https://github.com/badinkajink/hand/blob/ac021c3ddeb289ba1ecc543d77894a58fdb67962/docs/pages.html)
138. 2026-10-30 · Calibration page: the seat block alone on the table (feed line 32, 1690e3df) · 3c4ff18bb (https://github.com/badinkajink/hand/commit/3c4ff18bb8c80e52d6a149169a449a862e507be9) page (https://github.com/badinkajink/hand/blob/3c4ff18bb8c80e52d6a149169a449a862e507be9/docs/pages.html)
139. 2026-10-30 · Local refinement, EA baseline and a 2 ms MPC planner on the HOM evaluator. Around each of the 20 best twist layouts, the best of 64 layouts within 2 mm (picked … · 87032eb49 (https://github.com/badinkajink/hand/commit/87032eb493dd523f1136a5d2c06b7d5883004d03) page (https://github.com/badinkajink/hand/blob/87032eb493dd523f1136a5d2c06b7d5883004d03/docs/pages.html)
140. 2026-10-30 · HOM re-anchor of a touching finger's reference beyond the gap cut (HomParams.reanchor, variant reanchor, CPU and GPU, with a test): on the 25 mm pin-push … · 6f44a9019 (https://github.com/badinkajink/hand/commit/6f44a90195a3eab569b5569798d87e5fd2f568fc) page (https://github.com/badinkajink/hand/blob/6f44a90195a3eab569b5569798d87e5fd2f568fc/docs/pages.html)
141. 2026-10-30 · Inverted rig: the seat block alone on the table, with two homing keys between its columns, a fingertip tool face out along the axis, and everything on one P1S … · 1690e3dfe (https://github.com/badinkajink/hand/commit/1690e3dfeab2595800ce8509eaa70d166edd353b) page (https://github.com/badinkajink/hand/blob/1690e3dfeab2595800ce8509eaa70d166edd353b/docs/pages.html)
142. 2026-10-30 · Calibration page: the inverted rig's seat block in place of plate v2e (feed line 31, bb8f63ae) · f6007b508 (https://github.com/badinkajink/hand/commit/f6007b5083c92311f9d053c5e680f9586f16876b) page (https://github.com/badinkajink/hand/blob/f6007b5083c92311f9d053c5e680f9586f16876b/docs/pages.html)
143. 2026-10-30 · Inverted rig: seat block at v2e's place with every wood screw 35 mm or more from the columns, and tools seated on the boss's taper over captive M3 nuts · bb8f63ae9 (https://github.com/badinkajink/hand/commit/bb8f63ae9a5eceee9b1e319fc0bd92a8191207a9) page (https://github.com/badinkajink/hand/blob/bb8f63ae9a5eceee9b1e319fc0bd92a8191207a9/docs/pages.html)
144. 2026-10-30 · Calibration page: the HEX-E's link losses against the arm's travels (feed line 30, 99763b9f) · 5046e4ca4 (https://github.com/badinkajink/hand/commit/5046e4ca4ffc8d81a96296e2e66c175aadbef985) page (https://github.com/badinkajink/hand/blob/5046e4ca4ffc8d81a96296e2e66c175aadbef985/docs/pages.html)
145. 2026-10-30 · UR5 HEX-E losses against the joints: the nine losses since 10-25 came as the arm arrived at a pose that held the link for minutes at other times · 99763b9f6 (https://github.com/badinkajink/hand/commit/99763b9f6f3f7b425a764e295817c8a7cae6b792) page (https://github.com/badinkajink/hand/blob/99763b9f6f3f7b425a764e295817c8a7cae6b792/docs/pages.html)
146. 2026-10-30 · Calibration page: the wrist-order item follows the exact search (21ee5fa8, QUEUE R31 08:2x on 10-30) · 4e65c4d54 (https://github.com/badinkajink/hand/commit/4e65c4d548cd4a03a7826a423000685b420274a1) page (https://github.com/badinkajink/hand/blob/4e65c4d548cd4a03a7826a423000685b420274a1/docs/pages.html)
147. 2026-10-30 · Status page: both reordered tall plans passed the lab's cell checks by 09:43; the lab recommends wrist2; the resume waits for the owner's go · 202c4dd0f (https://github.com/badinkajink/hand/commit/202c4dd0f5edb52a4e1ebce7ffd0c73f3c55266a) page (https://github.com/badinkajink/hand/blob/202c4dd0f5edb52a4e1ebce7ffd0c73f3c55266a/docs/pages.html)
148. 2026-10-30 · HOM GPU controller captured as a CUDA graph in hom_gpu.Batch (capture_control, control_period: float masks, closed-form 3x3 solves, six phi-Newton steps, … · 5b82ab1cd (https://github.com/badinkajink/hand/commit/5b82ab1cd654488a26493a0240f8d1b7bed0a17b) page (https://github.com/badinkajink/hand/blob/5b82ab1cd654488a26493a0240f8d1b7bed0a17b/docs/pages.html)
149. 2026-10-30 · UR5 wrist order: times from date (08:1x, not 08:2x) in QUEUE R31, the wrist2 plan's note, the evidence README and the status page · 678c1021d (https://github.com/badinkajink/hand/commit/678c1021d3016ce4e62da555d0114fda1053663e) page (https://github.com/badinkajink/hand/blob/678c1021d3016ce4e62da555d0114fda1053663e/docs/pages.html)
150. 2026-10-30 · UR5 wrist order: exact search (DP over orders within four places) that also penalizes wrist-1 zero crossings with a swing over 40 deg (lab, 07:57: R29's … · 21ee5fa84 (https://github.com/badinkajink/hand/commit/21ee5fa84e90be0467db16f51f2c894c6c2423cf) page (https://github.com/badinkajink/hand/blob/21ee5fa84e90be0467db16f51f2c894c6c2423cf/docs/pages.html)
151. 2026-10-30 · Design page: the grid's best grasps on fresh seeds 3-5 and moved between layouts. Spheres keep the gain (twist +0.20 vs +0.21 on the picked seeds, roll +0.06 … · 92dd22b06 (https://github.com/badinkajink/hand/commit/92dd22b06d70abb97957310f44c5498c2e1d08bd) page (https://github.com/badinkajink/hand/blob/92dd22b06d70abb97957310f44c5498c2e1d08bd/docs/pages.html)
152. 2026-10-30 · Design page: the cylinder size study complete (interaction 39 and 40 % of the variance against 17 and 14 % from seed noise; Spearman 0.18 and -0.03 between the … · b90a0413f (https://github.com/badinkajink/hand/commit/b90a0413fcb888f0643ed1a80353853bd298e306) page (https://github.com/badinkajink/hand/blob/b90a0413fcb888f0643ed1a80353853bd298e306/docs/pages.html)
153. 2026-10-30 · UR5 tall stage 2 reordered for the wrist: 12 travels with wrist 1 from below 0 to above it while wrist 2 rises (two HEX-E losses at their end) -> 0, wrist-1 … · c5c34f604 (https://github.com/badinkajink/hand/commit/c5c34f6044c06697c7820478e9e50cf8c41896d7) page (https://github.com/badinkajink/hand/blob/c5c34f6044c06697c7820478e9e50cf8c41896d7/docs/pages.html)
154. 2026-10-30 · Design page: the grid at three sizes per object (peak x_sep 90 -> 130 mm on the 30 -> 63 mm sphere in the twist, 75 -> 105 mm on the 10 -> 40 mm cylinder in … · 65a0633eb (https://github.com/badinkajink/hand/commit/65a0633eb1b48ebb327d02d1f3ede520e24aeaee) page (https://github.com/badinkajink/hand/blob/65a0633eb1b48ebb327d02d1f3ede520e24aeaee/docs/pages.html)
155. 2026-10-30 · Design page: lede and summary on the night's results (grasp per layout and task, object size, narrow peaks) · 186276294 (https://github.com/badinkajink/hand/commit/186276294845008021edc19af5f636b828761215) page (https://github.com/badinkajink/hand/blob/186276294845008021edc19af5f636b828761215/docs/pages.html)
156. 2026-10-30 · Design page: the four tasks on the grid with a grasp per task (worst-of-four median 0.04 with the foundational pose, 0.44 with each task's best of 16; 32 % of … · 6ca363e81 (https://github.com/badinkajink/hand/commit/6ca363e81d65d91d33741a53771f7e91c4c9c107) page (https://github.com/badinkajink/hand/blob/6ca363e81d65d91d33741a53771f7e91c4c9c107/docs/pages.html)
157. 2026-10-30 · Value-model gradients on the cylinder tasks: no better than random steps on the grid for the press (42 vs 43 %), weakly for the pin-push (53 vs 49 %); moved … · e34e615b4 (https://github.com/badinkajink/hand/commit/e34e615b4973058a9e70253270e261cbcf91409f) page (https://github.com/badinkajink/hand/blob/e34e615b4973058a9e70253270e261cbcf91409f/docs/pages.html)
158. 2026-10-30 · Roll at 40 mm: the value model's gradient helps on the grid (57 vs 50 %) and fails at the top (68 % of moved best layouts worse on fresh seeds); peaks slightly … · 3cdc097c8 (https://github.com/badinkajink/hand/commit/3cdc097c84db3cd3186106bc208314f3cdcacddf) page (https://github.com/badinkajink/hand/blob/3cdc097c84db3cd3186106bc208314f3cdcacddf/docs/pages.html)
159. 2026-10-30 · Design page: the four tasks at their default objects (Spearman twist-roll 0.61, pin-push-press 0.45, sphere-cylinder 0.21-0.27; 174 Pareto-optimal layouts of … · a0b74c592 (https://github.com/badinkajink/hand/commit/a0b74c5924b34a72bf800dec1682086d8fa275d0) page (https://github.com/badinkajink/hand/blob/a0b74c5924b34a72bf800dec1682086d8fa275d0/docs/pages.html)
160. 2026-10-30 · Size study: high neighbourhoods against a shuffled-score null (29-58 per task and size, 86-152 layouts each; shuffled: 94-114 smaller ones) · 283e566ca (https://github.com/badinkajink/hand/commit/283e566ca3780f56c4f1a5c9fefc66baf37df117) page (https://github.com/badinkajink/hand/blob/283e566ca3780f56c4f1a5c9fefc66baf37df117/docs/pages.html)
161. 2026-10-30 · Design page: grasp keyframes of the twist's and the pin-push's peak layouts (foundational, best and worst grasp, three sides); renders embedded as JPEG (14.1 … · 46ca4ff2e (https://github.com/badinkajink/hand/commit/46ca4ff2e1a27e2725aaa7da1906bebeae6763ac) page (https://github.com/badinkajink/hand/blob/46ca4ff2e1a27e2725aaa7da1906bebeae6763ac/docs/pages.html)
162. 2026-10-30 · Design page, sizes: the best tenth's overlap between sphere sizes (twist 8 % from 30 to 63 mm, below a random tenth's 10 %; roll 19 %) · 6a9b0319c (https://github.com/badinkajink/hand/commit/6a9b0319ca215d5088c99f0bff16d23e22af7341) page (https://github.com/badinkajink/hand/blob/6a9b0319ca215d5088c99f0bff16d23e22af7341/docs/pages.html)
163. 2026-10-30 · Design page: layouts across object sizes, spheres (twist and roll on 30-63 mm, 8,192 Sobol layouts, v4b tip) · de8f66057 (https://github.com/badinkajink/hand/commit/de8f66057b52982cbf4ec179d953c5d2799425ea) page (https://github.com/badinkajink/hand/blob/de8f66057b52982cbf4ec179d953c5d2799425ea/docs/pages.html)
164. 2026-10-30 · MPC over HOM's commands: a central-difference gradient planner (fails at the pad-loss cliff); size-study and cross-task analysis code · c876d7f7d (https://github.com/badinkajink/hand/commit/c876d7f7dfe099cb76e9c1e2ef3ee9345a9fb494) page (https://github.com/badinkajink/hand/blob/c876d7f7dfe099cb76e9c1e2ef3ee9345a9fb494/docs/pages.html)
165. 2026-10-30 · MPC over HOM's commands: the batched controller captured as one CUDA graph (0.032 -> 0.094 x real time) · 2dd938d85 (https://github.com/badinkajink/hand/commit/2dd938d85b2f400fa8d9c319d159f96ccc236f06) page (https://github.com/badinkajink/hand/blob/2dd938d85b2f400fa8d9c319d159f96ccc236f06/docs/pages.html)
166. 2026-10-30 · HOM review page: model-predictive control over HOM's commands (first run and its cost) · 31709e69f (https://github.com/badinkajink/hand/commit/31709e69fefc156a5eb3b8894193968b69e4a93a) page (https://github.com/badinkajink/hand/blob/31709e69fefc156a5eb3b8894193968b69e4a93a/docs/pages.html)
167. 2026-10-30 · Design page: design gradients from a model of the HOM scores (twist, 40 mm sphere) · 2fc3ebe78 (https://github.com/badinkajink/hand/commit/2fc3ebe78f88a418da3bcfbbc63e98a500789024) page (https://github.com/badinkajink/hand/blob/2fc3ebe78f88a418da3bcfbbc63e98a500789024/docs/pages.html)
168. 2026-10-30 · Design page (foundational-pose review): the calibrated v4b fingertip, grasp sets per layout on the 2-D grid, related design studies, and the record of method … · f4463635f (https://github.com/badinkajink/hand/commit/f4463635fe59d299be3fa3aa0f7e5c9c1d051511) page (https://github.com/badinkajink/hand/blob/f4463635fe59d299be3fa3aa0f7e5c9c1d051511/docs/pages.html)
169. 2026-10-30 · HOM controller code walkthrough (subpage of the HOM review page): eleven substeps of a 10 ms period on the v4b hand, with a twist and a pin-push · bdd55c247 (https://github.com/badinkajink/hand/commit/bdd55c247dc9958b7f2d72df3422027addcda1d0) page (https://github.com/badinkajink/hand/blob/bdd55c247dc9958b7f2d72df3422027addcda1d0/docs/pages.html)
170. 2026-10-30 · UR5 calibration, 01:40 on 10-30: the HEX-E back by itself at 01:37; the resume simulated clean, waiting for the owner's go (QUEUE R31, status page) · aa01e0381 (https://github.com/badinkajink/hand/commit/aa01e03817c67aaf3e763194de8ea7e2b7de7f78) page (https://github.com/badinkajink/hand/blob/aa01e03817c67aaf3e763194de8ea7e2b7de7f78/docs/pages.html)
171. 2026-10-30 · The v4b fingertip in simulation (SCALE_HAND=cad_v2): DIP link b v4, cassette 3T, cap TW15H3 trimmed at x_F -0.10 with its M2 heads, and the 11/22 … · 72f382c3f (https://github.com/badinkajink/hand/commit/72f382c3f98bab9db2aee86f6fe5ddbc901012f1) page (https://github.com/badinkajink/hand/blob/72f382c3f98bab9db2aee86f6fe5ddbc901012f1/docs/pages.html)
172. 2026-10-29 · UR5 calibration, 23:13 on 10-29: v3 ID 3's block 2 done 211/211 (16:34-23:07), block 5 running; QUEUE R31 and the status page · b1afbe264 (https://github.com/badinkajink/hand/commit/b1afbe2647f7b29fc055f1c2efcdf269a5294c9a) page (https://github.com/badinkajink/hand/blob/b1afbe2647f7b29fc055f1c2efcdf269a5294c9a/docs/pages.html)
173. 2026-10-29 · Design page: four HOM tasks and sensing errors across 4,680 Sobol layouts on the GPU · c39d07868 (https://github.com/badinkajink/hand/commit/c39d07868ecebf08d0cbb98f0f7afd4bc8b17d17) page (https://github.com/badinkajink/hand/blob/c39d07868ecebf08d0cbb98f0f7afd4bc8b17d17/docs/pages.html)
174. 2026-10-29 · Inverted rig: the lab's probe-mode estimate (lab/NOTES.md 4e877666) in QUEUE R31 and the status page (16:12 on 10-29) · a19a82b41 (https://github.com/badinkajink/hand/commit/a19a82b41a1af01e5e7d5a0b97ab9cea01219aae) page (https://github.com/badinkajink/hand/blob/a19a82b41a1af01e5e7d5a0b97ab9cea01219aae/docs/pages.html)
175. 2026-10-29 · Inverted calibration rig ready to print (owner, 10-29 15:2x): tips held pad up, three seats replayed, P1S projects · 84ea1b72d (https://github.com/badinkajink/hand/commit/84ea1b72db0f415bf405f0f3cc74b35e64b967b1) page (https://github.com/badinkajink/hand/blob/84ea1b72db0f415bf405f0f3cc74b35e64b967b1/docs/pages.html)
176. 2026-10-29 · HOM on the GPU: batched controller on MuJoCo-Warp, validated against the CPU, and the dynamic landscapes of SR2 layouts · 879c66044 (https://github.com/badinkajink/hand/commit/879c66044ba08bfdf64068f8fe661342ef28d074) page (https://github.com/badinkajink/hand/blob/879c66044ba08bfdf64068f8fe661342ef28d074/docs/pages.html)
177. 2026-10-29 · Status page at 15:16 on 10-29: v3 ID 3 on the robot (block 1, top edge 26/26, side map running, night chained); the inverted rig as a decision for the owner · 5ddd18d88 (https://github.com/badinkajink/hand/commit/5ddd18d8885edf0d091ea8e2227e9bc22fd766a4) page (https://github.com/badinkajink/hand/blob/5ddd18d8885edf0d091ea8e2227e9bc22fd766a4/docs/pages.html)
178. 2026-10-29 · Calibration page: the inverted rig as a future item, plate v2e in place of v2d (feed line of 10-29 14:38, 33cfe6f3) · 62ac64545 (https://github.com/badinkajink/hand/commit/62ac645455981f35f936300c94bde2692bc3baa1) page (https://github.com/badinkajink/hand/blob/62ac645455981f35f936300c94bde2692bc3baa1/docs/pages.html)
179. 2026-10-29 · Review pages of the HOM and foundational-pose papers, with fingertip-sensing and layout-sampling toys · 66330a72c (https://github.com/badinkajink/hand/commit/66330a72c9f4a608ac9f6a78e09793b1c8365c97) page (https://github.com/badinkajink/hand/blob/66330a72c9f4a608ac9f6a78e09793b1c8365c97/docs/pages.html)
180. 2026-10-29 · Inverted rig: probe on the HEX-E reaches 444 of 808 pad points on a held tip against 286 for the finger on the robot (owner, 13:0x on 10-29) · 33cfe6f3d (https://github.com/badinkajink/hand/commit/33cfe6f3dc662fadadd8df155c6114603fa29f4f) page (https://github.com/badinkajink/hand/blob/33cfe6f3dc662fadadd8df155c6114603fa29f4f/docs/pages.html)
181. 2026-10-29 · Status page: the owner's inverted rig request of 13:0x on 10-29 and its state at 14:24 · cbdc3a7ae (https://github.com/badinkajink/hand/commit/cbdc3a7ae29258f72944be5e7e8be906fa6e91d2) page (https://github.com/badinkajink/hand/blob/cbdc3a7ae29258f72944be5e7e8be906fa6e91d2/docs/pages.html)
182. 2026-10-29 · Inverted rig page (first build): probe and plate v2e STLs, reach on six seat orientations, QUEUE R31 at 14:2x · ef453c6c8 (https://github.com/badinkajink/hand/commit/ef453c6c8dcb5d45a9efddafbf9d2d439c58d230) page (https://github.com/badinkajink/hand/blob/ef453c6c8dcb5d45a9efddafbf9d2d439c58d230/docs/pages.html)
183. 2026-10-29 · Physical-model page with v3 ID 2: the model on the three N52 tips' shared sphere actions, and the signal per newton by region · 100ec8dba (https://github.com/badinkajink/hand/commit/100ec8dba6ac11b1b392a6f4fe9cab85a7c47893) page (https://github.com/badinkajink/hand/blob/100ec8dba6ac11b1b392a6f4fe9cab85a7c47893/docs/pages.html)
184. 2026-10-29 · Calibration page: what each calibration motion adds on the four-magnet tips (feed line of 10-29 12:45, 9da437e0) · f3980846b (https://github.com/badinkajink/hand/commit/f3980846bd02bb0a626e752f4843214d86e58749) page (https://github.com/badinkajink/hand/blob/f3980846bd02bb0a626e752f4843214d86e58749/docs/pages.html)
185. 2026-10-29 · Owner's answers of 11:37 on 10-29 in the records: v3 README (side map with both held tips up; motions section), QUEUE R31 at 12:4x, feed line 12:45, status … · 4c2797e36 (https://github.com/badinkajink/hand/commit/4c2797e36f18282feca926e4de1eed0a432eb874) page (https://github.com/badinkajink/hand/blob/4c2797e36f18282feca926e4de1eed0a432eb874/docs/pages.html)
186. 2026-10-29 · Calibration motions page for the four-magnet tips: what each motion adds on v3 ID 1 and ID 2 (owner, 11:37 on 10-29: plate v2d waits "until we have 100% … · 9da437e01 (https://github.com/badinkajink/hand/commit/9da437e019a2d923ceba43eb82d58cba34c59565) page (https://github.com/badinkajink/hand/blob/9da437e019a2d923ceba43eb82d58cba34c59565/docs/pages.html)
187. 2026-10-29 · Calibration page: four magnets against five on the tall indenter and on v3 ID 2 (feed lines of 10-29 10:28 and 10:29): Section 11's tall paragraph and Table 12 … · b37d77273 (https://github.com/badinkajink/hand/commit/b37d772738c0901e847ca5d15d6a7470da618bf5) page (https://github.com/badinkajink/hand/blob/b37d772738c0901e847ca5d15d6a7470da618bf5/docs/pages.html)
188. 2026-10-29 · Calibration page: Section 12, v3 ID 2 against v3 ID 1 on the presses both ran (feed lines of 10-29 09:46 and 10:00): Table 14 on the sphere's 116, the rod's 75 … · f0cc0052f (https://github.com/badinkajink/hand/commit/f0cc0052f2f40f7845b196f7eb68647eaf2f72b8) page (https://github.com/badinkajink/hand/blob/f0cc0052f2f40f7845b196f7eb68647eaf2f72b8/docs/pages.html)
189. 2026-10-29 · v3 feed 10:00, README and status page: v3 ID 2 calibrates as v3 ID 1 on the sphere, the rod and the tall indenter (direction GP 0.29, 0.36, 1.06 mm against … · a4839dc72 (https://github.com/badinkajink/hand/commit/a4839dc7223e4216a7698ddb54d8319d28d22dfb) page (https://github.com/badinkajink/hand/blob/a4839dc7223e4216a7698ddb54d8319d28d22dfb/docs/pages.html)
190. 2026-10-29 · Status page at 08:20 on 10-29: v3 ID 2's night suite, 488 actions all ok from 18:44 to 08:13 with no HEX-E time-out; its analyses on the lab computer; the … · e94ccb19c (https://github.com/badinkajink/hand/commit/e94ccb19c4e70422827f570dd051cfbea6648bad) page (https://github.com/badinkajink/hand/blob/e94ccb19c4e70422827f570dd051cfbea6648bad/docs/pages.html)
191. 2026-10-28 · STATE.md at 18:04: the top edge's first 8 run from 18:03:40 with the owner watching; time stamps corrected to the clock (18:05 and the status page's 18:05 were … · 875859ba2 (https://github.com/badinkajink/hand/commit/875859ba2763ffd8a50b0d239916d4ff33cc3ca3) page (https://github.com/badinkajink/hand/blob/875859ba2763ffd8a50b0d239916d4ff33cc3ca3/docs/pages.html)
192. 2026-10-28 · UR5 cell: one current-state file and the superseded plans moved (owner, 18:0x: "we need to consolidate our documentation and calibration runs") · fb158b9a4 (https://github.com/badinkajink/hand/commit/fb158b9a477e79b6debea70252517c0d7fbb5f00) page (https://github.com/badinkajink/hand/blob/fb158b9a477e79b6debea70252517c0d7fbb5f00/docs/pages.html)
193. 2026-10-28 · Calibration page: four magnets against five on the rod (feed line of 15:14) · 9c64f6f44 (https://github.com/badinkajink/hand/commit/9c64f6f44abc3446d78f3051ba17ff3e31cc7714) page (https://github.com/badinkajink/hand/blob/9c64f6f44abc3446d78f3051ba17ff3e31cc7714/docs/pages.html)
194. 2026-10-28 · v3 README and status page at 15:10: tall stage 2's 58 resumed at 14:56 with a 20 mm lift after the HEX-E stop at 14:32; the lab's projected ends (stage 2 … · 62b50ba56 (https://github.com/badinkajink/hand/commit/62b50ba564ea08bffc99ac8f67f6ed823d4b5b29) page (https://github.com/badinkajink/hand/blob/62b50ba564ea08bffc99ac8f67f6ed823d4b5b29/docs/pages.html)
195. 2026-10-28 · Calibration page: the face centre's error with the press targets in folds, four magnets against five (feed line of 13:48) · 9ff67be1a (https://github.com/badinkajink/hand/commit/9ff67be1ac1fdec6bb3725bb94dc8d55d3c1a82f) page (https://github.com/badinkajink/hand/blob/9ff67be1ac1fdec6bb3725bb94dc8d55d3c1a82f/docs/pages.html)
196. 2026-10-28 · Owner at 13:2x: the rod fixture stays on and the held tips up (the side-by-side map waits), the top edge goes ahead with the owner present. Tall stage 2, tall … · 1f72230f7 (https://github.com/badinkajink/hand/commit/1f72230f755097760499a3edb01e2c5ff9a020b8) page (https://github.com/badinkajink/hand/blob/1f72230f755097760499a3edb01e2c5ff9a020b8/docs/pages.html)
197. 2026-10-28 · Calibration page: torsion on v3 ID 1's 12 twists against v2 ID 1's (feed line of 12:25) · 91bcfc2ed (https://github.com/badinkajink/hand/commit/91bcfc2ed4af383f8e589a8d7162c8d3c22ddc14) page (https://github.com/badinkajink/hand/blob/91bcfc2ed4af383f8e589a8d7162c8d3c22ddc14/docs/pages.html)
198. 2026-10-28 · Status page: the v3 row at 12:4x (tall pass 1 done, rod stage 2 running to about 13:45, the visit for the side-by-side map after it, the top edge rebuilt on … · fbd252c2e (https://github.com/badinkajink/hand/commit/fbd252c2e1d5e39063c56753d8763327d0b1eac7) page (https://github.com/badinkajink/hand/blob/fbd252c2e1d5e39063c56753d8763327d0b1eac7/docs/pages.html)
199. 2026-10-28 · Status page: the indenter plate row at the full replay of v2d (84 side hovers, 162 tall, 318 of 337 sphere actions) with the owner's four open questions; the … · 9d7db3a29 (https://github.com/badinkajink/hand/commit/9d7db3a29ae94a35af5e5c8e2f4de97abad9a9c5) page (https://github.com/badinkajink/hand/blob/9d7db3a29ae94a35af5e5c8e2f4de97abad9a9c5/docs/pages.html)
200. 2026-10-28 · Status page: four magnets chosen (owner, 10-28: "i think we will stick with the 4 magnet config"), the decision row resolved with the UR5 numbers, and the … · c74894aa2 (https://github.com/badinkajink/hand/commit/c74894aa24b30779cd09c0f991669b4340b6a100) page (https://github.com/badinkajink/hand/blob/c74894aa24b30779cd09c0f991669b4340b6a100/docs/pages.html)
201. 2026-10-28 · Physical-model page with four magnets (owner, 2026-10-28: "i think we will stick with the 4 magnet config"; the five-magnet figures stay in blocks under "View … · dc0a559a7 (https://github.com/badinkajink/hand/commit/dc0a559a7c457fc993617c7c11d01ab83115cf2e) page (https://github.com/badinkajink/hand/blob/dc0a559a7c457fc993617c7c11d01ab83115cf2e/docs/pages.html)
202. 2026-10-28 · Calibration page: press coverage of the pad as v2 ID 1's three indenters left it (owner, 10-28, on Figure 3: "it seems we actually still dont have very good … · 367c01348 (https://github.com/badinkajink/hand/commit/367c0134862f179d522106945ede0c37e0f9f89e) page (https://github.com/badinkajink/hand/blob/367c0134862f179d522106945ede0c37e0f9f89e/docs/pages.html)
203. 2026-10-28 · Indenter plate page: the full replay of v2d (every sample, travel included): 84 side hovers, 162 tall and 318 of 337 sphere actions clear; no flag names … · b37050ee3 (https://github.com/badinkajink/hand/commit/b37050ee38ebd2097d684f90d59476b1fa63105f) page (https://github.com/badinkajink/hand/blob/b37050ee38ebd2097d684f90d59476b1fa63105f/docs/pages.html)
204. 2026-10-28 · Status page: the indenter plate request done (layout v2d, 7661b204) · 20590859e (https://github.com/badinkajink/hand/commit/20590859e719771e822aa6514aba8d46c5823aa0) page (https://github.com/badinkajink/hand/blob/20590859e719771e822aa6514aba8d46c5823aa0/docs/pages.html)
205. 2026-10-28 · Indenter plate layout: the lab's plans replayed on the printed plate and on a proposed layout (page, tool, STL) · 7661b2042 (https://github.com/badinkajink/hand/commit/7661b204280e2dbd8d04774e2edf6e7f3a69af04) page (https://github.com/badinkajink/hand/blob/7661b204280e2dbd8d04774e2edf6e7f3a69af04/docs/pages.html)
206. 2026-10-28 · Fingertip crosstalk page: the side-by-side plan as rebuilt on mount v7 (85c0eab6): 38 hovers at gaps of 14 to 40 mm, about 19 min; 13 mm dropped (the fork 2.09 … · 393f34775 (https://github.com/badinkajink/hand/commit/393f347756bc2e0e031984874dd4ee3261eb2bfe) page (https://github.com/badinkajink/hand/blob/393f347756bc2e0e031984874dd4ee3261eb2bfe/docs/pages.html)
207. 2026-10-28 · Path checks on mount v7: the side-by-side plan rebuilt (38 hovers at g 14 to 40 mm), one sphere slide under the margin · 85c0eab6f (https://github.com/badinkajink/hand/commit/85c0eab6f6c7fb30b506c2cc37f891911b53d1a2) page (https://github.com/badinkajink/hand/blob/85c0eab6f6c7fb30b506c2cc37f891911b53d1a2/docs/pages.html)
208. 2026-10-28 · Status page: the suite stopped at 02:54 on the HEX-E's connector; the night's results; the morning's queue and decisions (rows 65 and 30) · d58cf1b5e (https://github.com/badinkajink/hand/commit/d58cf1b5ee797178a122fa67bdcc4e0408a0222d) page (https://github.com/badinkajink/hand/blob/d58cf1b5ee797178a122fa67bdcc4e0408a0222d/docs/pages.html)
209. 2026-10-28 · Calibration page: shear on v3 ID 1's first 40 slides, four magnets against five (feed line of 03:13) · 6f7828484 (https://github.com/badinkajink/hand/commit/6f7828484ec6e377ebc59f736acdb832b0be6081) page (https://github.com/badinkajink/hand/blob/6f7828484ec6e377ebc59f736acdb832b0be6081/docs/pages.html)
210. 2026-10-28 · Calibration page: where the magnets sit (feed line of 02:44; owner, 01:5x: "i am pretty sure the magnet positions are pretty locked in in the print") · 6297321ec (https://github.com/badinkajink/hand/commit/6297321ec8da25289cceabef1bc8fbdb2abd4fe1) page (https://github.com/badinkajink/hand/blob/6297321ec8da25289cceabef1bc8fbdb2abd4fe1/docs/pages.html)
211. 2026-10-28 · Fingertip crosstalk page: the neighbour's change as a face force against the gap (feed line of 01:28; owner, 01:2x: "at what distances do the effects resolve, … · 45f73937f (https://github.com/badinkajink/hand/commit/45f73937f4b54b4b277b790c3ca92f3992044486) page (https://github.com/badinkajink/hand/blob/45f73937f4b54b4b277b790c3ca92f3992044486/docs/pages.html)
212. 2026-10-28 · Calibration page: v2 ID 1 and v3 ID 1 (owner, 10-28: "are the calibration plots and data/results ... up to date for our results from 10-27 and just now with … · 126a2c40c (https://github.com/badinkajink/hand/commit/126a2c40c3e9837d0f25d9691aad320b29688680) page (https://github.com/badinkajink/hand/blob/126a2c40c3e9837d0f25d9691aad320b29688680/docs/pages.html)
213. 2026-10-28 · Fingertip crosstalk page: the press signal per newton from stage 2's whole grid (feed line of 00:59) · cacda5fe8 (https://github.com/badinkajink/hand/commit/cacda5fe8ad164725b7140206d197144c918763b) page (https://github.com/badinkajink/hand/blob/cacda5fe8ad164725b7140206d197144c918763b/docs/pages.html)
214. 2026-10-28 · UR5 v3 ID 1: four magnets against five on stage 2's whole grid: half the signal per newton, noise-equivalent force 1.8 times, the same calibrated errors (0.26 … · 449464c4e (https://github.com/badinkajink/hand/commit/449464c4e1083fcfde06a9e7ab6f4f43d5780a4f) page (https://github.com/badinkajink/hand/blob/449464c4e1083fcfde06a9e7ab6f4f43d5780a4f/docs/pages.html)
215. 2026-10-28 · Status page: the tall morning plan at 18 actions and the top-edge pass built on a stand-in registration (decision row 30) · 7c3276e51 (https://github.com/badinkajink/hand/commit/7c3276e51cc1095b15efa0ea2ac2c4f335a375b7) page (https://github.com/badinkajink/hand/blob/7c3276e51cc1095b15efa0ea2ac2c4f335a375b7/docs/pages.html)
216. 2026-10-28 · Fingertip crosstalk page: v3 ID 1's press signal per newton beside the measured crosstalk (feed line of 00:18) · c4eed5a34 (https://github.com/badinkajink/hand/commit/c4eed5a34ffa1bfc624c26650b37020c8d617ce3) page (https://github.com/badinkajink/hand/blob/c4eed5a34ffa1bfc624c26650b37020c8d617ce3/docs/pages.html)
217. 2026-10-28 · UR5 v3 ID 1: the path checker makes the turns of slides, rolls and twists; tall-slide-edge-604-1N to the tall morning plan; four magnets against five on stage … · c5fe77750 (https://github.com/badinkajink/hand/commit/c5fe77750b6838672b13ed7d9b6b11c251459e38) page (https://github.com/badinkajink/hand/blob/c5fe77750b6838672b13ed7d9b6b11c251459e38/docs/pages.html)
218. 2026-10-27 · Fingertip crosstalk page: the close hovers over the -y held tip join the holder map · dc8b64789 (https://github.com/badinkajink/hand/commit/dc8b647892413a4cca2a2326dbbc24e811ad7ab2) page (https://github.com/badinkajink/hand/blob/dc8b647892413a4cca2a2326dbbc24e811ad7ab2/docs/pages.html)
219. 2026-10-27 · Fingertip crosstalk page: the holder map's 89 hovers against the net moments fitted on the touch-offs · 80fcc035b (https://github.com/badinkajink/hand/commit/80fcc035ba7199f63586b90835cefc5671a18299) page (https://github.com/badinkajink/hand/blob/80fcc035ba7199f63586b90835cefc5671a18299/docs/pages.html)
220. 2026-10-27 · Status page: the v3 holder map, the crosstalk's net moments and tonight's suite; the owner's morning decisions · 9222c62fd (https://github.com/badinkajink/hand/commit/9222c62fd91291e59bde316ff486b7ebccc4fec2) page (https://github.com/badinkajink/hand/blob/9222c62fd91291e59bde316ff486b7ebccc4fec2/docs/pages.html)
221. 2026-10-27 · Fingertip crosstalk page: the holder map's future-work item follows the plan of 20:45 on 2026-10-27 · 876e01389 (https://github.com/badinkajink/hand/commit/876e01389ca5fc009c2eb58b2bf544136c0242d7) page (https://github.com/badinkajink/hand/blob/876e01389ca5fc009c2eb58b2bf544136c0242d7/docs/pages.html)
222. 2026-10-27 · Calibration page, Figure 1: the UR5 cell rendered in MuJoCo (owner, 10-27), the pad at a face and a flank touch-off · 8a45a8d8f (https://github.com/badinkajink/hand/commit/8a45a8d8f2fc3dc6f8fdfe33291e09f8d1f3d66c) page (https://github.com/badinkajink/hand/blob/8a45a8d8f2fc3dc6f8fdfe33291e09f8d1f3d66c/docs/pages.html)
223. 2026-10-27 · Physical-model page with the N52 tip v2 ID 1, and the crosstalk page's future work as in the v3 plan · 89954a114 (https://github.com/badinkajink/hand/commit/89954a114103e865b422ac3a778acda8f51f57e0) page (https://github.com/badinkajink/hand/blob/89954a114103e865b422ac3a778acda8f51f57e0/docs/pages.html)
224. 2026-10-27 · Status page: the requests of 10-27 (crosstalk, v2 ID 1's rod, R29 on the tall indenter, the v3 plan) and the v3 decisions · 2f7a061f7 (https://github.com/badinkajink/hand/commit/2f7a061f7f8f2a66a7488ce88be2a9648f91d01e) page (https://github.com/badinkajink/hand/blob/2f7a061f7f8f2a66a7488ce88be2a9648f91d01e/docs/pages.html)
225. 2026-10-27 · Published from personal (hand-off 20261027, step 6): the crosstalk page as a new artifact, https://claude.ai/artifact/6fKoeQRRedDZ8yQvAVNQnJ … · 2547e3c2a (https://github.com/badinkajink/hand/commit/2547e3c2aa630c3673b52a5513ee780d4a9b188d) page (https://github.com/badinkajink/hand/blob/2547e3c2aa630c3673b52a5513ee780d4a9b188d/docs/pages.html)
226. 2026-10-27 · Fingertip overview and calibration page with the first-order numbers of 10-27 and the crosstalk (hand-off 20261027, step 5) · fe7c24b46 (https://github.com/badinkajink/hand/commit/fe7c24b461be2b472ff7ee54274e000f1ca9f7b6) page (https://github.com/badinkajink/hand/blob/fe7c24b461be2b472ff7ee54274e000f1ca9f7b6/docs/pages.html)
227. 2026-10-27 · Page on magnetic crosstalk between neighbouring fingertips (hand-off 20261027, step 4) · 8e301f80f (https://github.com/badinkajink/hand/commit/8e301f80f8e7e14d990765f4c6c6a1f99d493d3b) page (https://github.com/badinkajink/hand/blob/8e301f80f8e7e14d990765f4c6c6a1f99d493d3b/docs/pages.html)
228. 2026-10-27 · Contact overview, first part: calibration table, the friction torque's status, creep under the grasp's own forces and the impratio sweep (hand-off 20261027, … · ecf6e7495 (https://github.com/badinkajink/hand/commit/ecf6e7495c6a782b440eacd4525f9b5bfbb19490) page (https://github.com/badinkajink/hand/blob/ecf6e7495c6a782b440eacd4525f9b5bfbb19490/docs/pages.html)
229. 2026-10-27 · Impratio 10 to 300 and noslip under the trainer's numerics, and what the divergence is (hand-off 20261027, steps 1-2) · cb1638a7a (https://github.com/badinkajink/hand/commit/cb1638a7a8918d095bd6bff3a142545008ff3dbc) page (https://github.com/badinkajink/hand/blob/cb1638a7a8918d095bd6bff3a142545008ff3dbc/docs/pages.html)
230. 2026-10-27 · Calibration page, Figure 2: the pad's section faces down onto the sphere (owner, 2026-10-27: "the pad seems to be facing up, not down ... the flat back … · 0bc691046 (https://github.com/badinkajink/hand/commit/0bc691046b628fed49e40fc715e5f01a9143029f) page (https://github.com/badinkajink/hand/blob/0bc691046b628fed49e40fc715e5f01a9143029f/docs/pages.html)
231. 2026-10-27 · Soak page: Figure 1's clock ticks every second hour; the pads' recovery text places ID 1's rise of 7 uT at 18:50-19:12 and ID 2's uniform steps at 16:25 and … · 0dd2d8337 (https://github.com/badinkajink/hand/commit/0dd2d833743b3c522225cf5241f8a70d176aeffb) page (https://github.com/badinkajink/hand/blob/0dd2d833743b3c522225cf5241f8a70d176aeffb/docs/pages.html)
232. 2026-10-27 · Soak page: long sentences split (mean 17.8 words, 0.8 % over 30), the analysed window ends at 04:00 · b70408f0c (https://github.com/badinkajink/hand/commit/b70408f0c07eef69b50c39a4669d89a4e1bc509a) page (https://github.com/badinkajink/hand/blob/b70408f0c07eef69b50c39a4669d89a4e1bc509a/docs/pages.html)
233. 2026-10-27 · Page on the three v1 fingertips' night at rest: prose from the final numbers of 19:35-04:00 (readout passes, no contact at 2 uT and one frame at 1 uT, the … · a076be822 (https://github.com/badinkajink/hand/commit/a076be8225333ede681d8615eadd19f7b42affbe) page (https://github.com/badinkajink/hand/blob/a076be8225333ede681d8615eadd19f7b42affbe/docs/pages.html)
234. 2026-10-26 · Pads 05S and 05S4: pads 05R and 05R4 with snap-fit magnet slots (owner, 2026-10-26: "have the pocket come up past the diameter of the disc"). · 7d2989bd2 (https://github.com/badinkajink/hand/commit/7d2989bd2f94c7613479c088c474a4e515a31607) page (https://github.com/badinkajink/hand/blob/7d2989bd2f94c7613479c088c474a4e515a31607/docs/pages.html)
235. 2026-10-26 · Shear page published at https://claude.ai/artifact/CnBMCjLER7QwW64vKSjMaS … · ca829f461 (https://github.com/badinkajink/hand/commit/ca829f4614c05fca55cc6e0a6b020bbaee1c13ce) page (https://github.com/badinkajink/hand/blob/ca829f4614c05fca55cc6e0a6b020bbaee1c13ce/docs/pages.html)
236. 2026-10-26 · Shear page and contact overview at the friction coefficient from the shear's magnitude (hand-off 20261026-shear_friction_impratio, step 5). The skin replays of … · 8d99dd5f3 (https://github.com/badinkajink/hand/commit/8d99dd5f383eb0ed6d2b9e045194ba196817ff59) page (https://github.com/badinkajink/hand/blob/8d99dd5f383eb0ed6d2b9e045194ba196817ff59/docs/pages.html)
237. 2026-10-26 · Result page: shear, friction coefficient and impratio of the printed fingertip against the UR5 slides (hand-off 20261026-shear_friction_impratio, step 5, … · 119af3a3a (https://github.com/badinkajink/hand/commit/119af3a3a56cdc7dcddb8010b4aed6f837195df6) page (https://github.com/badinkajink/hand/blob/119af3a3a56cdc7dcddb8010b4aed6f837195df6/docs/pages.html)
238. 2026-10-26 · Fingertip pads 05R4 (four magnets in a 5.0 mm square centred on the centre chip U1) and 05R (B05R without the engraved B), three of each per Prusa XL project; … · 177c6943f (https://github.com/badinkajink/hand/commit/177c6943ffe9961bf38368a3d6f14e3c8995a92f) page (https://github.com/badinkajink/hand/blob/177c6943ffe9961bf38368a3d6f14e3c8995a92f/docs/pages.html)
239. 2026-10-26 · Indices: the physical-model page's artifact link (docs_index after its artifact_url.txt) · d56e1b5b9 (https://github.com/badinkajink/hand/commit/d56e1b5b98d0fad97867e95fc7321d6319a4e690) page (https://github.com/badinkajink/hand/blob/d56e1b5b98d0fad97867e95fc7321d6319a4e690/docs/pages.html)
240. 2026-10-26 · Fingertip physical-model and calibration pages published on personal: https://claude.ai/artifact/HLwPSJ2FXb1BChAQ98rTX1 and … · b73f5cd7b (https://github.com/badinkajink/hand/commit/b73f5cd7b69058bc59dbaada734fe6a3ff910505) page (https://github.com/badinkajink/hand/blob/b73f5cd7b69058bc59dbaada734fe6a3ff910505/docs/pages.html)
241. 2026-10-26 · Fingertip calibration page (owner, 2026-10-26: the calibration's motions, geometry, desired sensing result, the protocol formalized, the learning architecture … · 3a982fad1 (https://github.com/badinkajink/hand/commit/3a982fad17a6d26b50fc0f5426f4ecc01e982145) page (https://github.com/badinkajink/hand/blob/3a982fad17a6d26b50fc0f5426f4ecc01e982145/docs/pages.html)
242. 2026-10-26 · Fingertip physical model page (owner, 2026-10-26: understand the FEA, the printed tip and the magnetic sensing that make the physical model). One page explains … · 8e425c2b6 (https://github.com/badinkajink/hand/commit/8e425c2b6f8d5f4655a8b0ea15916f24d2150242) page (https://github.com/badinkajink/hand/blob/8e425c2b6f8d5f4655a8b0ea15916f24d2150242/docs/pages.html)
243. 2026-10-26 · assets/cad_v2: the DIP link b v4 with its fingertip parts (cassette 3T, top cover TW15H3, pad B05R), the UR5e mount v7 and the ATI Mini45 and Mini40 fixtures, … · 429e0292a (https://github.com/badinkajink/hand/commit/429e0292adc08dd0b72b9b57aa3d44015d84791d) page (https://github.com/badinkajink/hand/blob/429e0292adc08dd0b72b9b57aa3d44015d84791d/docs/pages.html)
244. 2026-10-26 · Status page: both checkerboard tips' suites done (10-26 00:24): location follows coverage (37 new targets 2.13 -> 0.47 mm with neighbours in training), shear … · a09a6bd87 (https://github.com/badinkajink/hand/commit/a09a6bd87806faa7df40656888274d80b0e8b748) page (https://github.com/badinkajink/hand/blob/a09a6bd87806faa7df40656888274d80b0e8b748/docs/pages.html)
245. 2026-10-25 · UR5 mount v7: v3's leg walls put back at the owner's word ("it slots in fine, and it will slot in fine with the tighter fit"); the palmar widening of the … · f7af01ed1 (https://github.com/badinkajink/hand/commit/f7af01ed1e45a830d68f16c182f002b247d53e8c) page (https://github.com/badinkajink/hand/blob/f7af01ed1e45a830d68f16c182f002b247d53e8c/docs/pages.html)
246. 2026-10-25 · Fingertips beside each other on the hand: paused by the owner (10-25 12:58) until every fingertip has its UR5 calibration, then a calibration on the SR2 hand … · bdff31a67 (https://github.com/badinkajink/hand/commit/bdff31a678f777aa2f66c6f702eeca7d8d58d553) page (https://github.com/badinkajink/hand/blob/bdff31a678f777aa2f66c6f702eeca7d8d58d553/docs/pages.html)
247. 2026-10-25 · Three fingers stacked and left at rest for 39 minutes (owner, 10-25 11:39-12:18): no contact shown at rest in 23,264 frames a finger, the change read at a … · 56702bcf1 (https://github.com/badinkajink/hand/commit/56702bcf1af69483877b5c1f6c56b0c3da8d00eb) page (https://github.com/badinkajink/hand/blob/56702bcf1af69483877b5c1f6c56b0c3da8d00eb/docs/pages.html)
248. 2026-10-25 · Status page: R24 pass 3 queued with the owner's go for every pass (10-25 11:43). Left-right misses in the robot data (sphere2 2.77 against 1.35 mm, cb1t 0.82 … · a6d19b098 (https://github.com/badinkajink/hand/commit/a6d19b0982d284383d78eaf8e1270b264190aee6) page (https://github.com/badinkajink/hand/blob/a6d19b0982d284383d78eaf8e1270b264190aee6/docs/pages.html)
249. 2026-10-25 · Fingertip overview and status page: three fingers read together through one I2C mux (owner, 10-25). 152 records a second, every conversion of the 15 chips; … · 71045d692 (https://github.com/badinkajink/hand/commit/71045d692da090e136fa16c00ce26845be12440b) page (https://github.com/badinkajink/hand/blob/71045d692da090e136fa16c00ce26845be12440b/docs/pages.html)
250. 2026-10-25 · UR5 mount v7: a rigid back below the dorsal ear whose face lies 0.2 mm into the DIP link's tongue from z_F -97.5 to -83.5, a relief above it for the neck, and … · d589b38a1 (https://github.com/badinkajink/hand/commit/d589b38a10cc8bfc890ba8e977bc5f02322ffeee) page (https://github.com/badinkajink/hand/blob/d589b38a10cc8bfc890ba8e977bc5f02322ffeee/docs/pages.html)
251. 2026-10-25 · UR5 calibration (cb1t): checks of the physical estimator and of the contact wrench (owner, 10-25: "we can try these fixes to the physical model estimator"; "we … · 67c0d776d (https://github.com/badinkajink/hand/commit/67c0d776d224999e5d30e4da1417ebec763c8484) page (https://github.com/badinkajink/hand/blob/67c0d776d224999e5d30e4da1417ebec763c8484/docs/pages.html)
252. 2026-10-25 · UR5 calibration (cb1t): the physical model with a correction. At 2 N and over the rest fit's model misses held-out contacts by 1.16 mm; corrected by a GP on … · b00e2b15f (https://github.com/badinkajink/hand/commit/b00e2b15f1dcb73ea44834c66e32eccb3d750dbf) page (https://github.com/badinkajink/hand/blob/b00e2b15f1dcb73ea44834c66e32eccb3d750dbf/docs/pages.html)
253. 2026-10-25 · UR5 calibration: cb1t follows the plan (owner, 10-25: poles named from the board's side) and its magnets are sphere2's; R24 for v1 ID 2 on mount v6 · 88f961d97 (https://github.com/badinkajink/hand/commit/88f961d97865874fab81155b987d20aa20e3c337) page (https://github.com/badinkajink/hand/blob/88f961d97865874fab81155b987d20aa20e3c337/docs/pages.html)
254. 2026-10-24 · UR5 calibration (R22): cb1t's poles stated for both readings of the plan, the overview, the status page and QUEUE.md · e6497529a (https://github.com/badinkajink/hand/commit/e6497529a42b4e5c91f845585e22e917c55a039c) page (https://github.com/badinkajink/hand/blob/e6497529a42b4e5c91f845585e22e917c55a039c/docs/pages.html)
255. 2026-10-24 · UR5 calibration (R22): cb1t analysed, the first checkerboard fingertip. Of the 32 pole patterns, (+1, -1, -1, -1, +1) fits the field at rest at 0.24 mT: the … · 7f9c3186f (https://github.com/badinkajink/hand/commit/7f9c3186f390239e773e3ffd2e158cbc704f08f0) page (https://github.com/badinkajink/hand/blob/7f9c3186f390239e773e3ffd2e158cbc704f08f0/docs/pages.html)
256. 2026-10-23 · Explain contact torque and printed fingertip sensing before detailed results · 9ef34f3e3 (https://github.com/badinkajink/hand/commit/9ef34f3e3845b77bbbb82900c779007906344585) page (https://github.com/badinkajink/hand/blob/9ef34f3e3845b77bbbb82900c779007906344585/docs/pages.html)
257. 2026-10-23 · UR5 calibration mount v6 (owner, 10-23 evening: the back surface flush with the board's backing, wiggled in, a fillet; "generate a few versions that require a … · bcd2f1956 (https://github.com/badinkajink/hand/commit/bcd2f19569c550245d0e05c03d928c07742bcea4) page (https://github.com/badinkajink/hand/blob/bcd2f19569c550245d0e05c03d928c07742bcea4/docs/pages.html)
258. 2026-10-23 · Mount v5's wedge does not work (owner, 10-23 evening: "this really did not work at all ... the brass inserts were not a good idea at all"); the robot runs v3's … · eef5b3480 (https://github.com/badinkajink/hand/commit/eef5b348076a3ea5462636cff5434825a9338880) page (https://github.com/badinkajink/hand/blob/eef5b348076a3ea5462636cff5434825a9338880/docs/pages.html)
259. 2026-10-23 · DIP link b: the 3T set with its interference fits is the design (owner, 2026-10-23 19:19: 'in the end, i thinkt eh interference fits are quite important. we … · 424455c18 (https://github.com/badinkajink/hand/commit/424455c18da5c2ac2e96153db87a4351121b3a3d) page (https://github.com/badinkajink/hand/blob/424455c18da5c2ac2e96153db87a4351121b3a3d/docs/pages.html)
260. 2026-10-23 · Status page (18:58): the checkerboard tips' row with the owner's answers (same pad, one tip per night, the ATI only if its calibration goes well), the two-pass … · d42d3f0eb (https://github.com/badinkajink/hand/commit/d42d3f0eb094853f3a5068e9422cf34f30e9e862) page (https://github.com/badinkajink/hand/blob/d42d3f0eb094853f3a5068e9422cf34f30e9e862/docs/pages.html)
261. 2026-10-23 · ATI calibration (17:52): a base and top for the Mini40 from ATI's drawings, its robot plan and its simulated sessions; the stack script takes --sensor · d3aa72265 (https://github.com/badinkajink/hand/commit/d3aa72265b665e60abdb5bbaf196675254b96bc4) page (https://github.com/badinkajink/hand/blob/d3aa72265b665e60abdb5bbaf196675254b96bc4/docs/pages.html)
262. 2026-10-23 · UR5 results page: two Section 9 sentences split; the page is within the prose targets (18.0 words a sentence, 0.3 % over 30) · de333b4a4 (https://github.com/badinkajink/hand/commit/de333b4a4e2c4c34b0fb5c6d34a1d97041d4cc55) page (https://github.com/badinkajink/hand/blob/de333b4a4e2c4c34b0fb5c6d34a1d97041d4cc55/docs/pages.html)
263. 2026-10-23 · Status page: as of 16:31 (the stamp of 792a6797 ran two minutes ahead of the clock) · a086f9caa (https://github.com/badinkajink/hand/commit/a086f9caa3248895c6ebc3d5b808c83149bceecc) page (https://github.com/badinkajink/hand/blob/a086f9caa3248895c6ebc3d5b808c83149bceecc/docs/pages.html)
264. 2026-10-23 · UR5 calibration (R22): two passes per tip, since every registration lapsed when the finger came off at 16:30 (lab f05c1678): plain touch-offs and a … · 792a67970 (https://github.com/badinkajink/hand/commit/792a67970541ea24c713fc252b4f8cbf8be8708f) page (https://github.com/badinkajink/hand/blob/792a67970541ea24c713fc252b4f8cbf8be8708f/docs/pages.html)
265. 2026-10-23 · Contact estimator: a test against fields from outside the pad rejects steel touched to the fingertip (viewer toggle, key f) · a710bd23a (https://github.com/badinkajink/hand/commit/a710bd23a40d062c2e47beefb778834f03619b9c) page (https://github.com/badinkajink/hand/blob/a710bd23a40d062c2e47beefb778834f03619b9c/docs/pages.html)
266. 2026-10-23 · UR5 calibration (R21 done): last night's predictors hold a day later; results page Section 9 · 0a353b20c (https://github.com/badinkajink/hand/commit/0a353b20cbf360e0d3173b822217c0789114b4f9) page (https://github.com/badinkajink/hand/blob/0a353b20cbf360e0d3173b822217c0789114b4f9/docs/pages.html)
267. 2026-10-23 · UR5 calibration (R22 draft): offset touch-offs fix the contact's place along the finger, and the overnight plan for the checkerboard tips · 435665708 (https://github.com/badinkajink/hand/commit/43566570815adfdf67cc49359647e94472944970) page (https://github.com/badinkajink/hand/blob/43566570815adfdf67cc49359647e94472944970/docs/pages.html)
268. 2026-10-23 · ATI calibration (15:55): cap 2 for the measured knob with a tie hole, and the hung line modelled from its knot; a thin flexible line, not copper wire · 0cc437398 (https://github.com/badinkajink/hand/commit/0cc437398caeb0b6a709c7c5d052a8f9eb1f7667) page (https://github.com/badinkajink/hand/blob/0cc437398caeb0b6a709c7c5d052a8f9eb1f7667/docs/pages.html)
269. 2026-10-23 · Status page before compaction: R21 day repeat planned (27 presses, waiting for the owner's confirmation in the lab session); the checkerboard tips' pattern … · 7adba0da2 (https://github.com/badinkajink/hand/commit/7adba0da27a1c9c7da678c703c57250c37c9d800) page (https://github.com/badinkajink/hand/blob/7adba0da27a1c9c7da678c703c57250c37c9d800/docs/pages.html)
270. 2026-10-23 · Magnet transfer simulation with the checkerboard actually printed (centre and one diagonal against the other, +-+-+): the correction trained on today's magnets … · 1c2394be7 (https://github.com/badinkajink/hand/commit/1c2394be75aa2cd657b9f6395e17324cba089daa) page (https://github.com/badinkajink/hand/blob/1c2394be75aa2cd657b9f6395e17324cba089daa/docs/pages.html)
271. 2026-10-23 · UR5 calibration (R19) done at 13:58: rod 0.069 mm + 0.100 mm/N beyond the FE pad against the sphere's 0.20-0.22 mm/N; status page with the split and the next … · b6841d7da (https://github.com/badinkajink/hand/commit/b6841d7daa7b188b59bd8da7639f6860b102bb42) page (https://github.com/badinkajink/hand/blob/b6841d7daa7b188b59bd8da7639f6860b102bb42/docs/pages.html)
272. 2026-10-23 · UR5 calibration (R19): rod run analysed with a joint registration of three sessions; the extra travel splits into at most 0.10 mm/N in series and the rest at … · 84ddf7556 (https://github.com/badinkajink/hand/commit/84ddf7556aec9df722a8ac7c8ecf8a67edaed61f) page (https://github.com/badinkajink/hand/blob/84ddf7556aec9df722a8ac7c8ecf8a67edaed61f/docs/pages.html)
273. 2026-10-23 · ATI calibration (13:13): a printed holder for the lab's 100 g weight, and the calibration's error against the hung mass · 555db445a (https://github.com/badinkajink/hand/commit/555db445a188add0e2f33149ad05f187fe2ef195) page (https://github.com/badinkajink/hand/blob/555db445a188add0e2f33149ad05f187fe2ef195/docs/pages.html)
274. 2026-10-23 · UR5 calibration (R19) at 13:08: sph3t's onsets repeat sphere2's, so the rod is fitted with the spheres' tool; status page with the sphere-pad answer and the … · 32e99ca2d (https://github.com/badinkajink/hand/commit/32e99ca2db7548744a9b131119379ac1070a082c) page (https://github.com/badinkajink/hand/blob/32e99ca2db7548744a9b131119379ac1070a082c/docs/pages.html)
275. 2026-10-23 · Status page at 13:09: the second fingertip's row points at its page (0.93 mm spread, 3.07 mm from the reference point, correction 3.71 mm), and the owner's … · 1bc718de2 (https://github.com/badinkajink/hand/commit/1bc718de2bd5c112d537ba8ec62fe2c6974fcb49) page (https://github.com/badinkajink/hand/blob/1bc718de2bd5c112d537ba8ec62fe2c6974fcb49/docs/pages.html)
276. 2026-10-23 · UR5 calibration: the sphere-pad model against sphere2's 357 press holds (owner's request, 10-23 12:50) · 544b18d4b (https://github.com/badinkajink/hand/commit/544b18d4b9bfe1575f0387da41f10a27edd4c2b8) page (https://github.com/badinkajink/hand/blob/544b18d4b9bfe1575f0387da41f10a27edd4c2b8/docs/pages.html)
277. 2026-10-23 · Second fingertip page (owner, 10-23: "make sure this transfer is documented well"): the UR5 fingertip's calibration applied to the desk's fingertip, whose two … · 30f1d2811 (https://github.com/badinkajink/hand/commit/30f1d2811c5339ac651915846346f8e639b40f22) page (https://github.com/badinkajink/hand/blob/30f1d2811c5339ac651915846346f8e639b40f22/docs/pages.html)
278. 2026-10-23 · Status page before compaction (10-23 12:48): R19 with rod1t's outlier and the clean fit, sph3t running · 90d99c97a (https://github.com/badinkajink/hand/commit/90d99c97a61c20410c7a0c40ff5aedbb49a91358) page (https://github.com/badinkajink/hand/blob/90d99c97a61c20410c7a0c40ff5aedbb49a91358/docs/pages.html)
279. 2026-10-23 · Status page: the second fingertip against sphere2's calibration (10-23 12:30): rest fit finds its poles, raw predictors do not transfer, the rebuilt physical … · 0cb535077 (https://github.com/badinkajink/hand/commit/0cb5350776bc8f619c6e94659432346bd7c72370) page (https://github.com/badinkajink/hand/blob/0cb5350776bc8f619c6e94659432346bd7c72370/docs/pages.html)
280. 2026-10-23 · ATI calibration (owner, 11:05 on 10-23: "design a mount for the ATI for the HEX-E and build up a calibration plan ... the Z-axis is the noisiest axis ... maybe … · 6e1e77025 (https://github.com/badinkajink/hand/commit/6e1e77025f2c5c07a57a5d79d00f089c839cd5f2) page (https://github.com/badinkajink/hand/blob/6e1e77025f2c5c07a57a5d79d00f089c839cd5f2/docs/pages.html)
281. 2026-10-23 · UR5 calibration (R19) at 12:13: a second simulated truth; the joint fit at the program's priors halves the contact-location error under both truths, the 4x … · e819db532 (https://github.com/badinkajink/hand/commit/e819db5320639c9d2d362b0051e1b7b19c6b1c4f) page (https://github.com/badinkajink/hand/blob/e819db5320639c9d2d362b0051e1b7b19c6b1c4f/docs/pages.html)
282. 2026-10-23 · UR5 calibration mount v5 (owner, after v4's fork went to the P1S: the lab has the heat-set inserts but no brass set screws or nuts; "a constraining v5 that … · 260d93fc4 (https://github.com/badinkajink/hand/commit/260d93fc433de48a782a86017ee8649ea1dd495e) page (https://github.com/badinkajink/hand/blob/260d93fc433de48a782a86017ee8649ea1dd495e/docs/pages.html)
283. 2026-10-23 · UR5 calibration (R19) at 11:31: how each registration places the contacts, end to end in simulation with sphere2's tool error as the truth · 26db15156 (https://github.com/badinkajink/hand/commit/26db15156985d3d9ae69d6e88313cabfbe5f5dfc) page (https://github.com/badinkajink/hand/blob/26db15156985d3d9ae69d6e88313cabfbe5f5dfc/docs/pages.html)
284. 2026-10-23 · Mount v4 and the ATI calibration moved to their own conversations (owner, 10:51 on 10-23: "i dont want to pollute the calibration channels") · 5fe7042ed (https://github.com/badinkajink/hand/commit/5fe7042ed7fb5527ddd82ce3ba135c0fa7cfde90) page (https://github.com/badinkajink/hand/blob/5fe7042ed7fb5527ddd82ce3ba135c0fa7cfde90/docs/pages.html)
285. 2026-10-23 · Status page before compaction (10-23 08:36): R19 checked by the lab, waiting for the owner's go; the rod FE comparison ready · da9af2824 (https://github.com/badinkajink/hand/commit/da9af2824e1c08873720ce95c9a024ce9e534824) page (https://github.com/badinkajink/hand/blob/da9af2824e1c08873720ce95c9a024ce9e534824/docs/pages.html)
286. 2026-10-23 · ATI calibration page and status at 08:27: the plate sentence split; the status row with the gravity-station check and the plate · b28ba7057 (https://github.com/badinkajink/hand/commit/b28ba7057a700d3e85c611153382472cc82c8f04) page (https://github.com/badinkajink/hand/blob/b28ba7057a700d3e85c611153382472cc82c8f04/docs/pages.html)
287. 2026-10-23 · ATI calibration: the base, top and hook cross on one P1S plate (draft, the Mini45 unmeasured): 3 h 38 min, 142 g; slicing after a remeasure is … · ce04ba9d2 (https://github.com/badinkajink/hand/commit/ce04ba9d2670abbf61ab5d41e4ff823888d282c7) page (https://github.com/badinkajink/hand/blob/ce04ba9d2670abbf61ab5d41e4ff823888d282c7/docs/pages.html)
288. 2026-10-23 · ATI calibration page: the gravity-station step in two sentences · aea2eab55 (https://github.com/badinkajink/hand/commit/aea2eab5506a60347109fc1c701687816f7afd85) page (https://github.com/badinkajink/hand/blob/aea2eab5506a60347109fc1c701687816f7afd85/docs/pages.html)
289. 2026-10-23 · Fingertip transfer across magnets: predictors on the magnets' solved translations (each set's own field model) carry over poorly (GP 2.9-3.2 mm; MLP 9.0 mm on … · f26042261 (https://github.com/badinkajink/hand/commit/f26042261eb123161ed4dd7e61fb0096f7a5ff2e) page (https://github.com/badinkajink/hand/blob/f26042261eb123161ed4dd7e61fb0096f7a5ff2e/docs/pages.html)
290. 2026-10-23 · Fingertip predictors on real presses (sphere2, four folds): the physical model with a GP or MLP correction on its own estimate, the kind that carries over to … · 07976f89b (https://github.com/badinkajink/hand/commit/07976f89bbe4768facbec7ea3e173555958f8543) page (https://github.com/badinkajink/hand/blob/07976f89bbe4768facbec7ea3e173555958f8543/docs/pages.html)
291. 2026-10-23 · Status page and queue at 08:19 on 10-23: the owner's four morning questions (MLP against GP, transfer to N52 and a checkerboard, cylinder presses R19, ATI … · 870fcd533 (https://github.com/badinkajink/hand/commit/870fcd533e04575448b78688d3eb8d86054615f7) page (https://github.com/badinkajink/hand/blob/870fcd533e04575448b78688d3eb8d86054615f7/docs/pages.html)
292. 2026-10-23 · ATI Mini45 calibration plan (owner, 10-23: replace the HEX-E with a calibrated ATI; a printed mount on the HEX-E with the current indenter setup): presses … · ba8f47e4a (https://github.com/badinkajink/hand/commit/ba8f47e4ac9a827461e71db2be893d84bade8ae7) page (https://github.com/badinkajink/hand/blob/ba8f47e4ac9a827461e71db2be893d84bade8ae7/docs/pages.html)
293. 2026-10-23 · Fingertip predictors across magnets (owner, 10-23: N52 and a checkerboard of poles), simulated on sphere2's mechanics with a pad 1.15 times as compliant as the … · 877bf701a (https://github.com/badinkajink/hand/commit/877bf701ae2c12296285e0d3ba43095b5032b816) page (https://github.com/badinkajink/hand/blob/877bf701ae2c12296285e0d3ba43095b5032b816/docs/pages.html)
294. 2026-10-23 · UR5 calibration predictors: an MLP ensemble (5 x two hidden layers of 64, torch, steps chosen on the latest fifth of the training presses). sphere2, 15 … · fd6289923 (https://github.com/badinkajink/hand/commit/fd62899237deb378a217d8c743aa09c63ae743b6) page (https://github.com/badinkajink/hand/blob/fd62899237deb378a217d8c743aa09c63ae743b6/docs/pages.html)
295. 2026-10-23 · Docs index: the UR5 board drift page under 23 October (d0f7348e), its artifact kept · f850b8db7 (https://github.com/badinkajink/hand/commit/f850b8db761a2fdccbe6493be6904b1917b86b78) page (https://github.com/badinkajink/hand/blob/f850b8db761a2fdccbe6493be6904b1917b86b78/docs/pages.html)
296. 2026-10-23 · Docs index with the UR5 board drift page (c521db5a) and its artifact (claude.ai/artifact/JjpJFq6Ez2TNfyjDmMtd3A) in its own INDEX.md row · 84df9b10b (https://github.com/badinkajink/hand/commit/84df9b10b7071bb3aa9c2d4f33ea9f0646f258e4) page (https://github.com/badinkajink/hand/blob/84df9b10b7071bb3aa9c2d4f33ea9f0646f258e4/docs/pages.html)
297. 2026-10-23 · Printed-fingertip status page: the request for a rigid DIP-link mount and mount v4 (not printed) as a decision for the owner · f4d0198fc (https://github.com/badinkajink/hand/commit/f4d0198fcd118ce81c281b32741288c14119cdcf) page (https://github.com/badinkajink/hand/blob/f4d0198fcd118ce81c281b32741288c14119cdcf/docs/pages.html)
298. 2026-10-23 · UR5 calibration mount v4 (R18, the owner's request through the lab: the DIP link moves in v3's fork): v3 with a stop plate behind the tongue and three brass M3 … · 0c2ea7865 (https://github.com/badinkajink/hand/commit/0c2ea7865ec66d942018676b1a0e295c77f58e92) page (https://github.com/badinkajink/hand/blob/0c2ea7865ec66d942018676b1a0e295c77f58e92/docs/pages.html)
299. 2026-10-22 · Docs index: the UR5 lab page's artifact (claude.ai/artifact/1yHnNnGGE7Aq7VMZQmLvdw) in its own INDEX.md row, not a folder-wide artifact_url.txt, since the … · 3501c6b46 (https://github.com/badinkajink/hand/commit/3501c6b46e7348c4d65528ca3f5ca7ed6d3e947e) page (https://github.com/badinkajink/hand/blob/3501c6b46e7348c4d65528ca3f5ca7ed6d3e947e/docs/pages.html)
300. 2026-10-22 · Docs index with the UR5 lab page (97caa02a), run on the workstation for the lab's clone; the results page now links the lab page · 60481f5bc (https://github.com/badinkajink/hand/commit/60481f5bcec93ce7d3df2051c21191ab490089c8) page (https://github.com/badinkajink/hand/blob/60481f5bcec93ce7d3df2051c21191ab490089c8/docs/pages.html)
301. 2026-10-22 · UR5 calibration: grid-061, -065, -066 and -067 left out of the ground truth (0.3 to 0.4 N on the HEX-E off the pad, the lab's finding), results rerun: … · 672642800 (https://github.com/badinkajink/hand/commit/672642800f42b498d532ef80403179f90ed27b9f) page (https://github.com/badinkajink/hand/blob/672642800f42b498d532ef80403179f90ed27b9f/docs/pages.html)
302. 2026-10-22 · Printed-fingertip status page at 23:39: the UR5 run sphere2 on the whole session (the compliance in series with the pad, the estimator's offset, the predictor … · 8a648ec17 (https://github.com/badinkajink/hand/commit/8a648ec179802b7c2c60d50ee902502af8401c9a) page (https://github.com/badinkajink/hand/blob/8a648ec179802b7c2c60d50ee902502af8401c9a/docs/pages.html)
303. 2026-10-22 · UR5 calibration results on the whole sphere2 session (451 holds): FE force 5.1 times the measured at the registered positions while the board reads 0.78-0.96 … · d42db5bf1 (https://github.com/badinkajink/hand/commit/d42db5bf1975f5772dff3d5a3e6d3f240a653812) page (https://github.com/badinkajink/hand/blob/d42db5bf1975f5772dff3d5a3e6d3f240a653812/docs/pages.html)
304. 2026-10-22 · UR5 calibration results page (scripts/ur5_tip_calibration_results_page.py): pad compliance against the FE model, the board against the HEX-E, the pivot check, … · b34784f64 (https://github.com/badinkajink/hand/commit/b34784f64508c9d0e4bf76947e83a3095f661967) page (https://github.com/badinkajink/hand/blob/b34784f64508c9d0e4bf76947e83a3095f661967/docs/pages.html)
305. 2026-10-22 · Printed-fingertip status page: the UR5 calibration run sphere2 (registration, dropped actions, the compliance between the board and the HEX-E, the predictor … · 8ebc6a2c5 (https://github.com/badinkajink/hand/commit/8ebc6a2c5e231ffa0ef2b0a3bf310d77983a5f2c) page (https://github.com/badinkajink/hand/blob/8ebc6a2c5e231ffa0ef2b0a3bf310d77983a5f2c/docs/pages.html)
306. 2026-10-22 · Printed-fingertip status page: the UR5 runs lost the HEX-E's link seven times (R10, the owner inspects the connector and port), the gravity sweep left out … · e63b602ef (https://github.com/badinkajink/hand/commit/e63b602ef5ff5a29aecdd501bcf3d083c06e8b86) page (https://github.com/badinkajink/hand/blob/e63b602ef5ff5a29aecdd501bcf3d083c06e8b86/docs/pages.html)
307. 2026-10-22 · Printed-fingertip status page: the UR5 calibration running on the robot (two runs, the HEX-E's loose connector, the e-stop at 19:59, the plan's new checks), … · e36dafc33 (https://github.com/badinkajink/hand/commit/e36dafc330cd12eb53bbc6f238a64059d58bc195) page (https://github.com/badinkajink/hand/blob/e36dafc330cd12eb53bbc6f238a64059d58bc195/docs/pages.html)
308. 2026-10-22 · Plain-language pass of the contact research asides page (2026-10-22): judge 5 of 7 pairs better, one repaired · d605a7d09 (https://github.com/badinkajink/hand/commit/d605a7d090103095f8eb6338723909787f0f7f92) page (https://github.com/badinkajink/hand/blob/d605a7d090103095f8eb6338723909787f0f7f92/docs/pages.html)
309. 2026-10-22 · Plain-language pass of the screen-versus-chain, calibrated-plant chain and 85A print procedure pages (2026-10-22): judge 19 of 22 pairs better, one repaired · 226ba77c5 (https://github.com/badinkajink/hand/commit/226ba77c50dcb95fbc6e2122c2282a6463086fdd) page (https://github.com/badinkajink/hand/blob/226ba77c50dcb95fbc6e2122c2282a6463086fdd/docs/pages.html)
310. 2026-10-22 · Plain-language pass of the screwdriver chain, reorientation journey and object tracking pages (2026-10-22): judge 13 of 14 pairs better · 9fac38b72 (https://github.com/badinkajink/hand/commit/9fac38b7227322a55ab5034773ce33564e6f83cb) page (https://github.com/badinkajink/hand/blob/9fac38b7227322a55ab5034773ce33564e6f83cb/docs/pages.html)
311. 2026-10-22 · Plain-language pass of the basketball and hand-brake pages (2026-10-22): judge 5 of 7 pairs better, two repaired · c01e8db27 (https://github.com/badinkajink/hand/commit/c01e8db270883827916267bbe7a3a59d4fd4d178) page (https://github.com/badinkajink/hand/blob/c01e8db270883827916267bbe7a3a59d4fd4d178/docs/pages.html)
312. 2026-10-22 · Plain-language pass of the table-stand and CAD v1 finger pages (2026-10-22): judge 7 of 10 pairs better, two repaired · 24fd7235a (https://github.com/badinkajink/hand/commit/24fd7235a6897306d6dd9b36ce7ed2107d0b0e36) page (https://github.com/badinkajink/hand/blob/24fd7235a6897306d6dd9b36ce7ed2107d0b0e36/docs/pages.html)
313. 2026-10-22 · Plain-language pass of the real_v1 design search page, in its source report_search.src.html and rebuilt (2026-10-22): mean 19.2 to 18.3 words a sentence, over … · 7c0b8c94c (https://github.com/badinkajink/hand/commit/7c0b8c94c62d7f607880bbfa9e066fc35aa1af2a) page (https://github.com/badinkajink/hand/blob/7c0b8c94c62d7f607880bbfa9e066fc35aa1af2a/docs/pages.html)
314. 2026-10-22 · Perp review page: the wording edits of the built page carried into page.src.html and rebuilt through build.sh (2026-10-22) · c63db2a2d (https://github.com/badinkajink/hand/commit/c63db2a2d7edd5910058adf926bd50e900fb49c3) page (https://github.com/badinkajink/hand/blob/c63db2a2d7edd5910058adf926bd50e900fb49c3/docs/pages.html)
315. 2026-10-22 · Plain-language pass of the control diagnosis and HOM tasks across object sizes pages (2026-10-22): means 22.6 to 20.6 and 26.7 to 25.1 words a sentence; judge … · 8bcc85589 (https://github.com/badinkajink/hand/commit/8bcc855894f867b5144995d421b54c2ea4ba505f) page (https://github.com/badinkajink/hand/blob/8bcc855894f867b5144995d421b54c2ea4ba505f/docs/pages.html)
316. 2026-10-22 · Plain-language pass of the DIP link board mount and fit-print (run b) pages (2026-10-22): means 27.8 to 26.5 and 31.2 to 27.1 words a sentence; judge 11 of 14 … · de59c7814 (https://github.com/badinkajink/hand/commit/de59c78144c273f802f74612d50e0b282d400bf5) page (https://github.com/badinkajink/hand/blob/de59c78144c273f802f74612d50e0b282d400bf5/docs/pages.html)
317. 2026-10-22 · Plain-language pass of the model-based contact estimation page (2026-10-22): mean 30.0 to 26.8 words a sentence, over 30 words 46.1 to 36.4 %; judge 9 of 9 … · 34f1ca0c7 (https://github.com/badinkajink/hand/commit/34f1ca0c78a90b6d492577d913bb9c1f49648a5f) page (https://github.com/badinkajink/hand/blob/34f1ca0c78a90b6d492577d913bb9c1f49648a5f/docs/pages.html)
318. 2026-10-22 · Plain-language pass of the pad-elevation, servo-plant policies and robust-tranche result pages (2026-10-22): means 20.8 to 13.9, 29.9 to 24.0 and 25.1 to 21.8 … · 33eb0d340 (https://github.com/badinkajink/hand/commit/33eb0d3404ed2f14a7259f3dc98096f7eb56fb57) page (https://github.com/badinkajink/hand/blob/33eb0d3404ed2f14a7259f3dc98096f7eb56fb57/docs/pages.html)
319. 2026-10-22 · Documentation home page in plain prose: mean 24.2 to 18.1 words a sentence, over 30 words 29.0 to 9.3 % (plain-language pass of 2026-10-22; gate PASS, judge 9 … · a510f7712 (https://github.com/badinkajink/hand/commit/a510f77125de0430fd9d1f42ee6a86d6cd5da282) page (https://github.com/badinkajink/hand/blob/a510f77125de0430fd9d1f42ee6a86d6cd5da282/docs/pages.html)
320. 2026-10-22 · Snug sets 3S and 2S: the 11:30 interference taken out on the B05R pads (owner, 2026-10-22 16:37: 'let's setup a print for both the 2t and 3t settings that … · b7b8327f0 (https://github.com/badinkajink/hand/commit/b7b8327f09099e913d661679c7677fccf6a628e7) page (https://github.com/badinkajink/hand/blob/b7b8327f09099e913d661679c7677fccf6a628e7/docs/pages.html)
321. 2026-10-22 · Cover 2T and cap TW15H2: the sweep's 2 mm pair with 3T's tighter rails (owner, 2026-10-22 16:17: 'can you also prepare cassettes + top covers at the lowest … · d6b8577f9 (https://github.com/badinkajink/hand/commit/d6b8577f9b52acd3e71999939bff3a3b62efd75b) page (https://github.com/badinkajink/hand/blob/d6b8577f9b52acd3e71999939bff3a3b62efd75b/docs/pages.html)
322. 2026-10-22 · Calibration protocol of the fingertip on the UR5 (CB3) and the OptoForce HEX-E, with a program, a simulator and a simulated session (owner, 2026-10-22: "we're … · a82f79b55 (https://github.com/badinkajink/hand/commit/a82f79b55cb8b5389d7c4e3f41eed840d6cb2cd7) page (https://github.com/badinkajink/hand/blob/a82f79b55cb8b5389d7c4e3f41eed840d6cb2cd7/docs/pages.html)
323. 2026-10-22 · Contact overview: plain-language pass under the elements of style (owner, 2026-10-22: "i bounce off like rubber because of how dense it is"). Each derivation … · 2c763cf62 (https://github.com/badinkajink/hand/commit/2c763cf62eb6672afb19b53396bd1ae121d9efb4) page (https://github.com/badinkajink/hand/blob/2c763cf62eb6672afb19b53396bd1ae121d9efb4/docs/pages.html)
324. 2026-10-22 · Two DIP links b v4 on one P1S plate (owner, 2026-10-22 13:07: 'where are the stls for the new dip link? i want to print two more too') · 8d9599d70 (https://github.com/badinkajink/hand/commit/8d9599d70ad3ca4a794e4cf23c063b5570e781a4) page (https://github.com/badinkajink/hand/blob/8d9599d70ad3ca4a794e4cf23c063b5570e781a4/docs/pages.html)
325. 2026-10-22 · Pole pattern of the fingertip's five magnets: all one way against the checkerboard and two others, for sensing and for a neighbouring fingertip's field · f45427bd7 (https://github.com/badinkajink/hand/commit/f45427bd70ace21360df724a2e5d2e1cf4392316) page (https://github.com/badinkajink/hand/blob/f45427bd70ace21360df724a2e5d2e1cf4392316/docs/pages.html)
326. 2026-10-22 · UR5e mount v3: brass heat-set inserts for the foot's M3 screws in the adapter (owner, 2026-10-22 12:22: 'let's not go for self-threaded m3 holes there and just … · 48530e4dd (https://github.com/badinkajink/hand/commit/48530e4ddd37a1b84c12148ea5efbbeaf8b7dfd0) page (https://github.com/badinkajink/hand/blob/48530e4ddd37a1b84c12148ea5efbbeaf8b7dfd0/docs/pages.html)
327. 2026-10-22 · Chosen 3 mm cover and cap with tighter rails and a smaller pin hole (owner, 2026-10-22 11:30: 'for the new fingers with the hole in the top, we should really … · 2a88d1ad3 (https://github.com/badinkajink/hand/commit/2a88d1ad39a5246e087e2d99d087bd7b1111bc55) page (https://github.com/badinkajink/hand/blob/2a88d1ad39a5246e087e2d99d087bd7b1111bc55/docs/pages.html)
328. 2026-10-22 · HOM results page: MPC baseline and pin-push drive force and lever sections, lede and future work · 863fd6a09 (https://github.com/badinkajink/hand/commit/863fd6a096b112ce49a0013a13bebbd075f2c918) page (https://github.com/badinkajink/hand/blob/863fd6a096b112ce49a0013a13bebbd075f2c918/docs/pages.html)
329. 2026-10-22 · HOM pages and rows for the demonstrated tasks: friction pin-pusher, press, roll along the thumb, twist · 580b61868 (https://github.com/badinkajink/hand/commit/580b618684302901882c84dda164b69169f38900) page (https://github.com/badinkajink/hand/blob/580b618684302901882c84dda164b69169f38900/docs/pages.html)
330. 2026-10-21 · HOM pages: wording (container verbs, an inflated qualifier) · 338fe9b10 (https://github.com/badinkajink/hand/commit/338fe9b10d3f368e114131ed4ecad6f4db9522c3) page (https://github.com/badinkajink/hand/blob/338fe9b10d3f368e114131ed4ecad6f4db9522c3/docs/pages.html)
331. 2026-10-21 · HOM pages: the filter's input in object-twist tasks and k_max against the control period; estimator section on the results page (appears with … · 1f4e3ed9f (https://github.com/badinkajink/hand/commit/1f4e3ed9f71d1259ad096f887d48e28e78a31eb4) page (https://github.com/badinkajink/hand/blob/1f4e3ed9f71d1259ad096f887d48e28e78a31eb4/docs/pages.html)
332. 2026-10-21 · HOM pages: the length scale of Eq. 2 in the tasks (ell 100 mm and SI lose every cylinder pick), deployment variants table; filter-sweep subcommand · ac45eec46 (https://github.com/badinkajink/hand/commit/ac45eec46b7ca01b54b096c49c954d888252c23a) page (https://github.com/badinkajink/hand/blob/ac45eec46b7ca01b54b096c49c954d888252c23a/docs/pages.html)
333. 2026-10-21 · Method page: Exp. A on the library and the units of Eq. 2 (Table 4, film); weights row and future work updated · ccee432c9 (https://github.com/badinkajink/hand/commit/ccee432c939c15d302b8e52456fca19313aa32a2) page (https://github.com/badinkajink/hand/blob/ccee432c939c15d302b8e52456fca19313aa32a2/docs/pages.html)
334. 2026-10-21 · Pages: the HOM controller's method and MuJoCo implementation, and four tasks across object sizes (first build) · f43194929 (https://github.com/badinkajink/hand/commit/f43194929a46fc0128385e0868bbbba02cdacbea) page (https://github.com/badinkajink/hand/blob/f43194929a46fc0128385e0868bbbba02cdacbea/docs/pages.html)
335. 2026-10-21 · UR5e calibration mount v3 for M6 x 20 screws tightened from above (owner, 2026-10-21 17:54: 'i only have 20mm long m6 screws. so we need to pop everything up a … · 38559592c (https://github.com/badinkajink/hand/commit/38559592ca8808e2055b8ed4b174ca59d9f405fe) page (https://github.com/badinkajink/hand/blob/38559592ca8808e2055b8ed4b174ca59d9f405fe/docs/pages.html)
336. 2026-10-21 · DIP link b v4 and a sweep of retaining-wall heights (owner, 2026-10-21 16:20: 'the 0.15mm inset is still perfectly fine ... lower the heights on both the top … · 3d321adfd (https://github.com/badinkajink/hand/commit/3d321adfd7c7d2de9b442ca4214c4967811688f9) page (https://github.com/badinkajink/hand/blob/3d321adfd7c7d2de9b442ca4214c4967811688f9/docs/pages.html)
337. 2026-10-21 · Solid-wall covers, raised proximal screws and stronger tip caps for b v3 (owner, 2026-10-21 14:25: the pad still snaps out of cover W00 and a wall's 'bottom … · 66a002acd (https://github.com/badinkajink/hand/commit/66a002acd45e86570aeb027c882697b9e824abb6) page (https://github.com/badinkajink/hand/blob/66a002acd45e86570aeb027c882697b9e824abb6/docs/pages.html)
338. 2026-10-21 · Page on spherical and disc N52 magnets in the B00 fingertip pad: a 3 mm sphere resolves 0.0285 N against the disc's 0.0304 N; spheres of 4 mm and more exceed … · 09a42008e (https://github.com/badinkajink/hand/commit/09a42008ecc4cd25a6c7a16fa7e275a16585771e) page (https://github.com/badinkajink/hand/blob/09a42008ecc4cd25a6c7a16fa7e275a16585771e/docs/pages.html)
339. 2026-10-21 · Spherical N52 magnets against the 3 x 2 mm discs of pad B00: a 3 mm sphere resolves 0.0285 N where the disc resolves 0.0304 N; larger spheres exceed the chip … · 112028a56 (https://github.com/badinkajink/hand/commit/112028a562fd0b9732ee1664e353affff730a792) page (https://github.com/badinkajink/hand/blob/112028a562fd0b9732ee1664e353affff730a792/docs/pages.html)
340. 2026-10-21 · Drift of the fingertip board's rest reading: the contact viewer corrects each chip for its temperature, adds a 2 uT noise floor and re-zeros at rest; the … · e010edda3 (https://github.com/badinkajink/hand/commit/e010edda33b5edf1ec4ac478dad1938dc1084c0f) page (https://github.com/badinkajink/hand/blob/e010edda33b5edf1ec4ac478dad1938dc1084c0f/docs/pages.html)
341. 2026-10-21 · Resolved-bead and G-code checks of the 11/22 fingertip; the arc-skipping G-code reader corrected on four pages · d379de08c (https://github.com/badinkajink/hand/commit/d379de08c0c69e5950f0aee8db77920f2b1faa5d) page (https://github.com/badinkajink/hand/blob/d379de08c0c69e5950f0aee8db77920f2b1faa5d/docs/pages.html)
342. 2026-10-20 · Fingertip overview: why the FE solver is our own code, and which checks cover the curved 85A tips · f60c8063e (https://github.com/badinkajink/hand/commit/f60c8063e2eb7047083afd84b53586e1ed93090b) page (https://github.com/badinkajink/hand/blob/f60c8063e2eb7047083afd84b53586e1ed93090b/docs/pages.html)
343. 2026-10-20 · Status row for the overview rewrite and the page tags; indices refreshed · df34d5e5f (https://github.com/badinkajink/hand/commit/df34d5e5f6b2800280d32ab07efb506cd2e7d47e) page (https://github.com/badinkajink/hand/blob/df34d5e5f6b2800280d32ab07efb506cd2e7d47e/docs/pages.html)
344. 2026-10-20 · Printed-fingertips overview rewritten as the method's reference: the chain from print recipe to contact estimate · 6d46c9b89 (https://github.com/badinkajink/hand/commit/6d46c9b89dbc07479cd996b73ae8209bc9274ea0) page (https://github.com/badinkajink/hand/blob/6d46c9b89dbc07479cd996b73ae8209bc9274ea0/docs/pages.html)
345. 2026-10-20 · Tip caps TP and TW for b v3 (owner, 20:36: 'sure we can go with your recommendation'): scripts/dip_b_tip_cap.py builds, on concept b's kernels, an end plate … · 83c38348c (https://github.com/badinkajink/hand/commit/83c38348c8cff1e4dbd2d2b29cd953605dcc5d97) page (https://github.com/badinkajink/hand/blob/83c38348c8cff1e4dbd2d2b29cd953605dcc5d97/docs/pages.html)
346. 2026-10-20 · Result pages describe themselves, and every index follows them · 8b0a9a22c (https://github.com/badinkajink/hand/commit/8b0a9a22cd3a6f7e809ef87577a4f23b4baa1f1a) page (https://github.com/badinkajink/hand/blob/8b0a9a22cd3a6f7e809ef87577a4f23b4baa1f1a/docs/pages.html)
347. 2026-10-20 · DIP link b v3 and UR5e mount v2 after the first prints: owner chose b; cover walls 3.0 mm along the pad's flanks (approach -0.35 % at 6 N, force resolution … · fa55ce04b (https://github.com/badinkajink/hand/commit/fa55ce04b48b92a22efc94cbed4487b64f41fb4e) page (https://github.com/badinkajink/hand/blob/fa55ce04b48b92a22efc94cbed4487b64f41fb4e/docs/pages.html)
348. 2026-10-19 · DIP-link fit tests of 2026-10-19 on one plate per printer, every piece with a printed ID · 16974bfd4 (https://github.com/badinkajink/hand/commit/16974bfd4645d827633d81061eb008c6e66afe36) page (https://github.com/badinkajink/hand/blob/16974bfd4645d827633d81061eb008c6e66afe36/docs/pages.html)
349. 2026-10-18 · Artifacts for the DIP, calibration and status pages (artifact_url.txt, INDEX rows); home page, page index, fingertip and contact overviews republished, each … · 5758108af (https://github.com/badinkajink/hand/commit/5758108aff0bf0ec1a08375660b5342412117a12) page (https://github.com/badinkajink/hand/blob/5758108aff0bf0ec1a08375660b5342412117a12/docs/pages.html)
350. 2026-10-18 · INDEX rows for the calibration and DIP pages (artifacts pending); home page and page index rebuilt; the fingertip overview links the DIP, calibration, … · 0e6c03add (https://github.com/badinkajink/hand/commit/0e6c03add46db53941f1e9514f764f63879ca128) page (https://github.com/badinkajink/hand/blob/0e6c03add46db53941f1e9514f764f63879ca128/docs/pages.html)
351. 2026-10-18 · Page index as a folder tree: docs/pages.html lists docs/experiments/ by topic, study folder and file · 913d6a263 (https://github.com/badinkajink/hand/commit/913d6a2639fdfe8dc68faf2f13f001c2f71b5e25) page (https://github.com/badinkajink/hand/blob/913d6a2639fdfe8dc68faf2f13f001c2f71b5e25/docs/pages.html)
352. 2026-10-16 · Fingertip readiness page on claude.ai: artifact NnKzSbLdAdBaJCVxeGMDji in artifact_url.txt and the INDEX row; fingertip and contact overviews and the page … · 84a30832e (https://github.com/badinkajink/hand/commit/84a30832ef15298402893253504cbcc2a372c858) page (https://github.com/badinkajink/hand/blob/84a30832ef15298402893253504cbcc2a372c858/docs/pages.html)
353. 2026-10-16 · Fingertip readiness page, INDEX row, overview links and the 13 CAD-hand variant scenes · 3b16e1ca7 (https://github.com/badinkajink/hand/commit/3b16e1ca74b7068f920297298bcf37aa4b55309f) page (https://github.com/badinkajink/hand/blob/3b16e1ca74b7068f920297298bcf37aa4b55309f/docs/pages.html)
354. 2026-10-14 · Fingertip overview: films of the whole 20 % tip and the eFlesh tip; film label escaped for ffmpeg drawtext · a77e1f655 (https://github.com/badinkajink/hand/commit/a77e1f655e27ee079e23b44bd9176681fe531b4e) page (https://github.com/badinkajink/hand/blob/a77e1f655e27ee079e23b44bd9176681fe531b4e/docs/pages.html)
355. 2026-10-14 · Docs index published as an artifact; design overview and index list the CAD-hand page · a824ccb6a (https://github.com/badinkajink/hand/commit/a824ccb6afd42608f2915e7748a64e81d9edf1b7) page (https://github.com/badinkajink/hand/blob/a824ccb6afd42608f2915e7748a64e81d9edf1b7/docs/pages.html)
356. 2026-10-14 · Docs: index of all result pages, printed-fingertip topic overview, overviews rebuilt with the missing pages; FE films of the whole tip queued · da06ee8f7 (https://github.com/badinkajink/hand/commit/da06ee8f7e41a6ed48a82de0fd0e1a73772df0fc) page (https://github.com/badinkajink/hand/blob/da06ee8f7e41a6ed48a82de0fd0e1a73772df0fc/docs/pages.html)

## Topic overviews

### Code and methods

docs/overviews/code_and_methods.html · 3 revisions, 2026-10-11 to 2026-10-22
Latest: 2026-10-22 · Code and methods overview in plain prose: mean 23.6 to 15.1 words a sentence, over 30 words 27.7 to 1.3 % (plain-language pass of 2026-10-22; gate PASS with …

Revisions, newest first

1. 2026-10-22 · Code and methods overview in plain prose: mean 23.6 to 15.1 words a sentence, over 30 words 27.7 to 1.3 % (plain-language pass of 2026-10-22; gate PASS with … · 26bbdbe7d (https://github.com/badinkajink/hand/commit/26bbdbe7de3e237db636757aa8627a4f60337db7) page (https://github.com/badinkajink/hand/blob/26bbdbe7de3e237db636757aa8627a4f60337db7/docs/overviews/code_and_methods.html)
2. 2026-10-14 · Docs: index of all result pages, printed-fingertip topic overview, overviews rebuilt with the missing pages; FE films of the whole tip queued · da06ee8f7 (https://github.com/badinkajink/hand/commit/da06ee8f7e41a6ed48a82de0fd0e1a73772df0fc) page (https://github.com/badinkajink/hand/blob/da06ee8f7e41a6ed48a82de0fd0e1a73772df0fc/docs/overviews/code_and_methods.html)
3. 2026-10-11 · mkdocs site folded into the HTML docs: docs/overviews/code_and_methods.html (code map, the path of one real_v1 hand from a Sobol sample to a bench plan, grasp … · 5521d1f58 (https://github.com/badinkajink/hand/commit/5521d1f58ee7e0c4ff2c3c724338c37d7e75bb0d) page (https://github.com/badinkajink/hand/blob/5521d1f58ee7e0c4ff2c3c724338c37d7e75bb0d/docs/overviews/code_and_methods.html)

### Grasp-to-gait chain

docs/overviews/grasp_to_gait_chain.html · 9 revisions, 2026-10-09 to 2026-10-22
Latest: 2026-10-22 · Reorientation mechanisms overview in plain prose: mean 25.3 to 16.9 words a sentence, over 30 words 32.7 to 1.3 % (plain-language pass of 2026-10-22; gate PASS …

Revisions, newest first

1. 2026-10-22 · Reorientation mechanisms overview in plain prose: mean 25.3 to 16.9 words a sentence, over 30 words 32.7 to 1.3 % (plain-language pass of 2026-10-22; gate PASS … · ea8f034a0 (https://github.com/badinkajink/hand/commit/ea8f034a09c6df570577ccde4f6611799eae830d) page (https://github.com/badinkajink/hand/blob/ea8f034a09c6df570577ccde4f6611799eae830d/docs/overviews/grasp_to_gait_chain.html)
2. 2026-10-22 · Grasp-to-gait chain overview in plain prose: mean 26.3 to 16.8 words a sentence, over 30 words 35.1 to 5.0 % (plain-language pass of 2026-10-22; gate PASS with … · d491c1cd4 (https://github.com/badinkajink/hand/commit/d491c1cd4f9638007474033c42eeb84188a7199c) page (https://github.com/badinkajink/hand/blob/d491c1cd4f9638007474033c42eeb84188a7199c/docs/overviews/grasp_to_gait_chain.html)
3. 2026-10-14 · Docs: index of all result pages, printed-fingertip topic overview, overviews rebuilt with the missing pages; FE films of the whole tip queued · da06ee8f7 (https://github.com/badinkajink/hand/commit/da06ee8f7e41a6ed48a82de0fd0e1a73772df0fc) page (https://github.com/badinkajink/hand/blob/da06ee8f7e41a6ed48a82de0fd0e1a73772df0fc/docs/overviews/grasp_to_gait_chain.html)
4. 2026-10-11 · Topic overviews: interactive data figures drawn from the source pages' rows (scripts/overview_figures.py, a FIGURES entry names its function with fn=): gait … · a599f40ad (https://github.com/badinkajink/hand/commit/a599f40ad96565193a0d283a67dca8e68552bc47) page (https://github.com/badinkajink/hand/blob/a599f40ad96565193a0d283a67dca8e68552bc47/docs/overviews/grasp_to_gait_chain.html)
5. 2026-10-10 · Overviews: background from the retired webpaper folded in before archiving it (owner direction of 2026-10-09 14:40; items of … · 640bcd2fd (https://github.com/badinkajink/hand/commit/640bcd2fd3fed247b01e8c355e8a493db5cffd4f) page (https://github.com/badinkajink/hand/blob/640bcd2fd3fed247b01e8c355e8a493db5cffd4f/docs/overviews/grasp_to_gait_chain.html)
6. 2026-10-10 · Four page titles set to their INDEX subjects (turn mechanism: 'Reorientation mechanism on the shipped, calibrated and bench plants', subject rewritten without … · c6519db37 (https://github.com/badinkajink/hand/commit/c6519db37b658269581f94e55405a9349e219a68) page (https://github.com/badinkajink/hand/blob/c6519db37b658269581f94e55405a9349e219a68/docs/overviews/grasp_to_gait_chain.html)
7. 2026-10-09 · Eleven August pages retitled with descriptive noun phrases (The Seam and the Seat, Never Letting Go, A Spring, a Cone, and a Cliff, Tape Measure and Two Tags, … · 9114d35d6 (https://github.com/badinkajink/hand/commit/9114d35d6162b85f271cd1354b11ad68b7795a0a) page (https://github.com/badinkajink/hand/blob/9114d35d6162b85f271cd1354b11ad68b7795a0a/docs/overviews/grasp_to_gait_chain.html)
8. 2026-10-09 · Topic overview docs/overviews/hand_plant_bench.html: the hand, the servo as a spring with a cutoff, the three simulated servo models and what the bench … · fa882344f (https://github.com/badinkajink/hand/commit/fa882344fd78fd6b9e24962cabe1d59e60a5af93) page (https://github.com/badinkajink/hand/blob/fa882344fd78fd6b9e24962cabe1d59e60a5af93/docs/overviews/grasp_to_gait_chain.html)
9. 2026-10-09 · Topic overview docs/overviews/grasp_to_gait_chain.html: bench transfer of the open-loop turn (48 of 77, rho_s 0.50), the chain in simulation on a UR5e, the … · f03394351 (https://github.com/badinkajink/hand/commit/f0339435130885d90f6f2e0fd82a854af607cc80) page (https://github.com/badinkajink/hand/blob/f0339435130885d90f6f2e0fd82a854af607cc80/docs/overviews/grasp_to_gait_chain.html)

### Hand, plant and bench

docs/overviews/hand_plant_bench.html · 21 revisions, 2026-10-09 to 2026-11-13
Latest: 2026-11-13 · Tag-tracking throughput on corvus and the controller link: live two-camera tracker, UDP pose and state/target messages, and their page (lab session on corvus, …

Revisions, newest first

1. 2026-11-13 · Tag-tracking throughput on corvus and the controller link: live two-camera tracker, UDP pose and state/target messages, and their page (lab session on corvus, … · 583f85b0f (https://github.com/badinkajink/hand/commit/583f85b0f9f5bd442d0eac22573106f19c2583ba) page (https://github.com/badinkajink/hand/blob/583f85b0f9f5bd442d0eac22573106f19c2583ba/docs/overviews/hand_plant_bench.html)
2. 2026-11-13 · Calibration page v5: camera 836612071918 moved at about 16:00 and its pose re-solved against the fixed camera (lab session on corvus, 2026-11-13) · 8837c5d37 (https://github.com/badinkajink/hand/commit/8837c5d37801440517d9383a10195b86f71e9769) page (https://github.com/badinkajink/hand/blob/8837c5d37801440517d9383a10195b86f71e9769/docs/overviews/hand_plant_bench.html)
3. 2026-11-13 · Hex block map from both D435s: pose.bundle_adjust_multi, 35 views of the 11-07 test block, and section 6 of the calibration page (lab session on corvus, … · a1e231000 (https://github.com/badinkajink/hand/commit/a1e231000ebbbae6e013d2121c3516ada653fd90) page (https://github.com/badinkajink/hand/blob/a1e231000ebbbae6e013d2121c3516ada653fd90/docs/overviews/hand_plant_bench.html)
4. 2026-11-13 · Lens and arm calibration of the two D435 tracking cameras on the UR5: page, data, film and lab scripts of 2026-11-13 (built on corvus by the lab session, owner … · 90d753ca3 (https://github.com/badinkajink/hand/commit/90d753ca37bce004f1ced2e8b67ec2f710f740db) page (https://github.com/badinkajink/hand/blob/90d753ca37bce004f1ced2e8b67ec2f710f740db/docs/overviews/hand_plant_bench.html)
5. 2026-11-13 · Paper calibration boards for the owner's 140 x 130 mm back (ChArUco 7 x 7 of 15 mm and checkerboard 9 x 8 of 12 mm, Letter PDF at actual size, 36 of 36 corners … · 9a6322eb6 (https://github.com/badinkajink/hand/commit/9a6322eb65d9feaf4c753287cc64f847d9e07b73) page (https://github.com/badinkajink/hand/blob/9a6322eb65d9feaf4c753287cc64f847d9e07b73/docs/overviews/hand_plant_bench.html)
6. 2026-11-13 · Page of the tracking prints and the calibration board: renders, joint sections, two MuJoCo viewers and links to every STL and Bambu project; on the mount's … · 5013467be (https://github.com/badinkajink/hand/commit/5013467bec283030c3b1fd3ba636eb4137a69cb8) page (https://github.com/badinkajink/hand/blob/5013467bec283030c3b1fd3ba636eb4137a69cb8/docs/overviews/hand_plant_bench.html)
7. 2026-11-06 · SR2 servo identification page (R36): dead band 0.59 deg, 0.55 N m/rad at the datasheet scale and 5.1 V, yaw friction +-23 to +-27 mN m · 9639ade26 (https://github.com/badinkajink/hand/commit/9639ade263e5d8aba9307b0f38872edd506e4260) page (https://github.com/badinkajink/hand/blob/9639ade263e5d8aba9307b0f38872edd506e4260/docs/overviews/hand_plant_bench.html)
8. 2026-11-05 · Object seating and tracking, steps 1 to 3 in simulation with the owner's changes of 11-05: a flat seat and a 40 mm arm lift keep the HOM cylinder scores, the … · 72fb9da6a (https://github.com/badinkajink/hand/commit/72fb9da6af31a32e95962a396e5a27832cc47f4d) page (https://github.com/badinkajink/hand/blob/72fb9da6af31a32e95962a396e5a27832cc47f4d/docs/overviews/hand_plant_bench.html)
9. 2026-11-04 · cad_v3, 22:4x on 11-04: the page's artifact link in the indices and the hand-off's state · 1876dc01c (https://github.com/badinkajink/hand/commit/1876dc01cbb223798b9809e5913d8875ff4e949e) page (https://github.com/badinkajink/hand/blob/1876dc01cbb223798b9809e5913d8875ff4e949e/docs/overviews/hand_plant_bench.html)
10. 2026-11-04 · cad_v3, 22:3x on 11-04: result page, film and clocking. The hand as built is at k = 1; a reading by eye had given k = 2. · 22cecc645 (https://github.com/badinkajink/hand/commit/22cecc6454114d1a59048de40e6694d94ad0d45c) page (https://github.com/badinkajink/hand/blob/22cecc6454114d1a59048de40e6694d94ad0d45c/docs/overviews/hand_plant_bench.html)
11. 2026-10-22 · Hand, plant and bench overview in plain prose: mean 26.4 to 15.1 words a sentence, over 30 words 34.8 to 1.2 % (plain-language pass of 2026-10-22; gate PASS … · caa9d17f4 (https://github.com/badinkajink/hand/commit/caa9d17f427e05bc82719299b1399246b24fd299) page (https://github.com/badinkajink/hand/blob/caa9d17f427e05bc82719299b1399246b24fd299/docs/overviews/hand_plant_bench.html)
12. 2026-10-14 · CAD finger page published; hand overview rebuilt with the CAD page's and the servo protocol's artifact links · 2b0d255ae (https://github.com/badinkajink/hand/commit/2b0d255ae58a333671e9960d591fdc0ffe1666c5) page (https://github.com/badinkajink/hand/blob/2b0d255ae58a333671e9960d591fdc0ffe1666c5/docs/overviews/hand_plant_bench.html)
13. 2026-10-14 · Docs: index of all result pages, printed-fingertip topic overview, overviews rebuilt with the missing pages; FE films of the whole tip queued · da06ee8f7 (https://github.com/badinkajink/hand/commit/da06ee8f7e41a6ed48a82de0fd0e1a73772df0fc) page (https://github.com/badinkajink/hand/blob/da06ee8f7e41a6ed48a82de0fd0e1a73772df0fc/docs/overviews/hand_plant_bench.html)
14. 2026-10-13 · Hand overview: link the CAD finger model page · d5e8b076a (https://github.com/badinkajink/hand/commit/d5e8b076aa51a700c1a9c120b906f666a07c90a2) page (https://github.com/badinkajink/hand/blob/d5e8b076aa51a700c1a9c120b906f666a07c90a2/docs/overviews/hand_plant_bench.html)
15. 2026-10-11 · Contact overview Figure 10 (GPU throughput against parallel worlds) is an interactive figure on log axes with the cost per world-step in the readout; … · cadb7b569 (https://github.com/badinkajink/hand/commit/cadb7b56989b411cdf54cbde7a4f059b13fbde88) page (https://github.com/badinkajink/hand/blob/cadb7b56989b411cdf54cbde7a4f059b13fbde88/docs/overviews/hand_plant_bench.html)
16. 2026-10-11 · Morphology overview: best-cell held cosine against the thumb's and the grip's torque capacity as an interactive scatter from table.json (Spearman +0.44 and … · ac0563468 (https://github.com/badinkajink/hand/commit/ac0563468bfc16a6104fd4f259c9a81bd5231416) page (https://github.com/badinkajink/hand/blob/ac0563468bfc16a6104fd4f259c9a81bd5231416/docs/overviews/hand_plant_bench.html)
17. 2026-10-11 · Topic overviews: interactive data figures drawn from the source pages' rows (scripts/overview_figures.py, a FIGURES entry names its function with fn=): gait … · a599f40ad (https://github.com/badinkajink/hand/commit/a599f40ad96565193a0d283a67dca8e68552bc47) page (https://github.com/badinkajink/hand/blob/a599f40ad96565193a0d283a67dca8e68552bc47/docs/overviews/hand_plant_bench.html)
18. 2026-10-10 · Overviews: background from the retired webpaper folded in before archiving it (owner direction of 2026-10-09 14:40; items of … · 640bcd2fd (https://github.com/badinkajink/hand/commit/640bcd2fd3fed247b01e8c355e8a493db5cffd4f) page (https://github.com/badinkajink/hand/blob/640bcd2fd3fed247b01e8c355e8a493db5cffd4f/docs/overviews/hand_plant_bench.html)
19. 2026-10-10 · Four page titles set to their INDEX subjects (turn mechanism: 'Reorientation mechanism on the shipped, calibrated and bench plants', subject rewritten without … · c6519db37 (https://github.com/badinkajink/hand/commit/c6519db37b658269581f94e55405a9349e219a68) page (https://github.com/badinkajink/hand/blob/c6519db37b658269581f94e55405a9349e219a68/docs/overviews/hand_plant_bench.html)
20. 2026-10-09 · Eleven August pages retitled with descriptive noun phrases (The Seam and the Seat, Never Letting Go, A Spring, a Cone, and a Cliff, Tape Measure and Two Tags, … · 9114d35d6 (https://github.com/badinkajink/hand/commit/9114d35d6162b85f271cd1354b11ad68b7795a0a) page (https://github.com/badinkajink/hand/blob/9114d35d6162b85f271cd1354b11ad68b7795a0a/docs/overviews/hand_plant_bench.html)
21. 2026-10-09 · Topic overview docs/overviews/hand_plant_bench.html: the hand, the servo as a spring with a cutoff, the three simulated servo models and what the bench … · fa882344f (https://github.com/badinkajink/hand/commit/fa882344fd78fd6b9e24962cabe1d59e60a5af93) page (https://github.com/badinkajink/hand/blob/fa882344fd78fd6b9e24962cabe1d59e60a5af93/docs/overviews/hand_plant_bench.html)

### Morphology and design search

docs/overviews/morphology_design.html · 45 revisions, 2026-10-09 to 2026-11-13
Latest: 2026-11-13 · HOM's measured pose through a complementary filter (hom_gpu.POSE_FILTER: prediction from the commanded angular velocity, delayed tracker frames corrected by …

Revisions, newest first

1. 2026-11-13 · HOM's measured pose through a complementary filter (hom_gpu.POSE_FILTER: prediction from the commanded angular velocity, delayed tracker frames corrected by … · bb8b61b24 (https://github.com/badinkajink/hand/commit/bb8b61b24290b05a6e2443066c21e3a148ba766b) page (https://github.com/badinkajink/hand/blob/bb8b61b24290b05a6e2443066c21e3a148ba766b/docs/overviews/morphology_design.html)
2. 2026-11-13 · Sampling MPC page: HOM under the sensing variants (tag tracker, fingertip model, calibration errors), HOM's commanded pad force (2 N: J 0.415 against 0.388 at … · 0de23f89b (https://github.com/badinkajink/hand/commit/0de23f89bf23e2997026e333c39690d2a20ecfa3) page (https://github.com/badinkajink/hand/blob/0de23f89bf23e2997026e333c39690d2a20ecfa3/docs/overviews/morphology_design.html)
3. 2026-11-13 · Docs index: the artifact of the sampling MPC page (https://claude.ai/artifact/3m4bcPKugwFCtX5ZZLtd7f) · c35fc5d84 (https://github.com/badinkajink/hand/commit/c35fc5d8484a103ab0c94e2eb8334dcbc81b02fb) page (https://github.com/badinkajink/hand/blob/c35fc5d8484a103ab0c94e2eb8334dcbc81b02fb/docs/overviews/morphology_design.html)
4. 2026-11-13 · Sampling MPC and HOM on the SR2 sphere twist, on the SCS0009 plant: page with HOM, real-time predictive sampling, DIAL annealing, the point-contact planner, … · ef59860cb (https://github.com/badinkajink/hand/commit/ef59860cb53bf8f661a12b16399344487926d526) page (https://github.com/badinkajink/hand/blob/ef59860cb53bf8f661a12b16399344487926d526/docs/overviews/morphology_design.html)
5. 2026-11-12 · Search methods page, Section 12: MAP-Elites, CMA-ME, CMA-ES and Bayesian optimization replayed on the talk's four tracking-score grids (owner, 2026-11-12) · eb98da82e (https://github.com/badinkajink/hand/commit/eb98da82e17f14c4be92c02a7cabe35a383fc74c) page (https://github.com/badinkajink/hand/blob/eb98da82e17f14c4be92c02a7cabe35a383fc74c/docs/overviews/morphology_design.html)
6. 2026-11-11 · Talk figures in the HOM paper's terms (owner, 11-11): CEM-refined grasp and HOM, Eq. (2) weights, contact forces · 136239972 (https://github.com/badinkajink/hand/commit/1362399725b154bd9ef9570e9fab8a6b46a4b98c) page (https://github.com/badinkajink/hand/blob/1362399725b154bd9ef9570e9fab8a6b46a4b98c/docs/overviews/morphology_design.html)
7. 2026-11-10 · Tracking-score page, Section 7: the four default landscapes of the hand-design talk under the tracking score (owner, 11-10 night: "sure, let's rerun the … · f03d7dccc (https://github.com/badinkajink/hand/commit/f03d7dccc09c73265b5a6def37d6c17e71d26c7d) page (https://github.com/badinkajink/hand/blob/f03d7dccc09c73265b5a6def37d6c17e71d26c7d/docs/overviews/morphology_design.html)
8. 2026-11-10 · Talk formulas: the metric step follows the dynamics, and metrics join the outermost loop (owner, 11-10 evening) · cca3b006d (https://github.com/badinkajink/hand/commit/cca3b006dec189e9b5cf9937ab97d742ddf47cd9) page (https://github.com/badinkajink/hand/blob/cca3b006dec189e9b5cf9937ab97d742ddf47cd9/docs/overviews/morphology_design.html)
9. 2026-11-10 · Talk formulas: the innermost level of the co-design problem is the dynamics (owner, 11-10 evening) · 18d7c5330 (https://github.com/badinkajink/hand/commit/18d7c533058a77374838dc878245b05519da9d08) page (https://github.com/badinkajink/hand/blob/18d7c533058a77374838dc878245b05519da9d08/docs/overviews/morphology_design.html)
10. 2026-11-10 · Talk formulas: the co-design build introduces the 6 mount coordinates and the 9 joint commands right after the bi-level step, then the object sizes and the … · f98907013 (https://github.com/badinkajink/hand/commit/f98907013d782f6835b10fe081f67f74b552bd3e) page (https://github.com/badinkajink/hand/blob/f98907013d782f6835b10fe081f67f74b552bd3e/docs/overviews/morphology_design.html)
11. 2026-11-10 · Search methods page: the EA and the 16-particle swarm live at four object sizes without a stored grid (post-reset step 5) · ff95124f7 (https://github.com/badinkajink/hand/commit/ff95124f7e0785b35fb45a825f6dc26d64525c09) page (https://github.com/badinkajink/hand/blob/ff95124f7e0785b35fb45a825f6dc26d64525c09/docs/overviews/morphology_design.html)
12. 2026-11-10 · Refinement page: a particle swarm in place of CEM at level full fails the rule on the press (post-reset step 3) · ad2fa44bb (https://github.com/badinkajink/hand/commit/ad2fa44bb8dcdb61e6e285be6a10832761aa0ea3) page (https://github.com/badinkajink/hand/blob/ad2fa44bb8dcdb61e6e285be6a10832761aa0ea3/docs/overviews/morphology_design.html)
13. 2026-11-10 · Search methods page: the six methods live on the six-coordinate Sobol layouts (post-reset step 4) · 5d8477f06 (https://github.com/badinkajink/hand/commit/5d8477f0630ac5c20066c10635da7a2bacea0447) page (https://github.com/badinkajink/hand/blob/5d8477f0630ac5c20066c10635da7a2bacea0447/docs/overviews/morphology_design.html)
14. 2026-11-10 · Stiffness page: the size study's live EA on the measured servo and MuJoCo 4.0 keeps the press's 1.09 mm/mm and the roll's 0.49 against 0.56; the twist's falls … · f933beb09 (https://github.com/badinkajink/hand/commit/f933beb092d85bad7e7e96e7b600611c181e0ffe) page (https://github.com/badinkajink/hand/blob/f933beb092d85bad7e7e96e7b600611c181e0ffe/docs/overviews/morphology_design.html)
15. 2026-11-10 · HOM landscapes on the measured SCS0009 servo: 0.55 N m/rad and the 0.59 deg dead band reorder the layouts (tracking rho 0.72-0.91 against 0.72 N m/rad, rerun … · 2eb2bfe31 (https://github.com/badinkajink/hand/commit/2eb2bfe3169f5c1a0f6d24d9041a2965876ab972) page (https://github.com/badinkajink/hand/blob/2eb2bfe3169f5c1a0f6d24d9041a2965876ab972/docs/overviews/morphology_design.html)
16. 2026-11-10 · Talk formulas as atomic LaTeX images: one idea per image, one canvas per series, a manifest shared by the page and the deck · d3dcdd914 (https://github.com/badinkajink/hand/commit/d3dcdd914b023114e6f9b8f0e64a2e9192188149) page (https://github.com/badinkajink/hand/blob/d3dcdd914b023114e6f9b8f0e64a2e9192188149/docs/overviews/morphology_design.html)
17. 2026-11-10 · Co-design formulation of the hand-design talk: one nested formula built up over the owner's slides 21-31, and its levels · f81cd63c3 (https://github.com/badinkajink/hand/commit/f81cd63c3f7182ac7a750beb48c2b8a60e212eef) page (https://github.com/badinkajink/hand/blob/f81cd63c3f7182ac7a750beb48c2b8a60e212eef/docs/overviews/morphology_design.html)
18. 2026-11-09 · Roll films with all three pads on the sphere, filmed from below; ties go to the larger three-pad share (owner, 11-09) · e4837be04 (https://github.com/badinkajink/hand/commit/e4837be04e0b03c6fc5ae30bd2e2516d6c09f1d5) page (https://github.com/badinkajink/hand/blob/e4837be04e0b03c6fc5ae30bd2e2516d6c09f1d5/docs/overviews/morphology_design.html)
19. 2026-11-09 · Tracking score for the HOM tasks, checked against the owner's verdicts, and films of re-picked layouts (owner, 11-09) · 68bdab8ba (https://github.com/badinkajink/hand/commit/68bdab8bac51b9c360cbadf12ccff670af6b759c) page (https://github.com/badinkajink/hand/blob/68bdab8bac51b9c360cbadf12ccff670af6b759c/docs/overviews/morphology_design.html)
20. 2026-11-09 · Layout search methods page: the EA of Yang et al., particle swarms, Sobol and the FP paper's RRT on the stored grids; CEM, Pareto fronts and t-SNE from first … · 5f9f3309d (https://github.com/badinkajink/hand/commit/5f9f3309dd8fb5e6f819d777f1079e37af9b0b82) page (https://github.com/badinkajink/hand/blob/5f9f3309dd8fb5e6f819d777f1079e37af9b0b82/docs/overviews/morphology_design.html)
21. 2026-11-05 · Spearman fix on the plant-transfer rows and three pages, 01:0x on 11-05 (6aa06d6b2) · f15190386 (https://github.com/badinkajink/hand/commit/f15190386c4fe82c77eaca9c8587d87a70f60ade) page (https://github.com/badinkajink/hand/blob/f15190386c4fe82c77eaca9c8587d87a70f60ade/docs/overviews/morphology_design.html)
22. 2026-11-04 · HOM grasp-genome EA, 16:3x on 11-04: Section 8 of the score refine page, the EA over layout and grasp · 6c0d155a3 (https://github.com/badinkajink/hand/commit/6c0d155a33a9007f40465386511e217ba1eace0c) page (https://github.com/badinkajink/hand/blob/6c0d155a33a9007f40465386511e217ba1eace0c/docs/overviews/morphology_design.html)
23. 2026-11-04 · HOM shared controller, 12:3x on 11-04: Section 7 of the score refine page, one set of forces and modes for all layouts · a7993fbfc (https://github.com/badinkajink/hand/commit/a7993fbfc15090d8e6594d7ee217dba08d4083ee) page (https://github.com/badinkajink/hand/blob/a7993fbfc15090d8e6594d7ee217dba08d4083ee/docs/overviews/morphology_design.html)
24. 2026-11-04 · HOM worst-case score, 09:3x on 11-04: Section 6 of the score refine page · 351ba39e3 (https://github.com/badinkajink/hand/commit/351ba39e33e9b4221e327aa3f784837968dc1332) page (https://github.com/badinkajink/hand/blob/351ba39e33e9b4221e327aa3f784837968dc1332/docs/overviews/morphology_design.html)
25. 2026-11-04 · HOM task conflict page, 03:4x on 11-04: one finger layout or several for the four HOM tasks, on performance alone · 85845f03e (https://github.com/badinkajink/hand/commit/85845f03e039ed8cd5d47cb6e50678618e635ea4) page (https://github.com/badinkajink/hand/blob/85845f03e039ed8cd5d47cb6e50678618e635ea4/docs/overviews/morphology_design.html)
26. 2026-11-04 · HOM score levels page, 02:3x on 11-04: refined grasps, forces and contact modes against the best of 16 grasps · 05f1ca731 (https://github.com/badinkajink/hand/commit/05f1ca7312d48c5f6bcb107fbfa381928c7c6326) page (https://github.com/badinkajink/hand/blob/05f1ca7312d48c5f6bcb107fbfa381928c7c6326/docs/overviews/morphology_design.html)
27. 2026-11-03 · HOM plant and modulus page: SR2 layouts across finger servos, pad moduli and scene friction · f84e2cd1c (https://github.com/badinkajink/hand/commit/f84e2cd1c27e0b635568ac216d31a0b2a46bc105) page (https://github.com/badinkajink/hand/blob/f84e2cd1c27e0b635568ac216d31a0b2a46bc105/docs/overviews/morphology_design.html)
28. 2026-10-31 · Design overview: the HOM size trends beside the workspace rule, and the two HOM layout pages in its index; dead names removed · 82794604f (https://github.com/badinkajink/hand/commit/82794604fd71fcc8fe4a33556eb32e868aecbc64) page (https://github.com/badinkajink/hand/blob/82794604fd71fcc8fe4a33556eb32e868aecbc64/docs/overviews/morphology_design.html)
29. 2026-10-31 · HOM layouts across 19 object sizes: the trends page opens with the size trends, and the CPU checks and films use each search's own best layout · e6310c7a5 (https://github.com/badinkajink/hand/commit/e6310c7a5099c1d68ee6c49396c3006fd9c7d078) page (https://github.com/badinkajink/hand/blob/e6310c7a5099c1d68ee6c49396c3006fd9c7d078/docs/overviews/morphology_design.html)
30. 2026-10-30 · Design page: the grid's best grasps on fresh seeds 3-5 and moved between layouts. Spheres keep the gain (twist +0.20 vs +0.21 on the picked seeds, roll +0.06 … · 92dd22b06 (https://github.com/badinkajink/hand/commit/92dd22b06d70abb97957310f44c5498c2e1d08bd) page (https://github.com/badinkajink/hand/blob/92dd22b06d70abb97957310f44c5498c2e1d08bd/docs/overviews/morphology_design.html)
31. 2026-10-30 · Design page: lede and summary on the night's results (grasp per layout and task, object size, narrow peaks) · 186276294 (https://github.com/badinkajink/hand/commit/186276294845008021edc19af5f636b828761215) page (https://github.com/badinkajink/hand/blob/186276294845008021edc19af5f636b828761215/docs/overviews/morphology_design.html)
32. 2026-10-30 · Design page (foundational-pose review): the calibrated v4b fingertip, grasp sets per layout on the 2-D grid, related design studies, and the record of method … · f4463635f (https://github.com/badinkajink/hand/commit/f4463635fe59d299be3fa3aa0f7e5c9c1d051511) page (https://github.com/badinkajink/hand/blob/f4463635fe59d299be3fa3aa0f7e5c9c1d051511/docs/overviews/morphology_design.html)
33. 2026-10-29 · Design page: four HOM tasks and sensing errors across 4,680 Sobol layouts on the GPU · c39d07868 (https://github.com/badinkajink/hand/commit/c39d07868ecebf08d0cbb98f0f7afd4bc8b17d17) page (https://github.com/badinkajink/hand/blob/c39d07868ecebf08d0cbb98f0f7afd4bc8b17d17/docs/overviews/morphology_design.html)
34. 2026-10-29 · HOM on the GPU: batched controller on MuJoCo-Warp, validated against the CPU, and the dynamic landscapes of SR2 layouts · 879c66044 (https://github.com/badinkajink/hand/commit/879c66044ba08bfdf64068f8fe661342ef28d074) page (https://github.com/badinkajink/hand/blob/879c66044ba08bfdf64068f8fe661342ef28d074/docs/overviews/morphology_design.html)
35. 2026-10-29 · Review pages of the HOM and foundational-pose papers, with fingertip-sensing and layout-sampling toys · 66330a72c (https://github.com/badinkajink/hand/commit/66330a72c9f4a608ac9f6a78e09793b1c8365c97) page (https://github.com/badinkajink/hand/blob/66330a72c9f4a608ac9f6a78e09793b1c8365c97/docs/overviews/morphology_design.html)
36. 2026-10-22 · Morphology and design overview in plain prose: mean 24.1 to 15.8 words a sentence, over 30 words 24.4 to 2.9 % (plain-language pass of 2026-10-22; gate PASS … · 00e09f1b7 (https://github.com/badinkajink/hand/commit/00e09f1b721f3b25a6b43ab24a1a413f9d20e9bc) page (https://github.com/badinkajink/hand/blob/00e09f1b721f3b25a6b43ab24a1a413f9d20e9bc/docs/overviews/morphology_design.html)
37. 2026-10-14 · Docs index published as an artifact; design overview and index list the CAD-hand page · a824ccb6a (https://github.com/badinkajink/hand/commit/a824ccb6afd42608f2915e7748a64e81d9edf1b7) page (https://github.com/badinkajink/hand/blob/a824ccb6afd42608f2915e7748a64e81d9edf1b7/docs/overviews/morphology_design.html)
38. 2026-10-14 · Docs: index of all result pages, printed-fingertip topic overview, overviews rebuilt with the missing pages; FE films of the whole tip queued · da06ee8f7 (https://github.com/badinkajink/hand/commit/da06ee8f7e41a6ed48a82de0fd0e1a73772df0fc) page (https://github.com/badinkajink/hand/blob/da06ee8f7e41a6ed48a82de0fd0e1a73772df0fc/docs/overviews/morphology_design.html)
39. 2026-10-11 · Contact overview Figure 10 (GPU throughput against parallel worlds) is an interactive figure on log axes with the cost per world-step in the readout; … · cadb7b569 (https://github.com/badinkajink/hand/commit/cadb7b56989b411cdf54cbde7a4f059b13fbde88) page (https://github.com/badinkajink/hand/blob/cadb7b56989b411cdf54cbde7a4f059b13fbde88/docs/overviews/morphology_design.html)
40. 2026-10-11 · Morphology overview: best-cell held cosine against the thumb's and the grip's torque capacity as an interactive scatter from table.json (Spearman +0.44 and … · ac0563468 (https://github.com/badinkajink/hand/commit/ac0563468bfc16a6104fd4f259c9a81bd5231416) page (https://github.com/badinkajink/hand/blob/ac0563468bfc16a6104fd4f259c9a81bd5231416/docs/overviews/morphology_design.html)
41. 2026-10-11 · Morphology overview: the finger-spacing ridges against object radius are an interactive figure drawn from landscape.json (cylinders and spheres on their own … · 61d0d80b4 (https://github.com/badinkajink/hand/commit/61d0d80b4be5871d9593b41fcfa4fa315c317ecb) page (https://github.com/badinkajink/hand/blob/61d0d80b4be5871d9593b41fcfa4fa315c317ecb/docs/overviews/morphology_design.html)
42. 2026-10-11 · Topic overviews: interactive data figures drawn from the source pages' rows (scripts/overview_figures.py, a FIGURES entry names its function with fn=): gait … · a599f40ad (https://github.com/badinkajink/hand/commit/a599f40ad96565193a0d283a67dca8e68552bc47) page (https://github.com/badinkajink/hand/blob/a599f40ad96565193a0d283a67dca8e68552bc47/docs/overviews/morphology_design.html)
43. 2026-10-10 · Overviews: background from the retired webpaper folded in before archiving it (owner direction of 2026-10-09 14:40; items of … · 640bcd2fd (https://github.com/badinkajink/hand/commit/640bcd2fd3fed247b01e8c355e8a493db5cffd4f) page (https://github.com/badinkajink/hand/blob/640bcd2fd3fed247b01e8c355e8a493db5cffd4f/docs/overviews/morphology_design.html)
44. 2026-10-10 · Four page titles set to their INDEX subjects (turn mechanism: 'Reorientation mechanism on the shipped, calibrated and bench plants', subject rewritten without … · c6519db37 (https://github.com/badinkajink/hand/commit/c6519db37b658269581f94e55405a9349e219a68) page (https://github.com/badinkajink/hand/blob/c6519db37b658269581f94e55405a9349e219a68/docs/overviews/morphology_design.html)
45. 2026-10-09 · Topic overview docs/overviews/morphology_design.html: the search funnel and bench ranking (8,198 -> 227 -> 8 built, 48 of 77 held, rho_s 0.50), what predicts a … · 86d8fdd3b (https://github.com/badinkajink/hand/commit/86d8fdd3bd2427bbcb3a40d91ed73fbff197b51a) page (https://github.com/badinkajink/hand/blob/86d8fdd3bd2427bbcb3a40d91ed73fbff197b51a/docs/overviews/morphology_design.html)

### Printed fingertips and force sensing

docs/overviews/printed_fingertips.html · 122 revisions, 2026-10-14 to 2026-11-13
Latest: 2026-11-13 · Fingertip overview: the sampling MPC page's sections on measured state and on the pose filter linked by anchor

Revisions, newest first

1. 2026-11-13 · Fingertip overview: the sampling MPC page's sections on measured state and on the pose filter linked by anchor · ce8fd3003 (https://github.com/badinkajink/hand/commit/ce8fd3003e8e761ada2586bbe065d4a0fcd822ff) page (https://github.com/badinkajink/hand/blob/ce8fd3003e8e761ada2586bbe065d4a0fcd822ff/docs/overviews/printed_fingertips.html)
2. 2026-11-13 · Fingertip overview: the fingertips as the HOM controller's contact sensor in simulation. With the errors measured on the UR5 in its fingertip model, HOM … · 55493180a (https://github.com/badinkajink/hand/commit/55493180a3bc31ea4eb8fadfdfbfdbab64cda1b3) page (https://github.com/badinkajink/hand/blob/55493180a3bc31ea4eb8fadfdfbfdbab64cda1b3/docs/overviews/printed_fingertips.html)
3. 2026-11-11 · Fingertip overview: with each tip's own holds in training the MLP ensemble's error is 0.42-0.46 mm on v3 IDs 1-3 and 0.63-0.68 mm on IDs 4-6, the GP's … · 093b2e62a (https://github.com/badinkajink/hand/commit/093b2e62a987b12b202f739a3f787b4da680dda6) page (https://github.com/badinkajink/hand/blob/093b2e62a987b12b202f739a3f787b4da680dda6/docs/overviews/printed_fingertips.html)
4. 2026-11-11 · Fingertip overview: the sphere-pad implementation page in the section on the fingertip in the simulations (the v4b tip's 1,018 spheres at 122 to 449 N/m at 2.5 … · f8404981c (https://github.com/badinkajink/hand/commit/f8404981c87b108c7f6fa5da2e7476be837b1251) page (https://github.com/badinkajink/hand/blob/f8404981c87b108c7f6fa5da2e7476be837b1251/docs/overviews/printed_fingertips.html)
5. 2026-11-10 · Fingertip overview: the viewer replayed on a UR5 rod roll of v3 ID 5 in the transfer section (0.49 mm from the robot's contact with the board GP, 3.06 mm with … · d7a7a21ff (https://github.com/badinkajink/hand/commit/d7a7a21ff99dec8d65cc877680a5ddedf2c4341e) page (https://github.com/badinkajink/hand/blob/d7a7a21ff99dec8d65cc877680a5ddedf2c4341e/docs/overviews/printed_fingertips.html)
6. 2026-11-10 · Fingertip viewer page: the viewer replayed on a UR5 rod roll of v3 ID 5, with an FE and field film of the roll · bfaf35e1e (https://github.com/badinkajink/hand/commit/bfaf35e1e11d517a7a4d152448bfc2307e11696b) page (https://github.com/badinkajink/hand/blob/bfaf35e1e11d517a7a4d152448bfc2307e11696b/docs/overviews/printed_fingertips.html)
7. 2026-11-05 · Fingertip overview: the SR2 hand's false contacts and own-angle GP at 11 layouts (3f300b0a5) · 2236fdd9a (https://github.com/badinkajink/hand/commit/2236fdd9a769d9141900949215c60312786c8973) page (https://github.com/badinkajink/hand/blob/2236fdd9a769d9141900949215c60312786c8973/docs/overviews/printed_fingertips.html)
8. 2026-11-05 · Fingertip overview: false contacts and the own-angle GP at six layouts of the SR2 hand, with a film · d201a72b2 (https://github.com/badinkajink/hand/commit/d201a72b2bf714493db9c5341e74963fe23c6d24) page (https://github.com/badinkajink/hand/blob/d201a72b2bf714493db9c5341e74963fe23c6d24/docs/overviews/printed_fingertips.html)
9. 2026-11-05 · Fingertip overview: the layout sweep ended at 17:31 on 11-05, and the plan at the HOM layouts has run since 18:01 · 3b55acb54 (https://github.com/badinkajink/hand/commit/3b55acb54cfe259e4d62d897a2d960464cd4eb1f) page (https://github.com/badinkajink/hand/blob/3b55acb54cfe259e4d62d897a2d960464cd4eb1f/docs/overviews/printed_fingertips.html)
10. 2026-11-05 · Fingertip overview: the plan's second stop on the middle's yaw and the limit of 10 deg · da1a65499 (https://github.com/badinkajink/hand/commit/da1a65499704c56b0e14268d64b9c3c17dab76c9) page (https://github.com/badinkajink/hand/blob/da1a65499704c56b0e14268d64b9c3c17dab76c9/docs/overviews/printed_fingertips.html)
11. 2026-11-05 · Fingertip overview: the viewer on the hand with the rig-pooled GP, and the second plan at the HOM study's layouts, in the Future items (commits 84572398, … · 0f475bba2 (https://github.com/badinkajink/hand/commit/0f475bba27b1beeb618584447a1e60b78db3a2a6) page (https://github.com/badinkajink/hand/blob/0f475bba27b1beeb618584447a1e60b78db3a2a6/docs/overviews/printed_fingertips.html)
12. 2026-11-05 · Fingertip overview: the Future item on the next sweep says that the plan resumed at 13:49 on 2026-11-05, after a stepper stage skipped a layout move (636, … · 505182edf (https://github.com/badinkajink/hand/commit/505182edf4c5561f48419bdf8a7a3b15ccf18db7) page (https://github.com/badinkajink/hand/blob/505182edf4c5561f48419bdf8a7a3b15ccf18db7/docs/overviews/printed_fingertips.html)
13. 2026-11-05 · Fingertip overview: the Future item on the next sweep follows the lab's correction (commit e5f02c6d): nothing restricts the middle's yaw, and gravity loads the … · fe6638b1c (https://github.com/badinkajink/hand/commit/fe6638b1c36edfd228cefabb78bdae037074862c) page (https://github.com/badinkajink/hand/blob/fe6638b1c36edfd228cefabb78bdae037074862c/docs/overviews/printed_fingertips.html)
14. 2026-11-05 · Fingertip overview: the Future item on the next sweep says that it stopped at step 32 of 672 on 2026-11-05 and that the hand stays stopped until the owner has … · 5732a0c76 (https://github.com/badinkajink/hand/commit/5732a0c766eaec7c6196c87a4a5498c38dddaf7b) page (https://github.com/badinkajink/hand/blob/5732a0c766eaec7c6196c87a4a5498c38dddaf7b/docs/overviews/printed_fingertips.html)
15. 2026-11-05 · Fingertip overview: other tips' holds on v3 IDs 4 to 6 (0.83 to 0.66 mm at held-out points, 2.51 to 0.74 mm with a region held out) and the GP against the MLP … · 25560b01f (https://github.com/badinkajink/hand/commit/25560b01fbce112dc88b495390fecf8e8fed6034) page (https://github.com/badinkajink/hand/blob/25560b01fbce112dc88b495390fecf8e8fed6034/docs/overviews/printed_fingertips.html)
16. 2026-11-05 · Fingertip overview: the contact viewer's board GP refitted with the rig's holds on 11-05 (mount-end holds 3.04-3.10 to 0.75-0.77 mm, the robot's held-out … · 9177f2c9d (https://github.com/badinkajink/hand/commit/9177f2c9dd5411524c3b44c8a89c1f56e5998ec5) page (https://github.com/badinkajink/hand/blob/9177f2c9dd5411524c3b44c8a89c1f56e5998ec5/docs/overviews/printed_fingertips.html)
17. 2026-11-05 · Fingertip overview: the two paragraphs on the pad's shape take the rerun's numbers on the v4b finger at 2.5 MPa, verbatim from … · dfc8d5956 (https://github.com/badinkajink/hand/commit/dfc8d5956eda24b07eb07389a8a771fc4f66401e) page (https://github.com/badinkajink/hand/blob/dfc8d5956eda24b07eb07389a8a771fc4f66401e/docs/overviews/printed_fingertips.html)
18. 2026-11-05 · Fingertip overview: the rig's presses at the pad's mount end (4.16 to 1.18 mm on v3 ID 3's 70 holds there, pooled, and 0.47 to 0.52 mm at the robot's points) … · cd4bde905 (https://github.com/badinkajink/hand/commit/cd4bde90565543bb583d929b65954dec5625b897) page (https://github.com/badinkajink/hand/blob/cd4bde90565543bb583d929b65954dec5625b897/docs/overviews/printed_fingertips.html)
19. 2026-11-04 · Fingertip overview: the Future work item on fingertips beside each other follows feed line 56. The index's cable was tight, and the next sweep adds … · e4ce06edb (https://github.com/badinkajink/hand/commit/e4ce06edb7cdc81a5c19a6690c2aa50ce081881d) page (https://github.com/badinkajink/hand/blob/e4ce06edb7cdc81a5c19a6690c2aa50ce081881d/docs/overviews/printed_fingertips.html)
20. 2026-11-04 · Fingertip-shape rerun, 21:2x on 11-04: the result page with the index refresh · 2dae56bc1 (https://github.com/badinkajink/hand/commit/2dae56bc15fe934fabe33d94ff38b89e0806ae75) page (https://github.com/badinkajink/hand/blob/2dae56bc15fe934fabe33d94ff38b89e0806ae75/docs/overviews/printed_fingertips.html)
21. 2026-11-04 · Fingertip overview: the SR2 hand's crosstalk sweep in the lede, the paragraph on neighbours and the open question on disturbances. At the home layout a … · 06fb70bec (https://github.com/badinkajink/hand/commit/06fb70bece9421894eec0a61c6821ff7836da96d) page (https://github.com/badinkajink/hand/blob/06fb70bece9421894eec0a61c6821ff7836da96d/docs/overviews/printed_fingertips.html)
22. 2026-11-04 · Fingertip crosstalk page: Section 4 on the SR2 hand from the coordinator's analysis of the sweep of 11-04 (scripts/sr2_crosstalk_night.py, 9a0e05a5). At the … · 7c47bc89e (https://github.com/badinkajink/hand/commit/7c47bc89ef16d23bff02aebf762f3068750cd566) page (https://github.com/badinkajink/hand/blob/7c47bc89ef16d23bff02aebf762f3068750cd566/docs/overviews/printed_fingertips.html)
23. 2026-11-04 · Fingertip overview: the seat block's stripped M2 holes with the rig's numbers, the end of the calibration, and the hand's item · 85947cba8 (https://github.com/badinkajink/hand/commit/85947cba8ac02f39c6b810e43fb73b3329a91908) page (https://github.com/badinkajink/hand/blob/85947cba8ac02f39c6b810e43fb73b3329a91908/docs/overviews/printed_fingertips.html)
24. 2026-11-04 · Fingertip overview: v3 ID 3 on the rig gives 0.59 mm against 0.32 mm on the robot, and its repeated presses vary by 7.9 % against 2.2-2.5 % · d7967d0eb (https://github.com/badinkajink/hand/commit/d7967d0ebc8b473780af50e3ebc89c2e303881f8) page (https://github.com/badinkajink/hand/blob/d7967d0ebc8b473780af50e3ebc89c2e303881f8/docs/overviews/printed_fingertips.html)
25. 2026-11-04 · Calibration page: v3 IDs 1 to 6 by load tilt and tool, Tables 24 and 25, Figure 14 (commit 15c09673) · 88a5205d7 (https://github.com/badinkajink/hand/commit/88a5205d76f3d8d6178b5075ba4ffca51f9fe558) page (https://github.com/badinkajink/hand/blob/88a5205d76f3d8d6178b5075ba4ffca51f9fe558/docs/overviews/printed_fingertips.html)
26. 2026-11-04 · Fingertip overview: the denser rod presses on v3 IDs 4 to 6 and their 18,594 holds · f26022221 (https://github.com/badinkajink/hand/commit/f2602222183b6af207e10fdb16f55cacb42eb586) page (https://github.com/badinkajink/hand/blob/f2602222183b6af207e10fdb16f55cacb42eb586/docs/overviews/printed_fingertips.html)
27. 2026-11-04 · Calibration page: the denser rod presses on v3 IDs 4 to 6, Tables 22 and 23, Figure 13 (commit c13136a8) · ec401baeb (https://github.com/badinkajink/hand/commit/ec401baeb5b7f06d0b307ed681ad692d7d699143) page (https://github.com/badinkajink/hand/blob/ec401baeb5b7f06d0b307ed681ad692d7d699143/docs/overviews/printed_fingertips.html)
28. 2026-11-04 · Calibration page: seat 1's denser rod presses on v3 ID 6, Table 22 (0.746 mm against 0.780 mm, commit 5916bdad) · 9ff9eb086 (https://github.com/badinkajink/hand/commit/9ff9eb0864248e7308de0eccb2bab575af0e0d85) page (https://github.com/badinkajink/hand/blob/9ff9eb0864248e7308de0eccb2bab575af0e0d85/docs/overviews/printed_fingertips.html)
29. 2026-11-04 · Fingertip overview: the rig's point spacing and the error with the load near the normal · 1870ff6e5 (https://github.com/badinkajink/hand/commit/1870ff6e5bfb2da4efdf402f20fae6fe6564180f) page (https://github.com/badinkajink/hand/blob/1870ff6e5bfb2da4efdf402f20fae6fe6564180f/docs/overviews/printed_fingertips.html)
30. 2026-11-04 · Fingertip overview: v3 IDs 4 to 6 on the inverted rig, and the aside on the fingertip's shape · b1eda47c8 (https://github.com/badinkajink/hand/commit/b1eda47c844393f565e87fa60f6c9830c508c143) page (https://github.com/badinkajink/hand/blob/b1eda47c844393f565e87fa60f6c9830c508c143/docs/overviews/printed_fingertips.html)
31. 2026-11-04 · Calibration page: v3 IDs 4 to 6 on the inverted rig (Section 15, Tables 19 and 20, Figure 12) · e90b73a4f (https://github.com/badinkajink/hand/commit/e90b73a4ff8ffe12115b8dd3f311fdbb60257c23) page (https://github.com/badinkajink/hand/blob/e90b73a4ff8ffe12115b8dd3f311fdbb60257c23/docs/overviews/printed_fingertips.html)
32. 2026-11-03 · Fingertip overview: v3 ID 3 and the board GP's held-out error against training holds on v3 IDs 1 to 3 (0.56-0.63 mm with half of the training points, 0.46-0.51 … · d5c8d0929 (https://github.com/badinkajink/hand/commit/d5c8d0929bfd0efcf60493a79607577e34937b09) page (https://github.com/badinkajink/hand/blob/d5c8d0929bfd0efcf60493a79607577e34937b09/docs/overviews/printed_fingertips.html)
33. 2026-10-30 · Fingertip overview: the magnets' open point extends to v3 ID 3 (boards 0.77, 0.63 and 0.59 mm by the presses, strength 0.98 at rest with each board there; ID … · f604fa759 (https://github.com/badinkajink/hand/commit/f604fa7597873c63dba2de6508025c3d96eeeeae) page (https://github.com/badinkajink/hand/blob/f604fa7597873c63dba2de6508025c3d96eeeeae/docs/overviews/printed_fingertips.html)
34. 2026-10-30 · Fingertip overview: the open questions on the four-magnet tips' board offset and face centre extend to v3 ID 3 (physical-model page 1bb75138) · 1c8acc655 (https://github.com/badinkajink/hand/commit/1c8acc65540a876ba9d70a47aac05ccea4f8fe47) page (https://github.com/badinkajink/hand/blob/1c8acc65540a876ba9d70a47aac05ccea4f8fe47/docs/overviews/printed_fingertips.html)
35. 2026-10-30 · Physical-model page: v3 ID 3 beside v3 ID 1, ID 2 and v2 ID 1 (the coordinator's analysis of 10-30, logs/20261030-spherev3id3) · 1bb751383 (https://github.com/badinkajink/hand/commit/1bb75138368bf596ef988f8597ec02bde30d7493) page (https://github.com/badinkajink/hand/blob/1bb75138368bf596ef988f8597ec02bde30d7493/docs/overviews/printed_fingertips.html)
36. 2026-10-30 · Calibration page: the rig's seat strip, and no calibration until the rig works (feed lines 33 and 34, ac021c3d and 3ce83b74) · 0d0588594 (https://github.com/badinkajink/hand/commit/0d05885943fd53a1cc9f6a801d1c5ee556385764) page (https://github.com/badinkajink/hand/blob/0d05885943fd53a1cc9f6a801d1c5ee556385764/docs/overviews/printed_fingertips.html)
37. 2026-10-30 · Calibration page: the inverted rig's seat block in place of plate v2e (feed line 31, bb8f63ae) · f6007b508 (https://github.com/badinkajink/hand/commit/f6007b5083c92311f9d053c5e680f9586f16876b) page (https://github.com/badinkajink/hand/blob/f6007b5083c92311f9d053c5e680f9586f16876b/docs/overviews/printed_fingertips.html)
38. 2026-10-29 · Inverted calibration rig ready to print (owner, 10-29 15:2x): tips held pad up, three seats replayed, P1S projects · 84ea1b72d (https://github.com/badinkajink/hand/commit/84ea1b72db0f415bf405f0f3cc74b35e64b967b1) page (https://github.com/badinkajink/hand/blob/84ea1b72db0f415bf405f0f3cc74b35e64b967b1/docs/overviews/printed_fingertips.html)
39. 2026-10-29 · Inverted rig: probe on the HEX-E reaches 444 of 808 pad points on a held tip against 286 for the finger on the robot (owner, 13:0x on 10-29) · 33cfe6f3d (https://github.com/badinkajink/hand/commit/33cfe6f3dc662fadadd8df155c6114603fa29f4f) page (https://github.com/badinkajink/hand/blob/33cfe6f3dc662fadadd8df155c6114603fa29f4f/docs/overviews/printed_fingertips.html)
40. 2026-10-29 · Fingertip overview: v3 ID 2 (owner, 10-29 14:0x: "any new edits/updates required now that the full v3 id 2 pass is finished") · fe8a83e79 (https://github.com/badinkajink/hand/commit/fe8a83e79e485a565a8264894b7dd8b96ebc14b0) page (https://github.com/badinkajink/hand/blob/fe8a83e79e485a565a8264894b7dd8b96ebc14b0/docs/overviews/printed_fingertips.html)
41. 2026-10-29 · Inverted rig page (first build): probe and plate v2e STLs, reach on six seat orientations, QUEUE R31 at 14:2x · ef453c6c8 (https://github.com/badinkajink/hand/commit/ef453c6c8dcb5d45a9efddafbf9d2d439c58d230) page (https://github.com/badinkajink/hand/blob/ef453c6c8dcb5d45a9efddafbf9d2d439c58d230/docs/overviews/printed_fingertips.html)
42. 2026-10-29 · Physical-model page with v3 ID 2: the model on the three N52 tips' shared sphere actions, and the signal per newton by region · 100ec8dba (https://github.com/badinkajink/hand/commit/100ec8dba6ac11b1b392a6f4fe9cab85a7c47893) page (https://github.com/badinkajink/hand/blob/100ec8dba6ac11b1b392a6f4fe9cab85a7c47893/docs/overviews/printed_fingertips.html)
43. 2026-10-29 · Fingertip overview: transfer between tips after the calibration motions analysis (feed line of 10-29 12:45) · 853cf69c8 (https://github.com/badinkajink/hand/commit/853cf69c8527f03c6446b6af5c9b20c80e4cb476) page (https://github.com/badinkajink/hand/blob/853cf69c8527f03c6446b6af5c9b20c80e4cb476/docs/overviews/printed_fingertips.html)
44. 2026-10-29 · Calibration page: what each calibration motion adds on the four-magnet tips (feed line of 10-29 12:45, 9da437e0) · f3980846b (https://github.com/badinkajink/hand/commit/f3980846bd02bb0a626e752f4843214d86e58749) page (https://github.com/badinkajink/hand/blob/f3980846bd02bb0a626e752f4843214d86e58749/docs/overviews/printed_fingertips.html)
45. 2026-10-29 · Calibration motions page for the four-magnet tips: what each motion adds on v3 ID 1 and ID 2 (owner, 11:37 on 10-29: plate v2d waits "until we have 100% … · 9da437e01 (https://github.com/badinkajink/hand/commit/9da437e019a2d923ceba43eb82d58cba34c59565) page (https://github.com/badinkajink/hand/blob/9da437e019a2d923ceba43eb82d58cba34c59565/docs/overviews/printed_fingertips.html)
46. 2026-10-29 · Calibration page: four magnets against five on the tall indenter and on v3 ID 2 (feed lines of 10-29 10:28 and 10:29): Section 11's tall paragraph and Table 12 … · b37d77273 (https://github.com/badinkajink/hand/commit/b37d772738c0901e847ca5d15d6a7470da618bf5) page (https://github.com/badinkajink/hand/blob/b37d772738c0901e847ca5d15d6a7470da618bf5/docs/overviews/printed_fingertips.html)
47. 2026-10-29 · Calibration page: Section 12, v3 ID 2 against v3 ID 1 on the presses both ran (feed lines of 10-29 09:46 and 10:00): Table 14 on the sphere's 116, the rod's 75 … · f0cc0052f (https://github.com/badinkajink/hand/commit/f0cc0052f2f40f7845b196f7eb68647eaf2f72b8) page (https://github.com/badinkajink/hand/blob/f0cc0052f2f40f7845b196f7eb68647eaf2f72b8/docs/overviews/printed_fingertips.html)
48. 2026-10-28 · Fingertip overview: v3 ID 1 on the rod, four magnets against five (feed line of 15:14) · 5e9aae4c5 (https://github.com/badinkajink/hand/commit/5e9aae4c5b0b640bb153594d5124aabfc3ddb07d) page (https://github.com/badinkajink/hand/blob/5e9aae4c5b0b640bb153594d5124aabfc3ddb07d/docs/overviews/printed_fingertips.html)
49. 2026-10-28 · Calibration page: four magnets against five on the rod (feed line of 15:14) · 9c64f6f44 (https://github.com/badinkajink/hand/commit/9c64f6f44abc3446d78f3051ba17ff3e31cc7714) page (https://github.com/badinkajink/hand/blob/9c64f6f44abc3446d78f3051ba17ff3e31cc7714/docs/overviews/printed_fingertips.html)
50. 2026-10-28 · Fingertip overview: the face centre's error under 1 N with the pressed points left out (feed line of 13:48) · 15af20663 (https://github.com/badinkajink/hand/commit/15af206635609947e445339af35191558e520559) page (https://github.com/badinkajink/hand/blob/15af206635609947e445339af35191558e520559/docs/overviews/printed_fingertips.html)
51. 2026-10-28 · Fingertip overview: the GP's torsion on v2 and v3 ID 1's twists (feed line of 12:25) · b720ce978 (https://github.com/badinkajink/hand/commit/b720ce978b418c55afd0e4e6fbddd08e3928ebf7) page (https://github.com/badinkajink/hand/blob/b720ce978b418c55afd0e4e6fbddd08e3928ebf7/docs/overviews/printed_fingertips.html)
52. 2026-10-28 · Calibration page: torsion on v3 ID 1's 12 twists against v2 ID 1's (feed line of 12:25) · 91bcfc2ed (https://github.com/badinkajink/hand/commit/91bcfc2ed4af383f8e589a8d7162c8d3c22ddc14) page (https://github.com/badinkajink/hand/blob/91bcfc2ed4af383f8e589a8d7162c8d3c22ddc14/docs/overviews/printed_fingertips.html)
53. 2026-10-28 · Physical-model page with four magnets (owner, 2026-10-28: "i think we will stick with the 4 magnet config"; the five-magnet figures stay in blocks under "View … · dc0a559a7 (https://github.com/badinkajink/hand/commit/dc0a559a7c457fc993617c7c11d01ab83115cf2e) page (https://github.com/badinkajink/hand/blob/dc0a559a7c457fc993617c7c11d01ab83115cf2e/docs/overviews/printed_fingertips.html)
54. 2026-10-28 · Fingertip overview: four N52 magnets in pad 05R4's 5.0 mm square as the layout, five as the comparison (owner, 10-28: "i think we will stick with the 4 magnet … · f9599465a (https://github.com/badinkajink/hand/commit/f9599465a978140bec68a9e774e938dc0fe41620) page (https://github.com/badinkajink/hand/blob/f9599465a978140bec68a9e774e938dc0fe41620/docs/overviews/printed_fingertips.html)
55. 2026-10-28 · Indenter plate page: the full replay of v2d (every sample, travel included): 84 side hovers, 162 tall and 318 of 337 sphere actions clear; no flag names … · b37050ee3 (https://github.com/badinkajink/hand/commit/b37050ee38ebd2097d684f90d59476b1fa63105f) page (https://github.com/badinkajink/hand/blob/b37050ee38ebd2097d684f90d59476b1fa63105f/docs/overviews/printed_fingertips.html)
56. 2026-10-28 · Indenter plate layout: the lab's plans replayed on the printed plate and on a proposed layout (page, tool, STL) · 7661b2042 (https://github.com/badinkajink/hand/commit/7661b204280e2dbd8d04774e2edf6e7f3a69af04) page (https://github.com/badinkajink/hand/blob/7661b204280e2dbd8d04774e2edf6e7f3a69af04/docs/overviews/printed_fingertips.html)
57. 2026-10-28 · Fingertip overview: mount v7's sentence starts with its name · e1422cba7 (https://github.com/badinkajink/hand/commit/e1422cba7bcbcc4985dff8b566d734912dae70b9) page (https://github.com/badinkajink/hand/blob/e1422cba7bcbcc4985dff8b566d734912dae70b9/docs/overviews/printed_fingertips.html)
58. 2026-10-28 · Fingertip overview: v2 ID 1's presses beyond its training force and the tall indenter, four N52 magnets against five on v3 ID 1, the fitted modulus and the … · d0bd36d33 (https://github.com/badinkajink/hand/commit/d0bd36d337fb728a01d509e6b661d0be7bd7c28e) page (https://github.com/badinkajink/hand/blob/d0bd36d337fb728a01d509e6b661d0be7bd7c28e/docs/overviews/printed_fingertips.html)
59. 2026-10-28 · Calibration page: v2 ID 1 and v3 ID 1 (owner, 10-28: "are the calibration plots and data/results ... up to date for our results from 10-27 and just now with … · 126a2c40c (https://github.com/badinkajink/hand/commit/126a2c40c3e9837d0f25d9691aad320b29688680) page (https://github.com/badinkajink/hand/blob/126a2c40c3e9837d0f25d9691aad320b29688680/docs/overviews/printed_fingertips.html)
60. 2026-10-27 · Fingertip crosstalk page: the close hovers over the -y held tip join the holder map · dc8b64789 (https://github.com/badinkajink/hand/commit/dc8b647892413a4cca2a2326dbbc24e811ad7ab2) page (https://github.com/badinkajink/hand/blob/dc8b647892413a4cca2a2326dbbc24e811ad7ab2/docs/overviews/printed_fingertips.html)
61. 2026-10-27 · Fingertip crosstalk page: the holder map's 89 hovers against the net moments fitted on the touch-offs · 80fcc035b (https://github.com/badinkajink/hand/commit/80fcc035ba7199f63586b90835cefc5671a18299) page (https://github.com/badinkajink/hand/blob/80fcc035ba7199f63586b90835cefc5671a18299/docs/overviews/printed_fingertips.html)
62. 2026-10-27 · Fingertip overview: the crosstalk sentences take the field measured between v3 tips on the UR5 · fd38e26c7 (https://github.com/badinkajink/hand/commit/fd38e26c7c567fa41fafca0b8dd4c160f7c73916) page (https://github.com/badinkajink/hand/blob/fd38e26c7c567fa41fafca0b8dd4c160f7c73916/docs/overviews/printed_fingertips.html)
63. 2026-10-27 · Published from personal (hand-off 20261027, step 6): the crosstalk page as a new artifact, https://claude.ai/artifact/6fKoeQRRedDZ8yQvAVNQnJ … · 2547e3c2a (https://github.com/badinkajink/hand/commit/2547e3c2aa630c3673b52a5513ee780d4a9b188d) page (https://github.com/badinkajink/hand/blob/2547e3c2aa630c3673b52a5513ee780d4a9b188d/docs/overviews/printed_fingertips.html)
64. 2026-10-27 · Fingertip overview and calibration page with the first-order numbers of 10-27 and the crosstalk (hand-off 20261027, step 5) · fe7c24b46 (https://github.com/badinkajink/hand/commit/fe7c24b461be2b472ff7ee54274e000f1ca9f7b6) page (https://github.com/badinkajink/hand/blob/fe7c24b461be2b472ff7ee54274e000f1ca9f7b6/docs/overviews/printed_fingertips.html)
65. 2026-10-27 · Page on magnetic crosstalk between neighbouring fingertips (hand-off 20261027, step 4) · 8e301f80f (https://github.com/badinkajink/hand/commit/8e301f80f8e7e14d990765f4c6c6a1f99d493d3b) page (https://github.com/badinkajink/hand/blob/8e301f80f8e7e14d990765f4c6c6a1f99d493d3b/docs/overviews/printed_fingertips.html)
66. 2026-10-27 · Three v1 fingertips at rest overnight: a paragraph in the reskin5x README's C6 section and a sentence in the fingertip overview's readout section, overview … · 439956a0c (https://github.com/badinkajink/hand/commit/439956a0c20602966d20d06ba16a1cd10539b3f0) page (https://github.com/badinkajink/hand/blob/439956a0c20602966d20d06ba16a1cd10539b3f0/docs/overviews/printed_fingertips.html)
67. 2026-10-27 · Page on the three v1 fingertips' night at rest: prose from the final numbers of 19:35-04:00 (readout passes, no contact at 2 uT and one frame at 1 uT, the … · a076be822 (https://github.com/badinkajink/hand/commit/a076be8225333ede681d8615eadd19f7b42affbe) page (https://github.com/badinkajink/hand/blob/a076be8225333ede681d8615eadd19f7b42affbe/docs/overviews/printed_fingertips.html)
68. 2026-10-26 · Indices: the physical-model page's artifact link (docs_index after its artifact_url.txt) · d56e1b5b9 (https://github.com/badinkajink/hand/commit/d56e1b5b98d0fad97867e95fc7321d6319a4e690) page (https://github.com/badinkajink/hand/blob/d56e1b5b98d0fad97867e95fc7321d6319a4e690/docs/overviews/printed_fingertips.html)
69. 2026-10-26 · Fingertip physical-model and calibration pages published on personal: https://claude.ai/artifact/HLwPSJ2FXb1BChAQ98rTX1 and … · b73f5cd7b (https://github.com/badinkajink/hand/commit/b73f5cd7b69058bc59dbaada734fe6a3ff910505) page (https://github.com/badinkajink/hand/blob/b73f5cd7b69058bc59dbaada734fe6a3ff910505/docs/overviews/printed_fingertips.html)
70. 2026-10-26 · Fingertip overview: the lede ends with a reading path (owner, 2026-10-26): the physical-model page, the calibration on the UR5, and the first part of the … · 948d1bf17 (https://github.com/badinkajink/hand/commit/948d1bf178a64b39df1728cd51765faa03d8eb6a) page (https://github.com/badinkajink/hand/blob/948d1bf178a64b39df1728cd51765faa03d8eb6a/docs/overviews/printed_fingertips.html)
71. 2026-10-26 · Fingertip calibration page (owner, 2026-10-26: the calibration's motions, geometry, desired sensing result, the protocol formalized, the learning architecture … · 3a982fad1 (https://github.com/badinkajink/hand/commit/3a982fad17a6d26b50fc0f5426f4ecc01e982145) page (https://github.com/badinkajink/hand/blob/3a982fad17a6d26b50fc0f5426f4ecc01e982145/docs/overviews/printed_fingertips.html)
72. 2026-10-26 · Fingertip physical model page (owner, 2026-10-26: understand the FEA, the printed tip and the magnetic sensing that make the physical model). One page explains … · 8e425c2b6 (https://github.com/badinkajink/hand/commit/8e425c2b6f8d5f4655a8b0ea15916f24d2150242) page (https://github.com/badinkajink/hand/blob/8e425c2b6f8d5f4655a8b0ea15916f24d2150242/docs/overviews/printed_fingertips.html)
73. 2026-10-25 · Fingertips beside each other on the hand: paused by the owner (10-25 12:58) until every fingertip has its UR5 calibration, then a calibration on the SR2 hand … · bdff31a67 (https://github.com/badinkajink/hand/commit/bdff31a678f777aa2f66c6f702eeca7d8d58d553) page (https://github.com/badinkajink/hand/blob/bdff31a678f777aa2f66c6f702eeca7d8d58d553/docs/overviews/printed_fingertips.html)
74. 2026-10-25 · Fingertip overview and status page: three fingers read together through one I2C mux (owner, 10-25). 152 records a second, every conversion of the 15 chips; … · 71045d692 (https://github.com/badinkajink/hand/commit/71045d692da090e136fa16c00ce26845be12440b) page (https://github.com/badinkajink/hand/blob/71045d692da090e136fa16c00ce26845be12440b/docs/overviews/printed_fingertips.html)
75. 2026-10-25 · UR5 calibration (cb1t): checks of the physical estimator and of the contact wrench (owner, 10-25: "we can try these fixes to the physical model estimator"; "we … · 67c0d776d (https://github.com/badinkajink/hand/commit/67c0d776d224999e5d30e4da1417ebec763c8484) page (https://github.com/badinkajink/hand/blob/67c0d776d224999e5d30e4da1417ebec763c8484/docs/overviews/printed_fingertips.html)
76. 2026-10-25 · UR5 calibration (cb1t): the physical model with a correction. At 2 N and over the rest fit's model misses held-out contacts by 1.16 mm; corrected by a GP on … · b00e2b15f (https://github.com/badinkajink/hand/commit/b00e2b15f1dcb73ea44834c66e32eccb3d750dbf) page (https://github.com/badinkajink/hand/blob/b00e2b15f1dcb73ea44834c66e32eccb3d750dbf/docs/overviews/printed_fingertips.html)
77. 2026-10-25 · UR5 calibration: cb1t follows the plan (owner, 10-25: poles named from the board's side) and its magnets are sphere2's; R24 for v1 ID 2 on mount v6 · 88f961d97 (https://github.com/badinkajink/hand/commit/88f961d97865874fab81155b987d20aa20e3c337) page (https://github.com/badinkajink/hand/blob/88f961d97865874fab81155b987d20aa20e3c337/docs/overviews/printed_fingertips.html)
78. 2026-10-24 · UR5 calibration (R22): cb1t's poles stated for both readings of the plan, the overview, the status page and QUEUE.md · e6497529a (https://github.com/badinkajink/hand/commit/e6497529a42b4e5c91f845585e22e917c55a039c) page (https://github.com/badinkajink/hand/blob/e6497529a42b4e5c91f845585e22e917c55a039c/docs/overviews/printed_fingertips.html)
79. 2026-10-23 · Explain contact torque and printed fingertip sensing before detailed results · 9ef34f3e3 (https://github.com/badinkajink/hand/commit/9ef34f3e3845b77bbbb82900c779007906344585) page (https://github.com/badinkajink/hand/blob/9ef34f3e3845b77bbbb82900c779007906344585/docs/overviews/printed_fingertips.html)
80. 2026-10-23 · Contact overview: a section on the calibration of the pads to the FE model and to the UR5 presses (owner, 10-23: the contact overview owns the sphere pads' … · 69a71b61a (https://github.com/badinkajink/hand/commit/69a71b61ac0283705a5622f68fb91c65209ce23c) page (https://github.com/badinkajink/hand/blob/69a71b61ac0283705a5622f68fb91c65209ce23c/docs/overviews/printed_fingertips.html)
81. 2026-10-23 · ATI calibration (17:52): a base and top for the Mini40 from ATI's drawings, its robot plan and its simulated sessions; the stack script takes --sensor · d3aa72265 (https://github.com/badinkajink/hand/commit/d3aa72265b665e60abdb5bbaf196675254b96bc4) page (https://github.com/badinkajink/hand/blob/d3aa72265b665e60abdb5bbaf196675254b96bc4/docs/overviews/printed_fingertips.html)
82. 2026-10-23 · Contact estimator: a test against fields from outside the pad rejects steel touched to the fingertip (viewer toggle, key f) · a710bd23a (https://github.com/badinkajink/hand/commit/a710bd23a40d062c2e47beefb778834f03619b9c) page (https://github.com/badinkajink/hand/blob/a710bd23a40d062c2e47beefb778834f03619b9c/docs/overviews/printed_fingertips.html)
83. 2026-10-23 · UR5 calibration (R21 done): last night's predictors hold a day later; results page Section 9 · 0a353b20c (https://github.com/badinkajink/hand/commit/0a353b20cbf360e0d3173b822217c0789114b4f9) page (https://github.com/badinkajink/hand/blob/0a353b20cbf360e0d3173b822217c0789114b4f9/docs/overviews/printed_fingertips.html)
84. 2026-10-23 · Printed fingertips overview: the transfer to the checkerboard actually printed (set D: physical 1.36 mm, the correction 0.83 mm, retrained 0.61 mm, raw GP 4.09 … · 33d5bd1e6 (https://github.com/badinkajink/hand/commit/33d5bd1e6fa0302d4d3ef706dc8d35d46f88c53e) page (https://github.com/badinkajink/hand/blob/33d5bd1e6fa0302d4d3ef706dc8d35d46f88c53e/docs/overviews/printed_fingertips.html)
85. 2026-10-23 · Printed fingertips overview with the rod presses (84ddf755, results page Section 8) and the ATI plan's 100 g weight (555db445) · bd4b7c70c (https://github.com/badinkajink/hand/commit/bd4b7c70ca9047637a60c7b7c540fed83b08ebde) page (https://github.com/badinkajink/hand/blob/bd4b7c70ca9047637a60c7b7c540fed83b08ebde/docs/overviews/printed_fingertips.html)
86. 2026-10-23 · Printed fingertips overview: the sphere pads against sphere2's 357 press holds (544b18d4, results page Section 7) in the simulations section: with a series … · 438fcf545 (https://github.com/badinkajink/hand/commit/438fcf545f1ae6784939011fd7e7f5c3b17fcf66) page (https://github.com/badinkajink/hand/blob/438fcf545f1ae6784939011fd7e7f5c3b17fcf66/docs/overviews/printed_fingertips.html)
87. 2026-10-23 · Printed fingertips overview brought up to date (owner, 10-23: "putting you in charge of making sure our main overview doc for the printed tip + sensing is up … · 42f4cbe3d (https://github.com/badinkajink/hand/commit/42f4cbe3da832d7c498973bc79fa805876829311) page (https://github.com/badinkajink/hand/blob/42f4cbe3da832d7c498973bc79fa805876829311/docs/overviews/printed_fingertips.html)
88. 2026-10-23 · Second fingertip page (owner, 10-23: "make sure this transfer is documented well"): the UR5 fingertip's calibration applied to the desk's fingertip, whose two … · 30f1d2811 (https://github.com/badinkajink/hand/commit/30f1d2811c5339ac651915846346f8e639b40f22) page (https://github.com/badinkajink/hand/blob/30f1d2811c5339ac651915846346f8e639b40f22/docs/overviews/printed_fingertips.html)
89. 2026-10-23 · ATI calibration (owner, 11:05 on 10-23: "design a mount for the ATI for the HEX-E and build up a calibration plan ... the Z-axis is the noisiest axis ... maybe … · 6e1e77025 (https://github.com/badinkajink/hand/commit/6e1e77025f2c5c07a57a5d79d00f089c839cd5f2) page (https://github.com/badinkajink/hand/blob/6e1e77025f2c5c07a57a5d79d00f089c839cd5f2/docs/overviews/printed_fingertips.html)
90. 2026-10-23 · UR5 calibration mount v5 (owner, after v4's fork went to the P1S: the lab has the heat-set inserts but no brass set screws or nuts; "a constraining v5 that … · 260d93fc4 (https://github.com/badinkajink/hand/commit/260d93fc433de48a782a86017ee8649ea1dd495e) page (https://github.com/badinkajink/hand/blob/260d93fc433de48a782a86017ee8649ea1dd495e/docs/overviews/printed_fingertips.html)
91. 2026-10-23 · ATI Mini45 calibration plan (owner, 10-23: replace the HEX-E with a calibrated ATI; a printed mount on the HEX-E with the current indenter setup): presses … · ba8f47e4a (https://github.com/badinkajink/hand/commit/ba8f47e4ac9a827461e71db2be893d84bade8ae7) page (https://github.com/badinkajink/hand/blob/ba8f47e4ac9a827461e71db2be893d84bade8ae7/docs/overviews/printed_fingertips.html)
92. 2026-10-23 · Docs index: the UR5 board drift page under 23 October (d0f7348e), its artifact kept · f850b8db7 (https://github.com/badinkajink/hand/commit/f850b8db761a2fdccbe6493be6904b1917b86b78) page (https://github.com/badinkajink/hand/blob/f850b8db761a2fdccbe6493be6904b1917b86b78/docs/overviews/printed_fingertips.html)
93. 2026-10-23 · Docs index with the UR5 board drift page (c521db5a) and its artifact (claude.ai/artifact/JjpJFq6Ez2TNfyjDmMtd3A) in its own INDEX.md row · 84df9b10b (https://github.com/badinkajink/hand/commit/84df9b10b7071bb3aa9c2d4f33ea9f0646f258e4) page (https://github.com/badinkajink/hand/blob/84df9b10b7071bb3aa9c2d4f33ea9f0646f258e4/docs/overviews/printed_fingertips.html)
94. 2026-10-23 · UR5 calibration mount v4 (R18, the owner's request through the lab: the DIP link moves in v3's fork): v3 with a stop plate behind the tongue and three brass M3 … · 0c2ea7865 (https://github.com/badinkajink/hand/commit/0c2ea7865ec66d942018676b1a0e295c77f58e92) page (https://github.com/badinkajink/hand/blob/0c2ea7865ec66d942018676b1a0e295c77f58e92/docs/overviews/printed_fingertips.html)
95. 2026-10-22 · Docs index: the UR5 lab page's artifact (claude.ai/artifact/1yHnNnGGE7Aq7VMZQmLvdw) in its own INDEX.md row, not a folder-wide artifact_url.txt, since the … · 3501c6b46 (https://github.com/badinkajink/hand/commit/3501c6b46e7348c4d65528ca3f5ca7ed6d3e947e) page (https://github.com/badinkajink/hand/blob/3501c6b46e7348c4d65528ca3f5ca7ed6d3e947e/docs/overviews/printed_fingertips.html)
96. 2026-10-22 · Docs index with the UR5 lab page (97caa02a), run on the workstation for the lab's clone; the results page now links the lab page · 60481f5bc (https://github.com/badinkajink/hand/commit/60481f5bcec93ce7d3df2051c21191ab490089c8) page (https://github.com/badinkajink/hand/blob/60481f5bcec93ce7d3df2051c21191ab490089c8/docs/overviews/printed_fingertips.html)
97. 2026-10-22 · UR5 calibration: grid-061, -065, -066 and -067 left out of the ground truth (0.3 to 0.4 N on the HEX-E off the pad, the lab's finding), results rerun: … · 672642800 (https://github.com/badinkajink/hand/commit/672642800f42b498d532ef80403179f90ed27b9f) page (https://github.com/badinkajink/hand/blob/672642800f42b498d532ef80403179f90ed27b9f/docs/overviews/printed_fingertips.html)
98. 2026-10-22 · UR5 calibration results on the whole sphere2 session (451 holds): FE force 5.1 times the measured at the registered positions while the board reads 0.78-0.96 … · d42db5bf1 (https://github.com/badinkajink/hand/commit/d42db5bf1975f5772dff3d5a3e6d3f240a653812) page (https://github.com/badinkajink/hand/blob/d42db5bf1975f5772dff3d5a3e6d3f240a653812/docs/overviews/printed_fingertips.html)
99. 2026-10-22 · UR5 calibration results page (scripts/ur5_tip_calibration_results_page.py): pad compliance against the FE model, the board against the HEX-E, the pivot check, … · b34784f64 (https://github.com/badinkajink/hand/commit/b34784f64508c9d0e4bf76947e83a3095f661967) page (https://github.com/badinkajink/hand/blob/b34784f64508c9d0e4bf76947e83a3095f661967/docs/overviews/printed_fingertips.html)
100. 2026-10-22 · Plain-language pass of the DIP link board mount and fit-print (run b) pages (2026-10-22): means 27.8 to 26.5 and 31.2 to 27.1 words a sentence; judge 11 of 14 … · de59c7814 (https://github.com/badinkajink/hand/commit/de59c78144c273f802f74612d50e0b282d400bf5) page (https://github.com/badinkajink/hand/blob/de59c78144c273f802f74612d50e0b282d400bf5/docs/overviews/printed_fingertips.html)
101. 2026-10-22 · Printed fingertips overview in plain prose: mean 29.0 to 17.7 words a sentence, over 30 words 42.0 to 7.0 % (plain-language pass of 2026-10-22; gate PASS with … · 6b636739f (https://github.com/badinkajink/hand/commit/6b636739f0ec9194bfc672d498db64fc07051ad2) page (https://github.com/badinkajink/hand/blob/6b636739f0ec9194bfc672d498db64fc07051ad2/docs/overviews/printed_fingertips.html)
102. 2026-10-22 · Snug sets 3S and 2S: the 11:30 interference taken out on the B05R pads (owner, 2026-10-22 16:37: 'let's setup a print for both the 2t and 3t settings that … · b7b8327f0 (https://github.com/badinkajink/hand/commit/b7b8327f09099e913d661679c7677fccf6a628e7) page (https://github.com/badinkajink/hand/blob/b7b8327f09099e913d661679c7677fccf6a628e7/docs/overviews/printed_fingertips.html)
103. 2026-10-22 · Cover 2T and cap TW15H2: the sweep's 2 mm pair with 3T's tighter rails (owner, 2026-10-22 16:17: 'can you also prepare cassettes + top covers at the lowest … · d6b8577f9 (https://github.com/badinkajink/hand/commit/d6b8577f9b52acd3e71999939bff3a3b62efd75b) page (https://github.com/badinkajink/hand/blob/d6b8577f9b52acd3e71999939bff3a3b62efd75b/docs/overviews/printed_fingertips.html)
104. 2026-10-22 · Calibration protocol of the fingertip on the UR5 (CB3) and the OptoForce HEX-E, with a program, a simulator and a simulated session (owner, 2026-10-22: "we're … · a82f79b55 (https://github.com/badinkajink/hand/commit/a82f79b55cb8b5389d7c4e3f41eed840d6cb2cd7) page (https://github.com/badinkajink/hand/blob/a82f79b55cb8b5389d7c4e3f41eed840d6cb2cd7/docs/overviews/printed_fingertips.html)
105. 2026-10-22 · UR5e mount v3: brass heat-set inserts for the foot's M3 screws in the adapter (owner, 2026-10-22 12:22: 'let's not go for self-threaded m3 holes there and just … · 48530e4dd (https://github.com/badinkajink/hand/commit/48530e4ddd37a1b84c12148ea5efbbeaf8b7dfd0) page (https://github.com/badinkajink/hand/blob/48530e4ddd37a1b84c12148ea5efbbeaf8b7dfd0/docs/overviews/printed_fingertips.html)
106. 2026-10-22 · Chosen 3 mm cover and cap with tighter rails and a smaller pin hole (owner, 2026-10-22 11:30: 'for the new fingers with the hole in the top, we should really … · 2a88d1ad3 (https://github.com/badinkajink/hand/commit/2a88d1ad39a5246e087e2d99d087bd7b1111bc55) page (https://github.com/badinkajink/hand/blob/2a88d1ad39a5246e087e2d99d087bd7b1111bc55/docs/overviews/printed_fingertips.html)
107. 2026-10-21 · UR5e calibration mount v3 for M6 x 20 screws tightened from above (owner, 2026-10-21 17:54: 'i only have 20mm long m6 screws. so we need to pop everything up a … · 38559592c (https://github.com/badinkajink/hand/commit/38559592ca8808e2055b8ed4b174ca59d9f405fe) page (https://github.com/badinkajink/hand/blob/38559592ca8808e2055b8ed4b174ca59d9f405fe/docs/overviews/printed_fingertips.html)
108. 2026-10-21 · DIP link b v4 and a sweep of retaining-wall heights (owner, 2026-10-21 16:20: 'the 0.15mm inset is still perfectly fine ... lower the heights on both the top … · 3d321adfd (https://github.com/badinkajink/hand/commit/3d321adfd7c7d2de9b442ca4214c4967811688f9) page (https://github.com/badinkajink/hand/blob/3d321adfd7c7d2de9b442ca4214c4967811688f9/docs/overviews/printed_fingertips.html)
109. 2026-10-21 · Page on spherical and disc N52 magnets in the B00 fingertip pad: a 3 mm sphere resolves 0.0285 N against the disc's 0.0304 N; spheres of 4 mm and more exceed … · 09a42008e (https://github.com/badinkajink/hand/commit/09a42008ecc4cd25a6c7a16fa7e275a16585771e) page (https://github.com/badinkajink/hand/blob/09a42008ecc4cd25a6c7a16fa7e275a16585771e/docs/overviews/printed_fingertips.html)
110. 2026-10-21 · Drift of the fingertip board's rest reading: the contact viewer corrects each chip for its temperature, adds a 2 uT noise floor and re-zeros at rest; the … · e010edda3 (https://github.com/badinkajink/hand/commit/e010edda33b5edf1ec4ac478dad1938dc1084c0f) page (https://github.com/badinkajink/hand/blob/e010edda33b5edf1ec4ac478dad1938dc1084c0f/docs/overviews/printed_fingertips.html)
111. 2026-10-21 · Resolved-bead and G-code checks of the 11/22 fingertip; the arc-skipping G-code reader corrected on four pages · d379de08c (https://github.com/badinkajink/hand/commit/d379de08c0c69e5950f0aee8db77920f2b1faa5d) page (https://github.com/badinkajink/hand/blob/d379de08c0c69e5950f0aee8db77920f2b1faa5d/docs/overviews/printed_fingertips.html)
112. 2026-10-20 · Fingertip overview: why the FE solver is our own code, and which checks cover the curved 85A tips · f60c8063e (https://github.com/badinkajink/hand/commit/f60c8063e2eb7047083afd84b53586e1ed93090b) page (https://github.com/badinkajink/hand/blob/f60c8063e2eb7047083afd84b53586e1ed93090b/docs/overviews/printed_fingertips.html)
113. 2026-10-20 · Printed-fingertips overview rewritten as the method's reference: the chain from print recipe to contact estimate · 6d46c9b89 (https://github.com/badinkajink/hand/commit/6d46c9b89dbc07479cd996b73ae8209bc9274ea0) page (https://github.com/badinkajink/hand/blob/6d46c9b89dbc07479cd996b73ae8209bc9274ea0/docs/overviews/printed_fingertips.html)
114. 2026-10-18 · Artifacts for the DIP, calibration and status pages (artifact_url.txt, INDEX rows); home page, page index, fingertip and contact overviews republished, each … · 5758108af (https://github.com/badinkajink/hand/commit/5758108aff0bf0ec1a08375660b5342412117a12) page (https://github.com/badinkajink/hand/blob/5758108aff0bf0ec1a08375660b5342412117a12/docs/overviews/printed_fingertips.html)
115. 2026-10-18 · INDEX rows for the calibration and DIP pages (artifacts pending); home page and page index rebuilt; the fingertip overview links the DIP, calibration, … · 0e6c03add (https://github.com/badinkajink/hand/commit/0e6c03add46db53941f1e9514f764f63879ca128) page (https://github.com/badinkajink/hand/blob/0e6c03add46db53941f1e9514f764f63879ca128/docs/overviews/printed_fingertips.html)
116. 2026-10-18 · Curved-tips page on claude.ai: artifact BtW5dLwyChxGWv6z867yvT in artifact_url.txt and INDEX row 25; fingertip and contact overviews rebuilt with the link and … · b1bc7d365 (https://github.com/badinkajink/hand/commit/b1bc7d365d9a95261336e07700c8c35cc244a0e1) page (https://github.com/badinkajink/hand/blob/b1bc7d365d9a95261336e07700c8c35cc244a0e1/docs/overviews/printed_fingertips.html)
117. 2026-10-16 · Fingertip readiness page on claude.ai: artifact NnKzSbLdAdBaJCVxeGMDji in artifact_url.txt and the INDEX row; fingertip and contact overviews and the page … · 84a30832e (https://github.com/badinkajink/hand/commit/84a30832ef15298402893253504cbcc2a372c858) page (https://github.com/badinkajink/hand/blob/84a30832ef15298402893253504cbcc2a372c858/docs/overviews/printed_fingertips.html)
118. 2026-10-16 · Fingertip readiness page, INDEX row, overview links and the 13 CAD-hand variant scenes · 3b16e1ca7 (https://github.com/badinkajink/hand/commit/3b16e1ca74b7068f920297298bcf37aa4b55309f) page (https://github.com/badinkajink/hand/blob/3b16e1ca74b7068f920297298bcf37aa4b55309f/docs/overviews/printed_fingertips.html)
119. 2026-10-15 · Curved tips result page; INDEX row; links from the printed-fingertip and contact overviews · 1349aff41 (https://github.com/badinkajink/hand/commit/1349aff41e284493ca37d4562a11cf22c390e2ec) page (https://github.com/badinkajink/hand/blob/1349aff41e284493ca37d4562a11cf22c390e2ec/docs/overviews/printed_fingertips.html)
120. 2026-10-15 · Tip co-design result page published (artifact 4QPCGbgvaEQoswYCytJ1kJ); INDEX row; links from the printed-fingertip and contact overviews, both republished · c9c94d2bd (https://github.com/badinkajink/hand/commit/c9c94d2bdab1f97a090c41bd0df251be7ee03c1e) page (https://github.com/badinkajink/hand/blob/c9c94d2bdab1f97a090c41bd0df251be7ee03c1e/docs/overviews/printed_fingertips.html)
121. 2026-10-14 · Fingertip overview: films of the whole 20 % tip and the eFlesh tip; film label escaped for ffmpeg drawtext · a77e1f655 (https://github.com/badinkajink/hand/commit/a77e1f655e27ee079e23b44bd9176681fe531b4e) page (https://github.com/badinkajink/hand/blob/a77e1f655e27ee079e23b44bd9176681fe531b4e/docs/overviews/printed_fingertips.html)
122. 2026-10-14 · Docs: index of all result pages, printed-fingertip topic overview, overviews rebuilt with the missing pages; FE films of the whole tip queued · da06ee8f7 (https://github.com/badinkajink/hand/commit/da06ee8f7e41a6ed48a82de0fd0e1a73772df0fc) page (https://github.com/badinkajink/hand/blob/da06ee8f7e41a6ed48a82de0fd0e1a73772df0fc/docs/overviews/printed_fingertips.html)

### Reinforcement-learning policies

docs/overviews/rl_policies.html · 13 revisions, 2026-10-09 to 2026-10-22
Latest: 2026-10-22 · RL policies overview in plain prose: mean 29.9 to 16.2 words a sentence, over 30 words 44.9 to 2.0 % (plain-language pass of 2026-10-22; gate PASS with the …

Revisions, newest first

1. 2026-10-22 · RL policies overview in plain prose: mean 29.9 to 16.2 words a sentence, over 30 words 44.9 to 2.0 % (plain-language pass of 2026-10-22; gate PASS with the … · 5791e8071 (https://github.com/badinkajink/hand/commit/5791e8071fac33825f59e5110dc45fc89117260a) page (https://github.com/badinkajink/hand/blob/5791e8071fac33825f59e5110dc45fc89117260a/docs/overviews/rl_policies.html)
2. 2026-10-14 · Docs: index of all result pages, printed-fingertip topic overview, overviews rebuilt with the missing pages; FE films of the whole tip queued · da06ee8f7 (https://github.com/badinkajink/hand/commit/da06ee8f7e41a6ed48a82de0fd0e1a73772df0fc) page (https://github.com/badinkajink/hand/blob/da06ee8f7e41a6ed48a82de0fd0e1a73772df0fc/docs/overviews/rl_policies.html)
3. 2026-10-12 · Skin page and overviews: the servo-plant skin result · 45d657139 (https://github.com/badinkajink/hand/commit/45d657139142294209c6aca088026a1a7abb662d) page (https://github.com/badinkajink/hand/blob/45d657139142294209c6aca088026a1a7abb662d/docs/overviews/rl_policies.html)
4. 2026-10-12 · RL overview Figure 4: the two 60 M runs name their box fingertips and plant; run 2 holds the tool with no fingertip force · 33602d363 (https://github.com/badinkajink/hand/commit/33602d363eed34556496d4264d47bb8ec768ee51) page (https://github.com/badinkajink/hand/blob/33602d363eed34556496d4264d47bb8ec768ee51/docs/overviews/rl_policies.html)
5. 2026-10-12 · Sprung skin page: the skin moved out of the topic overviews (owner: compress it to the salient result and why it is not good) · 681d19521 (https://github.com/badinkajink/hand/commit/681d19521c20ea7aadf4637179bee711a989951a) page (https://github.com/badinkajink/hand/blob/681d19521c20ea7aadf4637179bee711a989951a/docs/overviews/rl_policies.html)
6. 2026-10-12 · RL policies overview: five films (one episode on the servo-limited plant, pads on the two plants, two D6 draws of one recipe, three-simulator replays on both … · 22f72d1a7 (https://github.com/badinkajink/hand/commit/22f72d1a7171eac93ce6ecd2e3c32c712090dec3) page (https://github.com/badinkajink/hand/blob/22f72d1a7171eac93ce6ecd2e3c32c712090dec3/docs/overviews/rl_policies.html)
7. 2026-10-12 · Page: reorientation policies with point-contact and pad fingertips on the servo-limited plant · 50724e056 (https://github.com/badinkajink/hand/commit/50724e056f73836c07494443aae1274c7da0d053) page (https://github.com/badinkajink/hand/blob/50724e056f73836c07494443aae1274c7da0d053/docs/overviews/rl_policies.html)
8. 2026-10-11 · RL policies overview: the 2026-09-19 policies hold 44-64 of 64 jittered rollouts on the plant they trained on and drop the tool on the scene's tool contact … · 2ab5509e0 (https://github.com/badinkajink/hand/commit/2ab5509e0976c2c5650a0668feb10c4ec88c85c5) page (https://github.com/badinkajink/hand/blob/2ab5509e0976c2c5650a0668feb10c4ec88c85c5/docs/overviews/rl_policies.html)
9. 2026-10-11 · Topic overviews: interactive data figures drawn from the source pages' rows (scripts/overview_figures.py, a FIGURES entry names its function with fn=): gait … · a599f40ad (https://github.com/badinkajink/hand/commit/a599f40ad96565193a0d283a67dca8e68552bc47) page (https://github.com/badinkajink/hand/blob/a599f40ad96565193a0d283a67dca8e68552bc47/docs/overviews/rl_policies.html)
10. 2026-10-10 · Overviews: background from the retired webpaper folded in before archiving it (owner direction of 2026-10-09 14:40; items of … · 640bcd2fd (https://github.com/badinkajink/hand/commit/640bcd2fd3fed247b01e8c355e8a493db5cffd4f) page (https://github.com/badinkajink/hand/blob/640bcd2fd3fed247b01e8c355e8a493db5cffd4f/docs/overviews/rl_policies.html)
11. 2026-10-10 · Four page titles set to their INDEX subjects (turn mechanism: 'Reorientation mechanism on the shipped, calibrated and bench plants', subject rewritten without … · c6519db37 (https://github.com/badinkajink/hand/commit/c6519db37b658269581f94e55405a9349e219a68) page (https://github.com/badinkajink/hand/blob/c6519db37b658269581f94e55405a9349e219a68/docs/overviews/rl_policies.html)
12. 2026-10-09 · Eleven August pages retitled with descriptive noun phrases (The Seam and the Seat, Never Letting Go, A Spring, a Cone, and a Cliff, Tape Measure and Two Tags, … · 9114d35d6 (https://github.com/badinkajink/hand/commit/9114d35d6162b85f271cd1354b11ad68b7795a0a) page (https://github.com/badinkajink/hand/blob/9114d35d6162b85f271cd1354b11ad68b7795a0a/docs/overviews/rl_policies.html)
13. 2026-10-09 · Topic overview docs/overviews/rl_policies.html: policy structure and training cost, the three servo plants, seed draws and evaluation under jitter, fingertip … · 7e4728fe9 (https://github.com/badinkajink/hand/commit/7e4728fe970e5e726730816b32ad3ed3af4dfac8) page (https://github.com/badinkajink/hand/blob/7e4728fe970e5e726730816b32ad3ed3af4dfac8/docs/overviews/rl_policies.html)

### Reorientation mechanisms

docs/overviews/reorientation.html · 17 revisions, 2026-10-09 to 2026-11-10
Latest: 2026-11-10 · The SR2 pin-push with an unsensed pusher: contact point within 0.22 mm, force within 0.25 N of 0.45 N (post-reset step 14)

Revisions, newest first

1. 2026-11-10 · The SR2 pin-push with an unsensed pusher: contact point within 0.22 mm, force within 0.25 N of 0.45 N (post-reset step 14) · e0c123fe0 (https://github.com/badinkajink/hand/commit/e0c123fe00160b67f6b91a7bb1d7d6e3384aed54) page (https://github.com/badinkajink/hand/blob/e0c123fe00160b67f6b91a7bb1d7d6e3384aed54/docs/overviews/reorientation.html)
2. 2026-11-10 · Inverse-dynamics torque control of the SR2 fingers under HOM against the SCS0009 position servos (post-reset step 9) · 6175313c1 (https://github.com/badinkajink/hand/commit/6175313c118935876e1dc2b81028c44c2312a8ac) page (https://github.com/badinkajink/hand/blob/6175313c118935876e1dc2b81028c44c2312a8ac/docs/overviews/reorientation.html)
3. 2026-11-06 · HOM review page: Eq. (1) and the adjoint drawn, the contact filter explained and run on UR5 rolls · 283c6b482 (https://github.com/badinkajink/hand/commit/283c6b48254fda2d76d2e068547a485085afa079) page (https://github.com/badinkajink/hand/blob/283c6b48254fda2d76d2e068547a485085afa079/docs/overviews/reorientation.html)
4. 2026-10-30 · HOM controller code walkthrough (subpage of the HOM review page): eleven substeps of a 10 ms period on the v4b hand, with a twist and a pin-push · bdd55c247 (https://github.com/badinkajink/hand/commit/bdd55c247dc9958b7f2d72df3422027addcda1d0) page (https://github.com/badinkajink/hand/blob/bdd55c247dc9958b7f2d72df3422027addcda1d0/docs/overviews/reorientation.html)
5. 2026-10-29 · Design page: four HOM tasks and sensing errors across 4,680 Sobol layouts on the GPU · c39d07868 (https://github.com/badinkajink/hand/commit/c39d07868ecebf08d0cbb98f0f7afd4bc8b17d17) page (https://github.com/badinkajink/hand/blob/c39d07868ecebf08d0cbb98f0f7afd4bc8b17d17/docs/overviews/reorientation.html)
6. 2026-10-29 · Review pages of the HOM and foundational-pose papers, with fingertip-sensing and layout-sampling toys · 66330a72c (https://github.com/badinkajink/hand/commit/66330a72c9f4a608ac9f6a78e09793b1c8365c97) page (https://github.com/badinkajink/hand/blob/66330a72c9f4a608ac9f6a78e09793b1c8365c97/docs/overviews/reorientation.html)
7. 2026-10-22 · Reorientation mechanisms overview in plain prose: mean 25.3 to 16.9 words a sentence, over 30 words 32.7 to 1.3 % (plain-language pass of 2026-10-22; gate PASS … · ea8f034a0 (https://github.com/badinkajink/hand/commit/ea8f034a09c6df570577ccde4f6611799eae830d) page (https://github.com/badinkajink/hand/blob/ea8f034a09c6df570577ccde4f6611799eae830d/docs/overviews/reorientation.html)
8. 2026-10-14 · Docs: index of all result pages, printed-fingertip topic overview, overviews rebuilt with the missing pages; FE films of the whole tip queued · da06ee8f7 (https://github.com/badinkajink/hand/commit/da06ee8f7e41a6ed48a82de0fd0e1a73772df0fc) page (https://github.com/badinkajink/hand/blob/da06ee8f7e41a6ed48a82de0fd0e1a73772df0fc/docs/overviews/reorientation.html)
9. 2026-10-11 · Contact overview Figure 10 (GPU throughput against parallel worlds) is an interactive figure on log axes with the cost per world-step in the readout; … · cadb7b569 (https://github.com/badinkajink/hand/commit/cadb7b56989b411cdf54cbde7a4f059b13fbde88) page (https://github.com/badinkajink/hand/blob/cadb7b56989b411cdf54cbde7a4f059b13fbde88/docs/overviews/reorientation.html)
10. 2026-10-11 · Morphology overview: best-cell held cosine against the thumb's and the grip's torque capacity as an interactive scatter from table.json (Spearman +0.44 and … · ac0563468 (https://github.com/badinkajink/hand/commit/ac0563468bfc16a6104fd4f259c9a81bd5231416) page (https://github.com/badinkajink/hand/blob/ac0563468bfc16a6104fd4f259c9a81bd5231416/docs/overviews/reorientation.html)
11. 2026-10-11 · Topic overviews: interactive data figures drawn from the source pages' rows (scripts/overview_figures.py, a FIGURES entry names its function with fn=): gait … · a599f40ad (https://github.com/badinkajink/hand/commit/a599f40ad96565193a0d283a67dca8e68552bc47) page (https://github.com/badinkajink/hand/blob/a599f40ad96565193a0d283a67dca8e68552bc47/docs/overviews/reorientation.html)
12. 2026-10-10 · Overviews: background from the retired webpaper folded in before archiving it (owner direction of 2026-10-09 14:40; items of … · 640bcd2fd (https://github.com/badinkajink/hand/commit/640bcd2fd3fed247b01e8c355e8a493db5cffd4f) page (https://github.com/badinkajink/hand/blob/640bcd2fd3fed247b01e8c355e8a493db5cffd4f/docs/overviews/reorientation.html)
13. 2026-10-10 · Four page titles set to their INDEX subjects (turn mechanism: 'Reorientation mechanism on the shipped, calibrated and bench plants', subject rewritten without … · c6519db37 (https://github.com/badinkajink/hand/commit/c6519db37b658269581f94e55405a9349e219a68) page (https://github.com/badinkajink/hand/blob/c6519db37b658269581f94e55405a9349e219a68/docs/overviews/reorientation.html)
14. 2026-10-09 · Eleven August pages retitled with descriptive noun phrases (The Seam and the Seat, Never Letting Go, A Spring, a Cone, and a Cliff, Tape Measure and Two Tags, … · 9114d35d6 (https://github.com/badinkajink/hand/commit/9114d35d6162b85f271cd1354b11ad68b7795a0a) page (https://github.com/badinkajink/hand/blob/9114d35d6162b85f271cd1354b11ad68b7795a0a/docs/overviews/reorientation.html)
15. 2026-10-09 · Figure check measures charts in the page's own layout (grids of small charts included); retro_style stacks two-up chart grids (.duo, .pair, .two, .grid2, … · 817d46977 (https://github.com/badinkajink/hand/commit/817d469776605f843011a852683d6dce30451fd8) page (https://github.com/badinkajink/hand/blob/817d469776605f843011a852683d6dce30451fd8/docs/overviews/reorientation.html)
16. 2026-10-09 · retro_style: identifier chips (.m), kbd and samp in plain monospace with no background; the template's chip colour rendered them as black boxes in the plain … · 4bce80097 (https://github.com/badinkajink/hand/commit/4bce800970e454f2d3a80bd570d519b1900fa4da) page (https://github.com/badinkajink/hand/blob/4bce800970e454f2d3a80bd570d519b1900fa4da/docs/overviews/reorientation.html)
17. 2026-10-09 · Topic overview docs/overviews/reorientation.html (scripts/topic_overview_page.py + overview_mechanisms_text.py): the fixed-contact turn and its extension cost, … · 926d2d7d3 (https://github.com/badinkajink/hand/commit/926d2d7d3d01502899100410a20e84251a106b48) page (https://github.com/badinkajink/hand/blob/926d2d7d3d01502899100410a20e84251a106b48/docs/overviews/reorientation.html)

### Sphere-packed fingertip contact

docs/overviews/contact_model.html · 45 revisions, 2026-10-09 to 2026-11-11 · 4 earlier dated files
Latest: 2026-11-11 · Contact overview: link to the sphere-pad implementation page from the section on sphere pads; rebuilt (script paths now in the topic folders, no number …

Revisions, newest first

1. 2026-11-11 · Contact overview: link to the sphere-pad implementation page from the section on sphere pads; rebuilt (script paths now in the topic folders, no number … · c7599611d (https://github.com/badinkajink/hand/commit/c7599611d13beca302243c04661b5cd7785446db) page (https://github.com/badinkajink/hand/blob/c7599611d13beca302243c04661b5cd7785446db/docs/overviews/contact_model.html)
2. 2026-11-02 · Revisions page of the documentation: every page's commits with links to its older versions on GitHub · 484cc151a (https://github.com/badinkajink/hand/commit/484cc151ad3c941b238a58a96b96fe00445eb97d) page (https://github.com/badinkajink/hand/blob/484cc151ad3c941b238a58a96b96fe00445eb97d/docs/overviews/contact_model.html)
3. 2026-10-31 · Contact pages read for a newcomer: the v3 page says why a softer pad needs a longer time constant, what the regulariser is, and which centroid the scenes' … · bbae93013 (https://github.com/badinkajink/hand/commit/bbae93013a5acb1c63aca212ff2c9dc60a4fb690) page (https://github.com/badinkajink/hand/blob/bbae93013a5acb1c63aca212ff2c9dc60a4fb690/docs/overviews/contact_model.html)
4. 2026-10-30 · Pad modulus 2.5 MPa in the scenes (owner, 10-30 18:3x: "seems like we should change the modulus to match the real setting"), fitted to the UR5 presses of the … · 698d3f654 (https://github.com/badinkajink/hand/commit/698d3f654e5ef94f73b693929d5dbdd1b50f5346) page (https://github.com/badinkajink/hand/blob/698d3f654e5ef94f73b693929d5dbdd1b50f5346/docs/overviews/contact_model.html)
5. 2026-10-30 · Contact models of the four-magnet v3 fingertips fitted to the UR5 presses (owner, 10-30: one modulus, forces before indentation, contact area and pose). Over … · 45a0590fb (https://github.com/badinkajink/hand/commit/45a0590fbed9bc7d6b65af7855152b02d682038a) page (https://github.com/badinkajink/hand/blob/45a0590fbed9bc7d6b65af7855152b02d682038a/docs/overviews/contact_model.html)
6. 2026-10-27 · Contact overview, first part: calibration table, the friction torque's status, creep under the grasp's own forces and the impratio sweep (hand-off 20261027, … · ecf6e7495 (https://github.com/badinkajink/hand/commit/ecf6e7495c6a782b440eacd4525f9b5bfbb19490) page (https://github.com/badinkajink/hand/blob/ecf6e7495c6a782b440eacd4525f9b5bfbb19490/docs/overviews/contact_model.html)
7. 2026-10-26 · Shear page and contact overview at the friction coefficient from the shear's magnitude (hand-off 20261026-shear_friction_impratio, step 5). The skin replays of … · 8d99dd5f3 (https://github.com/badinkajink/hand/commit/8d99dd5f383eb0ed6d2b9e045194ba196817ff59) page (https://github.com/badinkajink/hand/blob/8d99dd5f383eb0ed6d2b9e045194ba196817ff59/docs/overviews/contact_model.html)
8. 2026-10-26 · Friction coefficient of the printed fingertip from the magnitude of the shear at slip, and the contact overview's first part on the UR5 shear results (hand-off … · 6f645eaf0 (https://github.com/badinkajink/hand/commit/6f645eaf0b9ca8b31f902ee3a2e090be4db131e9) page (https://github.com/badinkajink/hand/blob/6f645eaf0b9ca8b31f902ee3a2e090be4db131e9/docs/overviews/contact_model.html)
9. 2026-10-26 · Contact overview, first part, after the owner's direction of 2026-10-26 14:25 (the UR5 data are the ground truth; model them as well as the computation allows; … · a0edd1bf9 (https://github.com/badinkajink/hand/commit/a0edd1bf9ffd1dacc7e7935968fd2bc8939048a6) page (https://github.com/badinkajink/hand/blob/a0edd1bf9ffd1dacc7e7935968fd2bc8939048a6/docs/overviews/contact_model.html)
10. 2026-10-26 · Contact overview opens with the chain from the printed fingertip to the simulated contact (owner, 2026-10-26: the overview as the link from the real tip … · 1ee8985c6 (https://github.com/badinkajink/hand/commit/1ee8985c68ef688516e4bfc50c51a3689e1e8103) page (https://github.com/badinkajink/hand/blob/1ee8985c68ef688516e4bfc50c51a3689e1e8103/docs/overviews/contact_model.html)
11. 2026-10-23 · Explain contact torque and printed fingertip sensing before detailed results · 9ef34f3e3 (https://github.com/badinkajink/hand/commit/9ef34f3e3845b77bbbb82900c779007906344585) page (https://github.com/badinkajink/hand/blob/9ef34f3e3845b77bbbb82900c779007906344585/docs/overviews/contact_model.html)
12. 2026-10-23 · Contact overview: a section on the calibration of the pads to the FE model and to the UR5 presses (owner, 10-23: the contact overview owns the sphere pads' … · 69a71b61a (https://github.com/badinkajink/hand/commit/69a71b61ac0283705a5622f68fb91c65209ce23c) page (https://github.com/badinkajink/hand/blob/69a71b61ac0283705a5622f68fb91c65209ce23c/docs/overviews/contact_model.html)
13. 2026-10-22 · Contact overview: plain-language pass under the elements of style (owner, 2026-10-22: "i bounce off like rubber because of how dense it is"). Each derivation … · 2c763cf62 (https://github.com/badinkajink/hand/commit/2c763cf62eb6672afb19b53396bd1ae121d9efb4) page (https://github.com/badinkajink/hand/blob/2c763cf62eb6672afb19b53396bd1ae121d9efb4/docs/overviews/contact_model.html)
14. 2026-10-18 · Artifacts for the DIP, calibration and status pages (artifact_url.txt, INDEX rows); home page, page index, fingertip and contact overviews republished, each … · 5758108af (https://github.com/badinkajink/hand/commit/5758108aff0bf0ec1a08375660b5342412117a12) page (https://github.com/badinkajink/hand/blob/5758108aff0bf0ec1a08375660b5342412117a12/docs/overviews/contact_model.html)
15. 2026-10-18 · INDEX rows for the calibration and DIP pages (artifacts pending); home page and page index rebuilt; the fingertip overview links the DIP, calibration, … · 0e6c03add (https://github.com/badinkajink/hand/commit/0e6c03add46db53941f1e9514f764f63879ca128) page (https://github.com/badinkajink/hand/blob/0e6c03add46db53941f1e9514f764f63879ca128/docs/overviews/contact_model.html)
16. 2026-10-18 · Curved-tips page on claude.ai: artifact BtW5dLwyChxGWv6z867yvT in artifact_url.txt and INDEX row 25; fingertip and contact overviews rebuilt with the link and … · b1bc7d365 (https://github.com/badinkajink/hand/commit/b1bc7d365d9a95261336e07700c8c35cc244a0e1) page (https://github.com/badinkajink/hand/blob/b1bc7d365d9a95261336e07700c8c35cc244a0e1/docs/overviews/contact_model.html)
17. 2026-10-16 · Fingertip readiness page on claude.ai: artifact NnKzSbLdAdBaJCVxeGMDji in artifact_url.txt and the INDEX row; fingertip and contact overviews and the page … · 84a30832e (https://github.com/badinkajink/hand/commit/84a30832ef15298402893253504cbcc2a372c858) page (https://github.com/badinkajink/hand/blob/84a30832ef15298402893253504cbcc2a372c858/docs/overviews/contact_model.html)
18. 2026-10-16 · Fingertip readiness page, INDEX row, overview links and the 13 CAD-hand variant scenes · 3b16e1ca7 (https://github.com/badinkajink/hand/commit/3b16e1ca74b7068f920297298bcf37aa4b55309f) page (https://github.com/badinkajink/hand/blob/3b16e1ca74b7068f920297298bcf37aa4b55309f/docs/overviews/contact_model.html)
19. 2026-10-15 · Curved tips result page; INDEX row; links from the printed-fingertip and contact overviews · 1349aff41 (https://github.com/badinkajink/hand/commit/1349aff41e284493ca37d4562a11cf22c390e2ec) page (https://github.com/badinkajink/hand/blob/1349aff41e284493ca37d4562a11cf22c390e2ec/docs/overviews/contact_model.html)
20. 2026-10-15 · Builder v2 against v1 and Drake at trajectory level on D1-D8: v2 is closer in tool orientation on every tip and task · 685d1744f (https://github.com/badinkajink/hand/commit/685d1744fc36bfb31900edcfb625ff14a2412b37) page (https://github.com/badinkajink/hand/blob/685d1744fc36bfb31900edcfb625ff14a2412b37/docs/overviews/contact_model.html)
21. 2026-10-15 · Owner's pipeline direction on the pad page and the contact overview: training, planning and evaluation use the same 1 mm pads, builder and contact numerics · fd0b6a3e4 (https://github.com/badinkajink/hand/commit/fd0b6a3e4dabb7b4a9b658e302aa76f2d34e6793) page (https://github.com/badinkajink/hand/blob/fd0b6a3e4dabb7b4a9b658e302aa76f2d34e6793/docs/overviews/contact_model.html)
22. 2026-10-15 · Pad-usability page: U2 figures numbered in page order (charts 4-5, films 6-7); contact overview's skin Future-work item cites Figure 14b · 34cc3577e (https://github.com/badinkajink/hand/commit/34cc3577edd2ea54527e84c8478a95fadb86dabc) page (https://github.com/badinkajink/hand/blob/34cc3577edd2ea54527e84c8478a95fadb86dabc/docs/overviews/contact_model.html)
23. 2026-10-15 · Tip co-design result page published (artifact 4QPCGbgvaEQoswYCytJ1kJ); INDEX row; links from the printed-fingertip and contact overviews, both republished · c9c94d2bd (https://github.com/badinkajink/hand/commit/c9c94d2bdab1f97a090c41bd0df251be7ee03c1e) page (https://github.com/badinkajink/hand/blob/c9c94d2bdab1f97a090c41bd0df251be7ee03c1e/docs/overviews/contact_model.html)
24. 2026-10-15 · Pad-usability page published; contact overview rebuilt with its link and republished · a6ddf936b (https://github.com/badinkajink/hand/commit/a6ddf936b5910ed7e817fff0347b9ac87100ffbc) page (https://github.com/badinkajink/hand/blob/a6ddf936b5910ed7e817fff0347b9ac87100ffbc/docs/overviews/contact_model.html)
25. 2026-10-14 · U4 complete (friction 0.7: 2 of 8 three-finger endings); result page and overview rebuilt; publish note for the personal login · 0915aa80c (https://github.com/badinkajink/hand/commit/0915aa80cd6ebd54c34c496c67dde8a75f259dcb) page (https://github.com/badinkajink/hand/blob/0915aa80cd6ebd54c34c496c67dde8a75f259dcb/docs/overviews/contact_model.html)
26. 2026-10-14 · Pad-usability page: U4 section, lede with the planner and RL decisions, planner-friction item; figures at 15 pt; overview's U4 sentence from the 16 pairs · bf2e0d452 (https://github.com/badinkajink/hand/commit/bf2e0d452ad5a0eecb21fddec14f66a9c614e65f) page (https://github.com/badinkajink/hand/blob/bf2e0d452ad5a0eecb21fddec14f66a9c614e65f/docs/overviews/contact_model.html)
27. 2026-10-14 · Contact overview: U1-U5 paragraph and film (cost and control outcomes on the real_v1 hand), usability page in the related list; task 8 becomes Figure 14 · 9cc88e976 (https://github.com/badinkajink/hand/commit/9cc88e976f470395095e59d53e4846ec18778a10) page (https://github.com/badinkajink/hand/blob/9cc88e976f470395095e59d53e4846ec18778a10/docs/overviews/contact_model.html)
28. 2026-10-14 · Contact overview: review fixes to the lede, cost paragraphs, symbols and step 9 · 72984c507 (https://github.com/badinkajink/hand/commit/72984c507b884ea5afd20772d8729c526203a76f) page (https://github.com/badinkajink/hand/blob/72984c507b884ea5afd20772d8729c526203a76f/docs/overviews/contact_model.html)
29. 2026-10-14 · Contact overview: usability lede, deck-23 derivations, printed TPU block table, hand and RL cost table, corrected step bound · 7202fa5cd (https://github.com/badinkajink/hand/commit/7202fa5cdf799c36ca24edd9035764760dd34dbb) page (https://github.com/badinkajink/hand/blob/7202fa5cdf799c36ca24edd9035764760dd34dbb/docs/overviews/contact_model.html)
30. 2026-10-14 · Readout and fingertip pages: close the body tag so Live Server stops truncating them; same fix on 42 other pages · 08fe6d3bb (https://github.com/badinkajink/hand/commit/08fe6d3bb248b2a3103ee7e411cf6c2c9c44ae45) page (https://github.com/badinkajink/hand/blob/08fe6d3bb248b2a3103ee7e411cf6c2c9c44ae45/docs/overviews/contact_model.html)
31. 2026-10-14 · Docs: index of all result pages, printed-fingertip topic overview, overviews rebuilt with the missing pages; FE films of the whole tip queued · da06ee8f7 (https://github.com/badinkajink/hand/commit/da06ee8f7e41a6ed48a82de0fd0e1a73772df0fc) page (https://github.com/badinkajink/hand/blob/da06ee8f7e41a6ed48a82de0fd0e1a73772df0fc/docs/overviews/contact_model.html)
32. 2026-10-12 · Skin page and overviews: the servo-plant skin result · 45d657139 (https://github.com/badinkajink/hand/commit/45d657139142294209c6aca088026a1a7abb662d) page (https://github.com/badinkajink/hand/blob/45d657139142294209c6aca088026a1a7abb662d/docs/overviews/contact_model.html)
33. 2026-10-12 · Sprung skin page: the skin moved out of the topic overviews (owner: compress it to the salient result and why it is not good) · 681d19521 (https://github.com/badinkajink/hand/commit/681d19521c20ea7aadf4637179bee711a989951a) page (https://github.com/badinkajink/hand/blob/681d19521c20ea7aadf4637179bee711a989951a/docs/overviews/contact_model.html)
34. 2026-10-12 · Contact overview: the sprung skin at the policy trainer's impratio of 10 · 81e20730b (https://github.com/badinkajink/hand/commit/81e20730b23587851ce01169c001e9c451d72b14) page (https://github.com/badinkajink/hand/blob/81e20730b23587851ce01169c001e9c451d72b14/docs/overviews/contact_model.html)
35. 2026-10-12 · Contact overview: skin section corrected against the deck 23 math pass · e9ef77307 (https://github.com/badinkajink/hand/commit/e9ef77307595701229464fdf4b7bee8554e0da06) page (https://github.com/badinkajink/hand/blob/e9ef77307595701229464fdf4b7bee8554e0da06/docs/overviews/contact_model.html)
36. 2026-10-12 · Contact overview: section on presliding compliance with a sprung skin (steps 11-12, Figures 13-16, Table 3); skin and bristle rows in Table 1 · cff1db4fb (https://github.com/badinkajink/hand/commit/cff1db4fb4ee731e8a203d10cfaf317bdad2f4fa) page (https://github.com/badinkajink/hand/blob/cff1db4fb4ee731e8a203d10cfaf317bdad2f4fa/docs/overviews/contact_model.html)
37. 2026-10-12 · Page: reorientation policies with point-contact and pad fingertips on the servo-limited plant · 50724e056 (https://github.com/badinkajink/hand/commit/50724e056f73836c07494443aae1274c7da0d053) page (https://github.com/badinkajink/hand/blob/50724e056f73836c07494443aae1274c7da0d053/docs/overviews/contact_model.html)
38. 2026-10-11 · Contact overview: Figure 8 (tool angle and wall time against the physics step, log step axis, diverged runs as open markers) is interactive; Figure 10 gains … · b95034792 (https://github.com/badinkajink/hand/commit/b95034792b62b92573daff51b7c3be4aca1e597a) page (https://github.com/badinkajink/hand/blob/b95034792b62b92573daff51b7c3be4aca1e597a/docs/overviews/contact_model.html)
39. 2026-10-11 · Contact overview Figure 10 (GPU throughput against parallel worlds) is an interactive figure on log axes with the cost per world-step in the readout; … · cadb7b569 (https://github.com/badinkajink/hand/commit/cadb7b56989b411cdf54cbde7a4f059b13fbde88) page (https://github.com/badinkajink/hand/blob/cadb7b56989b411cdf54cbde7a4f059b13fbde88/docs/overviews/contact_model.html)
40. 2026-10-11 · Artifact links of the three HOM pages updated to their new artifacts (hom_chain RN5kgsnDiKyuVSZYWrQexs in the contact overview, hom_hand_brake … · 7fc6855ea (https://github.com/badinkajink/hand/commit/7fc6855ea6922aa3b5e186de8c08f30d32b20c20) page (https://github.com/badinkajink/hand/blob/7fc6855ea6922aa3b5e186de8c08f30d32b20c20/docs/overviews/contact_model.html)
41. 2026-10-10 · Overviews: background from the retired webpaper folded in before archiving it (owner direction of 2026-10-09 14:40; items of … · 640bcd2fd (https://github.com/badinkajink/hand/commit/640bcd2fd3fed247b01e8c355e8a493db5cffd4f) page (https://github.com/badinkajink/hand/blob/640bcd2fd3fed247b01e8c355e8a493db5cffd4f/docs/overviews/contact_model.html)
42. 2026-10-10 · Contact overview (docs/overviews/contact_model.html): the five prose_lint flags rewritten, approved text otherwise unchanged ('not only of the pads' dropped … · 84bfa45d8 (https://github.com/badinkajink/hand/commit/84bfa45d8b8aa4cbe0a8651498c100a17bd2c187) page (https://github.com/badinkajink/hand/blob/84bfa45d8b8aa4cbe0a8651498c100a17bd2c187/docs/overviews/contact_model.html)
43. 2026-10-09 · Sentence case for multi-word table cells (retro_style; single words, identifiers, code and symbols stay as written), applied to 43 pages; turn3 page: Future … · 6c5cd618b (https://github.com/badinkajink/hand/commit/6c5cd618be6112f34a30ff9adc86dedb6d50a786) page (https://github.com/badinkajink/hand/blob/6c5cd618be6112f34a30ff9adc86dedb6d50a786/docs/overviews/contact_model.html)
44. 2026-10-09 · Eleven August pages retitled with descriptive noun phrases (The Seam and the Seat, Never Letting Go, A Spring, a Cone, and a Cliff, Tape Measure and Two Tags, … · 9114d35d6 (https://github.com/badinkajink/hand/commit/9114d35d6162b85f271cd1354b11ad68b7795a0a) page (https://github.com/badinkajink/hand/blob/9114d35d6162b85f271cd1354b11ad68b7795a0a/docs/overviews/contact_model.html)
45. 2026-10-09 · Contact overview at its stable name docs/overviews/contact_model.html (owner, 2026-10-09): contact_overview_page.py writes there, its eyebrow links the home … · 42e41ba9f (https://github.com/badinkajink/hand/commit/42e41ba9f7d7a455bcc4ede2ccc3906ece81fa52) page (https://github.com/badinkajink/hand/blob/42e41ba9f7d7a455bcc4ede2ccc3906ece81fa52/docs/overviews/contact_model.html)

Before the page had a stable name, each revision was a dated file:

1. 2026-10-09 · Policies trained on four fingertip contact models; the plain page style. · dated file
2. 2026-10-08 · Native-compliance candidates, the Newton hydroelastic tests and the hand-object scale study. · dated file
3. 2026-10-07 · Agreement of the pads with Drake across MuJoCo, MuJoCo-Warp and Newton; effective mass; the cost on one RL state. · dated file
4. 2026-10-05 · First revision: the sphere-packed pad model of the printed fingertip. · dated file

## Result pages, newest first

### Tracked objects, tag blocks and calibration board for the SR2 hand on the UR5

docs/experiments/20261113-tracking_prints/20261113-tracking_prints_and_calibration_board.html · 7 revisions, 2026-11-13 to 2026-11-13
Latest: 2026-11-13 · Objects' Bambu projects: each object's filament written on the object, black on filament 1 and white on 2 (owner, 2026-11-13: "please have the blocks use the …

Revisions, newest first

1. 2026-11-13 · Objects' Bambu projects: each object's filament written on the object, black on filament 1 and white on 2 (owner, 2026-11-13: "please have the blocks use the … · 4940a1be4 (https://github.com/badinkajink/hand/commit/4940a1be4aafaab45180a37e2a86da8c3807c84f) page (https://github.com/badinkajink/hand/blob/4940a1be4aafaab45180a37e2a86da8c3807c84f/docs/experiments/20261113-tracking_prints/20261113-tracking_prints_and_calib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)
2. 2026-11-13 · Hex block map from both D435s: pose.bundle_adjust_multi, 35 views of the 11-07 test block, and section 6 of the calibration page (lab session on corvus, … · a1e231000 (https://github.com/badinkajink/hand/commit/a1e231000ebbbae6e013d2121c3516ada653fd90) page (https://github.com/badinkajink/hand/blob/a1e231000ebbbae6e013d2121c3516ada653fd90/docs/experiments/20261113-tracking_prints/20261113-tracking_prints_and_calib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)
3. 2026-11-13 · Tracked cylinder printed without end tags (owner, 2026-11-13: "i sent the print with no cylinder end tag") · 18062efdc (https://github.com/badinkajink/hand/commit/18062efdc0578ca90b8b40f02fd4b84f7551a152) page (https://github.com/badinkajink/hand/blob/18062efdc0578ca90b8b40f02fd4b84f7551a152/docs/experiments/20261113-tracking_prints/20261113-tracking_prints_and_calib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)
4. 2026-11-13 · Tracking plan and tracking-prints page: pointer to the lens and arm calibration of 2026-11-13 · 9adcbdc2e (https://github.com/badinkajink/hand/commit/9adcbdc2e2153f3e8c20d128473c686a9d721254) page (https://github.com/badinkajink/hand/blob/9adcbdc2e2153f3e8c20d128473c686a9d721254/docs/experiments/20261113-tracking_prints/20261113-tracking_prints_and_calib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)
5. 2026-11-13 · Tracked cylinder with end tag 23 only and without end tags, as alternatives (owner, 2026-11-13: the end tags "cause a lot of pla usage") · ab5073f0c (https://github.com/badinkajink/hand/commit/ab5073f0c46faa2da6df9d7f0ea49a964421a955) page (https://github.com/badinkajink/hand/blob/ab5073f0c46faa2da6df9d7f0ea49a964421a955/docs/experiments/20261113-tracking_prints/20261113-tracking_prints_and_calib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)
6. 2026-11-13 · Paper calibration boards for the owner's 140 x 130 mm back (ChArUco 7 x 7 of 15 mm and checkerboard 9 x 8 of 12 mm, Letter PDF at actual size, 36 of 36 corners … · 9a6322eb6 (https://github.com/badinkajink/hand/commit/9a6322eb65d9feaf4c753287cc64f847d9e07b73) page (https://github.com/badinkajink/hand/blob/9a6322eb65d9feaf4c753287cc64f847d9e07b73/docs/experiments/20261113-tracking_prints/20261113-tracking_prints_and_calib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)
7. 2026-11-13 · Page of the tracking prints and the calibration board: renders, joint sections, two MuJoCo viewers and links to every STL and Bambu project; on the mount's … · 5013467be (https://github.com/badinkajink/hand/commit/5013467bec283030c3b1fd3ba636eb4137a69cb8) page (https://github.com/badinkajink/hand/blob/5013467bec283030c3b1fd3ba636eb4137a69cb8/docs/experiments/20261113-tracking_prints/20261113-tracking_prints_and_calib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)

### Throughput of the two-camera tag tracker on corvus and the controller link

docs/experiments/20261113-tag_tracking_throughput/20261113-tag_tracking_throughput.html · 1 revision, 2026-11-13 to 2026-11-13 · 583f85b0f (https://github.com/badinkajink/hand/commit/583f85b0f9f5bd442d0eac22573106f19c2583ba) page (https://github.com/badinkajink/hand/blob/583f85b0f9f5bd442d0eac22573106f19c2583ba/docs/experiments/20261113-tag_tracking_throughput/20261113-tag_tracking_thro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)

### Lens and arm calibration of the two D435 tracking cameras on the UR5

docs/experiments/20261113-camera_arm_calibration/20261113-camera_arm_calibration.html · 4 revisions, 2026-11-13 to 2026-11-13
Latest: 2026-11-13 · Calibration page v5: camera 836612071918 moved at about 16:00 and its pose re-solved against the fixed camera (lab session on corvus, 2026-11-13)

Revisions, newest first

1. 2026-11-13 · Calibration page v5: camera 836612071918 moved at about 16:00 and its pose re-solved against the fixed camera (lab session on corvus, 2026-11-13) · 8837c5d37 (https://github.com/badinkajink/hand/commit/8837c5d37801440517d9383a10195b86f71e9769) page (https://github.com/badinkajink/hand/blob/8837c5d37801440517d9383a10195b86f71e9769/docs/experiments/20261113-camera_arm_calibration/20261113-camera_arm_calibra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)
2. 2026-11-13 · Hex block map from both D435s: pose.bundle_adjust_multi, 35 views of the 11-07 test block, and section 6 of the calibration page (lab session on corvus, … · a1e231000 (https://github.com/badinkajink/hand/commit/a1e231000ebbbae6e013d2121c3516ada653fd90) page (https://github.com/badinkajink/hand/blob/a1e231000ebbbae6e013d2121c3516ada653fd90/docs/experiments/20261113-camera_arm_calibration/20261113-camera_arm_calibra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)
3. 2026-11-13 · Calibration page revised after the owner's notes (lab session on corvus, 2026-11-13 about 14:5x) · 0953ff43f (https://github.com/badinkajink/hand/commit/0953ff43f90d7f791f9283168c02fe0f241b4f31) page (https://github.com/badinkajink/hand/blob/0953ff43f90d7f791f9283168c02fe0f241b4f31/docs/experiments/20261113-camera_arm_calibration/20261113-camera_arm_calibra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)
4. 2026-11-13 · Lens and arm calibration of the two D435 tracking cameras on the UR5: page, data, film and lab scripts of 2026-11-13 (built on corvus by the lab session, owner … · 90d753ca3 (https://github.com/badinkajink/hand/commit/90d753ca37bce004f1ced2e8b67ec2f710f740db) page (https://github.com/badinkajink/hand/blob/90d753ca37bce004f1ced2e8b67ec2f710f740db/docs/experiments/20261113-camera_arm_calibration/20261113-camera_arm_calibra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)

### Sampling MPC and HOM on the SR2 sphere twist

docs/experiments/20261112-inner_loop_benchmark/20261113-sampling_mpc_vs_hom.html · 3 revisions, 2026-11-13 to 2026-11-13
Latest: 2026-11-13 · HOM's measured pose through a complementary filter (hom_gpu.POSE_FILTER: prediction from the commanded angular velocity, delayed tracker frames corrected by …

Revisions, newest first

1. 2026-11-13 · HOM's measured pose through a complementary filter (hom_gpu.POSE_FILTER: prediction from the commanded angular velocity, delayed tracker frames corrected by … · bb8b61b24 (https://github.com/badinkajink/hand/commit/bb8b61b24290b05a6e2443066c21e3a148ba766b) page (https://github.com/badinkajink/hand/blob/bb8b61b24290b05a6e2443066c21e3a148ba766b/docs/experiments/20261112-inner_loop_benchmark/20261113-sampling_mpc_vs_hom.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)
2. 2026-11-13 · Sampling MPC page: HOM under the sensing variants (tag tracker, fingertip model, calibration errors), HOM's commanded pad force (2 N: J 0.415 against 0.388 at … · 0de23f89b (https://github.com/badinkajink/hand/commit/0de23f89bf23e2997026e333c39690d2a20ecfa3) page (https://github.com/badinkajink/hand/blob/0de23f89bf23e2997026e333c39690d2a20ecfa3/docs/experiments/20261112-inner_loop_benchmark/20261113-sampling_mpc_vs_hom.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)
3. 2026-11-13 · Sampling MPC and HOM on the SR2 sphere twist, on the SCS0009 plant: page with HOM, real-time predictive sampling, DIAL annealing, the point-contact planner, … · ef59860cb (https://github.com/badinkajink/hand/commit/ef59860cb53bf8f661a12b16399344487926d526) page (https://github.com/badinkajink/hand/blob/ef59860cb53bf8f661a12b16399344487926d526/docs/experiments/20261112-inner_loop_benchmark/20261113-sampling_mpc_vs_hom.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)

### Implementation of the sphere-pad contact model on a convex fingertip surface

docs/experiments/20261111-sphere_pad_implementation/20261111-sphere_pad_implementation.html · 1 revision, 2026-11-11 to 2026-11-11 · 12efa7226 (https://github.com/badinkajink/hand/commit/12efa72265235ec606665f8ec782adcd830ae1c1) page (https://github.com/badinkajink/hand/blob/12efa72265235ec606665f8ec782adcd830ae1c1/docs/experiments/20261111-sphere_pad_implementation/20261111-sphere_pad_impl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)

### Inverse-dynamics torque control of the SR2 hand's fingers under HOM

docs/experiments/20261110-hom_torque_control/20261110-hom_inverse_dynamics_control.html · 3 revisions, 2026-11-10 to 2026-11-10
Latest: 2026-11-10 · Torque control page: films of the position servos and the torque plant on a twist, a roll and a press (step 9)

Revisions, newest first

1. 2026-11-10 · Torque control page: films of the position servos and the torque plant on a twist, a roll and a press (step 9) · 2b0f8de21 (https://github.com/badinkajink/hand/commit/2b0f8de21e8c93da3820c3656ab9dbe7ec6c81f7) page (https://github.com/badinkajink/hand/blob/2b0f8de21e8c93da3820c3656ab9dbe7ec6c81f7/docs/experiments/20261110-hom_torque_control/20261110-hom_inverse_dynamics_c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)
2. 2026-11-10 · Torque control of the SR2 fingers at the STS3032's 0.515 N m limit: the 63 rad/s loop still loses pad contact (step 9) · 5ef4c5b3e (https://github.com/badinkajink/hand/commit/5ef4c5b3e7eea453db183f6356efeb7a374196c8) page (https://github.com/badinkajink/hand/blob/5ef4c5b3e7eea453db183f6356efeb7a374196c8/docs/experiments/20261110-hom_torque_control/20261110-hom_inverse_dynamics_c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)
3. 2026-11-10 · Inverse-dynamics torque control of the SR2 fingers under HOM against the SCS0009 position servos (post-reset step 9) · 6175313c1 (https://github.com/badinkajink/hand/commit/6175313c118935876e1dc2b81028c44c2312a8ac) page (https://github.com/badinkajink/hand/blob/6175313c118935876e1dc2b81028c44c2312a8ac/docs/experiments/20261110-hom_torque_control/20261110-hom_inverse_dynamics_c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)

### Contact estimation for the unsensed pusher of the SR2 hand's pin-push under HOM

docs/experiments/20261110-hom_pusher_estimate/20261110-hom_unsensed_pusher.html · 1 revision, 2026-11-10 to 2026-11-10 · e0c123fe0 (https://github.com/badinkajink/hand/commit/e0c123fe00160b67f6b91a7bb1d7d6e3384aed54) page (https://github.com/badinkajink/hand/blob/e0c123fe00160b67f6b91a7bb1d7d6e3384aed54/docs/experiments/20261110-hom_pusher_estimate/20261110-hom_unsensed_pusher.h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)

### Fingertip viewer replayed on a UR5 rod roll, with the finite-element and field model of the roll

docs/experiments/20261110-fingertip_viewer_roll/20261110-fingertip_viewer_on_a_ur5_roll.html · 3 revisions, 2026-11-10 to 2026-11-10
Latest: 2026-11-10 · Fingertip viewer page: the UR5's record of the roll replayed in the cell, the films' panels as synced films, and the real time-lapse of the same rod and tip

Revisions, newest first

1. 2026-11-10 · Fingertip viewer page: the UR5's record of the roll replayed in the cell, the films' panels as synced films, and the real time-lapse of the same rod and tip · ed86777f0 (https://github.com/badinkajink/hand/commit/ed86777f0a230d2f1579a8cd24eb61299dc72853) page (https://github.com/badinkajink/hand/blob/ed86777f0a230d2f1579a8cd24eb61299dc72853/docs/experiments/20261110-fingertip_viewer_roll/20261110-fingertip_viewer_on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)
2. 2026-11-10 · Fingertip viewer page: both roll films start at the press's level hold · 5c0661906 (https://github.com/badinkajink/hand/commit/5c06619062023f45df7ca9739a9d868b953ad9cc) page (https://github.com/badinkajink/hand/blob/5c06619062023f45df7ca9739a9d868b953ad9cc/docs/experiments/20261110-fingertip_viewer_roll/20261110-fingertip_viewer_on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)
3. 2026-11-10 · Fingertip viewer page: the viewer replayed on a UR5 rod roll of v3 ID 5, with an FE and field film of the roll · bfaf35e1e (https://github.com/badinkajink/hand/commit/bfaf35e1e11d517a7a4d152448bfc2307e11696b) page (https://github.com/badinkajink/hand/blob/bfaf35e1e11d517a7a4d152448bfc2307e11696b/docs/experiments/20261110-fingertip_viewer_roll/20261110-fingertip_viewer_on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)

### The co-design problem of the SR2 hand talk as one nested formula

docs/experiments/20261110-codesign_formulation/20261110-sr2_codesign_formulation.html · 19 revisions, 2026-11-10 to 2026-11-12
Latest: 2026-11-12 · Talk v2 full set of 11-11 (16:37, 30 steps rc 0): the size study's rows under the tracking score, the CEM rows of the grasp and HOM together, the shared HOM …

Revisions, newest first

1. 2026-11-12 · Talk v2 full set of 11-11 (16:37, 30 steps rc 0): the size study's rows under the tracking score, the CEM rows of the grasp and HOM together, the shared HOM … · 72a794f90 (https://github.com/badinkajink/hand/commit/72a794f9077f3ee2b0484c5a9eac8813ded9af17) page (https://github.com/badinkajink/hand/blob/72a794f9077f3ee2b0484c5a9eac8813ded9af17/docs/experiments/20261110-codesign_formulation/20261110-sr2_codesign_formula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)
2. 2026-11-11 · Talk figures in the HOM paper's terms (owner, 11-11): CEM-refined grasp and HOM, Eq. (2) weights, contact forces · 136239972 (https://github.com/badinkajink/hand/commit/1362399725b154bd9ef9570e9fab8a6b46a4b98c) page (https://github.com/badinkajink/hand/blob/1362399725b154bd9ef9570e9fab8a6b46a4b98c/docs/experiments/20261110-codesign_formulation/20261110-sr2_codesign_formula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)
3. 2026-11-11 · Talk v2: the tuning chart under the tracking score, with HOM tuning alone (owner, 11-11) · b5a8d0025 (https://github.com/badinkajink/hand/commit/b5a8d002554e72ebdfa3eeaf807bcc3e293af081) page (https://github.com/badinkajink/hand/blob/b5a8d002554e72ebdfa3eeaf807bcc3e293af081/docs/experiments/20261110-codesign_formulation/20261110-sr2_codesign_formula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)
4. 2026-11-11 · Talk v2: the 16 grasps of hand A and the search panels under the tracking score, the formulation page's v2 section, filmed hands' scores to four decimals · 0d87fb90e (https://github.com/badinkajink/hand/commit/0d87fb90e294fd3e52bdec6849f202e988e45317) page (https://github.com/badinkajink/hand/blob/0d87fb90e294fd3e52bdec6849f202e988e45317/docs/experiments/20261110-codesign_formulation/20261110-sr2_codesign_formula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)
5. 2026-11-11 · Talk v2 under way (owner, 11-11 ~01:35: refresh the slides' results on the latest settings): the tracking-score versions of the morphology figures, the … · ff6dc6dcd (https://github.com/badinkajink/hand/commit/ff6dc6dcd939685beed0d6a49d347d96d4370b46) page (https://github.com/badinkajink/hand/blob/ff6dc6dcd939685beed0d6a49d347d96d4370b46/docs/experiments/20261110-codesign_formulation/20261110-sr2_codesign_formula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)
6. 2026-11-11 · Talk media of 11-11: HOM on the abstract SR2 hand of the drawings, and the fidelity slide as two plain charts (owner) · 2d960dc4f (https://github.com/badinkajink/hand/commit/2d960dc4f92dc0eee7417e2cfb608db869ae6541) page (https://github.com/badinkajink/hand/blob/2d960dc4f92dc0eee7417e2cfb608db869ae6541/docs/experiments/20261110-codesign_formulation/20261110-sr2_codesign_formula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)
7. 2026-11-11 · Talk chart of the time per landscape: Newton's SDF hydroelastic contact on one GPU, an estimated 31 minutes (owner, 11-11) · b924a7283 (https://github.com/badinkajink/hand/commit/b924a7283f16151074beecab52c75f99f8a2014c) page (https://github.com/badinkajink/hand/blob/b924a7283f16151074beecab52c75f99f8a2014c/docs/experiments/20261110-codesign_formulation/20261110-sr2_codesign_formula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)
8. 2026-11-10 · Talk landscape figure: the letter A sits on the star's top point, and the key says A, B and C are the three hands of the grasp film (owner, 11-10 night, asked … · 4ee77f874 (https://github.com/badinkajink/hand/commit/4ee77f874f4da1216c7535e6d02b4234407e26e3) page (https://github.com/badinkajink/hand/blob/4ee77f874f4da1216c7535e6d02b4234407e26e3/docs/experiments/20261110-codesign_formulation/20261110-sr2_codesign_formula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)
9. 2026-11-10 · Talk media for three owner comments of 11-10 night: grasps before the search, the sphere pads as the dynamics segue, and opener films · 5c414bd03 (https://github.com/badinkajink/hand/commit/5c414bd030ddb92b9d67301caa57d956be42f97e) page (https://github.com/badinkajink/hand/blob/5c414bd030ddb92b9d67301caa57d956be42f97e/docs/experiments/20261110-codesign_formulation/20261110-sr2_codesign_formula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)
10. 2026-11-10 · Formulation page: the thesis of slides 24-25 before the build (Borras and Dollar's rule as a schematic, and the question for executed manipulation) · 7b46f428a (https://github.com/badinkajink/hand/commit/7b46f428a95986106a02b8d960212e191b418730) page (https://github.com/badinkajink/hand/blob/7b46f428a95986106a02b8d960212e191b418730/docs/experiments/20261110-codesign_formulation/20261110-sr2_codesign_formula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)
11. 2026-11-10 · Talk figures for the morphology section, one question per slide (owner, 11-10 evening: the level sections with the co-design section's clarity and … · e89e72b91 (https://github.com/badinkajink/hand/commit/e89e72b91765b909b902137555d0accb49f86047) page (https://github.com/badinkajink/hand/blob/e89e72b91765b909b902137555d0accb49f86047/docs/experiments/20261110-codesign_formulation/20261110-sr2_codesign_formula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)
12. 2026-11-10 · Talk formulas: the metric step follows the dynamics, and metrics join the outermost loop (owner, 11-10 evening) · cca3b006d (https://github.com/badinkajink/hand/commit/cca3b006dec189e9b5cf9937ab97d742ddf47cd9) page (https://github.com/badinkajink/hand/blob/cca3b006dec189e9b5cf9937ab97d742ddf47cd9/docs/experiments/20261110-codesign_formulation/20261110-sr2_codesign_formula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)
13. 2026-11-10 · Talk formulas: the innermost level of the co-design problem is the dynamics (owner, 11-10 evening) · 18d7c5330 (https://github.com/badinkajink/hand/commit/18d7c533058a77374838dc878245b05519da9d08) page (https://github.com/badinkajink/hand/blob/18d7c533058a77374838dc878245b05519da9d08/docs/experiments/20261110-codesign_formulation/20261110-sr2_codesign_formula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)
14. 2026-11-10 · Talk figures beside steps 3 and 4 of the co-design build: one line drawing of the hand of the films (layout 70, 110 mm) with the six mount coordinates in … · 94cf9f9c9 (https://github.com/badinkajink/hand/commit/94cf9f9c9285f7e3055e456b3684c01f18c7b7c2) page (https://github.com/badinkajink/hand/blob/94cf9f9c9285f7e3055e456b3684c01f18c7b7c2/docs/experiments/20261110-codesign_formulation/20261110-sr2_codesign_formula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)
15. 2026-11-10 · Talk formulas: the co-design build introduces the 6 mount coordinates and the 9 joint commands right after the bi-level step, then the object sizes and the … · f98907013 (https://github.com/badinkajink/hand/commit/f98907013d782f6835b10fe081f67f74b552bd3e) page (https://github.com/badinkajink/hand/blob/f98907013d782f6835b10fe081f67f74b552bd3e/docs/experiments/20261110-codesign_formulation/20261110-sr2_codesign_formula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)
16. 2026-11-10 · Talk formulas as atomic LaTeX images: one idea per image, one canvas per series, a manifest shared by the page and the deck · d3dcdd914 (https://github.com/badinkajink/hand/commit/d3dcdd914b023114e6f9b8f0e64a2e9192188149) page (https://github.com/badinkajink/hand/blob/d3dcdd914b023114e6f9b8f0e64a2e9192188149/docs/experiments/20261110-codesign_formulation/20261110-sr2_codesign_formula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)
17. 2026-11-10 · Talk visuals for the co-design formulation: LaTeX formula build, nested-box hierarchy, HOM contact modes, EA anatomy, hand renders · 10f51ead0 (https://github.com/badinkajink/hand/commit/10f51ead0a5c4544e791f54bb1f08bf79552b4ef) page (https://github.com/badinkajink/hand/blob/10f51ead0a5c4544e791f54bb1f08bf79552b4ef/docs/experiments/20261110-codesign_formulation/20261110-sr2_codesign_formula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)
18. 2026-11-10 · Co-design formulation: the nested-problem diagram tightened; the talk deck has its ten slides (contact 74d58c3, local); hand-off state for post-reset step 15 · 065ab3f06 (https://github.com/badinkajink/hand/commit/065ab3f06888ee8b3f9143de1a65f543e7e1d8ad) page (https://github.com/badinkajink/hand/blob/065ab3f06888ee8b3f9143de1a65f543e7e1d8ad/docs/experiments/20261110-codesign_formulation/20261110-sr2_codesign_formula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)
19. 2026-11-10 · Co-design formulation of the hand-design talk: one nested formula built up over the owner's slides 21-31, and its levels · f81cd63c3 (https://github.com/badinkajink/hand/commit/f81cd63c3f7182ac7a750beb48c2b8a60e212eef) page (https://github.com/badinkajink/hand/blob/f81cd63c3f7182ac7a750beb48c2b8a60e212eef/docs/experiments/20261110-codesign_formulation/20261110-sr2_codesign_formula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)

### HOM landscapes of the SR2 hand on the measured SCS0009 servo and on MuJoCo 4.0

docs/experiments/20261029-foundational_pose_review/20261110-hom_servo_stiffness_mujoco4.html · 2 revisions, 2026-11-10 to 2026-11-10
Latest: 2026-11-10 · Stiffness page: the size study's live EA on the measured servo and MuJoCo 4.0 keeps the press's 1.09 mm/mm and the roll's 0.49 against 0.56; the twist's falls …

Revisions, newest first

1. 2026-11-10 · Stiffness page: the size study's live EA on the measured servo and MuJoCo 4.0 keeps the press's 1.09 mm/mm and the roll's 0.49 against 0.56; the twist's falls … · f933beb09 (https://github.com/badinkajink/hand/commit/f933beb092d85bad7e7e96e7b600611c181e0ffe) page (https://github.com/badinkajink/hand/blob/f933beb092d85bad7e7e96e7b600611c181e0ffe/docs/experiments/20261029-foundational_pose_review/20261110-hom_servo_stiffn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)
2. 2026-11-10 · HOM landscapes on the measured SCS0009 servo: 0.55 N m/rad and the 0.59 deg dead band reorder the layouts (tracking rho 0.72-0.91 against 0.72 N m/rad, rerun … · 2eb2bfe31 (https://github.com/badinkajink/hand/commit/2eb2bfe3169f5c1a0f6d24d9041a2965876ab972) page (https://github.com/badinkajink/hand/blob/2eb2bfe3169f5c1a0f6d24d9041a2965876ab972/docs/experiments/20261029-foundational_pose_review/20261110-hom_servo_stiffn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)

### Tracking score of the HOM tasks and films of the SR2 hand across object sizes

docs/experiments/20261029-foundational_pose_review/20261109-hom_tracking_score.html · 6 revisions, 2026-11-09 to 2026-11-10
Latest: 2026-11-10 · Tracking-score page, Section 7: the four default landscapes of the hand-design talk under the tracking score (owner, 11-10 night: "sure, let's rerun the …

Revisions, newest first

1. 2026-11-10 · Tracking-score page, Section 7: the four default landscapes of the hand-design talk under the tracking score (owner, 11-10 night: "sure, let's rerun the … · f03d7dccc (https://github.com/badinkajink/hand/commit/f03d7dccc09c73265b5a6def37d6c17e71d26c7d) page (https://github.com/badinkajink/hand/blob/f03d7dccc09c73265b5a6def37d6c17e71d26c7d/docs/experiments/20261029-foundational_pose_review/20261109-hom_tracking_sco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)
2. 2026-11-10 · Tracking page: the roll's live EA with the tracking score as its fitness re-picks 25 mm, (90, 60) at 0.28, and 80 mm, (120, 155) at 0.22 (post-reset step 11) · 651eaa1f3 (https://github.com/badinkajink/hand/commit/651eaa1f3b6d9a1dd4ffde14f77142028c3e3c53) page (https://github.com/badinkajink/hand/blob/651eaa1f3b6d9a1dd4ffde14f77142028c3e3c53/docs/experiments/20261029-foundational_pose_review/20261109-hom_tracking_sco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)
3. 2026-11-10 · Tracking page: the roll on a thumb held still as a rail, 0.28-0.32 at 25, 30 and 80 mm against the tripod roll's 0.04-0.28 (post-reset step 13) · dba1c25f5 (https://github.com/badinkajink/hand/commit/dba1c25f5e713e1b4074423f893297df66fbe9ff) page (https://github.com/badinkajink/hand/blob/dba1c25f5e713e1b4074423f893297df66fbe9ff/docs/experiments/20261029-foundational_pose_review/20261109-hom_tracking_sco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)
4. 2026-11-09 · The film's roll layouts under a 40 deg roll command (owner, 11-09: "can we see what it looks like for a larger roll command") · d58fb319d (https://github.com/badinkajink/hand/commit/d58fb319d49ef8e9f069c4873697883c660ecf64) page (https://github.com/badinkajink/hand/blob/d58fb319d49ef8e9f069c4873697883c660ecf64/docs/experiments/20261029-foundational_pose_review/20261109-hom_tracking_sco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)
5. 2026-11-09 · Roll films with all three pads on the sphere, filmed from below; ties go to the larger three-pad share (owner, 11-09) · e4837be04 (https://github.com/badinkajink/hand/commit/e4837be04e0b03c6fc5ae30bd2e2516d6c09f1d5) page (https://github.com/badinkajink/hand/blob/e4837be04e0b03c6fc5ae30bd2e2516d6c09f1d5/docs/experiments/20261029-foundational_pose_review/20261109-hom_tracking_sco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)
6. 2026-11-09 · Tracking score for the HOM tasks, checked against the owner's verdicts, and films of re-picked layouts (owner, 11-09) · 68bdab8ba (https://github.com/badinkajink/hand/commit/68bdab8bac51b9c360cbadf12ccff670af6b759c) page (https://github.com/badinkajink/hand/blob/68bdab8bac51b9c360cbadf12ccff670af6b759c/docs/experiments/20261029-foundational_pose_review/20261109-hom_tracking_sco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)

### Layout search methods for the SR2 hand under HOM control

docs/experiments/20261029-foundational_pose_review/20261109-hom_search_methods.html · 6 revisions, 2026-11-09 to 2026-11-12
Latest: 2026-11-12 · Search methods page, Section 12: MAP-Elites, CMA-ME, CMA-ES and Bayesian optimization replayed on the talk's four tracking-score grids (owner, 2026-11-12)

Revisions, newest first

1. 2026-11-12 · Search methods page, Section 12: MAP-Elites, CMA-ME, CMA-ES and Bayesian optimization replayed on the talk's four tracking-score grids (owner, 2026-11-12) · eb98da82e (https://github.com/badinkajink/hand/commit/eb98da82e17f14c4be92c02a7cabe35a383fc74c) page (https://github.com/badinkajink/hand/blob/eb98da82e17f14c4be92c02a7cabe35a383fc74c/docs/experiments/20261029-foundational_pose_review/20261109-hom_search_metho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)
2. 2026-11-10 · Search methods page: the EA and the 16-particle swarm live at four object sizes without a stored grid (post-reset step 5) · ff95124f7 (https://github.com/badinkajink/hand/commit/ff95124f7e0785b35fb45a825f6dc26d64525c09) page (https://github.com/badinkajink/hand/blob/ff95124f7e0785b35fb45a825f6dc26d64525c09/docs/experiments/20261029-foundational_pose_review/20261109-hom_search_metho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)
3. 2026-11-10 · Search methods page: the five layouts of best tracking score per task on the six-coordinate layouts, rerun at seeds 20-24 (post-reset step 18) · 0a7e932bc (https://github.com/badinkajink/hand/commit/0a7e932bce00617081c3a696993f68bac1fa99af) page (https://github.com/badinkajink/hand/blob/0a7e932bce00617081c3a696993f68bac1fa99af/docs/experiments/20261029-foundational_pose_review/20261109-hom_search_metho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)
4. 2026-11-10 · Refinement page: a particle swarm in place of CEM at level full fails the rule on the press (post-reset step 3) · ad2fa44bb (https://github.com/badinkajink/hand/commit/ad2fa44bb8dcdb61e6e285be6a10832761aa0ea3) page (https://github.com/badinkajink/hand/blob/ad2fa44bb8dcdb61e6e285be6a10832761aa0ea3/docs/experiments/20261029-foundational_pose_review/20261109-hom_search_metho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)
5. 2026-11-10 · Search methods page: the six methods live on the six-coordinate Sobol layouts (post-reset step 4) · 5d8477f06 (https://github.com/badinkajink/hand/commit/5d8477f0630ac5c20066c10635da7a2bacea0447) page (https://github.com/badinkajink/hand/blob/5d8477f0630ac5c20066c10635da7a2bacea0447/docs/experiments/20261029-foundational_pose_review/20261109-hom_search_metho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)
6. 2026-11-09 · Layout search methods page: the EA of Yang et al., particle swarms, Sobol and the FP paper's RRT on the stored grids; CEM, Pareto fronts and t-SNE from first … · 5f9f3309d (https://github.com/badinkajink/hand/commit/5f9f3309dd8fb5e6f819d777f1079e37af9b0b82) page (https://github.com/badinkajink/hand/blob/5f9f3309dd8fb5e6f819d777f1079e37af9b0b82/docs/experiments/20261029-foundational_pose_review/20261109-hom_search_metho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)

### Sphere-pad contact and the simulation stack on MuJoCo 4.0

docs/experiments/20261108-mujoco4_port/20261108-mujoco4_contact_and_stack.html · 1 revision, 2026-11-08 to 2026-11-08 · b3b1afc16 (https://github.com/badinkajink/hand/commit/b3b1afc16c8cfeda27c7885aeff3fbf80ffd897d) page (https://github.com/badinkajink/hand/blob/b3b1afc16c8cfeda27c7885aeff3fbf80ffd897d/docs/experiments/20261108-mujoco4_port/20261108-mujoco4_contact_and_stack.html)

### Static identification of the SR2 hand's SCS0009 servos in free space on the UR5

docs/experiments/20261106-sr2_servo_sysid/20261106-sr2_servo_identification.html · 2 revisions, 2026-11-06 to 2026-11-06
Latest: 2026-11-06 · SR2 servo identification page: film of the yaw steps replayed on the cad_v3 hand, commanded and measured lines

Revisions, newest first

1. 2026-11-06 · SR2 servo identification page: film of the yaw steps replayed on the cad_v3 hand, commanded and measured lines · c658432e2 (https://github.com/badinkajink/hand/commit/c658432e2b454f75342473230cc4b469430b0614) page (https://github.com/badinkajink/hand/blob/c658432e2b454f75342473230cc4b469430b0614/docs/experiments/20261106-sr2_servo_sysid/20261106-sr2_servo_identification.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)
2. 2026-11-06 · SR2 servo identification page (R36): dead band 0.59 deg, 0.55 N m/rad at the datasheet scale and 5.1 V, yaw friction +-23 to +-27 mN m · 9639ade26 (https://github.com/badinkajink/hand/commit/9639ade263e5d8aba9307b0f38872edd506e4260) page (https://github.com/badinkajink/hand/blob/9639ade263e5d8aba9307b0f38872edd506e4260/docs/experiments/20261106-sr2_servo_sysid/20261106-sr2_servo_identification.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)

### Seat, tag block and cameras for HOM experiments with the SR2 hand on the UR5, in simulation

docs/experiments/20261105-object_tracking_sim/20261105-object_tracking_sim.html · 1 revision, 2026-11-05 to 2026-11-05 · 72fb9da6a (https://github.com/badinkajink/hand/commit/72fb9da6af31a32e95962a396e5a27832cc47f4d) page (https://github.com/badinkajink/hand/blob/72fb9da6af31a32e95962a396e5a27832cc47f4d/docs/experiments/20261105-object_tracking_sim/20261105-object_tracking_sim.h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)

### Magnetic crosstalk between the fingertip boards on the SR2 hand

docs/experiments/20261104-sr2_hand_crosstalk/20261105-sr2_hand_fingertip_crosstalk.html · 2 revisions, 2026-11-05 to 2026-11-05
Latest: 2026-11-05 · SR2 crosstalk page with the HOM layouts: 11 layouts, 2,044 steps; the own-angle GP holds on layouts left out of its fit

Revisions, newest first

1. 2026-11-05 · SR2 crosstalk page with the HOM layouts: 11 layouts, 2,044 steps; the own-angle GP holds on layouts left out of its fit · 3f300b0a5 (https://github.com/badinkajink/hand/commit/3f300b0a59394aa9a452d79242916a99a63bb138) page (https://github.com/badinkajink/hand/blob/3f300b0a59394aa9a452d79242916a99a63bb138/docs/experiments/20261104-sr2_hand_crosstalk/20261105-sr2_hand_fingertip_cro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)
2. 2026-11-05 · SR2 crosstalk page: magnetic crosstalk between the fingertip boards on the SR2 hand, 11-04 night and 11-05 to 17:31 · 525931521 (https://github.com/badinkajink/hand/commit/525931521909628e58e914e096075b50f22bd07d) page (https://github.com/badinkajink/hand/blob/525931521909628e58e914e096075b50f22bd07d/docs/experiments/20261104-sr2_hand_crosstalk/20261105-sr2_hand_fingertip_cro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)

### Block, capsule, ellipsoid and hemisphere fingertips on the v4b finger of the SR2 hand

docs/experiments/20261104-fingertip_shape_rerun/20261104-fingertip_shapes_v4b_finger.html · 1 revision, 2026-11-04 to 2026-11-04 · 2dae56bc1 (https://github.com/badinkajink/hand/commit/2dae56bc15fe934fabe33d94ff38b89e0806ae75) page (https://github.com/badinkajink/hand/blob/2dae56bc15fe934fabe33d94ff38b89e0806ae75/docs/experiments/20261104-fingertip_shape_rerun/20261104-fingertip_shapes_v4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)

### Model and transforms of the SR2 hand on the UR5 CB3

docs/experiments/20261104-cad_v3_hand/20261104-cad_v3_hand_on_ur5.html · 1 revision, 2026-11-04 to 2026-11-04 · 22cecc645 (https://github.com/badinkajink/hand/commit/22cecc6454114d1a59048de40e6694d94ad0d45c) page (https://github.com/badinkajink/hand/blob/22cecc6454114d1a59048de40e6694d94ad0d45c/docs/experiments/20261104-cad_v3_hand/20261104-cad_v3_hand_on_ur5.html)

### One finger layout or several for the HOM tasks of the SR2 hand

docs/experiments/20261103-hom_task_conflict/20261104-hom_task_conflict.html · 3 revisions, 2026-11-04 to 2026-11-06
Latest: 2026-11-06 · HOM pages after the scripts move: code excerpts linked to GitHub, paths rebuilt

Revisions, newest first

1. 2026-11-06 · HOM pages after the scripts move: code excerpts linked to GitHub, paths rebuilt · 7bdcfc7f7 (https://github.com/badinkajink/hand/commit/7bdcfc7f77616d9aca4d74bbaf4f3e0b694d62f1) page (https://github.com/badinkajink/hand/blob/7bdcfc7f77616d9aca4d74bbaf4f3e0b694d62f1/docs/experiments/20261103-hom_task_conflict/20261104-hom_task_conflict.html)
2. 2026-11-04 · HOM task conflict runbook and page, 03:5x on 11-04: the outcome in README.md, exact single-layout levels in the plant table · 922a300bc (https://github.com/badinkajink/hand/commit/922a300bc875e8b6d5233e8c90a64093bbd2519e) page (https://github.com/badinkajink/hand/blob/922a300bc875e8b6d5233e8c90a64093bbd2519e/docs/experiments/20261103-hom_task_conflict/20261104-hom_task_conflict.html)
3. 2026-11-04 · HOM task conflict page, 03:4x on 11-04: one finger layout or several for the four HOM tasks, on performance alone · 85845f03e (https://github.com/badinkajink/hand/commit/85845f03e039ed8cd5d47cb6e50678618e635ea4) page (https://github.com/badinkajink/hand/blob/85845f03e039ed8cd5d47cb6e50678618e635ea4/docs/experiments/20261103-hom_task_conflict/20261104-hom_task_conflict.html)

### Grasp, force and contact-mode refinement of SR2 hand layouts under HOM control

docs/experiments/20261103-hom_score_refine/20261103-hom_score_refine.html · 7 revisions, 2026-11-04 to 2026-11-10
Latest: 2026-11-10 · Refinement page: a particle swarm in place of CEM at level full fails the rule on the press (post-reset step 3)

Revisions, newest first

1. 2026-11-10 · Refinement page: a particle swarm in place of CEM at level full fails the rule on the press (post-reset step 3) · ad2fa44bb (https://github.com/badinkajink/hand/commit/ad2fa44bb8dcdb61e6e285be6a10832761aa0ea3) page (https://github.com/badinkajink/hand/blob/ad2fa44bb8dcdb61e6e285be6a10832761aa0ea3/docs/experiments/20261103-hom_score_refine/20261103-hom_score_refine.html)
2. 2026-11-06 · HOM pages after the scripts move: code excerpts linked to GitHub, paths rebuilt · 7bdcfc7f7 (https://github.com/badinkajink/hand/commit/7bdcfc7f77616d9aca4d74bbaf4f3e0b694d62f1) page (https://github.com/badinkajink/hand/blob/7bdcfc7f77616d9aca4d74bbaf4f3e0b694d62f1/docs/experiments/20261103-hom_score_refine/20261103-hom_score_refine.html)
3. 2026-11-04 · HOM grasp-genome EA, 16:3x on 11-04: Section 8 of the score refine page, the EA over layout and grasp · 6c0d155a3 (https://github.com/badinkajink/hand/commit/6c0d155a33a9007f40465386511e217ba1eace0c) page (https://github.com/badinkajink/hand/blob/6c0d155a33a9007f40465386511e217ba1eace0c/docs/experiments/20261103-hom_score_refine/20261103-hom_score_refine.html)
4. 2026-11-04 · HOM shared controller, 12:3x on 11-04: Section 7 of the score refine page, one set of forces and modes for all layouts · a7993fbfc (https://github.com/badinkajink/hand/commit/a7993fbfc15090d8e6594d7ee217dba08d4083ee) page (https://github.com/badinkajink/hand/blob/a7993fbfc15090d8e6594d7ee217dba08d4083ee/docs/experiments/20261103-hom_score_refine/20261103-hom_score_refine.html)
5. 2026-11-04 · HOM worst-case score, 09:4x on 11-04: runbook and outcome in the score refine README · cb9a51482 (https://github.com/badinkajink/hand/commit/cb9a51482555ed3d0f92ba3653839e06ab0b5331) page (https://github.com/badinkajink/hand/blob/cb9a51482555ed3d0f92ba3653839e06ab0b5331/docs/experiments/20261103-hom_score_refine/20261103-hom_score_refine.html)
6. 2026-11-04 · HOM worst-case score, 09:3x on 11-04: Section 6 of the score refine page · 351ba39e3 (https://github.com/badinkajink/hand/commit/351ba39e33e9b4221e327aa3f784837968dc1332) page (https://github.com/badinkajink/hand/blob/351ba39e33e9b4221e327aa3f784837968dc1332/docs/experiments/20261103-hom_score_refine/20261103-hom_score_refine.html)
7. 2026-11-04 · HOM score levels page, 02:3x on 11-04: refined grasps, forces and contact modes against the best of 16 grasps · 05f1ca731 (https://github.com/badinkajink/hand/commit/05f1ca7312d48c5f6bcb107fbfa381928c7c6326) page (https://github.com/badinkajink/hand/blob/05f1ca7312d48c5f6bcb107fbfa381928c7c6326/docs/experiments/20261103-hom_score_refine/20261103-hom_score_refine.html)

### SR2 hand layouts under HOM control across finger servos, pad moduli and scene friction

docs/experiments/20261029-foundational_pose_review/20261102-hom_plant_modulus.html · 3 revisions, 2026-11-03 to 2026-11-05
Latest: 2026-11-05 · Spearman fix on the plant-transfer rows and three pages, 01:0x on 11-05 (6aa06d6b2)

Revisions, newest first

1. 2026-11-05 · Spearman fix on the plant-transfer rows and three pages, 01:0x on 11-05 (6aa06d6b2) · f15190386 (https://github.com/badinkajink/hand/commit/f15190386c4fe82c77eaca9c8587d87a70f60ade) page (https://github.com/badinkajink/hand/blob/f15190386c4fe82c77eaca9c8587d87a70f60ade/docs/experiments/20261029-foundational_pose_review/20261102-hom_plant_modulu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)
2. 2026-11-03 · Fresh-seed check of the HOM one-design picks, on the plant and modulus page · b13d0672f (https://github.com/badinkajink/hand/commit/b13d0672fe91eeb8021c2fae8eac6ebf73f3e453) page (https://github.com/badinkajink/hand/blob/b13d0672fe91eeb8021c2fae8eac6ebf73f3e453/docs/experiments/20261029-foundational_pose_review/20261102-hom_plant_modulu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)
3. 2026-11-03 · HOM plant and modulus page: SR2 layouts across finger servos, pad moduli and scene friction · f84e2cd1c (https://github.com/badinkajink/hand/commit/f84e2cd1c27e0b635568ac216d31a0b2a46bc105) page (https://github.com/badinkajink/hand/blob/f84e2cd1c27e0b635568ac216d31a0b2a46bc105/docs/experiments/20261029-foundational_pose_review/20261102-hom_plant_modulu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)

### Contact models of the four-magnet fingertips fitted to the UR5 presses

docs/experiments/20261030-v3_tip_contact_model/20261030-v3_fingertip_contact_models.html · 3 revisions, 2026-10-30 to 2026-10-31
Latest: 2026-10-31 · Contact pages read for a newcomer: the v3 page says why a softer pad needs a longer time constant, what the regulariser is, and which centroid the scenes' …

Revisions, newest first

1. 2026-10-31 · Contact pages read for a newcomer: the v3 page says why a softer pad needs a longer time constant, what the regulariser is, and which centroid the scenes' … · bbae93013 (https://github.com/badinkajink/hand/commit/bbae93013a5acb1c63aca212ff2c9dc60a4fb690) page (https://github.com/badinkajink/hand/blob/bbae93013a5acb1c63aca212ff2c9dc60a4fb690/docs/experiments/20261030-v3_tip_contact_model/20261030-v3_fingertip_contact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)
2. 2026-10-30 · Pad modulus 2.5 MPa in the scenes (owner, 10-30 18:3x: "seems like we should change the modulus to match the real setting"), fitted to the UR5 presses of the … · 698d3f654 (https://github.com/badinkajink/hand/commit/698d3f654e5ef94f73b693929d5dbdd1b50f5346) page (https://github.com/badinkajink/hand/blob/698d3f654e5ef94f73b693929d5dbdd1b50f5346/docs/experiments/20261030-v3_tip_contact_model/20261030-v3_fingertip_contact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)
3. 2026-10-30 · Contact models of the four-magnet v3 fingertips fitted to the UR5 presses (owner, 10-30: one modulus, forces before indentation, contact area and pose). Over … · 45a0590fb (https://github.com/badinkajink/hand/commit/45a0590fbed9bc7d6b65af7855152b02d682038a) page (https://github.com/badinkajink/hand/blob/45a0590fbed9bc7d6b65af7855152b02d682038a/docs/experiments/20261030-v3_tip_contact_model/20261030-v3_fingertip_contact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)

### Implementation of the HOM controller on the SR2 hand with the v4b fingertip

docs/experiments/20261029-hom_control_review/20261030-hom_controller_code_walkthrough.html · 5 revisions, 2026-10-30 to 2026-11-06
Latest: 2026-11-06 · HOM pages after the scripts move: code excerpts linked to GitHub, paths rebuilt

Revisions, newest first

1. 2026-11-06 · HOM pages after the scripts move: code excerpts linked to GitHub, paths rebuilt · 7bdcfc7f7 (https://github.com/badinkajink/hand/commit/7bdcfc7f77616d9aca4d74bbaf4f3e0b694d62f1) page (https://github.com/badinkajink/hand/blob/7bdcfc7f77616d9aca4d74bbaf4f3e0b694d62f1/docs/experiments/20261029-hom_control_review/20261030-hom_controller_code_wa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)
2. 2026-10-30 · HOM design study: a third of the v4b sphere grasps overlap the index's and middle's caps at the touch pose, which the GPU evaluator's collision filter hides … · c821a6a07 (https://github.com/badinkajink/hand/commit/c821a6a0789ddbf8e9c75285eb855f0b2425438a) page (https://github.com/badinkajink/hand/blob/c821a6a0789ddbf8e9c75285eb855f0b2425438a/docs/experiments/20261029-hom_control_review/20261030-hom_controller_code_wa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)
3. 2026-10-30 · HOM re-anchor of a touching finger's reference beyond the gap cut (HomParams.reanchor, variant reanchor, CPU and GPU, with a test): on the 25 mm pin-push … · 6f44a9019 (https://github.com/badinkajink/hand/commit/6f44a90195a3eab569b5569798d87e5fd2f568fc) page (https://github.com/badinkajink/hand/blob/6f44a90195a3eab569b5569798d87e5fd2f568fc/docs/experiments/20261029-hom_control_review/20261030-hom_controller_code_wa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)
4. 2026-10-30 · HOM GPU controller captured as a CUDA graph in hom_gpu.Batch (capture_control, control_period: float masks, closed-form 3x3 solves, six phi-Newton steps, … · 5b82ab1cd (https://github.com/badinkajink/hand/commit/5b82ab1cd654488a26493a0240f8d1b7bed0a17b) page (https://github.com/badinkajink/hand/blob/5b82ab1cd654488a26493a0240f8d1b7bed0a17b/docs/experiments/20261029-hom_control_review/20261030-hom_controller_code_wa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)
5. 2026-10-30 · HOM controller code walkthrough (subpage of the HOM review page): eleven substeps of a 10 ms period on the v4b hand, with a twist and a pin-push · bdd55c247 (https://github.com/badinkajink/hand/commit/bdd55c247dc9958b7f2d72df3422027addcda1d0) page (https://github.com/badinkajink/hand/blob/bdd55c247dc9958b7f2d72df3422027addcda1d0/docs/experiments/20261029-hom_control_review/20261030-hom_controller_code_wa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)

### Best SR2 hand layouts across object sizes under HOM control

docs/experiments/20261029-foundational_pose_review/20261030-hom_layout_trends.html · 10 revisions, 2026-10-31 to 2026-11-08
Latest: 2026-11-08 · HOM layout trends page: the size slopes beside the earlier measurements and Borras and Dollar's rule (owner, 11-08: "lets include these older results too")

Revisions, newest first

1. 2026-11-08 · HOM layout trends page: the size slopes beside the earlier measurements and Borras and Dollar's rule (owner, 11-08: "lets include these older results too") · 0f51b2839 (https://github.com/badinkajink/hand/commit/0f51b28390fa117974dcbc9f7dc3ebb68340ed4e) page (https://github.com/badinkajink/hand/blob/0f51b28390fa117974dcbc9f7dc3ebb68340ed4e/docs/experiments/20261029-foundational_pose_review/20261030-hom_layout_trend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)
2. 2026-11-06 · HOM pages after the scripts move: code excerpts linked to GitHub, paths rebuilt · 7bdcfc7f7 (https://github.com/badinkajink/hand/commit/7bdcfc7f77616d9aca4d74bbaf4f3e0b694d62f1) page (https://github.com/badinkajink/hand/blob/7bdcfc7f77616d9aca4d74bbaf4f3e0b694d62f1/docs/experiments/20261029-foundational_pose_review/20261030-hom_layout_trend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)
3. 2026-11-03 · HOM layout trends page: its plant and modulus limitation links the plant and modulus page · 14f9e776d (https://github.com/badinkajink/hand/commit/14f9e776d07766fd12c9066af02de204ccc803df) page (https://github.com/badinkajink/hand/blob/14f9e776d07766fd12c9066af02de204ccc803df/docs/experiments/20261029-foundational_pose_review/20261030-hom_layout_trend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)
4. 2026-10-31 · Pin-push from a table: with no penetration of the table no finger touches it, and the cylinder is held in 12 and 15 of 20 runs against 9 · 1fc64cc7e (https://github.com/badinkajink/hand/commit/1fc64cc7ecf3c794a216acd41ec7736c733d67fc) page (https://github.com/badinkajink/hand/blob/1fc64cc7ecf3c794a216acd41ec7736c733d67fc/docs/experiments/20261029-foundational_pose_review/20261030-hom_layout_trend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)
5. 2026-10-31 · Sobol layouts re-run with the finger clearance: the layout-by-size interaction stays at 40 to 43 % of the score variance · ac0727c9f (https://github.com/badinkajink/hand/commit/ac0727c9f010fe45c2c01cd54843eeae928d2738) page (https://github.com/badinkajink/hand/blob/ac0727c9f010fe45c2c01cd54843eeae928d2738/docs/experiments/20261029-foundational_pose_review/20261030-hom_layout_trend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)
6. 2026-10-31 · Trends page: the size table in eight columns that fit the page (the near-set ranges are the figures' bars); numbers keep their units on one line · 94d2a823f (https://github.com/badinkajink/hand/commit/94d2a823f033e551b225069bdad3b27df9eaf5ac) page (https://github.com/badinkajink/hand/blob/94d2a823f033e551b225069bdad3b27df9eaf5ac/docs/experiments/20261029-foundational_pose_review/20261030-hom_layout_trend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)
7. 2026-10-31 · Pose toy reach: the clearance inside the program, not the skeleton's width, is why more layouts reach the tripod · 57d9d2565 (https://github.com/badinkajink/hand/commit/57d9d2565c6d7d38d73664b1eca917fd0008b963) page (https://github.com/badinkajink/hand/blob/57d9d2565c6d7d38d73664b1eca917fd0008b963/docs/experiments/20261029-foundational_pose_review/20261030-hom_layout_trend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)
8. 2026-10-31 · HOM layouts clear of a table across object sizes: the constraint lowers the twist on spheres under 40 mm and the pin-push at every size, not the roll · 814eefedc (https://github.com/badinkajink/hand/commit/814eefedcc7106885e85639d4cd933f751dec9ed) page (https://github.com/badinkajink/hand/blob/814eefedcc7106885e85639d4cd933f751dec9ed/docs/experiments/20261029-foundational_pose_review/20261030-hom_layout_trend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)
9. 2026-10-31 · HOM layouts from a table: grasps kept clear of the table keep the twist's and the roll's scores; the pin-push drops the cylinder where a finger presses on the … · ef7f91c5a (https://github.com/badinkajink/hand/commit/ef7f91c5adf870cf2002ee27290813cf06a8ef22) page (https://github.com/badinkajink/hand/blob/ef7f91c5adf870cf2002ee27290813cf06a8ef22/docs/experiments/20261029-foundational_pose_review/20261030-hom_layout_trend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)
10. 2026-10-31 · HOM layouts across 19 object sizes: the trends page opens with the size trends, and the CPU checks and films use each search's own best layout · e6310c7a5 (https://github.com/badinkajink/hand/commit/e6310c7a5099c1d68ee6c49396c3006fd9c7d078) page (https://github.com/badinkajink/hand/blob/e6310c7a5099c1d68ee6c49396c3006fd9c7d078/docs/experiments/20261029-foundational_pose_review/20261030-hom_layout_trend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)

### Probe on the HEX-E pressing fingertips held on indenter plate v2e

docs/experiments/20261029-inverted_calibration_rig/20261029-inverted_rig.html · 11 revisions, 2026-10-29 to 2026-10-30
Latest: 2026-10-30 · Inverted rig: the dry run's check on the rig page, the status page, R31 and the feed

Revisions, newest first

1. 2026-10-30 · Inverted rig: the dry run's check on the rig page, the status page, R31 and the feed · d7617918f (https://github.com/badinkajink/hand/commit/d7617918fb54eaffc58cea969a79b0ca79a36258) page (https://github.com/badinkajink/hand/blob/d7617918fb54eaffc58cea969a79b0ca79a36258/docs/experiments/20261029-inverted_calibration_rig/20261029-inverted_rig.html)
2. 2026-10-30 · Inverted rig: exact check of the tool against the tip body; deepest presses keep 0.1 mm more on the tool's end · bbe38fc93 (https://github.com/badinkajink/hand/commit/bbe38fc93c26f76d96a65d9c43f2e2dbbb6d5e8a) page (https://github.com/badinkajink/hand/blob/bbe38fc93c26f76d96a65d9c43f2e2dbbb6d5e8a/docs/experiments/20261029-inverted_calibration_rig/20261029-inverted_rig.html)
3. 2026-10-30 · Inverted rig: pass 1 checked as the lab's converter writes it, and touch-offs on the tips' side walls (lab, 15:03 on 10-30) · d37468c18 (https://github.com/badinkajink/hand/commit/d37468c18a80289d8d7e5aa1305cf6200940f3b6) page (https://github.com/badinkajink/hand/blob/d37468c18a80289d8d7e5aa1305cf6200940f3b6/docs/experiments/20261029-inverted_calibration_rig/20261029-inverted_rig.html)
4. 2026-10-30 · Inverted rig: the homing check includes the seated pose (lab, 14:55 on 10-30): seated on a key the arm's last link stands 4.0 mm over the 2x4s' model, under … · d52b1998b (https://github.com/badinkajink/hand/commit/d52b1998b60eeaa04cbb6756979104844bee61be) page (https://github.com/badinkajink/hand/blob/d52b1998b60eeaa04cbb6756979104844bee61be/docs/experiments/20261029-inverted_calibration_rig/20261029-inverted_rig.html)
5. 2026-10-30 · Inverted rig: each probe action's deepest cleared press (deep_clear_mm), the lift labelled, the homing lift checked every 5 mm · 1912b4796 (https://github.com/badinkajink/hand/commit/1912b479669e63a8814e3aeca63bc76121fc4b5c) page (https://github.com/badinkajink/hand/blob/1912b479669e63a8814e3aeca63bc76121fc4b5c/docs/experiments/20261029-inverted_calibration_rig/20261029-inverted_rig.html)
6. 2026-10-30 · Inverted rig: the seats on a low strip on one 2x4, the pads 40 mm over it, and the plate at 189 g · ac021c3dd (https://github.com/badinkajink/hand/commit/ac021c3ddeb289ba1ecc543d77894a58fdb67962) page (https://github.com/badinkajink/hand/blob/ac021c3ddeb289ba1ecc543d77894a58fdb67962/docs/experiments/20261029-inverted_calibration_rig/20261029-inverted_rig.html)
7. 2026-10-30 · Inverted rig: the seat block alone on the table, with two homing keys between its columns, a fingertip tool face out along the axis, and everything on one P1S … · 1690e3dfe (https://github.com/badinkajink/hand/commit/1690e3dfeab2595800ce8509eaa70d166edd353b) page (https://github.com/badinkajink/hand/blob/1690e3dfeab2595800ce8509eaa70d166edd353b/docs/experiments/20261029-inverted_calibration_rig/20261029-inverted_rig.html)
8. 2026-10-30 · Inverted rig: seat block at v2e's place with every wood screw 35 mm or more from the columns, and tools seated on the boss's taper over captive M3 nuts · bb8f63ae9 (https://github.com/badinkajink/hand/commit/bb8f63ae9a5eceee9b1e319fc0bd92a8191207a9) page (https://github.com/badinkajink/hand/blob/bb8f63ae9a5eceee9b1e319fc0bd92a8191207a9/docs/experiments/20261029-inverted_calibration_rig/20261029-inverted_rig.html)
9. 2026-10-29 · Inverted calibration rig ready to print (owner, 10-29 15:2x): tips held pad up, three seats replayed, P1S projects · 84ea1b72d (https://github.com/badinkajink/hand/commit/84ea1b72db0f415bf405f0f3cc74b35e64b967b1) page (https://github.com/badinkajink/hand/blob/84ea1b72db0f415bf405f0f3cc74b35e64b967b1/docs/experiments/20261029-inverted_calibration_rig/20261029-inverted_rig.html)
10. 2026-10-29 · Inverted rig: probe on the HEX-E reaches 444 of 808 pad points on a held tip against 286 for the finger on the robot (owner, 13:0x on 10-29) · 33cfe6f3d (https://github.com/badinkajink/hand/commit/33cfe6f3dc662fadadd8df155c6114603fa29f4f) page (https://github.com/badinkajink/hand/blob/33cfe6f3dc662fadadd8df155c6114603fa29f4f/docs/experiments/20261029-inverted_calibration_rig/20261029-inverted_rig.html)
11. 2026-10-29 · Inverted rig page (first build): probe and plate v2e STLs, reach on six seat orientations, QUEUE R31 at 14:2x · ef453c6c8 (https://github.com/badinkajink/hand/commit/ef453c6c8dcb5d45a9efddafbf9d2d439c58d230) page (https://github.com/badinkajink/hand/blob/ef453c6c8dcb5d45a9efddafbf9d2d439c58d230/docs/experiments/20261029-inverted_calibration_rig/20261029-inverted_rig.html)

### Hand-object mechanism control on the SR2 hand and the fingertip sensing it needs

docs/experiments/20261029-hom_control_review/20261029-hom_control_and_fingertip_sensing.html · 13 revisions, 2026-10-29 to 2026-11-10
Latest: 2026-11-10 · HOM review page: films of Figure 5's three commands on the planar finger and of the six-component relative twist on the SR2 thumb

Revisions, newest first

1. 2026-11-10 · HOM review page: films of Figure 5's three commands on the planar finger and of the six-component relative twist on the SR2 thumb · e8b2ca7da (https://github.com/badinkajink/hand/commit/e8b2ca7da938a706578bdcbe0f21dc7d70ae5290) page (https://github.com/badinkajink/hand/blob/e8b2ca7da938a706578bdcbe0f21dc7d70ae5290/docs/experiments/20261029-hom_control_review/20261029-hom_control_and_finger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)
2. 2026-11-07 · HOM review page: K for the shape operator throughout (S stays the paper's selection matrix), with the sphere, cylinder, plane and v4b apex as examples · 034d6d731 (https://github.com/badinkajink/hand/commit/034d6d73137283a3fa73ae4f9d3784dd9e868083) page (https://github.com/badinkajink/hand/blob/034d6d73137283a3fa73ae4f9d3784dd9e868083/docs/experiments/20261029-hom_control_review/20261029-hom_control_and_finger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)
3. 2026-11-06 · HOM review page: Eq. (1) and the adjoint drawn, the contact filter explained and run on UR5 rolls · 283c6b482 (https://github.com/badinkajink/hand/commit/283c6b48254fda2d76d2e068547a485085afa079) page (https://github.com/badinkajink/hand/blob/283c6b48254fda2d76d2e068547a485085afa079/docs/experiments/20261029-hom_control_review/20261029-hom_control_and_finger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)
4. 2026-10-30 · HOM design study: a third of the v4b sphere grasps overlap the index's and middle's caps at the touch pose, which the GPU evaluator's collision filter hides … · c821a6a07 (https://github.com/badinkajink/hand/commit/c821a6a0789ddbf8e9c75285eb855f0b2425438a) page (https://github.com/badinkajink/hand/blob/c821a6a0789ddbf8e9c75285eb855f0b2425438a/docs/experiments/20261029-hom_control_review/20261029-hom_control_and_finger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)
5. 2026-10-30 · Local refinement, EA baseline and a 2 ms MPC planner on the HOM evaluator. Around each of the 20 best twist layouts, the best of 64 layouts within 2 mm (picked … · 87032eb49 (https://github.com/badinkajink/hand/commit/87032eb493dd523f1136a5d2c06b7d5883004d03) page (https://github.com/badinkajink/hand/blob/87032eb493dd523f1136a5d2c06b7d5883004d03/docs/experiments/20261029-hom_control_review/20261029-hom_control_and_finger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)
6. 2026-10-30 · HOM GPU controller captured as a CUDA graph in hom_gpu.Batch (capture_control, control_period: float masks, closed-form 3x3 solves, six phi-Newton steps, … · 5b82ab1cd (https://github.com/badinkajink/hand/commit/5b82ab1cd654488a26493a0240f8d1b7bed0a17b) page (https://github.com/badinkajink/hand/blob/5b82ab1cd654488a26493a0240f8d1b7bed0a17b/docs/experiments/20261029-hom_control_review/20261029-hom_control_and_finger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)
7. 2026-10-30 · MPC over HOM's commands: a central-difference gradient planner (fails at the pad-loss cliff); size-study and cross-task analysis code · c876d7f7d (https://github.com/badinkajink/hand/commit/c876d7f7dfe099cb76e9c1e2ef3ee9345a9fb494) page (https://github.com/badinkajink/hand/blob/c876d7f7dfe099cb76e9c1e2ef3ee9345a9fb494/docs/experiments/20261029-hom_control_review/20261029-hom_control_and_finger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)
8. 2026-10-30 · MPC over HOM's commands: the batched controller captured as one CUDA graph (0.032 -> 0.094 x real time) · 2dd938d85 (https://github.com/badinkajink/hand/commit/2dd938d85b2f400fa8d9c319d159f96ccc236f06) page (https://github.com/badinkajink/hand/blob/2dd938d85b2f400fa8d9c319d159f96ccc236f06/docs/experiments/20261029-hom_control_review/20261029-hom_control_and_finger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)
9. 2026-10-30 · HOM review page: model-predictive control over HOM's commands (first run and its cost) · 31709e69f (https://github.com/badinkajink/hand/commit/31709e69fefc156a5eb3b8894193968b69e4a93a) page (https://github.com/badinkajink/hand/blob/31709e69fefc156a5eb3b8894193968b69e4a93a/docs/experiments/20261029-hom_control_review/20261029-hom_control_and_finger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)
10. 2026-10-30 · HOM controller code walkthrough (subpage of the HOM review page): eleven substeps of a 10 ms period on the v4b hand, with a twist and a pin-push · bdd55c247 (https://github.com/badinkajink/hand/commit/bdd55c247dc9958b7f2d72df3422027addcda1d0) page (https://github.com/badinkajink/hand/blob/bdd55c247dc9958b7f2d72df3422027addcda1d0/docs/experiments/20261029-hom_control_review/20261029-hom_control_and_finger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)
11. 2026-10-29 · HOM on the GPU: pin-push, press and the fingertip-sensing variants; 50 Hz angles rescaled · a159c0faa (https://github.com/badinkajink/hand/commit/a159c0faab799c10c0a93e730cf51716985b0050) page (https://github.com/badinkajink/hand/blob/a159c0faab799c10c0a93e730cf51716985b0050/docs/experiments/20261029-hom_control_review/20261029-hom_control_and_finger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)
12. 2026-10-29 · HOM on the GPU: batched controller on MuJoCo-Warp, validated against the CPU, and the dynamic landscapes of SR2 layouts · 879c66044 (https://github.com/badinkajink/hand/commit/879c66044ba08bfdf64068f8fe661342ef28d074) page (https://github.com/badinkajink/hand/blob/879c66044ba08bfdf64068f8fe661342ef28d074/docs/experiments/20261029-hom_control_review/20261029-hom_control_and_finger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)
13. 2026-10-29 · Review pages of the HOM and foundational-pose papers, with fingertip-sensing and layout-sampling toys · 66330a72c (https://github.com/badinkajink/hand/commit/66330a72c9f4a608ac9f6a78e09793b1c8365c97) page (https://github.com/badinkajink/hand/blob/66330a72c9f4a608ac9f6a78e09793b1c8365c97/docs/experiments/20261029-hom_control_review/20261029-hom_control_and_finger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)

### Foundational-pose hand design, the project's layout sampling, and a Pareto front for the SR2 hand

docs/experiments/20261029-foundational_pose_review/20261029-foundational_pose_hand_design.html · 24 revisions, 2026-10-29 to 2026-11-10
Latest: 2026-11-10 · Design page lede: the peak slopes with clear grasps beside those with every grasp (post-reset step 6)

Revisions, newest first

1. 2026-11-10 · Design page lede: the peak slopes with clear grasps beside those with every grasp (post-reset step 6) · 74bac6e77 (https://github.com/badinkajink/hand/commit/74bac6e77d3d445b430983fb7a2d77ba0d01c2f0) page (https://github.com/badinkajink/hand/blob/74bac6e77d3d445b430983fb7a2d77ba0d01c2f0/docs/experiments/20261029-foundational_pose_review/20261029-foundational_pos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)
2. 2026-11-05 · Spearman fix on the plant-transfer rows and three pages, 01:0x on 11-05 (6aa06d6b2) · f15190386 (https://github.com/badinkajink/hand/commit/f15190386c4fe82c77eaca9c8587d87a70f60ade) page (https://github.com/badinkajink/hand/blob/f15190386c4fe82c77eaca9c8587d87a70f60ade/docs/experiments/20261029-foundational_pose_review/20261029-foundational_pos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)
3. 2026-10-31 · Sobol layouts re-run with the finger clearance: the layout-by-size interaction stays at 40 to 43 % of the score variance · ac0727c9f (https://github.com/badinkajink/hand/commit/ac0727c9f010fe45c2c01cd54843eeae928d2738) page (https://github.com/badinkajink/hand/blob/ac0727c9f010fe45c2c01cd54843eeae928d2738/docs/experiments/20261029-foundational_pose_review/20261029-foundational_pos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)
4. 2026-10-31 · HOM layouts across 19 object sizes: the trends page opens with the size trends, and the CPU checks and films use each search's own best layout · e6310c7a5 (https://github.com/badinkajink/hand/commit/e6310c7a5099c1d68ee6c49396c3006fd9c7d078) page (https://github.com/badinkajink/hand/blob/e6310c7a5099c1d68ee6c49396c3006fd9c7d078/docs/experiments/20261029-foundational_pose_review/20261029-foundational_pos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)
5. 2026-10-30 · HOM design study: a third of the v4b sphere grasps overlap the index's and middle's caps at the touch pose, which the GPU evaluator's collision filter hides … · c821a6a07 (https://github.com/badinkajink/hand/commit/c821a6a0789ddbf8e9c75285eb855f0b2425438a) page (https://github.com/badinkajink/hand/blob/c821a6a0789ddbf8e9c75285eb855f0b2425438a/docs/experiments/20261029-foundational_pose_review/20261029-foundational_pos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)
6. 2026-10-30 · Local refinement, EA baseline and a 2 ms MPC planner on the HOM evaluator. Around each of the 20 best twist layouts, the best of 64 layouts within 2 mm (picked … · 87032eb49 (https://github.com/badinkajink/hand/commit/87032eb493dd523f1136a5d2c06b7d5883004d03) page (https://github.com/badinkajink/hand/blob/87032eb493dd523f1136a5d2c06b7d5883004d03/docs/experiments/20261029-foundational_pose_review/20261029-foundational_pos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)
7. 2026-10-30 · Design page: fresh-seed validation and grasp transfer at all three sizes per object (the 40 mm cylinder, kept by every seed, keeps more of the gain: pin-push … · 7c2ef9e27 (https://github.com/badinkajink/hand/commit/7c2ef9e2762ec5bc5ea07c86d1e6ee1f1b6f9bb1) page (https://github.com/badinkajink/hand/blob/7c2ef9e2762ec5bc5ea07c86d1e6ee1f1b6f9bb1/docs/experiments/20261029-foundational_pose_review/20261029-foundational_pos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)
8. 2026-10-30 · Design page: the grid's best grasps on fresh seeds 3-5 and moved between layouts. Spheres keep the gain (twist +0.20 vs +0.21 on the picked seeds, roll +0.06 … · 92dd22b06 (https://github.com/badinkajink/hand/commit/92dd22b06d70abb97957310f44c5498c2e1d08bd) page (https://github.com/badinkajink/hand/blob/92dd22b06d70abb97957310f44c5498c2e1d08bd/docs/experiments/20261029-foundational_pose_review/20261029-foundational_pos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)
9. 2026-10-30 · Design page: the cylinder size study complete (interaction 39 and 40 % of the variance against 17 and 14 % from seed noise; Spearman 0.18 and -0.03 between the … · b90a0413f (https://github.com/badinkajink/hand/commit/b90a0413fcb888f0643ed1a80353853bd298e306) page (https://github.com/badinkajink/hand/blob/b90a0413fcb888f0643ed1a80353853bd298e306/docs/experiments/20261029-foundational_pose_review/20261029-foundational_pos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)
10. 2026-10-30 · Design page: the grid at three sizes per object (peak x_sep 90 -> 130 mm on the 30 -> 63 mm sphere in the twist, 75 -> 105 mm on the 10 -> 40 mm cylinder in … · 65a0633eb (https://github.com/badinkajink/hand/commit/65a0633eb1b48ebb327d02d1f3ede520e24aeaee) page (https://github.com/badinkajink/hand/blob/65a0633eb1b48ebb327d02d1f3ede520e24aeaee/docs/experiments/20261029-foundational_pose_review/20261029-foundational_pos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)
11. 2026-10-30 · Design page: lede and summary on the night's results (grasp per layout and task, object size, narrow peaks) · 186276294 (https://github.com/badinkajink/hand/commit/186276294845008021edc19af5f636b828761215) page (https://github.com/badinkajink/hand/blob/186276294845008021edc19af5f636b828761215/docs/experiments/20261029-foundational_pose_review/20261029-foundational_pos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)
12. 2026-10-30 · Design page: the four tasks on the grid with a grasp per task (worst-of-four median 0.04 with the foundational pose, 0.44 with each task's best of 16; 32 % of … · 6ca363e81 (https://github.com/badinkajink/hand/commit/6ca363e81d65d91d33741a53771f7e91c4c9c107) page (https://github.com/badinkajink/hand/blob/6ca363e81d65d91d33741a53771f7e91c4c9c107/docs/experiments/20261029-foundational_pose_review/20261029-foundational_pos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)
13. 2026-10-30 · Value-model gradients on the cylinder tasks: no better than random steps on the grid for the press (42 vs 43 %), weakly for the pin-push (53 vs 49 %); moved … · e34e615b4 (https://github.com/badinkajink/hand/commit/e34e615b4973058a9e70253270e261cbcf91409f) page (https://github.com/badinkajink/hand/blob/e34e615b4973058a9e70253270e261cbcf91409f/docs/experiments/20261029-foundational_pose_review/20261029-foundational_pos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)
14. 2026-10-30 · Roll at 40 mm: the value model's gradient helps on the grid (57 vs 50 %) and fails at the top (68 % of moved best layouts worse on fresh seeds); peaks slightly … · 3cdc097c8 (https://github.com/badinkajink/hand/commit/3cdc097c84db3cd3186106bc208314f3cdcacddf) page (https://github.com/badinkajink/hand/blob/3cdc097c84db3cd3186106bc208314f3cdcacddf/docs/experiments/20261029-foundational_pose_review/20261029-foundational_pos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)
15. 2026-10-30 · Design page: the four tasks at their default objects (Spearman twist-roll 0.61, pin-push-press 0.45, sphere-cylinder 0.21-0.27; 174 Pareto-optimal layouts of … · a0b74c592 (https://github.com/badinkajink/hand/commit/a0b74c5924b34a72bf800dec1682086d8fa275d0) page (https://github.com/badinkajink/hand/blob/a0b74c5924b34a72bf800dec1682086d8fa275d0/docs/experiments/20261029-foundational_pose_review/20261029-foundational_pos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)
16. 2026-10-30 · Size study: high neighbourhoods against a shuffled-score null (29-58 per task and size, 86-152 layouts each; shuffled: 94-114 smaller ones) · 283e566ca (https://github.com/badinkajink/hand/commit/283e566ca3780f56c4f1a5c9fefc66baf37df117) page (https://github.com/badinkajink/hand/blob/283e566ca3780f56c4f1a5c9fefc66baf37df117/docs/experiments/20261029-foundational_pose_review/20261029-foundational_pos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)
17. 2026-10-30 · Design page: grasp keyframes of the twist's and the pin-push's peak layouts (foundational, best and worst grasp, three sides); renders embedded as JPEG (14.1 … · 46ca4ff2e (https://github.com/badinkajink/hand/commit/46ca4ff2e1a27e2725aaa7da1906bebeae6763ac) page (https://github.com/badinkajink/hand/blob/46ca4ff2e1a27e2725aaa7da1906bebeae6763ac/docs/experiments/20261029-foundational_pose_review/20261029-foundational_pos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)
18. 2026-10-30 · Design page, sizes: the best tenth's overlap between sphere sizes (twist 8 % from 30 to 63 mm, below a random tenth's 10 %; roll 19 %) · 6a9b0319c (https://github.com/badinkajink/hand/commit/6a9b0319ca215d5088c99f0bff16d23e22af7341) page (https://github.com/badinkajink/hand/blob/6a9b0319ca215d5088c99f0bff16d23e22af7341/docs/experiments/20261029-foundational_pose_review/20261029-foundational_pos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)
19. 2026-10-30 · Design page: layouts across object sizes, spheres (twist and roll on 30-63 mm, 8,192 Sobol layouts, v4b tip) · de8f66057 (https://github.com/badinkajink/hand/commit/de8f66057b52982cbf4ec179d953c5d2799425ea) page (https://github.com/badinkajink/hand/blob/de8f66057b52982cbf4ec179d953c5d2799425ea/docs/experiments/20261029-foundational_pose_review/20261029-foundational_pos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)
20. 2026-10-30 · Design page: design gradients from a model of the HOM scores (twist, 40 mm sphere) · 2fc3ebe78 (https://github.com/badinkajink/hand/commit/2fc3ebe78f88a418da3bcfbbc63e98a500789024) page (https://github.com/badinkajink/hand/blob/2fc3ebe78f88a418da3bcfbbc63e98a500789024/docs/experiments/20261029-foundational_pose_review/20261029-foundational_pos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)
21. 2026-10-30 · Design page (foundational-pose review): the calibrated v4b fingertip, grasp sets per layout on the 2-D grid, related design studies, and the record of method … · f4463635f (https://github.com/badinkajink/hand/commit/f4463635fe59d299be3fa3aa0f7e5c9c1d051511) page (https://github.com/badinkajink/hand/blob/f4463635fe59d299be3fa3aa0f7e5c9c1d051511/docs/experiments/20261029-foundational_pose_review/20261029-foundational_pos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)
22. 2026-10-29 · Design page: four HOM tasks and sensing errors across 4,680 Sobol layouts on the GPU · c39d07868 (https://github.com/badinkajink/hand/commit/c39d07868ecebf08d0cbb98f0f7afd4bc8b17d17) page (https://github.com/badinkajink/hand/blob/c39d07868ecebf08d0cbb98f0f7afd4bc8b17d17/docs/experiments/20261029-foundational_pose_review/20261029-foundational_pos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)
23. 2026-10-29 · HOM on the GPU: batched controller on MuJoCo-Warp, validated against the CPU, and the dynamic landscapes of SR2 layouts · 879c66044 (https://github.com/badinkajink/hand/commit/879c66044ba08bfdf64068f8fe661342ef28d074) page (https://github.com/badinkajink/hand/blob/879c66044ba08bfdf64068f8fe661342ef28d074/docs/experiments/20261029-foundational_pose_review/20261029-foundational_pos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)
24. 2026-10-29 · Review pages of the HOM and foundational-pose papers, with fingertip-sensing and layout-sampling toys · 66330a72c (https://github.com/badinkajink/hand/commit/66330a72c9f4a608ac9f6a78e09793b1c8365c97) page (https://github.com/badinkajink/hand/blob/66330a72c9f4a608ac9f6a78e09793b1c8365c97/docs/experiments/20261029-foundational_pose_review/20261029-foundational_pos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)

### Contribution of each UR5 calibration motion on the four-magnet fingertips

docs/experiments/20261029-calibration_motions/20261029-calibration_motions_v3.html · 1 revision, 2026-10-29 to 2026-10-29 · 9da437e01 (https://github.com/badinkajink/hand/commit/9da437e019a2d923ceba43eb82d58cba34c59565) page (https://github.com/badinkajink/hand/blob/9da437e019a2d923ceba43eb82d58cba34c59565/docs/experiments/20261029-calibration_motions/20261029-calibration_motions_v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)

### Layout of the indenter plate for the UR5 calibration cell

docs/experiments/20261028-indenter_plate_layout/20261028-indenter_plate_layout.html · 2 revisions, 2026-10-28 to 2026-10-28
Latest: 2026-10-28 · Indenter plate page: the full replay of v2d (every sample, travel included): 84 side hovers, 162 tall and 318 of 337 sphere actions clear; no flag names …

Revisions, newest first

1. 2026-10-28 · Indenter plate page: the full replay of v2d (every sample, travel included): 84 side hovers, 162 tall and 318 of 337 sphere actions clear; no flag names … · b37050ee3 (https://github.com/badinkajink/hand/commit/b37050ee38ebd2097d684f90d59476b1fa63105f) page (https://github.com/badinkajink/hand/blob/b37050ee38ebd2097d684f90d59476b1fa63105f/docs/experiments/20261028-indenter_plate_layout/20261028-indenter_plate_layo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)
2. 2026-10-28 · Indenter plate layout: the lab's plans replayed on the printed plate and on a proposed layout (page, tool, STL) · 7661b2042 (https://github.com/badinkajink/hand/commit/7661b204280e2dbd8d04774e2edf6e7f3a69af04) page (https://github.com/badinkajink/hand/blob/7661b204280e2dbd8d04774e2edf6e7f3a69af04/docs/experiments/20261028-indenter_plate_layout/20261028-indenter_plate_layo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)

### Three v1 fingertips at rest overnight on the ESP32-C6 mux

docs/experiments/20261027-three_v1_fingers_overnight/20261027-three_v1_fingertips_at_rest_overnight.html · 3 revisions, 2026-10-27 to 2026-10-27
Latest: 2026-10-27 · Soak page: Figure 1's clock ticks every second hour; the pads' recovery text places ID 1's rise of 7 uT at 18:50-19:12 and ID 2's uniform steps at 16:25 and …

Revisions, newest first

1. 2026-10-27 · Soak page: Figure 1's clock ticks every second hour; the pads' recovery text places ID 1's rise of 7 uT at 18:50-19:12 and ID 2's uniform steps at 16:25 and … · 0dd2d8337 (https://github.com/badinkajink/hand/commit/0dd2d833743b3c522225cf5241f8a70d176aeffb) page (https://github.com/badinkajink/hand/blob/0dd2d833743b3c522225cf5241f8a70d176aeffb/docs/experiments/20261027-three_v1_fingers_overnight/20261027-three_v1_finge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)
2. 2026-10-27 · Soak page: long sentences split (mean 17.8 words, 0.8 % over 30), the analysed window ends at 04:00 · b70408f0c (https://github.com/badinkajink/hand/commit/b70408f0c07eef69b50c39a4669d89a4e1bc509a) page (https://github.com/badinkajink/hand/blob/b70408f0c07eef69b50c39a4669d89a4e1bc509a/docs/experiments/20261027-three_v1_fingers_overnight/20261027-three_v1_finge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)
3. 2026-10-27 · Page on the three v1 fingertips' night at rest: prose from the final numbers of 19:35-04:00 (readout passes, no contact at 2 uT and one frame at 1 uT, the … · a076be822 (https://github.com/badinkajink/hand/commit/a076be8225333ede681d8615eadd19f7b42affbe) page (https://github.com/badinkajink/hand/blob/a076be8225333ede681d8615eadd19f7b42affbe/docs/experiments/20261027-three_v1_fingers_overnight/20261027-three_v1_finge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)

### Magnetic crosstalk between neighbouring fingertips and its removal by the fingers' pose

docs/experiments/20261027-fingertip_crosstalk/20261027-magnetic_crosstalk_between_neighbouring_fingertips.html · 26 revisions, 2026-10-27 to 2026-11-05
Latest: 2026-11-05 · Fingertip crosstalk page: the SR2 analysis at 11 layouts with the HOM layouts (3f300b0a5)

Revisions, newest first

1. 2026-11-05 · Fingertip crosstalk page: the SR2 analysis at 11 layouts with the HOM layouts (3f300b0a5) · 57783d550 (https://github.com/badinkajink/hand/commit/57783d5507cc483fd0b22f99ea3d457f714fbf04) page (https://github.com/badinkajink/hand/blob/57783d5507cc483fd0b22f99ea3d457f714fbf04/docs/experiments/20261027-fingertip_crosstalk/20261027-magnetic_crosstalk_be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)
2. 2026-11-05 · Fingertip crosstalk page: false contacts and the own-angle GP at six layouts of the SR2 hand, from the analysis of 525931521 · a69166649 (https://github.com/badinkajink/hand/commit/a69166649842078cf35d5ca8605e61cf6be7f3ef) page (https://github.com/badinkajink/hand/blob/a69166649842078cf35d5ca8605e61cf6be7f3ef/docs/experiments/20261027-fingertip_crosstalk/20261027-magnetic_crosstalk_be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)
3. 2026-11-05 · Fingertip crosstalk page: the layout sweep ended at 17:31 on 11-05, the plan at the HOM layouts runs with the measured-pose gate · 529f36058 (https://github.com/badinkajink/hand/commit/529f36058f15b11f612727f4d5a462c6fcf34983) page (https://github.com/badinkajink/hand/blob/529f36058f15b11f612727f4d5a462c6fcf34983/docs/experiments/20261027-fingertip_crosstalk/20261027-magnetic_crosstalk_be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)
4. 2026-11-05 · Fingertip crosstalk page: the coordinator's tolerance check of the remaining layouts at the yaw limit of 10 deg · d5ed7e234 (https://github.com/badinkajink/hand/commit/d5ed7e234bbd281ae660d13621df327caa195337) page (https://github.com/badinkajink/hand/blob/d5ed7e234bbd281ae660d13621df327caa195337/docs/experiments/20261027-fingertip_crosstalk/20261027-magnetic_crosstalk_be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)
5. 2026-11-05 · Fingertip crosstalk page: the chain's stop at rv04_mid, 15:50 on 11-05, and the limit of 10 deg for the yaw joints · a62a6446b (https://github.com/badinkajink/hand/commit/a62a6446b55f9a4bd28d31b5a2e1f55ddb2ba831) page (https://github.com/badinkajink/hand/blob/a62a6446b55f9a4bd28d31b5a2e1f55ddb2ba831/docs/experiments/20261027-fingertip_crosstalk/20261027-magnetic_crosstalk_be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)
6. 2026-11-05 · Fingertip crosstalk page: the layout sweep's item names the second plan at the HOM study's layouts, ready and not run (commits c23ffccb, 4aa06a09) · 2284b0100 (https://github.com/badinkajink/hand/commit/2284b01008271483be50e74d65919150186f227c) page (https://github.com/badinkajink/hand/blob/2284b01008271483be50e74d65919150186f227c/docs/experiments/20261027-fingertip_crosstalk/20261027-magnetic_crosstalk_be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)
7. 2026-11-05 · Fingertip crosstalk page: the layout sweep's item follows the lab's afternoon (commits 655c0e9d, 4a9ec4fa, aa30e8c3): a second start stopped when the middle's … · 2a6422284 (https://github.com/badinkajink/hand/commit/2a642228404735ebdbd21f68e7c04a349db76317) page (https://github.com/badinkajink/hand/blob/2a642228404735ebdbd21f68e7c04a349db76317/docs/experiments/20261027-fingertip_crosstalk/20261027-magnetic_crosstalk_be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)
8. 2026-11-05 · Fingertip crosstalk page: the layout sweep's stop follows the lab's correction (commit e5f02c6d): the owner swept the middle's yaw and found nothing … · 0e740e3c1 (https://github.com/badinkajink/hand/commit/0e740e3c1829944ddb57b1bab7b1c4cadf0beba3) page (https://github.com/badinkajink/hand/blob/0e740e3c1829944ddb57b1bab7b1c4cadf0beba3/docs/experiments/20261027-fingertip_crosstalk/20261027-magnetic_crosstalk_be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)
9. 2026-11-05 · Fingertip crosstalk page: the layout sweep's item follows the lab's runs of 11-05 (commits 7fe124ec and 3f706038): the attended pass of 35 steps ran clean, the … · bbe5c7516 (https://github.com/badinkajink/hand/commit/bbe5c7516494ec587b297da6716cc7653a745532) page (https://github.com/badinkajink/hand/blob/bbe5c7516494ec587b297da6716cc7653a745532/docs/experiments/20261027-fingertip_crosstalk/20261027-magnetic_crosstalk_be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)
10. 2026-11-05 · Fingertip crosstalk page: Future work follows the SR2 hand's layout plan, ready and not run. It takes 120 random poses at each of five grasp layouts, 672 … · e07563813 (https://github.com/badinkajink/hand/commit/e07563813ae9e5e70b28490bb9cca1c92a33eccc) page (https://github.com/badinkajink/hand/blob/e07563813ae9e5e70b28490bb9cca1c92a33eccc/docs/experiments/20261027-fingertip_crosstalk/20261027-magnetic_crosstalk_be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)

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
