badinkajink/hand/assets/mjcf/generated/hand_perp_tp0d0000p0d0000p0d0000_ip0d0000p0d0000p0d0000_mp0d0000p0d0000p0d0000.xml

<mujoco model="hand_perp_tp0d0000p0d0000p0d0000_ip0d0000p0d0000p0d0000_mp0d0000p0d0000p0d0000">
  <compiler angle="radian" autolimits="true" />
  <option timestep="0.002" gravity="0 0 -9.81" integrator="implicitfast" />
  <visual>
    <headlight ambient=".4 .4 .4" diffuse=".8 .8 .8" specular="0.1 0.1 0.1" />
    <map znear=".01" />
    <quality shadowsize="2048" />
    <global elevation="-15" />
  </visual>
  <default>
    <geom friction="1.8 0.15 0.01" solref="0.006 1" solimp="0.97 0.995 0.0005" />
    <motor ctrlrange="-1 1" ctrllimited="true" />
    <default class="pose">
      <joint damping="2.0" armature="0.01" />
      <position kp="4000" kv="100" forcerange="-1000 1000" />
    </default>
    <default class="ctrl">
      <joint damping="0.5" armature="0.001" />
      <position kp="30" kv="0.5" gear="1" forcerange="-10 10" ctrlrange="-1 1" />
    </default>
  </default>
  <asset>
    <texture type="skybox" builtin="gradient" rgb1="0.3 0.5 0.7" rgb2="0 0 0" width="512" height="3072" />
    <texture type="2d" name="groundplane" builtin="checker" mark="edge" rgb1="0.2 0.3 0.4" rgb2="0.1 0.2 0.3" markrgb="0.8 0.8 0.8" width="300" height="300" />
    <material name="groundplane" texture="groundplane" texuniform="true" texrepeat="5 5" reflectance="0.2" />
    <texture name="grid" type="2d" builtin="checker" rgb1="0.15 0.15 0.15" rgb2="0.25 0.25 0.25" width="256" height="256" />
    <material name="table_mat" texture="grid" texrepeat="3 3" reflectance="0.2" />
    <material name="palm_mat" rgba="0.18 0.2 0.24 1" />
    <material name="stalk_mat" rgba="0.28 0.3 0.34 1" />
    <material name="finger_mat" rgba="0.8 0.72 0.6 1" />
    <material name="object_mat" rgba="0.6 0.6 0.6 1" />
  </asset>
  <worldbody>
    <light pos="0 0 1.5" dir="0 0 -1" directional="true" diffuse=".6 .6 .6" specular=".2 .2 .2" />
    <light pos="0.5 0.5 1.0" dir="-1 -1 -1" directional="true" diffuse=".4 .4 .4" specular=".1 .1 .1" />
    <geom name="floor" type="plane" size="1.5 1.5 0.1" material="groundplane" />
    <body name="screwdriver_medium" pos="0.0 0.0 0.0125" quat="0.70711 0 0.70711 0">
      <freejoint />
      <geom type="cylinder" size="0.0125 0.05" density="500" material="object_mat" friction="2.4 0.2 0.02" />
    </body>
    <body gravcomp="1" name="palm_pose" pos="0 0 0.120">
      <joint class="pose" name="palm_px" type="slide" axis="1 0 0" range="-0.20 0.20" />
      <joint class="pose" name="palm_py" type="slide" axis="0 1 0" range="-0.20 0.20" />
      <joint class="pose" name="palm_pz" type="slide" axis="0 0 1" range="-0.15 0.35" />
      <joint class="pose" name="palm_rx" type="hinge" axis="1 0 0" range="-1.57 1.57" />
      <joint class="pose" name="palm_ry" type="hinge" axis="0 1 0" range="-1.57 1.57" />
      <joint class="pose" name="palm_rz" type="hinge" axis="0 0 1" range="-3.14 3.14" />
      <geom name="palm_plate" type="box" pos="-0.005 0 0" size="0.048 0.036 0.001" material="palm_mat" />
      <geom name="thumb_stalk" type="box" pos="-0.055 0 0" size="0.014 0.011 0.006" material="stalk_mat" contype="0" conaffinity="0" />
      <geom name="index_stalk" type="box" pos="0.035 0.042 0" size="0.012 0.008 0.005" material="stalk_mat" contype="0" conaffinity="0" />
      <geom name="middle_stalk" type="box" pos="0.035 -0.042 0" size="0.012 0.008 0.005" material="stalk_mat" contype="0" conaffinity="0" />
      <body name="thumb_mount" pos="-0.065 0 0">
        <inertial pos="0 0 0" mass="0.001" diaginertia="1e-6 1e-6 1e-6" />
        <body name="thumb_yaw_frame">
          <inertial pos="0 0 0" mass="0.001" diaginertia="1e-6 1e-6 1e-6" />
          <joint class="ctrl" name="thumb_yaw" type="hinge" axis="1 0 0" range="-1.1 1.1" />
          <body name="thumb_mcp_frame">
            <joint class="ctrl" name="thumb_mcp" type="hinge" axis="0 1 0" range="0 3.14" />
            <geom type="capsule" fromto="0 0 0 0.05 0 0" size="0.010" material="finger_mat" />
            <body name="thumb_len_frame" pos="0.05 0 0">
              <geom type="capsule" fromto="0 0 0 0.04 0 0" size="0.0085" material="finger_mat" />
              <body name="thumb_pip_frame" pos="0.04 0 0">
                <joint class="ctrl" name="thumb_pip" type="hinge" axis="0 1 0" range="-1.8 0.5" />
                <geom type="capsule" fromto="0 0 0 0.03 0 0" size="0.0075" material="finger_mat" />
                <body name="thumb_tip" pos="0.03 0 0">
                  <geom type="sphere" size="0.010" material="finger_mat" friction="2.4 0.2 0.02" />
                  <geom type="sphere" pos="0 0.004 0" size="0.005" material="finger_mat" friction="2.4 0.2 0.02" />
                  <geom type="sphere" pos="0 -0.004 0" size="0.005" material="finger_mat" friction="2.4 0.2 0.02" />
                </body>
              </body>
            </body>
          </body>
        </body>
      </body>
      <body name="index_mount" pos="0.035 0.048 0">
        <inertial pos="0 0 0" mass="0.001" diaginertia="1e-6 1e-6 1e-6" />
        <body name="index_yaw_frame" quat="0.7071068 0 0 -0.7071068">
          <inertial pos="0 0 0" mass="0.001" diaginertia="1e-6 1e-6 1e-6" />
          <joint class="ctrl" name="index_yaw" type="hinge" axis="1 0 0" range="-1.1 1.1" />
          <body name="index_mcp_frame">
            <joint class="ctrl" name="index_mcp" type="hinge" axis="0 1 0" range="0 2.5" />
            <geom type="capsule" fromto="0 0 0 0.05 0 0" size="0.010" material="finger_mat" />
            <body name="index_len_frame" pos="0.05 0 0">
              <geom type="capsule" fromto="0 0 0 0.04 0 0" size="0.0085" material="finger_mat" />
              <body name="index_pip_frame" pos="0.04 0 0">
                <joint class="ctrl" name="index_pip" type="hinge" axis="0 1 0" range="-1.2 1.57" />
                <geom type="capsule" fromto="0 0 0 0.03 0 0" size="0.0045" material="finger_mat" />
                <body name="index_tip" pos="0.03 0 0">
                  <geom type="sphere" size="0.006" material="finger_mat" friction="2.4 0.2 0.02" />
                  <geom type="sphere" pos="0 0.005 0" size="0.004" material="finger_mat" friction="2.4 0.2 0.02" />
                  <geom type="sphere" pos="0 -0.005 0" size="0.004" material="finger_mat" friction="2.4 0.2 0.02" />
                </body>
              </body>
            </body>
          </body>
        </body>
      </body>
      <body name="middle_mount" pos="0.035 -0.048 0">
        <inertial pos="0 0 0" mass="0.001" diaginertia="1e-6 1e-6 1e-6" />
        <body name="middle_yaw_frame" quat="0.7071068 0 0 0.7071068">
          <inertial pos="0 0 0" mass="0.001" diaginertia="1e-6 1e-6 1e-6" />
          <joint class="ctrl" name="middle_yaw" type="hinge" axis="1 0 0" range="-1.1 1.1" />
          <body name="middle_mcp_frame">
            <joint class="ctrl" name="middle_mcp" type="hinge" axis="0 1 0" range="0 2.5" />
            <geom type="capsule" fromto="0 0 0 0.05 0 0" size="0.010" material="finger_mat" />
            <body name="middle_len_frame" pos="0.05 0 0">
              <geom type="capsule" fromto="0 0 0 0.04 0 0" size="0.0085" material="finger_mat" />
              <body name="middle_pip_frame" pos="0.04 0 0">
                <joint class="ctrl" name="middle_pip" type="hinge" axis="0 1 0" range="-1.2 1.57" />
                <geom type="capsule" fromto="0 0 0 0.03 0 0" size="0.0045" material="finger_mat" />
                <body name="middle_tip" pos="0.03 0 0">
                  <geom type="sphere" size="0.006" material="finger_mat" friction="2.4 0.2 0.02" />
                  <geom type="sphere" pos="0 0.005 0" size="0.004" material="finger_mat" friction="2.4 0.2 0.02" />
                  <geom type="sphere" pos="0 -0.005 0" size="0.004" material="finger_mat" friction="2.4 0.2 0.02" />
                </body>
              </body>
            </body>
          </body>
        </body>
      </body>
    </body>
  </worldbody>
  <actuator>
    <position class="pose" name="a_palm_px" joint="palm_px" ctrlrange="-0.20 0.20" />
    <position class="pose" name="a_palm_py" joint="palm_py" ctrlrange="-0.20 0.20" />
    <position class="pose" name="a_palm_pz" joint="palm_pz" ctrlrange="-0.15 0.35" />
    <position class="pose" name="a_palm_rx" joint="palm_rx" ctrlrange="-1.57 1.57" />
    <position class="pose" name="a_palm_ry" joint="palm_ry" ctrlrange="-1.57 1.57" />
    <position class="pose" name="a_palm_rz" joint="palm_rz" ctrlrange="-3.14 3.14" />
    <position class="ctrl" name="a_thumb_yaw" joint="thumb_yaw" ctrlrange="-1.1 1.1" />
    <position class="ctrl" name="a_thumb_mcp" joint="thumb_mcp" ctrlrange="0 3.14" />
    <position class="ctrl" name="a_thumb_pip" joint="thumb_pip" ctrlrange="-1.8 0.5" />
    <position class="ctrl" name="a_index_yaw" joint="index_yaw" ctrlrange="-1.1 1.1" />
    <position class="ctrl" name="a_index_mcp" joint="index_mcp" ctrlrange="0 2.5" />
    <position class="ctrl" name="a_index_pip" joint="index_pip" ctrlrange="-1.2 1.57" />
    <position class="ctrl" name="a_middle_yaw" joint="middle_yaw" ctrlrange="-1.1 1.1" />
    <position class="ctrl" name="a_middle_mcp" joint="middle_mcp" ctrlrange="0 2.5" />
    <position class="ctrl" name="a_middle_pip" joint="middle_pip" ctrlrange="-1.2 1.57" />
  </actuator>
  <keyframe>
    <key name="open" qpos="&#10; 0 0 0.0125 0.707107 0 0.707107 0 0 0 0 0 0 0 0 1.90865 -1.8 4.34154e-17 1.13823 0.728527 -4.38085e-17 1.13823 0.728527&#10; " ctrl="&#10; 0 0 0 0 0 0 0 1.90865 -1.8 4.34154e-17 1.13823 0.728527 -4.38085e-17 1.13823 0.728527&#10; " />
    <key name="closed" qpos="&#10; 0 0 0.0125 0.707107 0 0.707107 0 0 0 0 0 0 0 0 1.50407 -1.76939 4.83104e-17 1.11743 0.635855 -4.84827e-17 1.11743 0.635855&#10; " ctrl="0 0 0 0 0 0 0 1.50407 -1.76939 4.83104e-17 1.11743 0.635855 -4.84827e-17 1.11743 0.635855" />
    <key name="press" qpos="&#10; 0 0 0.0125 0.707107 0 0.707107 0 0 0 0 0 0 0 0 1.5154 -1.4802 4.83104e-17 1.11743 0.635855 -4.84827e-17 1.11743 0.635855&#10; " ctrl="0 0 0 0 0 0 0 1.5154 -1.4802 4.83104e-17 1.11743 0.635855 -4.84827e-17 1.11743 0.635855" />
    <key name="open_ik" qpos="&#10; 0 0 0.0125 0.707107 0 0.707107 0 0 0 0 0 0 0 0 1.90865 -1.8 4.34154e-17 1.13823 0.728527 -4.38085e-17 1.13823 0.728527&#10; " ctrl="0 0 0 0 0 0 0 1.90865 -1.8 4.34154e-17 1.13823 0.728527 -4.38085e-17 1.13823 0.728527" />
  </keyframe>
</mujoco>
