badinkajink/hand/assets/mjcf/real_v1/hand_actuated_morphology_15dof.xml

<mujoco model="real_hand_15dof">
  <compiler angle="radian" autolimits="true" />
  <option timestep="0.002" gravity="0 0 -9.81" integrator="implicitfast" />

  <visual>
    <headlight ambient=".4 .4 .4" diffuse=".8 .8 .8" specular="0.1 0.1 0.1" />
    <map znear=".01" />
    <quality shadowsize="2048" />
    <global elevation="-15" />
  </visual>

  <default>
    <geom friction="1.8 0.15 0.01" solref="0.006 1" solimp="0.97 0.995 0.0005" />
    <motor ctrlrange="-1 1" ctrllimited="true" />

    <!-- External 6-DoF palm pose; not counted in the 15 internal hand DoFs. -->
    <default class="pose">
      <joint damping="2.0" armature="0.01" />
      <position kp="4000" kv="100" forcerange="-1000 1000" />
    </default>

    <!-- XY morphology gantries: 2 prismatic DoFs per finger. -->
    <default class="morph">
      <joint type="slide" damping="2000" armature="0.0001" />
      <position kp="30" kv="0.5" gear="1" forcerange="-10 10" ctrlrange="-1 1" />
    </default>

    <!-- Finger yaw/MCP/PIP position control. -->
    <default class="ctrl">
      <joint damping="0.5" armature="0.001" />
      <position kp="30" kv="0.5" gear="1" forcerange="-10 10" ctrlrange="-1 1" />
    </default>
  </default>

  <asset>
    <texture type="skybox" builtin="gradient" rgb1="0.3 0.5 0.7" rgb2="0 0 0" width="512" height="3072" />
    <texture type="2d" name="groundplane" builtin="checker" mark="edge" rgb1="0.2 0.3 0.4" rgb2="0.1 0.2 0.3" markrgb="0.8 0.8 0.8" width="300" height="300" />
    <material name="groundplane" texture="groundplane" texuniform="true" texrepeat="5 5" reflectance="0.2" />
    <texture name="grid" type="2d" builtin="checker" rgb1="0.15 0.15 0.15" rgb2="0.25 0.25 0.25" width="256" height="256" />
    <material name="table_mat" texture="grid" texrepeat="3 3" reflectance="0.2" />
    <material name="palm_mat" rgba="0.18 0.2 0.24 1" />
    <material name="finger_mat" rgba="0.8 0.72 0.6 1" />
    <material name="object_mat" rgba="0.6 0.6 0.6 1" />
  </asset>

  <worldbody>
    <light pos="0 0 1.5" dir="0 0 -1" directional="true" diffuse=".6 .6 .6" specular=".2 .2 .2" />
    <light pos="0.5 0.5 1.0" dir="-1 -1 -1" directional="true" diffuse=".4 .4 .4" specular=".1 .1 .1" />
    <geom name="floor" type="plane" size="1.5 1.5 0.1" material="groundplane" />

    <body name="screwdriver_medium" pos="0.0 0.0 0.0125" quat="0.70711 0.70711 0 0">
      <freejoint />
      <geom type="cylinder" size="0.0125 0.05" density="500" material="object_mat" friction="2.4 0.2 0.02" />
    </body>

    <body gravcomp="1" name="palm_pose" pos="0 0 0.134">
      <joint class="pose" name="palm_px" type="slide" axis="1 0 0" range="-0.20 0.20" />
      <joint class="pose" name="palm_py" type="slide" axis="0 1 0" range="-0.20 0.20" />
      <joint class="pose" name="palm_pz" type="slide" axis="0 0 1" range="-0.15 0.35" />
      <joint class="pose" name="palm_rx" type="hinge" axis="1 0 0" range="-1.57 1.57" />
      <joint class="pose" name="palm_ry" type="hinge" axis="0 1 0" range="-1.57 1.57" />
      <joint class="pose" name="palm_rz" type="hinge" axis="0 0 1" range="-3.14 3.14" />
      <geom type="box" size="0.06 0.045 0.001" material="palm_mat" />

      <!--
        CAD workspace registration (all values below are in the palm XY frame):

        The drawing's total envelope is x_CAD=[-30,140] mm, y_CAD=[0,160] mm.
        Its bounding-box center (55,80) mm is chosen as the palm-frame origin.
        The CAD view is rotated into MuJoCo so that the opposing-finger direction is +/−X:
            x_MJ = -(y_CAD - 80 mm)
            y_MJ = -(x_CAD - 55 mm)

        Therefore the zero morphology coordinates are:
            thumb  (-50,   0) mm, workspace X ±30 mm, Y ±55 mm  (60 × 110)
            index  (+50, +55) mm, workspace X ±30 mm, Y ±30 mm  (60 × 60)
            middle (+50, -55) mm, workspace X ±30 mm, Y ±30 mm  (60 × 60)

        The translucent sites are visualization only; they do not collide.
      -->
      <site name="workspace_thumb" type="box" pos="-0.050 0.000 0.002" size="0.030 0.055 0.0005" rgba="0.85 0.30 0.30 0.14" />
      <site name="workspace_index" type="box" pos="0.050 0.055 0.002" size="0.030 0.030 0.0005" rgba="0.30 0.55 0.85 0.14" />
      <site name="workspace_middle" type="box" pos="0.050 -0.055 0.002" size="0.030 0.030 0.0005" rgba="0.30 0.75 0.45 0.14" />
      <site name="morphology_origin" type="sphere" pos="0 0 0.003" size="0.002" rgba="1 1 1 0.8" />

      <!-- THUMB: 2 morphology DoFs + yaw/MCP/PIP = 5 internal DoFs. -->
      <body name="thumb_mount" pos="-0.050000 0.000000 0.000000">
        <inertial pos="0 0 0" mass="0.001" diaginertia="1e-6 1e-6 1e-6" />
        <joint class="morph" name="thumb_x" type="slide" axis="1 0 0" range="-0.030000 0.030000" />
        <joint class="morph" name="thumb_y" type="slide" axis="0 1 0" range="-0.055000 0.055000" />
        <body name="thumb_yaw_frame">
          <joint class="ctrl" name="thumb_yaw" type="hinge" axis="1 0 0" range="-1.483530 1.483530" />
          <geom type="capsule" fromto="0 0 0 0 0 -0.022900" size="0.010550" material="finger_mat" />
          <body name="thumb_mcp_frame" pos="0 0 -0.020750">
            <!-- Thumb flexion axes are reversed so positive flexion opposes index/middle. -->
            <joint class="ctrl" name="thumb_mcp" type="hinge" axis="0 -1 0" range="-0.261799 1.605703" />
            <geom type="capsule" fromto="0 0 0 0 0 -0.022900" size="0.010550" material="finger_mat" />
            <body name="thumb_pip_frame" pos="0 0 -0.020750">
              <joint class="ctrl" name="thumb_pip" type="hinge" axis="0 -1 0" range="-0.314159 1.605703" />
              <geom type="capsule" fromto="0 0 0 0 0 -0.026610" size="0.010550" material="finger_mat" friction="2.4 0.2 0.02" />
              <body name="thumb_tip" pos="0 0 -0.037160" />
            </body>
          </body>
        </body>
      </body>

      <!-- INDEX: 2 morphology DoFs + yaw/MCP/PIP = 5 internal DoFs. -->
      <body name="index_mount" pos="0.050000 0.055000 0.000000">
        <inertial pos="0 0 0" mass="0.001" diaginertia="1e-6 1e-6 1e-6" />
        <joint class="morph" name="index_x" type="slide" axis="1 0 0" range="-0.030000 0.030000" />
        <joint class="morph" name="index_y" type="slide" axis="0 1 0" range="-0.030000 0.030000" />
        <body name="index_yaw_frame">
          <joint class="ctrl" name="index_yaw" type="hinge" axis="1 0 0" range="-1.483530 1.483530" />
          <geom type="capsule" fromto="0 0 0 0 0 -0.022900" size="0.010550" material="finger_mat" />
          <body name="index_mcp_frame" pos="0 0 -0.020750">
            <joint class="ctrl" name="index_mcp" type="hinge" axis="0 1 0" range="-0.261799 1.605703" />
            <geom type="capsule" fromto="0 0 0 0 0 -0.022900" size="0.010550" material="finger_mat" />
            <body name="index_pip_frame" pos="0 0 -0.020750">
              <joint class="ctrl" name="index_pip" type="hinge" axis="0 1 0" range="-0.314159 1.605703" />
              <geom type="capsule" fromto="0 0 0 0 0 -0.026610" size="0.010550" material="finger_mat" friction="2.4 0.2 0.02" />
              <body name="index_tip" pos="0 0 -0.037160" />
            </body>
          </body>
        </body>
      </body>

      <!-- MIDDLE: 2 morphology DoFs + yaw/MCP/PIP = 5 internal DoFs. -->
      <body name="middle_mount" pos="0.050000 -0.055000 0.000000">
        <inertial pos="0 0 0" mass="0.001" diaginertia="1e-6 1e-6 1e-6" />
        <joint class="morph" name="middle_x" type="slide" axis="1 0 0" range="-0.030000 0.030000" />
        <joint class="morph" name="middle_y" type="slide" axis="0 1 0" range="-0.030000 0.030000" />
        <body name="middle_yaw_frame">
          <joint class="ctrl" name="middle_yaw" type="hinge" axis="1 0 0" range="-1.483530 1.483530" />
          <geom type="capsule" fromto="0 0 0 0 0 -0.022900" size="0.010550" material="finger_mat" />
          <body name="middle_mcp_frame" pos="0 0 -0.020750">
            <joint class="ctrl" name="middle_mcp" type="hinge" axis="0 1 0" range="-0.261799 1.605703" />
            <geom type="capsule" fromto="0 0 0 0 0 -0.022900" size="0.010550" material="finger_mat" />
            <body name="middle_pip_frame" pos="0 0 -0.020750">
              <joint class="ctrl" name="middle_pip" type="hinge" axis="0 1 0" range="-0.314159 1.605703" />
              <geom type="capsule" fromto="0 0 0 0 0 -0.026610" size="0.010550" material="finger_mat" friction="2.4 0.2 0.02" />
              <body name="middle_tip" pos="0 0 -0.037160" />
            </body>
          </body>
        </body>
      </body>
    </body>
  </worldbody>

  <actuator>
    <!-- External palm pose actuators (not part of the 15 internal DoFs). -->
    <position class="pose" name="a_palm_px" joint="palm_px" ctrlrange="-0.20 0.20" />
    <position class="pose" name="a_palm_py" joint="palm_py" ctrlrange="-0.20 0.20" />
    <position class="pose" name="a_palm_pz" joint="palm_pz" ctrlrange="-0.15 0.35" />
    <position class="pose" name="a_palm_rx" joint="palm_rx" ctrlrange="-1.57 1.57" />
    <position class="pose" name="a_palm_ry" joint="palm_ry" ctrlrange="-1.57 1.57" />
    <position class="pose" name="a_palm_rz" joint="palm_rz" ctrlrange="-3.14 3.14" />

    <!-- 6 morphology DoFs. -->
    <position class="morph" name="a_thumb_x" joint="thumb_x" ctrlrange="-0.030000 0.030000" />
    <position class="morph" name="a_thumb_y" joint="thumb_y" ctrlrange="-0.055000 0.055000" />
    <position class="morph" name="a_index_x" joint="index_x" ctrlrange="-0.030000 0.030000" />
    <position class="morph" name="a_index_y" joint="index_y" ctrlrange="-0.030000 0.030000" />
    <position class="morph" name="a_middle_x" joint="middle_x" ctrlrange="-0.030000 0.030000" />
    <position class="morph" name="a_middle_y" joint="middle_y" ctrlrange="-0.030000 0.030000" />

    <!-- 9 finger articulation DoFs. -->
    <position class="ctrl" name="a_thumb_yaw" joint="thumb_yaw" ctrlrange="-1.483530 1.483530" />
    <position class="ctrl" name="a_thumb_mcp" joint="thumb_mcp" ctrlrange="-0.261799 1.605703" />
    <position class="ctrl" name="a_thumb_pip" joint="thumb_pip" ctrlrange="-0.314159 1.605703" />
    <position class="ctrl" name="a_index_yaw" joint="index_yaw" ctrlrange="-1.483530 1.483530" />
    <position class="ctrl" name="a_index_mcp" joint="index_mcp" ctrlrange="-0.261799 1.605703" />
    <position class="ctrl" name="a_index_pip" joint="index_pip" ctrlrange="-0.314159 1.605703" />
    <position class="ctrl" name="a_middle_yaw" joint="middle_yaw" ctrlrange="-1.483530 1.483530" />
    <position class="ctrl" name="a_middle_mcp" joint="middle_mcp" ctrlrange="-0.261799 1.605703" />
    <position class="ctrl" name="a_middle_pip" joint="middle_pip" ctrlrange="-0.314159 1.605703" />
  </actuator>

  <!--
    Neutral/home configuration:
      - free screwdriver pose as in the original scene
      - external palm pose = 0
      - all 6 morphology slides = 0, so each finger is at its workspace center
      - all 9 finger angles = 0, so all fingers are vertically extended

    qpos order after screwdriver freejoint + palm pose:
      thumb_x thumb_y thumb_yaw thumb_mcp thumb_pip
      index_x index_y index_yaw index_mcp index_pip
      middle_x middle_y middle_yaw middle_mcp middle_pip

    ctrl order:
      6 palm pose, 6 morphology, 9 articulation
  -->
  <keyframe>
    <key name="open" qpos="0 0 0.0125 0.70711 0.70711 0 0 0 0 0 0 0 0 0 0 0 0 0 0 0 0 0 0 0 0 0 0 0" ctrl="0 0 0 0 0 0 0 0 0 0 0 0 0 0 0 0 0 0 0 0 0" />
  </keyframe>
</mujoco>
