badinkajink/hand/src/morphohand/driver/docs/nema8_1.6ncm.pdf

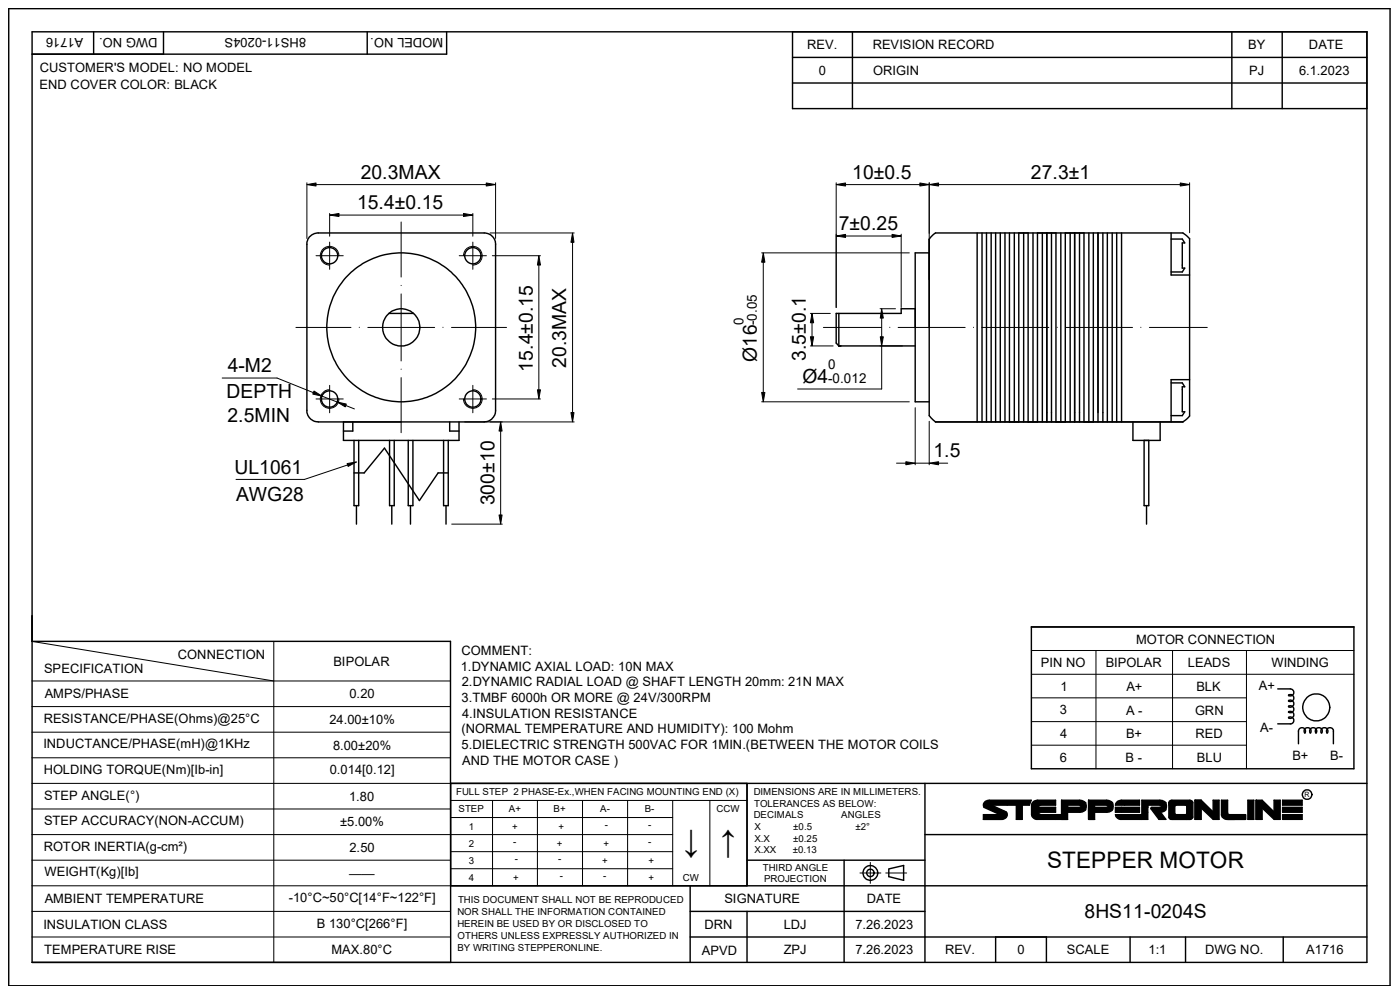
[picture p33: page 1]
REV.; REVISION RECORD; DATE 0; ORIGIN; BY SIGNATURE; DATE APVD DRN; SCALE; DWG NO. CUSTOMER'S MODEL: DWG NO.; MODEL NO.; DIMENSIONS ARE IN MILLIMETERS. TOLERANCES AS BELOW: DECIMALS; ANGLES X; ±0.13 THIS DOCUMENT SHALL NOT BE REPRODUCED NOR SHALL THE INFORMATION CONTAINED HEREIN BE USED BY OR DISCLOSED TO OTHERS UNLESS EXPRESSLY AUTHORIZED IN BY WRITING STEPPERONLINE.; THIRD ANGLE PROJECTION; R END COVER COLOR: BLACK NO MODEL; 6.1.2023 7.26.2023 7.26.2023 ZPJ LDJ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

+ | ++ | - FULL STEP 2 PHASE-Ex.,WHEN FACING MOUNTING END (X) + + | ↓ | CCW ↑ CW
4 1 | A+ | B+ | A-- | B- +

3 | + | -- | - | + -
