badinkajink/hand/configs/recipes/perp_single.yaml

# perp_single — SINGLE-STAGE lift+reorient on the perpendicular (opposed-pair) hand.
#
# Why single-stage: on the perp topology lift and reorient are the SAME motion (gravity does
# the pitch once the shaft is pinched off its COM), and the A->B seam is MEASURED to be what
# breaks it — two independently trained B policies (b33-warmstart and from-scratch) both eject
# the shaft at the switch step, while the same A driving the whole rollout with no switch holds
# perfectly (obj-z 0.111, drift 0.0 cm). The grip window spans hold-but-no-rotation to dropped
# over 9 mm of pad set-point, so any discontinuity in finger targets lands outside it.
# See docs/rl/perp_topology.md.
#
# Differences from a_lift, all deliberate:
#   * term_object_slip_yaw 10.0 — a_lift's 0.5 rad gate fires on the gravity PITCH, which is the
#     task here, not a fault. With the gate on, "don't lift at all" is the only reliable way to
#     avoid rotating, and PPO found exactly that (policyA_perp collapsed at iter 44).
#   * the target-axis reward is ON from just after the lift, so the pitch is PAID for rather
#     than merely tolerated. Relaxing the termination alone was not enough: a_lift still rewards
#     holding the object still, so A clamped (thumb 22 N) and peak cos came out at 0.014.
#   * floor-proximity termination ON — forbids the floor-bracing shortcut (gotcha: v4 learned to
#     use the ground as a pivot). Requires the taller lift below.
#
# Lift height is a RUN knob but must be >= ~0.12: hanging vertical puts the shaft's centre
# 0.035 m below the pinch and its lower end 0.085 m below, so a 0.10 lift leaves only 24 mm of
# floor clearance and the floor-proximity gate false-fires. Launcher uses 0.14.
#
# REVISION 2 (2026-07-31), after run 20260729-1316-perp_single_freeRot came back at held-cos
# -0.449. That run is the evidence for every change below; the reward table alone said "still
# won't rotate", and the render said the opposite — it rotates at full magnitude to the WRONG
# POLE. Three separate defects, none of them a weight:
#   1. the reorient reward was gated to step 65, and the pole is chosen between step 20 and 50
#      (during the lift ramp) -> both reorient terms were spectators to the only decision made;
#   2. the grip set-point was inherited from CEM, which optimises force closure and lands at
#      ~21 N per finger — outside the 4-9 N window the pitch needs (open-loop 0.298 vs 0.957);
#   3. `contact_min`/`grip_force` were paid every step, so "hold tight" was rewarded during the
#      swing that requires a loose pinch.
object_body_name: screwdriver_medium

# --- 12 s, NOT 5 s: the learned reorient is SLOW because it holds on ---
# Revision 2 produced the first perp policy that reorients WITHOUT releasing (held-cos rises
# monotonically, grip maintained 10-27 N, object z 0.111-0.145 throughout — see below), but it
# takes ~480 steps to get there, where the open-loop gravity swing takes ~120. That is not a
# defect, it is the price of holding: the gravity version reaches vertical BY letting the shaft
# slide out of the pinch, and a policy that refuses to do that has to walk the shaft around
# between the two pads instead, which is slower. Traced past its own horizon, revision 2 does:
#
#     step |   0   | 100  | 200  | 300  | 400  | 484   | 500  | 520
#     cos  | 0.000 |0.296 |0.441 |0.615 |0.848 |+0.947 |0.940 |0.000
#     z    | 0.012 |0.141 |0.134 |0.125 |0.115 | 0.111 |0.111 |0.012
#     grip | 17.5  | 20.2 | 22.5 | 24.5 | 22.3 | ~10   | 6.2  | 0.00
#
# At the old 250-step horizon the episode ended at cos ~0.52 with the rotation still in
# progress, so the policy was scored mid-manoeuvre and the whole completion+hold was untrained
# extrapolation (which is where it eventually loses the shaft, at ~step 510). 600 steps covers
# the rotation with ~120 steps of scored hold after it.
episode_length_s: 12.0

# --- init_noise_std 0.05, NOT the 0.3 default: the perp scene NaNs above ~0.1 ---
# This is a HARD requirement, not a tuning preference. The perp hand is dynamically fragile
# under exploratory actions in a way the baseline hand is not: with zero actions the scene is
# perfectly stable (max|qvel| ~0.05 over 260 steps), but random actions drive a contact to
# divergence and one env in ~512 goes NaN within ~14 steps, which aborts the whole run because
# rsl_rl's check_nan sees the NaN in the shared obs tensor. Measured, 512 envs, 260 steps:
#
#     init_std | 0.05          | 0.15         | 0.5          | 1.0
#     result   | clean, |qvel| | NaN @ step   | NaN @ step   | NaN @ step 12,
#              | max ~15       | 227          | 14           | |qvel| 2e13
#
# The first perp run that trained clean (20260729-1316, 339 iters) passed 0.05 as a bare CLI
# flag, so it was invisible to anyone reading the recipe — and the very next launch off the
# recipe alone inherited the 0.3 default and died at iteration 0. That is exactly the flag-soup
# parity bug the recipe layer exists to prevent, so it is pinned here. Do not raise it without
# re-running the divergence check (scratch probe: zero-action vs randn*std, watch max|qvel|).
init_noise_std: 0.05

# --- the grip SET-POINT is the authored keyframe, NOT the CEM grasp ---
# Measured open-loop on the same frozen scene: CEM grip -> final cos 0.298, authored `closed`
# (8.3 N, symmetric) -> +0.957. CEM's objective (force closure => clamp hard, break symmetry to
# wedge) is directly opposed to the reorient mechanism (light symmetric off-COM pinch that lets
# the shaft pivot). This one line moves the run's STARTING point from outside the force window
# to inside it; the learned residual then has something worth perturbing.
closed_ctrl_from_keyframe: closed

# train/deploy parity (gotcha #13) — must match sr2hand.rl.deploy.make_env_cfg
finger_residual_scale: 0.5
finger_close_easing: ease_out_quad
contact_gate_stability_rewards: true

# --- terminations: PITCH IS THE GOAL ---
enable_lift_terminations: true
lift_phase_start_step: 60
term_object_drop: 0.02
term_object_slip_xy: 0.5
term_object_slip_yaw: 10.0
term_finger_slip: 100.0
term_tip_lost_steps: 3
enable_floor_proximity_termination: true
# 0.09, NOT the 0.05 default. The shaft is 100 mm long, so one dropped upright and left STANDING
# ON THE FLOOR has its centre at z = 0.0500 — which is not < 0.05, so the gate never fires, while
# `target_axis_alignment` reads a perfect +1.000 forever. That degenerate optimum is reachable on
# this topology and on no other, because here the object ends the episode vertical by design.
# Measured, not hypothetical: the open-loop probe run past its usual horizon ends exactly there
# (grip 0.00 N, cos +1.000, z 0.050). Properly held-vertical sits at z ~ 0.113, so 0.09 separates
# them cleanly. Raise this with the lift height, never below half the object's length.
object_min_z: 0.09
# 50, not 80. The reorient reward now starts at 25 (below), so without this the floor-bracing
# shortcut — roll the shaft upright against the ground, the v4 failure — is payable for a
# 55-step window. The lift is complete by step 40 (z 0.165), so 50 forbids the shortcut without
# firing on the legitimate lift.
floor_proximity_phase_start_step: 50

# --- SILENCE THE ANTI-ROTATION TERMS ---
# Measured in run 20260729-1225-perp_single (peak cos 0.015 — it clamped): removing the
# orientation TERMINATION is not enough, because two base REWARD terms still pay for keeping the
# shaft at its spawn orientation, and together they out-vote the reorient reward:
#     object_orientation_drift  -0.93   (penalty for rotating away from spawn)
#     track_object_quat         +0.72   (reward for matching spawn quat)
#     target_axis_alignment     +0.115  <- the term that wants the pitch
#     target_axis_progress      -0.18
# ~1.65 of pressure against rotating vs 0.115 for it. Both are zeroed here.
object_orientation_drift_weight: 0.0
track_object_quat_weight: 0.0

# --- reorient: pay for the pitch, WHILE IT IS BEING DECIDED ---
enable_target_axis_reward: true
target_axis_weight: 250.0
# alpha 2.0, was 4.0. `target_axis_alignment` is exp(-alpha*(1-cos)^2), which at alpha=4 is
# ~1e-7 for cos <= -0.5: the entire negative half of the sphere is flat, so a full-magnitude
# rotation to the wrong pole is scored identically to never having moved. That is why the
# previous run's table showed alignment ~0.03 and read as "won't rotate". alpha=2 keeps a
# usable gradient across the whole range (cos 0 -> 0.14, cos -0.45 -> 0.017) so wrong-way is
# distinguishable from motionless.
target_axis_alpha: 2.0
target_axis_progress_weight: 600.0
# 25, was 65 — THE load-bearing change. `target_axis_progress` is the only signed term (it is a
# per-step delta, so it pays for rotating the right way and charges for the wrong way), and it
# was switched off until step 65. The measured cos trace commits by step 50 and is already at
# -0.30 by step 40. Starting at 25 puts the signed reward inside the window where the pole is
# actually chosen; 25 rather than 0 keeps it off until the object is off the floor (z 0.011 at
# step 20 -> 0.123 at step 30).
reorient_start_step: 25

# --- grip: THIS IS A TWO-FINGER HAND FOR THIS TASK ---
# The previous revision tried to RECRUIT the thumb here (reduce=min, so an idle finger caps the
# term). That objective is now known to be unreachable: the thumb cannot contact the shaft at
# any pinch offset that still permits the gravity reorient — it is 0 N throughout the +0.957
# open-loop swing, the offsets where it does bear load flatten the swing to cos 0.168, and
# thumb_x forward is inside the palm (499-690 N). Asking for it anyway does not produce a
# 3-finger grip, it produces terms that are identically zero:
#   * tip_lost required all 3 tips -> every episode terminated ~3 steps after the lift phase
#     opened (mean episode length 62 of 250), so nothing past the lift was ever trained;
#   * contact_min = min over 3 tips -> flat 0.0 all run, an active-looking row worth nothing;
#   * grip_force reduce=min -> flat 0.0 for the same reason.
# So the required-contact count is 2 and grip_force reduces over the mean. The drop, slip and
# floor-proximity guards are untouched, and losing either OPPOSED finger still terminates.
min_tips_in_contact: 2
contact_min_weight: 8.0
grip_force_weight: 1.0
grip_force_reduce: mean
grip_force_max: 3.0
grip_force_spread_weight: 1.0
grip_force_spread_scale: 4.0
# The grip is a SCHEDULE, not a preference — the piece the env could not previously express.
# Paying for grip during the swing is self-defeating: the reorient is grip-force-gated (window
# ~4-9 N/finger; above ~10 N the opposed pair stops being a pin joint and the pitch is choked
# off). But the shaft also rotates to vertical BY SLIDING OUT of the pinch — grip force and
# alignment were measured anti-correlated all the way to 0.00 N, ending with the screwdriver
# standing on the floor — so after the swing the grip must firm up or there is no hold at all.
# Gating it (with object_ang_acc below, so the whole "settle" block turns on together) leaves
# the swing unpriced and pays for the catch. This is the two-phase grip schedule expressed as a
# REWARD for the policy to learn, rather than a scripted ramp.
#
# GATED ON ROTATION, NOT ON A STEP COUNT. Both step-gate attempts failed, in opposite
# directions, and that is what makes the case: 150 covered less than a third of a manoeuvre
# that took 480 steps; 450 then missed entirely, because under the longer horizon the episodes
# shortened to ~165 and the gate was never reached. A step gate has to be guessed from the
# PREVIOUS run's trajectory and is invalidated by the very learning it is meant to shape.
#
# Revision 3 showed what that costs. It peaked at iteration 50 and then degraded monotonically
# to the NaN at 188 — reward 883 -> 430, target_axis_alignment 59.5 -> 28.8, episode length
# 362 -> 165. With the catch unreachable, the only way left to stop losing the shaft at the top
# of the rotation was to stop rotating, and PPO took it. That is the grip/alignment trade-off
# reasserting itself once the horizon was long enough to expose the drop as a terminal penalty.
#
# An alignment gate cannot drift that way: it fires exactly when there is something worth
# holding on to, however long the policy took to get there. 0.7 is past the point where the
# pinch starts to unload (revision 2 unloads from ~0.90) but well inside what it reaches.
grip_phase_start_step: 0
grip_phase_align_thresh: 0.7

# --- stabilize, but only AFTER the swing ---
# object_ang_acc penalises angular acceleration, which the gravity swing NEEDS. Gating it to
# step 150 (of 250) damps the settle at the end instead of fighting the rotation that gets us
# there.
object_ang_acc_weight: 0.5
# 450, tracking grip_phase_start_step — same reason, same re-measure caveat.
object_ang_acc_phase_start_step: 450
lateral_drift_weight: -8.0
lateral_drift_deadband: 0.01
lateral_drift_power: 2.0

# wandb ON. Credentials are already in ~/.netrc, the trainer already syncs the full scalar
# set, and the curves it builds are the ones that diagnosed revisions 2-4: reward, episode
# length, action std and object height side by side is what showed r3 peaking at iteration 50
# and degrading from there, while the reward number alone looked fine at the time. Offline
# equivalent (no network / sweeps): `--no-wandb` plus scripts/rl/rl_plot_training.py, which reads
# the tensorboard logs every run writes regardless.
wandb: true
wandb_tags: [perp, single_stage, reorient]
