badinkajink/hand/(commit log)

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2026-04-10 broken hand
    [hand.xml, scene.xml]
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2026-04-30 docs: add April 30 grasp+lift+reorientation experiment analysis
    - Document runs 8-11 debugging the power drill grasp task.
    - Capture root causes: live morph joints, wrong pivot axis, contact degradation.
    - Document fixes: frozen morphology scene, TrajectoryInterpolator, improved objectives.
    - Add experimental results and next steps for improving contact persistence.
    - Add code quality observations and completed refactoring notes.
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2026-05-01 refactor(sampling): cube-orientation feasibility + nested seed traversal + shared asset rebaser
    - FeasibilityCriteria gains cube_xy/yaw/axis_tilt/ang_drift cutoffs so multi-task drivers can
    enforce per-keyframe object stability (vertical pose tolerances differ from horizontal).
    - load_foundational_poses[_with_scene] now walks nested seed_*/run_* layouts (used by run8
    drill foundationals) instead of failing on the missing top-level summary.json.
    - Promote rebase_asset_file_paths to a public helper in tools/morphology_xml; sampling/scene
    imports it instead of carrying its own copy. create_rigid_morphology_xml also strips morph
    qpos entries from baked keyframes so the rigid scene's keyf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
2026-05-01 refactor(phase1): dedupe scalar/trajectory paths in evaluator + CEM
    The trajectory work landed near-verbatim copies of evaluate(), rollout(), render_rollout_gif(),
    and the CEM loop. Collapsed each pair onto a shared body that takes a finger-control provider
    (`get_finger_ctrl(dynamic_t) -> np.ndarray`).
    Phase1GraspEvaluator:
    - _pose_scales_for_dynamic_step: single source of truth for lift/pivot ramping.
    - _ctrl_for_dynamic_step: composes scales with _build_pose_ctrl.
    - _compute_score_and_metrics: the (formerly duplicated) scoring formula and metrics dict.
    - _run_dynamic_loop_sampled / _run_dynamic_loop_terminal: lift→pivot→hold loops; terminal
    branch preserved for the warp-ba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
2026-05-01 feat(phase1): pivot phase + cube-orientation penalties + frozen-scene grasp protocol
    Driver-side wiring for the trajectory grasp work and the new run7/run8 launchers.
    phase1_optimize_grasp.py:
    - --traj-phases routes to optimize_finger_control_trajectory (still defaults to scalar).
    - --pivot-{steps,ramp-steps,delta-rx/ry/rz} expose the new dynamic phase.
    - --objective-weight-cube-{yaw-drift,axis-tilt,ang-drift}-penalty for the new metrics.
    - Always emits a frozen_scene.xml in the output dir (morph joints baked from the keyframe)
    and runs the optimization against the frozen copy so contact metrics aren't polluted by
    live morph DOFs.
    run6_combined_multitask.py / run6_screwdriv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
    [scene_power_drill_short_proximal.xml, scene_screwdriver_medium_capsuletips.xml]
2026-05-01 docs: run7/run8 recovery notes, frozen-scene protocol, Run 12 results, refactor summary
    - README: document the frozen-scene grasp protocol and the power-drill-specific gotchas
    (short-proximal scene is the manual-tuning target; pivot is forward → down; six contacts
    usually means the middle finger never engaged).
    - overview: add a Trajectory-Based Optimization section pointing at evaluate_trajectory and
    the new --traj-phases path.
    - 4-30 experiments: log Run 12 (best 16.287, lift 0.117, contacts 4 but per-finger
    persistence 1.0). The "contacts" metric is now ambiguous under the 8-sphere drill collision
    proxy — the per-finger persistence shows all three tips engaged the whole pivo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
2026-05-12 fix(eval): enforce frozen-scene protocol; wire top-level docs
    Background: scenes under assets/mjcf/ still carry per-finger morphology
    DOFs (thumb_x, thumb_y, thumb_len, ...) as unactuated joints. They DRIFT
    during the rollout under contact and inertial forces, silently changing
    the "fixed" morphology and invalidating any cross-method comparison.
    Protocol enforcement:
    * src/morphohand/sampling/scene.py: new public helper
    freeze_scene_for_eval(scene_xml, keyframe, frozen_scene_xml). Bakes
    morphology into body transforms via create_rigid_morphology_xml when
    the source has morph joints; copies verbatim otherwise. The output
    path is always "frozen and ready" so callers don't need to bran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
2026-05-22 add scenes for shortened proximal phalanges
    [scene_cube_short_proximal.xml, scene_power_drill_short_proximal_capsuletips.xml, scene_power_drill_short_proximal_rigid.xml, scene_power_drill_short_proximal_rigid_capsuletips.xml, scene_prism_short_proximal.xml, scene_screwdriver_medium_flat_short_proximal.xml, scene_screwdriver_medium_short_proximal.xml, scene_screwdriver_medium_vertical.xml]
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2026-06-01 rl: in-hand reorient task — env_cfg + reward + termination scaffolding
    Adds the configurable knobs and term implementations that the v2/v3/v4/v5
    reorient runs and Policy B exercised. All previously absent from main; this
    commit restores the env code used to train Policy B (model_2000.pt).
    env_cfg.py additions:
    - skip_lift_phase: spawn cylinder + fingers + palm at the post-lift pose,
    cylinder slightly above grip so it falls into contact (skip_lift_drop_offset).
    Used by Policy B; lets phase-2 training focus exclusively on rotation.
    - enable_target_axis_reward + target_axis_{weight,alpha,object_local,world}:
    exp(-alpha * (1-cos)^2) reward on object-axis to target-axis alignme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
2026-06-02 rl(reorient): smooth & quick curriculum for Policy B v2 finetune
    Adds knobs to iterate off Policy B v1 toward smooth, fast, held-at-vertical
    reorientation (all off by default — Policy B v1 config is unchanged):
    - Smoothness-weight ramp curriculum (anneal_smoothness_weights): linearly
    dial action_rate_l2 / object_ang_acc_l2 weights base->final over
    [start_iter, start_iter+iters], so a warmstarted policy keeps its rotation
    while penalties rise. Mirrors anneal_tracking_weights.
    - Signed target_axis_progress exposed via --target-axis-progress-clamp-negative
    (default signed): penalizes slipping back down (v1 slip-back fix).
    - Three "quick / shorter trajectory" incentives, each independ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
2026-06-02 rl(reorient): assess Policy B v2 Stage 1 — 5x smoothness wins
    Stage-1 finetune of Policy B v1 (smoothness ramp + signed progress, no
    quick mechanisms) swept the smoothness target 5x vs 10x at 30M ts.
    5x halves raw object angular jerk (~50 -> 24.5) while holding alignment
    (80 vs v1 87), improving progress (+0.50 vs +0.25, signed penalty kills
    slip-back), and preserving grip (tip_lost ~1.0 ~= v1 1.17). 10x
    over-penalized: rotation collapsed (align 43, progress +0.14) and grip
    degraded (tip_lost 4.4 rising). 5x chosen for Stage 2 warmstart.
    - scripts/rl_render_reorient.py: phase-B-only verification renderer that
    rebuilds each run's exact skip-lift env from its config.yaml and tracks
    min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
2026-06-02 scripts(rl): soften Stage-2 quick mechanisms + anchor smoothness base
    Stage 2 (QUICK=1) warmstarts from the Stage-1 5x FINAL policy. Two edits
    to protect its hard-won grip (the earlier all-quick-from-iter-0 run spiked
    tip_lost to ~22/iter):
    1. Start the smoothness ramp BASE at the warmstart's level (-0.5/-0.25 when
    QUICK=1, vs -0.1/-0.05 for Stage 1) so the penalty never dips below the
    warmstart at iter 0 and lets jitter/grip regress before the ramp climbs.
    2. Soften quick rewards: success_bonus 50->30, time_cost -0.05->-0.02,
    speed_bonus 20->15 — nudge toward speed without overpowering rotation/grip.
2026-06-02 rl(reorient): assess Policy B v2 Stage 2 — quick mechanisms regress; 10x-quick wins on smoothness/grip
    Stage 2 warmstarted the Stage-1 5x ckpt and added the quick mechanisms
    (alignment-success termination + bonus, time cost, speed bonus) over the
    smoothness ramp. Findings:
    - s2-5x-quick: ~10% shorter episodes but via threshold-gaming — progress
    collapsed to ~0, grip worse (tip_lost 1.6->2.58), hand jerkier. Not shippable.
    - s2-10x-quick: quick terms near-inert; warmstart+gentle 10x ramp rescued the
    10x regime that failed in Stage 1. Smoothest (raw jitter 1.15/9.0), best grip
    (tip_lost 0.63), holds vertical highest (min-z 0.120 m), still rotates (align
    75, progress +0.33). Recomm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
2026-06-02 rl(reorient): de-centering penalty (palm-frame lateral drift, deadband+quadratic)
    Workstream A toward Policy B v2.1. Adds object_lateral_drift[_gated]: penalizes
    the object's palm-frame xy displacement from spawn past a deadband, quadratic
    beyond, contact-gated like the other stability terms. Targets the v2 emergent
    "slide the cylinder sideways to reorient" de-centering (index/middle MCP+PIP in,
    thumb out) while leaving the small regrip translations rotation needs free.
    Knobs (off by default; existing configs unchanged): --lateral-drift-weight,
    --lateral-drift-deadband, --lateral-drift-power. Verified the resolved mjlab cfg
    registers the gated term with correct params.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
2026-06-02 rl(reorient): continuous single-env A->B handoff (no reset) + distribution-gap finding
    Workstream B. rl_demo_handoff_continuous.py rolls out ONE env with no reset: it
    builds the env in B-mode (66-dim, normal lift to 0.10m), feeds Policy A obs[:,:65]
    (A is 65-dim; B adds target_axis_misalign appended last) through the lift, then
    switches to Policy B's actions on the same physics state. This removes the visual
    "teleport" of the two-env concat demo.
    FINDING: the mechanism is seamless, but Policy B *drops* the cylinder shortly after
    the handoff (z=0.097 at handoff, object gone by ~step 75). This is the real
    skip-lift->normal-lift distribution gap: B was trained spawning at a precise
    lifted+grip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
2026-06-02 rl(reorient): dense palm-brace distance shaping (bracing is otherwise unreachable)
    Diagnostic finding: with the de-centering winner's grip, the cylinder's nearer end
    never gets closer than ~7.7cm to the palm plate (palm contact found=0, force=0) even
    though it reorients to cos 0.90. So the sparse palm_brace_force reward can never fire.
    Adds palm_brace_distance: dense exp(-gap/scale) reward pulling the cylinder's nearer
    end toward the palm plate, gated on alignment + reorient phase — the gradient needed
    to draw the end up into the palm. brace launcher now sweeps the dense-distance weight
    (8 vs 20) with sparse force (15) + grip (5) fixed; this tests whether the ~8cm gap can
    be closed at all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
2026-06-02 docs(rl): document de-centering fix (v2.1 w40) + continuous-handoff finding
    - Phase Policy B v2.1: object_lateral_drift de-centering fix; -40 winner cuts
    lateral drift ~36% while preserving alignment (76) + improving grip (0.25).
    New recommended reorient policy + Phase-3 warmstart.
    - Continuous A->B handoff: single-env no-reset mechanism works (no teleport);
    documents the distribution-gap finding (B drops post-handoff) + the fix.
    - Phase 3 bracing: documents the 7.7cm palm-gap diagnostic that motivated the
    dense palm_brace_distance shaping; sweep in progress.
    - rl_plot_reorient: add v2.1 de-centering run to the v2 comparison figure.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
2026-06-02 docs(rl): Phase 3 bracing — NEGATIVE result (not reachable fingers-only + this grip)
    Bracing sweep killed at ~330 iters: dense shaping barely moved the cylinder end
    (7.7->7.1cm from palm), palm contact force stayed 0, and the brace objective degraded
    reorientation (align 76->18-33). Root cause geometric: CEM grasp holds the cylinder
    ~7-8cm below the palm and finger residuals can't translate it up that far. Documents
    the three geometry options to actually enable bracing (re-grip higher / allow palm
    motion / brace against fingers). Sensing+reward scaffolding retained and correct.
2026-06-02 rl: warmstart the CRITIC (+optional optimizer), not just the actor — fixes v2 verticality regression
    Root cause of the v2 reorient regression (held-vertical cos 0.97 -> 0.66, found via an
    ablation whose CONTROL — v1 re-finetuned with no changes — itself collapsed): the warmstart
    loaded only actor_state_dict and discarded the checkpoint's critic_state_dict, so every
    finetune began with a fresh random value function. The garbage early advantages push the
    converged actor off its optimum, and ~800 finetune iters can't recover. Now also partial-load
    the critic (same grow-and-zero-init rule as the actor) by default (--warmstart-critic), and
    optionally the optimizer (--warmstart-optimizer, of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
2026-06-02 docs(rl): critic-warmstart bug correction + honest held-cos/jerk eval harness
    Documents the session's key finding: the entire v2 verticality regression was a
    finetune bug (warmstart discarded the critic), not the rewards. Adds a correction
    banner to the v2 sections and a full "CRITICAL CORRECTION" writeup: deterministic
    held-cos (v1 0.97 vs v2 0.83-0.87), the control-collapse ablation, the fix and its
    validation (control 0.66->0.96, signed 0.84->0.978), the debunked de-centering claim,
    and the remaining smoothness<->verticality tradeoff. Adds scripts/rl_eval_reorient_metrics.py
    — the deterministic harness (held_cos / peak / obj_jerk / min_z / drop) to be used for
    all reorient claims instea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
2026-06-03 docs(rl): definitive critic-fixed re-runs — signed+critic is the best reorienter
    Re-ran Stage-1 smoothness (5x/10x), quick mechanisms, and de-centering ON TOP of the
    clean signed+critic base, all with the critic fix, judged on deterministic held-cos+jerk.
    Result: EVERY reward elaboration degrades the policy (held 0.98 -> ~0.7-0.78, jerk up).
    The vertical hold is a fragile optimum; competing objectives pull the policy off it (the
    buggy-critic runs masked this). Recommended reorientation policy = signed+critic
    (model_405): held cos 0.978 (> v1 0.96), slip-back fixed, stays aloft; video added.
    Documents where smoothness (non-reward lever needed), de-centering (not a real root-drift
    problem),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
2026-06-03 scripts(rl): train normal-lift B + auto-render seamless A->B handoff
    The no-reset continuous handoff works mechanically but skip-lift-trained B drops the
    cylinder at handoff (off-distribution vs A's real lift). This finetunes B in the
    normal-lift env (real lift, reorient gated after) from signed+critic so it holds through
    the handoff, then auto-renders the seamless single-env (no-reset) handoff video.
2026-06-03 docs(rl): correct de-centering (REAL, 5.1cm) + bracing (~3cm vertical, almost) claims
    Two earlier diagnostic readings were buggy. Ground-truthed: de-centering is real
    (signed+critic 5.1cm lateral vs v1 2.9cm); bracing is close (cos 0.99, top end ~3cm
    below palm vertically, no contact) not the ~7-8cm wall implied before.
2026-06-03 rl: gate policy finger-residual to start post-lift (fixes normal-lift warmstart NaN)
    A reorient-trained (skip-lift) policy is out-of-distribution on the flat-object grasp;
    its residuals blew up the physics (NaN at iter 0) when finetuning in the normal-lift env.
    Add LerpFinger residual_active_from_sim_step (CLI --finger-residual-active-from-step):
    zero the policy residual during the scripted grasp/lift, policy acts only after. Used by
    the normal-lift B training so it learns to take over post-lift (seamless-handoff compatible).
2026-06-03 docs(rl): seamless-handoff diagnosis — fingers freak out = B is OOD at the seam
    The post-lift finger 'freak out' is Policy B being out-of-distribution at the handoff
    (trained on its exact skip-lift spawn; A's real lift delivers a different state). Documents
    the failed single-policy normal-lift retrain (catch-22: residual-on NaNs, residual-off makes
    the scripted grip too weak -> object at 0.06, alignment stuck 1.7) and the correct fix:
    make B robust to A's terminal state via train-the-handoff or skip-lift spawn DR. Removed the
    invalid seamless video (rendered from an untrained model_0 after the crashed run).
2026-06-03 rl: skip-lift spawn DR (tilt + height jitter) for handoff robustness
    Adds spawn_tilt_range (roll/pitch) to LiftingCommandWithBaseQuat + skip_lift_spawn_tilt_jitter
    / skip_lift_spawn_z_jitter knobs: jitter the lifted spawn orientation+height each reset so a
    skip-lift reorient policy tolerates the varied pose a real Policy-A lift hands off (the
    out-of-distribution seam that makes B's fingers freak out + drop at handoff).
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2026-06-03 rl: handoff-DR curriculum (gradual spawn tilt/z ramp) for grip adaptation
    anneal_spawn_tilt_z + --handoff-dr-curriculum-iters: ramp the skip-lift spawn tilt/height
    jitter from 0 to max over N iters so a warmstarted grip adapts gradually (fixed high DR
    collapsed it: 152 drops/iter). Pairs with the lateral-drift penalty to also curb de-centering.
2026-06-03 rl: train-the-handoff state bank (record A's terminal states, spawn B from them)
    rl_record_handoff_states.py records Policy A's post-lift terminal states (object pose+vel,
    robot qpos) into an npz bank. reset_from_handoff_bank injects sampled bank states on reset;
    when handoff_state_bank is set the LiftingCommand object-pose write is disabled so the bank
    state is the spawn. Lets Policy B train on A's exact physically-valid handoff grips (the
    principled fix vs synthetic spawn DR, which over-constrains/diverges).
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2026-06-04 scripts(rl): training crash/stall watchdog
    Polls the train log and flags PROCESS_DEAD / LOG_STALLED / NaN-Traceback — the
    failure modes the bursty 1%-GPU-util reading hides. Writes status to
    results/rl/training_watchdog.log and touches a FLAG_FILE on crash so a supervising
    loop can detect it. Detected: a single 3072-env run is ~3.1GB GPU (4.3GB total
    incl. desktop is normal, not a crash).
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2026-06-04 docs(rl): v3b grace-window outcome — both variants collapsed (no seamless handoff)
    Ran to completion (NaN-resilient), but reward plateaued flat ~9.3 the whole
    run and never learned the post-grace reorient. Deterministic held-cos -0.035
    (repro)/-0.078 (soft), 100% drop; handoff min-z 0.004/0.007 << 0.05. Grace
    window prevented v2 training collapse but locked B in a hold-then-drop local
    optimum. Documented 3 candidate next steps (warmstart hold-only > state-bank >
    longer), none run.
2026-06-04 docs(webpaper): Typst→HTML project site (3 pillars) + branch-D critic-gated handoff
    Comprehensive paper-style web docs (Typst HTML export): morphology/grasp
    optimization (bi-level, GWS ε-metric, CEM inner loop, MAP-Elites/CMA-ME outer
    loop), RL manipulation (MDP, 66-d obs, reward design, B-registry naming,
    policy-switching branch A–F analysis), hardware validation (object-set
    specificity, 18-DOF split). Collapsible deep-dives + Full-paper-view toggle;
    inline math as Unicode, display math as SVG; videos embedded.
    Branch D: rl_demo_handoff_continuous.py --switch-on-critic times the A→B
    handoff from B's value peak instead of a fixed step. Negative result: B4's
    critic is OOD on the norma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
2026-06-04 docs(webpaper): port morphology experiment results; handoff fix script (B10/B11)
    webpaper: morphology Results section fully ported from paper/main.tex — pre-grasp
    baselines, 1000-morphology sweep, foundational-pose adaptation ablation, eval-suite
    (contact-target vs baseline 9D CEM) with scores/deltas figures, frozen-scene
    quantification, and the drill pivot-to-down case study. Fixed refbox italics broken
    by the underscore-escape pass.
    handoff: train_normallift_B_holdonly_warmstart.sh — grace-window normal-lift finetune
    warmstarted from the v3 HOLD-ONLY control (in-distribution on A's delivery) instead of
    the OOD skip-lift B4, per the v3b-collapse + branch-D findings. 65->66-dim partial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
2026-06-05 rl: Branch B — deploy-matched env (drop finger-slip terms that fight grip nudge) + weight sweep 4/8/16
    SMOKE1 collapsed: term_finger_slip 0.3 fired on every env because the
    grip-proximity reward moves the fingers. SMOKE2 (terms/finger-drift dropped,
    deploy-matched, no jitter) holds the grip (contact 5.7) and the proximity reward
    rises cleanly with no NaN. Sweep weight since native track_finger_qpos opposes
    the nudge in the seam window.
2026-06-05 rl: branch-B v2 — diagnose v1 collapse, restore A's guardrails
    Branch-B v1 (un-freeze A, gripw4/8/16) failed: it stripped ALL of A's
    lift-phase terminations, so object-on-floor became a stable non-terminating
    attractor and PPO collapsed A's grasp at iter ~25 (object_height 0.09->0.013,
    contact_min 6.6->0.008); the grip-proximity reward never engaged (~0.02), so
    the grip-match hypothesis was never tested. All 3 also OOM-killed (rc=137).
    v2 (train_handoff_branchB_v2.sh): change ONE thing vs A's OWN training env —
    restore enable_lift_terminations + term_object_drop (A trained with them),
    relax ONLY term_finger_slip 0.3->2.0 so the grip may migrate toward B10's pose
    without tripping the sli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
2026-06-05 rl: branch-B v2 — fix collapse (relax object-slip) + widen grip basin
    Two failure modes found by running it:
    1. v2 attempt-1 (gripw2.0): --enable-lift-terminations also turns on A's tight
    object-slip guards (xy 0.015 m / yaw 0.5 rad); migrating the grip nudges the
    object past 1.5 cm so object_slip fired 100+/iter from iter 1 and killed every
    episode. FIX: keep the DROP guard tight, relax object-slip to 0.05 m / 1.0 rad.
    -> collapse solved: object_height held ~0.088 through iter 55 (was 0.013 @25).
    2. attempt-2 (gripw2_slip5): grasp stable but handoff_target_proximity flat at
    ~0.002 — qpos_tol 0.05 vs the ~0.16-rad grip gap is ~3sigma into the tail (reward
    AND gradient ~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
2026-06-05 rl: branch-B v2 ran to completion — trains clean, seam still open
    Both unfreezeA v2 runs (w2_tol15/tol20, 20M/3072) trained stably to iter 270
    (object_height ~0.10 throughout) and migrated A's grip partway toward B10's
    (proximity 0.002->0.026/0.037, plateaued). Continuous-handoff eval vs frozen
    B10 (model_541, handoff@40): min-z 0.0049 (tol15) / 0.0073 (tol20) vs B10-alone
    0.0029 — survival rose monotonically with migration but still ~7x short of the
    0.05 bar; object hits the floor. Grip-match is real but insufficient: A resists
    fully adopting B10's grip. Next: adapt B to A's delivery (record A's real seam
    grip, DR B's onset over it) rather than push A further.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
2026-06-05 rl: adapt-B-to-A — train B4 reorienter from A's real-delivery bank
    Branch B (move A) stalled, so pivot to the symmetric move: leave A frozen,
    make B robust to A's actual delivered grip. Recorded A's real seam states
    (grip+pose+vel) from frozen A model_500 in the normal-lift env @step40
    (handoff_state_bank_A_s40.npz, 2048/2048 kept, z=0.111). train_handoff_adaptB_to_A.sh
    warmstarts B4 (best reorienter, 0.988) + resets from that bank (skip-lift mode) —
    "B6 done right" (better warmstart + verified fresh bank). Collapse watchdog armed.
    Known risk: skip-lift obs schedule may still be OOD vs continuous deploy.
2026-06-09 rl: adapt-B-to-A ran — seam still open; obs-schedule isolated as the binding constraint
    adapt-B-to-A (warmstart B4 + A's real-delivery bank, leave A frozen) trained clean
    to iter 270 (object held +0.012, no collapse) but the continuous-handoff eval gives
    min-z 0.0028 — tied with B10-alone, worse than branch-B tol20 (0.0073), << 0.05 bar.
    Run dir results/rl/20260608-1738-policyB_adaptToA_bankA_s40; video handoff_adaptB.mp4.
    This closes the "put A's real delivery STATE into B's training distribution" branch:
    the bank only fires in skip-lift (env_cfg.py:1140), so B still trained under the
    skip-lift OBSERVATION schedule -> the binding constraint is the obs schedule, not the
    state. Branch-B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
2026-06-09 rl: normal-lift onset-grip injection — new mechanism for the handoff seam
    The untried combination: train B in the normal-lift env (obs schedule == deploy)
    AND inject A's real delivered state at the handoff onset (state == deploy). adapt-B
    proved state-in-distribution alone (skip-lift bank) is insufficient because B stays
    obs-OOD; branch-B proved moving A is insufficient. This matches both at once.
    - mjlab_terms.inject_handoff_bank_at_onset: step-mode event, once per episode at
    episode_length_buf == onset_step, overwrites object pose+vel + robot qpos from a
    sampled A-delivery bank state and zeroes finger joint velocities (settled delivery).
    Distinct from reset_from_handoff_bank (rese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
2026-06-09 rl: complete-state onset injection — real velocities + last_action override
    The onset-grip injection (min-z 0.0081) still dropped at the seam. Root cause
    narrowed: the injected snapshot was STATIC and history-incomplete. Two fixes:
    1. Recorder bug: obj velocity read a nonexistent attribute (root_link_velocity_w)
    -> silently zeroed. Use root_link_vel_w; also capture robot_qvel and A's last
    applied action (a_last).
    2. inject_handoff_bank_at_onset now writes A's REAL obj_vel + finger/palm qvel
    (not zeros) AND overrides the action manager's last_action with A's delivered
    action -> the only history-dependent obs is now in-distribution at the seam.
    Since the env has no differenced/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
2026-06-10 rl: add onset-inject ablation toggles (velocity / last_action) + complete-state result
    Complete-state onset injection (real vel + last_action override) eval'd min-z
    0.0027 — WORSE than static 0.0081, NaN-crashed at iter 221. Making the teleport
    Markov-complete did not close the seam: the B-side injection paradigm is saturated.
    Add --handoff-inject-velocity / --handoff-inject-last-action toggles to ablate which
    new variable (if any) regressed it, for the overnight batch.
2026-06-10 docs: correct START HERE — coadapt run 1 stuck (flat 0.02), ablations now key
2026-06-10 rl: wave-1 batch results — VELOCITY injection is the culprit (not last_action)
    2x2 ablation (continuous min-z, handoff@40): velocity-OFF holds ~0.007-0.008 (static
    0.0081, lastactOnly 0.0073); velocity-ON drops ~0.002 (velOnly 0.0023, complete 0.0027).
    Injecting A's real finger qvel at the teleport gives the fingers momentum the position
    setpoint doesn't expect -> grip-perturbing transient. So STATIC (zero-vel) injection is
    the best B-side variant; the last_action override is ~neutral. Co-adapt training run 1
    stuck (Badapt overfit to frozen-A can't catch the migrated delivery); branchB w6 collapsed
    A's grasp (too aggressive), w4 held but paired worse with Badapt (0.0073) than w2 (0.0114).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
2026-06-10 rl: wave-2 batch — proper co-adaptation B (B10 ws + STATIC inject of migrated delivery)
    Fixes wave-1's two co-adapt mistakes: warmstart B10 (not frozen-A-overfit Badapt) and
    STATIC injection (wave 1 proved real-velocity injection is harmful). Trains B to catch
    the migrated A (Atol20); eval Atol20xNEW should beat the free co-adapt pairing 0.0114.
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2026-06-10 rl: live-A reset CLOSES the seam (post-handoff hold 0.110, cos 0.75) — config-parity fix
    The first live-A run (scale 0.2) held in training (masked frac 0.95->0.20, episodes
    ran to time_out) but the continuous-handoff eval showed an instant ~5-step seam
    collapse. Root cause was NOT the mechanism: the trainer defaults
    finger_residual_scale=0.2 while B10 (warmstart) AND the deploy demo use 0.5 — so B
    relearned to hold at 0.2 and the 0.5 eval applied its residuals 2.5x too large,
    blowing up the grip. Re-evaluated at the training-matched scale 0.2, B HOLDS:
    post-handoff min-z 0.110 m (>0.05 = held), held-vertical cos 0.751 (peak 0.816).
    FIRST policy to hold the continuous A->B handoff AND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
2026-06-10 rl: live-A script — parameterize scale/easing/contact-gate (lineage parity); fix echo
    - RESID_SCALE / EASING / CONTACT_GATE env vars (default to canonical 0.5 /
    ease_out_quad / on; set 0.2 / linear / 0 to continue the scale-0.2 live-A
    lineage from model_270 without the train/eval scale mismatch of gotcha #13).
    - fix the cosmetic "warmstart=B10" echo to report the actual B_CKPT.
    Context: warmstarting the live-A reset from B4 (best standalone reorienter, 0.988)
    COLLAPSES — B4 applies reorienting actions that destabilize A's delivery grip
    before the reorient reward gate fires (ep-len stuck 43, tip_lost 3072, align 0),
    the same catch-22 that motivated the hold-only (B10) warmstart. The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
2026-06-10 rl: reorientation QUALITY is the open problem — B10 warmstart is a ceiling (held-cos ~0.74) + jittery
    The live-A reset HOLDS the seam (min-z 0.105) but reorients poorly and jittery (user feedback).
    Both flaws inherit from the B10 warmstart. Tonight (2026-06-10 eve), three results pin it down:
    - 40M continuation from B10-live-A model_270 (20260610-1355-...cont40M): reorientation PLATEAUED
    at held-cos 0.742 (peak 0.817) ≈ the original 0.751; align bounced 47-59, no climb. So 0.74 is
    the B10 CEILING, not undertraining. Hold still solid (0.105).
    - Warmstart B4 (the smooth 0.988 reorienter) COLLAPSES: its reorient-from-step-0 actions
    destabilize A's delivery grip before the reorient gat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
2026-06-13 rl: b33 — force-regularize b32's death-grip (is 11 N necessary or learned laziness?)
    NEW LEVER: grip_force_excess — a quadratic penalty on fingertip force ABOVE a
    threshold (((force-thresh)/scale)**2). The existing grip_force REWARD saturates
    at 3 N, so the two only overlap above thresh: below it grip is still rewarded,
    above it extra force now COSTS. Counters the ~11 N death-grip b32 learned (the
    source of BOTH the thumb penetration AND the residual jitter — high-freq
    corrections of a tense grip) without touching the grip reward itself.
    - mjlab_terms.grip_force_excess + cfg grip_force_penalty_{weight,thresh,scale,
    reduce} + CLI.
    - scripts/train_handoff_b33_forcereg.sh: single-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
2026-06-23 rl: pivot to SMOOTH / LOW-FORCE grasp+reorient (verticality relaxed) + full doc consolidation
    User directive (2026-06-22): drop the close-to-vertical / brace ambitions; optimise a
    smooth, low-force grasp and reorient, then morphology. This commit adds the two runs and
    brings all documentation surfaces into agreement on the honest current state.
    Runs (smoke-tested, watchdog-guarded, detached):
    - scripts/train_gentle_lowforce_B.sh: gentle low-force reorienter. Warmstart b34_t20 on the
    live-A reset; relax verticality (target-axis 100->40, alpha 4.0->1.5 wide basin, progress
    300->120), lower grip reward 6->2 + keep the over-grip penalty (thresh 2.5), raise the
    lateral smoother -8->-12. Fi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
2026-06-23 rl: checkpoint b30->b34 experiment code + artifacts (were uncommitted)
    Persisting the prior-session in-hand-reorient work that had accumulated in the working
    tree: the b30/b32 (gripSmooth) and b33/b34 (force-regularise + force-floor sweep) launch
    and eval scripts, the grip-force probe, the live-A runner updates, the continuous-handoff
    eval diagnostics, b34_EVAL_RESULTS.txt, and the reorient rollout videos. No behaviour change
    intended beyond what these already produced; this is a durability checkpoint so the remote
    session does not lose them. Excludes the external/mujoco_warp submodule bump and failed-run
    .COLLAPSED markers.
    [probe_grip_force.py]
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2026-06-23 rl: grip-force SPREAD penalty (balance the tripod) + per-run frozen-scene override
    Two levers for the "excessive grip force" problem, both from the per-finger finding that
    the live-A grip is lopsided (thumb ~2 N idle while index/middle clamp ~8 N), not a uniform
    over-clamp:
    - mjlab_terms.grip_force_spread + env_cfg/CLI (--grip-force-spread-weight/-scale): penalise
    the per-finger force spread (max-min) to push toward a balanced tripod (B4-like) where no
    single finger carries the load. The magnitude penalty (reduce=mean) was blind to this.
    - rl_train_cube --frozen-scene-xml: override the morphology-run's frozen_scene.xml per-run
    (a hardened-contact variant for less penetration) WITHOUT e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
    [frozen_scene_hardcontact.xml, frozen_scene_hardcontact_mild.xml]
2026-06-23 docs: morphology-optimization plan + spread-penalty result (grip defect is structural)
    The grip excess-force is a GEOMETRY problem, not reward-tunable, so the active direction is
    now morphology optimisation.
    - docs/rl/morphology_optimization_plan.md (NEW): the staged plan. Evidence the defect is
    structural (per-finger probe: thumb idle ~1.6 N while index/middle clamp ~8 N; the
    grip_force_spread penalty couldn't recruit the thumb; contact-hardening broke A's grasp).
    An honest read on the "Shape Your Body"/VGDS value-gradient method — wrong tool here because
    it needs a morphology-conditioned universal critic and our reorient is too brittle for the
    value to generalise across design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
2026-06-23 rl: thumb-opposition grasp-balance sweep (morphology Stage 1 — autonomous)
    First morphology experiment. The grip imbalance reproduces at the GRASP level: the baseline
    morphology's CEM-optimized grasp uses only 2 fingers (middle contact-persistence 0.0,
    finger_persistence_imbalance 0.21). This sweep runs the existing CEM grasp optimizer over a
    grid of thumb positions (x,y,len; index/middle fixed) and reads its per-finger balance metrics
    to find a thumb placement where the optimized grasp becomes a balanced 3-finger tripod
    (all-finger contact, low imbalance, weak finger engaged) while still lifting — the candidate
    for a full A+B retrain. CEM ~28 s/candidate; results stream to MORPH_GRASP_S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
2026-06-23 rl: morphology sweep RESULT — thumb reposition gives a BALANCED 3-finger grasp
    The structural hypothesis is confirmed at the grasp level. Sweeping thumb (x,y,len) with the
    CEM grasp optimizer: the baseline (0, .02, 0) grasps with only 2 fingers (middle persistence
    0.00, imbalance 0.21), but thumb=(+.02, +.02, +.02) — thumb moved out and LENGTHENED — gives a
    balanced tripod (contacts 3.0, persistence 1.0/1.0/1.0, imbalance 0.000) that still lifts.
    thumb_len is the key lever: a short thumb can't reach the object (idle); a longer thumb engages
    and balances the load. This is the morphology fix for the lopsided grip that no reward could
    move. Next: retrain A+B on this morphology and measure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
2026-06-23 rl: train skip-lift reorienter on the balanced (thumb-opposed) morphology
    Direct test of 'balanced grasp -> balanced grip', no Policy A retrain: skip-lift spawns the
    object pre-gripped in the new morphology's CEM tripod grasp; replicate B4's recipe + warmstart
    B4. Judge by probe_grip_balance per-finger force vs old-morphology gentleB (thumb idle 1.6 N).
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2026-06-23 graspgenx: pocket-centered sweep volumes + headless grasp renderer
    - graspgenx_make_morphohand.py: replace the wizard's opposed-gripper sweep
    estimate (which spanned the whole finger length) with boxes computed from
    the morphohand's actual fingertip arc (open->half->close), centred on the
    grasp pocket where the curling fingers converge. Objects now nest into the
    hand instead of touching the extended fingertips.
    - graspgenx_view_grasps.py: load object + gripper coll mesh, place gripper at
    top-K Isaac-grasp poses, export .glb (+ best-effort PNG) for visual QA.
    Verified renders on banana/cube/screwdriver/prism: sensible pre-grasp reaches.
    Caveat: base morphohand is non-opposed (all f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
2026-06-23 graspgenx: --thumb/--index/--middle/--baked-len morphology overrides
    Lets the exporter sweep distinct hand shapes (mount x/y/z + frozen segment
    length) without first authoring MJCF scenes. Compared 4 morphologies on the
    40mm cube: baseline, wide-splay (widest aperture, best fit), z-raised
    opposed thumb (most enclosing grasp), long-finger (overshoots small objects).
    Sweep-volume aperture tracks morphology; GraspGenX confidence reflects fit.
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2026-06-23 rl: reorient-on-balanced-morphology result — balanced GRASP != balanced reorient grip
    The thumb-opposed morphology's CEM grasp is a balanced tripod, but training a reorienter with
    B4's verticality-maximizing recipe (warmstart B4) re-lopsides it: index goes idle (0.0 N),
    middle over-clamps to 17 N, held-cos 0.815. The morphology fixes the static grasp; the reorient
    RECIPE must preserve it. Next: gentle (relaxed-verticality) + spread-penalty reorient on the new
    morphology (the morphology now MAKES balance achievable, unlike the old one where spread failed).
2026-06-23 rl: A+B on new morphology — grasp balanced but reorient still idles a finger (warmstart mismatch)
    A retrains fine on the thumb-balanced morphology (lifts to 0.060). But both reorienters (gentle
    and B4-recipe), warmstarted from B4, idle the INDEX finger (0.0 N) during reorient — B4's finger
    coordination is for the OLD geometry and doesn't transfer. B4 keeps all 3 engaged on ITS OWN
    morphology (0.986, 7/10/10 N). => the reorient grip balance needs a warmstart matching the
    morphology, not just a balanced grasp. Next: reorienter warmstarted from the NEW A (native grip).
2026-06-23 docs: morning overnight update — grasp solved, reorient grip is a warmstart-transfer problem
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2026-06-23 rl: train_A_on_morph.sh — drop the invalid --lift-ramp-steps flag (the fix that let A run)
2026-06-25 rl: morphology LANDSCAPE characterization sweep (the original co-synthesis goal)
    Per morphology (9-param), decompose the whole task to avoid the handoff-control confound: CEM
    grasp -> graspability + per-finger balance (A-half), and a skip-lift reorienter warmstart-B4 ->
    held-cos + per-finger force/balance (B-half). Asks whether task quality VARIES across the
    morphology landscape or all designs are equivalent. Resumable (per-morphology JSON checkpoint),
    incremental, try/except per design, sequential (sleep-safe). Validated end-to-end on baseline.
2026-06-25 rl: morphology LANDSCAPE result — task quality VARIES strongly across designs; m05 is a winner
    Answer to the co-synthesis question: morphologies are NOT equivalent. Reorient quality ranges
    r_cos -0.68 (m01 thumb-winner) to +0.93 (m05) across 12 designs. m05_lhs reorients to 0.927 with
    ALL THREE fingers firmly + balanced (11.7/12.7/9.3 N, contact 0.95/0.95/0.83) — the firm balanced
    in-hand reorient the project wanted. Also reconfirmed: GRASP balance does NOT predict REORIENT
    quality (m01 perfect grasp balance -> reorient fails; m05 poor grasp persist -> reorient great),
    so the cheap grasp screen is not a valid proxy. ~3/12 ungraspable. Next: verify m05 is genuine
    in-hand (render), charact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
2026-06-25 rl: m05 VERIFIED — genuine smooth in-hand reorient (cos 0.933, jerk 21.5, min-z 0.064, no drop)
    Deterministic eval confirms m05 is a real in-hand reorient (not floor-braced like m03 which had
    cos 0.90 but ~0 contact): held-cos 0.933, obj-jerk 21.5 (SMOOTHER than B4's 27), min-z 0.064
    (>0.05 floor), drop 0.00, all 3 fingers balanced+firm. Its design lengthens ALL fingers + moves
    the middle out (not the thumb-only fix that failed). Video committed. Caveat: single seed; firm grip.
2026-07-08 Imitation prior, compliance robustness sweep, variance study, sim2real assets
    - src/morphohand/rl/imitation.py: object-relative fingertip imitation reward
    (track_fingertip_obj) — morphology-transferable reorient prior; wired into
    env_cfg (reward + weight-anneal curriculum) and rl_train_cube CLI.
    - rl_demo_handoff_continuous.py --record-fingertip-traj: dump the reference
    trajectory from a good policy (a10->b33).
    - scripts/compliance_robustness_sweep.py + results: policies are fragile /
    non-monotonic vs contact stiffness (motivates compliance DR, plan in
    docs/rl/compliance_dr_plan.md).
    - scripts/reorient_variance_study.py + results: fixed-A + imitation prior
    collapses seed varian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
    [m05_frozen_hardcontact_mild.xml]
2026-07-08 Per-env contact-compliance DR + retrain pipeline (Approach A of the DR plan)
    - mjlab_terms.randomize_geom_solimp: reset-mode event; one softness draw per
    env lerps solimp (dmin, dmax) JOINTLY soft->hard across all geoms. mjlab's
    requires_model_fields machinery auto-expands geom_solimp per-world.
    - env_cfg compliance_dr{,_dmin,_dmax} + rl_train_cube --compliance-dr.
    - Verified: per-world expansion, distinct in-range correlated per-env values,
    re-draw on mid-run resets, finite stepping; SMOKE A-train clean.
    - scripts/compliance_dr_pipeline.py: resumable DR-A -> 2x imitation-B ->
    compliance_robustness_sweep (which now auto-includes *_m05_cdr* runs).
    Launched detached; success bar = fl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
2026-07-09 Compliance-DR results: robust hold, two separable failures; diagnosis + next levers
    Sweep: cdr_imitB holds across c997-c9995 (incl. 0.9995 where every baseline
    drops) at low force — the DR hold is genuinely stiffness-robust. But (1) DR-A
    whiffs the grasp at the soft EDGE of its own training band (cross-pair
    DR-A+b33@soft still drops => A owns it; eval must be interior to the band —
    cdr2 retrain with widened band launched) and (2) DR-B reaches vertical
    transiently (peak 0.76 from a good delivery) but cannot stabilize there
    (settles -0.58; training align reward 33-40 vs 49 non-DR). Next: imitation
    floor / stiffness curriculum for B. Full write-up in reorientation.md.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
2026-07-09 Recipe YAML layer for the trainer (audit step 4)
    morphohand.rl.recipes adds --recipe <name> to rl_train_cube.py: a recipe under
    configs/recipes/<name>.yaml pins a named block of trainer args as tyro DEFAULTS
    (explicit CLI flags still win; unknown keys are a hard error). Ports the blessed
    recipes: a_lift (a01/a10 lift block from train_A_on_morph.sh), b_liveA (the
    B10/b33 live-A reorient block from train_handoff_liveA_reset.sh), b_liveA_imit
    (+ the design-neutral imitation prior). Launchers now pass --recipe + run knobs;
    compliance_dr_pipeline / reorient_variance_study select RECIPE instead of
    imitation flag soup. This is the single place train/deploy parity knobs
    (finger_residual_scale / easi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
2026-07-10 compliance_rate_sweep.py: batched N=32 success-RATE curves (n=1 sweep shown untrustworthy)
    Probe result that motivates this: DR-A at soft is a knife-edge grasp decided
    by Warp solver noise (13/32 vs 19/32 across identical mean-action envs), which
    the n=1 deterministic sweep scored as a hard FAIL. This runs the same
    continuous A->B handoff (switch @40) in a 32-env batch per (pair, solimp
    level): hold-rate, reorient-rate (cos>0.7), median held cos. Pairs: a10+b33
    baseline, round-1 cdr, cdr2+imitation-floor B, cdr2A+b33 (isolates A).
2026-07-10 Policy-bottleneck probes: rescue/avar/global sets, A best-of-N, paired imit/self B
    Validates the sign-off directive: are "never learned" morphology verdicts
    optimizer noise? (Evidence: A's from-scratch draw dominates evaluator noise —
    joint sd 0.41 vs fixed-A B-only 0.09/0.02; all 5 large16 failures had A-side
    events.)
    - morph_pipeline_sweep.py: --a-attempts (best-of-N A, retry on collapse/
    health-FAIL/never-lift, EVERY attempt recorded = raw draw data), --b-recipe
    plain|imit|both (paired B recipes on the same kept A), --only subset filter,
    morph sets rescue (5 large16 failures) / avar (raw A-draw cells) / global
    (full-box LHS, the >16-design landscape, decision-gated), stale-.COL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
2026-07-11 Probe queue smoke artifacts + P1 progress log (queue in flight)
    Smoke probe (truncated training) validated pipeline mechanics: both B
    recipes on one kept A, dual handoff scorecards+videos, per-attempt A
    records in JSON. P1 rescue running: rs_L01_02 A accepted on first draw
    (large16 had health-FAILed the same design) — early hint of A-draw noise.
2026-07-11 P1 rescue design 1/5 (rs_L01_02): partial flip — capability rescued, jitter fails; imit holds where self drops
    A accepted on first fresh draw (large16 had health-FAILed the same design).
    imit-B holds+reorients (min-z 0.111, cos 0.561) failing only jitter (44 vs
    bar 40, b33 ref 9.6); paired self-B on the same A drops (min-z 0.006,
    peak-cos 0.999 = floor-bracing). H1 strict 0/1, capability flip 1/1;
    H3 1/1 imit-fair. Queue continues on rs_L01_03.
2026-07-11 P1 rescue design 2/5 (rs_L01_03): A rescued but no reorient under either B recipe
    The iter-0-collapse design trains A clean on the first fresh draw (2/2
    A-side failures now flipped = draw luck, not geometry). But both imit-B
    and self-B on the same A hold without reorienting (cos -0.05 / 0.17,
    static hard clamp, thumb engaged) — first evidence of a real
    reorient-hostile design effect, against pure H1 on the reorient axis.
    H1 strict 0/2, capability 1/2; H3 fairness 1/2 (first strike,
    Δcos(imit-self) = -0.22, marginal). Queue healthy, on rs_L01_05.
2026-07-11 P1 rescue design 3/5 interim (rs_L01_05): first trainability-hostile design — A t0 + imit-B both collapse
    A needed its best-of-2 retry (t0 watchdog-collapse iter 98, t1 clean model_609);
    imit-B then watchdog-collapsed at iter 194 (first B-side collapse in the program),
    salvage model_150 = degenerate one-finger pin (cos -0.47). Cumulative 2 collapses
    in 3 A draws for this design vs 0/2 first-draws for L01_02/03 -> collapse propensity
    looks design-dependent (decision-tree step-5 clause; P2 avar decides). Self-B in
    flight. Interim tallies: H1 strict 0/3, capability 1/3. Includes the overwritten
    rs_L01_05 imit handoff video+scorecard (replaces smoke artifacts).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
2026-07-11 P1 rescue designs 3+4 complete (rs_L01_05, rs_L01_07): H1 strict decided 0/4; class map emerges
    - rs_L01_05 trainability-hostile confirmed: self-B also watchdog-collapsed
    (salvage: no grip, min-z 0.044, cos -0.969); 4 legs, 3 collapses, 0 viable.
    - rs_L01_07 second holds-but-static design: clean A + healthy 3-finger hold
    under BOTH B recipes (min-z ~0.112) but zero reorient (cos 0.03/0.06);
    H3 fair (dcos -0.027), L01_03 strike did not repeat.
    - rs_L01_09 in flight: both A attempts aborted (kept salvaged model_150),
    imit-B collapsed iter ~100 (thumb-idle pinch, cos 0.25); self-B last leg.
    - H1 strict 0/4 (max 1/5) => step-3 branch, axis-split read: lift/hold = draw
    noise (3/5 rescue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
2026-07-11 P1 rescue CLOSED (5/5): pick-up failures were A-draw noise, reorient failures are real geometry signal
    H1 strict 0/5, but the axis split is the finding: every large16 failure now
    lifts+holds (min-z 0.109-0.125, both paired evals) while 0/5 reorient — with
    imit and self B agreeing per design, these are measurements, not noise.
    Collapse propensity clusters by design (0/6 legs vs 3/4, 3/4). H3: keep
    imit-B (fair 3 / strike 1 / uninformative 1, informative-mean delta ~0).
    avar (H2, m05 control) auto-running; P4 global24 next per decision tree.
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2026-07-12 P4 tick designs 3-5: best cos yet (G02_03 0.568) from worst grasp seed; first PASS is static
    G02_02_r0 = A-defect row (idle-index A kept after t1 collapse; cos -0.388) - r1
    arbitrates. G02_03_r0 reorients (0.568/peak 0.765) despite thumb-dead CEM grasp +
    11 mm thumb IK residual - second capability-flip hidden behind a health FAIL;
    'degraded input => hostile design' reduced to collapse propensity only. G02_04_r0
    is the first clean-sheet PASS and is static (cos 0.148) - health and capability
    orthogonal in both directions. r0 tally 5/12: 2/5 reorient >= 0.5 at 3-4 cm from
    m05. Worker healthy on G02_05_r0; no GPU launches this tick.
2026-07-12 P4 tick design 6: G02_05 second A-defect row; index-IK-residual pairing repeats 2/2
    G02_05_r0: clean CEM grasp but worst accepted index IK residual (12.84 mm);
    A t0 collapsed iter 40, kept t1 idle-index FAIL; imit-B holds-but-static
    (tail cos -0.499 == A's delivery -0.529, held unmoved). The two A-defect
    rows are exactly the two worst index residuals (G02_02 6.76 / G02_05
    12.84) while thumb 11 mm didn't block (G02_03) -- descriptive n=2;
    candidate P5 fix = IK-residual acceptance bar or re-CEM on retargeted
    keyframe. r0 tally 6/12: softened-bar 2/6, A-defect 2/6, A collapses 3/9.
2026-07-12 P4 tick design 8: G02_07 first partial reorienter (cos 0.333) from the sweep's cleanest inputs
    Closest LHS point to m05 (max delta 2.18 cm), all IK residuals <=0.1 mm, A
    first-draw clean; sustained partial reorient with full 3-finger grip. Lands
    mid-distribution of m05's own draw spread -- reinforces H2, no input->outcome
    story. r0 8/12: softened-bar 2/8, A-defect 2/8, clean-static 3/8; hold solved
    8/8 (min-z >=0.105).
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2026-07-12 P4 r1 designs 13-16: G02_00 first replica-consistent reorienter (0.504/0.635); G02_03_r1 peak cos 0.999 then dropped
    - G02_00_r1 WARN cos 0.635 on a kept-FAIL A: verdict robust to the A draw,
    top confirm-candidate at 3.9 cm from m05
    - G02_03_r1 FAIL: thumb-dead seed hits peak 0.999 (program record) on a
    salvaged model_50 A, then drops (min-z 0.0463); both replicas attempt
    big reorients - only G02_00+G02_03 show reorient signal in both replicas
    - G02_01_r1/G02_02_r1 double-A-collapse where r0 lifted => total miss is
    draw luck, not design fate; A-leg abort rate 14/26 (54%), 3/16 legs lost
    - r1 opened 7/8 aborts (flagged); cleared - G02_04_r1 t0 trained clean
    - backfills the r0 12/12 cl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
2026-07-12 P4 r1 design 17: G02_04 flips PASS-static -> reorienter (0.148/0.528) — sharpest replica inconsistency; both-FAIL best-of-2 cost mode
2026-07-12 P4 r1 designs 18-19: G02_05_r1 PROGRAM-BEST reorient (0.887, jerk 7.8) on the ex-A-defect design; G02_06 first replica-consistent static
    - G02_05_r1: cos 0.887 / peak 0.927, first sweep reorienter smoother than the
    b33 reference; beats m05's best clean draw (0.82) at 3.2 cm from m05.
    Supersedes its r0 A-defect leg (span -0.499 -> 0.887) and BREAKS the
    index-residual->idle-index pairing (same 12.84 mm residual, opposite index
    fates) - residual exonerated as cause.
    - G02_06_r1: static -0.018 on a kept-FAIL A (t1 collapsed); pooled with r0
    (0.127) = first design with both replicas evaluable and both static.
    - Tallies 19/24: A-leg aborts 15/31 (~50%), hold 15/16 evaluable
    (min-z floo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
2026-07-12 P4 r1 design 20: G02_07 third replica-consistent design — sustained-partial reorienter (0.333/0.366, tightest pair Δ0.033), smoothest leg (jerk 6.6)
2026-07-13 P4 r1 design 22: G02_09 fifth replica-consistent design (third static, -0.102/0.149) — and the only all-health-FAIL-A design (3/3 completed draws), splitting trainability into collapse vs delivery-he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
2026-07-13 P4 r1 design 23: G02_10 third irresolvable-at-n=2 design (0.117→0.576, Δ0.459) — first same-grade-A replica flip, proving A health grade is a gate not a sufficient statistic of delivery
2026-07-13 P4 confirm leg 1/4: G02_00_r2 cos 0.107 — the lone replica-consistent reorienter breaks at n=3 (0.504/0.635/0.107), consistent census was draw luck; third same-grade-A flip
2026-07-13 P4 confirm leg 2/4: G02_05_r2 cos -0.079 — program-best design's promotion bar mathematically unreachable (mean 0.103, r3 would need 1.69); fourth+largest same-grade-A flip (Δ0.966); both confirm can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
2026-07-13 P4 confirm leg 3/4: G02_00_r3 cos 0.681 — design-best draw still misses the bar (n=4 mean 0.482); confirm formally CLOSED, both candidates out, conditioned-policy default stands; A-grade anti-orders 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
2026-07-13 Doc sync: probe+P4 program arc into webpaper rl pillar (three-doc rule)
    webpaper/src/rl.typ gains the compliance-DR closure verdict and a new
    top-level section covering the policy-bottleneck program end to end:
    H1-H3 probe outcomes (pick-up failures were 100% draw noise; per-draw
    sd 0.3-0.5 gate-invisible; imitation prior stays the evaluator), the
    A-predictor negative result, the global12x2 pooled table, the n=4
    confirm bands (G02_00 0.482 / G02_05 0.210, no promotion), and the
    morphology-conditioned-policy recommendation. Builds clean.
    paper/main.tex (gitignored, local): body paragraph in codesign-results
    + new appendix app:bottleneck; fixed pre-existing compile errors
    (missing \R \bX \bt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
2026-07-17 Idle tick (07-17 00:19 MDT): A-predictor re-run at n≈50 (P4 complete) — no-predictor verdict STRENGTHENED, idle-finger veto REFUTED
    Completed the last outstanding idle-GPU CPU task (the note's queued revisit).
    CPU-only re-run of scripts/a_quality_predictor.py over all tags incl. global12x2:
    50 (A,B) pairs / 49 completed-B (2x the prior n=25). The n=25 front-runners were
    small-sample artifacts (mean tip force +0.44->+0.18, max finger force +0.41->+0.03);
    best rho now fmin +0.31, nothing clears 0.31 -> no single-draw A->B predictor at 2x
    data, so P4's 2-replica design and the "draw is the bottleneck" close-out both hold.
    Side-finding (1) idle-finger veto REFUTED (fmin<0.5N flags 5 As, 3 ga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
2026-07-18 Idle tick (07-18 07:03 MDT): PAUSED pulse (dry_run) — 07-17 4x cut didn't stop the no-op bleed; program CLOSED pending user go/no-go
    17th consecutive no-op poke on a program CLOSED since 07-13 whose only remaining move is a USER decision the pulse cannot make. The 07-17 cadence quartering (75->180/2->1) slowed but did not stop the quota bleed, so set dry_run=true in ~/.config/claude-pulse/config.toml: cron + monitoring stay live but no 'claude -p' subprocess spawns => zero quota/tick. Fully reversible (dry_run=false) once the conditioned-policy build is authorized. Decision tree re-verified terminal: no worker, both DONE sentinels present, tree clean, all step-8 CPU tasks exhausted.
    Co-Au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
2026-07-21 6-dim XY-only sweep + policy-learning quick-fix analysis (user overnight 07-19)
    User asked for a global12x2-style sweep with proximal phalange lengths FROZEN (6 XY
    dims only), plus quick fixes to make policy learning (the established bottleneck) more
    robust / reach its potential.
    Analysis (zero GPU-training cost): decomposed the evaluator noise — B-side variance is
    solved by the imit prior (±0.02); the dominant open term is the Policy-A draw (sd
    0.3-0.5), which the health gate can't select on (it anti-orders reorientability).
    Tested the top candidate fix QF1 (b33 zero-shot as a cheap A-reorientability selector,
    scripts/probe_a_reorientability.py) on all 31 on-disk kept-A -> known-trained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
2026-07-21 global6xy interim: 3/24 legs (H06_00..02) — all held, all static; date label fix
    r0 designs H06_00..02 all cleared the grasp gate and HELD post-handoff (minZ
    0.110-0.117) but drew static/near-zero reorient (held-cos -0.044/-0.048/-0.119) —
    the draw-gated-expression wall, as H2 predicts for n=1 (r1 replicas decide).
    Early trainability signal: 0 true A-collapses + 1 retry across 4 A-legs vs 9-dim's
    ~47% abort rate (too small to claim yet). Also corrected the launch-date label
    2026-07-19 -> 2026-07-20 across the touched docs (+ pulse config/prompt).
2026-07-21 Idle tick (07-21 03:00 MDT): commit orphaned H06_01/02 handoff media + designs 2-3 interim note
    The 01:30 milestone commit (4446a11) left the H06_01/H06_02 handoff videos +
    .health.json untracked (committed only json/txt/STATUS). Add them now, plus a
    reorientation.md interim note synthesizing both static-hold legs from their
    scorecards (H06_01 cos -0.048; H06_02 cos -0.119, jerkiest+heaviest-slide leg).
    No new completed rows since 01:30 (worker on H06_03_r0 Policy B).
    Trainability watch CORRECTED via per-attempt COLLAPSED sentinels: at the attempt
    level 3/7 A attempts collapsed (~43%, H06_01 t0, H06_03 t0+t2) -- comparable to
    9-dim ~47%, NOT lower. The 0/4 design-abort is the --a-attempts 3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
2026-07-21 global6xy interim: 6/24 legs — strong reorienter H06_04 (cos 0.852); freezing len does NOT calm A-training
    r0 cos {-0.044,-0.048,-0.119,0.006,0.852,0.34}: the XY-only box contains a strong
    reorienter (H06_04_r0 = 0.852, near program-best 0.887) so reorient capability exists
    here too, but the draw-noise wall (sd 0.34) is intact. Trainability hypothesis looking
    NEGATIVE: 5/11 A-legs aborted (~45%) ~ 9-dim's ~47%, 3/6 designs needed retries. And the
    anti-ordering repeats live: H06_04's kept A was a health-FAIL draw (2 non-FAIL attempts
    both collapsed) yet gave the best reorient. All 6/6 held.
2026-07-21 Idle tick (07-21 07:15 MDT): global6xy 7/24 legs — H06_06_r0 FIRST DESIGN-ABORT (A never lifts, 3/3 collapse despite graspable CEM grip); len-freeze trainability hope NEGATIVE (8/14 collapses ~57% > 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
    - H06_06_r0: CEM graspable (lift 0.055, persist 1/1/1) but Policy A never lifted — all 3
    attempts COLLAPSED (best objheight 0.0 < 0.06 gate) => best-of-3 rescue failed outright,
    design skipped. A-trainability-hostile XY placement, not graspability-hostile geometry:
    first concrete crack in the 9-dim "no lift-hostile geometry" verdict.
    - H06_05_r0: HELD (minZ 0.116) but scorecard verdict FAIL — jitter 46.4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
2026-07-21 Idle tick (07-21 09:45 MDT): global6xy 8/24 legs — H06_07_r0 SECOND clean reorienter (cos 0.547) and cleanest-QUALITY draw of box (jerk 10.4 smoothest, force 5.0N gentlest, balanced grip thumb 4.8/in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
    Worker HEALTHY (on H06_08_r0 CEM); analysis/commit-only per STATUS tree (worker
    owns GPU). H06_07_r0: A held on 3rd draw (2/3 collapse), handoff minZ 0.117 /
    held-cos 0.547 / peak 0.629, WARN. Box now holds two WARN reorienters spanning
    the quality axis — H06_04 strong-but-forceful (0.852, 13N) and H06_07
    gentle-and-smooth (0.547, 5.0N) — plus one thrashy FAIL partial (H06_05, 0.34):
    reorient capability AND quality both present in the XY-only b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
2026-07-21 global6xy interim: 9/24 legs — trainability hypothesis refuted (A-collapse 50%); reorient draw-gated
    Adds H06_06 (first lift-miss: 3/3 A collapse to objheight 0.0, cf 9-dim G02_11),
    H06_07 (smooth expresser cos 0.547 @ 5N/jerk10), H06_08 (partial 0.204). r0 cos mean
    +0.217 sd 0.321, 2/8 express >=0.5. A-collapse 9/18 legs (50%) ~ 9-dim's ~47% => freezing
    the length axis does NOT reduce A-fragility. Held 8/9. The XY-only box reproduces the
    9-dim story faithfully: pick-up solved, reorient common-but-draw-gated, A-fragile at the
    same rate.
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2026-07-21 global6xy r0 pass COMPLETE (12/12): XY-only landscape ~ indistinguishable from 9-dim
    Full r0 map: cos mean +0.112 sd 0.333, 2/11 express >=0.5 (0.852, 0.547), held 11/12,
    A-collapse 13/24 legs (54%). The 6-XY box matches the 9-dim global12x2 landscape on every
    axis (pick-up solved, reorient common-but-draw-gated, A-fragile at ~same rate) => freezing
    the proximal length is not a special axis. Lift-miss H06_06 mirrors 9-dim G02_11. Standouts
    to confirm in r1: H06_04 (0.852), H06_07 (0.547 @ 5N smooth). r1 pass started.
2026-07-22 Idle tick (07-21 20:15 MDT): global6xy FIRST r0/r1 pairs — both static-r0 designs FLIP to expressers
    H06_00: r0 -0.044 (static) -> r1 0.611; H06_01: r0 -0.048 (static) -> r1 0.51.
    Within-design pair spread (range 0.56-0.66) dwarfs the whole r0 between-design
    signal (mean +0.112, sd 0.333) => r0 static verdicts were pure draw-luck;
    stopping at r0 would have mis-labelled both as non-reorienters. Both r1 draws
    WARN (H06_00_r1 jerk 26.7/8.4N; H06_01_r1 jerk 14.7 PASS but 12.8N), neither
    edges the standouts (H06_04 0.852, H06_07 0.547 — replicas pending).
    A-collapse running 15/28 attempts (~54%), unchanged (len-freeze hope refuted).
    Worker HEALTHY on H06_02_r1's Policy A (docs/commit-only, G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
2026-07-22 Idle tick (07-21 21:46 MDT): global6xy 3rd pair H06_02 — FIRST design STATIC in both draws (draw-gate is per-design)
    New r1 row H06_02_r1 (cos -0.091, peak-cos 0.165, WARN). With r0 (-0.119)
    this is the sweep's first r0/r1 pair that does NOT flip: pair mean -0.105,
    range 0.028 (both draws land static). Sharpens the prior tick — "both
    static-r0 designs flip" was premature; H06_02 is the counterexample.
    Three completed pairs split 2 express / 1 non-express by design (pooled max
    0.611, 0.51, -0.091); within-design draw spread is heterogeneous (huge for
    H06_00/01 flippers, ~0 for H06_02) => expression is P(express|design) that
    VARIES by design. A-collapse 15/29 attempts = 52% (H06_02_r1 A c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
2026-07-22 global6xy mid-r1 (7/12): H06_05_r1+H06_06_r1 clean-hold non-expressers — flip is draw-luck not replica-order
2026-07-22 global6xy mid-r1 tick (07-22 11:00): 2nd-best design H06_07 does NOT replicate (r0 0.547->r1 drop); H06_08_r1 cos 0.78 is a scorecard-rejected 1-finger phantom
    Two new r1 rows (worker healthy on H06_09_r1's B; r1 pass 9/12):
    - H06_07_r1: genuine DROP, cos -0.268, minZ 0.045<0.05 (drop FAIL), jerk 149.8,
    drift 4.9cm. A x3 health-FAIL-driven (0 r1 collapse). H06_07 pooled 0.547->0.140
    => only H06_04 expresses in both draws (seed/draw-domination, CLAUDE.md #6).
    - H06_08_r1: PHANTOM cos 0.78 (peak 0.994) but A collapsed 3/3 + B watchdog-aborted
    (salvage model_50): 1-finger degenerate (thumb 0N + middle 0N idle, index 1N,
    force 0.3N), idle_finger FAIL. Scorecard rejects it (CLAUDE.md #1)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
2026-07-22 global6xy mid-r1 tick (07-22 12:35): H06_09_r1 = 3rd distinct r1 FAIL mode — genuine 3-finger reorient (cos 0.356) that jitters out (ang-jerk 44), not a drop/phantom
    - r1 pass 10/12; worker healthy on H06_10_r1's Policy A (docs-only, no GPU launch)
    - H06_09_r1 FAIL: only jitter fails (ang-jerk 44.0); idle_finger PASS (all 3 loaded
    13.1/9.1/8.5N), drop PASS (minZ 0.109) — a real partial reorient, unlike H06_08_r1's
    1-finger phantom. A was A×3 (t0+t1 watchdog-COLLAPSED, t2 clean).
    - Three consecutive r1 FAILs, distinct mechanisms (drop / phantom-1-finger / jitter) off
    the same imit-B recipe — clean draw-domination picture; multi-check scorecard load-bearing.
    - H06_09 pooled 0.037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
2026-07-22 global6xy confirm tick (07-22 16:45): first n=4 row H06_04_r2 — reorient property REPLICATES at n=3 (0.85/0.74/0.81, mean 0.800), FAILs jitter only
    Base 24-leg sweep DONE+committed (70e551b); live worker is the n=4 confirm (H06_04+H06_08),
    so docs/commit only. H06_04_r2 cos 0.808 (peak 0.948), verdict FAIL on jitter ALONE (ang-jerk
    159.3) — a genuine 3-finger near-complete reorient (idle_finger PASS 11.2/9.3/15.4 N, drop PASS
    minZ 0.110), not a phantom/drop; A×3 (t1+t2 watchdog-COLLAPSED, t0 clean). H06_04 now reorients
    in all 3 draws (all >=0.74 tail, >=0.94 peak) — the opposite of 9-dim G02_00 (regressed 0.57->0.48
    at n=4); certified express 2/3 (r2 shakes out). Positive early confi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
2026-07-23 global6xy docs-sync tick (07-22 18:20): propagate 6-dim XY-only result to publication docs
    No new completed confirm leg since 16:45 (H06_08_r2 A done in 2 attempts,
    its B training); worker RUNNING so docs-only per STATUS tree step 1. Did
    tree-step-5 idle work: the finished 24-leg 6-dim (global6xy) result was in
    reorientation.md + POOLED.md but absent from both publication docs. Synced:
    webpaper/src/rl.typ new "does freezing the phalange lengths help?" section
    (6-dim-vs-9-dim table + "narrows upward, wall unmoved, length not a special
    noise source" reading; typst --features html verified clean) and paper/main.tex
    App.bottleneck XY-only paragraph + main-body pointer (paper/ is gitignored →
    e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
2026-07-23 global6xy DONE (28/28, n=4 confirm): H06_04 CONFIRMED — program's first replicated design win
    6-dim XY-only sweep (lens frozen at m05) + n=4 confirm complete. H06_04 clears the
    >=0.5 promotion bar AND replicates: n=4 {0.852,0.741,0.808,0.593} mean 0.748, all 4
    draws >=0.59 (peak >=0.94), 4/4 express, 3/4 pass the trajectory-health gate (r2 is
    FAIL-jitter only). Opposite of 9-dim G02_00 (regressed 0.57->0.48). H06_08 FAILED the
    confirm (mean 0.346; its n=2 0.78 was a phantom 1-finger, gate-caught).
    XY-only vs 9-dim: narrows landscape UPWARD (per-design mean floor -0.11 vs -0.39, peak
    0.75 vs 0.48, #>=0.5 1 vs 0) but leg-level sd unmoved (0.354 vs 0.339) and A-collapse
    not lower (50% vs 40%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
2026-07-25 global6xy verify tick (07-24 08:00): sweep DONE + state static (17th no-op) — GPU 2056MiB but extra is unrelated graspgen_server ROS node, no Warp job; next = user's promotion/conditioned-policy deci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
2026-07-29 perp: A collapses under the stock orientation guard — record the failure and the fix
    policyA_perp was aborted by the collapse watchdog at iter 44 (object_height 0.09 -> 0.0447).
    The guard and the design are in direct conflict: once airborne the shaft pitches, the episode
    terminates as object_orientation_slip, and the one reliable way to avoid pitching is to NOT
    LIFT — on the floor the shaft cannot rotate. PPO found that degenerate optimum. Aggregate
    reward never flagged it; the object-height watchdog did (gotcha #1 again).
    Relaunched as policyA_perp_freeRot with --term-object-slip-yaw 10.0 --term-object-slip-xy 0.5,
    matching the relaxation b_liveA already uses for its rotation-permittin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
2026-07-29 perp: A/B results — A suppresses the reorient, b33-warmstarted B ejects at the seam
    Policy A (policyA_perp_freeRot) trains clean and lifts well: health gate passes late_finger,
    idle_finger (all three persistence 1.00), drop (min hold-phase obj-z 0.111) and jitter. But
    peak_cos is 0.014 — the shaft never rotates. A clamps (thumb 22.3 N, mean 9.2 N), which is the
    too-tight regime of the squeeze sweep. Relaxing the orientation TERMINATION was necessary but
    not sufficient; a_lift still REWARDS holding the object still, so A trades away the free
    gravity reorient the topology hands it.
    Policy B warmstarted from b33 ejects the shaft at the handoff: continuous-handoff eval FAIL,
    min hold-phase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
2026-07-29 perp: correct the B-drop attribution — the SEAM is the cause, not the warmstart
    The b33-warmstarted B ejecting the shaft was attributed to gotcha #5 (a warmstarted policy
    loads a grip-specific residual that ejects the object). That was wrong. Training B from
    scratch — no b33 residual anywhere — reproduces the failure essentially identically
    (min hold-phase obj-z 0.008 vs 0.009 m, lateral drift 20.2 vs 15.1 cm).
    The control settles it: --handoff-step 240, i.e. A driving the whole rollout with no switch,
    passes every health check — obj-z 0.111 m, net lateral drift 0.0 cm, ang-jerk 0.0, only the
    over-clamp WARN. A's hold does not decay over the long horizon, so the open-loop grip bleed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
2026-07-29 assets/mjcf: one directory per hand topology, scenes underneath
    Flat assets/mjcf made it invisible which of the 20+ scenes carried which hand — and scenes are
    self-contained (each embeds a full copy of its hand) rather than <include>-based, so that
    grouping is exactly the thing you need to know. Now:
    assets/mjcf/<hand>/<actuated hand>.xml
    assets/mjcf/<hand>/scenes/<object scenes embedding that hand>
    baseline/ (hand.xml, hand_morphology_actuated.xml + 20 scenes) and perp/ (the opposed-pair
    topology). Only two hands exist: `short_proximal` turns out to be a KEYFRAME variant, not a hand
    variant — every scene shares the same 0.05 m proximal link — so it gets no directory.
    generated/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
    [hand.xml, hand_morphology_actuated.xml, scene.xml, scene_cube_short_proximal.xml, scene_human_calf.xml, scene_morphology_actuated.xml, scene_power_drill.xml, scene_power_drill_lift.xml]
2026-07-29 perp: axial load probe + single-stage recipe; capacity is mu*N, thumb is stranded
    scripts/probe_axial_load.py measures what actually matters for a screwdriver: how much world-Z
    force the grip resists once the shaft is vertical. Ramps an external force until the object slips
    >10 mm RELATIVE TO THE PALM (a world-frame threshold would just measure the palm actuator).
    Results on the frozen perp scene:
    loose grip (pad |y| 0.0140): cos 0.983 vertical, grip bled to 0.3 N -> 1.24 N up / 0.47 N down
    tight grip (pad |y| 0.0105): cos 0.276 barely rotates, grip 14.7 N -> 14.62 N up / 1.09 N down
    Axial capacity is simply mu*N: 2.4 * 0.3 N * 2 pads predicts 1.44 N, 1.24 N measured. So it is
    NOT a ge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
    [perp_single.yaml]
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2026-07-29 perp: the reorient is grip-force-gated — the policy rotates to the WRONG POLE
    perp_single_freeRot finished (339 iters). Both anti-rotation reward terms
    confirmed silenced, and target_axis_alignment still ~0.03 — which reads as
    "still won't rotate" and is wrong. Deterministic eval: held_cos -0.449, mean
    peak |cos| 0.655, 28/32 envs negative. It rotates at full magnitude, to the
    opposite pole. exp(-4(1-cos)) is ~0.003 for any cos<0, so a wrong-way swing
    and no swing at all produce the same number; the persistent negative
    target_axis_progress was the only honest column.
    Two structural facts, neither of them a weight:
    * cos commits between step 20 and 50 (the lift ramp); reorient_start_st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
2026-07-30 perp: thumb support is reachable but exclusive with the swing — and the "hold" was a short horizon
    User's call: sample morphologies to see whether thumb support can be elicited.
    New scripts/sweep_perp_thumb.py (generate -> self-collision gate -> stow the
    thumb clear of the swing corridor -> swing -> IK the thumb onto the settled
    shaft -> axial ramp) and scripts/probe_thumb_reach.py. 15 designs over
    index/middle x and thumb_len; table in docs/experiments/.
    * thumb_x is UNUSABLE: every value >= +0.010 buries thumb_mcp_frame in
    palm_pose at 497-689 N. Moving the thumb forward is not in the 9-param
    space; it needs a palm change. Gate on self-collision or these read as
    ordinary r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
    [perp_single.yaml]
2026-07-31 perp: train the reorient instead of scripting it — and the thumb_x reach is inside the palm
    The scripted two-phase press was the wrong thing to build. Three of the four things
    blocking the reorient are reward/config defects, and the fourth is a missing phase gate,
    so the schedule is expressible as something the policy LEARNS.
    Two findings, both measured:
    1. thumb_x >= +0.010 is inside the palm — 499 N at +0.010, 689 N at +0.0325, the
    position the FK reach study picked. FK does not model the palm, so the thumb "reaches"
    the shaft by passing through solid geometry. The 689 N contact also ejects the object,
    which is why a scripted press there fails for reasons unrelated to the pr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
    [scene_screwdriver_medium_perp.xml]
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2026-07-31 docs: the perp release was an artifact of the scripted probe, not the hand
    Records the 2026-07-31 run: thumb reach measured through the palm (689 N), the two
    infrastructure traps (init_noise_std NaN, unsatisfiable 3-tip requirement), the four reward
    fixes, and the first held reorient (cos +0.947, grip maintained). Closes the open question
    the previous section ended on — "the vertical shaft is not held at all" — in the affirmative.
2026-07-31 perp: gate the catch on ROTATION, not on a step count — both step gates failed, oppositely
    Revision 3 (600-step horizon, catch gate moved 150 -> 450) peaked at iteration 50 and then
    degraded monotonically until it NaN'd at 188:
    iter | 18 | 50 | 80 | 110 | 140 | 170 | 187
    reward | 734 | 883 | 783 | 571 | 528 | 452 | 430
    align | 45.8 | 59.5 | 54.2 | 41.0 | 35.1 | 30.7 | 28.8
    eplen | 409 | 362 | 313 | 239 | 203 | 170 | 165
    The longer horizon exposed the drop at the top of the rotation as a terminal penalty, but
    the catch reward that would have taught the policy to hold through it was gated at step 450
    and the episodes had shortened to 165 — so it n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
    [perp_single.yaml]
2026-07-31 eval: measure policies as distributions — single rollouts of this stack are not reproducible
    Three deterministic rollouts of the same r4 checkpoint, with stochastic sampling off and
    cube_spawn_*_jitter at 0, ended three different ways: held at step 400, lost at 430, lost
    before 400. The actions are deterministic, so the spread is the simulator — parallel contact
    solves do not reduce in a fixed order on GPU. That invalidates the single-rollout method used
    for every per-policy number so far, including the ones in this file's earlier sections.
    New scripts/policy_eval_suite.py runs N envs batched (N rollouts costs about one rollout of
    wall-clock) and reports rates with spreads: align_rate,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
    [perp_single.yaml]
2026-07-31 perp: the hand had no hand file — add it, and the workspace was never sampled
    Every perp result so far (probes, thumb sweep, r2/r3/r4) ran on the all-zeros
    morphology. PERP_T_WORKSPACE was written down when the T-shaped mount layout was
    specified and then never referenced by anything — dead code. Two mechanical
    reasons, both fixed here.
    1. perp had only scenes/, and create_rigid_hand_and_scene_xmls needs a hand/scene
    pair, so every caller passed the scene as BOTH args. That is why
    generated/hand_perp_*.xml is a byte-identical copy of the scene, screwdriver
    included. Adds perp_hand.xml (generation source) and
    perp_hand_morphology_actuated.xml (18 DoF, viewer exploration only)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
    [perp_hand.xml, perp_hand_morphology_actuated.xml]
2026-07-31 perp: palm becomes visual-only; rank the workspace by mechanism; launch r5 queue
    User's decision: don't model the palm at all. The real palm is a complex mechanism
    (it actuates the XY morphology), so the collidable 96x72 mm slab sitting in the
    finger-mount plane goes contype/conaffinity 0 — matching baseline/hand.xml, whose
    palm has always been non-colliding. Free: measured zero contact over 1200 settle
    steps from every keyframe. Gate 5/21 -> 9/21 valid.
    Also removes the stale "thumb_x forward half is NOT usable" warnings from all
    three perp MJCFs — that was a property of the model, not the thumb, and it is now
    false. (The parity test caught my replacement text reintroducing `--` in an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
    [perp_hand.xml, scene_screwdriver_medium_perp.xml, scene_t0d00_x0d00_y0d00.xml, scene_t0d00_x0d00_y0d25.xml, scene_t0d00_x0d25_y0d00.xml, scene_t0d00_x0d25_y0d25.xml, scene_t0d00_x0d50_y0d00.xml, scene_t0d00_x0d50_y0d25.xml]
2026-08-01 perp: a non-colliding palm NaN'd every r5 run — use contact excludes instead
    The whole queue failed at iteration 0-121, INCLUDING the shipped morphology that
    r4 trained for 339 iterations. Diffing my baked scene against r4's frozen scene:
    identical in nq/nu/ngeom/keyframes/open_ik/tip positions, differing in exactly
    one attribute — palm_plate contype/conaffinity [1]/[1] vs [0]/[0].
    So the previous commit's "disabling the palm is free" was wrong. The evidence for
    it was zero palm contact over 1200 settle steps from each keyframe — a scripted
    settle with ZERO ACTIONS. Under exploration the palm<->object contact is
    load-bearing, and without it the shaft escapes into an unintegrable state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
    [perp_hand.xml, perp_hand_morphology_actuated.xml, scene_screwdriver_medium_perp.xml]
2026-08-04 spherepack: S0 — the packing works, and it says pack the OBJECT not the hand
    Analytic sphere packer (tolerance-driven, not count-driven) plus a frozen-scene
    rewriter, and the S0 measurement that redirects the experiment.
    Under real grip load (press, 8.2 N) packing the HAND is inert: 257 spheres on the
    fingers reproduce the single-capsule baseline exactly — 5 contacts, 8.18 vs 8.17 N,
    identical penetration. Packing the OBJECT takes the same grasp from 5 to 29 contacts
    with a 1.7-3.4 mm patch per fingertip.
    The reason generalizes: contact resolution is set by the flatter of the two surfaces.
    Spheres on the high-curvature side (the fingertip) all hide behind the nearest one;
    spheres on th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
2026-08-04 spherepack: standalone viewable packed hands + the tests that pin them
    assets/mjcf/spherepack/{perp_hand_packed,hand_packed}.xml mirror the perp and
    baseline hands at eps=0.01, so the packing can just be looked at without building a
    scene. Separate files, so test_perp_hand_scene_parity.py is untouched.
    Tests pin the two ways a packed scene goes silently wrong: mass (every body's mass
    and inertia must match its source, which is what the inertia bake exists for) and
    shape (the packed surface must straddle the true one within eps*r/2, checked by
    sampling the analytic surface). Plus a regeneration check so the committed models
    cannot drift from their sources.
    Full suite: 114 passed.
    Co-Author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
    [hand_packed.xml, perp_hand_packed.xml]
2026-08-04 spherepack: S1 roll probe — arm B costs ~32% of rolling distance, irreducibly
    The gating test for arm B, since the reorient we are chasing IS a roll. Bare object
    on a plane, launched with matched spin so it rolls rather than skids.
    Good: roll_ratio stays 0.996-0.999 across every packing. The rolling constraint is
    intact, the packed cylinder does not slip, and scallop bob falls monotonically with
    eps exactly as the tolerance formula predicts.
    Bad: rolling DISTANCE does not converge to smooth. It peaks at eps=0.005 (0.68x) and
    worsens at finer eps as contact count climbs 28 -> 94. Cause isolated: Newton
    iter=200, CG iter=500 and tighter tolerances change nothing, but quartering the
    timeste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
2026-08-18 perp: the reorient is compliance-INSENSITIVE, and the r5 queue measured a launcher bug
    Sim2real review against the current (12-exclude) scene, prompted by a prototype nearing ready.
    Three measured results, all N=64 x 600 steps:
    r5 is void. train_perp_compact_queue.sh never passed --lift-delta-z, so every design trained at
    the trainer default 0.05 while r2/r4 trained at 0.14. On a 100 mm shaft hanging vertical that
    puts the lower end in the floor and false-fires the floor-proximity gate. The one design that
    reached 339 iterations evaluates at align_rate 0.0%, every env flat on the floor -- so the
    morphology ranking it was meant to produce does not exist. Fixed with a LIFT_DELTA variable
    defa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
2026-08-18 perp: charge the axial slip that drops every r4 rollout, and make flag drift catchable
    r4 reorients 100% of rollouts to peak cos 0.994 and then loses every one by ~step 400.
    Measured in the PALM frame the shaft slides 44.8 +/- 0.8 mm DOWN through the pinch over the
    hold -- far more than the ~12 mm the world-frame plot shows, because the palm moves too.
    Nothing in the reward saw it: object_lateral_drift and object_xy_drift are both xy, and
    object_lift_height charges ~12 mm of height for what ends as a total loss.
    New object_axial_slip charges downward palm-frame motion per step, one-sided (re-seating
    upward is free) and contact-gated (a dropped object is also moving down; charging that pays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
    [assert_config_parity.py]
2026-08-18 docs: what has to be true on the prototype before a perp sim2real attempt
    Turns the sim2real review's hardware findings into questions someone can answer against the
    CAD. The control and contact-physics risk is measured to be low -- the reorient is
    compliance-insensitive and the policy fits the actuator envelope -- so the risk is concentrated
    in geometry and mounting, and there are three items.
    The 90 deg opposition is a fixed mount quat on index/middle_yaw_frame, not the yaw joint, and
    the yaw servo is +/-45 deg, so the pair cannot be opposed by actuation under any command. It
    needs the finger modules physically remounted rotated 90 deg on their carriages.
    The mounts also sit at |y| = 48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
2026-08-18 perp: the slip penalty works and buys nothing — rotation and retention are one variable
    Charged the axial slip directly and swept the weight. The term does what it was built to do:
    at -3000 the object-z trace is flat for 400 steps, the slip is gone. At -1000 retention
    improves 32% (drop 389 -> 513 steps) and t_align sd falls 97 -> 20.
    It buys nothing net. At -1000 the rotation takes 200 steps longer, so the window where the
    shaft is both vertical and held is 72 steps SHORTER than r4's (183 vs 255). At -3000 the shaft
    holds at cos 0.45 and never finishes rotating -- the failure predicted from the calibration and
    the same one that killed revision 3.
    The calibration is why it was predicted.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
2026-08-18 docs: standalone review page for the opposed-finger reorientation
    Method first, then an appendix on origins and comparisons, per request. Part one is the
    mechanism (gravity swing about an off-centre pinch, with the grip-force window that gates it),
    the single-stage policy and why the A/B split was dropped, the N=64 numbers, the two transfer
    properties that were measured on purpose, and the one open failure. Part two carries the
    history: what the baseline two-stage approach was and the two problems it could not shed, the
    ordered list of failures that forced each element of the method, and a comparison table across
    the five approaches tried.
    Assets are inlined as data URIs -- the artifact hos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
2026-08-18 perp: the thumb study never crossed its two axes, and the press test that refuted it was invalid
    Chasing three-finger bracing on the opposed pair. The standing conclusion was the 2026-07-30
    sweep's "reach is not support -- the objectives fight over one parameter", i.e. a thumb can
    reach the hanging shaft only at a pinch offset where nothing swings. Two things are wrong with
    that.
    First, the axes were never crossed. The im_x rows that produced the conclusion were run at
    thumb_len = 0, where reach can only be bought by moving the pinch. The sweep's OWN thumb_len
    rows already showed the alternative: at thumb_len +0.035 the hanging shaft sits 150.6 mm from
    the thumb mount against a reach shell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
    [assert_config_parity.py]
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2026-08-18 inline: where the shipped hand actually breaks, and why the pad should stay a point
    The opposed arrangement is dropped on hardware grounds, so the inline pair is the sim2real
    candidate and the only robustness axis ever measured on it was contact stiffness. Walked the
    rest with the frozen a10->b33 handoff, n=32 x 300 steps per point, one physical property moved
    at a time.
    Three cliffs, and they are one statement. Halving pad friction (mu 2.4 -> 1.2) drops hold to
    0.09; thinning the shaft 15% drops it to 0.03 and reverses the rotation; stiffening contact one
    step drops reorient to 0.09. Anything that reduces purchase at the contact kills it, and it is
    one-sided: more friction, more mass and a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
2026-08-18 harden: domain-randomise the two contact cliffs under a b33 finetune
    The robustness sweep found three cliffs and the hardening only addresses two. Pad friction is
    the sharpest (mu x0.5 takes hold from 1.00 to 0.09, worse than the stiffness cliff) and had no
    DR at all -- cube_friction_scale_range has sat in env_cfg marked "(deferred)" with no
    implementation behind it. So randomize_geom_friction now exists, mirroring the solimp event:
    one scale per env per reset, sliding term only, off the SCENE value rather than the current one
    so it cannot compound toward zero across resets. Verified writing per-world values (0.56-2.74
    across 16 envs) rather than silently no-op'ing, which is the failure mode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
2026-08-19 docs: the as-simulated finger spec, and three things that will bite a build
    Pulled from the frozen m05 scene the shipped policies actually fly rather than from any design
    note, because several older notes describe base scenes nothing ever trained on.
    Three findings the numbers surfaced. The proximal COLLISION capsule is a fixed 50 mm in every
    build while the length parameter only moves where the middle phalanx attaches, so the shipped
    hand carries 9-14 mm of overlap with the middle phalanx sitting inside the proximal capsule --
    not manufacturable as drawn, and not cosmetic either, since a real share of grip load goes
    through the links rather than the pads. The URDF exporter cannot emit this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
2026-08-19 scene_mutate: trim the proximal capsule to its own kinematic length
    The generator writes a fixed 50 mm capsule into <f>_mcp_frame regardless of the
    design's proximal length; the length parameter only moves where <f>_len_frame
    attaches. On m05 that leaves 9-14 mm where the middle phalanx sits inside the
    proximal capsule. shorten_proximal() redraws it as `fromto 0 0 0 L 0 0`, the same
    rule the middle and distal phalanges already follow, with inertials pinned so only
    the contact surface moves.
    Measured: b33 transfers to the trimmed hand zero-shot (hold 0.969 / reorient 0.938
    / align 1.00 vs 0.906 / 0.906 / 0.938 baseline, n=32 each). Contact attribution
    explains why -- the proximal never touch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
2026-08-19 perp: the thumb's problem was the other two fingers, and the short proximal is what holds
    r7 left one reading open: the policy could reach the shaft and never touched it -- was that
    because deploying the thumb ejects the tool, or because it could not reach? Scripted engages
    settle it. Six of six eject, at 8-11 N of thumb. After the swing the pair sits at +-90 deg, so
    its two normals are collinear along Y; a thumb pushing from -X is tangential to both and only
    friction opposes it. Touching, at that geometry, IS dropping -- no thumb trajectory fixes a
    defect in where the other two fingers are.
    Swinging the pair's contacts onto the +x flanks (+-60 deg) makes the three normals span the
    plane, a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
    [scene_screwdriver_medium_perp_sp25.xml]
2026-08-19 perp: the base-scene chuck was mount compliance — frozen, the fix is palm-frame hold targets
    Yesterday's probes ran on base scenes with the morph joints live. They are unactuated but not
    rigid: under grip load the mounts slide in their ranges and the hand absorbs the thumb's push.
    CLAUDE.md gotcha #4 applies to a scripted probe exactly as to CEM. Re-run on frozen scenes.
    Three things move. The pinch over-clamps -- the depth that gave 13-17 N base gives 25-29 N
    frozen, and at that force the pair stops being a bearing and the shaft never swings; it has to be
    re-tuned to 0.2-1.0 mm. The sp25 chuck that read 100% reads 0%. And the failure turns out to have
    a direction: the shaft walks along p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
2026-08-19 perp: r8 launcher — train the sp25 chuck, and record the scripted maneuver as its reference
    The probe can now dump its rollout as a reference trajectory in the layout --morphology-run
    expects, so the scripted chuck IS the demonstration if imitation turns out to be needed.
    r8 is a real test of the brace reward rather than a repeat of r7, on two measured grounds. At
    r7's geometry touching WAS dropping (six scripted engages, six ejections), so a policy declining
    to touch was correct; on the 25 mm-proximal hand with palm-frame hold targets the same engage
    holds. And the brace pose is now inside the policy's own authority -- the scripted chuck's thumb
    sits 0.34/0.36/0.06 rad from the closed_ma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
2026-08-19 sp25: the 25 mm-proximal hand, trained end to end
    sp25 = m05 with the proximal length parameter zeroed (25/25/25 vs 35.8/37.3/40.9),
    mount XY held at m05 so length is the only variable. Full result in
    docs/experiments/SHORTPROX25.txt.
    THE SHORT HAND GRIPS BETTER. Cleaner CEM grasp on every stability term, A health
    better than a10 on force (5.5 vs 9.7 N), jitter (6.3 vs 20.9) and de-centering, and a
    perfect hold rate through the handoff (1.000 vs 0.969). Low-variance measurements, and
    the halved pad force relaxes the MCP servo sizing directly, since finger_spec.md
    extrapolates torque linearly from pad load.
    REORIENT IS NOT SETTLED. Measured 0.41-0.56 vs m05's 0.938, but that is n=1 A draw a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
2026-08-20 parity: compare new fields against the dataclass default, not a list of falsy values
    The check aborted both r8 runs 25 s in and left the GPU idle all evening, over
    `friction_dr_scale` -- a field added after the reference ran, sitting at its own default
    (0.55, 1.15), with `friction_dr: False` beside it. The old rule treated an absent-in-reference
    field as inert only if its value was falsy, and a tuple is not falsy. The gate being off is not
    visible from the range's own value; the default is.
    Now every env.* field is compared against MorphoHandEnvCfg's default, so a feature nobody
    touched passes and a feature actually turned on still fails. A parity check that cries wolf gets
    --allow'd reflex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
    [assert_config_parity.py, test_config_parity.py]
2026-08-20 rl: chuck_pose_match — state the hold as a whole-hand configuration, not a thumb force
    thumb_brace_force pays the thumb for touching and says nothing about where the other two fingers
    are. On the opposed pair that is not enough: a thumb press against a pair still at +-90 deg
    EJECTS the shaft (six scripted engages, six ejections), so the reward asks for a motion whose
    immediate consequence is a drop and PPO correctly refuses -- the term read 0.0000 for all of r7,
    and reads 0.0000 again 20 iterations into r8.
    So state the target as the whole configuration. Measured over the scripted hold, the three
    fingertips in the shaft's own frame are static to 1.46 mm per axis, which is why a single pos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
2026-08-20 perp: r9 sweeps the RESIDUAL BUDGET — the chuck pose is unreachable, not unexplored
    Measured off the demo's own hold rather than from an IK guess: the chuck sits 1.296 rad from the
    closed set-point at thumb_pip, 0.654 at middle_pip, 0.559 at thumb_mcp. The policy's action is a
    +-0.5 rad residual around that set-point, so three joints are outside the budget. The pose cannot
    be commanded at all, and r7/r8's flat 0.0000 is exactly what an unreachable target looks like
    from inside a reward table -- no weight on any term can buy it.
    This corrects the reachability claim in the r8 launcher, which read the excursion off the
    engage-time IK solve. That solve is the first contact, before the trackin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
2026-08-20 eval: one command to score the sp25 opposed runs against the scripted chuck
    Each run is evaluated at ITS OWN finger_residual_scale, read from its config. r9 deliberately
    breaks train/deploy parity to give the policy authority to reach the hold pose at all, and
    scoring it at the trainer default would be a 3x residual mismatch -- the artifact gotcha #13
    exists to warn about, which has already impersonated a seam failure once.
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2026-08-20 test: pin the two ways the action-budget check gets read wrong
    Both were real. It must fail when ONE joint overflows rather than when the average does, and it
    must read the sustained hold rather than the approach -- on the synthetic two-phase demo the hold
    needs 1.30 rad and the whole-rollout mean asks for 0.75, which is exactly how the wrong
    reachability claim got made.
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2026-08-20 rl: per-joint finger residual scale — give the thumb authority without loosening the swing
    The opposed hand's three-finger hold is 1.296 rad from the closed set-point at thumb_pip against
    a +-0.5 rad residual, so the thumb cannot be commanded there. Raising the scale to 1.5 for every
    joint NaN'd the scene at iteration 0 on both noise levels tried, because it also hands that
    authority to the opposed pair during the gravity swing the recipe is built to keep gentle.
    Re-centring the set-point instead does not work either: the hold pose is defined for a lifted
    vertical shaft, and a thumb parked there pre-lift drives into the floor at 34.8 N (measured, not
    predicted). The thumb reads 0 N throug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
2026-08-20 rl: schedule the finger ANCHOR instead of widening the residual
    The residual is bounded, so the set-point decides what the policy can reach, and on the opposed
    hand the grasp pose and the three-finger hold are 1.296 rad apart at thumb_pip. Every
    time-invariant way of spanning that gap is now a measured failure:
    uniform residual 1.5 NaN at iteration 0, at init_noise 0.02 and 0.01
    static re-centred thumb parks in the floor at 34.8 N before the lift
    asymmetric budget thumb wrecks the grasp, drop at step 78 vs 485 (r10, align 3.1%)
    They fail for one reason: the thumb's useful pose and its harmful poses are the same
    neighbourhood, separated by WHEN, not by how far. So move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
2026-08-20 perp: r10 and r11 — widening the budget and moving all three anchors both fail
    r10 (thumb 1.5, pair 0.5/0.7): giving the thumb range did not recruit it, it let the thumb wreck
    the grasp -- align 3.1%, drop at step 78 against r9's 485, tip_lost 32.2 against 1.9. Confound
    stated: r10 ran at init_noise 0.01 after NaN-ing at 0.02 where r9 used 0.02.
    r11 (anchor schedule, all three fingers): mechanically sound -- required excursion from the hold
    set-point is 0.000 rad and the smoke gave 342-step episodes at iteration 20 against r9's 69 -- and
    still 0% align, because it moves the wrong anchors. The opposed pair is what holds the object, so
    relocating its set-point at cos >= 0.7 relocates the pi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
2026-08-20 rl: the anchor switch needs height as well as alignment — r12's collapse was my gate
    r12 moved only the thumb's anchor (the pair untouched, since the thumb reads 0 N through the lift
    and swing) and the collapse watchdog aborted it at iteration 52: object_height 0.0248 < 0.03,
    object_floor_proximity firing 125x per episode. The policy learned to stop lifting.
    The gate was wrong, not the schedule. The hold pose is defined for a shaft that is upright AND
    LIFTED, but the shaft crosses cos 0.7 early, while it is still low. Gated on alignment only, the
    thumb's anchor sweeps to a pose that belongs 120 mm higher and knocks the object, and "never lift"
    is the only behaviour that avoids the penalty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
2026-08-20 cluster: port the RL stack to NSF ACCESS / DeltaAI — the seed budget is the point
    Adapts the ACT/LeRobot runbook (docs/nsf_access_runbook.pdf) to MuJoCo-Warp +
    PPO. That deck's question was whether one imitation run fits in 1.5 GPU-hours.
    Ours is different: a single GPU forces every run to be sequential, which is why
    every design comparison so far has been made at n=1 against a per-draw sd of
    0.3-0.5. At sigma ~0.35, n=4 only resolves differences of 0.7 in mean held-cos —
    we have only ever been able to see the largest effects, and that is the real
    reason the 9-dim landscape came back unreadable.
    An array job makes the seed the array index. 20 designs at n=48 is ~560
    GPU-hours, which is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
2026-08-20 cluster: measure DeltaAI — a GH200 is 0.66x the workstation, and num_envs does not save it
    The runbook's throughput numbers were projections from FLOPs and bandwidth. They
    were wrong in DIRECTION. Measured on jobs 2989123 and 2989164, both at
    num_envs=3072 x 24 steps per iteration:
    RTX 4070 Ti SUPER 7.00 s/iter 10,530 steps/s
    GH200 120GB 10.3-11.4 ~6,950 steps/s 0.66x
    A GH200 has ~2x the SMs, so this is not a raw compute deficit on paper. The
    obvious hypothesis was CPU-side kernel-launch overhead on the slower Grace ARM
    cores, which 95 GiB of HBM makes free to test. deltaai_envscale.slurm tests it
    and it is FALSE: iteration time is exactly linear in num_envs f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
2026-08-21 probe: the b33 seed study died on a NaN cliff, and b33 trained on the wrong side of it
    The 16-draw b33_seeds queue returned 1 completion and 15 NaN failures
    (`observation group 'actor' contains NaN`), at iterations 2, 2, 2, 7, 7, 8, 10,
    19, 27, 27, 44, 92, 143, 180, 185. That spread is a per-step hazard, not a
    cluster of bad seeds.
    First hypothesis was the platform — locally, harden_b33_queue had run three 541-
    iteration finetunes of this same env with zero NaN, which is ~1,600 clean
    iterations against ~830 dirty ones on the GH200. Wrong: re-running the three
    fastest-failing seeds (9, 13, 10) HERE reproduced the NaN at iterations 21, 36,
    22. aarch64 changes when it strikes, not whether.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
2026-08-21 fix: b33 warmstarts a10, not b10 — the wrong checkpoint NaN'd 15 of 16 draws
    The b33_seeds queue used --init-actor-checkpoint b10, taken from the launcher's
    DEFAULT B_CKPT rather than from b33's provenance. REGISTRY.md is the record:
    b33 = "live-A reset, warmstart a10"; b24 is the one that warmstarts b10. b10 is a
    hold-only policy trained on the BASELINE hand, so every task loaded an actor from
    one morphology onto m05's IK-retargeted geometry — gotcha #5, the same
    cross-morphology warmstart that ejected the shaft on the perp hand. The residual
    is meaningless there, it drives the fingers into the shaft, and mjwarp's contact
    solve diverges.
    Confirmed by substitution on the three fastest-f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
2026-08-21 b33 seed band: b33 is an ordinary draw, and the warmstarted recipe is NOT seed-dominated
    16 draws of b33's lineage on DeltaAI (15 SU), scored through the continuous
    handoff at 3 rollouts each.
    15 core draws 0.827-0.935 mean 0.873 sd 0.032
    1 tail draw 0.452 (s10, drop-prone, held 2/3)
    b33 itself 0.891 -- 11 of 16 at or below it
    rollout noise sd 0.080
    Two results. First, b33 is typical, slightly above median: the robustness
    cliffs, the fingertip ranking and the hardware spec were measured on a
    representative policy, which is what this study was run to check.
    Second and larger: between-draw sd 0.032 is SMALLER than the 0.080 rollout
    noise. The program-wide 0.3-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
2026-08-27 morph: the finger has TWO links, and the short ones hit a palm-clearance ceiling
    Hardware asked whether a 40 mm proximal / 30 mm distal finger works. Answering it
    first meant naming the links correctly: every length this program has published is
    the co-design PARAMETER, which moves only the first of the two capsules the scene
    draws the MCP link with. m05's MCP->PIP link is 75.8-80.9 mm and the "25 mm hand"
    is a 65 mm one, so nothing has been trained within 25 mm of the target.
    Scene.set_link_lengths sets the two flexing links directly (the existing
    set_proximal_length cannot express a 40 mm MCP link at all), and
    build_link_length_variants.py takes a config through the three edits that have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
    [scene.xml]
2026-08-27 morph: put the MCP joint at the END of the yaw link, and fit the palm
    Two corrections from the hardware read, both of which changed the answer.
    The yaw link was modelled as a translation of the whole finger, which left the yaw
    and MCP axes coincident — the very thing the base scenes get wrong and the reason
    the segment was being modelled at all. It now sits BETWEEN the two joints, and its
    direction turns out to matter more than its length: along the yaw axis it is ahead
    of the first flexing joint, so it adds reach in the flexion plane and no vertical
    travel (40x30+32 ceilings at 0.86 against the bare 40x30's 0.88 — nothing). Only a
    link that hangs the MCP axis below the mounting plane b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
    [scene.xml]
2026-08-27 morph: leave the yaw axis alone and run the yaw link perpendicular to it
    The yaw axis never needed changing; I changed it to the palm normal and asked a
    question that conflated "perpendicular to the link" with "about the palm normal".
    Reverted. With the axis back at (1,0,0) the link cannot lie along +x — that is the
    axis, so the MCP joint sits ON it, yaw cannot swing it, and the joints stay
    coincident no matter what the body origins say. yaw_link_dir now defaults to (0,0,-1)
    and set_link_lengths refuses any direction with a component along the axis.
    Adds yaw_mcp_offset: perpendicular distance from the MCP anchor to the yaw axis LINE,
    read off the compiled model and printed for every build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
    [scene.xml]
2026-08-27 morph: draw the yaw link — it existed in the kinematics and nowhere else
    The 32 mm segment was correct in the model (MCP anchor 32.0 mm off the yaw axis on
    every finger, and sweeping yaw moves that anchor through a 36 mm arc) but carried no
    geom, so the viewer showed each finger starting in mid-air below the palm with
    nothing joining it. A link you cannot see is a link nobody can check, and it reads as
    the coincident-joint bug even when the numbers say otherwise.
    It now carries a capsule and its own mass: the yaw frame's placeholder inertial is
    dropped so density derives the mass the way it does for every other phalanx.
    [scene.xml]
2026-08-27 morph: draw each link at its kinematic length, caps included
    The links were 40 and 30 mm anchor-to-anchor but drew 58.5 and 37.5, because a
    capsule extends by its radius past each fromto end — 10 mm of the proximal stuck
    backwards through the yaw link. Right ratio, wrong picture, and the picture is what a
    CAD check is read against. Same defect finger_spec §3(a) records on the shipped hand,
    where m05 draws a 94 mm envelope on a 75.8 mm proximal.
    --cap-inset lands the hemispherical cap ON the joint instead of a radius past it, and
    is applied at each LINK's outer ends only: the tapered sub-segments are shorter than
    their own caps, and insetting both ends of those collapses the fromto. Envel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
    [_fit.xml, scene.xml]
2026-08-27 docs: hand-off summary for the hardware finger geometry study
    Rewrites the gate write-up around the two corrections that landed after it was first
    written — the yaw link's direction and the drawn-vs-kinematic link length — and around
    the finding that reverses its conclusion: once the 32 mm yaw link is modelled, every
    candidate length clears the palm-clearance ceiling, so geometry can no longer rank
    them and only a trained reorient can.
    Written for a fresh agent to pick up: the terminology correction, the two topology
    mistakes and the check that catches them, what has and has not been measured (nothing
    with a controller), the five traps this study hit, and the ordered next steps for when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
2026-08-28 docs: date-prefix rule, and the CAD sources move next to the hardware model
    The link-length gate write-up is about a specific hand, so it lives with that
    hand's MJCF rather than loose in docs/experiments/. Adds the CAD sources it and
    everything after it are measured from: the hand-drawn kinematics, the DH table
    and TikZ figure, and the XY workspace drawing the gantry travel comes from.
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2026-08-28 real_v1: the shaft was creeping out because the grasp sat above the shaft's equator
    Policy A lifted fine and then leaked the object: object_height 0.106 against a
    0.10 target, with tip_lost firing 1.4-2.3 per batch. Reproduced with no policy at
    all (probe_real_v1_slip.py, new): the shaft rides the whole 10 cm lift on three
    contacts, then the normal force decays 1.75 N -> 0.00 N over 0.6 s of standing
    still and it falls straight down, x and y unchanged to under a millimetre.
    The fitted pose put all three pads +10.1 deg above the shaft's axis. On the upper
    hemisphere the contact normals tilt up and outward, so the wedge drives the shaft
    down out of the pinch, and the friction opposing it acts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
    [hand_tp0d0110p0d0000p0d0000_in0d0150n0d0300p0d0000_mn0d0015p0d0200p0d0000.xml, scene_tp0d0110p0d0000p0d0000_in0d0150n0d0300p0d0000_mn0d0015p0d0200p0d0000.xml]
2026-08-28 real_v1: refit at the equator, and the pinch has a minimum width
    All four viable designs now hold the FULL commanded 50 mm lift with three contacts
    and persistence 1.00, against 47-48 mm and two silent drops before the elevation
    fix. rv05_manual -- the user's own hand and grasp -- holds 49.4 mm.
    The two designs with a 40 mm thumb-to-pair separation have no viable pose at all,
    for a reason worth stating as a constraint: pads on the shaft's equator sit on a
    ring 48.1 mm across for a 25 mm shaft and a 21 mm pad, so a 40 mm pinch would have
    to place each pad outboard of its own mount, and flexion only moves a tip inboard.
    That bounds the X design dimension from below by the object, not by the h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
    [rv00_wide_sp40__fric_mu4.xml, rv00_wide_sp40__fric_torsion.xml, rv00_wide_sp40__pads_soft+torsion.xml, rv00_wide_sp40__pads_soft.xml, rv00_wide_sp40__pads_softer.xml, rv00_wide_sp40__palm_down5.xml, rv00_wide_sp40__palm_up5.xml, scene_tp0d0000p0d0000p0d0000_in0d0000n0d0000p0d0000_mn0d0000p0d0000p0d0000.xml]
2026-08-28 docs: clear stale collapse sentinels from the superseded pre-fix runs
    [scene.xml]
2026-08-28 Revert files a stray `git add -A` swept into the previous commit
    The previous commit was meant to be empty of tracked changes -- it only cleared
    stale watchdog sentinels under logs/, which is gitignored. `git add -A` instead
    picked up a local .dotenv (one line, a username), a MuJoCo model dump, LaTeX build
    artifacts and an embedded git repository. Removed from tracking and gitignored.
    The .pdf and .tex from the kinematics build are kept; the intermediates are not.
2026-08-28 real_v1: an authored keyframe cannot live in a generated scene
    rv05_manual's Policy A collapsed on both draws with contact_count 0.00 and 10.3 cm
    of object drift -- the hand rises off the table and leaves the shaft behind. Not
    the design: open-loop it holds a full 10 cm lift on three contacts at 2.90 N.
    `pose: "stored"` stopped the fitter from overwriting the user's authored keyframe,
    but the `generate` stage rewrites the scene file wholesale from the base pair and
    carries the BASE's keyframes forward, so the pose was silently replaced by one
    belonging to different mounts -- thumb pad 10 mm inside the shaft at reset. CEM
    found a working grip from that seed anyway and reported held +49.4 mm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
2026-08-28 real_v1: hold is solved, reorient never fired, and the target was outside the action space
    Three designs completed A->B. All three carry the shaft through the continuous
    handoff at min-z 0.105-0.116 against a 0.05 bar, three fingers in contact 100% of
    the time, under 3 mm of net drift -- the elevation-0 grasp fix holds up against a
    trained policy. None of them rotates it: peak alignment cosine 0.015-0.069, and the
    shaft is horizontal in every frame of every filmstrip.
    probe_real_v1_vertical_hold.py (new) says why. Asking each hand to ring a VERTICAL
    shaft at the height the handoff holds it, and measuring that pose against the
    +-0.5 rad residual budget the trainer centres on the CEM grip: rv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
2026-08-28 real_v1: the grasp was a rotational lock, and the reorient is one more keyframe
    Four designs held the shaft through the A->B handoff and turned it by 0.9-4 degrees, on hands
    whose mounts differ by 60 mm. A result invariant to the morphology is not about the morphology,
    and it is not a seed draw either.
    WHAT IT IS. A fixed-contact rotation of theta about the pinch axis sends the descending pair
    contact down by straddle * sin(theta), and its finger pays for that by EXTENDING.
    `fit_real_v1_pose` chooses the DEEPEST reachable palm -- for clearance over the shaft's upper
    half once it stands up -- so every design grasps within 1.3-9.6 mm of the 68.11 mm straight-chain
    reach. Against the +-30 to +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
    [scene_tp0d0110p0d0000p0d0000_in0d0150n0d0300p0d0000_mn0d0015p0d0200p0d0000.xml]
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2026-08-28 real_v1: a seconds-per-design reorientability metric, and it agrees 9/9
    ceiling = asin(extension_left / straddle) -- one forward-kinematics call. The program has looked
    for a cheap design score before and got no for a good reason: reorient_primitive.py feasibility
    finds every design reaching a recorded schedule to 0.2-2.2 mm on a 12.5 mm shaft, so reachability
    is SATURATED and cannot rank; UHAS authority ranked the grip and correlated -0.03 with goal
    approach. A reorient is not a reachability question, it is a budget one.
    Swept over the 2 dimensions the workspace has, fixed straddle, no CEM and no policy, ~1 min per
    design on CPU, and scored against the open-loop carry it claims to stand in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
2026-08-28 real_v1: robustness of the scripted carry — height-invariant, helped by LOWER friction, mass-sensitive
    Delivery height does nothing: 0.995-0.997 on three fingers at every lift from 0.06 to 0.14 m, and
    even 0.06 keeps the shaft 23 mm off the table, so the turn is floor-free across the range.
    Friction hurts in the unexpected direction. mu 1.2 gives the cleanest turn in the table and
    mu 4.8 drops the shaft -- the carry needs the pads to slip a little against the shaft as it comes
    round, and too much grip makes the fingers fight it. The scene's 2.4 is already high for TPU on
    steel, so the hardware sits on the favourable side. Opposite sign from the inline hand's friction
    cliff, because this i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
2026-08-29 real_v1: sample 108 hands, and measure the reorient as a distribution
    The open-loop reorient turned out to be measured wrong in three ways at once, and all three
    were fixed before anything was sampled:
    * THE DEPLOYABLE CONTROLLER IS THE LINEAR ANCHOR. Every headline "the raised pivot works"
    number in the 2026-08-28 writeup carries max_ik_residual 0.0 and zero commanded tip travel,
    i.e. it was run with --linear-anchor -- a straight line in joint space between two set-points,
    which is exactly what LerpFingerActionCfg.hold_target_ctrl expresses. The per-step IK carry
    is the WORSE controller (rv03_narrowy 0.62 against 0.95), so the reorient needs no runtime IK.
    * ONE ROLLOUT IS NOT A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
2026-08-29 real_v1: the grasp decides the turn — 49 of 108 hands reorient once the thumb has an arm
    Design search over the 6-dim gantry workspace: 108 hands, 12 fitted grasps each, 24 schedule
    cells per grasp, 3 jittered draws per cell, ~39k rollouts on CPU. 80 hands have a grasp and
    49 stand the shaft up and keep it, against 0 of 5 a day ago.
    THE KNOB. `fit_real_v1_pose` put all three pads on one ring, which parks the thumb at the
    shaft's mid-length -- the one place where its moment arm about the pinch axis is zero, so the
    hand's largest normal force could contribute no torque at all. `--thumb-axial` slides only the
    thumb along the shaft. On rv04_mid, same design, same straddle, same pivot heig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
    [ax_asym10.xml, hand_tn0d0036n0d0086p0d0000_in0d0090p0d0236p0d0000_mn0d0266n0d0026p0d0000.xml, hand_tn0d0037n0d0350p0d0000_ip0d0055p0d0047p0d0000_mp0d0029p0d0186p0d0000.xml, hand_tn0d0064n0d0161p0d0000_in0d0045p0d0269p0d0000_mp0d0205p0d0273p0d0000.xml, hand_tn0d0079n0d0425p0d0000_ip0d0150p0d0227p0d0000_mp0d0055p0d0096p0d0000.xml, hand_tn0d0096n0d0173p0d0000_in0d0237p0d0078p0d0000_mp0d0116p0d0095p0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]
2026-08-29 real_v1: the grasp survives a wrong hand, the turn does not — a deployment envelope
    Plans the shippable schedule on the nominal hand and replays that same joint trajectory,
    unchanged, on a hand/tool/servo that differs from it — which is what a bench does. 33,840
    one-at-a-time rollouts across 18 designs plus 18,000 joint-perturbation draws.
    The failure is not where it was assumed to be. Every perturbation grasps and lifts: at 1-2 deg
    of per-joint servo zero error, 100% grasped and 100% lifted, and under the full joint ensemble
    still 87%/89%. What breaks is the turn — 61% of the lifted runs at 2 deg drop the shaft during
    it, 79% under the ensemble. So gating the close on contact force b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
2026-08-29 real_v1: without the z stage the operating point does not transfer, and the finger is not round
    Two corrections from the bench, both of which move the answer.
    NO Z STAGE. The prototype has a fixed palm and the tool on a platform. Replaying each design's
    lift-tuned plan there wins 6% of the time — at its own cell every design puts the tool on the
    floor. Re-searching the cell for the bench gives 20% (g24 5->30%, rv00_wide 0->20%, g12 15->32%).
    The bench-optimal cells are systematically elsewhere: bigger turn angles, different straddles,
    lower pivots. The capability transfers; the operating point does not. Policy A *is* the lift, so
    on a fixed palm the A->B architecture has no A. The support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
    [ax_tx+20_traj.csv, g12_traj.csv, g23_traj.csv, g24_traj.csv, rv04_mid_traj.csv]
2026-08-29 real_v1: the flat pad wants a 10 mm squeeze, and that is worth more than any hand
    Re-searched the fixed-palm bench on the corrected finger with the squeeze the flat face actually
    needs. 522 of 3,120 cells reorient and keep the tool -- 17%, against 2.6% at the fitter's 4 mm
    squeeze with the built 14.8 mm tip. Six and a half times the working region, and a larger effect
    than the choice of design.
    Confirmed on 200 draws under a seed that did not select the cell: g12 70% at a careful bench and
    89% keeping the tool, 27% with everything wrong; then g23 49/63/28, g24 44/52/22, rv04_mid
    40/56/22. g12's usual failure is a tool still in the hand, not one on the floor.
    Fingertip width, paired over 50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
    [g12_traj.csv, g23_traj.csv, g24_traj.csv, rv04_mid_traj.csv]
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2026-08-29 manta: add verify_axis_direction.py, a direct MOVEMM sign probe
    hand_control.py's REPL cannot test the J4 sign question: its
    <finger>_x segment is bounds-checked against axis_stepper_range(), which
    returns (-62.2, 0.0) for J4 and so rejects every positive value while
    accepting only the negative ones that drive into the home hardstop.
    This probe drives the Joint directly, bypassing that check. It homes the
    axis first so the probe starts against the hardstop, where an
    "into home" command has no travel available and a wrong guess is
    harmless either way.
2026-08-29 manta: J4 travels positive from home like every other axis
    FULL_EXTENSION_MM[4] was -62.2, on the recorded theory that middle's x
    rail is "mirrored" and genuinely travels negative from home. It isn't.
    HOME_DIRECTION=+1 runs an axis's step count up into its home hardstop and
    ZERO pins that at step 0, so with all six STEPS_PER_MM negative, positive
    mm is the only direction that moves away from home -- uniformly, with no
    compensating flip on J4.
    The rail IS mirrored, but in which corner it homes at (local q_My min,
    where index homes at max), and _TRANSFORM already carried that. Encoding
    it a second time in FULL_EXTENSION_MM flipped the sign twice: the middle
    finger's x axis was commanded over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
    [kinematics.py]
2026-08-29 manta: correct stale adduction claim in bringup.md
    bringup.md still listed "calibrate remaining fingers' adduction range" as
    open work, saying only finger 0 had a measured range (a conservative
    +/-44 deg) and that fingers 1/2 would raise on nonzero adduction. The
    2026-08-29 assembled torque-free sweep superseded that: all three fingers
    carry real bidirectional aa ranges in FINGER_JOINTS -- f0 (-70.02,
    +74.71), f1 (-79.69, +74.41), f2 (-75.29, +75.29). ADDUCTION_RANGE no
    longer exists as a symbol.
    Also records the tightest common range, (-70.02, +74.41), for callers
    that drive all three fingers from one uniform command range.
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2026-08-29 planner: update signs to flip yaw (middle, index) to negative, rest remain positive
    [plan.py]
2026-08-30 Control station: fix the four faults behind the 2026-08-29 bench failure
    An operator homed the hand from the web UI, pressed Stop mid-home, watched the
    home continue anyway, then pressed "Move gantries to morphology" and lost the
    service. Querying the M8P afterwards showed it had never crashed: ttyACM0 alive,
    all six axes enabled, four of six reporting a StallGuard2 stall. Every fault was
    in the host software.
    1. Home never zeroed the servos. hand_control.py enables all nine before calling
    home_all(); the service did not. A torque-OFF SCS0009 accepts a goal-position
    write and reads it back correctly without moving, so zero_joints() reported
    success having moved nothing. Torque is n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
    [fake_hardware.py, hand.py, kinematics.py, plan.py, runtime.py, servos.py, test_manta_hardware_faults.py, web.py]
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2026-08-30 Servo bus: restore the real-time write path, and adopt an existing home
    The write-gap rule I added applied the 300ms inter-command delay to
    sync_set_joints, which is the one real-time path on the bus. Its docstring
    says plainly that "a control loop calling this every frame can't afford
    one" -- and it was right: consecutive frames were capped at 3.33Hz, so a
    50Hz trajectory would have replayed 15x too slowly. That is a wrong
    experiment rather than an obvious failure, which is the bad kind.
    Measured on the real chain to settle what the gap is actually for, writing
    each servo the pose it was already holding so nothing moved:
    sync writes alone, back to back 2859 Hz, 0 errors / 14298
    wr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
    [runtime.py, servos.py, test_manta_hardware_faults.py, web.py]
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2026-08-30 real_v1 bench: the free-air control, and the seat-grip step that was scratch-only
    The three pre-grasp logs from the same evening turn out to be the control the
    loaded runs needed. Same commanded middle-yaw sweep: 25.8 deg with no shaft,
    25.5 with a shaft the hand is about to drop, 12.6 clamped -- twice, within
    0.0 deg of each other. So the 13 deg shortfall is grip load and nothing else,
    the 3 deg residual is the static servo droop already documented, and 12.6 is a
    repeatable ceiling rather than noise. Run 4 hit it by step ~24, which means the
    last 30 steps of the commanded trajectory moved the finger not at all.
    Also promotes the grip-seating ramp, which lived only in scratch: without it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
    [real_v1_bench_grip.py]
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2026-08-30 2x2 queue: seed-aware sentinels, and score the blind arms blind
    Two fixes found while smoke-testing the queue end to end (4 arms x 1M timesteps,
    all rc=0, the eval harness validated against a real checkpoint):
    * Sentinels were `<arm>.DONE`, not seed-aware, so a second seed would skip every
    arm the first seed finished and the queue would report 4/4 having trained
    nothing. Same failure shape as the launcher-flag drift this repo has lost four
    experiments to: a silent skip that produces a plausible-looking result.
    * `eval_blind_actor_2x2.sh` passes `--actor-blind-terms` when scoring the blind
    arms. An actor trained on zeros for the object terms and then handed live
    values is out of di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
2026-08-30 reorientation.md: log the observation ablation and what it does to the transfer plan
    The engineering log is the source of truth for the RL track, so the result that
    reframes the partial-observation program belongs in it rather than only in
    docs/experiments/. Records the three interventions that disagree (zero vs
    replay/shuffle), the variance report that makes any of them interpretable, and
    the jitter arm where b33's own observations turn out to be net harmful.
2026-08-30 Carry: sweep object mass, and stop scoring a dropped shaft as a success
    The appendix named object mass as the parameter most likely to invalidate a
    hardware claim and asserted that doubling it breaks the open-loop carry. There
    was no way to vary it, so nobody had checked. `--object-mass` / `--mass-scale`
    now override it at EVERY model load (grip fit, IK scratch, live rollout -- a fit
    that picks a grip for one object and a carry that runs it on another is a silent
    parity bug), scaling body_inertia with body_mass so the shaft does not quietly
    become rotationally heavy.
    Measured on the built hand, baseline reproducing the published row exactly
    (0.996, z 0.113, 3 contacts, 12.02 N): the carry h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
2026-08-30 Carry: trace finger-finger clearance, and point at the gate that actually matters
    --selfcollision measures minimum cross-finger distance along the carry with
    mj_geomDistance, which ignores the 21 contact exclusions the scene needs for the
    grasp and would otherwise let two fingers pass through each other while the probe
    reports a clean turn. All four published carries are clear on this path (28.9-38.8 mm).
    That number is reassuring about the wrong thing, so the docstring now says so. The
    hardware replays the EXPORTED plan -- a three-set-point chord, plus a CSV whose
    per-joint timing differs from it -- and scripts/real_v1_trajectory_clearance.py
    already gates both. It should have been the fir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
2026-08-30 Mass tolerance belongs to the PLAN, not to the hand
    The dense-carry sweep found rv05_manual dropping between 65 and 70 g, and I used
    that to warn that a 65 g screwdriver sits on a cliff. Sweeping mass through g12's
    own exported CSV instead -- the artifact the bench actually replays -- gives a flat
    0.779 -> 0.790 from 24 g to 85 g with no cliff at all.
    The two disagree because they are different controllers: g12 clamps 10 mm of pad
    squeeze while the carry sweep used the CEM grasp, which is the grip-vs-reorientation
    trade the 2026-08-29 bench session already documented. So the envelope cannot be
    measured once and reused; it has to be swept on the plan being run.
    Both real objects -- a 24 g b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
2026-08-30 Session handoff for 2026-08-30
    Two threads, written mid-session with two arms still training.
    1. The reference reorienter does not use its observations, so the partial-
    observation transfer memo's premise does not hold on the policy we have. What
    was built for it (asymmetric actor-critic via actor_blind_terms, mjlab-native
    frame stacking instead of an RNN), what is running, and how to resume and score
    it.
    2. g12 is the bench-ready plan. All four exported plans reorient the tool equally
    (cos 0.737-0.781 held); only g12's fingers stay apart. Mass tolerance belongs to
    the plan rather than the hand, and both real objects are inside g12's range.
    Plus the paper corrections, an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
2026-08-30 bench: repeats must start from the same pose; keyframe buttons in the setup card
    The 2026-08-30 g12 session exposed two things the protocol could not survive.
    The free-air arm died on its first frame with /stream/start 409 "home the gantries
    once in this daemon session first" -- after the operator was already committed.
    Preflight reported homed:False and did not treat it as a problem. It is one now.
    Worse, the loaded repeats were not repeats. Each one started from wherever the
    previous had ENDED: repeat 2 opened at middle-yaw +18.7 against a commanded 0.0
    with a yaw load of -930, because the first frame tried to close a 19 degree gap in
    a single step. Repeat 3 opened at +4.4. Three run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
2026-08-30 Obs-transfer: the 2x2 is inconclusive, and the replay result replicates
    Six arms across three hands. Blind/sighted does not predict the outcome:
    blinding kills m05 (both seeds) and rv05, but on rv03 the SIGHTED arm is the
    one that dies (0/128 retained nominal, from a teacher at 0.59). 3 of 6 arms
    collapsed, so what the queue actually measured is that the 5M jittered
    finetune from a Policy-B warmstart bifurcates.
    rv03-sighted carried the higher training reward of its pair (124 vs 68) while
    retaining nothing, peak_cos 0.859 — it rotates the shaft on the way down. The
    peak_cos trap, this time inside the reward rather than the metric.
    What replicated is the part that was cheap: Codex's indep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
2026-08-30 bench: the protocol becomes a guide, and slipped runs stop counting as turns
    The suite's own data forced two fixes to how it is read.
    20260830-1437-g12 repeat 2 read 90 deg -- by far the largest rotation on record --
    because the index finger came off and the shaft fell through the grasp. The
    operator flagged it `slipped` at the time and the report pooled it anyway, which
    is what produced "g12: 26 +- 17 deg". Slipped runs are now segregated: g12 is
    10 +- 0 deg over two clean turns.
    20260830-1359-g12 ran before ramp_to(), so each "repeat" started from the previous
    one's end pose (repeat 2 opened at middle yaw +18.7 against a commanded 0.0, yaw
    load -930). A session can now be retired with an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
2026-08-31 real_v1: the bench performs half its commanded turn, and the clip has a band on every plan
    Two measurements, one from the CB1 and one from simulation, and they meet.
    FROM THE BENCH (20 runs, pulled off the CB1; docs/experiments/20260830-real_v1_bench_sobol).
    The plan is open loop, which is the claim that commanded == achieved. It is not:
    the pip joints arrive (1.00 +- 0.05) and the yaw joints do not (0.44-0.90 of the
    commanded travel). It is not a following error -- sv1_u0100's middle yaw reads 0.56
    at speed_ratio 0.10 and 0.56 at 1.50 -- it is torque: that servo's terminal load is
    900-915 against an overload trip near 800, and one run sits on the 200.0
    protective_torque plateau exactly.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
    [g12_b095_traj.csv, sv1_u0060_b100_traj.csv, sv1_u0100_b100_traj.csv, sv1_w0099_b100_traj.csv, sv1_w0116_b100_traj.csv]
2026-08-31 real_v1: the confirmation stages of the clip re-screen, and what went on the bench
    real_v1_budget_confirm.sh spends the compute the one-trial screen saved: five nominal
    repeats plus a four-draw half-error ensemble at each hand's own clip, then twenty
    full-error draws for whatever survives that. --min-kept-frac stops a single lucky
    trial being promoted out of the confirmation pass, and --table lets the selector run
    a second time over results whose filenames no longer name a grasp cell.
    real_v1_sobol8192.sh extends the Sobol population from 4,096 to 8,192. The sequence
    is prefix-stable, so the first half keeps its tags, its vectors and its generated
    scenes, and only the new half costs anyth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
2026-08-31 real_v1: commit the reachability filter the population pipeline was missing
    real_v1_filter_reachable.py is the first and cheapest gate in the sampling funnel --
    it rejected 784 of 4,102 hands in the 2026-08-30 population -- and it was the one step
    that had never been committed, so a larger population could not be screened without
    rewriting it. Reproduces that run's accept set exactly, 3,318 of 4,102.
    It reads the mounts from the design VECTOR rather than the manifest's mounts_mm: the
    manifest rounds to 0.1 mm and seven of those hands sit within 0.05 mm of a rail limit,
    where the rounding flips the verdict.
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2026-08-31 real_v1: three hands from the clip re-screen reach the bench, and they take the top two spots
    Confirmation leaves 119 of 269 morphologies (5 repeats, >=3 kept, cos >=0.7, clear,
    commandable), 50 of which confirm at no clip the old screen ever tried. Twenty
    full-error draws put sv1_u1939 (0.35) and sv1_u2745 (0.30) ahead of sv1_u2699 (0.25),
    the previous best on this population -- both at clips that were never run.
    Sixteen went through export / servo range / gantry travel / clearance. Thirteen passed
    and NONE failed on servo range, which is the new upstream gate working. The three that
    failed, failed on clearance the way the roadmap warned: sv1_w3408 reads 17.3 mm in the
    rollout and +4.6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
    [sv1_u0308_b050_traj.csv, sv1_u0308_b070_traj.csv, sv1_u0593_b050_traj.csv, sv1_u0720_b090_traj.csv, sv1_u1189_b050_traj.csv, sv1_u1364_b050_traj.csv, sv1_u1364_b080_traj.csv, sv1_u1676_b070_traj.csv]
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2026-08-31 bench: live AprilTag tracker for the real_v1 turn
    Measures cos(shaft axis, up) on the bench in the same signed convention the
    sim reports held-cos, so a bench trace compares directly against g12's
    0.74-0.78 without reconciling units. Reads the D435's factory intrinsics, so
    no calibration step is needed.
    Rig constants measured 2026-08-31, encoded as defaults:
    - 292 mm standoff, 8.0 px/cell on the 30 mm tag, 30 Hz, 100% detection
    - up = static tag +x (it is mounted rotated 90 deg); camera roll ~1 deg
    - shaft = cylinder tag +x
    - exposure 4000 us / gain 64. Noise floor +-0.001 cos, ~0.12 deg.
    Four failure modes it now avoids, each of which cost a debugging cycle:
    - the emitter-off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
2026-08-31 real_v1: the bench gets an object-pose sensor, and the yaw cap comes off
    Two AprilTags and four tape-measure readings replace the operator's eye.
    morphohand.bench.tags is the geometry -- numpy only, no camera, no mujoco --
    so it is unit-testable offline, which matters because every number it produces
    is compared against a simulated one.
    The load-bearing measurement is the fingertip datum. It ties the bench floor to
    the simulator's through a part both sides model: the distal link's top edge sits
    at 65.0 mm on the bench and 21.0 mm in the scene at the zero pose, so
    z_bench = z_sim + 44.0, and the bench scenes' 100 mm post is 144 mm on the
    floor. That constant lives in exactly one place and th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
    [runtime.py, servos.py, web.py]
2026-08-31 real_v1: the Sobol population doubles, and one new hand takes the top of the bench
    8,198 sampled, 6,629 inside the measured rails, 3,311 of them genuinely new
    (the sequence is prefix-stable, so the first half kept its tags, its vectors and
    its scenes). 57,220 screened cells across five clips -- this population was
    swept from the start rather than pinned at 0.5 -- 535 hands pass at some clip,
    227 confirm. Against the 4,096 pass's 269 -> 119 that is roughly a doubling in
    both places, which is what a doubled sample should do and means the search is
    not saturating. 75 of the 535 are invisible at 0.5 rad.
    sv1_u1939 came out of the 4,096 pass as the full-error leader at 0.35, clip
    0.70, and came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
    [hand_tn0d0000n0d0154p0d0000_ip0d0075n0d0091p0d0000_mp0d0146n0d0098p0d0000.xml, hand_tn0d0000n0d0492p0d0000_in0d0254p0d0177p0d0000_mp0d0189p0d0123p0d0000.xml, hand_tn0d0000p0d0125p0d0000_ip0d0161p0d0138p0d0000_mn0d0070n0d0129p0d0000.xml, hand_tn0d0001n0d0086p0d0000_in0d0013p0d0030p0d0000_mn0d0084n0d0268p0d0000.xml, hand_tn0d0001n0d0285p0d0000_ip0d0277n0d0228p0d0000_mn0d0180p0d0262p0d0000.xml, hand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]
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2026-08-31 tracker: the heading is +-90, not unknown -- the tag is bolted normal to the gantry x
    The static tag is mounted facing normal to the gantry x-axis and stays that way,
    so its in-plane horizontal axis is +-y_B and there is no continuum to calibrate,
    only a sign. And the sign is decided by geometry already in frame: the hand is
    at bench x = 0 and the tag at x = +133.5, so the shaft must come out at large
    negative x, and the two candidates mirror the offset about the tag, so exactly
    one does. heading_from_mounting() resolves it on the first frame the cylinder
    is seen and says which it chose.
    Calling this a standing limitation was wrong, and withholding bench x/y behind a
    staging step nobody n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
    [runtime.py]
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2026-08-31 tracker: a cylinder centre under the bench floor is a sign error, not a measurement
    The first real tracked run reads the centre ending at -46 mm, which is not a pose. The
    tag itself fell 44 mm (59.3 -> 14.8) while the computed centre "fell" 102: the extra 58
    is 71*cos(31 deg), the axial offset applied to the wrong end. Flip --shaft-axis and the
    centre goes 63 -> 77 mm, the tool stands up and RISES, slip drops from 55 mm to ~18, and
    the DROPPED verdict disappears.
    It is invisible while the tool lies flat -- cos ~ 0 puts the offset horizontal, so the
    height is right either way -- which is why the probe has been saying it cannot check the
    sign and why nothing caught it until a run stood the to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
2026-09-01 tracker: the shaft-axis "check" was checking itself, and the cylinder has no wrong pole
    The probe's sign test compared the computed centre height against the tag height. But the
    centre IS tag - 71*cos, so the comparison was the computation checked against itself: it
    printed CORRECT for every input, including the inverted axis that put the centre 46 mm
    under the bench. It has never been able to fail.
    A sign check needs a fact the camera cannot see -- which physical END the vane is on --
    so --tag-end top|bottom now supplies it, and without it the probe narrates the two
    possibilities instead of pretending to decide. Measured on the bench with the tool
    standing and the vane up: `x` reads cos -0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
2026-09-01 bench: Stage 1 on sv1_w6689 -- sd 0.011, and a 30mm tag that quits
    Seven complete runs give cos_hold mean +0.8806 sd 0.0110 (95% CI
    [0.0071, 0.0243]) against a simulated between-plan sd of 0.240, so
    Stage 2 at 4 trials/plan resolves 0.022 and the design stands.
    cos_hold and cos_final agree to 0.0013, so the 2.5s post-roll confirms
    the hand is static rather than correcting anything.
    Five of twelve traces lose the cylinder tag mid-run while the 40mm
    reference tag decodes at margin 60 in the same frames, and one of those
    runs dropped the tool after its trace went dark -- so the tape, not the
    CSV, is what tells a void apart from a failure.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
2026-09-01 bench: reprint the cylinder tag at 40 mm
    The 30 mm vane tag stopped decoding partway through 5 of 12 Stage-1 runs
    while the 40 mm reference tag decoded in every frame of every run, in the
    same images at the same range.
    The bit grid is lifted out of the existing sheet rather than regenerated,
    so the reprint is the same pattern in the same orientation as the tag now
    on the vane -- the detector's pose frame is fixed to the pattern, so a tag
    printed 90 deg off would rotate the measured object axis even when mounted
    the same way up. Cross-checked against OpenCV's tag36h11 dictionary
    (matches at 180 deg) and decode-verified by rasterising the PDF at 600 dpi:
    4/4 decode as id0 at margin 120, measu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
2026-09-01 bench: the vane carries a 40 mm tag at 77 mm
    CYL_TAG_SIZE_M 0.030 -> 0.040 and CYL_TAG_AXIAL_MM 71.0 -> 77.0. The 40 mm
    tag needs a 60 mm quiet-zone patch rather than 45, so the rebuilt vane puts
    the tag centre 6 mm further out; the offset is the operator's measurement,
    not a derivation.
    Verified on the bench with the cylinder standing: id0 resolves 10.2 px/cell
    against the reference tag's 10.0, where the 30 mm tag managed 7.6, and the
    probe checks the axis sign rather than narrating it (--tag-end top) --
    cos +0.9993, tag centre 103.2 mm, cylinder centre 26.2 mm, difference 76.9
    = 77.0 cos(2.2 deg). End-to-end through the service: 194 frames, visibility
    1.00 over 8.5 s, margin 62-64, cos sp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
2026-09-01 bench: first-pass transfer analysis over 8 morphologies
    77 scored trials on the 40 mm vane: 52 held, 6 dropped, 19 unresolved.
    The simulator does not rank the hands -- spearman +0.36 (p=0.43) over the
    seven measurable designs, with sv1_u0060 (sim 5th) best on the bench and
    sv1_u1364 (sim 3rd) worst. Within-design sd is 0.027-0.061 for six of the
    seven against a 0.489-0.912 between-design spread, so this is transfer
    failing, not the bench failing to resolve.
    All six drops turn the shaft 37 deg of the 90 before collapsing from
    +0.608 to +0.109, which is the program's clearest argument for a residual
    controller: the plan already performs the turn and goes blind exactly where
    the shaft escapes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
2026-09-01 paper: transfer results section + figures
    Adds the floor-contact exclusion, which changes the headline. The vane can
    reach the table on large turns, and a shaft resting on the table is not one
    the hand is holding: u0060 does this on 10 of 10 trials and posts the set's
    best alignment. Excluding trials whose tag passes within 8 mm of the bench
    floor takes sim-to-bench rank agreement from +0.36 to +0.80.
    Two ranking analyses. Bench metrics: alignment measures agree (+0.83 to
    +0.93) but held rate is an independent axis (|rho| <= 0.43). Sim-to-bench:
    simulated peak alignment predicts measured held alignment best (+0.66), the
    strongest channel overall is simulated alignment against measured slip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
2026-09-01 bench: every hand gets a rank, and the filmstrip shows the second that matters
    Substitutes an alignment number for the two hands that had none -- peak alignment for
    g12, whose tag is crowded out of decode range by the cylinder, and the table-supported
    holds for u0060 -- so all eight hands carry a rank and the sim/bench comparison is over
    the same set. Both substitutions are marked wherever they are printed and the
    unsubstituted correlation is reported alongside.
    Figures are renamed to D1..D8 by simulated rank, gain legends and capitalised axes, and
    the dense heatmap is replaced in the body by a rank-flow chart. Adds filmstrips over the
    first 1.5 s, which is where the whole turn happens.
    Co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
2026-09-01 manta: one shared steps/mm, and there's no wall at 56ish -- it's 60mm everywhere
    STEPS_PER_MM collapses from six independently-calibrated per-joint values to
    one shared scalar (J0's ruler-verified magnitude): all six axes are the
    identical motor/leadscrew/nut, so there can only be one true steps/mm, and
    the old per-joint dict let J1/J4 drift 8-14% from J0 with nothing to flag
    either as wrong.
    FULL_EXTENSION_MM's 56.2/56.0/54.1 entries for J1/J3/J5 (a 4-6mm "shortfall"
    against the 60mm nominal box) were wrong, not a real mechanical limit -- all
    six axes reach their full nominal travel (110mm on J0, 60mm on the rest).
    The 45mm verify_frame_mapping.py --travel probe confirmed 0.0% scale error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
    [kinematics.py, plan.py, runtime.py, verify_frame_mapping.py]
2026-09-01 manta: a way to rezero a drifted servo joint, and finger 2's aa needed it
    Servo.free_raw() writes the raw torque value 0 instead of Servo.free()'s
    TORQUE_FREE=3 -- servo_calibration_notes.md found back on 2026-08-29 that
    TORQUE_FREE doesn't reliably backdrive on this SCS0009 firmware (a servo can
    read back torque_enable=3, present_load=0, both looking free, while still
    springing back to a held position under hand pressure), and flagged raw 0 as
    the confirmed-working fix "until TORQUE_FREE itself is revisited." Nothing
    had revisited it since; this is the first tool that actually needed genuine
    backdrivability.
    rezero_finger_joint.py frees a joint, waits for it to be centered by hand,
    reads b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
    [servos.py]
2026-09-02 bench: score the session the operator watched, and say why a run failed
    Two unrelated bugs, both of which made the bench look like it said something it
    did not.
    SESSION SELECTION. bench() kept each design's LAST session. sv1_u1364 ran twice
    -- 11 trials the operator scored 4/10, then 7 hours later 7 trials nobody
    scored at all -- so "most recent" handed the analysis a block whose hold/drop
    labels came from the tag heuristic and discarded the block a person had
    actually watched. The two disagree about the hand: bench cos 0.179 (rank 8,
    "ejects") against 0.689 (rank 6, stalls). The selector now takes the last
    session with at least one operator verdict in it. No other design moves; every
    other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
    [runtime.py, web.py]
2026-09-02 bench: the tracker service carries the rig's own flags
    Restarting the workstation companion bare cost a whole w6689 session's
    geometry. --shaft-axis defaults to +x in the tracker, which is not a property
    of this rig but of nobody having picked a side; on this vane it is -x, and with
    the sign wrong the axial offset lands on the far end of the shaft and puts the
    reported cylinder centre 72 mm under the bench. Slip, height, x/y and the drop
    verdict are void for such a run. --video-hz defaults to 0, so nothing is taped
    and the run can never be looked at in a filmstrip.
    Both now live in BENCH_DEFAULTS inside the service, ahead of --tracker-arg so
    an explicit flag still wins. A bare launch of the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
2026-09-02 bench: the modes filmstrip is three rows again
    The stall row was diluting the figure's only job. Rows one and two are the SAME
    hand under the SAME plan, held then overshot, which is the whole overshoot
    argument in one picture; row three is the grasp letting go. A fourth row of a
    turn that merely stops short shows nothing the turn-slip figure does not
    already say, and it cost the contrast that made the first two readable.
2026-09-02 bench: the peak-turn panel was a picture of the aftermath
    The peak column on a dropped run was showing the cylinder already on the bench.
    Two faults stacked. The tag's last reading before it dies is resolved by two tape
    frames at once, and max() on (turn, t) tuples awarded the column to the later one,
    a third of a second into the fall. And the peak itself was mostly the fall: on
    w0099/00178e the last 33 deg of 'turn' arrive inside 0.28 s while the cylinder's
    centre drops 19 mm, which is the shaft pivoting out of the grasp, not a turn the
    hand made.
    peak_at now ignores frames from the fall onward -- irreversible departure of the
    centre from its own running maximum, so a hold settling deeper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
2026-09-02 bench: the tag cannot tell a turn from a fall, so overshoot is withdrawn
    Aligning w0099's held and dropped trials on a common clock: identical to 1.4 s
    (37 deg, both decelerating through 10 deg/s), then the hold finishes the last
    segment at 46-59 deg/s and stops dead at 52 for the remaining 4.3 s while the
    drops run away at 166-217 deg/s with the cylinder's centre descending at 42-54 %
    of g. The extra 20 deg that made w0099 an overshoot is the shaft being flung,
    and the plan is the same one in both. u0060 is worse -- holds and drops are
    indistinguishable throughout, 70 against 73 deg. u1364's stall survives and is
    the one case visible during the motion: its drops part at 1.3 s while both are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
    [runtime.py, web.py]
2026-09-02 bench: the filmstrip opens with the best reorientation the bench produced
    Three rows all showed the same partial turn or a failure of it, so the figure never
    showed what a good outcome looks like. u0060's best-aligned hold (cos 0.95) goes on
    top, chosen on cos_hold rather than on turn -- a settled mean over the last second of
    a trial that never fell, which unlike a drop's turn is safe to rank on.
    It is a different trajectory as well as a better one: the shaft barely moves for
    0.7 s and then covers 70 deg in half a second, where w0099 below it climbs steadily
    from the first frame and stops near 50. Two hands, two shapes, and the last panels
    do not look alike.
2026-09-02 bench: the top row should be the hand that kept the object
    u0060 aligns best at 0.95 but drops seven trials in ten, and a top row is read as
    the best hand rather than the best trial. w2360 retained the cylinder on all ten,
    aligns at 0.86, and slips 4 mm -- less than any other row.
    It keeps the reason the row was added: the turn is a different shape. w2360 is
    still near 20 deg at 1.1 s and then covers 30 deg in the next third of a second,
    where w0099 below it climbs from the first frame and stops near 50.
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2026-09-02 servo: the plant is a spring and a cliff, and the sim has neither
    Every real_v1 scene actuates fingers with kp=4000, forcerange=+-1000, no
    frictionloss -- a rigid unlimited actuator. 236 archived CB1 run logs over 11
    morphologies say otherwise.
    Deflection is fitted as an absolute commanded-minus-achieved at the settled hold
    (the 'after' sample lands a median 1.92s after the last command), not as the
    ratio of deltas real_v1_bench_arrival.py reports, because a stiffness is an
    absolute quantity.
    Four loaded joints agree on 0.0177-0.0198 deg per load unit at R2 0.94-0.99 --
    one spring for the whole hand -- with intercepts of -1.08 to +0.54 deg, so there
    is no stiction term. An earlier pooled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
    [fit_servo_compliance.py]
2026-09-02 bench: stage a clearance-checked plan set and turn the interlocks back on
    The CB1 was serving 20260829-real_v1_deploy/deploy, whose pruned copy on the box
    held g23, rv04_mid and g24 -- three of the four plans there, and all three
    excluded by the clearance gate for interpenetrating their own fingers. Serving
    those from the UI is one misclick from driving index into middle. Staged the
    four target hands instead, re-checked at --substeps 8; sv1_u1364_b080 clears on
    its CSV path only, its chord being exactly on the 5.0mm threshold.
    The station launcher had drifted from the documented command and was missing
    --tracker-url, which silently disables the fail-closed tracking interlock.
    Restored, an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
    [rv05_manual_b85_traj.csv, sv1_u1364_b080_traj.csv, sv1_w2360_b075_traj.csv, sv1_w6689_b060_traj.csv]
2026-09-02 CLAUDE.md: write down the two-host hardware topology
    Everything in the new Hardware section was rediscovered from scratch this
    session, some of it wrongly: the ssh identity is irlab not humanoid, the
    workstation and the CB1 share no filesystem, plans are generated on the
    workstation and COPIED (so a plan missing on the CB1 has not been copied, it is
    not lost), the CB1's working copy is ahead of its own HEAD so the repo must
    never be rsynced over it, and the camera stack lives in ~/miniconda3 rather than
    the uv env. Also records that both serial ports are exclusive, and that the
    clearance gate runs before a bench session on the plans actually being served.
    Gotcha 9 gains the failure it did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
2026-09-02 tracker: --shaft-axis=-x, or the service dies before it ever opens the camera
    BENCH_DEFAULTS passed ["--shaft-axis", "-x"] as two argv entries. argparse
    reads a token beginning with "-" as an option name, not a value, so the tracker
    exited at startup with "argument --shaft-axis: expected one argument".
    The station is fail-closed on tracking, so this surfaced as a /reorient failure
    with the hand never moving -- correct behaviour, and the only reason it was
    caught rather than silently producing untracked trials. The value form is now
    "=" joined, with a note for the next flag whose value starts with a dash.
2026-09-02 tracker: the operator's flags belong in BENCH_DEFAULTS, not a shell history
    --tag-end top, --symmetric-object, --heading-deg 90 and a fixed --exposure/--gain
    were how this rig is actually driven, and the service carried none of them. A
    service launched without them produces runs that look like failures and are not.
    --symmetric-object is the one that misleads. The 100x25 cylinder is symmetric
    end-for-end, so which pole ends up on top is a property of seating rather than of
    the turn, and the flag folds cos to [0,1]. Without it today's 38 deg turn --
    complete by t=2.0s and then flat for four seconds, object centre up 6mm and
    holding -- reported cos -0.684 and read as the shaft being driven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
2026-09-02 rv05: three clean runs, and the spring predicts every one of them
    cos hold 0.530 and 0.656 on the two fully tracked runs, bracketing the transfer
    study's published +0.553 (sd 0.049, n=10), with tag and operator angles agreeing
    to within 0.5 deg on all three.
    The compliance constant fitted from 236 archived runs of OTHER designs predicts
    these unseen runs' terminal deficits to a few tenths of a degree: middle_yaw
    13.63 vs 13.67, 10.70 vs 11.16, 10.70 vs 10.88. middle_yaw gives up a third of
    its commanded travel to the spring alone.
    middle_yaw terminal load is 735/600/585 against a trip of 200, so nothing tripped
    and protective_torque is not the limiter on this hand at this clip.
    Fixed exp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
2026-09-02 sysid: the servo is a spring AND a friction cone, and only one is in the sim
    Staircased five flexion joints up and back down on the homed, free-hanging hand
    (BAM's "raising and lowering slowly"), 4 deg steps, 0.4 s dwell so each reading is
    an equilibrium rather than tracking lag.
    The sweeps do not retrace. Every joint's up-sweep sits above zero and its
    down-sweep below, with loop widths of 0.70-1.50 deg mean and up to 3.52 -- two to
    six times the systematic error at the same load. A proportional droop predicts a
    loop of exactly zero, so at this load friction is the dominant term, and no MJCF
    in the repo carries a frictionloss.
    Reading the registers gives the load-proportional half a mech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
    [servo_hysteresis_sweep.py, servo_load_dependence.py]
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2026-09-02 plant: the corrected simulator matches the bench on retention AND alignment
    Calibrated the finger actuator gain against the bench's own per-joint deficits and
    put the result back in rv05_manual_b85's deploy scene. Sixteen spawn-jittered
    trials per plant, nothing else changed:
    retention cos
    shipped 1.00 0.178
    corrected 0.94 0.638
    bench 0.92 0.593
    The shipped plant matches neither. The corrected one matches both.
    The cross-validation is the result: kp was fitted on joint deficits alone -- how
    far short of its command each joint stops -- so sweeping it against the outcome of
    the whole task is independent, and it lands in the same p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
    [calibrate_plant_kp.py]
2026-09-03 gait: the shaft standing on the floor turns 5 revolutions, and rv04_mid turns it backwards
    Ground-supported gaiting on real_v1. A tripod of pads rides a ring around a shaft
    standing on its end face and runs a fixed four-phase set-point cycle: twist, release,
    return, regrasp. No policy, no reward, nothing reads the object. rv05_manual accumulates
    4.99 turns over 40 cycles (n=3, sd 0.07) at 0.5 deg final tilt and 0.3 mm of drift.
    The premise is that the floor makes the release affordable -- a 100x25 mm cylinder on its
    end is stable to 14.0 deg of tilt -- and the control says so: deleting the floor AFTER the
    grasp is established, with the same hand and the same set-points, loses the shaft in t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
    [probe_real_v1_gait.py, real_v1_gait_page.py, real_v1_gait_study.py]
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2026-09-03 chain: the seam is a race against a leaking grip, and the floor is where you change grasp
    grasp -> lift -> reorient -> re-pose -> descend -> gait in one rollout, 8/8 seeds,
    0.98 turns in 8 cycles and 5.11 turns in 40. The two halves were published separately
    and neither had any claim on the join.
    Three things the seam turned out to be made of:
    * THE CARRY DOES NOT END IN A GRIP. It ends with the shaft cradled on the middle
    phalanges, pads at 0.5 mm interference, and that hold leaks -- the shaft creeps
    ~1.5 mm/s and probe_real_v1_carry already measured 16.1 N -> 0 in 1.6 s. So the
    set-down is a race: 1 continuous move stands it 4/4, 8 measured corrections 1/4.
    Feedback on the TILT i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
    [probe_real_v1_gait.py]
2026-09-03 arm: the UR5e runs the whole chain, and the spec it has to meet is 1 mm of palm droop
    Every result in this program was made by a floating gravity-compensated palm with six
    actuated DOF. build_real_v1_arm_scene.py deletes those and bolts the hand to a UR5e
    flange; palm_driver.py puts the gantry and the arm behind one read/write/solve/cmd_pose
    interface, so probe_real_v1_chain contains no `if arm:` and a difference between the two
    runs belongs to the wrist, not to the script.
    UR5e, mink differential IK, same controller, same contact parameters:
    ok turns/8cy deg/cycle 40 cycles drift
    gantry 6/6 0.984 44.3 4.92 0.29 mm
    ur5e 6/6 1.0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
    [build_real_v1_arm_scene.py, palm_driver.py]
2026-09-03 screw: a countersink costs 13% of the turn, cuts drift 7x, and has a 4 mm capture radius
    The tool gains a 45 deg frustum tip and the floor a matching countersink, built the way a
    real recess is -- a ring of facets, because a conical hole is not convex. The whole chain
    then runs into it: pick up flat on the table, lift, reorient, carry 40 mm across, insert,
    release, re-index, gait.
    ok deg/cycle drift press to seat
    flat plane 5/6 46.7 1.26 mm 2 mm
    45 deg seat 4/6 40.4 0.18 mm 8 mm
    So the seat is not free and it is not a formality: it takes 13% of the turn to the wedge
    (normal force is the axial load over sin alpha) and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
2026-09-03 page: the chain, the arm and the screw, written up
    docs/experiments/20260903-real_v1_chain/page.html, regenerable from the three study
    JSONs plus a seam ledger; published at
    https://claude.ai/code/artifact/6473c3b4-7d2b-4fd1-81ab-d5bfc9753349
    real_v1_arm_study.py makes the gantry/UR5e head-to-head and the droop sweep
    reproducible rather than ad hoc. The chain probe now records elapsed sim time at every
    seam, which is what turns "the grasp leaks" into a chart.
    Two things the writing forced. The grip-decay figure originally plotted an insertion
    with and without the re-grip as if the single trace showed the difference; on that seed
    it does not (the re-grip's benefit is 1/6 -> 5/6 across seeds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
    [real_v1_arm_study.py]
2026-09-03 arm: --cl-assets writes a self-contained pair into the lab menagerie
    The copied scenes now carry a meshdir pointing at CL_Assets' own copy of the UR5e rather
    than at whichever mujoco_menagerie clone generated them, and the home keyframe is re-solved
    against that copy. Installed (untracked) as
    CL_Assets/mujoco_assets/{universal_robots_ur5e/, ur5e_rv05_manual_stored_{scene,ik}.xml}.
    [build_real_v1_arm_scene.py]
2026-09-03 handover: the hand can change grasp without letting go, and the gait has to relay too
    The chained task changed grasp by opening the hand and trusting a free-standing cylinder to
    wait where it was put -- 49% of the window after set-down has no pad on the tool at all. That
    is a property of a cylinder on its end face on a level floor, not of the hand, so this replaces
    it with a relay handover (walk one pad at a time onto the gait's ring, around the tool rather
    than through it) and a relay gait, and then with a load.
    relay handover + relay gait 6/6, 23.0 deg/cycle, 0.4% of the task uncontacted
    release + synchronous gait 6/6, 44.3 deg/cycle, 49.2%
    The two halves are a matched pair: a r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
2026-09-03 docs: what gates a deployable residual, and the half of it that does not
    The question splits in two and only one half is blocked. A residual on one
    hand is not gated on hardware: the plant is calibrated and passes the drop
    gate on rv05, the residual action term already exists in actions.py, and the
    observation the policy needs (object pose, from the tags) is off the servo
    bus and so survives a policy stream. A residual across a set of hands is
    gated, on bench measurements rather than compute -- the corrected simulator
    ranks seven designs at spearman +0.107 and the two worst misses are both
    slip cases.
    Also indexes the fourteen standalone report pages, which nothing linked to,
    and banners RE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
2026-09-03 bench: the flat table is free, the 100 mm wrist stack is a preload problem
    Every arm result so far stood the UR5e on a 300 mm pedestal and bolted the palm plate
    straight to the tool flange. Neither is the bench. Both are now scene parameters, and
    build_real_v1_arm_scene.py copies the whole worldbody instead of a whitelist -- the
    whitelist silently dropped the countersink when an arm scene was built from a screw scene.
    1088 rollouts. The pedestal buys nothing (relay 7/7/6/7 of 8 across 0-300 mm, release 8/8,
    same IK branch throughout). The 100 mm stack breaks the relay at 50 mm, and a MASSLESS stack
    does not, so the cost is the 352 g of payload rather than the reach.
    Stack length, stack mas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
    [build_real_v1_arm_scene.py]
2026-09-03 bench: declare the arm's payload and the wrist stack is free; the settle to vertical was wrist sag
    A UR5e is told its payload with set_payload and is rated to 5 kg. Modelling that
    (--payload-gravcomp) takes palm error at the top of the lift from 0.97 mm to 0.01, and with it
    0/50/100/150 mm of wrist stack all run 8/8 at the PUBLISHED 0.3 mm carry grip -- the 350-425 mm
    standoff and 1.5 mm grip this study first reported were compensating a load the controller had
    not been told about. The declaration also inverts the grip: on a stiff wrist 0.8 mm gives 3-6/8
    and 1.5 mm gives 1/8. The droop analysis stays as the diagnostic for any compliant wrist.
    New `turned` seam at the last commanded turn st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
    [build_real_v1_arm_scene.py, real_v1_gait_page.py]
2026-09-04 slip: the 8 deg turn is rv05_manual's, and a dropped shaft in a countersink reads vertical
    The same commanded chain on all 10 real_v1 designs with a CEM grasp: 3 hold the tool
    at the last commanded turn step, 1 completes the chain in every seed. rv00_wide_sp40
    stops at 48.4 deg and rv03_narrowy_sp40 at 39.9, both with 6-10x rv05's seed spread,
    and the settle's direction does not replicate. rv04_mid_sp40 reads 8.0 deg with zero
    pads on the tool, so every tilt report needs the held_turn contact gate.
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2026-09-04 chain: close the grip loop through every phase; the turn, not the grip, is the blocker
    Ports real_v1_deploy_envelope._load_step into probe_real_v1_chain via _run, the one
    step loop every phase goes through, with the trim stripped before a phase writes its
    set-point and re-added after so a partial write (the relay walks one pad at a time)
    neither loses it nor double-applies it. It reaches its 0.45 rad authority cap over a
    full chain and roughly doubles the grip.
    The chain still completes 0/8 on the bench-tested hand set: two never close on the
    tool, six lift and then the turn moves the tilt by under a degree. Gain is irrelevant
    (a per-step clip binds) and commanded squeeze is non-monotone an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
2026-09-04 turn: the commanded angle is the lever, and the grip dies during the lift
    Halving the commanded turn angle roughly triples what is achieved (sv1_u0308_b050
    87.3 -> 51.1 deg at -50/k0.25 against +15.7 at its deployed -80/k0.15), because the
    turn's IK residual scales with the ask: 14-18 mm at -30 deg, 27-43 at -90. make_plan
    discards that residual, so the deployed plans carry it; they work on the bench because
    the post supports the tool through the turn.
    Root cause is upstream: the grip is 41 N at closure and 0.33 N after a 100 mm lift, the
    position-servo decay the screen documented. Neither closed loop fixes it -- the servo-load
    arm reaches its authority cap and moves the turn 0.5 deg, the c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
2026-09-04 grip: 0.33 N is statics, not decay -- you cannot preload a light free object
    Steady-state grip scales with object mass on an identical command and hand: 0.33 N at
    24.5 g, 1.32 at 98, 9.84 at 393, 83.6 at 1571. The 80-99 N at closure is a transient.
    Position servos converge until forces balance, and in mid-air nothing opposes the
    squeeze but the tool's own weight -- which is why the same hands make 12 N on the bench,
    where the post supplies the reaction.
    This explains the squeeze, re-squeeze, servo-load, contact-force and re-grasp negatives
    at once: all five move a quantity statics fixes. Adds _pad_frame and _regrasp_cmd
    (station-referenced re-grasp) to the chain; it is a clean negative, for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
2026-09-05 chain: a screwdriver standing on its handle read as a perfect 0.00 deg stand
    Four fixes to probe_real_v1_chain.py, found by taking the finger turn out of the
    chain and letting the arm do the reorientation.
    * THE AXIS WAS FOLDED. Every axis in the probe was flipped to point up and every
    tilt taken as arccos|cos|, which is right for a plain cylinder and wrong for a
    screwdriver: the tip is the -z end of the body and the countersink only accepts
    that end. With the rotation left to the arm, `_stage` picks the end to raise
    from the sign of R[2,2], which on a horizontal tool is numerical noise -- and
    the run then reported tilt 0.00 deg, z 0.0500, stood_ok True for a tool standing
    upsid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
2026-09-05 chain: re-index over the top -- the open hand was walking through the standing tool
    29 of the 36 runs that stood the tool were past 14 deg by the end of the palm
    re-index, with the hand OPEN and the ring not yet closed: mean tilt 1.15 deg at
    `released`, 41.4 deg at `reindexed`. The close was never the problem.
    A single Cartesian leg rotates and translates at once, which walks the open
    fingers through the space the standing tool occupies -- the re-index is a ~90 deg
    wrist rotation from on-edge-beside-the-tool to looking-down-at-it. Three legs
    instead (`--clear`, default 80 mm): straight up until the fingertips clear the
    tool's top, across and around at that height, then straight down onto th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
2026-09-05 chain: three-leg re-index across all 16 hands -- 8/64 against 2/64
    Re-ran the table-stand study with the over-the-top re-index. Complete chains
    2/64 -> 8/64 (sv1_u1364_b080 3/4, sv1_u7952_b050 and _b065 2/4 each,
    sv1_w0099_b100 1/4) and the loss at the `reindexed` seam falls from 29 to 20 of
    the 36 stands.
    g12_b095 runs all six cycles on all four seeds and never drops the tool, but
    fails grip_ok on three and reads -67 to -86 deg/cycle against a 50.5 deg gear
    ceiling -- the shaft being spun, not gaited. At repose_steps 900 instead of 800
    the same hand is 3/4, so the leg length matters and is unswept; both are written
    up as the next two items.
    Page rebuilt on the new hero run, sv1_u1364_b080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
2026-09-05 chain_hands: sweep the re-index clearance and leg length
    --clears and --reposes multiply the job grid. 20 of 36 stands are still lost
    during the palm move, and g12 flips 0/4 to 3/4 between repose_steps 800 and 900,
    so neither is safe at a default.
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2026-09-05 chain: score the reorientation on its own, and film every hand
    The chain's gates are an AND, so a hand that stands the tool 4/4 and loses the
    handover reads exactly like a hand that never turned it. Three new fields split
    them: reorient_deg (how much of the 90 deg lying->standing turn was made, read at
    `upright`), drop_stage (the first seam the tool is loose on the floor at), and
    reorient_ok. On the corrected 2 mm grasp the reorientation is not the loss --
    when the tool stands it stands at 89.1 +- 0.9 deg of the 90.
    real_v1_chain_films.py re-runs each hand's furthest-reaching cell with the
    renderer on and writes one mp4 and one seam filmstrip per hand plus a labelled
    grid. The strips locate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
2026-09-05 chain: the reorientation is solved, the handover is one seam
    Splitting the chain's AND-gate apart: when a hand stands the tool it stands it
    at 89.1-89.4 deg of the 90 deg turn, sd 0.9, across 16 hands, 4 seeds and 4
    grasp squeezes. The attrition is the carry and the handover, and grasp squeeze
    trades between them -- 2 mm loses 24/64 in the carry and 11 at the handover,
    6 mm loses 13 and 32. Per-hand squeeze is worth 28/64 against 23/64.
    The handover is one move. 53 of 58 failures at 2-4 mm are past 14 deg at
    `reindexed` having stood at 1.47 deg through `released`; the completed runs read
    0.64 deg at the same seam. Scanning the gait palm height against the OPEN ring
    rather than the closed on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
2026-09-06 screen vs chain: the deploy screen reproduces; the chain loses one hand after the lift
    Reproduces real_v1_plan_band.py at each plan's shipped clip: D1 4/4 cos 0.827
    (bench 0.834, 24/24), D2 4/4 0.726 (bench 0.797), D7 4/4 0.568 (bench 0.553).
    The screened simulation is sound.
    Corrects my own report of the chain. It lifts 122/128 and holds the turn
    102/128; the '2 of 256 held reorientations' was held_reorient read at the
    upright seam in TABLE mode, where the tool is stood on the table and released
    by construction.
    Two defects. (1) The plans' squeeze_mm 10.0 raises the tool 14.5-19.6 mm at
    closure on six of eight hands when it lies on a table -- more than its own
    12.5 mm radius; the chain's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
2026-09-06 results: publish the screen-vs-chain page, retire the RESULTS.md files, queue skills 3-4
    Builds docs/experiments/20260906-screen_vs_chain/20260906-screen_vs_chain.html
    from the studies' own JSON via scripts/real_v1_screen_chain_page.py, registers
    it in INDEX.md and publishes it to
    https://claude.ai/code/artifact/28a84ea8-a8b2-405e-aea6-e6a626baa3b0
    Replaces the three RESULTS.md files with README.md pointers to the page and the
    command behind each data file, per the CLAUDE.md rule added this session.
    Corrects the alignment-vs-retention claim: the two available statistics are
    -0.12 (paper filter, dropped scored 0) and +0.12 (per-trial median over retained
    trials). Both are noise at n=8 and d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
    [g12_b095__flat.xml, rv05_manual_b85__flat.xml, sv1_u0060_b75__flat.xml, sv1_u0308_b050__flat.xml, sv1_u1364_b080__flat.xml, sv1_w0099_b100__flat.xml, sv1_w2360_b075__flat.xml, sv1_w6689_b060__flat.xml]
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2026-09-06 diagnosis: the pivot height flips the pole, and the parameters are per-maneuver
    WHAT THE BUG IS. `axis_k` -- the height of the pivot the finger anchor is rotated about -- sets
    WHICH END OF THE TOOL GOES DOWN. Ablated one factor at a time off the reproduced 2026-09-03
    chain (`scripts/real_v1_chain_ablate.py`, 32 rollouts), axis_k 0.25 -> 0.05 lifts identically
    (3 pads, 5.55 N, z 0.1121, bit-for-bit, since the pivot only enters after the lift) and then
    turns the tool to cos -0.988: within 9 deg of vertical, HANDLE DOWN, and drops it. Every
    deployed plan carries 0.05-0.15.
    The other single-factor arms: clip 0.50 -> 0.85 reorients correctly (cos +0.97) but bleeds the
    grip 5.55 -> 0.15 N and los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
    [palm_driver.py]
2026-09-07 control diagnosis: the pivot flips the pole and the fitter spends the turn's travel
    Retracts the pad-elevation page at its own URL: 952 of 967 stands it counted were the
    screwdriver standing on its HANDLE, because `_av()` folds the tool axis when `tip_len` is 0 and
    `real_v1_chain_hands._cell` passes 0.0 for every table-stand cell. Its closure-geometry
    measurement is static and survives; the consequence drawn from it does not.
    The diagnosis page replaces it. Ablating one factor at a time off the reproduced 2026-09-03
    chain: `axis_k` 0.25 -> 0.05 lifts bit-identically and then turns the tool to cos -0.988,
    handle down; clip 0.50 -> 0.85 reorients correctly and bleeds the grip 5.55 -> 0.15 N a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
    [real_v1_control_diagnosis_page.py]
2026-09-07 films: three deployed hands hold the tip-down turn, and all lose it at set_down
    Scanned every chain sweep on the signed cosine with a load test at `reoriented`:
    1,550 rollouts, zero completed chains on any hand but rv05_manual_stored. The turn
    itself is solved on three -- D5 at cos +0.894 on two pads at 14.13 N, D3 at +0.987,
    D1 at +0.913 -- and every one of them loses the tool at the set-down seam.
    The pivot is per-hand: 0.15 for D5, 0.35 for D3/D1, 0.25 for the reference. The
    432-rollout band sweep stepped clip 0.40/0.55/0.70/0.85/1.00/1.15 and never tried
    0.50, which is the clip all three of these turns run at, so its "0 chains" is true
    of that grid only.
    real_v1_chain_films.py gains --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
    [real_v1_control_diagnosis_page.py]
2026-09-07 closed loop: the grip regulator was unreachable from the sweep tool, and rate-limited
    Two defects, both in the feedback path, neither in the hand.
    `chain()` has always taken `force_target`, driving `_force_step` off simulator contact
    normal force. `real_v1_chain_hands.py` exposed only `--loads`, the servo-load proxy the
    source itself notes "barely moves" at this grasp's forces, so every chain sweep ever run
    -- 1,072 air-mode rollouts -- ran open loop. Wired through as --forces / --force-gain /
    --reg-bands / --force-rates.
    `_force_step` slewed its trim at a hardcoded +-0.0006 rad/tick, and gain*error saturates
    that clip at any realistic error, so gain was inert and the whole 550-step turn h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
2026-09-07 chain: D6 completes it at pivot 0.15 with a stable grasp, and two control loops that hurt
    sv1_u0308_b050 at axis_k 0.15, budget 0.50, 550 turn steps, open loop: cos +0.995 at
    `staged`, three pads at EVERY seam, 6.86 N, and 1.0 mm of grasp slide at the moment the
    tool is vertical against the reference's 11.5. ok=True, drop=None, 8/8 gait cycles,
    free_frac 0.085. Reproduces 3 of 4 seeds; the 4th holds to +0.986 and stops at 6 cycles.
    The fingers deliver 94 -> 55.6 deg and the arm's iterated repose does the rest, so it is
    a held reorientation, not a finger-only one.
    This was in the first pivot sweep of the day and was scored as a failure because
    `reorient_ok` reads the `reoriented` seam (+0.56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
2026-09-10 karma: media renderer, reachable-set figure, deterministic jitter
    hash() is salted per process, so the spread chart would not have regenerated identically.
    [karma_analysis.py, karma_media.py, karma_page.py]
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2026-09-10 karma: final sweep data and page text
    888 runs, 0 errors, four arms. Fixed a section heading that asserted the opposite of what
    the sweep found.
    [karma_page.py]
2026-09-16 chain: run the sweep on the bench-calibrated plant with --plant corrected
    Every chain scene is generated from the base template and so ships kp 30 / forcerange +-10 /
    no frictionloss / capsule-volume masses -- the model calibrated on 2026-09-02 as ~60x too
    stiff. All 2,214 chain rollouts to date ran on it. `--plant corrected` rewrites each hand's
    arm scene through apply_measured_plant.py (kp 0.5, forcerange 0.35, frictionloss 0.0035,
    measured masses), cached beside the shipped scene, and tags the cell `_p0.5` so the film tool
    reproduces it on the same plant. The row records `plant` and `plant_kp`.
2026-09-16 chain: per-finger turn relief for the corrected plant, and two plant tables
    On the bench-calibrated plant the chain's 2 mm squeeze lifts at 0.16-1.43 N (D8 not at all)
    and 8-10 mm lifts every hand at 2.5-4.5 N -- the plans' own squeeze. With the grasp fixed,
    every hand holds the turn (slide 1-7 mm) and turns 0-10 deg at every budget from 0.5 to
    1.3 rad: the yaw/mcp servos sit on the 0.35 N m ceiling holding the grip, the stall the bench
    recorded on 2026-08-29. `--reliefs <mm>` pulls the index and middle pads radially out of the
    shaft from the commanded pose before the turn (thumb keeps the full squeeze), tag `_l<mm>`.
    real_v1_plant_compare.py: shipped vs corrected per hand and pivot.
    real_v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
2026-09-16 chain: record the servo state at every seam
    `q_err_deg` (largest commanded-minus-achieved angle per finger) and `sat` (actuators on the
    force ceiling per finger). On the shipped plant both read ~0; on the calibrated plant they
    are the difference between a finger that holds and one that stalls: D6 at the turn reads
    25/30/36 deg with no actuator saturated, and 27/42 deg through the handover.
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2026-09-17 in-hand reorientation on the calibrated plant: pinch-and-swing replaces the contact-fixed turn
    The chain's finger turn is a contact-fixed rotation whose arcs the fingers cannot
    reach (42 mm IK residual; 0-20 deg reachable from any grasp the fitter accepts on
    D6); at kp 30 it was executed by force, at kp 0.5 the yaws achieve 18-40% of their
    command and the pads creep. Under the template's pyramidal/impratio-1 contact the
    creep hides everything; under elliptic/impratio 10 the tool moves.
    The primitive that works on the calibrated plant: release the middle pad and let
    the tool swing about the thumb-index pinch under gravity, tool laid tip toward the
    swing side. D8 6/6 at 12 mm squeeze (5/6 car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
2026-09-17 bench partial reorientation: the palm plate at its pre-fix height is the 50 deg stop; plan family, two-tip gait, RL morphology runs on the calibrated plant
    real_v1_tip_gait.py (tip, rest, command-referenced regrip, tip again on the bench setting),
    real_v1_plan_angle_sweep.py (deployed plans by hand, plate height, commanded-angle family),
    real_v1_turn_mechanism.replay gains a camera argument, make_cal_morphology_run.py builds a
    trainer morphology-run from a chain flat scene on the cal plant (D6 holds the evaluator lift,
    D8 drops it), page builder + template + data, INDEX row.
    [rv05_manual_a110_traj.csv, rv05_manual_a60_traj.csv, rv05_manual_a75_traj.csv, rv05_manual_a90_traj.csv]
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2026-09-17 D6 reorient policy on the calibrated plant at 60M: cos 0.933 held 64/64; evaluator takes the run's residual timing
    The 20M "workspace ceiling" (cos 0.43) was an under-trained snapshot: the same recipe at 60M steps
    rolls the tool across the pads to cos 0.933 +- 0.003, held on three pads in 64/64 deterministic
    rollouts (results/rl/20260917-1141-d6_cal_reorient_gp025_60M_s0). The 2026-09-16 page carries the
    correction and is republished at its URL.
    Evaluator defect: make_env_cfg left finger_residual_active_from_step at 0 while b_liveA runs train
    with 58, so the eval let the policy's residual into the scripted lift; the 60M checkpoint then
    dropped the tool in 52/64 rollouts and a tool standing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
2026-09-20 hands tranche: gate-aware serial queue of bounded-residual and index-middle-separation finetunes across D1-D7 on the calibrated plant
    - trainer: --clip-actions (rsl_rl wrapper clip, recorded in config.yaml and applied at eval/deploy by
    build_actor), --finger-separation-weight/-min-m (index-middle link-chain clearance penalty,
    terms_common.finger_pair_clearance = min segment-segment distance over the 3x3 capsule pairs minus 2r)
    - policy_eval_suite: plausibility block (clearance min/end, pad peaks, joint speed p99, residual |a|>1
    fraction and max, command-achieved gap after clamping to the joint range, raw command beyond range);
    the unbounded D6 finetune commands up to 384 deg beyond t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
2026-09-20 hands tranche: zero-shot transfer probe (tip mesh, plate 0, mu, mass, kp 0.25) as the driver's final pass; page table; driver resets jobs orphaned by a dead driver
2026-09-20 policy_cpu_rollout: the 66-dim observation and the lift/lerp/residual schedule rebuilt in CPU MuJoCo; reproduces the GPU eval of the D6 grip finetune (cos 0.972 vs 0.969, step 144 vs 143); CPU transf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
    D6 finetune zero-shot on CPU: tip mesh, mu 0.6/1.5, torsional 0.003 unchanged (0.97 held); plate at 0
    -> cos 0.84 (1 of 2 jittered rollouts dropped); kp 0.25 -> 0.93 at step 204; tool mass +10..+20 % 6/6
    with 2 mm jitter, +30 % 5/6 (zero-jitter singles are knife-edge)
    [d6_ft_cpu_base.csv, d6_ft_cpu_kp0.25.csv, d6_ft_cpu_mass0.8.csv, d6_ft_cpu_mass1.1.csv, d6_ft_cpu_mass1.15.csv, d6_ft_cpu_mass1.2.csv, d6_ft_cpu_mass1.25.csv, d6_ft_cpu_mass1.3.csv]
2026-09-20 real_v1_chain_policy: a reorient checkpoint as the finger controller inside the UR5e chain (turn_ctrl hook in probe_real_v1_chain.chain); relative quaternion canonicalised to w>=0
    D6 grip finetune in the chain on cal: plate 25 -> cos 0.91 at 1.8 s on 3 pads, middle pad lost at 2.1 s,
    tool dropped at 3.2 s; plate 0 -> dropped at 2.8 s. The chain's grasp seam (anchor snapped, arm lift
    0.4 s: 5 deg roll, 2.2 mm slide, 4.0 N at 'lifted') is where it departs from the benchmark. Chain and
    CPU transfer probes run per finished job in the tranche driver; page tables for both.
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2026-09-20 hands tranche: blind actors throughout (the sighted D6 policies depend on the tool pose: zeroed, both 60M checkpoints drop and the finetune turns to the wrong pole); blind terms carried by eval/rende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
2026-09-20 hands tranche wake-up 1: six jobs read; chain probe on a stiff arm (arm_kp_scale 10: the 4.9 mm at the seam was the menagerie servo settling, not load), finger weight on the finger servos, policy sha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
    [d3_clip_s0_trace.csv, d4_clip_s0_trace.csv, d5_clip_s0_trace.csv, d6_clip_s0_trace.csv, d6_clipsep_s0_trace.csv, d7_clip_s0_trace.csv]
2026-09-20 hands tranche: all 16 jobs read (strips viewed, GPU perturbation pass, chain on the stiff arm); page v2 with the CPU-replay column and the tip-mesh CPU fallback; strips inlined as JPEG under the arti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
    [cpu_s1.csv, cpu_s2.csv, cpu_s3.csv, cpu_s4.csv, cpu_s5.csv, cpu_s6.csv, d1_clip_s0_trace.csv, d1_clipsep_s0_trace.csv]
2026-09-20 hands tranche page v4: the rollout video under every filmstrip (web/<job>.mp4, 640x480, published as supporting files); policy_eval_suite gains --spawn-jitter-mm/--spawn-yaw-deg/--friction-dr via mak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
2026-09-20 robust tranche: the object entity keeps the scene's contact class and mesh assets (it had trained on MuJoCo's default solref/solimp since the first mjlab run), --scene-floor keeps the scene's floor i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
2026-09-20 robust tranche page v2: the training pipeline as it stands (stages, episode timeline, observation/action, reward, terminations, PPO, warm-start lineage, decision register with measured vs inherited, 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
    [cpu_s1.csv, cpu_s2.csv, cpu_s3.csv, cpu_s4.csv, cpu_s5.csv, cpu_s6.csv, r_d1_clip_trace.csv, r_d6_clip_trace.csv]
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2026-09-21 tranche driver: resume at the evaluation when a job's training already finished (the 09-20 queue sat 6 h behind a closed swap gate with r_d5_clipsep trained and unevaluated); restart under RESGUARD_M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
2026-09-21 robust tranche page v7: queue finished (10 of 12 trained; r_d4_clip_s1 NaN at iteration 63, two draws), r_d1_clipsep the tranche's best turn (cos 0.958, 64/64 nominal, 54/64 jittered), r_d5_clipsep 6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
2026-09-21 CEM grasp-sample filmstrips on D1 and D3 for the talk: deploy fit (flat pads, plan straddle/depth) then the pipeline's 24x80 CEM with every draw recorded; rows = fitted pose, four first-population sa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
2026-09-21 workshop briefing page: the record behind the SR2 Hand paper. Funnel 8,198 -> 6,629 -> 3,298 -> 535 -> 227 -> 19 -> 8 with every stage's rule and file (the 6,629 was computed under the pre-2026-09-01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
2026-09-22 bench video array: the eight transfer-study hands holding a reorientation, 2x4 from the tracker's IR tape (640x360 at 3.8 fps, upscaled 3x to 4020x1836) with the measured net turn overlaid bottom-rig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
2026-09-22 bench video array: overlay type for a lecture hall. Bold, hand label a tenth of the panel height (90 px) and the angle a sixth (156 px), boxes at 82 % black; 'tag lost' drawn at the label size so it 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
2026-09-22 carry construction figures: the open-loop geometric carry drawn on MuJoCo renders of a shipped plan's own scene. Rebuilds the plan step for step (grip fit, close+settle, pad centroid C, pivot P = C +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
    [real_v1_carry_construction.py]
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2026-09-22 carry construction: D7 (rv05_manual_stored) at k 0.25, b 0.50, theta -90, an 800-step ramp -- the cell picked by watching the rollouts, not the cos table: no swing-through, 3 contacts and 7-21 N thro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
    [real_v1_carry_construction.py]
2026-09-22 carry construction on the bench-calibrated plant: --plant corrected|fast runs the exporter's construction for a shipped plan on its kp-0.5 scene (docs/experiments/20260916-turn_mechanism/scenes), --c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
    [real_v1_carry_construction.py]
2026-09-22 carry construction: D7 floor-free at b 0.70 (k 0.25, theta -90, 800-step ramp): the fingers stand the shaft up by 78 % of the ramp and the hold stays within 7 deg with the fingers still, 3 contacts t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
    [real_v1_carry_construction.py]
2026-09-24 chain after the learned reorientation: over-the-top handover and a per-hand gait ring
    probe_real_v1_chain: reindex='over' releases the seated tool (pads radially to the open radius, palm
    up by the press depth to unload the plate, lift until no fingertip can reach the tool top), levels
    the palm over the pose real_v1_gait_ring_screen.py found for the hand, waits for the fingers to
    reach the approach ring, descends and closes; the ring is solved on the released tool, centred on
    its axis at ring height. Seams record the apex's offset from the socket and the palm tilt; each gait
    cycle records spin and pads per phase; grip_settle_steps; angle_from='gait' arms the achieved-angle
    loop at the gait gr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
    [real_v1_gait_ring_screen.py]
2026-09-24 chain with learned reorientation on the calibrated plant: 12 of 20 rollouts on the D5/D6 policies complete grasp to gait and turn the screw 0.14-0.38 rev; the plant's 1 s finger time constant
    New page docs/experiments/20260923-chain_handover_gait/20260923-chain_handover_gait.html (builder
    chain_handover_gait_page.py): outcome over five spawns for six policies, films, the stages after the
    turn and the measured failure each change addresses, the per-hand ring screen, the 72-run gait sweep, the
    finger damping (template 0.5 N m s/rad kept by the calibrated plant: tau 1.04 s; at damping 0.25/0.1/0 the
    learned turn holds on 6/4/0 of ten policies, and without a policy the chain's own turn and the a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
    [chain_handover_gait_page.py]
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2026-10-01 pinch friction torque in Drake hydroelastic and MuJoCo contact models: on a two-pad rig with the real_v1 fingertip (10.55 mm sphere) and screwdriver (12.5 mm cylinder, 24.5 g), Drake's compliant hydr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
    The gravity brake of arXiv 2609.25619 (pinch lowered 6 -> 0.2 N over 4 s, CG 15 mm off the pinch line) follows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
2026-10-01 pinch-brake loading of the screwdriver on the SR2 hand in Drake and MuJoCo: on D8 (gantry from its deploy plan, palm fixed, calibrated servos kp 0.5 / kv 0.02 / 0.35 N m without friction loss), thumb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
2026-10-02 relative contact-velocity control of the screwdriver chain on the SR2 hand: the controller of arXiv 2609.25619 (generalized contact frames, relative contact twist, bounded least squares) drives D8 th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
    [hom_control.py]
2026-10-02 screwdriver chain page, second version: sphere-packed fingertips against Drake's hydroelastic field as theory (Figures 1-2 computed on the real fingertip and tool: at 3 N the field covers 17.6 mm2 wi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
2026-10-02 screwdriver chain page, third version: a derivation section from contact pressure to servo targets with equations in LaTeX (scripts/texsvg.py renders them to inline SVG at build time): the hydroelast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
2026-10-02 screwdriver chain page: Figure 4 in the derivation, (a) the torsional coefficient the hydroelastic law asks for at each pad force (mu c N^1/4) against a fixed condim-4 value set at the 3 N hold, 57 %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
2026-10-05 Codex's contact studies of 2026-10-01 to 10-04: SR2 Drake planning port and the distributed fingertip contact audit
    Drake port (10-01): scripts/drake_sr2_*.py and docs/experiments/20261001-drake-port (frozen,
    locked-gantry and actuated SR2 models, collision-constrained IK, morphology optimization, import
    limits).
    Distributed contact audit (10-04, docs/experiments/20261004-codex, README.md is the map): frozen
    MuJoCo/Drake chain regression; sphere-pad static stiffness against mj_contactForce and the
    analytic 1/[tc^2 (1-d0) Lambda] law; per-contact physical and runtime solref mappings with
    MuJoCo 3.14 diagexact; controlled slip; 6 mm fillet static audit; articulated holding, torsion
    and payloa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
    [cases.csv, compensation.csv, diagexact.csv, fillet.csv, regression.csv, sensitivity.csv, slip.csv, slip_fine.csv]
2026-10-05 Sphere-pad stiffness calibrated once per object at load: friction arm independent of tool mass
    scripts/pad_mass_calibration.py on the 10-01 two-pad pinch (1 mm pads, rs 0.75, cap 45 deg,
    relaxation 20 ms, impratio 100): with each pad's Lambda taken from the model at load, the
    realized per-sphere stiffness equals the target and rbar is 0.802 / 1.246 mm at 0.5 / 3 N for
    0.25x, 1x and 4x tool mass (hydroelastic law 0.838 / 1.311 mm). The fixed Lambda = 47.2 kg^-1
    calibration moves rbar by +37 % (0.25x) and -23 % (4x), following k^(-1/4). In MuJoCo 3.6
    efc_diagApprox is pose-independent, so the load-time value is exact; a per-step runtime
    mapping is not needed. Holds are stable when dt < d0 tc (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
    [pad_mass_calibration.py]
2026-10-05 Contact comparison bed, task 1: tangential pull-to-slip and pre-slip creep in four contact models
    scripts/contact_bed_pull.py on the 10-01 two-pad pinch (gravity off), N = 0.5, 1, 3 N per pad,
    2 N/s axial force ramp, physics steps 1 and 5 ms; 24 cases. Slip onset agrees in every model
    (mu_eff 1.000-1.008). Mean slip speed over the first 50 ms: sphere pads within 10 % of Drake
    hydroelastic (15 / 9.1 / 7.8 against 14 / 9.4 / 7.9 mm/s), point contact up to 2x faster at
    0.5 N. Pre-slip creep under a 50 % hold differs by two orders of magnitude: MuJoCo
    0.02-0.09 mm/s (regularized friction), Drake 0.0001-0.0003 mm/s. Condim 4 equals condim 3 under
    a pure pull. Physics cost at 1 ms: point 3.2 us/st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
2026-10-05 Research asides: coupled-foundation fingertip models for the printed TPU tip (not pursued now)
    New section in docs/experiments/20261004-codex/20261004-contact_research_asides.html (builder
    scripts/distributed_contact_page.py): Pasternak/shear-layer surface law with per-element slip,
    homogenized gyroid/TPU identification (indentation influence length l, shear, torsion, two
    rates), the l / r_patch criterion against our contact radius a = 1.6 / 2.5 mm at 0.5 / 3 N, and
    the skin-solve interface for MPC and GPU RL. A falsifiable test without new hardware: the
    friction arm grows 1.82x from 0.5 to 3 N under Hertz and 1.57x under a Winkler-type law.
    scripts/flexcomp_skin_probe.py checks MuJoCo 3.14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
2026-10-05 Newton hydroelastic holds and twists the SR2 pinch: MJCF default solref imported with zero damping ratio
    scripts/newton_pinch_probe.py. Codex's native Newton config failed at step 164 (8.2 ms) of the
    preload because a new thumb-tool contact arrived with Newton per-contact stiffness 0, so
    SolverMuJoCo fell back to the geom solref, which Newton's MJCF importer stored as (0.006, 0)
    from the one-value default solref="0.006" (MuJoCo reads (0.006, 1)). Damping ratio 0 makes the
    reference stiffness infinite: contact force 0.24 N -> 2.3e7 N in one step. Writing a two-value
    solref before add_mjcf, soft ("0.5 1") so fallback contacts carry no force, removes it.
    Stable at 1 ms (also 200 and 50 us): nat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
    [newton_pinch_probe.py]
2026-10-05 GPU throughput of 1 mm sphere pads on MuJoCo-Warp at 1024-8192 worlds
    scripts/gpu_scaling_mjwarp.py on Codex's holding fixture (reproduces its 128-world point, 164k
    against 168k world-steps/s). Throughput saturates at 4096 worlds: legacy mapping (plain solref
    0.015 s / solimp d0 0.874, set once) 923k world-steps/s at 1 ms and 954k at 0.5 ms; 8192 worlds
    1-4 % lower (906k at 1 ms = 906 simulated s per wall s). Codex's compiled mapping is 10-15 %
    slower; 0.5 mm pads 198-265k. All worlds finite, no contact or constraint overflow with
    capacities sized per world (256 / 1024 for 1 mm); Codex's 2048 / 8192 halves throughput. Every
    final row measured with no other GPU process. Rows: docs/experiments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
2026-10-05 Fingertip contact overview page and the contact comparison bed (pull, twist, shake, brake; Newton on the bed)
    docs/experiments/20261005-contact_overview/20261005-sphere_pad_contact_model.html (builder
    scripts/contact_overview_page.py): what a fingertip contact model has to carry, the patch torque,
    the Winkler/hydroelastic arm (c F^1/4) against Hertz (F^1/3; ratio 1.565 vs 1.817 from 0.5 to 3 N),
    lateral coupling, and the sphere pad in MuJoCo: per-row static stiffness 1/(tc^2 (1-d0) Lambda)
    independent of neighbours, load-time Lambda calibration, soft-friction creep
    v = (1-d0) Lambda tc F_t / (2 impratio n) (predicts the pads' measured creep within about 20 %),
    and the collective step bound d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
2026-10-05 Contact overview and bed pages: plain headings, a Terms and metrics block, scope caveats cut; writing rules for Codex
    Both pages open with definitions of every metric they report (friction arm, slip onset and effective mu, creep, slip
    speed, arm at spin onset, drift per cycle, swing end, step cost, tc/d0/Lambda, impratio, condim, pad spacing). Headings
    are descriptive ("Components of a fingertip contact model", "Comparison with the reference models"); subtitle lines,
    "X, not Y" sentences, scope qualifiers and personified mechanisms are removed; each bed task states its protocol.
    CLAUDE.md points to the Writing section of ~/.claude/CLAUDE.md, which gains rules on editorial judgement, defining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
2026-10-06 Creep against impratio and noslip, the printed TPU fingertip on the contact bed, and the deployed three-finger turn in MuJoCo, MuJoCo-Warp and Drake
    Creep (bed task 6, creep.jsonl): the 1 mm sphere pads creep 31 um/s and turn 1.2 deg/s at half their slip load; both fall
    as 1/impratio, to 0.31 um/s and 0.013 deg/s at 10 000 (Drake 0.20 and 0.0084 at 1 ms) with slip onset, twist onset and the
    brake within 3 % and 1 deg. noslip removes only the translational creep and is refused by MuJoCo-Warp 3.6; a longer pad
    relaxation time makes the pinch torque rate-dependent. On the hand chain impratio 10 000 doubles the physics time.
    Printed fingertip (fingertip_geometry.py, tpu_tip_rig.py): the SR2 TPU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
2026-10-06 Bench post fix, servo plant from bench readbacks, hand-object control of the three-finger turn, and RL contact cost with Newton hydroelastic
    - scene_mutate.set_object_platform puts the post top at the tool's lowest point; seated_scene() repairs stored
    bench scenes on load, used by the gate, bench-plant, turn-mechanism, ranking, angle-sweep and tip-gait scripts.
    - calibrate_plant_kp.py reset from keyframe 0 (palm at 10 mm): the 2026-09-02 kp 0.5 fit never loaded a finger.
    It now starts from the plan's replay state. bench_replay_calibration.py replays the 177 tracked bench runs from
    their logged commands on TPU pads: the readbacks fix the finger time constant (<= 0.2 s) and favour mu 1,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
    [bench_replay_calibration.py, calibrate_plant_kp.py, real_v1_tip_gait.py]
2026-10-07 Newton hydroelastic stiffness divided by the pad-tool effective mass on the contact bed; hand-off note for the follow-up
    SolverMuJoCo realises each hydroelastic contact's stiffness times the effective mass of the
    two bodies (17.4 g on the bed), so the 10-05 Newton pads sank 7.3x deeper than Drake. kh divided
    by that mass, read from the solver's own model, gives a sink of 1.02-1.04x Drake at 0.5-3 N.
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2026-10-07 Overnight hand-off note: Newton mass correction on the turn, Newton pads, mjlab sensor fix, same-state timing, asides, grasp turn range, RL training
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2026-10-07 Agreement of five contact models with Drake: figure script, point-contact plan replays on the working plant, step 7b in the overnight note
    Point contact (condim 3) holds 24/24 but turns within 3 deg of Drake on 11/24 (D7 +30-33 deg at 0.6x grip force);
    1 mm pads 23/24 (all within 3.1 deg); Newton hydroelastic mass-corrected 8/24 with 4 drops.
    [simulator_agreement_figure.py]
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2026-10-07 Contact-model agreement with Drake: MuJoCo-Warp and Newton pads on the turn and the bed, page Section 5
    MuJoCo-Warp pads hold 40/40 plan replays, Newton pads 40/40 (22/24 turns within 3 deg of Drake),
    the mass-corrected Newton hydroelastic rerun 33/40. Twist onset torque 0.94 of Drake for all three
    pad implementations. Newton pads need solimp d0 from the solver's own inverse weights and a friction
    gain kf that keeps the pads' 10 ms friction solref; the importer's kf 1000 (4e-5 s) swung the braked
    tool to 108 deg. reorient_backends_gpu.py reads contact normal forces from the efc rows. Figure 1 of
    the hom_turn3 page is now the per-rollout turn against Drake; Section 5 holds the agreement figur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
    [simulator_agreement_figure.py]
2026-10-07 RL contact page: close-up films of the four 20 M policies replace the training-video strips
    Each final checkpoint rendered at 960x720 from the palm, looking along the tool's starting axis
    (rl_render_reorient.py, distance 0.24 m, azimuth 0), strips cut from those videos. Mesh-tip
    policies raise the middle finger's end to 39-43 deg and hold it (seed 0 drops 4/64 at step 231);
    pad policies roll the thumb along the shaft and hold the tool at 26 deg in 64/64.
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2026-10-07 Contact-model overview, 2026-10-07 revision: agreement across simulators, effective mass, RL cost and replay
    New dated file docs/experiments/20261007-contact_overview/20261007-sphere_pad_contact_model.html from the
    same builder, for the same artifact. Figure 7 is the agreement of the 1 mm pads with Drake in CPU MuJoCo,
    MuJoCo-Warp and Newton (onset torque 0.94 of Drake, turn within 3 deg on 23/23/22 of 24); step 7 explains
    the effective mass the pads divide out, which Newton's hydroelastic contact lacked, and the d0 and friction
    gain Newton's import needs; the cost section adds 2.2-2.4 us per world-step on one RL state; the replay
    of the learned policies across MuJoCo implementations; Table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
2026-10-07 Overnight note: re-armed for steps 15-20 (bed roll and stability, Newton pull/shake, Newton GPU scaling, Figure 9 timing, memory cells)
2026-10-07 Contact bed: task 3 roll and task 7 stability map run; overview Figure 6 and roll paragraph, bed page tasks 3, 6 and 7
    Roll (contact_bed_roll.py, 56 rows; contact_bed_newton.py roll, 36 rows for newton_hydro_mc,
    newton_pads1 and mjw_pads1 through the new MjwRollRig): every model rolls the tool, rolling ratio
    0.994-1.001 of its own no-slip value, slip at most 35 um over 5 mm. Stability map (528 rows): with
    MuJoCo's tc >= 2 dt clamp off, 19 of 21 pad (d0, tc) pairs bracket t_c (d0 + (1 - d0)/n); d0 0.9 and
    0.95 at tc 20 ms eject the tool at 15 ms.
2026-10-07 Contact bed: pull and shake for mjw_pads1, newton_pads1 and newton_hydro_mc (66 rows)
    Every model now has the nine Table 2 metrics. GPU pads match CPU MuJoCo to 3-4 digits; mass-corrected
    Newton hydroelastic: mu_eff 1.004, slip speed 6.3 mm/s (Drake 9.4), creep 7.0 um/s (Drake 0.2, pads 30.8),
    shake drift 0.33 um/cycle (Drake 0.015, pads 2.3).
2026-10-07 GPU scaling: Newton 1 mm pads and mass-corrected hydroelastic on the MuJoCo-Warp pad fixture, 1-8192 worlds
    newton_scaling.py gains --model pads1|hydro_mc and --fixture twist (the 0.8 s run with two opposing 12 mN m
    pulses of gpu_scaling_mjwarp.py). Pads: the fixture's legacy 1 mm pads imported into Newton, d0 checked on
    Newton's inverse weights (unchanged, 0.8739), kf matched to the 15 ms solref. Peak world-steps/s: Newton pads
    842k at 2048, MuJoCo-Warp pads 923k at 4096, Newton hydroelastic with reduction 541k at 4096, all faces 235k.
    Every batch to 8192 ran; 8192 Newton pads take 7.5 GB host RSS and 3.3 GB VRAM. MuJoCo-Warp pads gain the
    1/64/256/2048 batches (--preset small). A skipped p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
2026-10-07 Contact overview: Figure 9 with every simulator, Figure 10 with Newton pads and mass-corrected hydroelastic, Table 1 cost column, Table 2 with the GPU pads
    Figure 9 joins each GPU model's one-world bed step (MuJoCo-Warp pads 266 us, Newton pads 2,006, Newton
    hydroelastic 2,784) to its batched cost per world-step at peak throughput (1.08, 1.19, 1.85 us); models
    within a label height are spread apart. Table 2 adds the pads in MuJoCo-Warp and Newton (median deviation
    from Drake 6.0 and 6.2 %, MuJoCo 6.2 %, Newton hydroelastic 19.3 %).
2026-10-07 Contact bed page: lede, Newton twist paragraph, cost table and open items from the current rows; mesh RL env at 4,096 envs
    The lede states the pad in three simulators (median deviation from Drake 6.0-6.2 %), the stability bound
    (19 of 21 settings) and the batched cost (1.08 us MuJoCo-Warp, 1.19 Newton). rl_contact_throughput.py gains
    --sensor legacy, the contact sensors of the throughput table's first rows; the TPU mesh env at 4,096 envs
    uses 4,335 MB of GPU. The turn page's Tables 7 and 8 print a not_run row's limit in place of a dash.
2026-10-07 Turn page Tables 7 and 8: memory cells measured or given their limit
    MuJoCo-Warp 3.14 pads at 2,048 worlds on the held RL state: 1.59 us per world-step, 12,168 MB of GPU, all
    held. The TPU mesh env at 4,096 envs: 4,335 MB. Newton pads at 2,048 worlds need 14 GB of host memory
    (2.51 GB at 256, 4.18 GB at 512 worlds: 6.5 MB per world); the 1 mm pad env at 4,096 envs needs over
    11 GB of host memory (watchdog at the 11 GB cap). Not-run cases are rows with status not_run and their
    limit; micro-sign headers no longer upper-case to MS.
2026-10-07 Contact pages rebuilt for steps 15-19; overview lede quotes the batched pad throughput in MuJoCo-Warp and Newton; INDEX rows publish pending
2026-10-07 Contact pages: one-GPU-world costs from the CUDA-graph sweep in both simulators; stability cross-reference per page
    Figure 9, Table 1 and the cost paragraph of the overview took the one-world GPU cost from the bed rig, which
    steps Newton without a CUDA graph (2,006 and 2,784 us) and MuJoCo-Warp with one (266 us). They now use the
    1-world rows of the Figure 10 sweep, where every 10-step block is a CUDA graph in both: MuJoCo-Warp pads 341 us,
    Newton pads 313 us, Newton hydroelastic 425 us. The bed page's cost table shows both columns with a note.
    The shared stability paragraph cites its own page's figure (Figure 4 on the bed page) and states the bound
    (14) gives for point contact instead of '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
2026-10-07 Contact pages: the twist reference is the integrated pressure law, not a fit to Drake; damping, solver and limits stated
    The arm law (3) now takes c = 0.974 mm N^-1/4 from the pressure field integrated over the sphere-cylinder patch
    (scripts/hydroelastic_arm_integral.py) in place of the 0.996 fitted to Drake's torque. Against it the pads' sliding
    arm is within 1.2 % and Drake's 2.2-2.7 % above; the pads' onset arm is 3.9-6.9 % below, with 1.4-2.0 deg of turn
    before spin. condim 4 keeps the fit to Drake's torque and the pages say so. The bed page's onset/law column is
    recomputed from the stored arms.
    Also: MuJoCo-Warp and Newton described as MuJoCo's solver in two more implementations; the d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
2026-10-07 Newton hydroelastic tests on the contact bed: contact reduction, voxel size and a square edge; page and bed/overview updates
    Newton's full contact set gives the pressure law's friction arm at 0.5 and 1 N; the reduced contacts give
    0.77-0.88 of it, and the full set fails at 3 N. Friction rows of 10 ms or longer stop the braked tool at
    hanging. On a 20 mm square bar the pressure law (hydroelastic_arm_integral.bar_law) is matched by Drake's
    field; the 1 mm pads carry 2.0x its force at 0.5 N and Newton's voxel SDF rounds the edge (0.32x at
    0.5 mm voxels, 0.83x at 0.25 mm). hom_contact_rig gains a bar<mm> spec field (cylinder unchanged).
    Page docs/experiments/20261007-newton_hydro_tests/20261007-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
    [hydroelastic_arm_integral.py]
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2026-10-09 Chart labels at 13 px or more without collisions on the KaRMA, control-diagnosis, pad-elevation, journey and turn-mechanism pages: wider label columns, one value label per hand, end-anchored marks, v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
    [karma_page.py, real_v1_control_diagnosis_page.py]
2026-10-09 Chart text at 13 px or more on the contact pages: _svg_open sizes text from the viewBox width, _panel sentence-cases axis titles, larger text in the section, patch, representation and agreement drawi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
    [simulator_agreement_figure.py]
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2026-10-09 Topic overview docs/overviews/hand_plant_bench.html: the hand, the servo as a spring with a cutoff, the three simulated servo models and what the bench readbacks identify, the bench instruments and t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
    Prose 1,135 words in the first draft, 1,139 after the reread (two sentences clarified); lede 87; prose_lint clean.
    The overview builder takes an image file as a figure. INDEX.md: two subjects retitled (the 2026-08-27 page was
    simulation only; 'settle' replaced). The other overviews rebuilt with the new titles.
    [overview_hardware_text.py]
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
